mjohansson/SolderingStation/README.md

# SolderingStation
Project directory for soldering-station 2000
