mjohansson/SolderingStation/hw/ss_frontpanel_inner_plate/R2A/README.txt

* Break-away bridgeboard tabs removed
* set signal (GND) to holder mounting holes, also slight adjustments of some traces to 
    a) move vias away from screwholes
    b) improve plane connectivity
