mjohansson/SolderingStation/doc/14p_05mm_FFC/Molex_FFC_14_L100/15166_98266_15266_hires.jpg

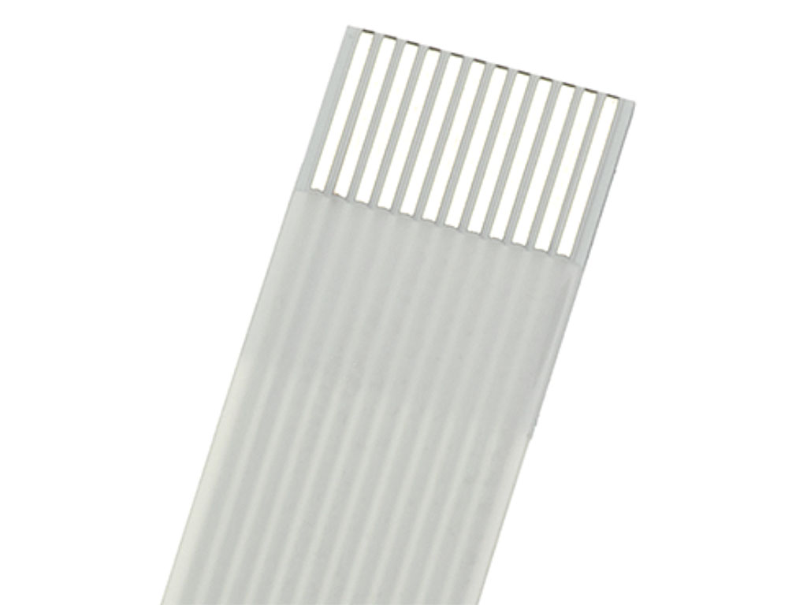
doc/14p_05mm_FFC/Molex_FFC_14_L100/15166_98266_15266_hires.jpg
