mjohansson/SolderingStation/doc/14p_05mm_FFC/Wurth_687114182122/FFC_14_L100_type1/o32857v209 Family_WE-FFC_6876xxxxx002.jpg

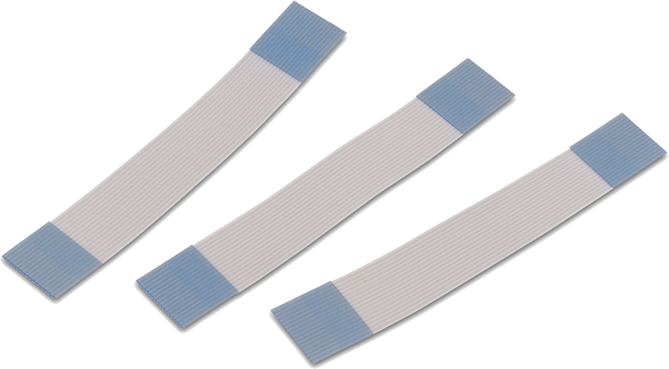
doc/14p_05mm_FFC/Wurth_687114182122/FFC_14_L100_type1/o32857v209 Family_WE-FFC_6876xxxxx002.jpg
