mjohansson/SolderingStation/doc/14p_05mm_FFC/Wurth_687114182122/FFC_14_L100_type2_alt/o32861v209 Family_WE-FFC_6877xxxxx002.jpg

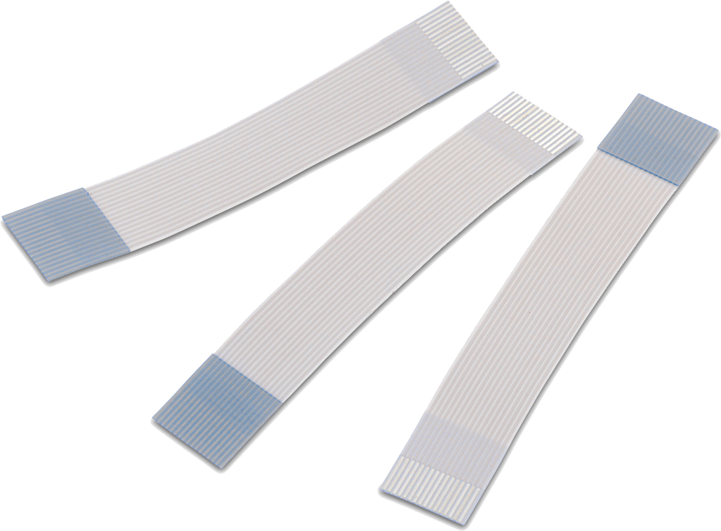
doc/14p_05mm_FFC/Wurth_687114182122/FFC_14_L100_type2_alt/o32861v209 Family_WE-FFC_6877xxxxx002.jpg
