mjohansson/SolderingStation/doc/appnotes/stm32_bluepill_modules/C8T6-DIP40-back.jpg

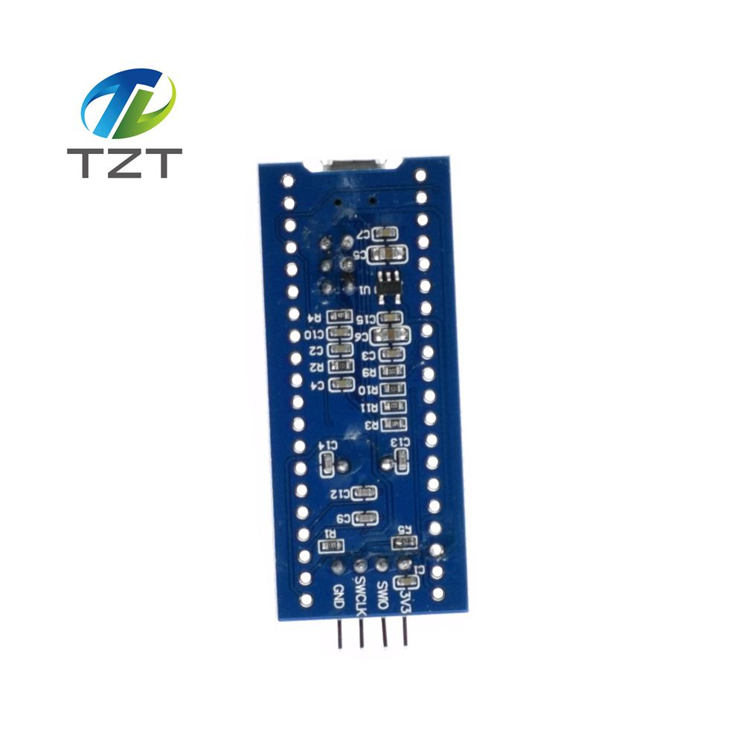
doc/appnotes/stm32_bluepill_modules/C8T6-DIP40-back.jpg
