mjohansson/SolderingStation/doc/appnotes/stm32_bluepill_modules/C8T6-size.jpg

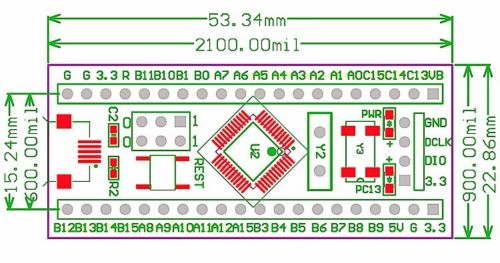
doc/appnotes/stm32_bluepill_modules/C8T6-size.jpg
