mjohansson/SolderingStation/doc/appnotes/stm32_bluepill_modules/STM32F103RCT6-back.jpg

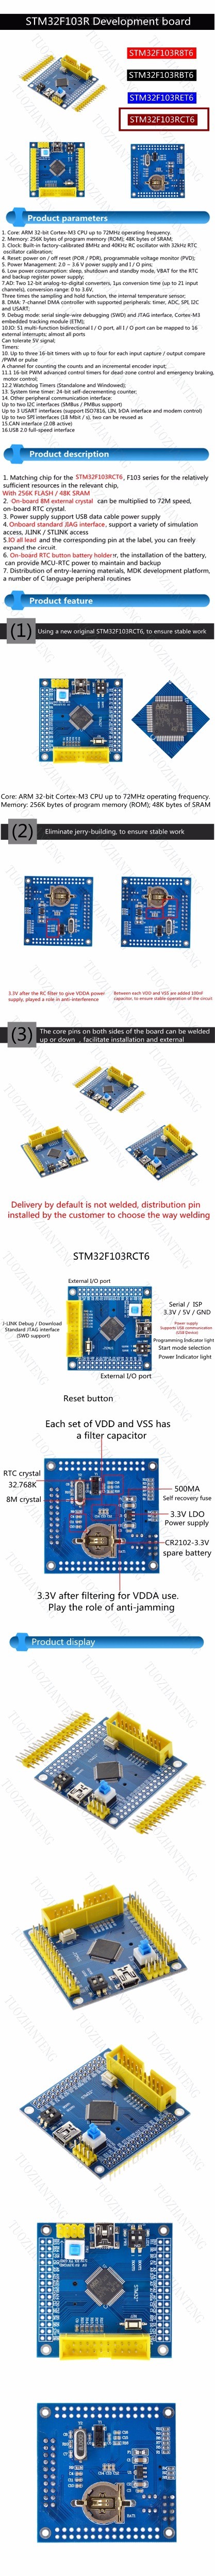
doc/appnotes/stm32_bluepill_modules/STM32F103RCT6-back.jpg
