mjohansson/SolderingStation/doc/dcdc_buck/Pluto-buck/SStn_1A-schematic.png

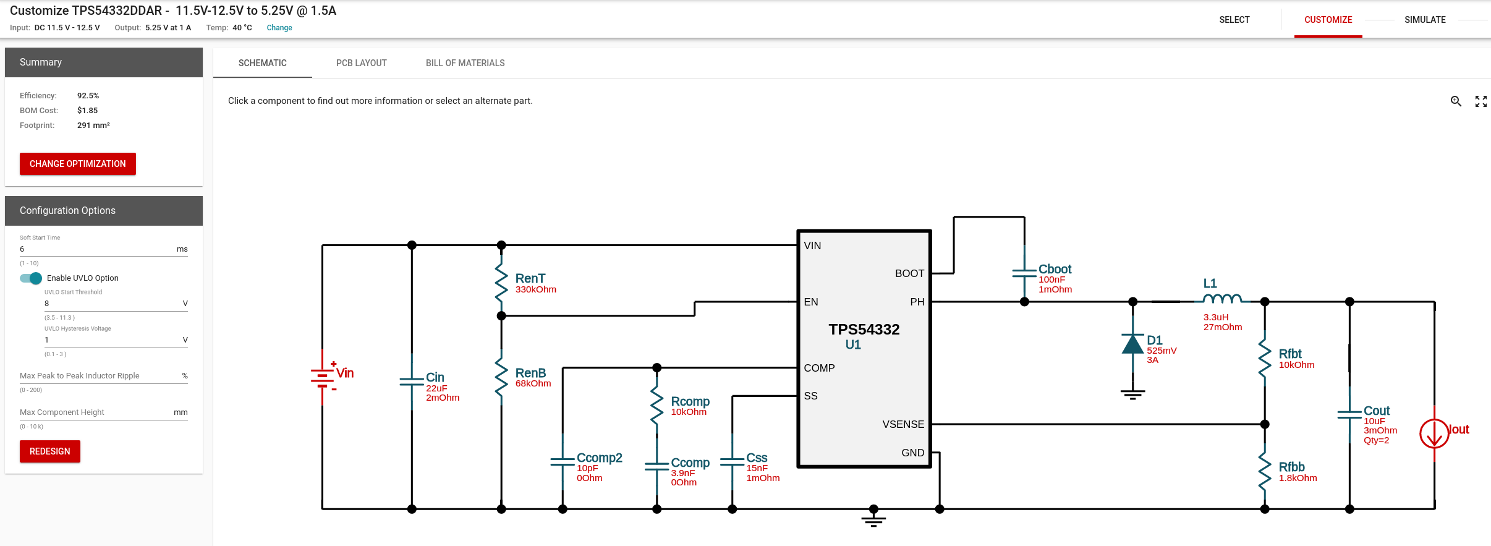
doc/dcdc_buck/Pluto-buck/SStn_1A-schematic.png
