mjohansson/SolderingStation/doc/DIN7_female_socket/Weller_modding/Buchse.png

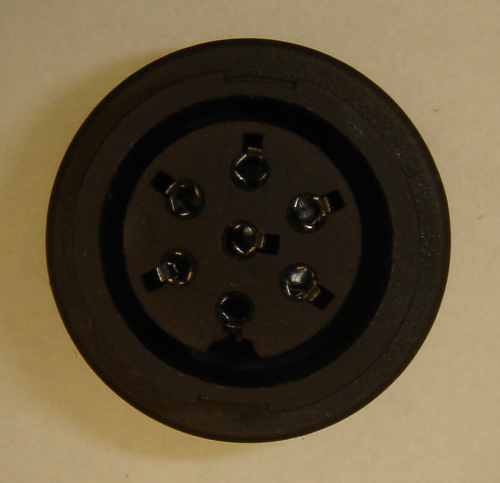
doc/DIN7_female_socket/Weller_modding/Buchse.png
