mjohansson/SolderingStation/doc/microUSB/HTB19WLYHpXXXXc6aXXXq6xXFXXXp.jpg

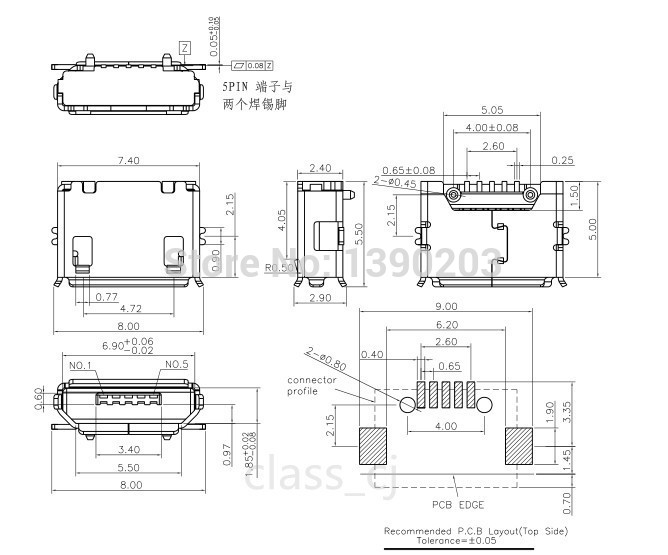
doc/microUSB/HTB19WLYHpXXXXc6aXXXq6xXFXXXp.jpg
