mjohansson/SolderingStation/doc/oled_display/Newhaven_NHD-3.12-25664UCW2/NHD-3.12-25664UCW2-lrg-ALL.jpg

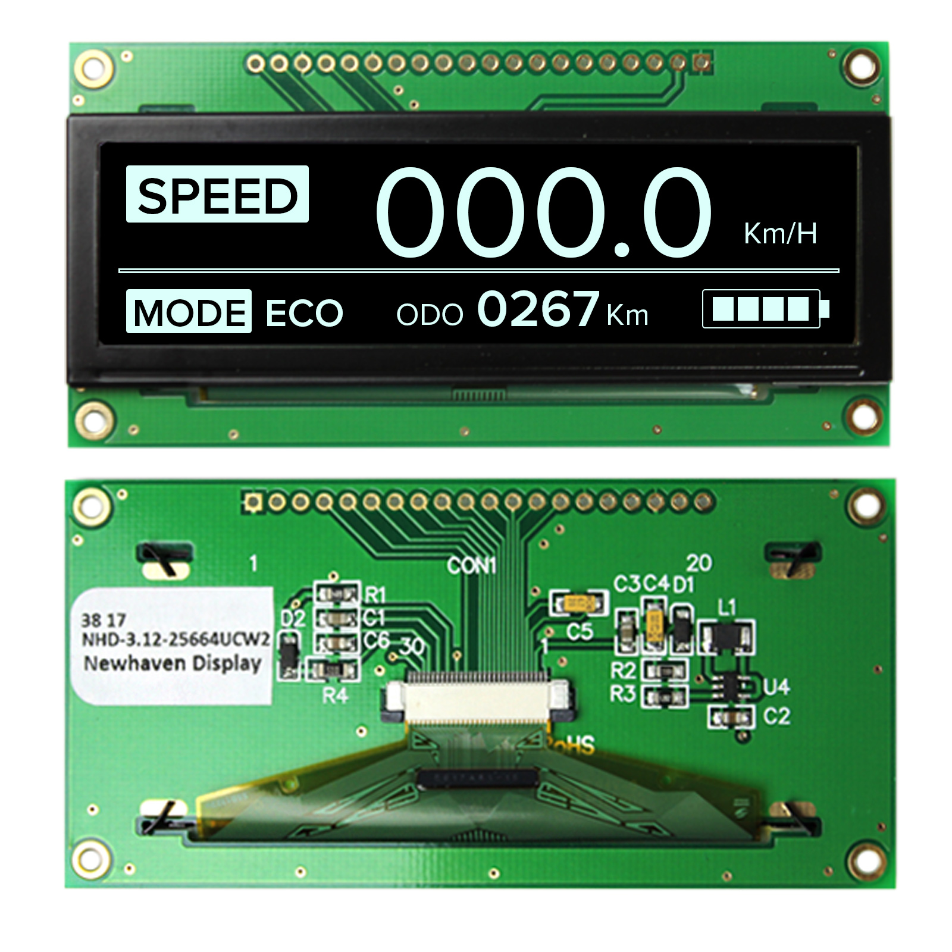
doc/oled_display/Newhaven_NHD-3.12-25664UCW2/NHD-3.12-25664UCW2-lrg-ALL.jpg
