mjohansson/SolderingStation/doc/rotary/Encoder Drawing.png

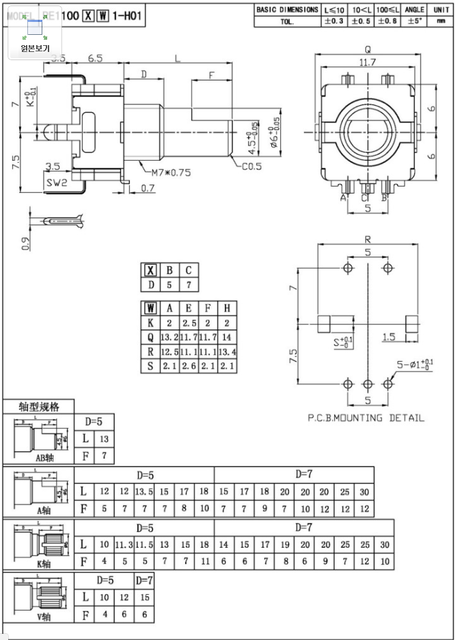
doc/rotary/Encoder Drawing.png
