mjohansson/SolderingStation/doc/rotary/KY-040.jpg

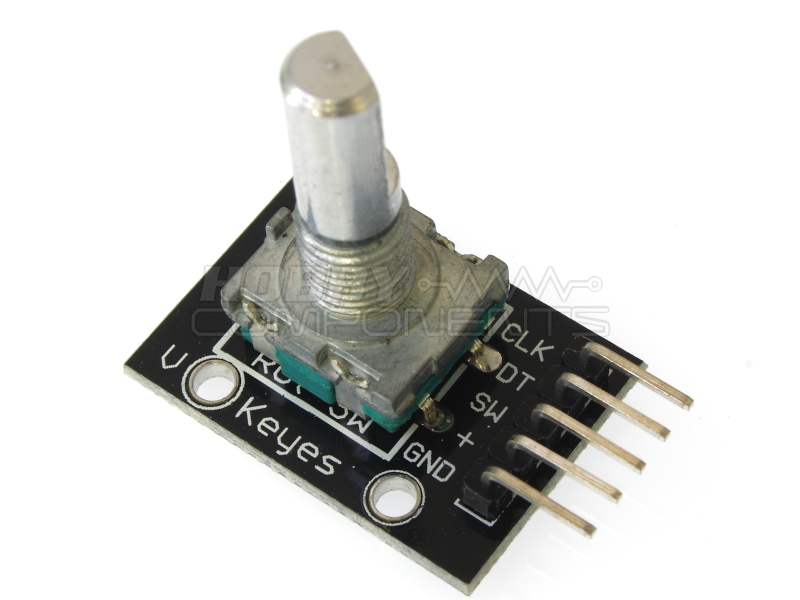
doc/rotary/KY-040.jpg
