mjohansson/SolderingStation/doc/rotary/M274-Rotary-Encoder-Dimensions.png

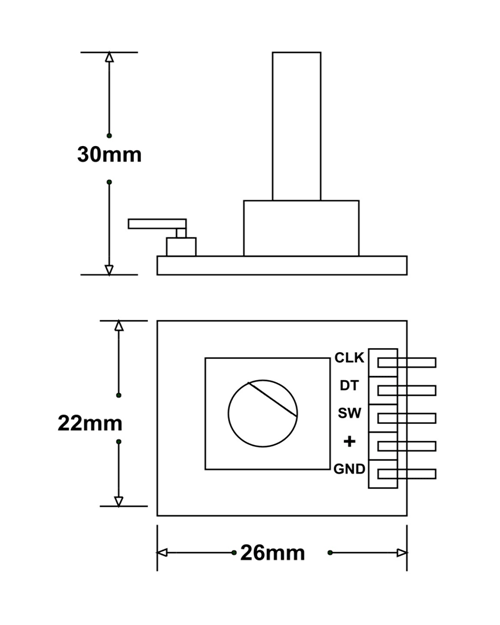
doc/rotary/M274-Rotary-Encoder-Dimensions.png
