mjohansson/SolderingStation/doc/rotary/Rotary_Encoder_Dimensions.png

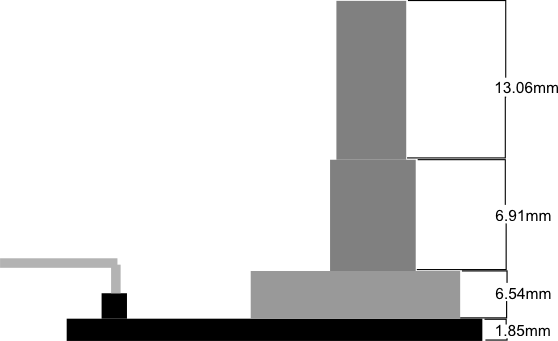
doc/rotary/Rotary_Encoder_Dimensions.png
