mjohansson/SolderingStation/doc/rotary/Rotary_Encoder_Pinout_and_PCB Dimensions.png

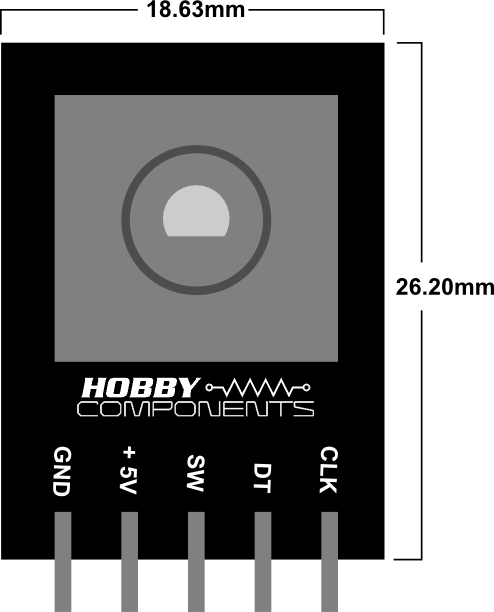
doc/rotary/Rotary_Encoder_Pinout_and_PCB Dimensions.png
