mjohansson/SolderingStation/doc/RTC-modules/DS3231_module/module_sch.jpg

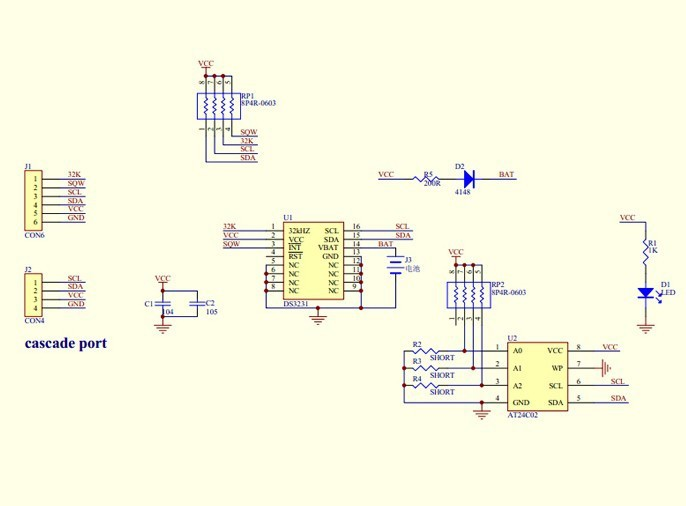
doc/RTC-modules/DS3231_module/module_sch.jpg
