mjohansson/SolderingStation/doc/simcard_block/C707 10M006 052 2.jpeg

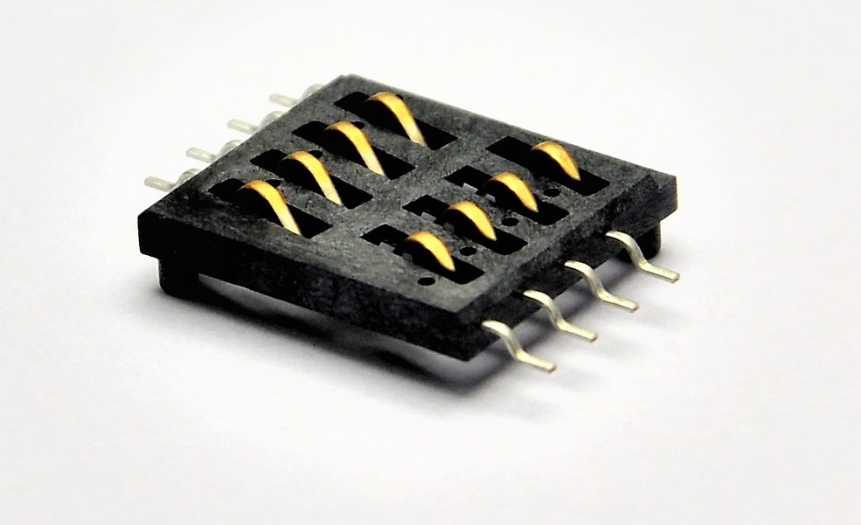
doc/simcard_block/C707 10M006 052 2.jpeg
