mjohansson/SolderingStation/doc/simcard_block/pad_dimensions.jpeg

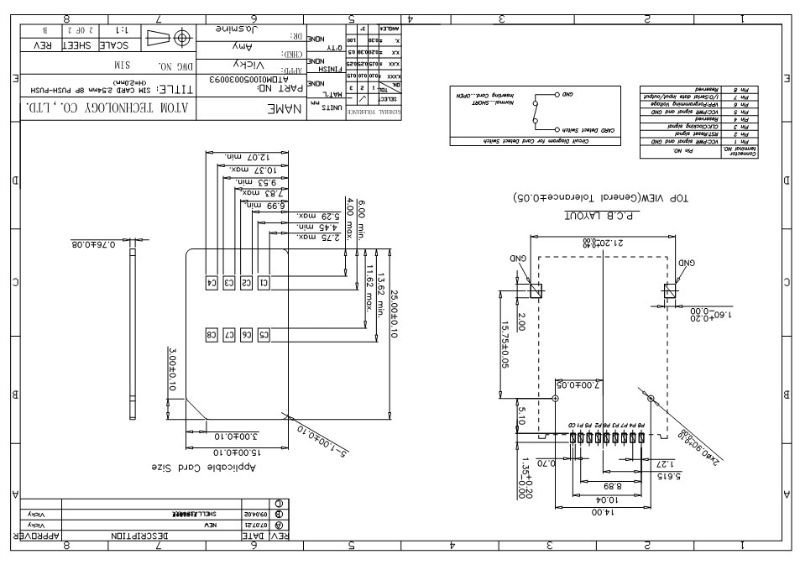
doc/simcard_block/pad_dimensions.jpeg
