mjohansson/SolderingStation/hw/frontpanel_dev_adapter/R1A/images/Produce_DanZhi.SMT_Original_Snapshot.Top.2268231A_Y12.SMT0201231120878.png

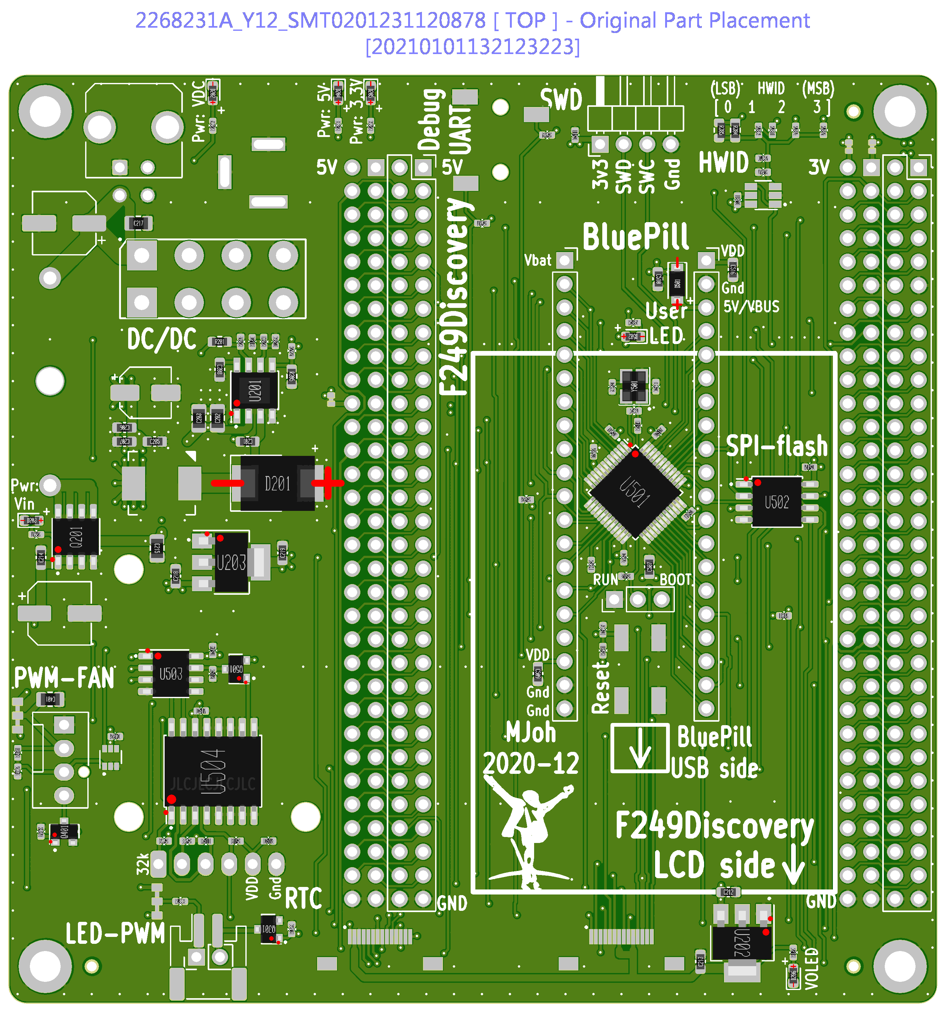
hw/frontpanel_dev_adapter/R1A/images/Produce_DanZhi.SMT_Original_Snapshot.Top.2268231A_Y12.SMT0201231120878.png
