mjohansson/SolderingStation/pictures/bottom_plate_with_POF-50185_rubber_feet.jpg

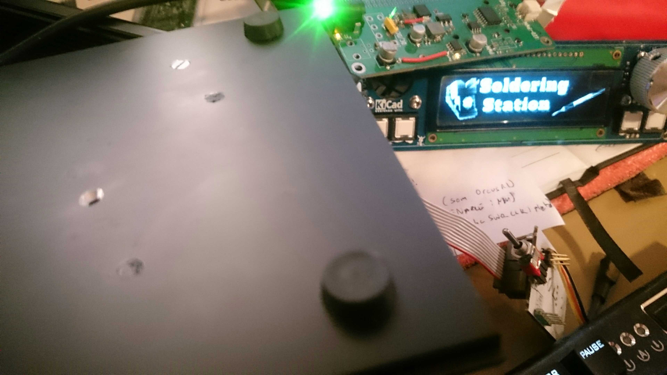
pictures/bottom_plate_with_POF-50185_rubber_feet.jpg
