mjohansson/SolderingStation/pictures/FPDB_jysd.jpg

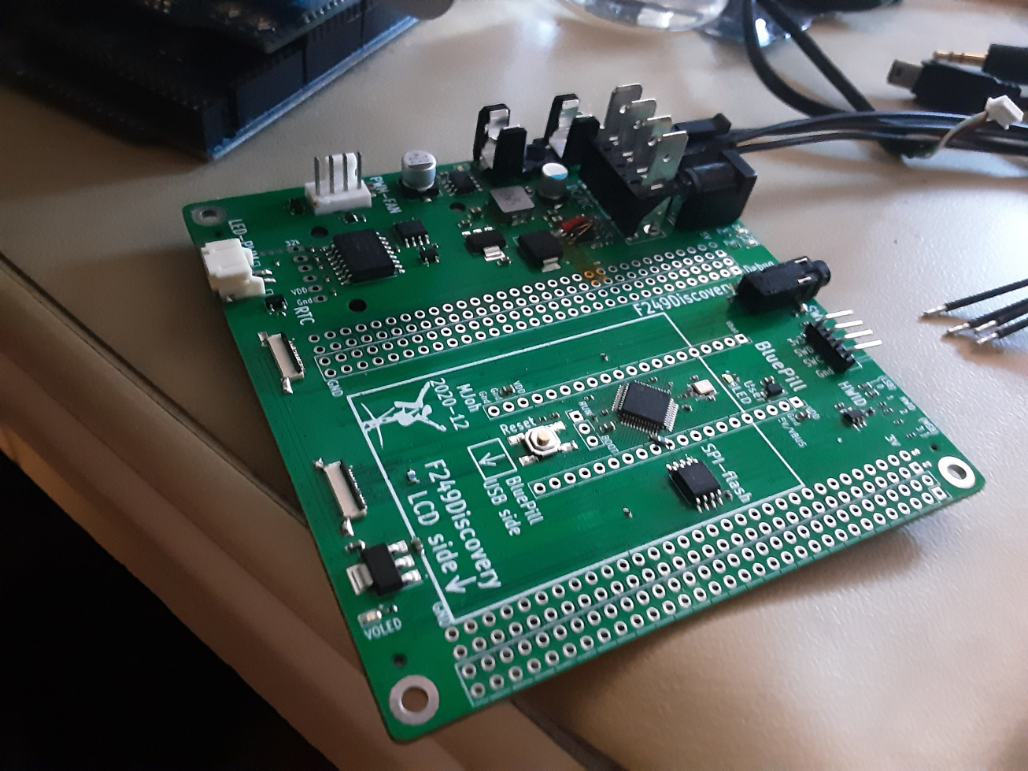
pictures/FPDB_jysd.jpg
