mjohansson/SolderingStation/pictures/POF-50185_push-on_rubber_feet.jpg

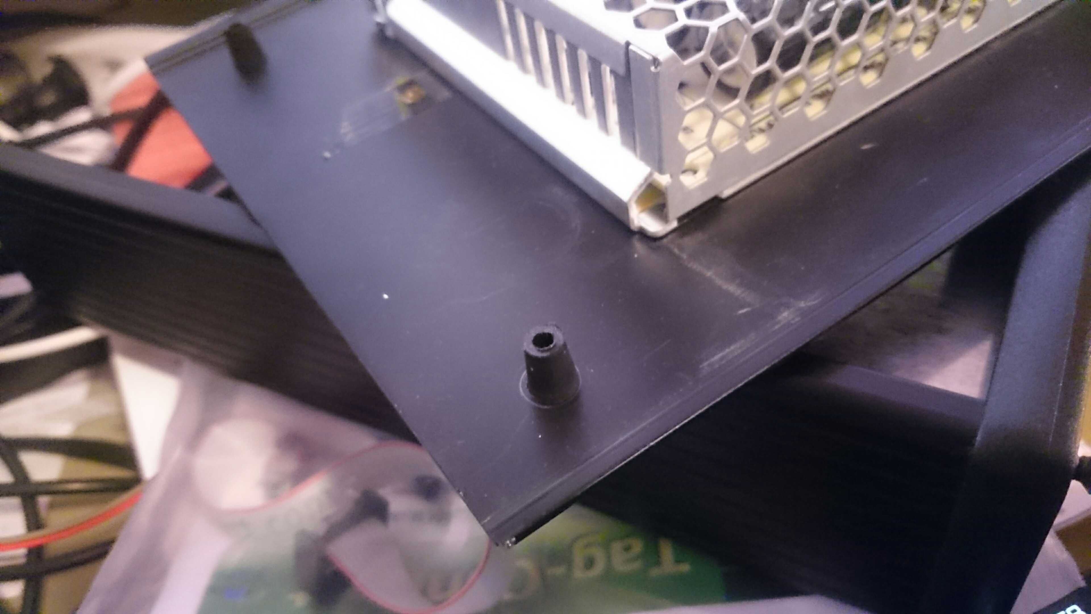
pictures/POF-50185_push-on_rubber_feet.jpg
