mjohansson/SolderingStation/doc/4mm_banana_socket_panelmnt/Stäubli-LB_I4R_A-23.0190-21/elfa_ordering_nr-301-36-139.txt

Elfa: 301-36-139
Type: LB-I4R-A
mfg pn: 23.0190-21
Brand: Stäubli Electrical Connectors

https://www.elfa.se/en/panel-mount-socket-o4mm-black-25a-30v-gold-plated-staeubli-electrical-connectors-23-0190-21/p/30136139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
