mjohansson/SolderingStation/doc/audio/3.5mm_jack/CUI_DEVICES_SJ-3571N/BOM.txt

3DX_CUI_DEVICES_Supplier: CUI Devices
3DX_CUI_DEVICES_Description: 3.5 mm Right-Angle, SPDT Switch, Stereo Audio Jack Connector
3DX_CUI_DEVICES_Model Number: SJ-3571N
