mjohansson/SolderingStation/doc/audio/speakers/CES-703316-28PM/CUI_DEVICES_CES-703316-28PM/BOM.txt

3DX_CUI_DEVICES_Supplier: CUI Devices
3DX_CUI_DEVICES_Description: 70 x 33 mm, Enclosed, Rectangular Case, 2 W, 8 Ohm, Neodymium Magnet, Paper and Cloth Cone, Speaker
3DX_CUI_DEVICES_Model Number: CES-703316-28PM
