mjohansson/SolderingStation/doc/audio/speakers/CES-803118-28PM/CUI_DEVICES_CES-803118-28PM/BOM.txt

3DX_CUI_DEVICES_Supplier: CUI Devices
3DX_CUI_DEVICES_Description: 80 x 31 mm, Enclosed, Rectangular Case, 2 W, 8 Ohm, Neodymium Magnet, Cloth Cone, Speaker
3DX_CUI_DEVICES_Model Number: CES-803118-28PM
