mjohansson/SolderingStation/doc/appnotes/stm32F429/STM32F429I-DISC1/resources/MB1075 B01 BOM.xls

MB1075 B01 BOM
NO | Code | Part Number | Manufacturer | Description | Designator | Quantity | Process | Note
1 | A14D025 |  | fastprint | PCB MB1075,4 layers,immersion gold, |  | 1 | SMT
2 | CCC0001 | CC0603KRX7R9BB103 | YAGEO | capacitor,10nF,0603,50V,10%,X7R,YAGEO; | C3,C19 | 2 | SMT
3 | CCC0071 | CC0402KRX7R7BB104 | YAGEO | capacitor,100nF,10%,16V,X7R,0402,YAGEO | C1, C4, C6, C7, C8, C9, C10, C11, C12, C15, C22, C27, C29, C30, C31, C32, C33, C34, C35, C36, C37, C38, C39, C40, C43, C44, C45, C46, C47, C48, C49, C50, C51, C52 | 34 | SMT
4 | CCC0121 | CC0603KRX5R8BB105 | YAGEO | capacitor,1uF,10%,25V,X5R,0603 | C2, C5,C28 | 3 | SMT
5 | CCC0135 | CC1206KKX7R7BB225 | YAGEO | capacitor,2.2uF,10%,16V,X7R,1206 | C41, C42 | 2 | SMT
6 | CCC0149 |  | YAGEO | capacitor,20pF,5%,50V,NPO,0402,YAGEO | C16, C17, C20, C21 | 4 | SMT
7 | CCC0217 | CC0603KRX7R8BB106 | YAGEO | capacitor,10uF,10%,25V,X7R,0603 | C13 | 1 | SMT
8 | CTD0004 | TAJA475K016R | AVX | Tan capacitor,4.7uF,10%,16V,TAN-A,AVX | C14, C53 | 2 | SMT
9 | CTD0045 | TAJA105K016R | AVX | Tan capacitor,1uF,10%,16V,TAN-A,AVX | C25, C26 | 2 | SMT
10 | DLD0027 | 19-213-R6C-AP1Q2B-3T | Everlight | LED,RED,0603 | LD2,LD4, LD6 | 3 | SMT
11 | DLD0028 | 19-213SY6C/S530-E2/TR8LED | Everlight | LED,GREEN,0603 | LD3, LD5 | 2 | SMT
12 | DLD0032 | HSMF-A201-A00J1 | AVAGO | LED,Bicolor red & green,3.2 mm x 2.8 mm,LE-RGW35280,SMT, | LD1 | 1 | SMT
13 | JPM0060 | F206A-2*04MGF-A | Townes | pin header female,F206A-2*04MGF-A,2.54MM,2*4P,SMT | CN3 | 1 | SMT
14 | JPZ0033 | 313140S161145 | Lyconn | pin header male,2.54mm,1*2P,180 degree,L=14.5,1U gold,SMT,Lyconn;High temperature resistant ,PA-9T | JP1, JP2, | 2 | SMT
15 | JPZ0090 |  | Lyconn | pin header male,2.54mm,2*32P,180 degree,L=14.5,1U GOLD,SMT,Lyconn;High temperature resistant | P1, P2 | 2 | SMT
16 | JUS0008 | 47590-0001 | MOLEX | connector,USB-AB,47590-0001,SMT,MOLEX,MB784 | CN6 | 1 | SMT
17 | JUS0021 | MUSB5QS-BM1H6-NLB-E | Townes | USB,MUSB5QS-BM1H6-NLB-E,Townes | CN1 | 1 | SMT
18 | LCZ0006 | FCM1608KF-601T03 | Tai-tech | bead,600R,350mA,0603,FCM1608KF-601T05,Tai-tech | L1 | 1 | SMT
19 | QSJ0002 | MMBT9013 | unisonic | transistor,MMBT9013L/G,SOT-23,unisonic | T1 | 1 | SMT
20 | RRC0041 | RC0603FR-07680RL | YAGEO | resistor,680R,0603,1% | R27 | 1 | SMT
21 | RRC0055 | RC0603FR-07510RL | YAGEO | resistor,510R,0603,1% | R26 | 1 | SMT
22 | RRC0065 | RC0603FR-07330RL | YAGEO | resistor,330R,0603,1% | R70 | 1 | SMT
23 | RRC0123 | RC0402FR-07100RL | YAGEO | resistor,100R,0402,1%,YAGEO | R1, R2, R16, R25, R28 | 5 | SMT
24 | RRC0124 |  | YAGEO | resistor,10K,0402,1%,YAGEO | R5, R7, R71 | 3 | SMT
25 | RRC0126 | RC0402FR-071KL | YAGEO | resistor,1K,0402,1% | R4 | 1 | SMT
26 | RRC0128 | RC0402FR-0722RL | YAGEO | resistor,22R,0402,1%,YAGEO | R14, R15, R17, R20, R63, R64 | 6 | SMT
27 | RRC0130 | RC0402FR-074K7L | YAGEO | resistor,4.7K,0402,1% | R18, R19, R29, R30, R31, R36, R37, R41, R44, R45, R51, R55, R60, R62 | 14 | SMT
28 | RRC0220 | RC0402JR-070RL | YAGEO | resistor,0R,0402,5%,YAGEO | SB1, SB2, SB4, SB6, SB8, SB12, SB14, SB16, SB17, SB18, SB20, SB21 | 12 | SMT
29 | RRC0220 | RC0402JR-070RL | YAGEO | resistor,0R,0402,5%,YAGEO | R3, R11, R12, R40, R52, R56, R58, R67, R69, R72 | 10 | SMT
30 | RRC0223 | RC0402FR-071K5L | YAGEO | resistor,1.5K,0402,1%,YAGEO | R10 | 1 | SMT
31 | RRC0245 | RC0402FR-07220RL | YAGEO | resistor,220R,0402,1%,YAGEO | R57 | 1 | SMT
32 | RRC0265 | RC0402FR-07510RL | YAGEO | resistor,510R,0402,1%,YAGEO | R61 | 1 | SMT
33 | RRC0313 | RC0402FR-0747KL | YAGEO | resistor,47K,0402,1% | R65, R68 | 2 | SMT
34 | RRC0318 | RC0402FR-07330RL | YAGEO | resistor,330R,0402,1% | R23 | 1 | SMT
35 | RRC0359 | RC0402FR-07100KL | YAGEO | resistor,100K,0402,1% | R8, R9, R21, R24, R32, R33, R34, R46 | 8 | SMT
36 | RRC0540 | RC0603FR-07620RL | YAGEO | resistor,620R,0603,1% | R73 | 1 | SMT
37 | RRC0642 | RC0603FR-070RL | YAGEO | resistor,0R,1%,0603,RC0603FR-070RL | R47, R48, R49, R50 | 4 | SMT
38 | RRC0721 | RC0402FR-07220KL | YAGEO | resistor,220K,0402,1% | R22 | 1 | SMT
39 | SQC0001 | TD-0341X-GO0 | wealthmetal | buttom,blue,6*6,SMT,180degree,TD-0341X-GO1,wealthmetal | B1 | 1 | SMT
40 | SQC0002 | TD-0341X-A00 | wealthmetal | buttom,black,6*6,SMT,180degree,TD-0341X-GO1,wealthmetal | B2 | 1 | SMT
41 | ST-DEJ0010 | BAT60JFILM | ST | Diode,BAT60JFILM,SOD323/A,ST,(X3 Code 9151097) | D1, D2, D3 | 3 | SMT
42 | ST-UIC0036 | LD3985M33R | ST | IC,3.3V,LD3985M33R,SOT23-5L,ST,(X3 Code 9176161) | U1 | 1 | SMT
43 | ST-UIC0063 | EMIF02-USB03F2 | ST | IC,EMIF02-USB03F2,flip ship,ST,(X3 Code 9179037) | U7 | 1 | SMT
44 | ST-UIC0095 | STMPS2141STR | ST | IC,STMPS2141STR,SOT23-5,ST,(X3 Code9159003) | U8 | 1 | SMT
45 | ST-UIC0107 | STM32F103C8T6(2-2) | ST | IC,STM32F103C8T6(2-2),48-LQFP,ST,(X3 Code9175981) | U2 | 1 | SMT
46 | ST-UIC0336 | L3GD20TR | ST | IC,L3GD20TR, MEMS Motion Sensor 3-Axis | U3 | 1 | SMT
47 | ST-UIC0158 | STMPE811QTR | ST | IC,STMPE811QTR,16QFN,ST,(X3 Code 9177945) | U4 | 1 | SMT
48 | ST-UIC0349 | STM32F429ZIT6U | ST | IC,STM32F429ZIT6U,LQFP144 | U5 | 1 | SMT
49 | UIC0834 | IS42S16400J-7TL | Arrow | IC,IS42S16400J-7TL,SMT | U6 | 1 | SMT
50 | 4000021 | SF-TC240T-9370-B-T | xinchuangtianyuan | LCD,SF-TC240T-9370-B-T,2.4 | CN5 | 1 | DIP
51 | JPZ0015 | 313140S111116 | lyconn | pin header male,2.54mm,1*2,L=11.6,180 degree,1U gold,DIP,lyconn | JP3 | 1 | DIP
52 | JPZ0015 | 313140S111116 | lyconn | pin header male,2.54mm,1*4,L=11.6,180 degree,1Ugold,DIP,lyconn | CN4 | 1 | DIP
53 | JPZ0015 | 313140S111116 | lyconn | pin header male,2.54mm,1*6,L=11.6,180 degree,1U gold,DIP,lyconn | CN2 | 1 | DIP
54 | XWY0022 | HC-49S-C20QSA-8.000MHZ | Jfvny | Crystal Oscillator,8M,20PF,20PPM,-10-70 degree,DIP,HC-49S | X1, X3 | 2 | DIP
55 | ADL0002 | 316102S111A | lyconn | Jumper,2.54MM,open,1U gold,lyconn;Harwin,M7566-05/M7571-05 |  | 5 | ASS
56 | AKG0002 |  | along | buttom hat,blue,along | for B1 | 1 | ASS
57 | AKG0003 |  | along | buttom hat,black,along | for B2 | 1 | ASS
58 | PBQ0016 |  | shenyuan | Test Label,Five grid,Character as T1, T2, T3, T4, QA, see picture / sample |  | 1 | ASS
59 | PXS0012 |  | lifu | Blister box,for MB1075 |  | 1 | ASS
60 | PZB0001 |  | chuanhui | carton box:620*425*310MM, |  | 2/150 | ASS
61 | PZX0006 |  | chuanhui | pearl wool EPE,605*415*5mm, |  | 1/150 | ASS
62 | PZZ0010 |  | chuanhui | cardboard,605*415mm |  | 2/150 | ASS
63 | [N/A] |  |  |  | R6 | 1 |  | Not Fitted
64 | [N/A] |  |  |  | C18 | 1 |  | Not Fitted
65 | [N/A] |  |  |  | JP4 | 1 |  | Not Fitted
66 | [N/A] |  |  |  | R13 | 1 |  | Not Fitted
67 | [N/A] |  |  |  | C23, C24 | 2 |  | Not Fitted
68 | [N/A] |  |  |  | X2 | 1 |  | Not Fitted
69 | [N/A] |  |  |  | R53, R54 | 2 |  | Not Fitted
70 | [N/A] |  |  |  | R35, R38, R39, R42, R43, R59, R66 | 7 |  | Not Fitted
71 | [N/A] |  |  |  | SB3, SB5, SB7, SB9, SB10, SB11, SB13, SB15, SB19, SB22, SB23, SB24, SB25, SB26, SB27 | 15 |  | Not Fitted
