mjohansson/SolderingStation/sch_pcb/SolderingStation_PCBA.xlsx

Sheet: Title
Solderingstation
Date | Comment | Authort
2020-04-30 | First upload to github | Mr Johansson
2020-04-30 | Created the pcba folder and started with a BOM | Mr Thulesius

Sheet: BOM
BOM
Purpose
To be able to drive two weller soldering irons of type X
See: The STM32 Nucleo-144, Altium Schematics | https://www.st.com/en/evaluation-tools/nucleo-f429zi.html
BOM divided in sections: MCU, ST-Link, USB, Ethernet, Power & Connectors |  |  |  |  |  |  |  | sum= | 22.9234
Part for Solderstation | Part used for the ST Nucleo Board | Description | Manufacturer | Package | pcs | avalabel at JLCPCB | Web | Price | tot
MCU
STM32F429VITx | MCU_LQFP144 | Main MCU | ST | LQFP100 | 1 | YES |  | 11.5305 | 11.5305
? | NX3225GD-8.000M-EXS00A-CG04874[N/AU]8C | XTAL 8MHz |  | ? | 1 | NO |  |  | 0
EXS00A-MU00466 | NX3215SA-32.768KHZ-EXS00A-MU00525 | XTAL 32kHz |  | SMD-3215_2P | 1 | YES |  | 0.2304 | 0.2304
? | TD-0341 | Reset & User button |  |  | 2 | NO |  |  | 0
TLV9052SIDGSR | N/A | Vref-Buffer | Ti | MSOP-10 | 1 | NO | https://www.mouser.se/ProductDetail/595-TLV9052SIDGSR | 0.92 | 0.92
REF6125IDGKR | N/A | VREF | Ti | VSSOP-8 | 1 | NO | https://www.mouser.se/ProductDetail/595-REF6125IDGKR | 4.66 | 4.66
SN74LVC1G11 |  |  | Ti
Ethernet Phy
LAN8742A-CZ-TR | LAN8742A-CZ-TR | Ethernet Transceiver | Microchip | QFN-24_EP_4.0x4.0x0.5P | 0 | YES | https://datasheet.lcsc.com/szlcsc/Microchip-Tech-LAN8742AI-CZ_C153279.pdf | 2.6174 | 0
IP101G | N/A | Fast Ethernet Transceiver | BDTIC.com | LQFP-48 | 1 | YES | https://datasheet.lcsc.com/szlcsc/1811271903_IC-Plus-IP101GA_C336124.pdf | 0.6754 | 0.6754
USBLC6-4SC6 | USBLC6-4SC6 | ESD protection | Yenji Elec |  | 1 | YES
KMS-1102NL | KMS-1102NL | 10/100BASE-T SINGLE PORT SURFACE MOUNT MAGNETICS |  |  | 1 | NO | https://www.mouser.com/pdfdocs/Pulse_1198.pdf
DP83848C |  | Physical Layer Transceiver |  |  |  |  | http://www.ti.com/lit/ds/symlink/dp83848c.pdf
ST-LINK parts to be MBED compatible(?)
STM32F103CBT6 | STM32F103CBT6 | MCU For ST-LINK |  |  | 1 | YES | https://datasheet.lcsc.com/szlcsc/STMicroelectronics-STM32F103CBT6_C8304.pdf | 1.9326 | 1.9326
USBLC6-2SC6 | USBLC6-2SC6 | USB ESD protection |  | SOT-23-6 | 1 | YES | https://datasheet.lcsc.com/szlcsc/STMicroelectronics-USBLC6-2SC6_C7519.pdf | 0.0965 | 0.0965
? | 1050170001 | USB_Micro-B receptacle |  | ? | 1 | NO |  |  | 0
LD3985M33R | LD3985M33R | LD3985M33R |  | SOT-23-5 | 1 | YES | https://datasheet.lcsc.com/szlcsc/STMicroelectronics-LD3985M33R_C46243.pdf | 0.372 | 0.372
S9013 | S9013 | Transistor NPN 500mA |  | SOT-23 | 1 | YES | https://datasheet.lcsc.com/szlcsc/Changjiang-Electronics-Tech-CJ-S9013_C6749.pdf | 0.0194 | 0.0194
BAT60JFILM | BAT60JFILM | SCHOTTKY BARRIER DIODES (SBD) |  | SOD-323 | 3 | YES | https://datasheet.lcsc.com/szlcsc/STMicroelectronics-BAT60JFILM_C133103.pdf | 0.0607 | 0.1821
Heat control
TPS2HB16AQPWPRQ1 | N/A | Load Switch |  | HTSSOP-16 | 0 | NO | https://www.mouser.se/ProductDetail/595-TPS2HB16AQPWPRQ1 | 2.95 | 0
INA226AIDGSR | N/A | Bi-Directional CURRENT/POWER MONITOR with I 2C™ Interface |  | MSOP-10 | 1 | YES | https://datasheet.lcsc.com/szlcsc/Texas-Instruments-TI-INA226AIDGSR_C49851.pdf | 1.3275 | 1.3275
DMP4025LSD |  | Load Switch: Dual PMOS |  | SO-8 | 2 | YES | https://datasheet.lcsc.com/szlcsc/Diodes-Incorporated-DMP4025LSD-13_C150763.pdf | 0.4885 | 0.977
