mjohansson/SolderingStation/doc/Basket_Mar08_0954PM.xls

SHOPPING BASKET
This is not an invoice
08-Mar-20 21:54:15
 | Mouser No | Mfr. No | Manufacturer | Customer No | Description | RoHS | Lifecycle | Order Qty. | Price (SEK) | Ext.: (SEK)
1 | 511-STM32F429I-DISC1 | STM32F429I-DISC1 | STMicroelectronics |  | Development Boards & Kits - ARM Discovery kit with STM32F429ZI MCU * New order code STM32F429I-DISC1 (replaces STM32F429I-DISCO) | RoHS Compliant |  | 1 | 299,77 kr | 299,77 kr
2 | 950-IP101GA | IP101GA | WIZnet |  | Ethernet ICs PHY Chip | RoHS Compliant |  | 10 | 11,14 kr | 111,40 kr
3 | 710-74980104400 | 74980104400 | Wurth Elektronik |  | Modular Connectors / Ethernet Connectors WE-RJ45 Intgtd XFMR 10/100Base-T | RoHS Compliant | New Product | 2 | 56,12 kr | 112,24 kr
4 | 732-322525MF10P-C | TSX-3225 25.0000MF10P-C | Epson |  | Crystals 25MHz 10ppm 18pF -20C +85C | RoHS Compliant |  | 10 | 2,66 kr | 26,60 kr
5 | 603-RC0402FR-076K19L | RC0402FR-076K19L | Yageo |  | Thick Film Resistors - SMD 6.19K OHM 1% | RoHS Compliant By Exemption |  | 100 | 0,043 kr | 4,30 kr
6 | 603-RC0402FR-075K1L | RC0402FR-075K1L | Yageo |  | Thick Film Resistors - SMD 5.1K OHM 1% | RoHS Compliant By Exemption |  | 100 | 0,043 kr | 4,30 kr
7 | 588-MCS1632R010FER | MCS1632R010FER | Ohmite |  | Current Sense Resistors - SMD 1W 0.01 ohm 1% | RoHS Compliant |  | 10 | 5,19 kr | 51,90 kr
8 | 595-INA226AIDGSR | INA226AIDGSR | Texas Instruments |  | Current & Power Monitors & Regulators Hi-Side Msmt,Bi-Dir Current/Pwr Mon | RoHS Compliant |  | 10 | 27,52 kr | 275,20 kr
9 | 875-MI0603J600R-10 | MI0603J600R-10 | Laird Performance Materials |  | Ferrite Beads 60ohms 100MHz 1A Monolithic 0603 SMD | RoHS Compliant |  | 50 | 0,161 kr | 8,05 kr
10 | 595-TLV9052SIDGSR | TLV9052SIDGSR | Texas Instruments |  | Operational Amplifiers - Op Amps Dual 5MHz, 15V/us high slew-rate, RRIO op amp 10-VSSOP -40 to 125 | RoHS Compliant | New Product | 10 | 7,28 kr | 72,80 kr
11 | 595-TLV9051SIDBVR | TLV9051SIDBVR | Texas Instruments |  | Operational Amplifiers - Op Amps OPAMP | RoHS Compliant | New Product | 10 | 4,92 kr | 49,20 kr
12 | 595-REF6125IDGKR | REF6125IDGKR | Texas Instruments |  | Voltage References | RoHS Compliant |  | 4 | 44,87 kr | 179,48 kr
13 | 584-AD8552ARUZ-R | AD8552ARUZ-REEL | Analog Devices Inc. |  | Precision Amplifiers DUAL PRECISION RAIL-RAIL CHOPPER OP AMP | RoHS Compliant |  | 10 | 40,81 kr | 408,10 kr
14 | 546-1455T2201BK | 1455T2201BK | Hammond |  | Enclosures, Boxes & Cases MetalEndPanel, Black 8.66 x 2.03 x 6.50" | RoHS Compliant |  | 2 | 349,04 kr | 698,08 kr
15 | 595-TPS2HB16AQPWPRQ1 | TPS2HB16AQPWPRQ1 | Texas Instruments |  | Power Switch ICs - Power Distribution 40V 16m Dual-channel smart high-side switch 16-HTSSOP -40 to 125 | RoHS Compliant By Exemption | New Product | 10 | 27,52 kr | 275,20 kr
16 | 595-NE556DR | NE556DR | Texas Instruments |  | Timers & Support Products DUAL PRECISION TIMER | RoHS Compliant |  | 10 | 3,13 kr | 31,30 kr
17 | 595-TLV1117LV30DCYR | TLV1117LV30DCYR | Texas Instruments |  | LDO Voltage Regulators 1A,Pos Fixed Vltg LDO Linear Reg | RoHS Compliant |  | 10 | 3,82 kr | 38,20 kr
18 | 621-74LVC1G126SE-7 | 74LVC1G126SE-7 | Diodes Incorporated |  | Buffers & Line Drivers LOGILVC3 STA BUF1 | RoHS Compliant |  | 20 | 2,09 kr | 41,80 kr
19 | 647-UCL1V470MCL1GS | UCL1V470MCL1GS | Nichicon |  | Aluminium Electrolytic Capacitors - SMD 35V 47 uF 105CSMT AEC-Q200 | RoHS Compliant |  | 10 | 3,46 kr | 34,60 kr
20 | 595-TPS54332DDAR | TPS54332DDAR | Texas Instruments |  | Switching Voltage Regulators DC/DC Converter with Eco-mode | RoHS Compliant |  | 10 | 13,82 kr | 138,20 kr
21 | 863-MBRS340T3G | MBRS340T3G | ON Semiconductor |  | Schottky Diodes & Rectifiers 3A 40V | RoHS Compliant |  | 10 | 3,47 kr | 34,70 kr
22 | 815-ASPI0630LR3R3T15 | ASPI-0630LR-3R3M-T15 | ABRACON |  | Fixed Inductors 3.3uH 20% -55C +125C | RoHS Compliant |  | 10 | 8,00 kr | 80,00 kr
23 | 661-APXG160A101ME61G | APXG160ARA101ME61G | United Chemi-Con (UCC) |  | Aluminium Organic Polymer Capacitors 16Volts 100uF 5X6 | RoHS Compliant |  | 10 | 4,99 kr | 49,90 kr
24 | 453-DIO6809RST3 | DIO6809RST3 | DIOO |  | Supervisory Circuits Ultra Low Power Microprocessor Reset Circuit (2.63V) | RoHS Compliant |  | 20 | 1,50 kr | 30,00 kr
25 | 595-SN74LVC1G175DCKR | SN74LVC1G175DCKR | Texas Instruments |  | Flip-Flops Single D-Type Flip-Flop | RoHS Compliant |  | 20 | 2,06 kr | 41,20 kr
26 | 595-SN74LVC74APWRG4 | SN74LVC74APWRG4 | Texas Instruments |  | Flip-Flops ALT 595-SN74LVC74APWR | RoHS Compliant |  | 10 | 2,99 kr | 29,90 kr
27 | 595-SN74LVC1G11DBVR | SN74LVC1G11DBVR | Texas Instruments |  | Logic Gates Sngl 3 Inpt Pos AND Gate | RoHS Compliant |  | 20 | 2,51 kr | 50,20 kr
28 | 490-CT-1205C-SMT-TR | CT-1205C-SMT-TR | CUI Devices |  | Piezo Buzzers & Audio Indicators Buzzers | RoHS Compliant |  | 4 | 27,52 kr | 110,08 kr
By submitting your order you agree to these terms and conditions. (https://www.mouser.se/saleterms) |  |  |  |  |  |  |  |  | Merchandise Total: | 3.286,70 kr
Prices are reflected at the date and time shown. |  |  |  |  |  |  |  |  | Delivery Charge: | 0,00 kr
