mjohansson/SolderingStation/doc/komponentbest_historik/Mouser_Basket_Mar11_0352PM-uppdelning.xls

SHOPPING BASKET
This is not an invoice |  |  |  |  |  |  |  |  |  |  | kontroll | Mathias qty | Jonny qty | Mathias subtotal | Jonny subtotal
11-Mar-20 15:52:36 |  |  |  |  |  |  | kr |  |  |  | (allocated)
 | Mouser No | Mfr. No | Manufacturer | (Kicad done) | Description | RoHS | Lifecycle | Order Qty. | Price (SEK) | Ext.: (SEK)
1 | 950-IP101GA | IP101GA | WIZnet | Y (mj) | Ethernet ICs PHY Chip | RoHS Compliant |  | 10 | 11.140 | 111.400 | 10 | 8 | 2 | 89.12 | 22.28
2 | 710-74980104400 | 74980104400 | Wurth Elektronik | Y (mj) | Modular Connectors / Ethernet Connectors WE-RJ45 Intgtd XFMR 10/100Base-T | RoHS Compliant | New Product | 5 | 50.120 | 250.600 | 5 | 3 | 2 | 150.36 | 100.24
3 | 732-322525MF10P-C | TSX-3225 25.0000MF10P-C | Epson | Y (mj) | Crystals 25MHz 10ppm 18pF -20C +85C | RoHS Compliant |  | 20 | 2.660 | 53.200 | 20 | 10 | 10 | 26.60 | 26.60
4 | 603-RC0402FR-076K19L | RC0402FR-076K19L | Yageo | std | Thick Film Resistors - SMD 6.19K OHM 1% | RoHS Compliant By Exemption |  | 100 | 0.043 | 4.300 | 100 | 50 | 50 | 2.15 | 2.15
5 | 603-RC0402FR-075K1L | RC0402FR-075K1L | Yageo | std | Thick Film Resistors - SMD 5.1K OHM 1% | RoHS Compliant By Exemption |  | 100 | 0.043 | 4.300 | 100 | 50 | 50 | 2.15 | 2.15
6 | 595-INA226AIDGSR | INA226AIDGSR | Texas Instruments | std | Current & Power Monitors & Regulators Hi-Side Msmt,Bi-Dir Current/Pwr Mon | RoHS Compliant |  | 10 | 27.520 | 275.200 | 10 | 5 | 5 | 137.60 | 137.60
7 | 875-MI0603J600R-10 | MI0603J600R-10 | Laird Performance Materials | std | Ferrite Beads 60ohms 100MHz 1A Monolithic 0603 SMD | RoHS Compliant |  | 50 | 0.161 | 8.050 | 50 | 25 | 25 | 4.03 | 4.03
8 | 595-TLV9052SIDGSR | TLV9052SIDGSR | Texas Instruments | Y (mj) | Operational Amplifiers - Op Amps Dual 5MHz, 15V/us high slew-rate, RRIO op amp 10-VSSOP -40 to 125 | RoHS Compliant | New Product | 20 | 7.280 | 145.600 | 20 | 10 | 10 | 72.80 | 72.80
9 | 595-TLV9051SIDBVR | TLV9051SIDBVR | Texas Instruments | Y (mj) | Operational Amplifiers - Op Amps OPAMP | RoHS Compliant | New Product | 20 | 4.920 | 98.400 | 20 | 10 | 10 | 49.20 | 49.20
10 | 595-REF6125IDGKR | REF6125IDGKR | Texas Instruments | Y (mj) | Voltage References | RoHS Compliant |  | 4 | 44.870 | 179.480 | 4 | 2 | 2 | 89.74 | 89.74
11 | 584-AD8552ARUZ-R | AD8552ARUZ-REEL | Analog Devices Inc. | Y (mj) | Precision Amplifiers DUAL PRECISION RAIL-RAIL CHOPPER OP AMP | RoHS Compliant |  | 10 | 40.810 | 408.100 | 10 | 5 | 5 | 204.05 | 204.05
12 | 546-1455T2201BK | 1455T2201BK | Hammond | n/a | Enclosures, Boxes & Cases MetalEndPanel, Black 8.66 x 2.03 x 6.50" | RoHS Compliant |  | 1 | 349.040 | 349.040 | 1 | 1 | 0 | 349.04 | 0.00
13 | 595-TPS2HB16AQPWPRQ1 | TPS2HB16AQPWPRQ1 | Texas Instruments | Y (mj) | Power Switch ICs - Power Distribution 40V 16m Dual-channel smart high-side switch 16-HTSSOP -40 to 125 | RoHS Compliant By Exemption | New Product | 10 | 27.520 | 275.200 | 10 | 5 | 5 | 137.60 | 137.60
14 | 595-NE556DR | NE556DR | Texas Instruments | std | Timers & Support Products DUAL PRECISION TIMER | RoHS Compliant |  | 10 | 3.130 | 31.300 | 10 | 5 | 5 | 15.65 | 15.65
15 | 595-TLV1117LV30DCYR | TLV1117LV30DCYR | Texas Instruments | Y (mj) | LDO Voltage Regulators 1A,Pos Fixed Vltg LDO Linear Reg | RoHS Compliant |  | 20 | 3.820 | 76.400 | 20 | 10 | 10 | 38.20 | 38.20
16 | 647-UCL1V470MCL1GS | UCL1V470MCL1GS | Nichicon | Y (mj) | Aluminium Electrolytic Capacitors - SMD 35V 47 uF 105CSMT AEC-Q200 | RoHS Compliant |  | 10 | 3.460 | 34.600 | 10 | 5 | 5 | 17.30 | 17.30
17 | 595-TPS54332DDAR | TPS54332DDAR | Texas Instruments | Y (mj) | Switching Voltage Regulators DC/DC Converter with Eco-mode | RoHS Compliant |  | 10 | 13.820 | 138.200 | 10 | 5 | 5 | 69.10 | 69.10
18 | 863-MBRS340T3G | MBRS340T3G | ON Semiconductor | Y (mj) | Schottky Diodes & Rectifiers 3A 40V | RoHS Compliant |  | 10 | 3.470 | 34.700 | 10 | 5 | 5 | 17.35 | 17.35
19 | 815-ASPI0630LR3R3T15 | ASPI-0630LR-3R3M-T15 | ABRACON | Y (mj) | Fixed Inductors 3.3uH 20% -55C +125C | RoHS Compliant |  | 10 | 8.000 | 80.000 | 10 | 5 | 5 | 40.00 | 40.00
20 | 661-APXG160A101ME61G | APXG160ARA101ME61G | United Chemi-Con (UCC) | Y (mj) | Aluminium Organic Polymer Capacitors 16Volts 100uF 5X6 | RoHS Compliant |  | 10 | 4.990 | 49.900 | 10 | 5 | 5 | 24.95 | 24.95
21 | 453-DIO6809RST3 | DIO6809RST3 | DIOO | Y (mj) | Supervisory Circuits Ultra Low Power Microprocessor Reset Circuit (2.63V) | RoHS Compliant |  | 20 | 1.500 | 30.000 | 20 | 10 | 10 | 15.00 | 15.00
22 | 595-SN74LVC1G175DCKR | SN74LVC1G175DCKR | Texas Instruments | mj/std | Flip-Flops Single D-Type Flip-Flop | RoHS Compliant |  | 100 | 0.771 | 77.100 | 100 | 50 | 50 | 38.55 | 38.55
23 | 595-SN74LVC74APWRG4 | SN74LVC74APWRG4 | Texas Instruments | mj/std | Flip-Flops ALT 595-SN74LVC74APWR | RoHS Compliant |  | 10 | 2.990 | 29.900 | 10 | 5 | 5 | 14.95 | 14.95
24 | 798-FH34SRJ30S05SH50 | FH34SRJ-30S-0.5SH(50) | Hirose Electric |  | FFC & FPC Connectors 30P SMT HORIZ ZIF AU 1MM HGHT .5MM PITCH | RoHS Compliant |  | 10 | 19.810 | 198.100 | 10 | 5 | 5 | 99.05 | 99.05
25 | 706-87DC3-201 | 87DC3-201 | Grayhill | Y (mj) | Input Devices Keypad, 2 button | RoHS Compliant |  | 2 | 64.050 | 128.100 | 2 | 2 | 0 | 128.10 | 0.00
26 | 612-PS1023ABLK | PS1023ABLK | E-Switch |  | Pushbutton Switches 3A 125VAC Off-(On) Black | RoHS Compliant |  | 10 | 13.490 | 134.900 | 10 | 10 | 0 | 134.90 | 0.00
27 | 633-FB15ANEP2-HB | FB15ANEP2-HB | NKK Switches |  | Pushbutton Switches SPST OFF(ON) WHITE CAP | RoHS Compliant |  | 12 | 33.950 | 407.400 | 12 | 6 | 6 | 203.70 | 203.70
 |  |  |  |  |  |  |  |  |  |  | (sum of subtotals) |  | Totalt SEK: | 2171.24 | 1442.23
By submitting your order you agree to these terms and conditions. (https://www.mouser.se/saleterms) |  |  |  |  |  |  |  |  | Merchandise Total: | 3613.470 | 3613.47 |  |  | Mathias | Jonny
Prices are reflected at the date and time shown. |  |  |  |  |  |  |  |  | Delivery Charge: | 0,00
