mjohansson/SolderingStation/doc/komponentbest_historik/best_jysd_msjo_elfa_digikey_20190218.xlsx

ELFA | www.elfa.se
Quantity | ELFA Article Number | Manufacturer | Manufacturer Article Number | Name | Availability | Stock | Expired On | My Single Price | My Subtotal | List Single Price | List Subtotal
2 | 18220630 | Weller | WMRP | Soldering Iron with High-Speed Control without Tip 40 W 450 °C 12 V | 24 h | 9 |  | Skr1,402.96 | Skr2,805.92 | Skr1,402.96 | Skr2,805.92
2 | 18267220 | Weller | RT 1 | Soldering Tip Conical 0.2mm | 24 h | 74 |  | Skr206.00 | Skr412.00 | Skr206.00 | Skr412.00
2 | 18267222 | Weller | RT 2 | Soldering Tip Conical 0.8mm | 24 h | 36 |  | Skr201.55 | Skr403.10 | Skr201.55 | Skr403.10
8 | 14250010 | Amphenol Industrial | T 3437 000 | Appliance socket C091B 7-pin Poles 7 - 360° 5 A 300 VAC/VDC | 24 h | 46 |  | Skr51.95 | Skr415.60 | Skr51.95 | Skr415.60
2 | 18242658 | Weller | WDH 50 | Soldering Iron Holder, Stop + Go | 24 h | 10 |  | Skr750.88 | Skr1,501.76 | Skr750.88 | Skr1,501.76
4 | 30044126 | Mean Well | LRS-150F-12 | DC Power Supply 150 W 12 V 12.5 A | 24 h | 44 |  | Skr177.00 | Skr708.00 | Skr177.00 | Skr708.00
2 | 30109648 | Schaffner | FN283-1-06 | Power inlet with filter 1 A 250 VAC | 24 h | 40 |  | Skr207.00 | Skr414.00 | Skr207.00 | Skr414.00
10 | 13317740 | Littelfuse | 0218001.MXP | Fuse 5 x 20 mm 1 A 250 V Time Lag T | 24 h | 5010 |  | Skr3.06 | Skr30.60 | Skr3.06 | Skr30.60
2 | 17313584 | Texas Instruments | OPA227PA | Operational Amplifier Single 8 MHz DIL-8, OPA227 | 24 h | 154 |  | Skr34.10 | Skr68.20 | Skr34.10 | Skr68.20
1 | 18249463 | Edsyn | F-SW32 70G 0.50MM | Solder Wire F-SW 32 178°C 0.5mm | 24 h | 57 |  | Skr117.00 | Skr117.00 | Skr117.00 | Skr117.00
1 | 18200065 | Multicore | CRYSTAL 400, 250G 0.32MM | Solder Wire Kristall 400 188°C 0.32mm | 24 h | 63 |  | Skr346.00 | Skr346.00 | Skr346.00 | Skr346.00
3 | 30079641 | Schurter | 3101.0060 | Fuse Holder ø 5 x 20 mm | 24 h | 95 |  | Skr21.90 | Skr65.70 | Skr21.90 | Skr65.70
10 | 13352406 | Eska | 522.528 | Fuse 5 x 20 mm 12.5 A 125 V Time Lag T | 24 h | 341 |  | Skr2.06 | Skr20.55 | Skr2.06 | Skr20.55
 |  |  |  |  |  |  |  |  | TOT | 7308.43 | SEK | exkl.moms
UPPDELNING
jysd | 3876.69 | SEK
msjo | 3431.74 | SEK
DIGIKEY |  | www.digikey.se
 | Quantity | Part Number | Manufacturer Part Number | Description | Customer Reference | Available | Backorder | Unit Price | Extended Price SEK
 | 10 | NHD-3.12-25664UCW2-ND | NHD-3.12-25664UCW2 | 3.12 GRAPHIC WHITE OLED |  | 10 | 0 | 264.51 | 2645.10
 | 2 | HM1505-ND | 1455T2201BK | BOX ALUM BLACK 8.66"L X 6.5"W |  | 2 | 0 | 310.70 | 621.40
 | 1 | HM1507-ND | 1455TALBK-10 | END PANEL ALUMINUM BLACK 10/PACK |  | 1 | 0 | 286.66 | 286.66
 | 250 | 455-1313-1-ND | SPHD-002T-P0.5 | CONN SOCKET 24-28AWG CRIMP TIN |  | 250 | 0 | 0.25312 | 63.28
 | 12 | DMP4025LSD-13DICT-ND | DMP4025LSD-13 | MOSFET 2P-CH 40V 6.9A 8SO |  | 12 | 0 | 85.16 | 102.19
 | 4 | MCP6V02-E/SN-ND | MCP6V02-E/SN | IC OPAMP CHOPPER 1.3MHZ 8SOIC |  | 4 | 0 | 23.78 | 95.12
 |  |  |  |  |  |  |  | TOT | 3813.75 | SEK
UPPDELNING
jysd | 1243.64 | SEK
msjo | 2570.11 | SEK
