mjohansson/SolderingStation/doc/komponentbest_historik/cart__20190306121744.xls

Quantity | Distrelec Article Number | Reference | Manufacturer | Manufacturer Article Number | Name | Availability | Stock | Expired On | My Single Price | My Subtotal | List Single Price | List Subtotal
2 | 30109634 |  | Schaffner | FN261206 | Power inlet with filter 2 A 250 VAC | 24 h | 59 |  | 103,00 Skr | 206,00 Skr | 103,00 Skr | 206,00 Skr
3 | 11077356 |  | Mentor | 5555.6612 | Rotary knob with line Aluminium 16 mm 28 mm | 24 h | 3 |  | 25,59 Skr | 76,77 Skr | 25,59 Skr | 76,77 Skr
4 | 11077373 |  | Mentor | 512.61 | Rotary knob without line Aluminium 15 mm 20 mm | 24 h | 70 |  | 27,14 Skr | 108,56 Skr | 27,14 Skr | 108,56 Skr
4 | 11077383 |  | Mentor | 5572.6000 | Rotary knob without disc Aluminium 15 mm 20 mm | 24 h | 31 |  | 27,09 Skr | 108,36 Skr | 27,09 Skr | 108,36 Skr
10 | 30109756 |  | RND Components | RND 210-00549 | Power Rocker Switch, Black, On-Off | 24 h | 291 |  | 12,70 Skr | 127,00 Skr | 12,70 Skr | 127,00 Skr
4 | 30109758 |  | RND Components | RND 210-00551 | Power Rocker Switch, Black, On-Off | 24 h | 343 |  | 21,90 Skr | 87,60 Skr | 21,90 Skr | 87,60 Skr
6 | 30106682 |  | Cliff | CL1736 | Knob Cap Grey 13.21 mm | 24 h | 65 |  | 1,85 Skr | 11,10 Skr | 1,85 Skr | 11,10 Skr
10 | 30106680 |  | Cliff | CL1730 | Knob Cap Black 13.21 mm | 24 h | 64 |  | 1,85 Skr | 18,50 Skr | 1,85 Skr | 18,50 Skr
10 | 30106693 |  | Cliff | CL178883 | Rotary Knob Black 19.2 mm 19.3 mm | 24 h | 89 |  | 3,29 Skr | 32,90 Skr | 3,29 Skr | 32,90 Skr
10 | 30022459 |  | Texas Instruments | ADS1110A0IDBVT | A/D converter IC 16 b SOT-23-6, ADS1110 | 24 h | 214 |  | 15,43 Skr | 154,30 Skr | 15,43 Skr | 154,30 Skr
4 | 17321857 |  | Analog Devices | AD8552ARZ | Operational Amplifier, Dual, 1.5 MHz, SO-8 | 24 h | 84 |  | 42,64 Skr | 170,56 Skr | 42,64 Skr | 170,56 Skr
5 | 30008375 |  | BI Technologies | P160KN2-0QA25B10K | Rotary Potentiometer, 10 kOhm, PCB Pins | 24 h | 1102 |  | 8,01 Skr | 40,05 Skr | 8,01 Skr | 40,05 Skr
5 | 30008368 |  | BI Technologies | P160KN-0QC15C100K | Rotary Potentiometer, 100 kOhm, PCB Pins | 24 h | 856 |  | 8,53 Skr | 42,65 Skr | 8,53 Skr | 42,65 Skr
5 | 30008361 |  | BI Technologies | P160KN-0QC15A500K | Rotary Potentiometer, 500 kOhm, PCB Pins | 24 h | 637 |  | 8,94 Skr | 44,70 Skr | 8,94 Skr | 44,70 Skr
