mjohansson/SolderingStation/doc/komponentbest_historik/Mouser_Basket_Mar11_0352PM.xls

SHOPPING BASKET
This is not an invoice
11-Mar-20 15:52:36
 | Mouser No | Mfr. No | Manufacturer | Customer No | Description | RoHS | Lifecycle | Order Qty. | Price (SEK) | Ext.: (SEK)
1 | 950-IP101GA | IP101GA | WIZnet |  | Ethernet ICs PHY Chip | RoHS Compliant |  | 10 | 11,14 kr | 111,40 kr
2 | 710-74980104400 | 74980104400 | Wurth Elektronik |  | Modular Connectors / Ethernet Connectors WE-RJ45 Intgtd XFMR 10/100Base-T | RoHS Compliant | New Product | 5 | 50,12 kr | 250,60 kr
3 | 732-322525MF10P-C | TSX-3225 25.0000MF10P-C | Epson |  | Crystals 25MHz 10ppm 18pF -20C +85C | RoHS Compliant |  | 20 | 2,66 kr | 53,20 kr
4 | 603-RC0402FR-076K19L | RC0402FR-076K19L | Yageo |  | Thick Film Resistors - SMD 6.19K OHM 1% | RoHS Compliant By Exemption |  | 100 | 0,043 kr | 4,30 kr
5 | 603-RC0402FR-075K1L | RC0402FR-075K1L | Yageo |  | Thick Film Resistors - SMD 5.1K OHM 1% | RoHS Compliant By Exemption |  | 100 | 0,043 kr | 4,30 kr
6 | 595-INA226AIDGSR | INA226AIDGSR | Texas Instruments |  | Current & Power Monitors & Regulators Hi-Side Msmt,Bi-Dir Current/Pwr Mon | RoHS Compliant |  | 10 | 27,52 kr | 275,20 kr
7 | 875-MI0603J600R-10 | MI0603J600R-10 | Laird Performance Materials |  | Ferrite Beads 60ohms 100MHz 1A Monolithic 0603 SMD | RoHS Compliant |  | 50 | 0,161 kr | 8,05 kr
8 | 595-TLV9052SIDGSR | TLV9052SIDGSR | Texas Instruments |  | Operational Amplifiers - Op Amps Dual 5MHz, 15V/us high slew-rate, RRIO op amp 10-VSSOP -40 to 125 | RoHS Compliant | New Product | 20 | 7,28 kr | 145,60 kr
9 | 595-TLV9051SIDBVR | TLV9051SIDBVR | Texas Instruments |  | Operational Amplifiers - Op Amps OPAMP | RoHS Compliant | New Product | 20 | 4,92 kr | 98,40 kr
10 | 595-REF6125IDGKR | REF6125IDGKR | Texas Instruments |  | Voltage References | RoHS Compliant |  | 4 | 44,87 kr | 179,48 kr
11 | 584-AD8552ARUZ-R | AD8552ARUZ-REEL | Analog Devices Inc. |  | Precision Amplifiers DUAL PRECISION RAIL-RAIL CHOPPER OP AMP | RoHS Compliant |  | 10 | 40,81 kr | 408,10 kr
12 | 546-1455T2201BK | 1455T2201BK | Hammond |  | Enclosures, Boxes & Cases MetalEndPanel, Black 8.66 x 2.03 x 6.50" | RoHS Compliant |  | 1 | 349,04 kr | 349,04 kr
13 | 595-TPS2HB16AQPWPRQ1 | TPS2HB16AQPWPRQ1 | Texas Instruments |  | Power Switch ICs - Power Distribution 40V 16m Dual-channel smart high-side switch 16-HTSSOP -40 to 125 | RoHS Compliant By Exemption | New Product | 10 | 27,52 kr | 275,20 kr
14 | 595-NE556DR | NE556DR | Texas Instruments |  | Timers & Support Products DUAL PRECISION TIMER | RoHS Compliant |  | 10 | 3,13 kr | 31,30 kr
15 | 595-TLV1117LV30DCYR | TLV1117LV30DCYR | Texas Instruments |  | LDO Voltage Regulators 1A,Pos Fixed Vltg LDO Linear Reg | RoHS Compliant |  | 20 | 3,82 kr | 76,40 kr
16 | 647-UCL1V470MCL1GS | UCL1V470MCL1GS | Nichicon |  | Aluminium Electrolytic Capacitors - SMD 35V 47 uF 105CSMT AEC-Q200 | RoHS Compliant |  | 10 | 3,46 kr | 34,60 kr
17 | 595-TPS54332DDAR | TPS54332DDAR | Texas Instruments |  | Switching Voltage Regulators DC/DC Converter with Eco-mode | RoHS Compliant |  | 10 | 13,82 kr | 138,20 kr
18 | 863-MBRS340T3G | MBRS340T3G | ON Semiconductor |  | Schottky Diodes & Rectifiers 3A 40V | RoHS Compliant |  | 10 | 3,47 kr | 34,70 kr
19 | 815-ASPI0630LR3R3T15 | ASPI-0630LR-3R3M-T15 | ABRACON |  | Fixed Inductors 3.3uH 20% -55C +125C | RoHS Compliant |  | 10 | 8,00 kr | 80,00 kr
20 | 661-APXG160A101ME61G | APXG160ARA101ME61G | United Chemi-Con (UCC) |  | Aluminium Organic Polymer Capacitors 16Volts 100uF 5X6 | RoHS Compliant |  | 10 | 4,99 kr | 49,90 kr
21 | 453-DIO6809RST3 | DIO6809RST3 | DIOO |  | Supervisory Circuits Ultra Low Power Microprocessor Reset Circuit (2.63V) | RoHS Compliant |  | 20 | 1,50 kr | 30,00 kr
22 | 595-SN74LVC1G175DCKR | SN74LVC1G175DCKR | Texas Instruments |  | Flip-Flops Single D-Type Flip-Flop | RoHS Compliant |  | 100 | 0,771 kr | 77,10 kr
23 | 595-SN74LVC74APWRG4 | SN74LVC74APWRG4 | Texas Instruments |  | Flip-Flops ALT 595-SN74LVC74APWR | RoHS Compliant |  | 10 | 2,99 kr | 29,90 kr
24 | 798-FH34SRJ30S05SH50 | FH34SRJ-30S-0.5SH(50) | Hirose Electric |  | FFC & FPC Connectors 30P SMT HORIZ ZIF AU 1MM HGHT .5MM PITCH | RoHS Compliant |  | 10 | 19,81 kr | 198,10 kr
25 | 706-87DC3-201 | 87DC3-201 | Grayhill |  | Input Devices Keypad, 2 button | RoHS Compliant |  | 2 | 64,05 kr | 128,10 kr
26 | 612-PS1023ABLK | PS1023ABLK | E-Switch |  | Pushbutton Switches 3A 125VAC Off-(On) Black | RoHS Compliant |  | 10 | 13,49 kr | 134,90 kr
27 | 633-FB15ANEP2-HB | FB15ANEP2-HB | NKK Switches |  | Pushbutton Switches SPST OFF(ON) WHITE CAP | RoHS Compliant |  | 12 | 33,95 kr | 407,40 kr
By submitting your order you agree to these terms and conditions. (https://www.mouser.se/saleterms) |  |  |  |  |  |  |  |  | Merchandise Total: | 3.613,47 kr
Prices are reflected at the date and time shown. |  |  |  |  |  |  |  |  | Delivery Charge: | 0,00 kr
