mjohansson/SolderingStation/doc/komponentbest_historik/rs_online_2020-03-11-utan_display-med_knappar.xlsx

RS-online |  |  |  | https://se.rs-online.com/web/
Quantity | Part number | Manufacturer | Description | Item link | Available | Backorder | Unit price SEK | Subtotal SEK | Mathias Qty | Jonny Qty | Mathias subtotal | Jonny subtotal
2 | 176-3374 | Weller | Weller WSR 203 Soldering Iron Stand for use with WMRT Soldering Station | https://se.rs-online.com/web/p/soldering-iron-accessories/1763374/ | 2 | 0 | 793.85 | 1587.7 | 1 | 1 | 793.85 | 793.85
2 | 620-4933 | Weller | Weller WMRT 12V Soldering Tweezers, 80W | https://se.rs-online.com/web/p/desoldering-tweezers/6204933/ | 17 | 0 | 1419 | 2838 | 1 | 1 | 1419 | 1419
2 | 620-4955 | Weller | Weller RTW 1 0.4 mm Bent Conical Soldering Iron Tip for use with WMRT Soldering Tweezers | https://se.rs-online.com/web/p/soldering-iron-tips/6204955/ | 76 | 0 | 516 | 1032 | 1 | 1 | 516 | 516
2 | 620-4977 | Weller | Weller RTW2 0.7 x 0.4 mm Bent Conical Soldering Iron Tip for use with WMRT Soldering Tweezers | https://se.rs-online.com/web/p/soldering-iron-tips/6204977/ | 69 | 0 | 516 | 1032 | 1 | 1 | 516 | 516
1 | 801-4776 | Weller | Weller RTW 10 10 x 1 mm Straight Chisel Soldering Iron Tip | https://se.rs-online.com/web/p/soldering-iron-tips/8014776/ | 17 | 0 | 932.77 | 932.77 | 1 | 0 | 932.77 | 0
4 | 111-5804 | RS Pro | Double Pole Double Throw (DPDT) Latching Push Button Switch, IP67, 19mm, Panel Mount, Power Symbol, 250V ac | https://se.rs-online.com/web/p/push-button-switches/1115804/ | 17 | 0 | 65.56 | 262.24 | 4 | 0 | 262.24 | 0
4 | 111-5789 | RS Pro | Double Pole Double Throw (DPDT) Latching Push Button Switch, IP67, 19.2 (Dia.)mm, Panel Mount, 250V ac | https://se.rs-online.com/web/p/push-button-switches/1115789/ | 67 | 0 | 62.76 | 251.04 | 4 | 0 | 251.04 | 0
4 | 792-6041 | STMicroelectronics | STM32F429VIT6, 32bit ARM Cortex M4 MCU, 180MHz, 2.048 MB Flash, 100-Pin LQFP | https://se.rs-online.com/web/p/microcontrollers/7926041/ | 20 | 0 | 117.57 | 470.28 | 2 | 2 | 235.14 | 235.14
0 | 909-2020 | Newhaven Display | NHD-3.12-25664UCB2 LCD Colour Display, 3.12in, 128 x 64pixels | https://se.rs-online.com/web/p/lcd-colour-displays/9092020/ | 1 | 0 | 300.27 | 0 | 0 | 0 | 0 | 0
1 | 909-3660 | STMicroelectronics | Discovery MCU Development Kit with STM32F429ZIT6 - STM32F429I-DISC1 | https://se.rs-online.com/web/p/processor-microcontroller-development-kits/9093660/ | 108 | 0 | 283.94 | 283.94 | 0 | 1 | 0 | 283.94
2 | 687-7783 | FTDI Chip | FTDI Chip, 3.3 V TTL 3.5mm Jack USB to UART Cable, TTL-232R-3V3-AJ | https://se.rs-online.com/web/p/interface-development-kits/6877783/ | 14 | 0 | 185.81 | 371.62 | 2 | 0 | 371.62 | 0
20 | 662-8720 | Texas Instruments | SN74LVC1G11DCKR, 3-Input AND Logic Gate, 1.65 → 5.5 V, 6-Pin SC-70 | https://se.rs-online.com/web/p/logic-gates/6628720/ | 240 | 0 | 2.461 | 49.22 | 10 | 10 | 24.61 | 24.61
200 | 751-2816 | DiodesZetex | DiodesZetex 74LVC1G126SE-7 Buffer & Line Driver, 3-State, 1.65-5.5V, 5-Pin SOT-353 | https://se.rs-online.com/web/p/buffer-line-driver-combinations/7512816/ | 6900 | 0 | 0.851 | 170.2 | 100 | 100 | 85.1 | 85.1
2 | 754-1999 | RS Pro | RS PRO 3 → 30 V dc 85dB Panel Mount Continuous Internal Piezo Buzzer, 2000 → 3000 Hz | https://se.rs-online.com/web/p/piezo-buzzer-components/7541999/ | 219 | 0 | 22.54 | 45.08 | 1 | 1 | 22.54 | 22.54
20 | 126-0395 | Arcol Ohmite | 10mΩ 1632 Metal Film SMD Resistor ±1% 1W - MCS1632R010FER | https://se.rs-online.com/web/p/surface-mount-fixed-resistors/1260395/ | 4560 | 0 | 1.596 | 31.92 | 10 | 10 | 15.96 | 15.96
2 | 498-6699 | Weller | Weller RT6 1.2 mm Straight Hoof Soldering Iron Tip for use with WMRP Micro Soldering Pencil | https://se.rs-online.com/web/p/soldering-iron-tips/4986699/ | 220 | 0 | 206.4 | 412.8 | 1 | 1 | 206.4 | 206.4
2 | 176-6889 | Weller | Weller RT 1SCNW 0.3 mm Straight Chisel Soldering Iron Tip | https://se.rs-online.com/web/p/soldering-iron-tips/1766889/ | 11 | 0 | 258 | 516 | 1 | 1 | 258 | 258
2 | 184-6667 | Weller | RTM 002 C L TIP CONICAL D0.2 | https://se.rs-online.com/web/p/soldering-iron-tips/1846667/ | 11 | 0 | 264.4 | 528.8 | 1 | 1 | 264.4 | 264.4
2 | 184-6674 | Weller | RTM 018 S TIP CHISEL 1.8X0.4 | https://se.rs-online.com/web/p/soldering-iron-tips/1846674/ | 25 | 0 | 264.4 | 528.8 | 1 | 1 | 264.4 | 264.4
2 | 498-6756 | Weller | Weller RT 1 0.2 mm Straight Conical Soldering Iron Tip for use with WMRP Micro Soldering Pencil | https://se.rs-online.com/web/p/soldering-iron-tips/4986756/ | 530 | 0 | 206.4 | 412.8 | 1 | 1 | 206.4 | 206.4
2 | 610-9484 | Weller | Weller RT 10 GW 1.2 mm Straight Hoof Soldering Iron Tip for use with WMRP Micro Soldering Pencil | https://se.rs-online.com/web/p/soldering-iron-tips/6109484/ | 8 | 0 | 206.4 | 412.8 | 1 | 1 | 206.4 | 206.4
4 | 734-6776 | RS Pro | Single Pole Double Throw (SPDT) Momentary Push Button Switch, 12.7 x 15.7mm, Panel Mount | https://se.rs-online.com/web/p/push-button-switches/7346776/ | 4 | 0 | 9.68 | 38.72 | 4 | 0 | 38.72 | 0
 |  |  |  |  |  |  | Tot: | 12208.73 |  |  | 6890.59 | 5318.14
 |  |  |  |  |  |  |  |  |  |  | Mathias | Jonny
