mjohansson/SolderingStation/mech/QuickConnect_Spade_terminals_lugs/Female_QuickConn-6_35mm-Full_insul-MNU18-187DFIK.STEP

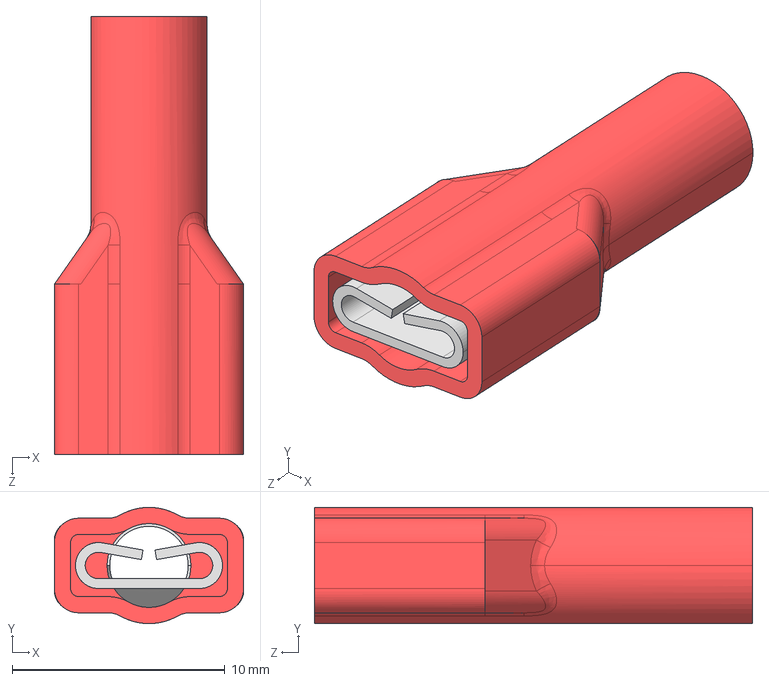
[picture p23: CAD file, 2020-10-26]
mech/QuickConnect_Spade_terminals_lugs/Female_QuickConn-6_35mm-Full_insul-MNU18-187DFIK.STEP
8.89 x 5.46 x 20.6 mm
