mjohansson/SolderingStation/hw/ss_frontpanel_inner_plate/3d_exports/Frontpanel_LeftBtnholder_Assembly.FCStd

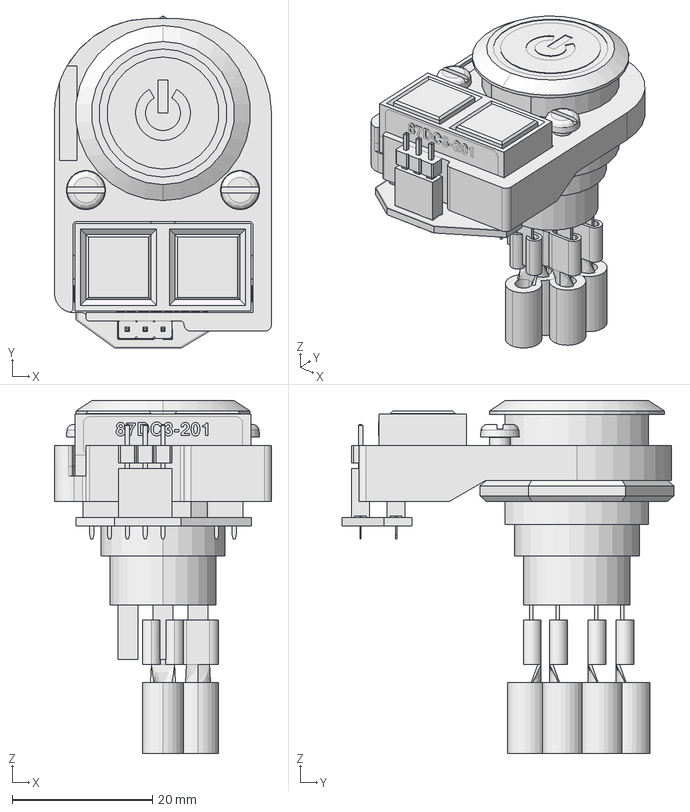
[picture p24: CAD file, 2022-02-02]
hw/ss_frontpanel_inner_plate/3d_exports/Frontpanel_LeftBtnholder_Assembly.FCStd
31.0 x 47.4 x 50.4 mm
