mjohansson/SolderingStation/hw/ss_frontpanel_inner_plate/3d_exports/Frontpanel_RightBtnholder_Assembly.FCStd

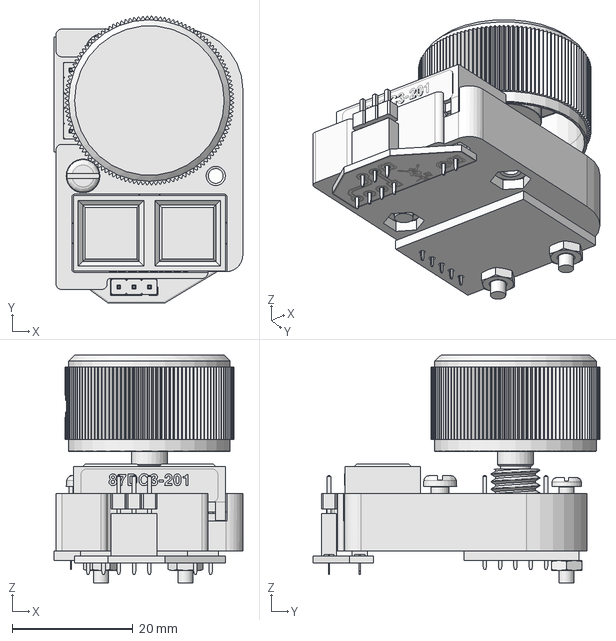
[picture p25: CAD file, 2022-02-02]
hw/ss_frontpanel_inner_plate/3d_exports/Frontpanel_RightBtnholder_Assembly.FCStd
31.3 x 47.5 x 37.8 mm
