mjohansson/SolderingStation/mech/QuickConnect_Spade_terminals_lugs/Female QuickConnect-6_35mm-Full_insul.STEP

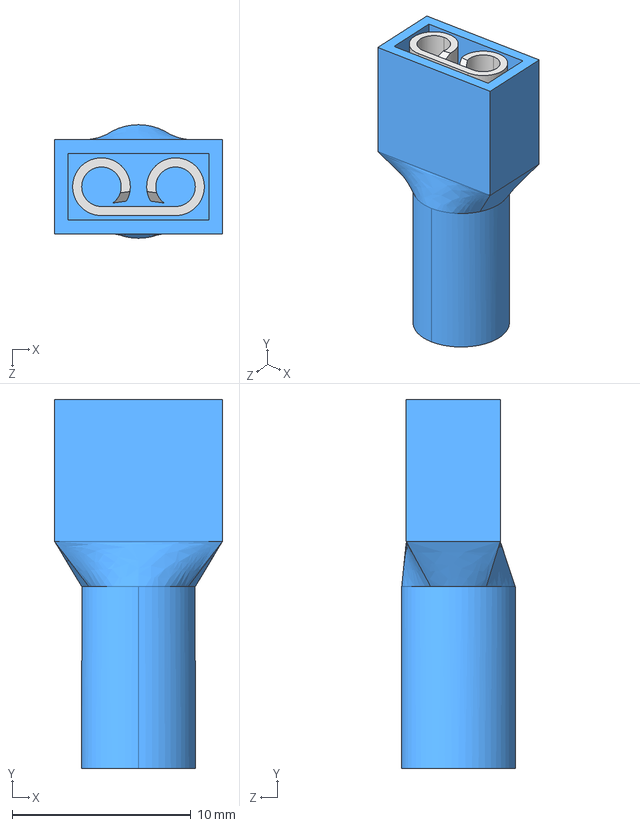
[picture p26: CAD file, 2020-10-26]
mech/QuickConnect_Spade_terminals_lugs/Female QuickConnect-6_35mm-Full_insul.STEP
9.40 x 20.6 x 6.35 mm
