mjohansson/SolderingStation/mech/QuickConnect_Spade_terminals_lugs/Female QuickConnect-4_8mm_Full_insul.STEP

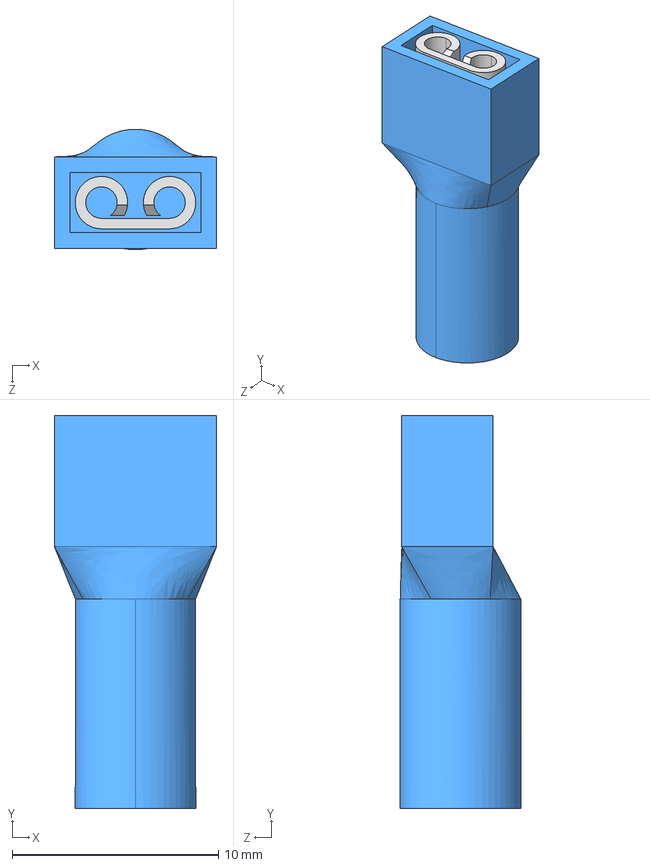
[picture p27: CAD file, 2020-10-26]
mech/QuickConnect_Spade_terminals_lugs/Female QuickConnect-4_8mm_Full_insul.STEP
7.87 x 19.1 x 5.84 mm
