mjohansson/SolderingStation/mech/MJ_3d_holder_right_3p-r3-asm.FCStd

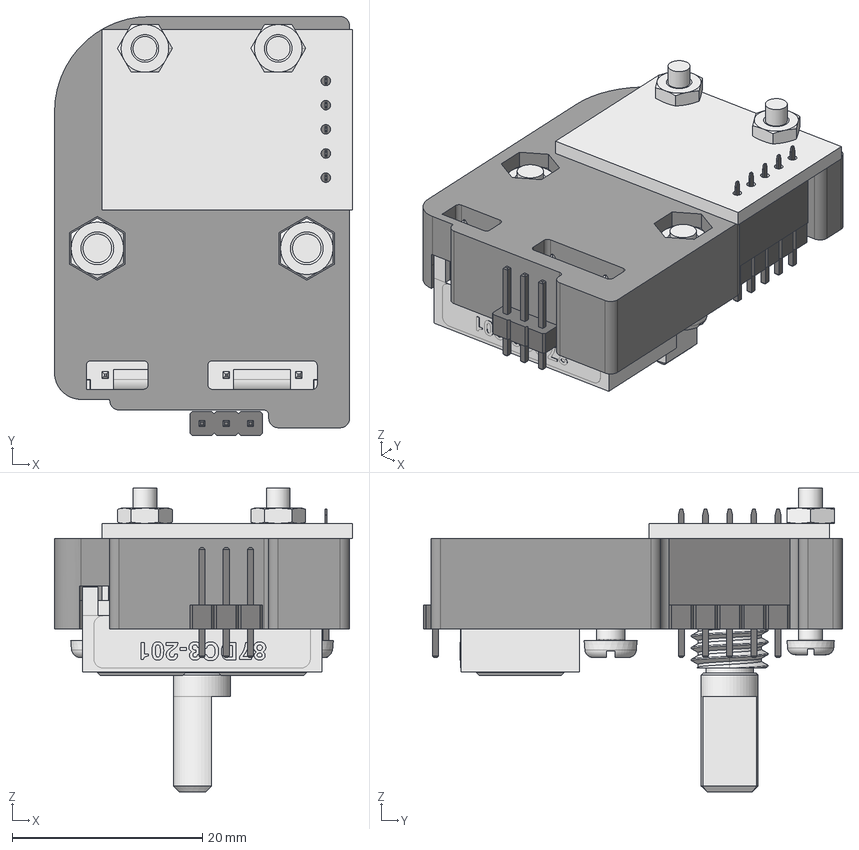
[picture p28: CAD file, 2020-08-24]
mech/MJ_3d_holder_right_3p-r3-asm.FCStd
31.3 x 44.0 x 31.9 mm
Compound_Grayhill_87DC3-201 x 2
KY040_Fused_Body x 2
M2.5-Nut x 2
3d_holder_right-r3 x 2
M2.5-Nut001 x 2
M3-Nut x 2
M3x10-Screw001 x 2
M3x10-Screw x 2
M2.5x16-Screw001 x 2
M3-Nut001 x 2
M2.5x16-Screw x 2
PinHeader_1x03_P254mm_Vertical
PinSocket_1x05_P254mm_Vertical x 2
PinHeader_1x05_P254mm_Vertical x 2
