mjohansson/SolderingStation/mech/MJ_3d_holder_left_hybrid_2nd_rotary-asm.FCStd

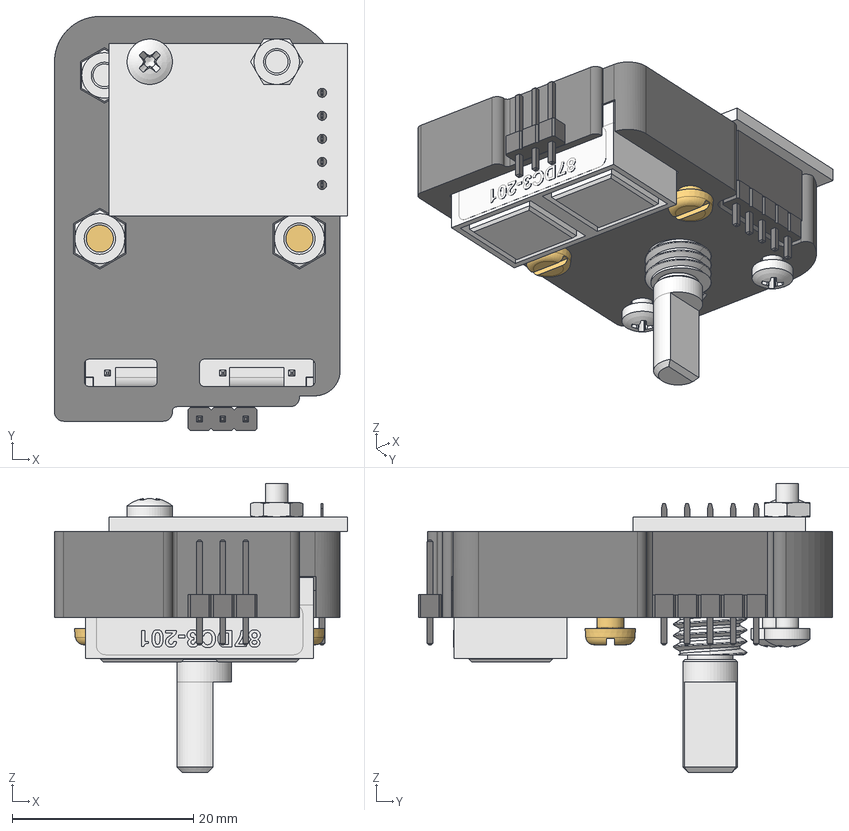
[picture p29: CAD file, 2020-08-24]
mech/MJ_3d_holder_left_hybrid_2nd_rotary-asm.FCStd
32.3 x 45.7 x 31.9 mm
PinHeader_1x03_P254mm_Vertical
M3x10-Screw
M3x10-Screw001
M3-Nut
M3-Nut001
Compound_Grayhill_87DC3-201
M2.5-Nut
M2.5x10-Screw
M2.5x16-Screw
PinHeader_1x05_P254mm_Vertical
PinSocket_1x05_P254mm_Vertical
M2.5x10-Screw001
M2.5-Nut001
3d_holder_left_hybrid_2nd_rotary001
M2.5-Nut002
KY040_Fused_Body
