mjohansson/SolderingStation/mech/MJ_3d_holder_left_v3-asm.FCStd

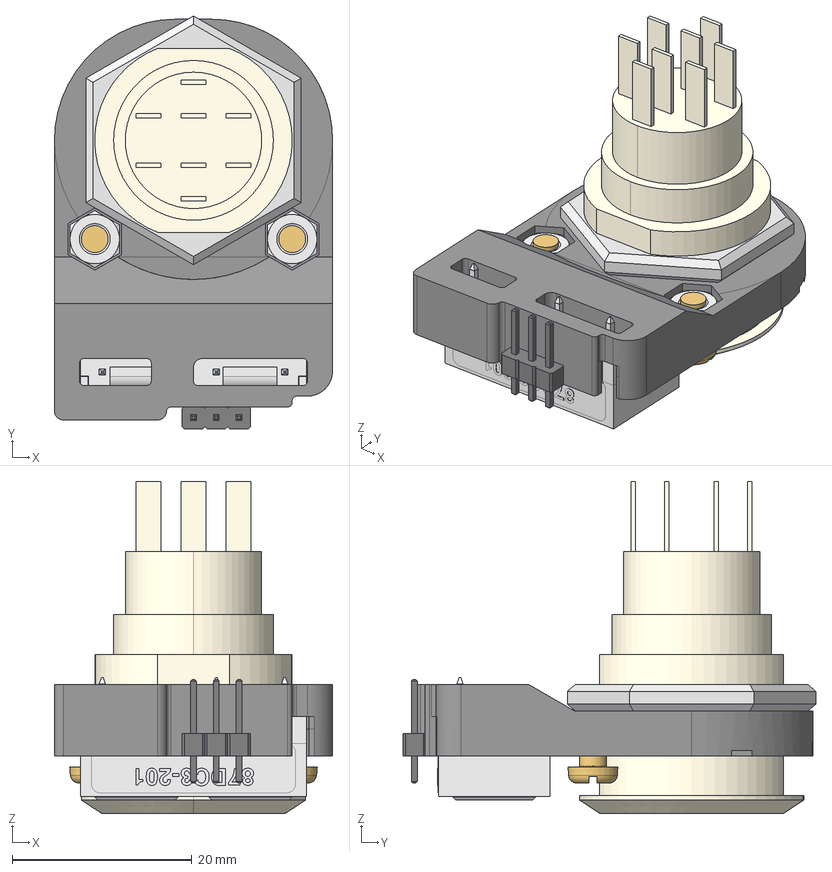
[picture p30: CAD file, 2020-08-24]
mech/MJ_3d_holder_left_v3-asm.FCStd
31.0 x 46.0 x 37.0 mm
M3x6-Screw
M3x6-Screw001
M3-Nut
M3-Nut001
RSpro_PowerButton_Blue
HexNut_M19_thin
Compound_Grayhill_87DC3-201
3d_holder_left_v004
PinHeader_1x03_P254mm_Vertical
