mjohansson/SolderingStation/mech/ss_frontpanel_inner_plate-2nd_rotary_test_asm.FCStd

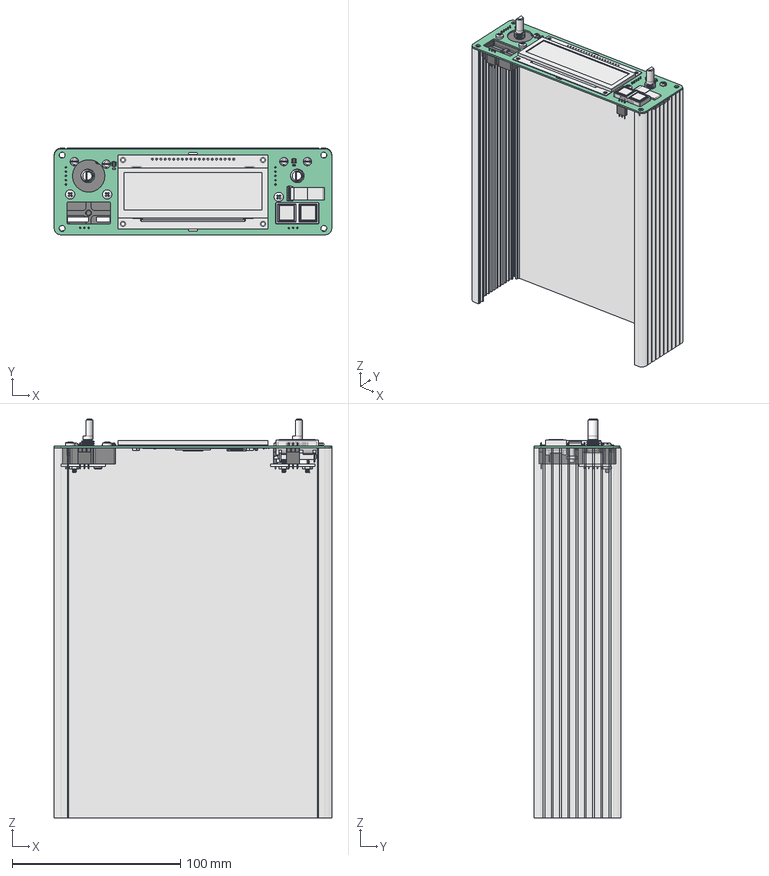
[picture p31: CAD file, 2020-08-23]
mech/ss_frontpanel_inner_plate-2nd_rotary_test_asm.FCStd
165.0 x 51.5 x 237.1 mm
ExtrusionBody
PinHeader_1x05_P254mm_Vertical
M2.5x10-Screw
M2.5x16-Screw
PinSocket_1x05_P254mm_Vertical
M8x7.0-ScrewTap
M2.5x6-Screw
M3x8-Screw
M3x10-Screw001
M3-Nut
M3-Nut001
M2.5-Nut
Pcb_c89d
OLED1_NHD-3.12-25664UCxx_5F25D347
J3_FFC_14p-WE_687114182122_rev1_5F262E23
U2_SOT_23_6_5F25D3EA
U1_SOT_23_6_5F40CC22
C9_C_0603_1608Metric_5F2C710A
C8_C_0603_1608Metric_5F40CBED
C13_C_0603_1608Metric_5F263377
U6_SOT_23_6_5F350444
ASM2_3dholder_right_asm-1xM3_5F225D96
U5_SOT_23_6_5F33FDD6
U4_SOT_23_6_5F323DDD
U3_SOT_23_6_5F25D400
R7_R_0603_1608Metric_5F25D3BE
R3_R_0603_1608Metric_5F345BAF
R2_R_0603_1608Metric_5F25D369
C12_C_0603_1608Metric_5F33FE10
C11_C_0603_1608Metric_5F25D1D3
C10_C_0603_1608Metric_5F25D1C2
C7_C_0603_1608Metric_5F25D18F
C6_C_0603_1608Metric_5F25D17E
C5_C_0603_1608Metric_5F25D16D
C4_C_0603_1608Metric_5F25D15C
C3_C_0603_1608Metric_5F25D14B
C2_C_0603_1608Metric_5F329F5C
C1_C_0603_1608Metric_5F25D129
J1_5052781433_5F23499A
J2_5052781433_5F2314F6
FFC1_FFC_50mm_folded_x2_5F281811
M2.5-Nut001
PinHeader_1x03_P254mm_Vertical
PinSocket_1x03_P254mm_Vertical
PinHeader_1x03_P254mm_Vertical001
PinSocket_1x03_P254mm_Vertical001
PinHeader_1x05_P254mm_Vertical001
PinSocket_1x05_P254mm_Vertical001
M8x7.0-ScrewTap001
M3x10-Screw
M2.5x16-Screw001
M2.5x16-Screw002
M2.5-Nut002
M2.5-Nut003
M3-Nut002
3d_holder_left_hybrid_2nd_rotary
