mjohansson/SolderingStation/mech/Grayhill_holder_test_assembly.FCStd

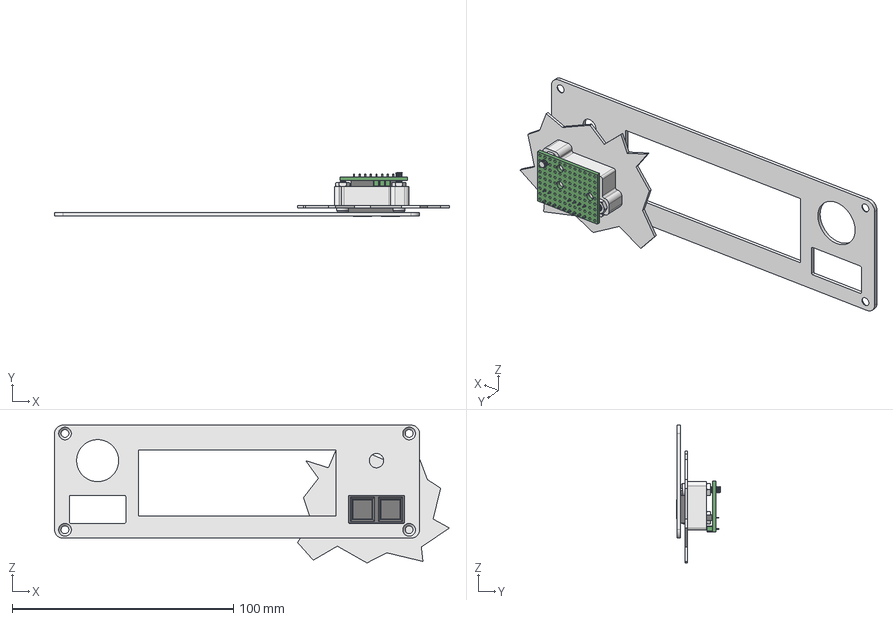
[picture p32: CAD file, 2020-08-18]
mech/Grayhill_holder_test_assembly.FCStd
178.5 x 19.7 x 62.3 mm
Buttons_with_pinsockets
BridgePCB_with_pinlist
ISO1580_M3x16
ISO1580_M3x12
NUT_M3x2
NUT_M3x2-001
carrier_PCB_1.2mm
FrontPlate1.5mm_with_Cutouts
Pocket-Grayhill_3d_holder_3mm-Right002
