mjohansson/SolderingStation/mech/MJ_reworked-SolderStation_Assembly.FCStd

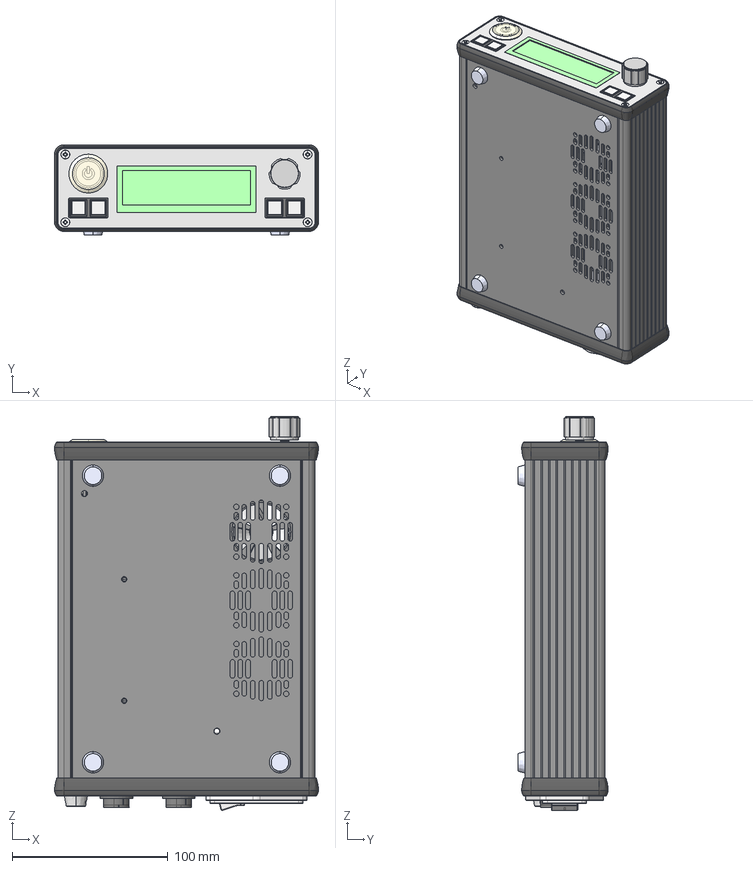
[picture p33: CAD file, 2020-08-18]
mech/MJ_reworked-SolderStation_Assembly.FCStd
169.5 x 58.1 x 252.9 mm
ExtrusionBody
BottomCapBody
1455 front screw001
1455 front screw002
1455 front screw003
1455 front screw004
1455 back screw001
1455 back screw002
1455 back screw003
1455 back screw004
T Front Bezel Open
T Back Bezel Open
MW_LRS150-Powerbar
MW_LRS150-Terminal_Vm2
MW_LRS150-Terminal_PE
MW_LRS150-Terminal_Vp1
MW_LRS150-Terminal_N
MW_LRS150_body
MW_LRS150-Terminal_L
MW_LRS150-Terminal_Vm1
MW_LRS150-Terminal_Vp2
Schaffner_FN283-1-06
Schurter-0031.0060_fuseholder
RS_Pro-PowerButton
RotaryEncoder-KY040
Alu-knob 20x15mm w detents & lock screw
NHD-3.12-25664UCY2
Backplate cutouts
Frontplate cutouts
DIN7-WellerConn1
DIN7-WellerConn2
87DC3-201
LabelTextExtrude
ButtonLeftBody
COMMON-Brass_pin-5.75mm
LabelBody
BTN_B-Brass_pin-5.75mm
ButtonRightBody
PCBBody
BTN_A-Brass_pin-5.75mm
87DC3-202
LabelTextExtrude001
ButtonLeftBody001
COMMON-Brass_pin-5.75mm001
LabelBody001
BTN_B-Brass_pin-5.75mm001
ButtonRightBody001
PCBBody001
BTN_A-Brass_pin-5.75mm001
House_K131247031_Stig-Wahlstrom_K131247031_Stig-Wahlstrom
Fan_K131247031_Stig-Wahlstrom_K131247031_Stig-Wahlstrom
POF-50185_push-on_feet-FL
POF-50185_push-on_feet-FR
POF-50185_push-on_feet-RL
POF-50185_push-on_feet-RR
