mjohansson/SolderingStation/mech/MJ_3d_holder_right_3p-r2-asm.FCStd

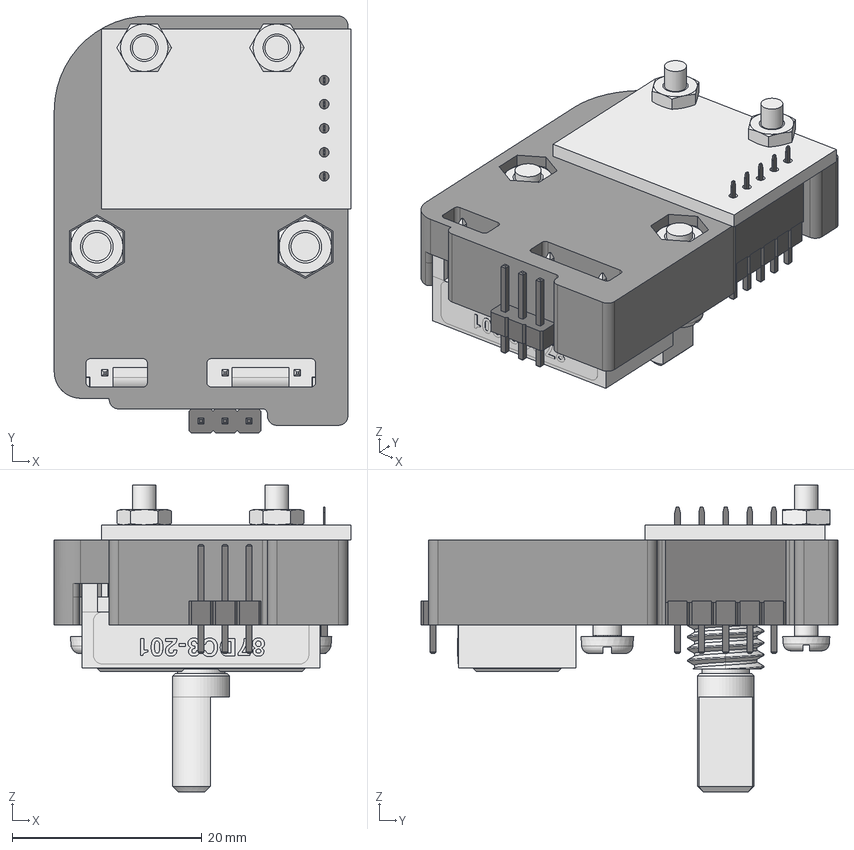
[picture p34: CAD file, 2020-08-18]
mech/MJ_3d_holder_right_3p-r2-asm.FCStd
31.3 x 44.0 x 32.4 mm
3d_holder_right-r2
Compound_Grayhill_87DC3-201
Compound_KY040_RotaryEncoder
M3x10-Screw
M3x10-Screw001
M3-Nut
M3-Nut001
M2.5x16-Screw
M2.5x16-Screw001
M2.5-Nut
M2.5-Nut001
PinHeader_1x03_P254mm_Vertical
PinHeader_1x05_P254mm_Vertical
PinSocket_1x05_P254mm_Vertical
