mjohansson/SolderingStation/doc/14p_05mm_FFC/Molex_505278-1433/FFC_14p-Molex_5052781433-colorized.stp

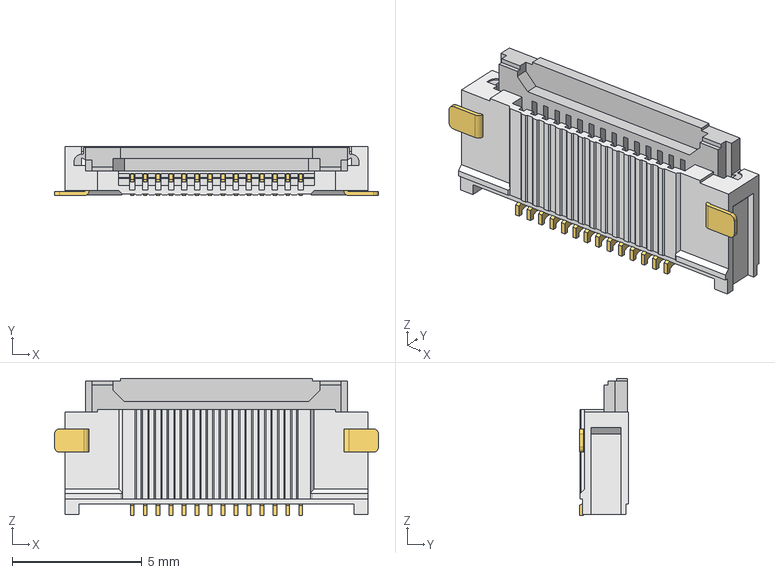
[picture p35: CAD file, 2020-08-18]
doc/14p_05mm_FFC/Molex_505278-1433/FFC_14p-Molex_5052781433-colorized.stp
12.5 x 1.90 x 5.30 mm
