mjohansson/SolderingStation/doc/audio/3.5mm_jack/CUI_DEVICES_SJ-3571N/CUI_DEVICES_SJ-3571N.step

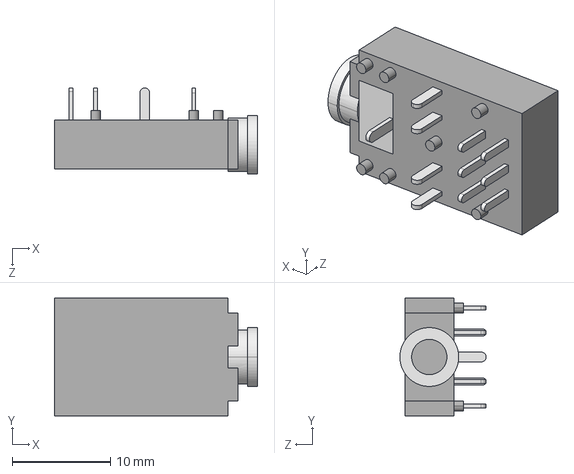
[picture p36: CAD file, 2020-08-18]
doc/audio/3.5mm_jack/CUI_DEVICES_SJ-3571N/CUI_DEVICES_SJ-3571N.step
20.7 x 12.0 x 8.80 mm
