mjohansson/SolderingStation/doc/audio/3.5mm_jack/Kycon_STX-3501-3N_FF(dbg_connector)/3d_STX-3501-3N_rA3.STEP

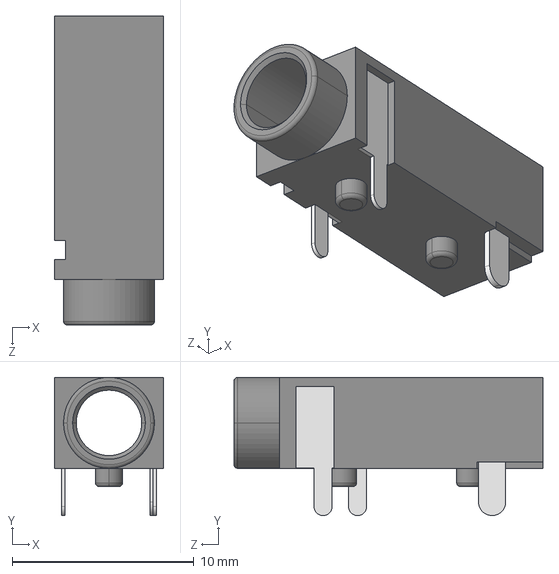
[picture p37: CAD file, 2021-01-13]
doc/audio/3.5mm_jack/Kycon_STX-3501-3N_FF(dbg_connector)/3d_STX-3501-3N_rA3.STEP
6.00 x 7.60 x 17.0 mm
