mjohansson/SolderingStation/doc/audio/speakers/CES-703116-28PM/CUI_DEVICES_CES-703116-28PM/CUI_DEVICES_CES-703116-28PM.step

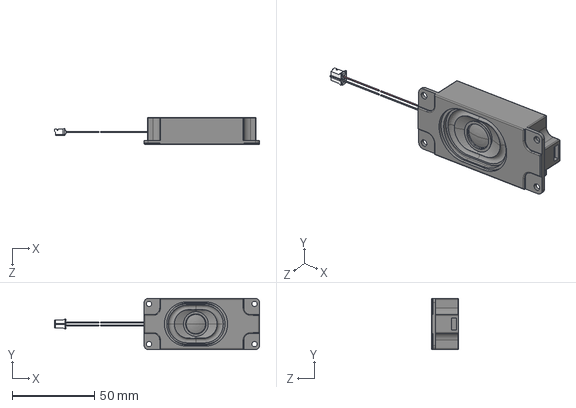
[picture p38: CAD file, 2020-09-03]
doc/audio/speakers/CES-703116-28PM/CUI_DEVICES_CES-703116-28PM/CUI_DEVICES_CES-703116-28PM.step
124.3 x 31.0 x 16.5 mm
