mjohansson/SolderingStation/doc/audio/speakers/CES-703316-28PM/CUI_DEVICES_CES-703316-28PM/CUI_DEVICES_CES-703316-28PM.step

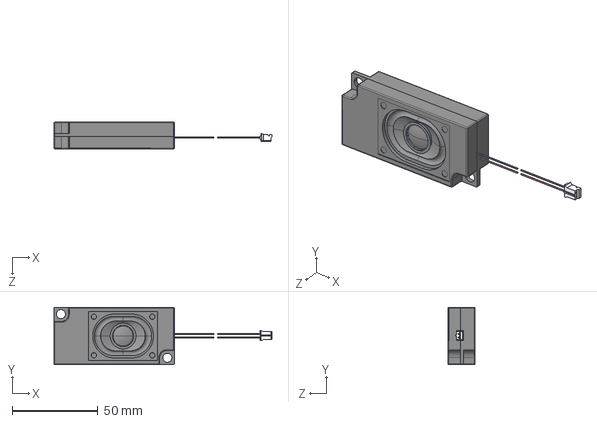
[picture p39: CAD file, 2020-09-03]
doc/audio/speakers/CES-703316-28PM/CUI_DEVICES_CES-703316-28PM/CUI_DEVICES_CES-703316-28PM.step
126.8 x 33.4 x 15.6 mm
