mjohansson/SolderingStation/doc/audio/speakers/CES-803118-28PM/CUI_DEVICES_CES-803118-28PM/CUI_DEVICES_CES-803118-28PM.step

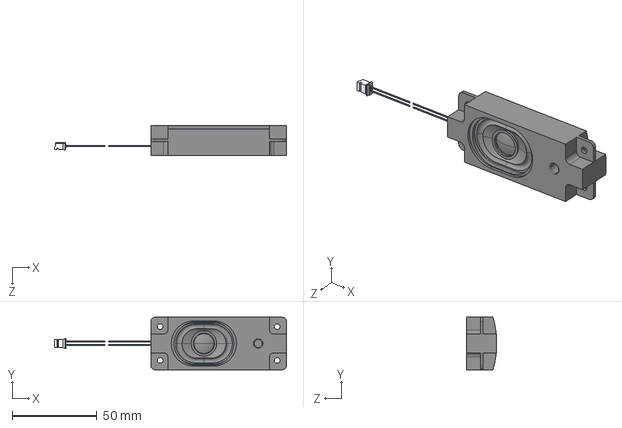
[picture p40: CAD file, 2020-09-03]
doc/audio/speakers/CES-803118-28PM/CUI_DEVICES_CES-803118-28PM/CUI_DEVICES_CES-803118-28PM.step
136.8 x 31.0 x 18.0 mm
