mjohansson/SolderingStation/doc/Dsub9-conn/K22X-E9P-N.step

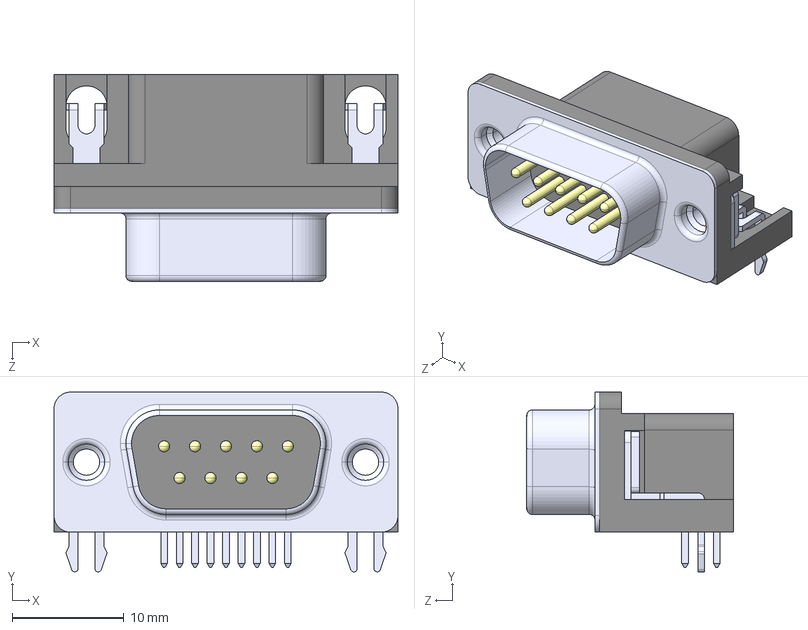
[picture p41: CAD file, 2020-08-31]
doc/Dsub9-conn/K22X-E9P-N.step
30.8 x 16.1 x 18.5 mm
