mjohansson/SolderingStation/doc/fast-connect_cable_spade_connectors/WR_FAST_6.3mm_blade/2-pin_angled_5.08/WR-FAST_2ra_638263122002_rev1.stp

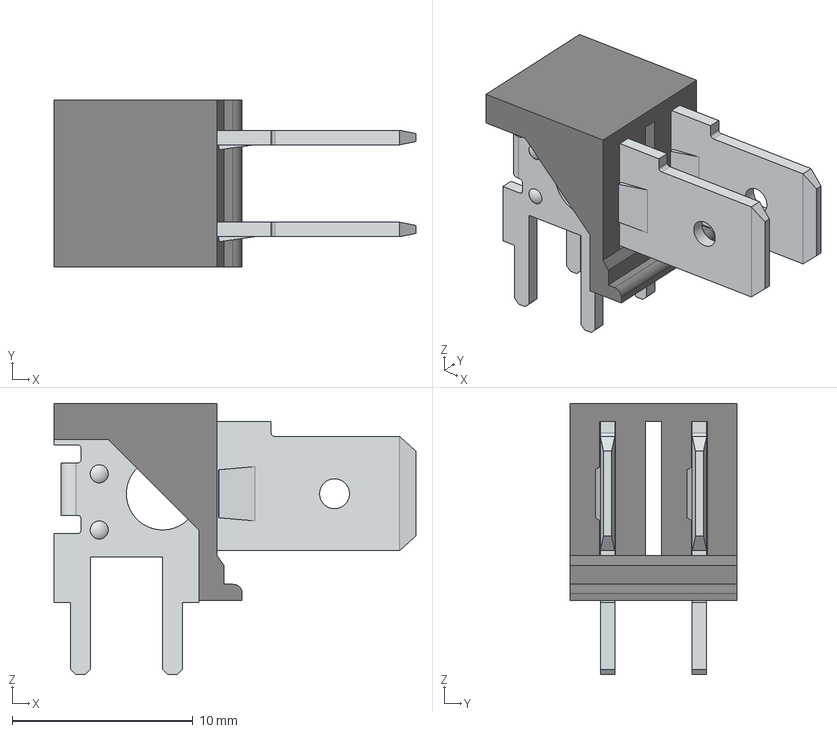
[picture p42: CAD file, 2020-11-03]
doc/fast-connect_cable_spade_connectors/WR_FAST_6.3mm_blade/2-pin_angled_5.08/WR-FAST_2ra_638263122002_rev1.stp
20.0 x 9.20 x 15.0 mm
