mjohansson/SolderingStation/doc/fast-connect_cable_spade_connectors/WR_FAST_6.3mm_blade/2-pin_vertical_5.08/WR-FAST_2v_638263222002_rev1.stp

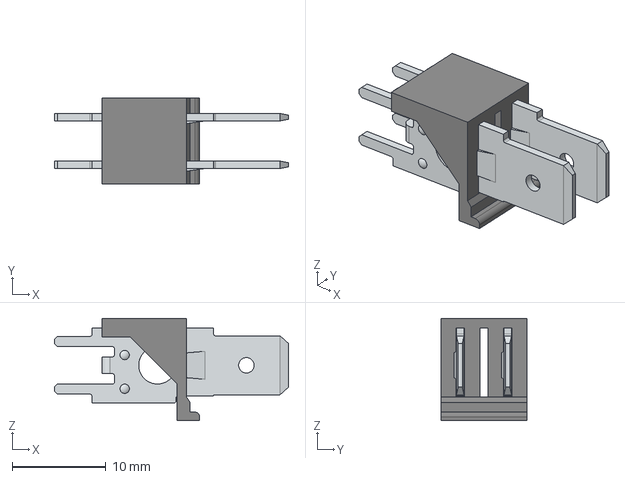
[picture p43: CAD file, 2020-11-03]
doc/fast-connect_cable_spade_connectors/WR_FAST_6.3mm_blade/2-pin_vertical_5.08/WR-FAST_2v_638263222002_rev1.stp
25.0 x 9.20 x 10.9 mm
