mjohansson/SolderingStation/doc/fast-connect_cable_spade_connectors/WR_FAST_6.3mm_blade/3-pin_angled_5.08/WR-FAST_3ra_638263122003_rev1.stp

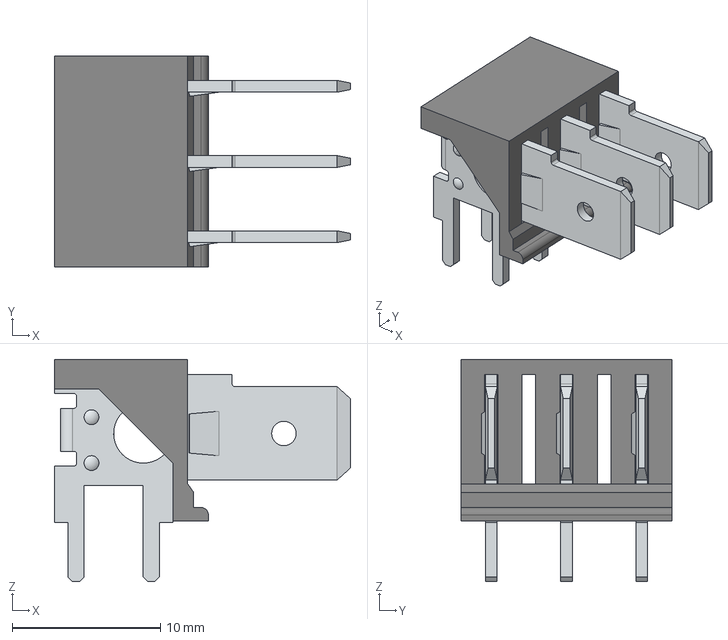
[picture p44: CAD file, 2020-11-03]
doc/fast-connect_cable_spade_connectors/WR_FAST_6.3mm_blade/3-pin_angled_5.08/WR-FAST_3ra_638263122003_rev1.stp
20.0 x 14.3 x 15.0 mm
