mjohansson/SolderingStation/doc/fast-connect_cable_spade_connectors/WR_FAST_6.3mm_blade/3-pin_vertical_5.08/WR-FAST_3v_638263222003_rev1.stp

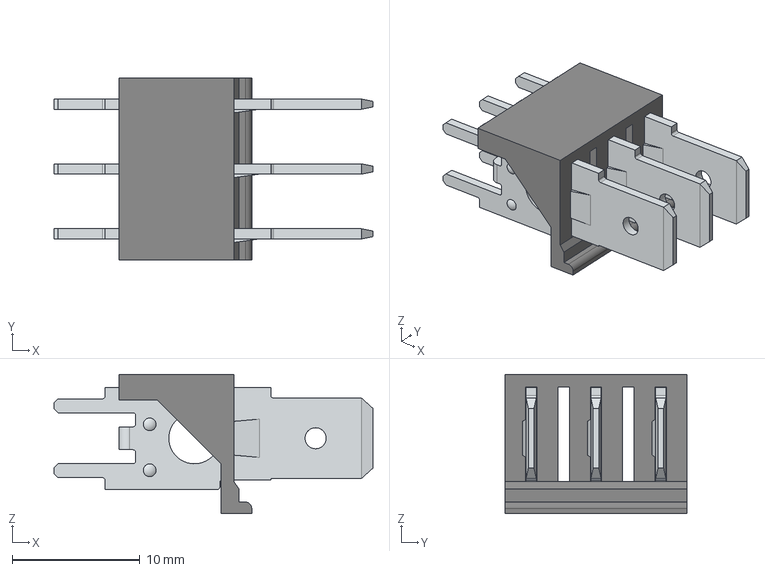
[picture p45: CAD file, 2020-11-03]
doc/fast-connect_cable_spade_connectors/WR_FAST_6.3mm_blade/3-pin_vertical_5.08/WR-FAST_3v_638263222003_rev1.stp
25.0 x 14.3 x 10.9 mm
