mjohansson/SolderingStation/doc/fast-connect_cable_spade_connectors/WR_FAST_6.3mm_blade/4-pin_angled_5.08/WR-FAST_4ra_638263122004_rev1.stp

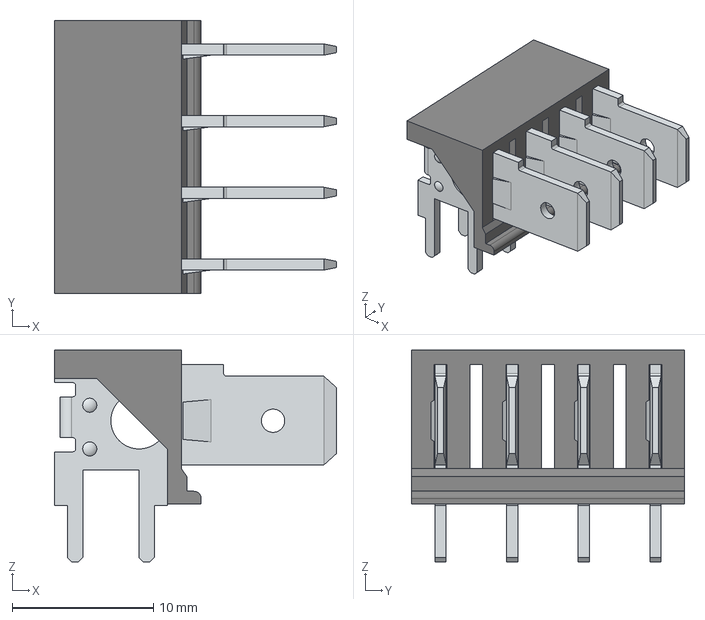
[picture p46: CAD file, 2020-11-03]
doc/fast-connect_cable_spade_connectors/WR_FAST_6.3mm_blade/4-pin_angled_5.08/WR-FAST_4ra_638263122004_rev1.stp
20.0 x 19.4 x 15.0 mm
