mjohansson/SolderingStation/doc/fast-connect_cable_spade_connectors/WR_FAST_6.3mm_blade/4-pin_vertical_5.08/WR-FAST_4v_638263222004_rev1.stp

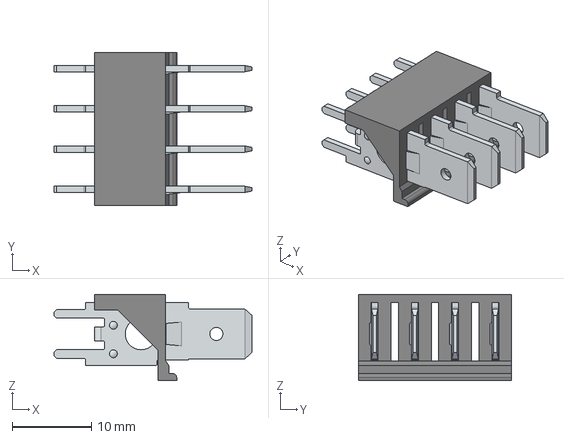
[picture p47: CAD file, 2020-11-03]
doc/fast-connect_cable_spade_connectors/WR_FAST_6.3mm_blade/4-pin_vertical_5.08/WR-FAST_4v_638263222004_rev1.stp
25.0 x 19.4 x 10.9 mm
