mjohansson/SolderingStation/doc/fast-connect_cable_spade_connectors/WR_FAST_6.3mm_blade/6-pin_right-angled_5.08mm/WR-FAST_6ra_638263122006_rev1.stp

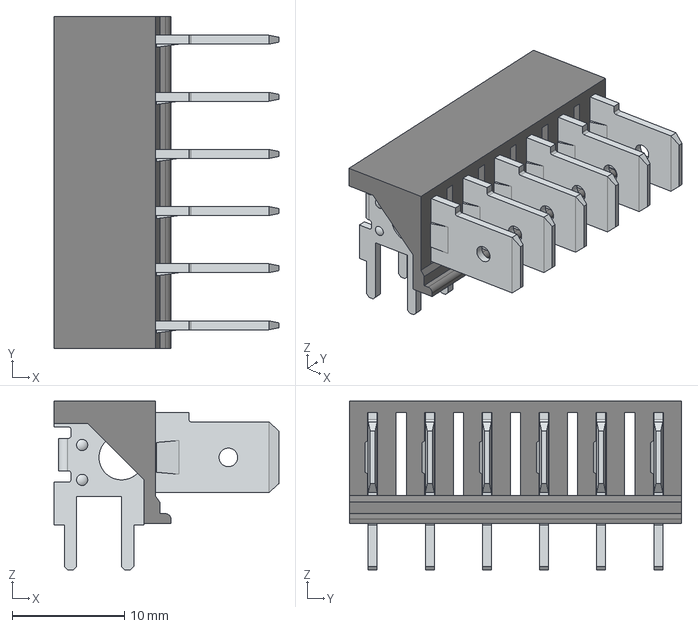
[picture p48: CAD file, 2020-11-03]
doc/fast-connect_cable_spade_connectors/WR_FAST_6.3mm_blade/6-pin_right-angled_5.08mm/WR-FAST_6ra_638263122006_rev1.stp
20.0 x 29.5 x 15.0 mm
