mjohansson/SolderingStation/doc/fast-connect_cable_spade_connectors/WR_FAST_6.3mm_blade/6-pin_vertical_5.08mm/WR-FAST_6v_638263222006_rev1.stp

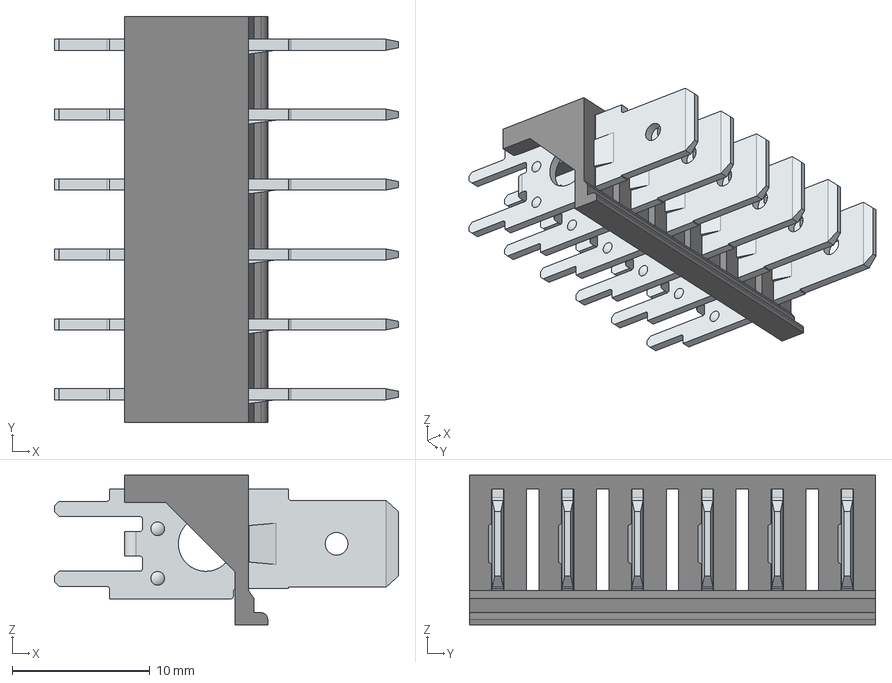
[picture p49: CAD file, 2020-11-03]
doc/fast-connect_cable_spade_connectors/WR_FAST_6.3mm_blade/6-pin_vertical_5.08mm/WR-FAST_6v_638263222006_rev1.stp
25.0 x 29.5 x 10.9 mm
