mjohansson/SolderingStation/doc/fuseholder/Schurter_0031_8201.step

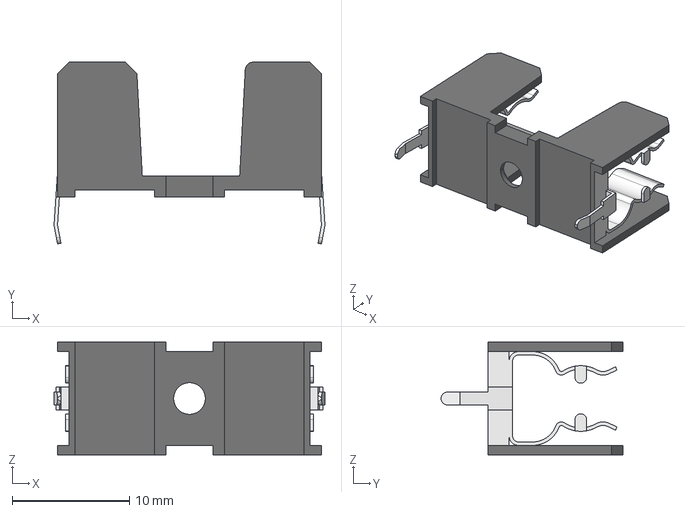
[picture p50: CAD file, 2020-10-30]
doc/fuseholder/Schurter_0031_8201.step
23.1 x 15.5 x 9.60 mm
