mjohansson/SolderingStation/doc/microUSB/3d_MicroUSB-FCI-10104111.STEP

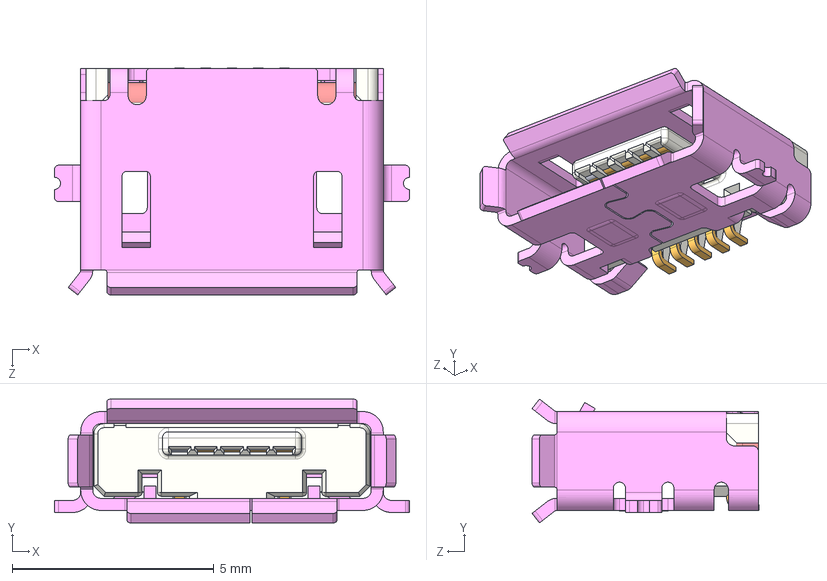
[picture p51: CAD file, 2020-04-30]
doc/microUSB/3d_MicroUSB-FCI-10104111.STEP
8.80 x 3.07 x 5.63 mm
