mjohansson/SolderingStation/doc/RTC-modules/CR2032_battery_holder/BATT_CR2032.step

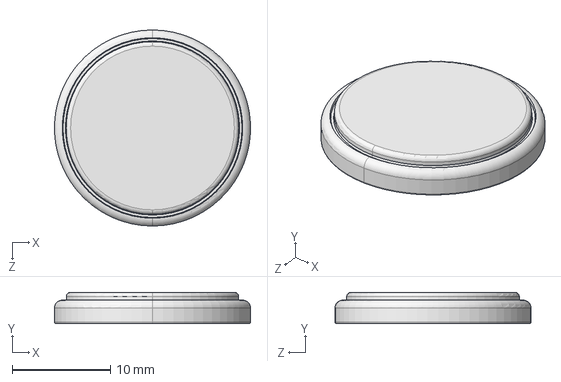
[picture p52: CAD file, 2021-01-10]
doc/RTC-modules/CR2032_battery_holder/BATT_CR2032.step
20.0 x 3.20 x 20.0 mm
