mjohansson/SolderingStation/doc/usb_conn/USB_A-TE_292303-1/c-1-292303-1-e-3d.stp

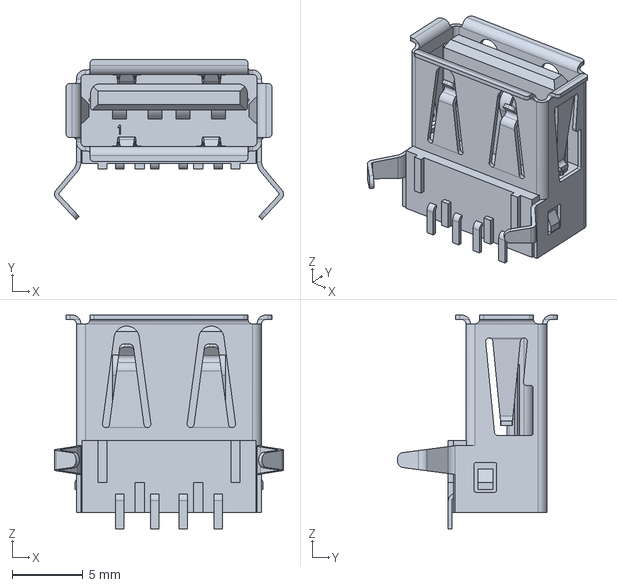
[picture p54: CAD file, 2020-08-18]
doc/usb_conn/USB_A-TE_292303-1/c-1-292303-1-e-3d.stp
16.2 x 11.4 x 15.2 mm
