mjohansson/SolderingStation/doc/usb_conn/USB_B-TE_1734346-1/c-1734346-1-c-3d.stp

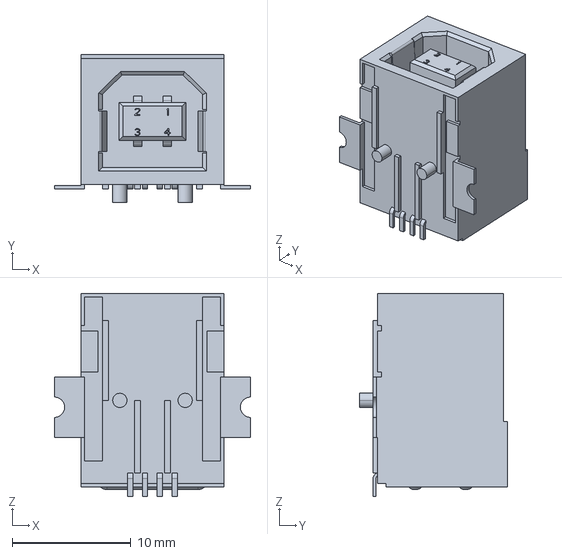
[picture p55: CAD file, 2020-08-18]
doc/usb_conn/USB_B-TE_1734346-1/c-1734346-1-c-3d.stp
16.5 x 12.4 x 17.1 mm
