mjohansson/SolderingStation/hw/ss_backpanel-mirrored/3d_exports/4mmBanana_panel_with_QC.step

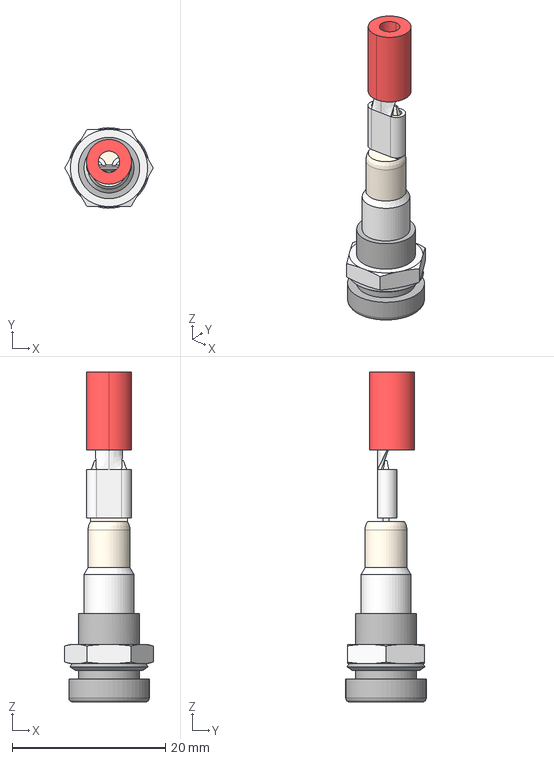
[picture p57: CAD file, 2022-02-02]
hw/ss_backpanel-mirrored/3d_exports/4mmBanana_panel_with_QC.step
11.5 x 10.5 x 43.0 mm
Female Quick-Connect-4_8mm-Red002 x 2
J101_LB_I4R_A-black_5F7DF82B x 2
