mjohansson/SolderingStation/hw/ss_backpanel-mirrored_Al/3d_export/ss_backpanel_with_connectors.FCStd

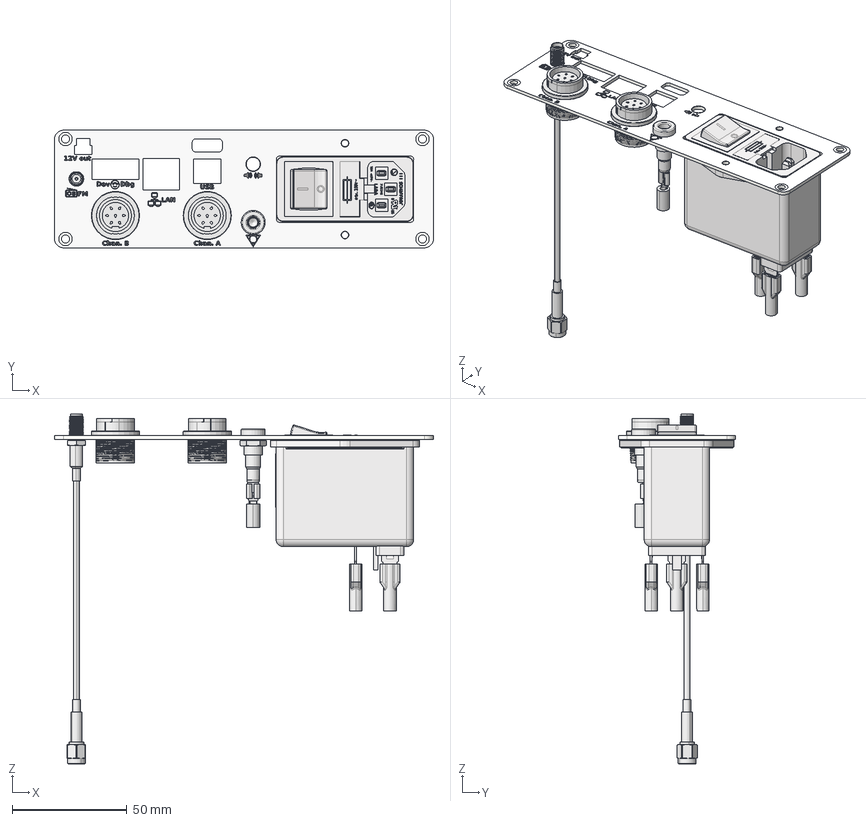
[picture p58: CAD file, 2022-02-02]
hw/ss_backpanel-mirrored_Al/3d_export/ss_backpanel_with_connectors.FCStd
165.1 x 51.2 x 152.4 mm
Pcb_444e
topZones_444e
botSilks_66e5
topSilks_6b31
CompletePartSimpleCopy x 2
CompletePartSimpleCopy001 x 2
CompletePartSimpleCopy002 x 2
CompletePartSimpleCopy003 x 2
CompletePartSimpleCopy004 x 2
CompletePartSimpleCopy005 x 2
QuickConn-6_35mm-Insul-Red_ACin(N)
QuickConn-6_35mm-Insul-Red_ACin(N)001
QuickConn-6_35mm-Insul-Red_ACin(L)
QuickConn-6_35mm-Insul-Red_ACin(L)001
M104_Part3_5F460FD2
QuickConn-6_35mm-Insul-Red_ACin(PE)
QuickConn-6_35mm-Insul-Red_ACin(PE)001
Female Quick-Connect-4_8mm-Red002
J101_LB_I4R_A-black_5F7DF82B
J101_LB_I4R_A-black_5F7DF82B001
