mjohansson/SolderingStation/hw/ss_fp_87dc3_bridgeboard/3d_export/ss_fp_87dc3_bridgeboard-SingleBrd.step

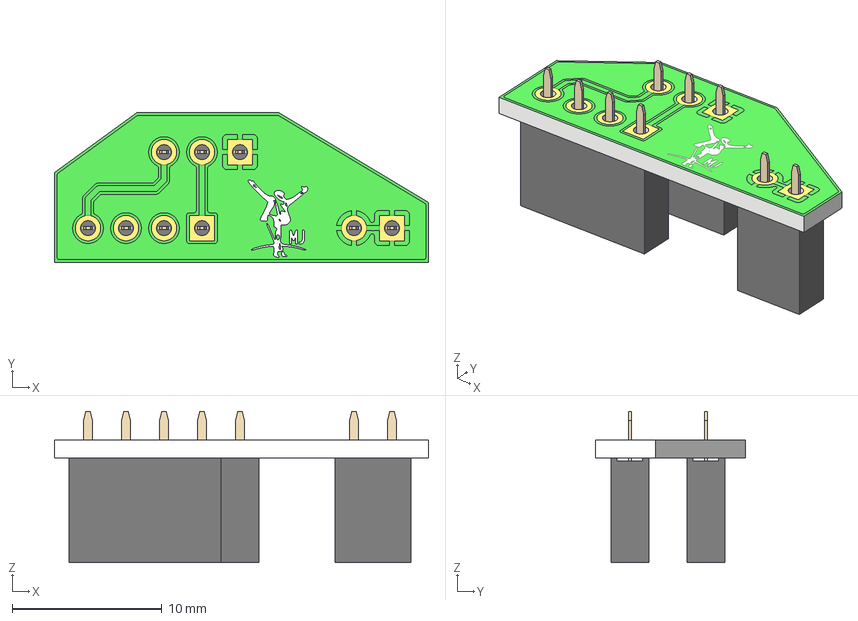
[picture p59: CAD file, 2022-02-02]
hw/ss_fp_87dc3_bridgeboard/3d_export/ss_fp_87dc3_bridgeboard-SingleBrd.step
25.0 x 10.0 x 10.1 mm
Pcb_559e x 2
topPads_559e x 2
topTracks_559e x 2
topZones_559e x 2
botPads_559e x 2
botZones_559e x 2
botSilks_7583 x 2
topSilks_7857 x 2
J104_PinSocket_1x02_P254mm_Vertical_00005fc5ec21 x 2
J105_PinSocket_1x04_P254mm_Vertical_00005fc5ec39 x 2
J106_PinSocket_1x03_P254mm_Vertical_00005fc5ec50 x 2
