mjohansson/SolderingStation/hw/ss_frontpanel_inner_plate/3d_exports/ss_frontpanel_inner_plate-3d.FCStd

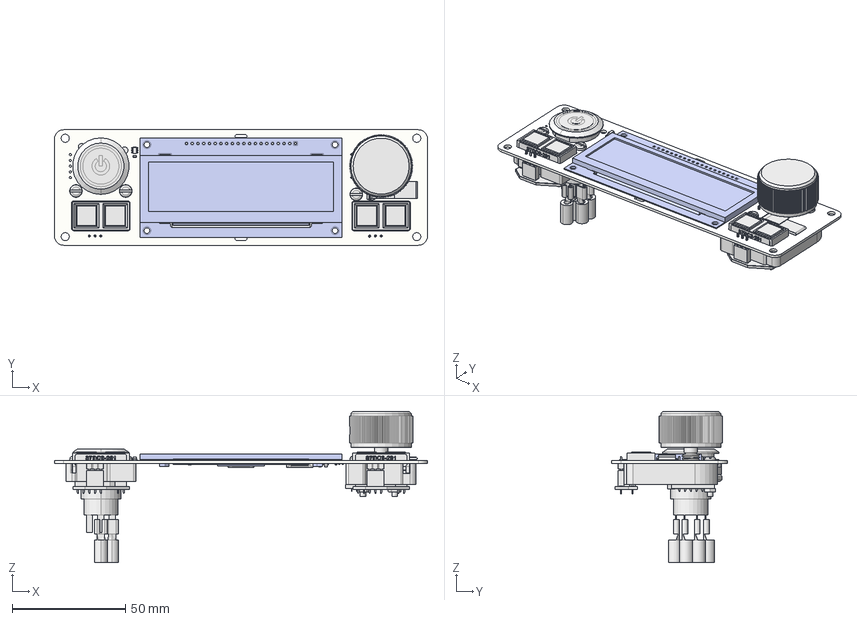
[picture p60: CAD file, 2022-02-02]
hw/ss_frontpanel_inner_plate/3d_exports/ss_frontpanel_inner_plate-3d.FCStd
165.0 x 51.1 x 67.0 mm
Pcb_c89d
NHD-3.12-25664UCY2
NHD-3.12-25664UCY003
U2_SOT_23_6_00005f25d3ea x 6
6871xx182122_Pad
6871xx182122_Pad001
6871xx182122_Pin
6871xx182122_Pin001
6871xx182122_Pin002
6871xx182122_Pin003
6871xx182122_Pin004
6871xx182122_Pin005
6871xx182122_Pin006
6871xx182122_Pin007
6871xx182122_Pin008
6871xx182122_Pin009
6871xx182122_Pin010
6871xx182122_Pin011
6871xx182122_Pin012
6871xx182122_Pin013
687114182122_Actuator
FFC1_FFC_50mm_folded_x2_00005f281811
C9_C_0603_1608Metric_00005f2c710a x 13
CompoundRightBtnHolder
CompoundRightBtnHolder001
CompoundRightBtnHolder002
CompoundRightBtnHolder003
CompoundRightBtnHolder004
CompoundRightBtnHolder005
CompoundRightBtnHolder006
CompoundRightBtnHolder007
CompoundRightBtnHolder008
CompoundRightBtnHolder009
CompoundRightBtnHolder010
CompoundRightBtnHolder011
CompoundRightBtnHolder012
CompoundRightBtnHolder013
CompoundRightBtnHolder014
CompoundRightBtnHolder015
CompoundRightBtnHolder016
CompoundRightBtnHolder017
CompoundRightBtnHolder018
CompoundRightBtnHolder019
CompoundRightBtnHolder020
CompoundRightBtnHolder021
CompoundRightBtnHolder022
CompoundRightBtnHolder023
CompoundRightBtnHolder024
CompoundRightBtnHolder025
CompoundRightBtnHolder026
CompoundRightBtnHolder027
CompoundRightBtnHolder028
CompoundRightBtnHolder029
CompoundRightBtnHolder030
CompoundRightBtnHolder031
CompoundRightBtnHolder032
CompoundRightBtnHolder033
CompoundRightBtnHolder034
CompoundRightBtnHolder035
CompoundRightBtnHolder036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
