mjohansson/SolderingStation/hw/ss_frontpanel_inner_plate/display_carrier-testprint.STL

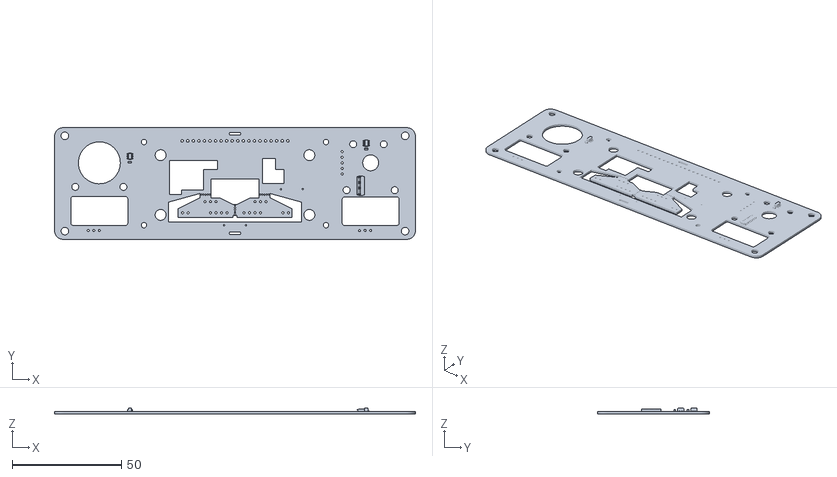
[picture p61: CAD file, 2020-08-18]
hw/ss_frontpanel_inner_plate/display_carrier-testprint.STL
165.0 x 51.1 x 2.75
