mjohansson/SolderingStation/hw/ss_frontpanel_outer_plate/3d_exports/ss_frontpanel_outer_plate-3d.FCStd

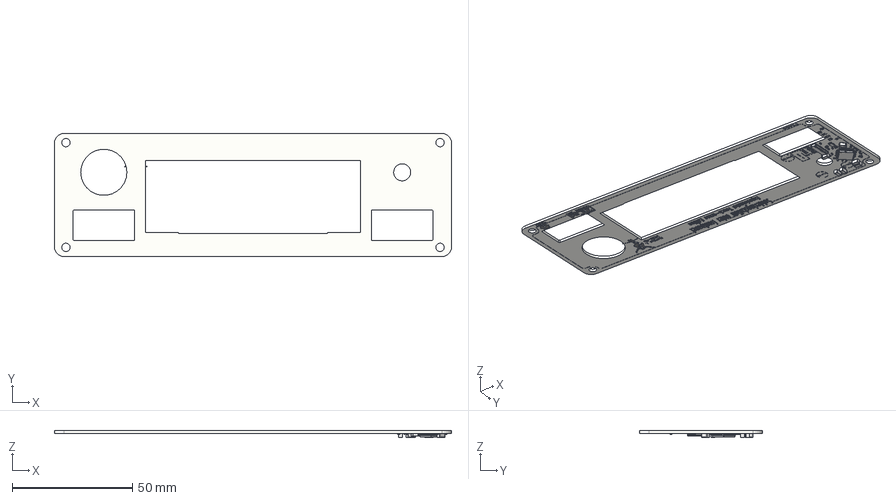
[picture p62: CAD file, 2022-02-02]
hw/ss_frontpanel_outer_plate/3d_exports/ss_frontpanel_outer_plate-3d.FCStd
165.0 x 51.1 x 2.80 mm
Pcb_ea1d
botSilks_9593
C1_C_0402_1005Metric_00005f291953 x 8
C6_C_1206_3216Metric_00005f2919ae x 6
R1_R_0402_1005Metric_00005f291bf3 x 15
R8_R_0603_1608Metric_00005f291c5c x 5
R12_R_1206_3216Metric_00005f291c98
6871xx182122_Pad
6871xx182122_Pad001
6871xx182122_Pin
6871xx182122_Pin001
6871xx182122_Pin002
6871xx182122_Pin003
6871xx182122_Pin004
6871xx182122_Pin005
6871xx182122_Pin006
6871xx182122_Pin007
6871xx182122_Pin008
6871xx182122_Pin009
6871xx182122_Pin010
6871xx182122_Pin011
6871xx182122_Pin012
6871xx182122_Pin013
687114182122_Actuator
U1_LQFP_48_7x7mm_P05mm_00005f312d9e
