mjohansson/SolderingStation/hw/ss_frontpanel_outer_plate_Al/3d_export/ss_frontpanel_outer_plate_Al-3d.FCStd

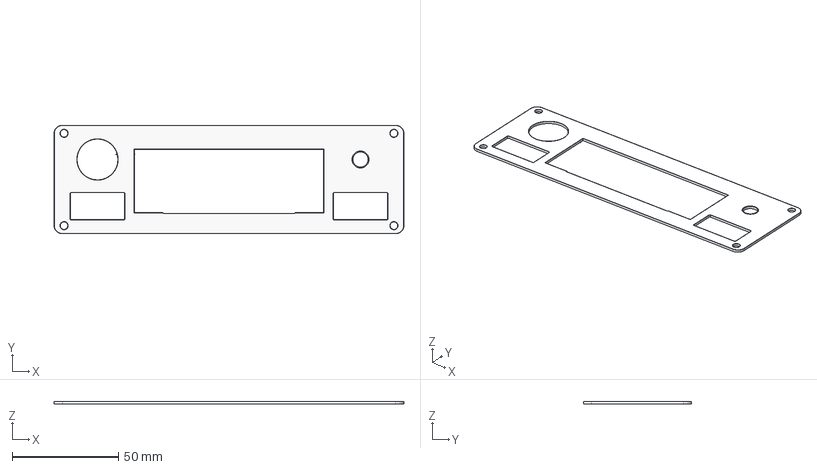
[picture p63: CAD file, 2022-01-21]
hw/ss_frontpanel_outer_plate_Al/3d_export/ss_frontpanel_outer_plate_Al-3d.FCStd
165.0 x 51.1 x 1.28 mm
Pcb_f3f7
topZones_f3f7
botSilks_c91d
