mjohansson/SolderingStation/hw/ss_frontpanel_outer_plate_Al/panel_outline.dxf

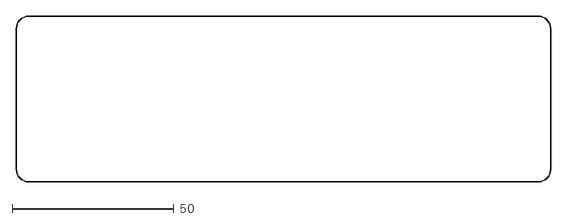
[picture p64: CAD file, 2020-08-18]
hw/ss_frontpanel_outer_plate_Al/panel_outline.dxf
165.0 x 51.1
