mjohansson/SolderingStation/mech/BottomPlate_drill-template-Centered_PSU.FCStd

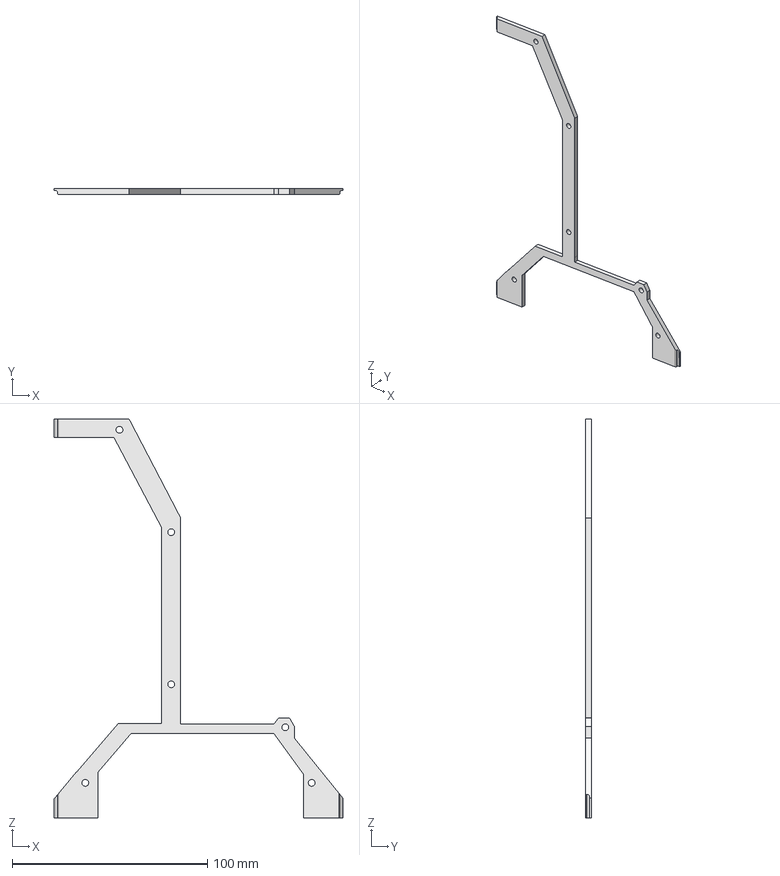
[picture p65: CAD file, 2020-10-31]
mech/BottomPlate_drill-template-Centered_PSU.FCStd
148.0 x 3.00 x 204.5 mm
