mjohansson/SolderingStation/mech/faceplate/wip.fcstd

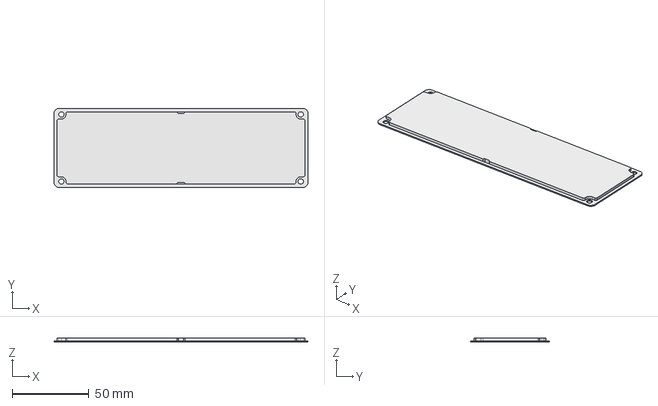
[picture p66: CAD file, 2020-04-30]
mech/faceplate/wip.fcstd
165.0 x 51.1 x 2.50 mm
