mjohansson/SolderingStation/doc/RTC-modules/CR2032_battery_holder/CoinCellHolder_CR2032.step

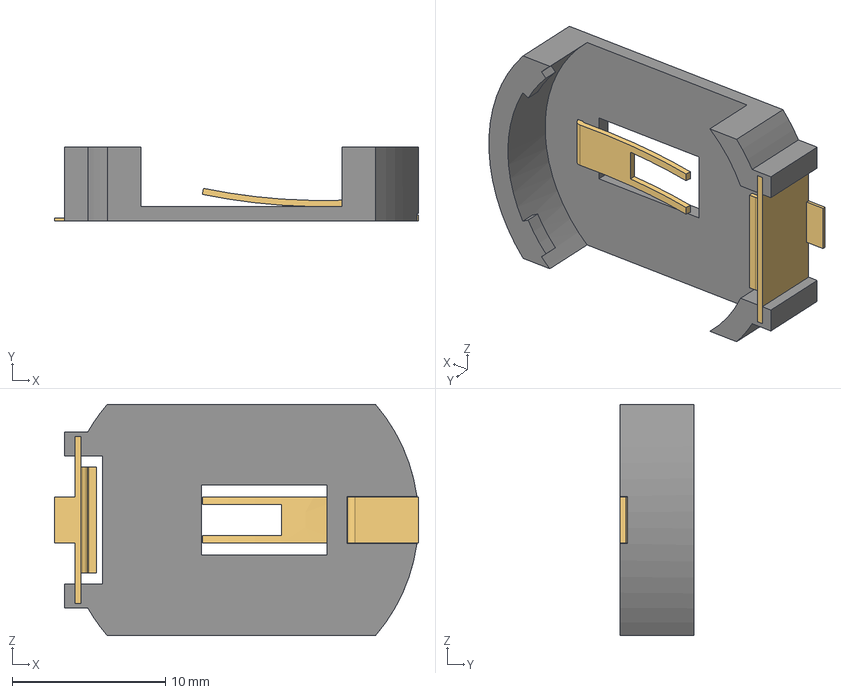
[picture p67: CAD file, 2020-11-22]
doc/RTC-modules/CR2032_battery_holder/CoinCellHolder_CR2032.step
23.8 x 4.86 x 15.1 mm
BLP2032M-Housing
BLP2032M-neg_terminal
BLP2032M-pos_terminal
