mjohansson/SolderingStation/hw/ss_backpanel-mirrored/3d_exports/3dprint_backpanel_PCB.stl

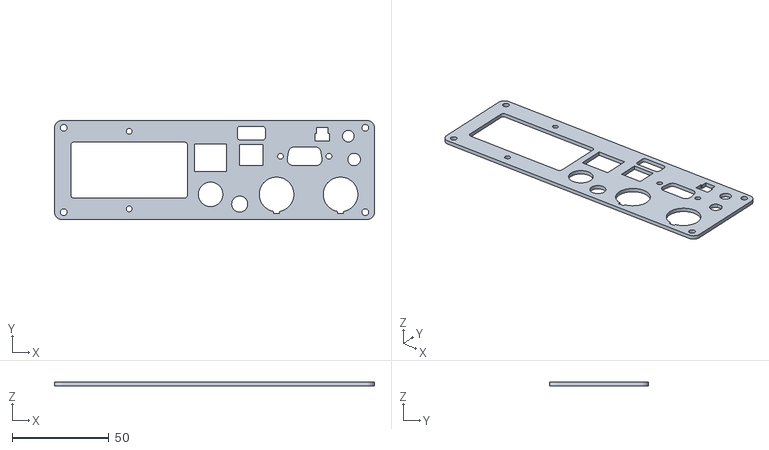
[picture p68: CAD file, 2022-01-20]
hw/ss_backpanel-mirrored/3d_exports/3dprint_backpanel_PCB.stl
165.0 x 51.1 x 2.00
