mjohansson/SolderingStation/hw/ss_backpanel-mirrored_Al/3d_export/ss_backpanel-mirrored_Al-3d.FCStd

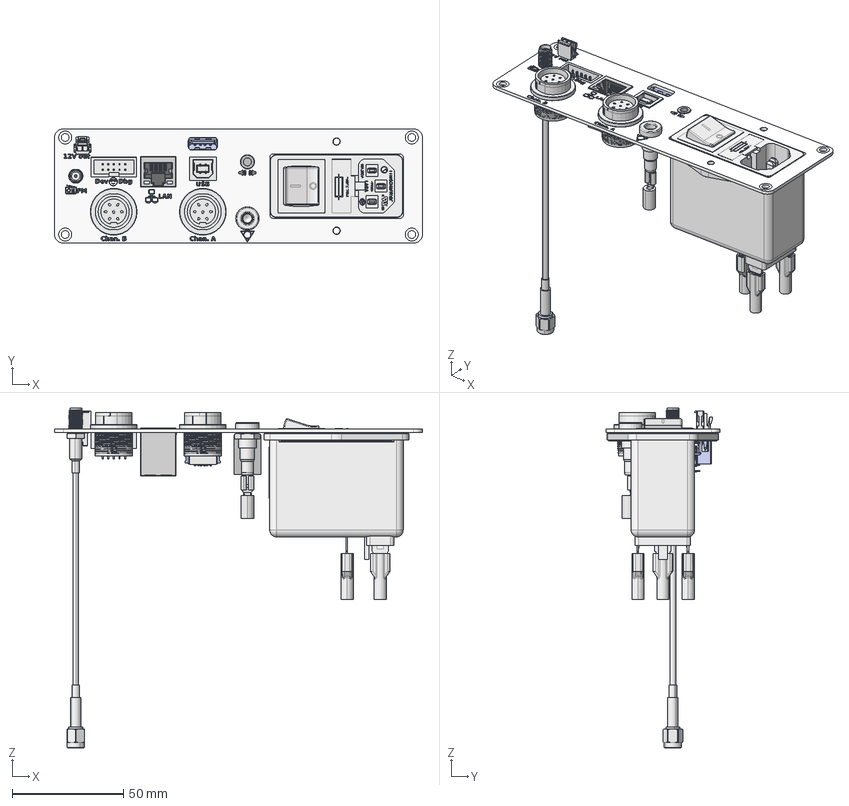
[picture p69: CAD file, 2022-02-02]
hw/ss_backpanel-mirrored_Al/3d_export/ss_backpanel-mirrored_Al-3d.FCStd
165.1 x 51.2 x 152.4 mm
Pcb_444e
topZones_444e
botSilks_66e5
topSilks_6b31
CompletePartSimpleCopy x 2
CompletePartSimpleCopy001 x 2
CompletePartSimpleCopy002 x 2
CompletePartSimpleCopy003 x 2
CompletePartSimpleCopy004 x 2
CompletePartSimpleCopy005 x 2
QuickConn-6_35mm-Insul-Red_ACin(N)
QuickConn-6_35mm-Insul-Red_ACin(N)001
QuickConn-6_35mm-Insul-Red_ACin(L)
QuickConn-6_35mm-Insul-Red_ACin(L)001
M104_Part3_5F460FD2
QuickConn-6_35mm-Insul-Red_ACin(PE)
QuickConn-6_35mm-Insul-Red_ACin(PE)001
Insulator
LED
LED001
Insulator_2
pins2
pins003
pins004
pins005
pins006
pins007
pins008
pins009
Shielding
M106_C-1734346-1_00005f4d398c
CUI_DEVICES_SJ-3571N
CUI_DEVICES_SJ-3571N001
CUI_DEVICES_SJ-3571N002
CUI_DEVICES_UJ2-AH-1-SMT
CUI_DEVICES_UJ2-AH-1-SMT001
CUI_DEVICES_UJ2-AH-1-SMT002
CUI_DEVICES_UJ2-AH-1-SMT003
CUI_DEVICES_UJ2-AH-1-SMT004
CUI_DEVICES_UJ2-AH-1-SMT005
Female Quick-Connect-4_8mm-Red002
J101_LB_I4R_A-black_5F7DF82B
J101_LB_I4R_A-black_5F7DF82B001
M111_1053071202_00005f7f0d41
M103_IDC_Header_2x05_P254mm_Horizontal_00005fb27f09
