mjohansson/SolderingStation/hw/ss_frontpanel_outer_plate/frontpanel_outer.stl

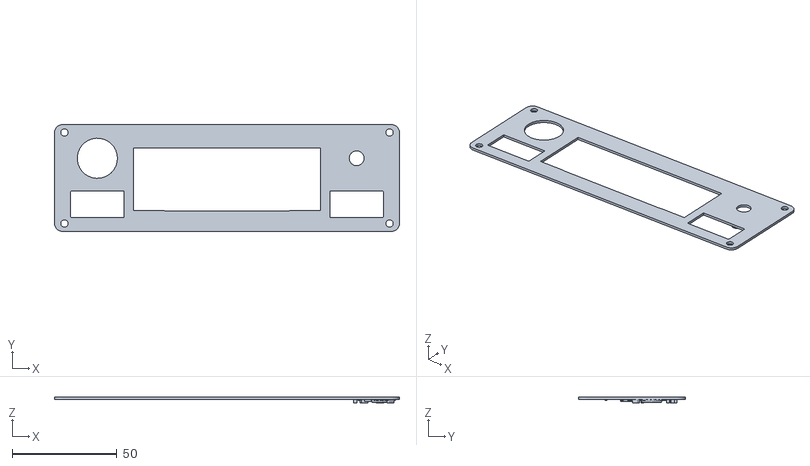
[picture p70: CAD file, 2020-08-18]
hw/ss_frontpanel_outer_plate/frontpanel_outer.stl
165.0 x 51.1 x 2.80
