mjohansson/SolderingStation/hw/ss_frontpanel_outer_plate_2nd_rotary/ss_frontpanel_outer_plate_alternate-B_Cu.dxf

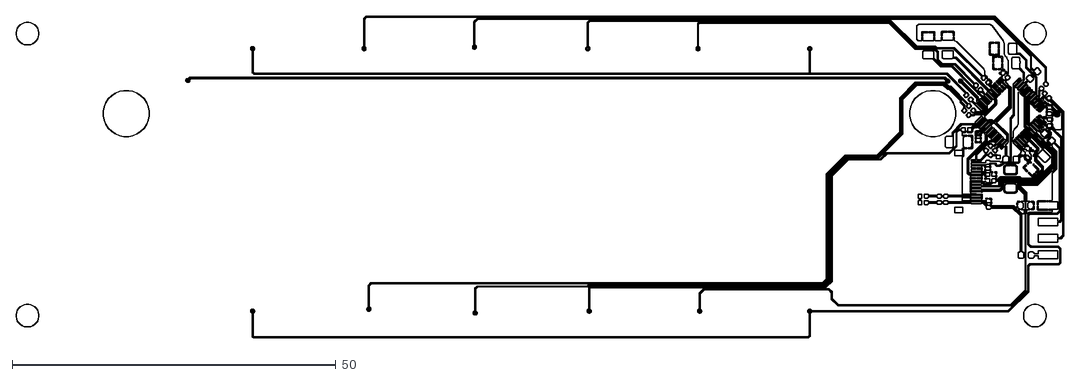
[picture p71: CAD file, 2020-08-30]
hw/ss_frontpanel_outer_plate_2nd_rotary/ss_frontpanel_outer_plate_alternate-B_Cu.dxf
161.7 x 49.6
