mjohansson/SolderingStation/mech/Bottomplate_holes_cutouts_template.FCStd

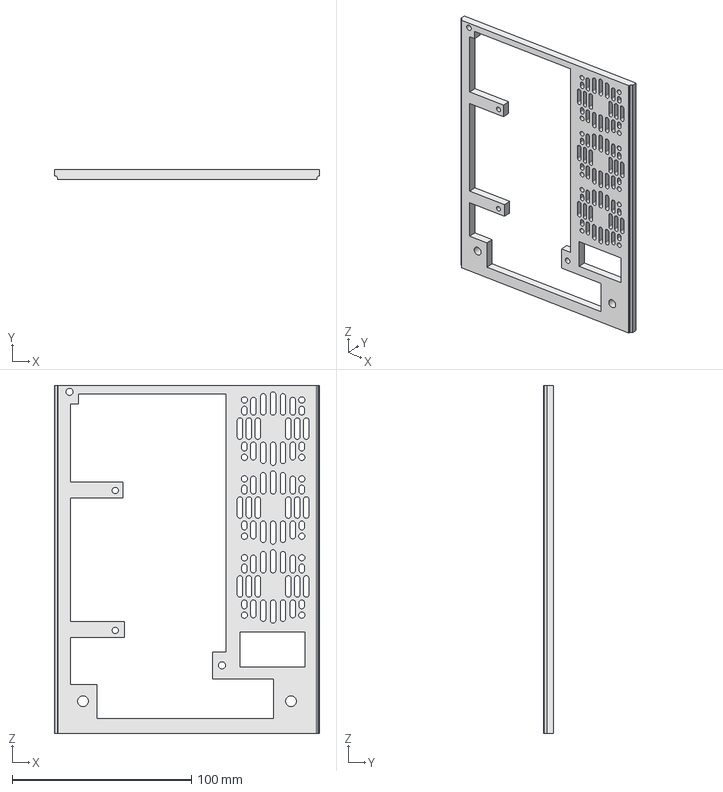
[picture p72: CAD file, 2020-10-26]
mech/Bottomplate_holes_cutouts_template.FCStd
148.0 x 5.75 x 194.0 mm
