mjohansson/SolderingStation/mech/faceplate/frontpanel.step

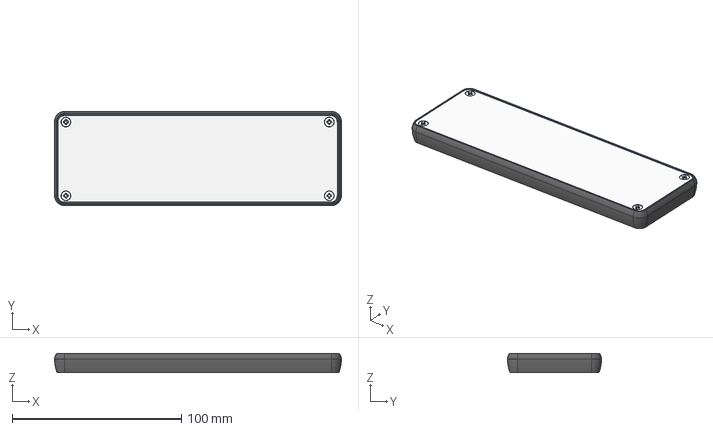
[picture p73: CAD file, 2020-04-30]
mech/faceplate/frontpanel.step
169.5 x 55.6 x 11.5 mm
