mjohansson/SolderingStation/mech/QuickConnect_Spade_terminals_lugs/Female QuickConnect-4_8mm.STEP

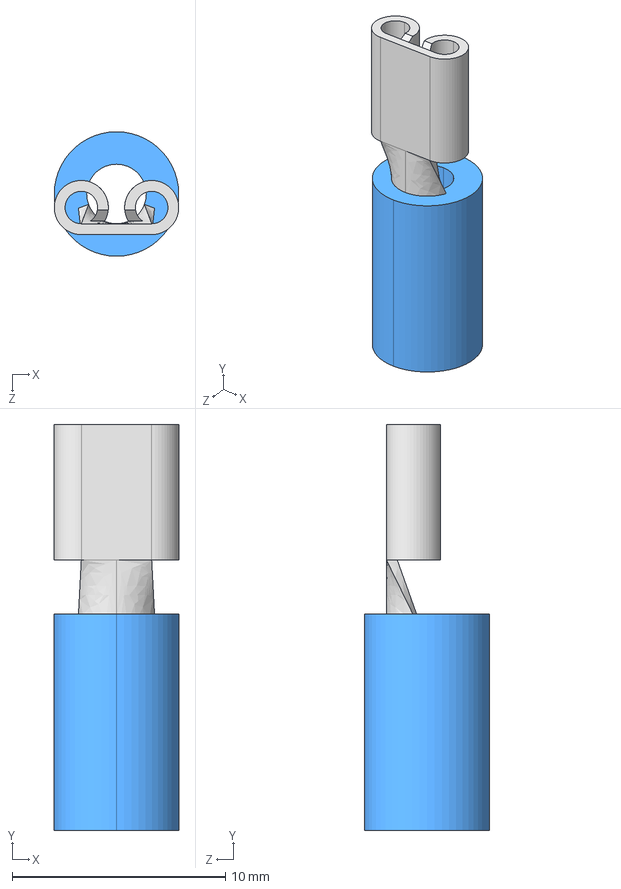
[picture p74: CAD file, 2020-10-26]
mech/QuickConnect_Spade_terminals_lugs/Female QuickConnect-4_8mm.STEP
5.84 x 19.1 x 5.84 mm
