mjohansson/SolderingStation/hw/ss_backpanel-mirrored_Al/3d_export/AC_Schaffner_inlet_with_QC_sockets.FCStd

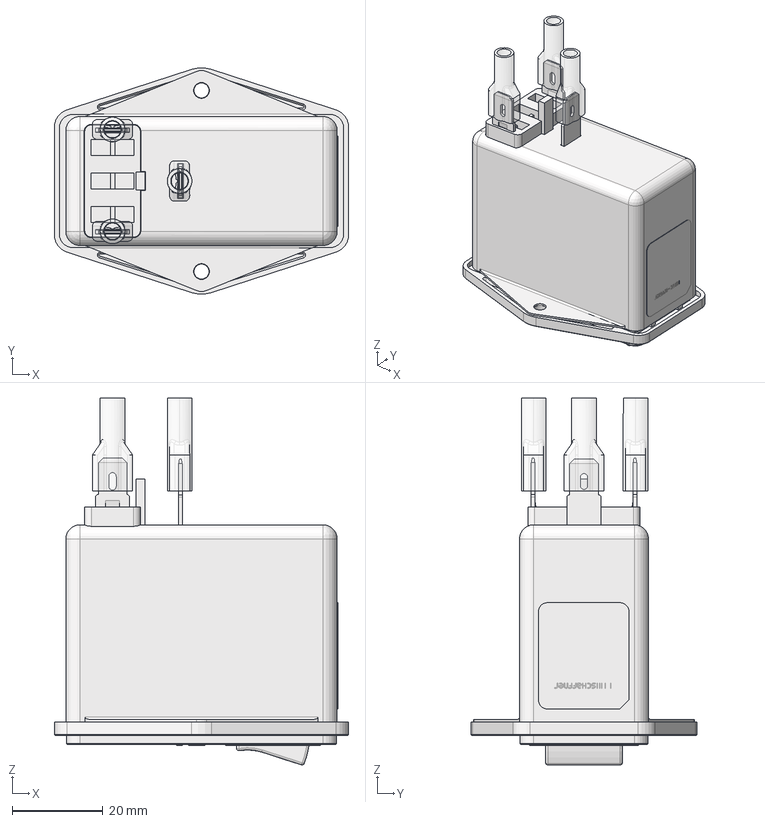
[picture p75: CAD file, 2022-02-02]
hw/ss_backpanel-mirrored_Al/3d_export/AC_Schaffner_inlet_with_QC_sockets.FCStd
65.0 x 49.9 x 81.0 mm
QuickConn-6_35mm-Insul-Red_ACin(N)
QuickConn-6_35mm-Insul-Red_ACin(L)
M104_Part3_5F460FD2
QuickConn-6_35mm-Insul-Red_ACin(PE)
