mjohansson/SolderingStation/hw/ss_frontpanel_outer_plate_2nd_rotary/SS_outer_alternate_2nd_rotary.stl

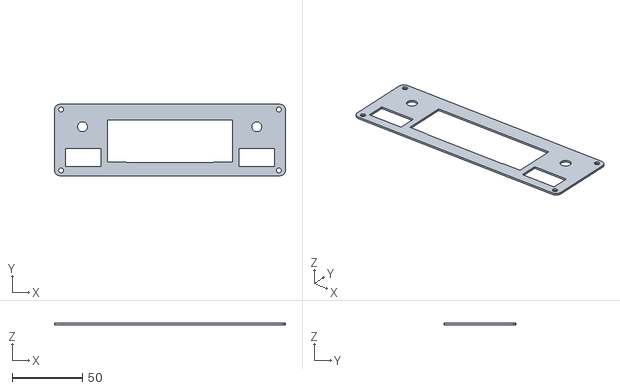
[picture p76: CAD file, 2020-08-30]
hw/ss_frontpanel_outer_plate_2nd_rotary/SS_outer_alternate_2nd_rotary.stl
165.0 x 51.1 x 1.20
