mjohansson/SolderingStation/hw/ss_fp_87dc3_bridgeboard/3d_export/Bridgeboard-SingleBrd.FCStd

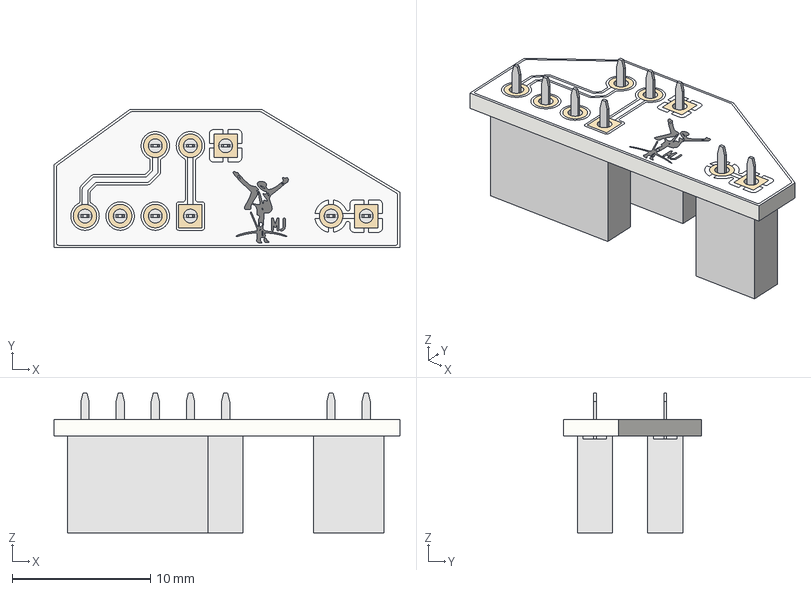
[picture p77: CAD file, 2022-02-02]
hw/ss_fp_87dc3_bridgeboard/3d_export/Bridgeboard-SingleBrd.FCStd
25.0 x 10.0 x 10.1 mm
Pcb_559e
topPads_559e
topTracks_559e
topZones_559e
botPads_559e
botZones_559e
botSilks_7583
topSilks_7857
J104_PinSocket_1x02_P254mm_Vertical_00005fc5ec21
J105_PinSocket_1x04_P254mm_Vertical_00005fc5ec39
J106_PinSocket_1x03_P254mm_Vertical_00005fc5ec50
