mjohansson/SolderingStation/hw/ss_frontpanel_inner_plate/ss_frontpanel_inner_plate.step

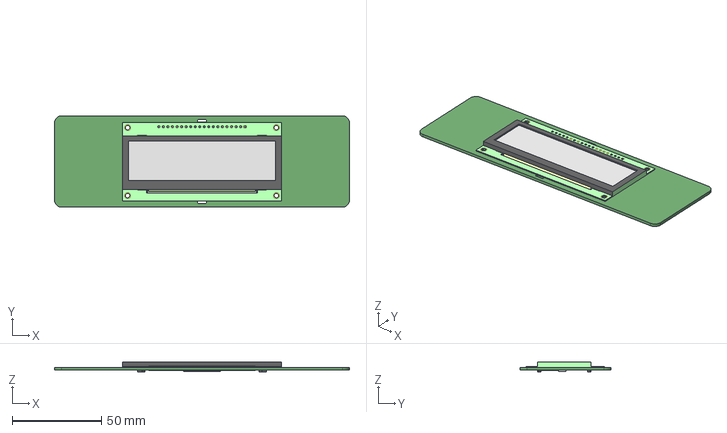
[picture p78: CAD file, 2020-08-18]
hw/ss_frontpanel_inner_plate/ss_frontpanel_inner_plate.step
165.0 x 51.1 x 5.70 mm
