mjohansson/SolderingStation/hw/ss_frontpanel_outer_plate_2nd_rotary/ss_frontpanel_outer_plate_alternate-F_Cu.dxf

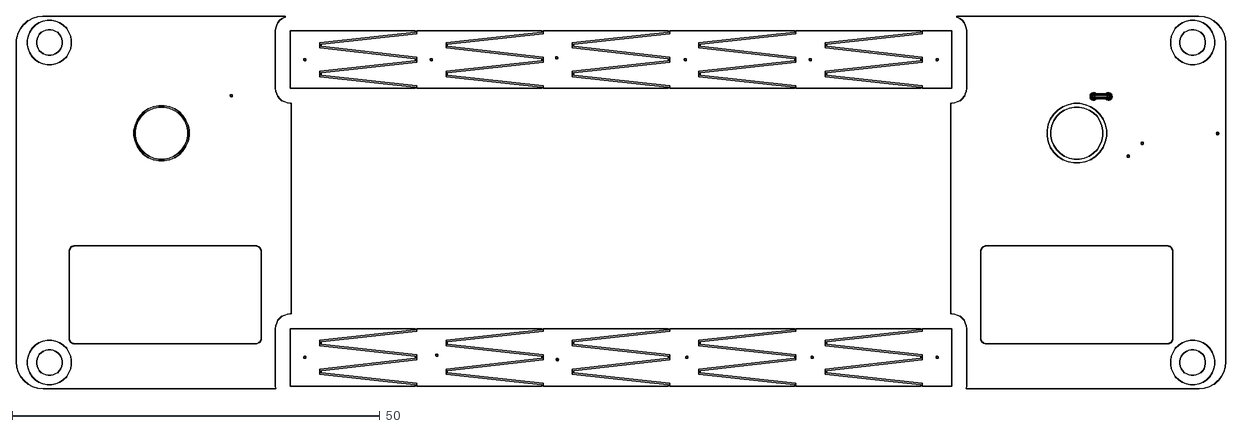
[picture p79: CAD file, 2020-08-30]
hw/ss_frontpanel_outer_plate_2nd_rotary/ss_frontpanel_outer_plate_alternate-F_Cu.dxf
164.6 x 50.7
