mjohansson/SolderingStation/mech/MJ_CES-30207-158L120-67.FCStd

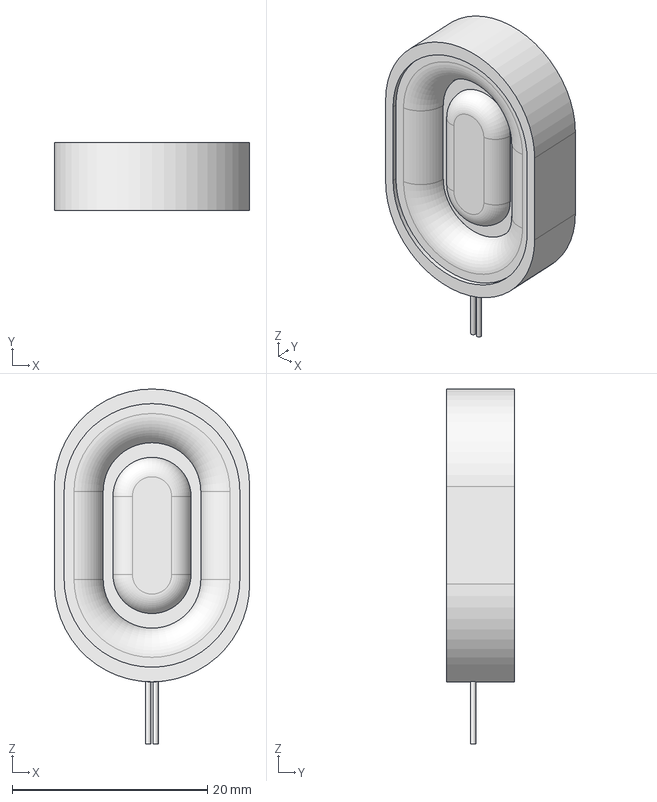
[picture p80: CAD file, 2020-09-05]
mech/MJ_CES-30207-158L120-67.FCStd
20.0 x 7.00 x 36.4 mm
