mjohansson/SolderingStation/mech/QuickConnect_Spade_terminals_lugs/Female QuickConnect-6_35mm.STEP

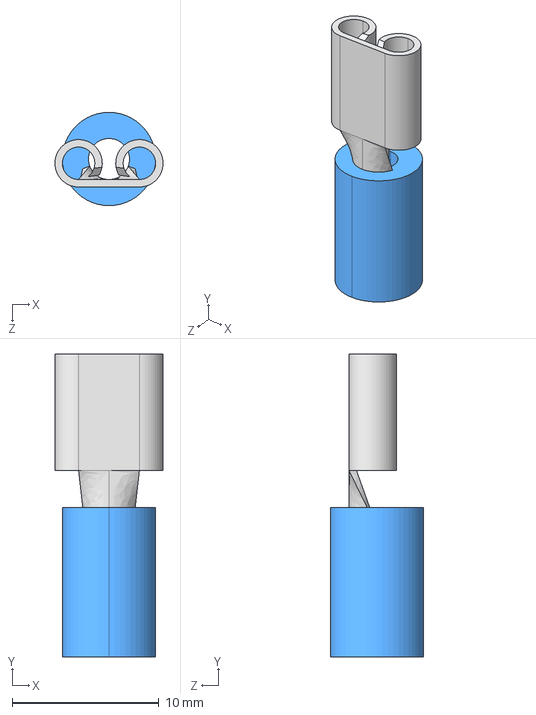
[picture p81: CAD file, 2020-10-26]
mech/QuickConnect_Spade_terminals_lugs/Female QuickConnect-6_35mm.STEP
7.37 x 20.6 x 6.35 mm
