mjohansson/SolderingStation/hw/ss_backpanel-mirrored_Al/3d_export/ss_backpanel-mirrored_Al-Edge_Cuts.dxf

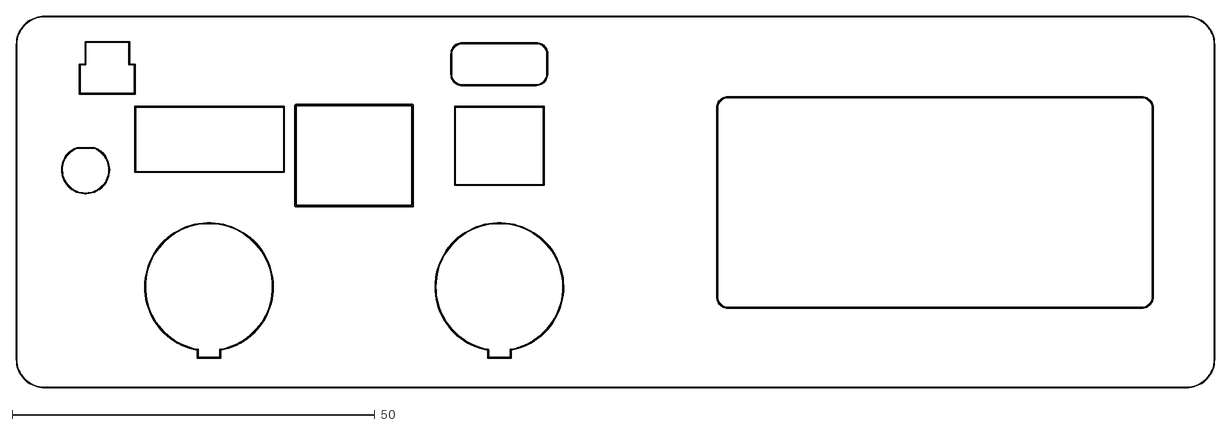
[picture p82: CAD file, 2022-01-21]
hw/ss_backpanel-mirrored_Al/3d_export/ss_backpanel-mirrored_Al-Edge_Cuts.dxf
165.1 x 51.2
