mjohansson/SolderingStation/mech/MJ_CES-503528-28PM-67.FCStd

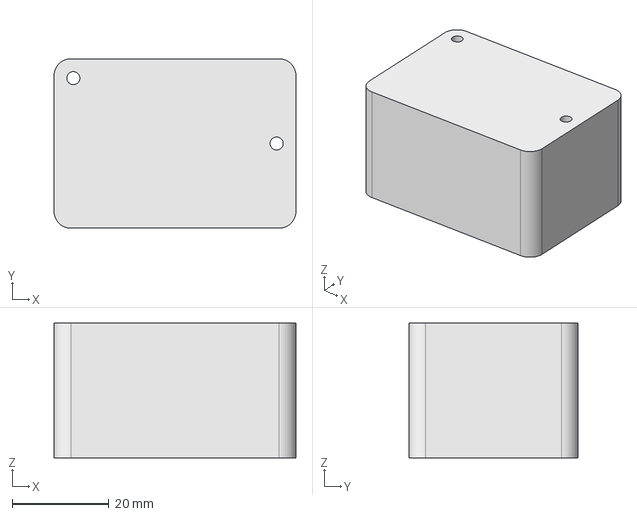
[picture p83: CAD file, 2020-09-03]
mech/MJ_CES-503528-28PM-67.FCStd
50.0 x 35.0 x 27.8 mm
