mjohansson/SolderingStation/mech/3d_holder_left_v3.stl

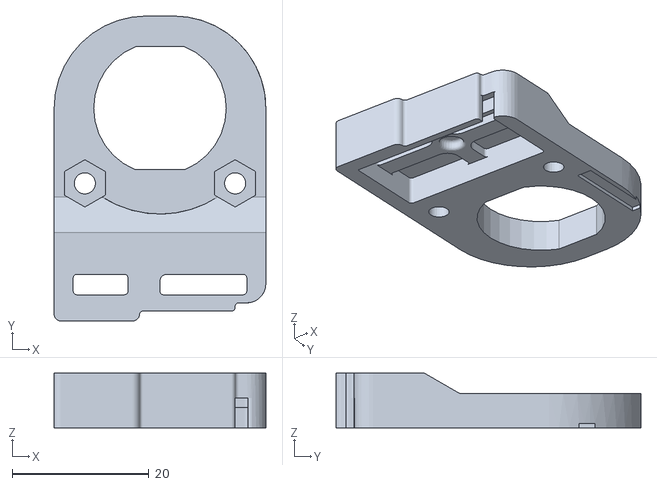
[picture p84: CAD file, 2020-08-30]
mech/3d_holder_left_v3.stl
31.0 x 44.6 x 8.00
