mjohansson/SolderingStation/mech/Roatary_knob_Al_28mm_knurled-Mentor_5555_6612.FCStd

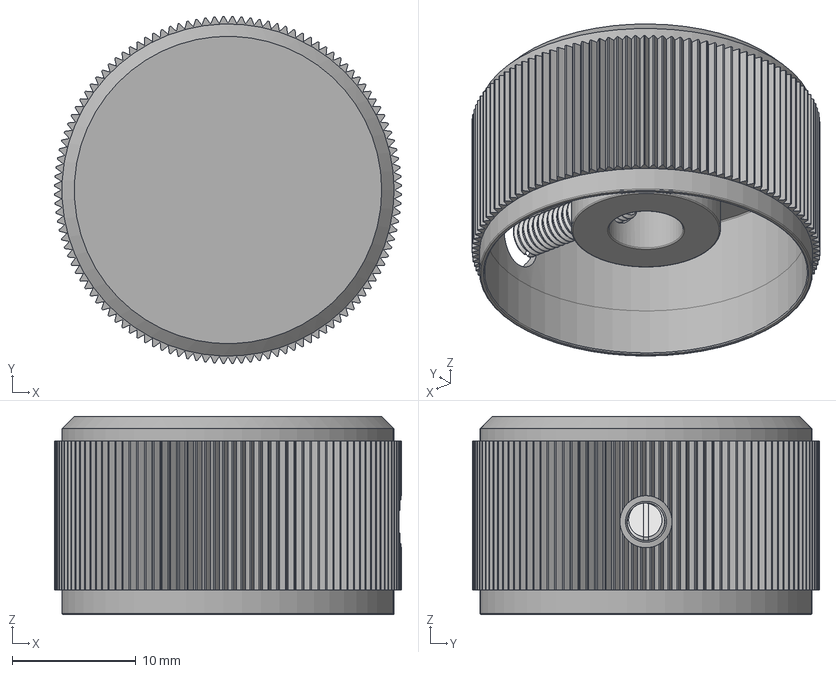
[picture p85: CAD file, 2020-08-24]
mech/Roatary_knob_Al_28mm_knurled-Mentor_5555_6612.FCStd
28.0 x 28.0 x 16.0 mm
KnobBody
LockScrewM3x10
