mjohansson/SolderingStation/mech/MJ_3d_holder_left_hybrid_2nd_rotary.FCStd

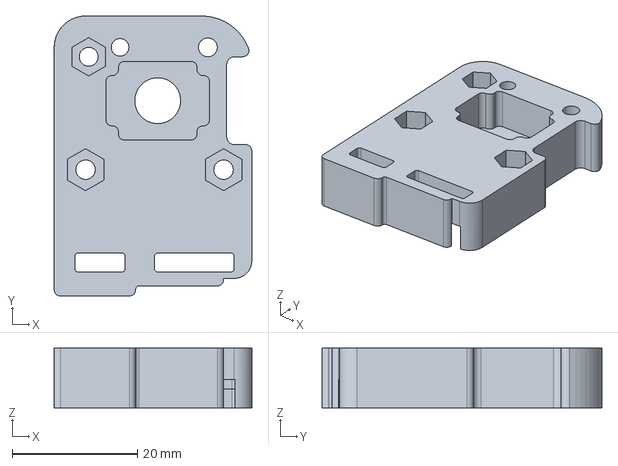
[picture p86: CAD file, 2020-08-24]
mech/MJ_3d_holder_left_hybrid_2nd_rotary.FCStd
31.5 x 44.6 x 9.50 mm
