mjohansson/SolderingStation/mech/MJ_3d_holder_right_3p-r3.FCStd

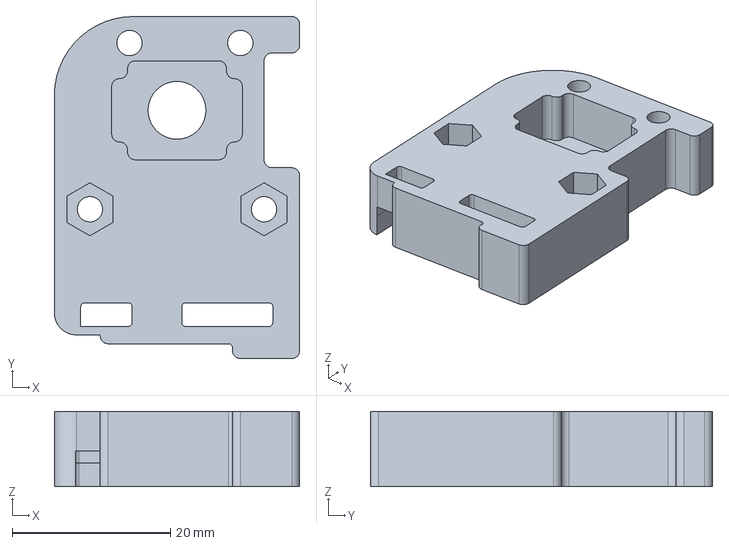
[picture p87: CAD file, 2020-08-24]
mech/MJ_3d_holder_right_3p-r3.FCStd
31.0 x 43.2 x 9.50 mm
