mjohansson/SolderingStation/mech/MJ_3d_holder_left_v2r2.step

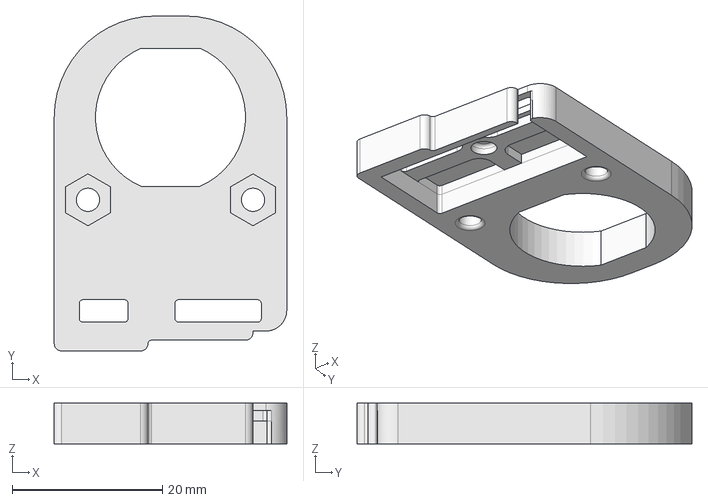
[picture p89: CAD file, 2020-08-18]
mech/MJ_3d_holder_left_v2r2.step
31.0 x 44.6 x 5.40 mm
