mjohansson/SolderingStation/mech/panel_interposer.dxf

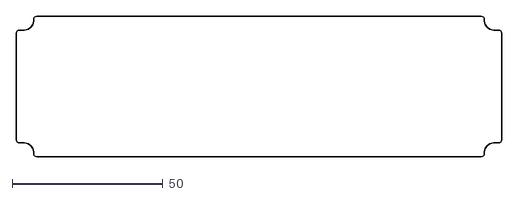
[picture p90: CAD file, 2020-08-18]
mech/panel_interposer.dxf
160.9 x 46.5
