mjohansson/SolderingStation/mech/DIN-SolderablePin.stp

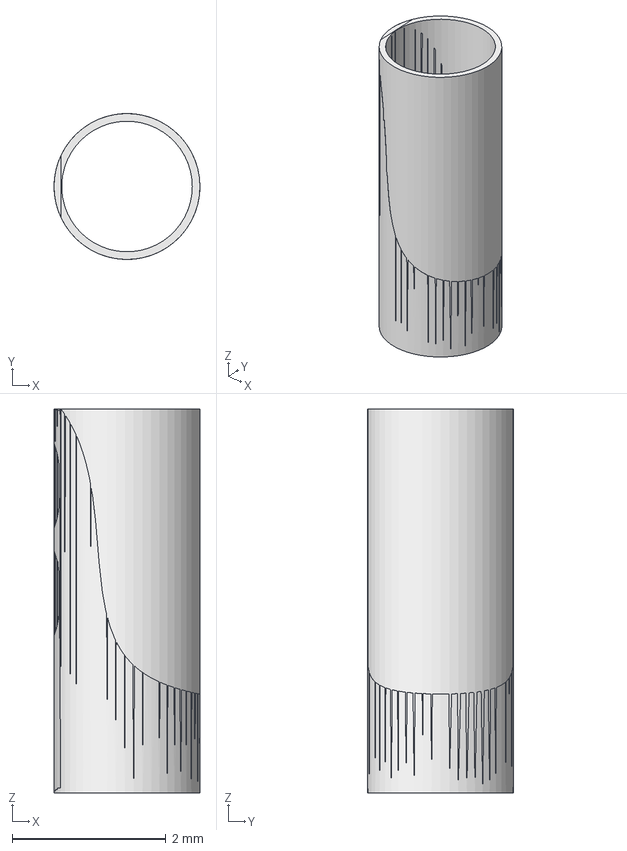
[picture p91: CAD file, 2020-08-18]
mech/DIN-SolderablePin.stp
1.90 x 1.90 x 5.00 mm
