mjohansson/SolderingStation/mech/MJ_3d_holder_right_v2.FCStd

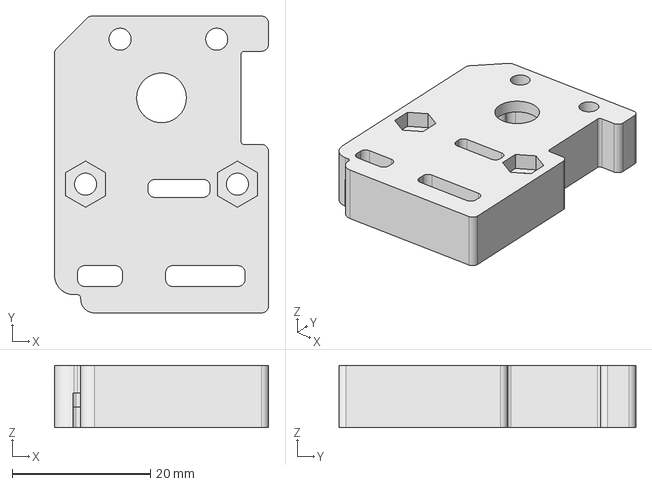
[picture p92: CAD file, 2020-08-18]
mech/MJ_3d_holder_right_v2.FCStd
31.0 x 43.0 x 9.00 mm
