mjohansson/SolderingStation/mech/Amphenol_C707_10M006_052_2-spring_contact.FCStd

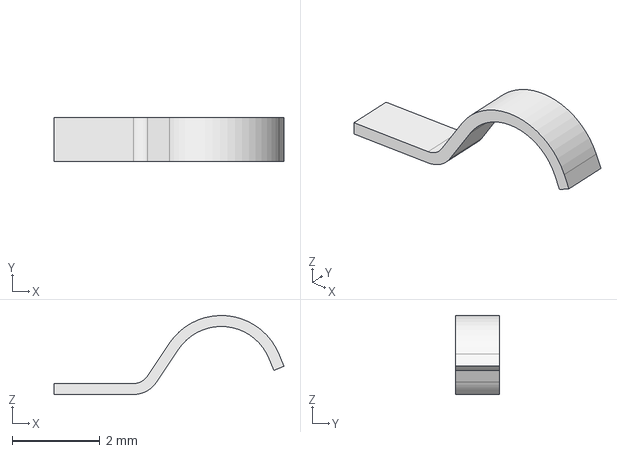
[picture p93: CAD file, 2020-08-18]
mech/Amphenol_C707_10M006_052_2-spring_contact.FCStd
5.24 x 1.00 x 1.80 mm
