mjohansson/SolderingStation/mech/Schurter-0031.0060_002-fuseholder.stp

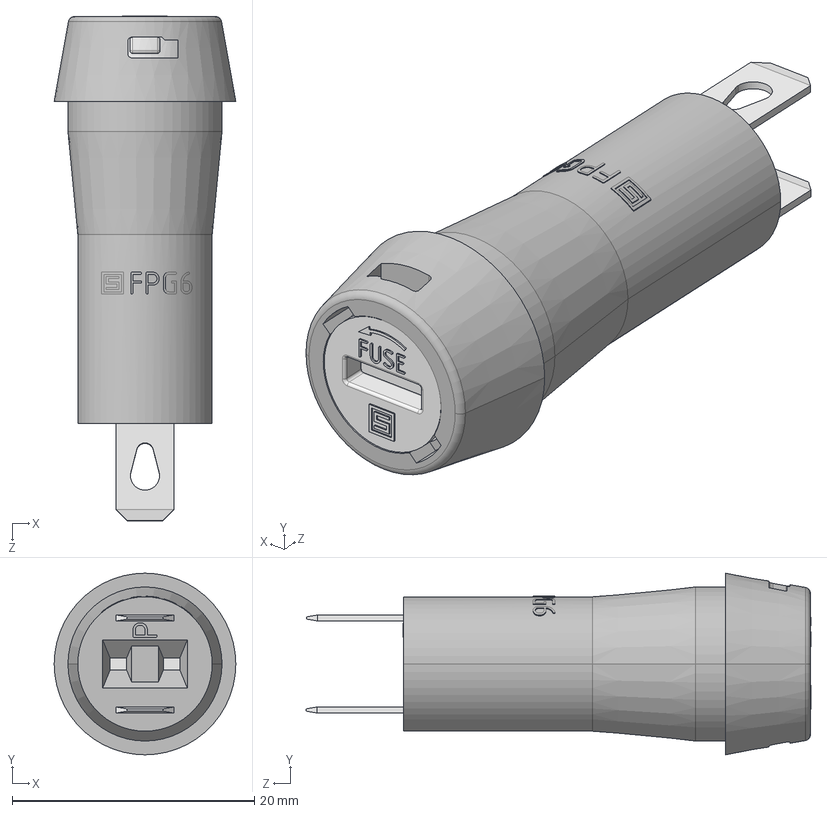
[picture p94: CAD file, 2020-08-18]
mech/Schurter-0031.0060_002-fuseholder.stp
15.0 x 15.0 x 41.7 mm
