mjohansson/SolderingStation/mech/MJ_KY040_rotary.stp

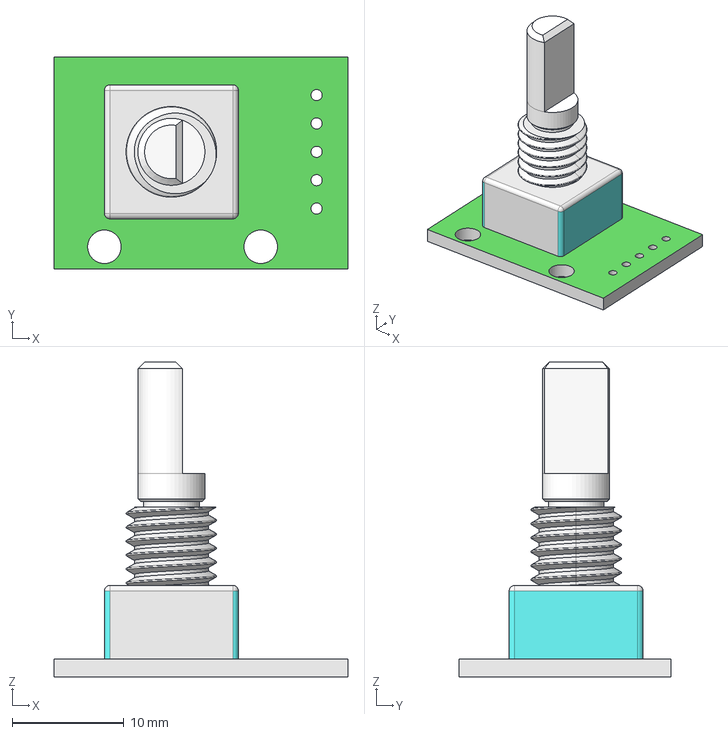
[picture p95: CAD file, 2020-08-18]
mech/MJ_KY040_rotary.stp
26.3 x 19.0 x 28.2 mm
M8x7.0-ScrewTap
