mjohansson/SolderingStation/mech/POF-50185_push-on_feet.step

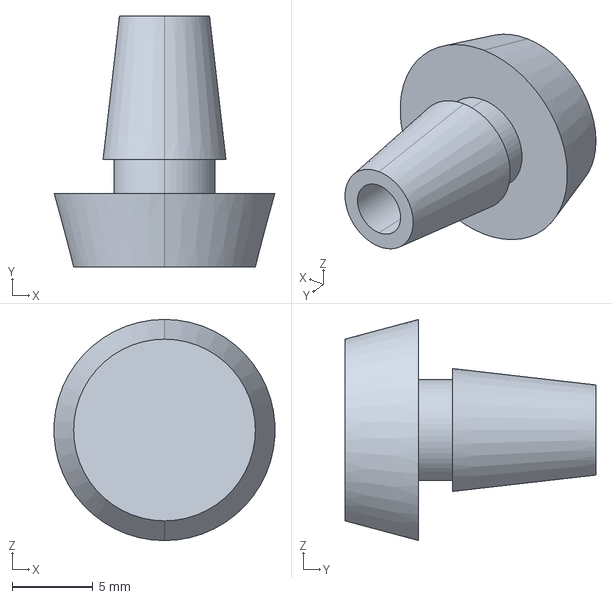
[picture p96: CAD file, 2020-08-18]
mech/POF-50185_push-on_feet.step
13.7 x 15.6 x 13.7 mm
