mjohansson/SolderingStation/mech/Grayhill_3d_holder-Left2.step

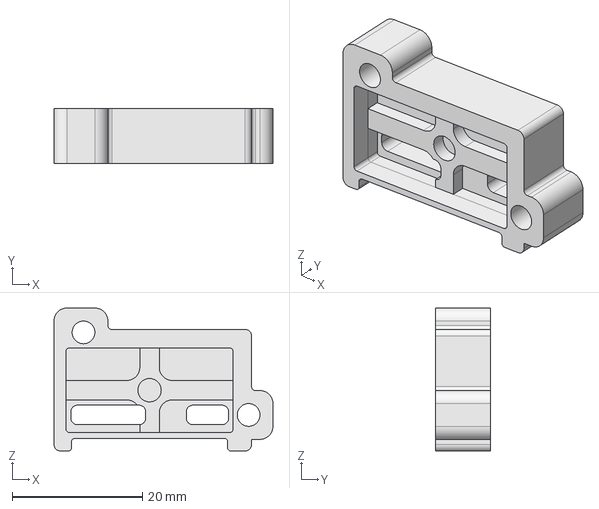
[picture p97: CAD file, 2020-08-18]
mech/Grayhill_3d_holder-Left2.step
33.7 x 8.50 x 22.0 mm
