mjohansson/SolderingStation/mech/DIN7_done.stp

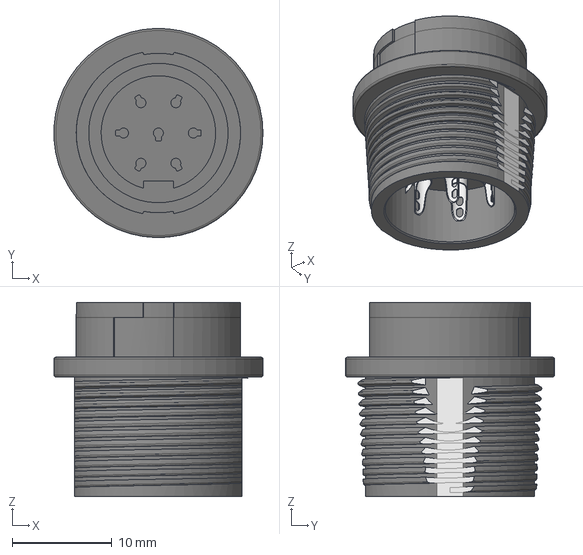
[picture p98: CAD file, 2020-08-18]
mech/DIN7_done.stp
21.0 x 21.0 x 19.5 mm
