mjohansson/SolderingStation/mech/87-DC3-201.stp

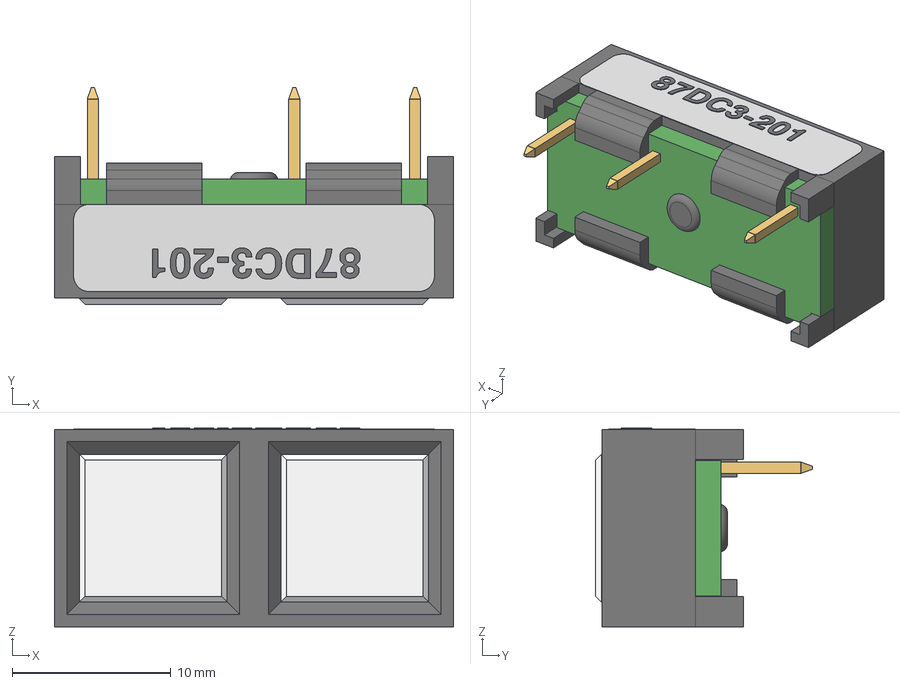
[picture p99: CAD file, 2020-08-18]
mech/87-DC3-201.stp
25.1 x 13.6 x 12.5 mm
87DC3-201Body
ButtonLeftBody
ButtonRightBody
PCBBody
COMMON-Brass_pin-5.75mm
BTN_A-Brass_pin-5.75mm
BTN_B-Brass_pin-5.75mm
LabelBody
LabelTextExtrude
