mjohansson/SolderingStation/mech/MJ_3d_holder_right_3p.FCStd

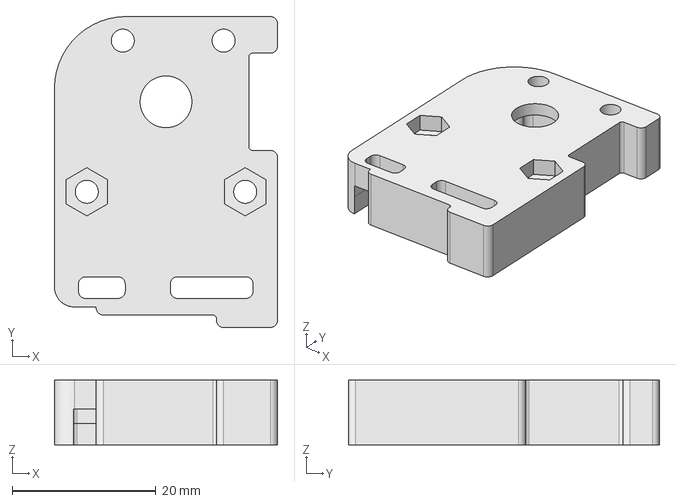
[picture p100: CAD file, 2020-08-18]
mech/MJ_3d_holder_right_3p.FCStd
31.0 x 43.2 x 9.00 mm
