mjohansson/SolderingStation/mech/3d_holder_right-r2.stl

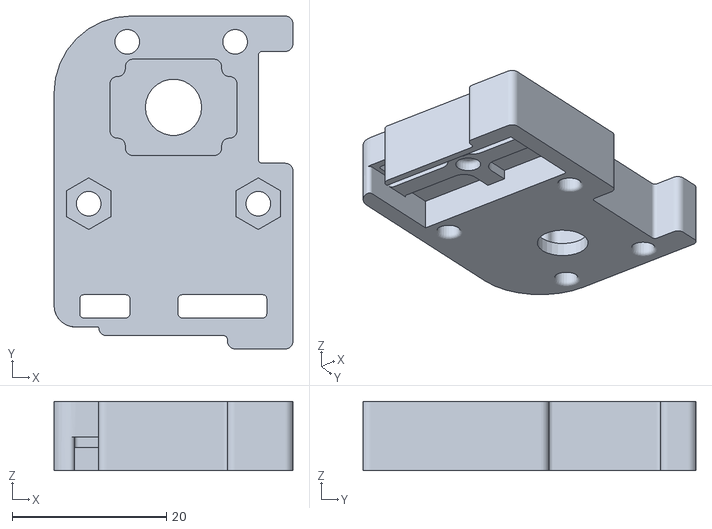
[picture p101: CAD file, 2020-08-18]
mech/3d_holder_right-r2.stl
31.0 x 43.2 x 9.00
