mjohansson/SolderingStation/mech/Amphenol_C707_10M006_052_2-package_pin.FCStd

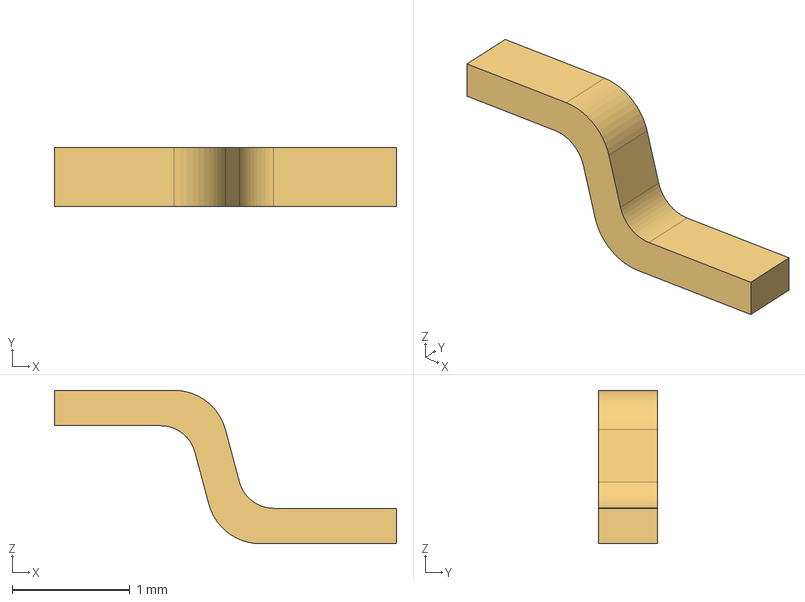
[picture p102: CAD file, 2020-08-18]
mech/Amphenol_C707_10M006_052_2-package_pin.FCStd
2.90 x 0.5 x 1.30 mm
