mjohansson/SolderingStation/mech/Meanwell_LRS-150.stp

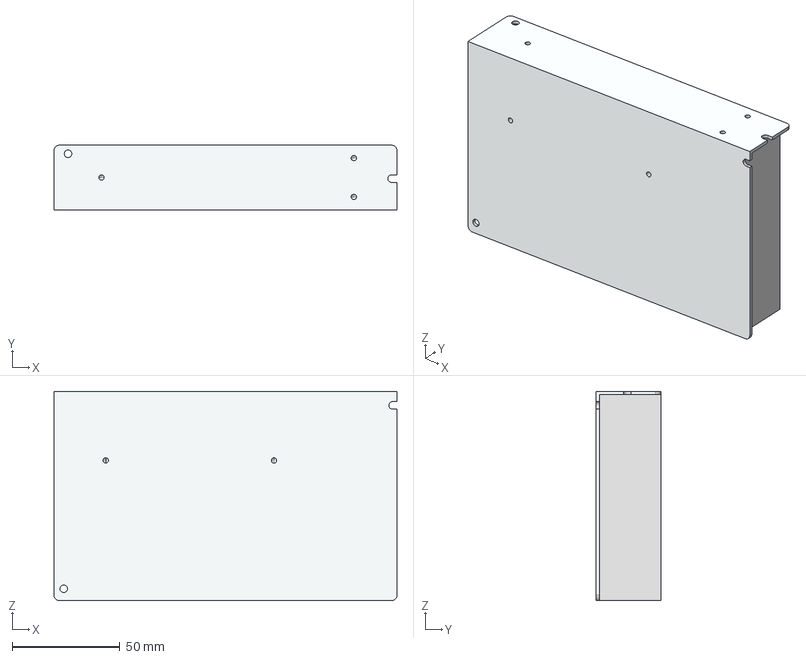
[picture p103: CAD file, 2020-08-18]
mech/Meanwell_LRS-150.stp
159.0 x 30.0 x 97.0 mm
MW_LRS150-Powerbar
MW_LRS150-Terminal_Vm2
MW_LRS150-Terminal_PE
MW_LRS150-Terminal_Vp1
MW_LRS150-Terminal_N
MW_LRS150_body
MW_LRS150-Terminal_L
MW_LRS150-Terminal_Vm1
MW_LRS150-Terminal_Vp2
