mjohansson/SolderingStation/mech/Encoder_KY040.stp

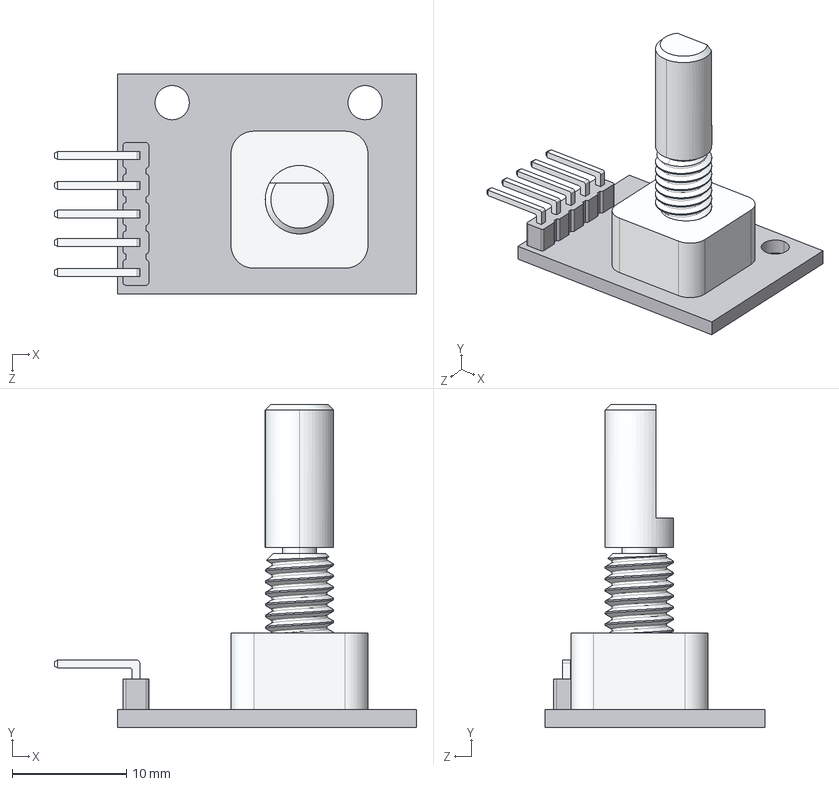
[picture p104: CAD file, 2020-08-18]
mech/Encoder_KY040.stp
31.7 x 28.3 x 19.2 mm
