mjohansson/SolderingStation/mech/FFC_50mm.FCStd

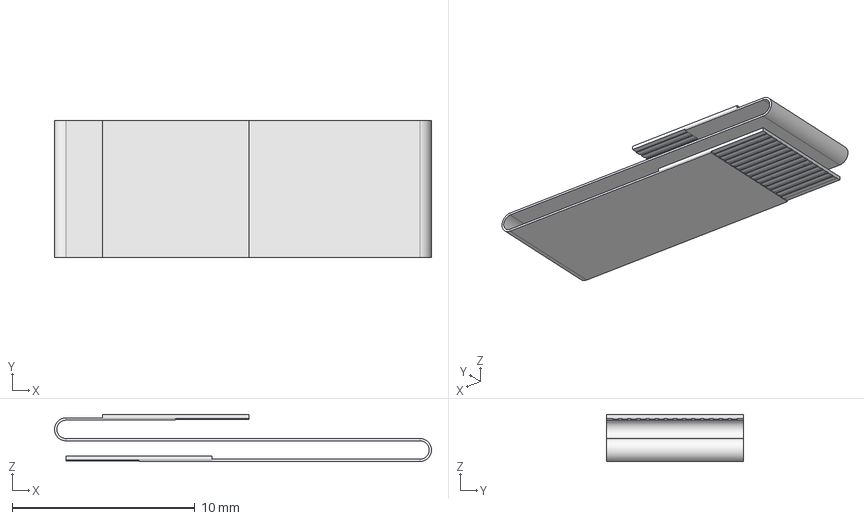
[picture p105: CAD file, 2020-08-18]
mech/FFC_50mm.FCStd
20.6 x 7.50 x 2.58 mm
