mjohansson/SolderingStation/mech/MJ_3d_holder_left_v2r2b.step

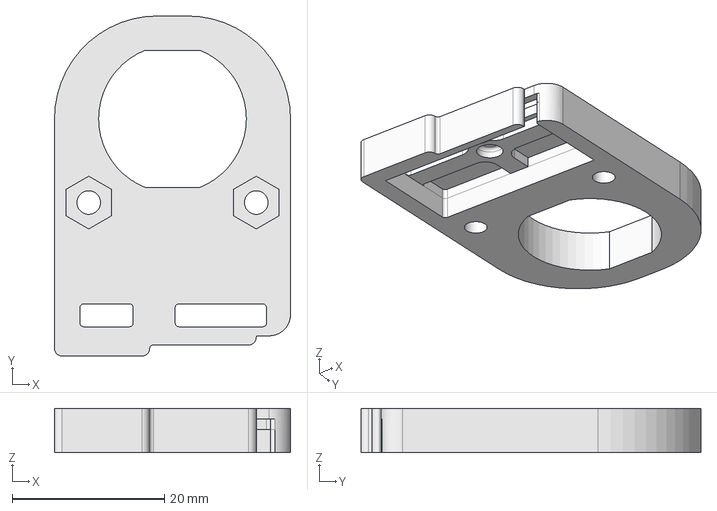
[picture p107: CAD file, 2020-08-18]
mech/MJ_3d_holder_left_v2r2b.step
31.0 x 44.6 x 5.80 mm
