mjohansson/SolderingStation/mech/panel_inner_outline.dxf

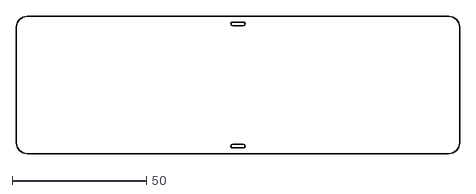
[picture p108: CAD file, 2020-08-18]
mech/panel_inner_outline.dxf
165.0 x 51.1
