mjohansson/SolderingStation/mech/NHD-3.12-25664UCxx.STEP

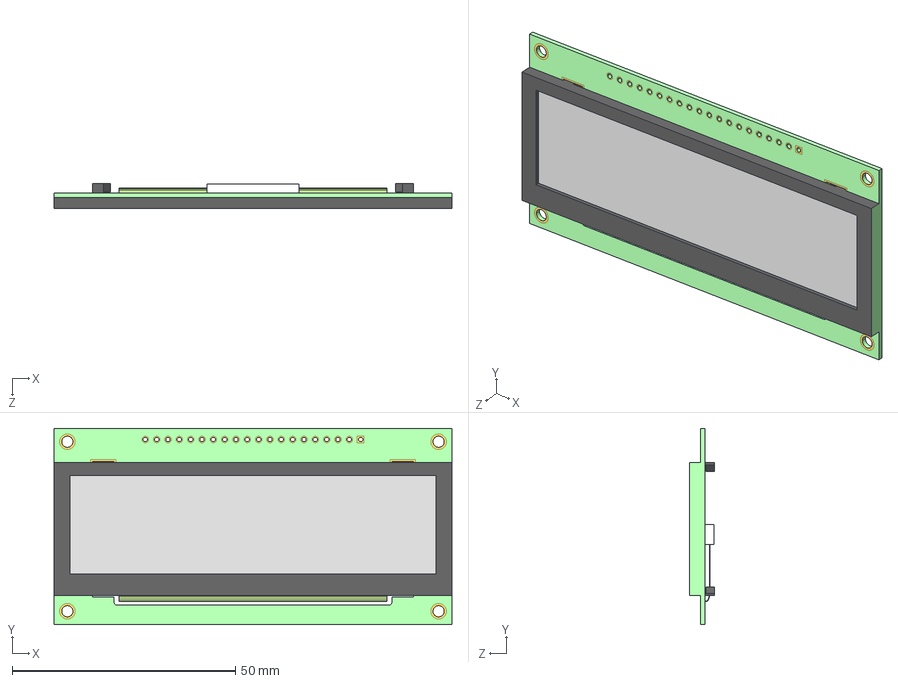
[picture p109: CAD file, 2020-08-18]
mech/NHD-3.12-25664UCxx.STEP
89.2 x 44.0 x 5.70 mm
