mjohansson/SolderingStation/mech/RS_PRO-PowerBleu.step

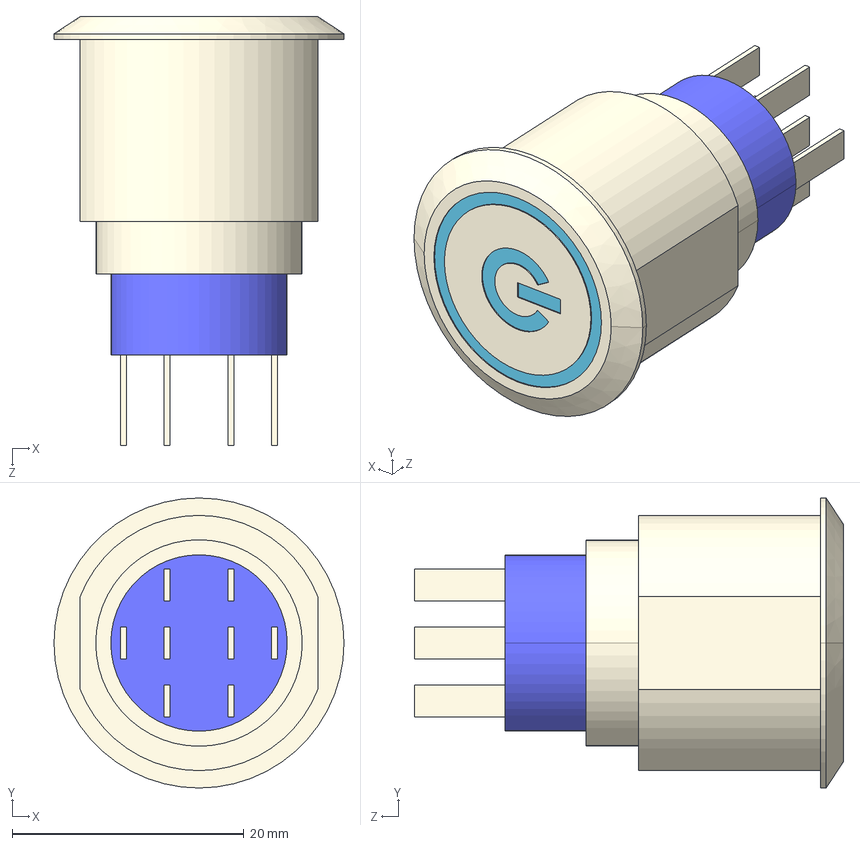
[picture p110: CAD file, 2020-05-09]
mech/RS_PRO-PowerBleu.step
25.0 x 25.0 x 37.0 mm
