mjohansson/SolderingStation/(list of files, cad)

Other CAD files:
mech/QuickConnect_Spade_terminals_lugs/Female_QuickConn-6_35mm-Full_insul-MNU18-187DFIK-Red.stp
mech/Grahill_holder_test_assembly2.step
mech/Grahill_holder_test_assembly.step
hw/ss_frontpanel_outer_plate/ss_frontpanel_outer_plate.FCStd
hw/ss_frontpanel_outer_plate_2nd_rotary/ss_frontpanel_outer_plate_alternate.FCStd
hw/ss_fp_87dc3_bridgeboard/3d_export/ss_fp_87dc3_bridgeboard-SingleBrd-Compound.step
hw/ss_frontpanel_inner_plate/display_carrier-U1_removed-testprint.STL
hw/ss_fp_87dc3_bridgeboard/3d_export/Bridgeboard-SingleBrd_compound.FCStd
hw/ss_frontpanel_inner_plate/ss_frontpanel_inner_plate-test_print.step
mech/Bottomplate_holes_template.stl
mech/QuickConnect_Spade_terminals_lugs/Female QuickConnect-4_8mm-Red.STEP
mech/Grayhill_3d_holder-Left.FCStd
mech/Grayhill_3d_holder-Right.FCStd
mech/Grayhill_3d_holder-Right2.step
mech/MJ_3d_holder_left_v3.step
mech/MJ_3d_holder_right_3pin-r2.step
mech/KY040-meassures.FCStd
mech/MJ_3d_holder_right.FCStd
mech/MJ_3d_holder_right_3p-r2.FCStd
doc/14p_05mm_FFC/Molex_52892-1433/528921433.stp
doc/14p_05mm_FFC/Wurth_687114182122/687114182122_Download_STP_687114182122_rev1.stp
doc/14p_05mm_FFC/Wurth_687114182122/FFC_14_L100_type1/687614100002_Download_STP_6876xxxxx002_rev1.stp
doc/14p_05mm_FFC/Wurth_687114182122/FFC_14_L100_type1/687614152002_Download_STP_6876xxxxx002_rev1.stp
doc/14p_05mm_FFC/Wurth_687114182122/FFC_14_L100_type2_alt/687714100002_Download_STP_6877xxxxx002_rev1.stp
doc/RTC-modules/CR2032_battery_holder/BATT CR2032.step
doc/Si4735-FM_radio-rx_SoC/SMA_ant_conn/60311002111526_Download_STP_60311002111526_rev1.stp
doc/Si4735-FM_radio-rx_SoC/SMA_ant_conn/60349021210720_Download_Step_60349021210720_rev1.stp
doc/back-panel_12V_out/Molex_NanoFit/MOLEX_1054301102-right-angle_header_2pos_single_row/1054301102.stp
doc/ethernet/RJ45/74980104400_Download_STP_WE-LAN-74980104400_rev1.stp
doc/usb_conn/USB_A_WE_629104190121/629104190121_Download_STP_629104190121_rev1.stp
hw/ss_backpanel-mirrored/3d_exports/ss_backpanel-mirrored-F_SilkS.dxf
hw/ss_backpanel-mirrored_Al/3d_export/4mmBanana_panel_with_QC.FCStd
hw/ss_backpanel-mirrored_Al/3d_export/ss_backpanel-mirrored_Al-B_Silkscreen.dxf
hw/ss_backpanel-mirrored_Al/3d_export/ss_backpanel-mirrored_Al-F_Silkscreen.dxf
hw/ss_backpanel/ss_backpanel-F_SilkS.dxf
hw/ss_fp_87dc3_bridgeboard/3d_export/ss_fp_87dc3_bridgeboard-SingleBrd-B_Silkscreen.dxf
hw/ss_fp_87dc3_bridgeboard/3d_export/ss_fp_87dc3_bridgeboard-SingleBrd-F_Silkscreen.dxf
hw/ss_frontpanel_inner_plate/3d_exports/ss_frontpanel_inner_plate-B_Silkscreen.dxf
hw/ss_frontpanel_inner_plate/3d_exports/ss_frontpanel_inner_plate-F_Silkscreen.dxf
hw/ss_frontpanel_inner_plate/ss_frontpanel_inner_plate-B_SilkS.dxf
hw/ss_frontpanel_inner_plate/ss_frontpanel_inner_plate-F_SilkS.dxf
hw/ss_frontpanel_inner_plate/ss_frontpanel_inner_plate.FCStd
hw/ss_frontpanel_outer_plate/3d_exports/ss_frontpanel_outer_plate-B_Silkscreen.dxf
hw/ss_frontpanel_outer_plate/3d_exports/ss_frontpanel_outer_plate-F_Silkscreen.dxf
hw/ss_frontpanel_outer_plate/ss_frontpanel_outer_plate-B_SilkS.dxf
hw/ss_frontpanel_outer_plate_2nd_rotary/ss_frontpanel_outer_plate_alternate-B_SilkS.dxf
hw/ss_frontpanel_outer_plate_Al/3d_export/ss_frontpanel_outer_plate_Al-B_Silkscreen.dxf
hw/ss_mb_mockup/3d_export/solderstn_mb-B_Silkscreen.dxf
mech/87-DC3-201.FCStd
mech/Al-knob_20x15mm_detents_lockscrew.step
mech/Amphenol_C707_10M006_052_2.FCStd
mech/BottomPlate_drill_template-Centered_PSU.stl
mech/DIN-SolderablePin.FCStd
mech/FM_telescope_antenna_screwtype_pivot.FCStd
mech/Hammond_1455T1601BK/1455T1601.stp
mech/Hammond_1455T2201BK/1455T2201.igs
mech/Hammond_1455T2201BK/1455T2201.stp
mech/Hammond_1455T2201BK/1455T2201_zeroed.stp
mech/MJ_3d_holder_left.FCStd
mech/MJ_3d_holder_left_v2-r2.FCStd
mech/MJ_3d_holder_left_v2-r2b.FCStd
mech/MJ_3d_holder_left_v2.FCStd
mech/MJ_3d_holder_left_v2.step
mech/MJ_3d_holder_left_v3.FCStd
mech/MJ_KY040_rotary.FCStd
