mjohansson/SolderingStation/doc/weller_diy_reference_projects/kair.us/DIY Weller WMRP and WMRT soldering iron driver.html

kair.us/ projects/ (http://kair.us/projects/index.html) temp_controller/ (http://kair.us/projects/weller/index.html)

# Weller WMRP and WMRT compatible soldering station

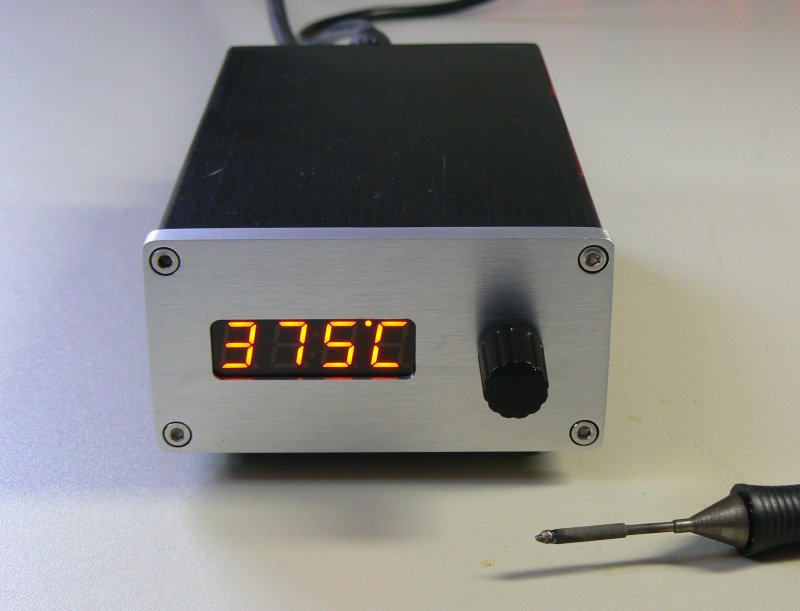
[picture p111: doc/weller_diy_reference_projects/kair.us/DIY Weller WMRP and WMRT soldering iron driver_files/wmrp_wmrt_soldering_station.jpg]
WMRP and WMRT compatible soldering station


This driver can be used with Weller tips which have integrated heater element and temperature sensor. More precisely, tips from WMRP (soldering pen) and WMRT (soldering tweezers) series can be used. Hardware is kept as simple and cheap as possible while still trying to give special attention to usability and accuracy. Main inspiration for this project was the usability (or lack of) the original Weller WD1M and WD2M solder stations. Hardware-wise they are true to Weller quality and engineering, but the UI experience could be better. Factory default setting to cut power from tip immediately when placed in stand - and impossible to change the behavior without manual! Well, someone else might think the same from UI in my Weller driver, but at least I'm happy to use it.

For a demonstration video of the station in action and overview of the various functions click here (https://youtu.be/pl9qgf_qli0).

## Features

- Supports Weller WMRP and WMRT tips
- Very quick heat-up time and response
- Supports WMRP bare tips (with 3.5mm stereo plug)
- Supports the original Weller cables/handles, including readout of PTC for cold junction compensation and reed switch for in-stand detection
- Accurate temperature readings with auto-zero opamp
- Mains frequency filtering for noisy environments
- Setback temperature, setback delay, standby, offset settings as in original Weller stations
- Possible to change step size and temperature unit (°C or °F)
- Diagnostics functions to show thermocouple temperatures from both tips of WMRT, cold junction PTC temperature, reed status and recognized tip type
- Uses internal reference of microcontroller. Possible to calibrate it with multimeter and diagnostic menu setting.
- All functions controlled with one knob

## Hardware

The hardware is based on PIC16F1788, fairly cheap PIC with good analog peripherals. The circuit is kept as simple as possible, while trying to provide optimum performance. The schematic is available in PDF below.
weller_driver_v1_circuit_diagram.pdf (http://kair.us/projects/weller/weller_driver_v1_circuit_diagram.pdf)

## Layout

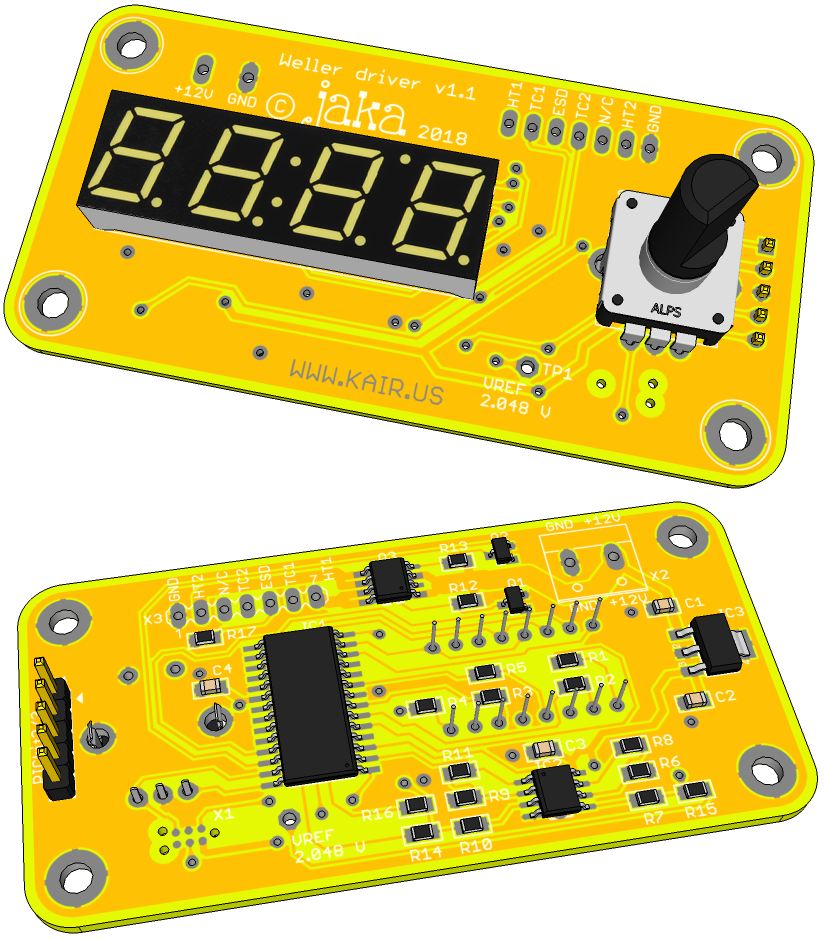
[picture p112: doc/weller_diy_reference_projects/kair.us/DIY Weller WMRP and WMRT soldering iron driver_files/weller_driver_v11_eagleup.png]
Weller driver version 1.1 eagleUp render

The layout is designed with Cadsoft EAGLE 5.12.0. Two-sided board, designed to fit in cheap but nice-looking aluminum enclosure from eBay. Eagle files available below:
weller_driver_hw_v1.zip (http://kair.us/projects/weller/weller_driver_hw_v1.zip) (Version 1, Dec 22, 2015)
weller_driver_hw_v11.zip (http://kair.us/projects/weller/weller_driver_hw_v11.zip) (Version 1.1, Feb 4, 2018. Added PICkit2/3 pin header to make more DIY-friendly. Boards not yet arrived, when I have tested them I will update also the DirtyPCB order link)
Assembly drawing including bill of materials:
weller_driver_v1_assy_dwg.pdf (http://kair.us/projects/weller/weller_driver_v1_assy_dwg.pdf)
IDF exported from Eagle and STEP converted with Solid Works. May be helpful if you are designing an enclosure:
weller_driver_v1_idf_and_step.zip (http://kair.us/projects/weller/weller_driver_v1_idf_and_step.zip)
I have produced these boards at DirtyPCBs (http://dirtypcbs.com/). You can order 10 pcs of these boards for $25 using this link (http://dirtypcbs.com/view.php?share=12240&accesskey=a15d218fd057072b8ed63313fdb99488)

## Firmware

Currently the FW consumes about one fourth of total available in PIC16F1788. Pretty much all needed features are implemented, so PIC16F1786 could be used as well. With some optimization probably also PIC16F1783. But the price difference is negligible. The package below contains source files and compiled binary for PIC16F1788.

weller_driver_fw_v05.zip (http://kair.us/projects/weller/weller_driver_fw_v05.zip) (Version 0.5, Dec 27, 2015. Compiled with CCS compiler (http://www.ccsinfo.com/) v5.048)
weller_driver_fw_v08.zip (http://kair.us/projects/weller/weller_driver_fw_v08.zip) (Version 0.8, Feb 5, 2017. Compiled with CCS compiler (http://www.ccsinfo.com/) v5.054) This includes mains frequency filtering and reduced WMRT buzz.
weller_driver_fw_v901.zip (http://kair.us/projects/weller/weller_driver_fw_v0901.zip) (Version 0.901, Jul 28, 2017. Compiled with CCS compiler v5.054) This includes fix for parameters being out of range after programming the PIC.

## The build

I've built the soldering station in a full aluminum enclosure from eBay (search for '0905 aluminum enclosure' or click here (http://www.ebay.com/sch/i.html?_from=R40&LH_BIN=1&_nkw=0905+aluminum+enclosure&_sop=15), should cost around 14 € including shipping).
The photo below shows inside of the station. I am using a 10 amp power supply, since I originally planned to put two controllers in one station. 120 W would be enough to operate one WMRP and one WMRT simultaneously. I recommend to get a smaller PSU since this 10 A supply is very tight fit in the enclosure. 7 amps should be enough, or 4 amps if you are only going to use WMRP. You can (and should!) of course use an external power supply to avoid mains connections in the enclosure. It will reduce the risk of an electric shock significantly.

The photo below still has connector piece from a Weller WDH10T stand connected to the driver PCB (the black plastic thing behind the case).

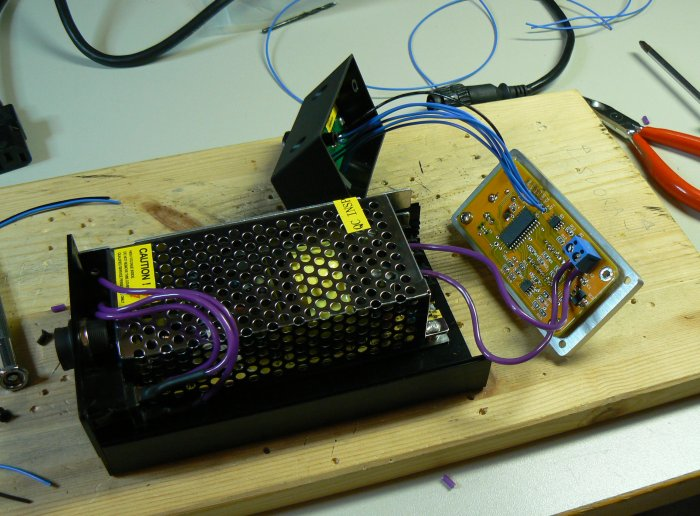
[picture p113: doc/weller_diy_reference_projects/kair.us/DIY Weller WMRP and WMRT soldering iron driver_files/wmrp_wmrt_soldering_station_inside.jpg]
WMRP WMRT soldering station inside


The front panel of the enclosure is 6 mm thick aluminum, so some machining was required to accommodate the rotary encoder and display. If you use smaller PSU and encoder with longer shaft, the build is a tad easier. For the encoder, I really recommend using an Alps brand encoder! Models from Bourns and TT Electronics are also available which are directly compatible, but the quality of Alps is superior. You can use e.g. Alps EC12E2424407 part number 1520813 from Farnell or part number STEC12E08 from Reichelt. The photo below also shows the display lens I used, a piece of smoke tinted Lexan. The BOM specifies a Lite-On LTC-4627JR display, but you can also use Youngsun ATA3492BR-1 display which you can get from Sparkfun (https://www.sparkfun.com/products/9483) and also from Hobbytronics (http://www.hobbytronics.co.uk/lcd/led-displays/4digit-7segment-red). A third alternative is Vishay TDCR1050M, available from TME (https://www.tme.eu/).

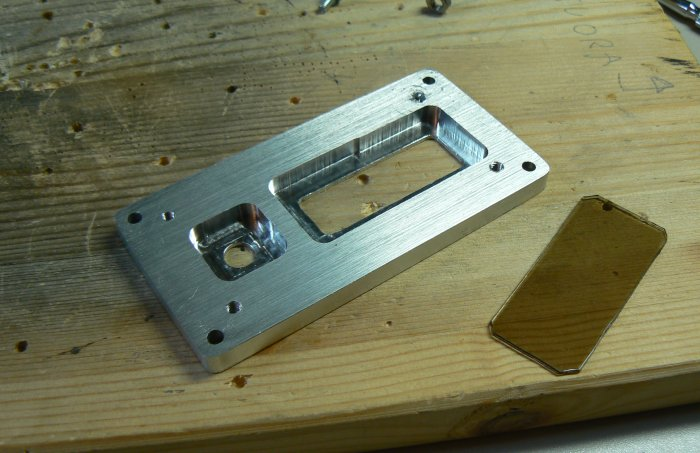
[picture p114: doc/weller_diy_reference_projects/kair.us/DIY Weller WMRP and WMRT soldering iron driver_files/wmrp_wmrt_soldering_station_front_panel_machined.jpg]
WMRP WMRT soldering station front panel machined


Below is rear view photo of the station. The mains connector comes with the enclosure, but hole for iron connector must of course be made. The connector is a modified Amphenol T 3437 000 connector, see this link for instructions in German (http://www.mikrocontroller.net/topic/143288#1500819) (thanks for this tip from FlyGlas Solder Station build page (https://github.com/FlyGlas/WMRP)!). It is available e.g. from Farnell, part number 1123523.

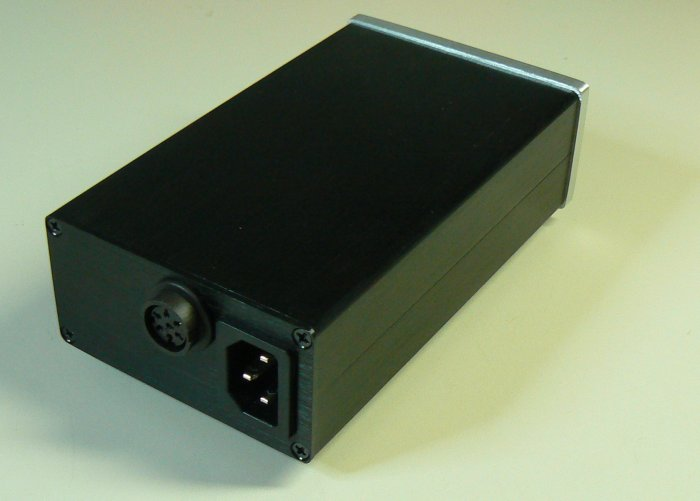
[picture p115: doc/weller_diy_reference_projects/kair.us/DIY Weller WMRP and WMRT soldering iron driver_files/wmrp_wmrt_soldering_station_rear.jpg]
WMRP WMRT soldering station rear


## Handle

You can also build the WMRP handle yourself. Rens PA3AXA has designed a 3D-printable handle and PCB for it. You can buy the PCB from DirtyPCBs using this link (http://dev.dirtypcbs.com/store/designer/details/8234/6106/handle-panel-1x1-zip). The board needs to be ordered as 0.8 mm thick. Design files available for download below:

Handle.skp.zip (http://kair.us/projects/weller/Handle.skp.zip) Handle mechanical model, designed with SketchUp.
Handle_Eagle.zip (http://kair.us/projects/weller/Handle_Eagle.zip) Circuit diagram, assembly drawing and CAD files, designed with Eagle 6.
handle_bom.txt (http://kair.us/projects/weller/handle_bom.txt) Part list

Below are pictures from Rens and his build. He has also modeled the front panel so you can print it if you don't have access to milling machine. Get it here (http://kair.us/projects/weller/Weller_Case_Front.skp.zip).

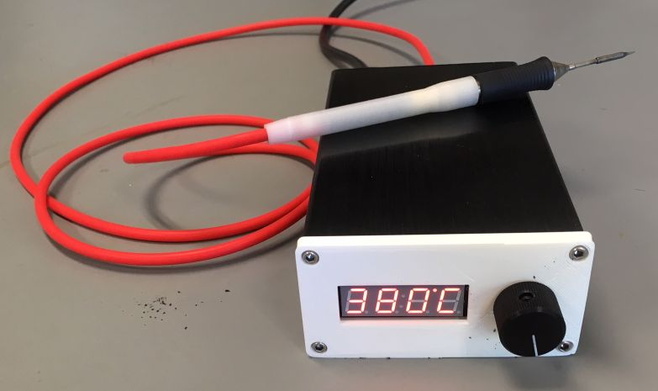
[picture p116: doc/weller_diy_reference_projects/kair.us/DIY Weller WMRP and WMRT soldering iron driver_files/IMG_5327_s.jpg]
Weller station and WMRP handle made by Rens Dijkshoorn


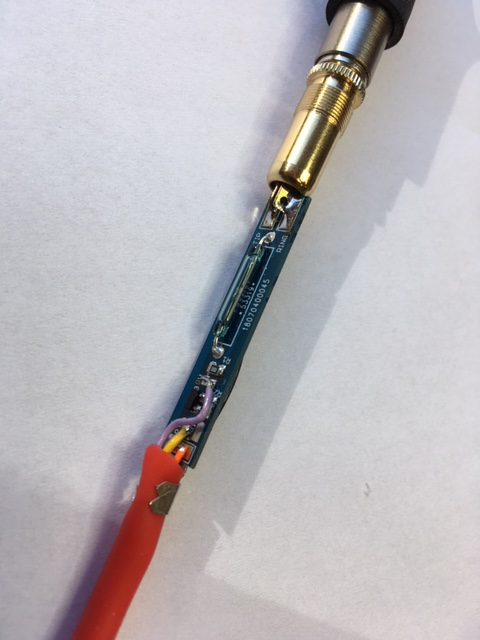
[picture p117: doc/weller_diy_reference_projects/kair.us/DIY Weller WMRP and WMRT soldering iron driver_files/IMG_5292.JPG]
WMRP handle PCB with KTY82 sensor and reed switch


A tip from Rens how to get flexible cable:

"I prepared the cable my self using 4x 1 mm PTFE stranded copper wire into a

number a 8 tube [ 5 mm outer, inside 3 mm, wall 1 ] from

https://aliexpress.com/store/product/2x4mm-Food-Grade-Imported-Silicone-Hose-Tube-Pipe-ID2mm-OD4mm-Free-Shipping-3-5-10-Meters/1939888_32854372904.html"

(https://github.com/FlyGlas/WMRP)

## Other similar projects

Here are some other similar projects or products
(https://github.com/FlyGlas/WMRP) DIY-WMRP Solder Station by FlyGlas (https://github.com/FlyGlas/WMRP) Code developed in Arduino environment. LCD display. Versatile HW and a lot of functions. For video see here (https://www.youtube.com/watch?v=le2HaKJ6B1A).

- SMD Soldering Station for Weller Soldering Tips by pluto (http://www.martin-kumm.de/wiki/doku.php?id=Projects:SMD_Solderstation) A WMRP compatible soldering station realized as an Arduino shield.
- Selbstbau einer SMD-Lötstation (http://www.dl4jal.eu/smd_loetstation/smd_loetst.html) Another WMRP compatible soldering station, inspired by the one above. Controlled by a PIC18 micro. In German.
- Soldering Station by MatthiasW (https://debugginglab.wordpress.com/2014/10/30/soldering-station/) Yet another WMRP compatible soldering station. Arduino-based and with 1.8" color TFT display.
- Maiskolben by Luca Zimmermann (https://hannio.org/produkt/maiskolben/) Quite similar as above. More info available on Github (https://github.com/ArduinoHannover/Maiskolben).
- RT Soldering pen by vlk (https://hackaday.io/project/18899-rt-soldering-pen) Weller WMRP soldering station small enough to to fit inside handle! OLED display with lots of information.
- Soldering pen by HP (https://hackaday.io/project/10140-soldering-pen) Another WMRP station that fits inside the handle With minimalistic approach. Small, simple and cheap.
- Solder Station V2 by Lizerd (http://lizerd.se/?page_id=41) Powerful HW based on STM32. Compatible also with older 24V Weller tools and not just WMRP. Color LCD display. Is listed as 'work in progress' but looks quite finished. Maybe one of the first DIY stations to support WMRP.
- SID Soldering Iron Driver by arhi (http://sid.crsndoo.com/) One of the first open source soldering stations. Supports quite many iron types.
- Unisolder by sparkybg (http://dangerousprototypes.com/forum/viewtopic.php?t=7218) More recent universal solder station. Supports a lot of different iron types.

## Frequently asked questions

Q: How to connect WMRP tip with 3,5 mm stereo jack?
A: See WMRP pinout from here (http://kair.us/projects/weller/wmrp_tip_pinout.jpg). Connect sleeve to 'GND'. Connect ring to 'TC1'. Connect tip to 'HT1'. Use FW v0.6 or newer, enable 'poor' mode from diag menu.

Q: The WMRT tip makes noise! Is this normal?
A: It seems that the heating elements of WMRT make noise when power is switched on or off rapidly. Earlier firmware versions used to periodically pulse current to heating element 2 to recognize tip type. This caused constant buzz with WMRT even when in standby. FW 0.6 and newer recognizes tip type from resistor in parallel with reed switch so the noise is reduced. Original Weller stations drive heating elements using AC and zero point switching. So the current to tip rises and falls slowly, that's why they don't make noise.

Q: The temperature reading is not stable like in the Youtube video, it flickers like there's noise in temperature readout. Why's that?
A: Most likely some external disturbance is coupled to the iron cable. The output of the thermocouple is only some millivolts so it is quite sensitive. WMRT is more sensitive because it has 2k resistor in series with thermocouple while WMRP has 1k. Especially mains frequency seems to couple to the thermocouple line. Starting from firmware v0.6 there is special filtering against mains frequency noise. Temperature measurements are done at double the mains frequency interval, and two consecutive measurements are averaged. This effectively cancels any mains frequency noise. The diagnostics menu has a setting to select between 50 Hz and 60 Hz mains frequency, be sure to set it correctly. Another thing which may help is to connect the ground of the soldering station to mains ground.

Q: How can I program the PIC? There is nothing on the PCB to connect the programmer!
A: See this page (http://kair.us/projects/programming/index.html) for more information on how to program the PIC in my projects.

Q: I have read and understood the PIC programming instructions but I still can't program it. The programmer doesn't find the PIC!
A: The ICSP lines on this board are shared with the rotary encoder. On some encoders, the encoder can keep the one of the programming lines pulled down even when it is at detent position, where both switches should be open. Try to rotate the encoder to such position that neither PGD nor PGC are pulled to GND.

Q: I can only adjust the reference to one direction! Some of the parameters show '-1' or other erroneous or garbage values!
A: These kind of issues seem to happen if the PIC is programmed with MPLAB IPE. By default, the MPLAB IPE doesn't seem to erase or program the data EEPROM. These kind of problems are fixed in firmware v0.9 and newer. All the parameters are checked at startup and if any of those are outside of valid range, all parameters are set to default values.

kair.us/ projects/ (http://kair.us/projects/index.html) temp_controller/ (http://kair.us/projects/weller/index.html)

page created 23.12.2015
last updated 6.8.2018 webmaster@kair.us
