mjohansson/SolderingStation/pictures/Backpanel_connectors_fit_test_plus_FPDB_and_Frontpanel_OLED_pushbtns.jpg

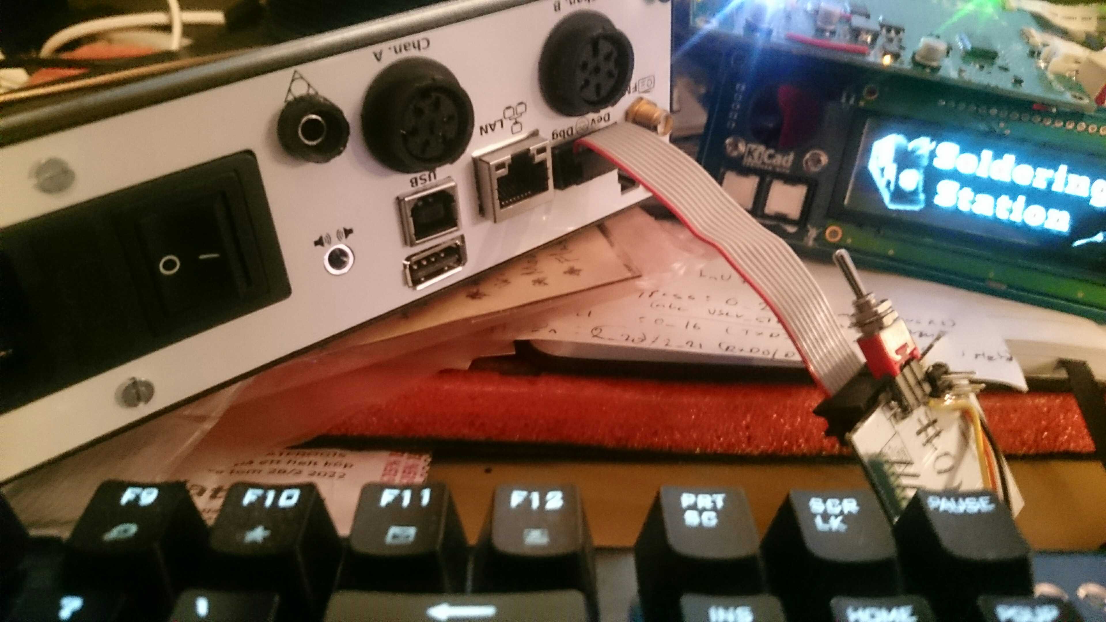
pictures/Backpanel_connectors_fit_test_plus_FPDB_and_Frontpanel_OLED_pushbtns.jpg
