mjohansson/SolderingStation/doc/dcdc_buck/Pluto-buck/WBDesign1.pdf

## WEBENCH ® Design Report

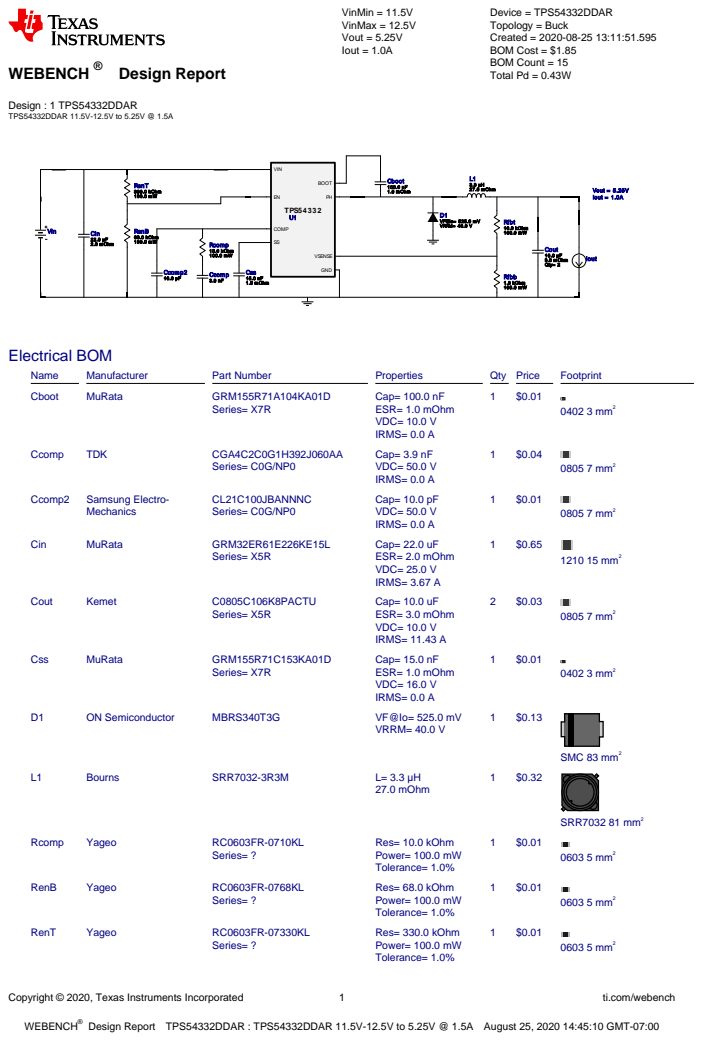
[picture p122: page 1]
Copyright © 2020, Texas Instruments Incorporated; ti.com/webench; WEBENCH®; Design : 1 TPS54332DDAR TPS54332DDAR 11.5V-12.5V to 5.25V @ 1.5A; VinMin = 11.5V VinMax = 12.5V Vout = 5.25V Iout = 1.0A; Device = TPS54332DDAR Topology = Buck Created = 2020-08-25 13:11:51.595 BOM Cost = $1.85 BOM Count = 15 Total Pd = 0.43W; Css 15.0 nF 1.0 mOhm; Ccomp2 10.0 pF; TPS54332; BOOT; VIN; VSENSE; COMP; GND; Rfbb 1.8 kOhm 100.0 mW; RenB 68.0 kOhm 100.0 mW; RenT 330.0 kOhm 100.0 mW; Cboot 100.0 nF 1.0 mOhm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

Design Report TPS54332DDAR : TPS54332DDAR 11.5V-12.5V to 5.25V @ 1.5A August 25, 2020 14:45:10 GMT-07:00

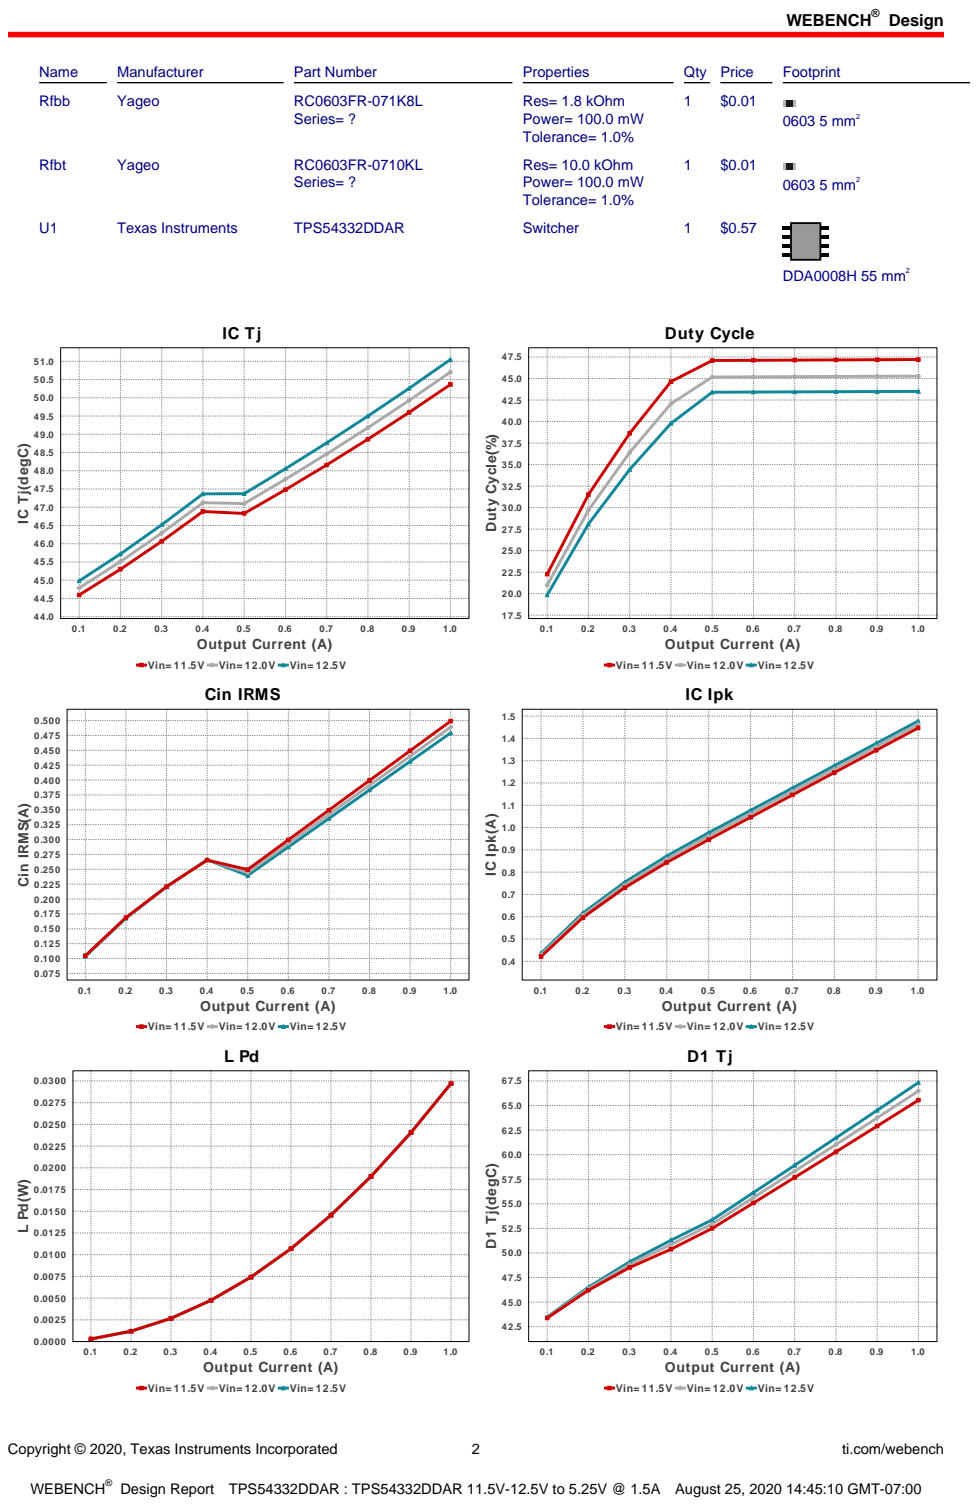
[picture p123: page 2]
Design; Copyright © 2020, Texas Instruments Incorporated; ti.com/webench; Name; Manufacturer; Part Number; Properties; Qty Price; Footprint; Rfbb; Yageo; Series= ?; Res= 1.8 kOhm Power= 100.0 mW Tolerance= 1.0%; 0603 5 mm²; Rfbt; Res= 10.0 kOhm Power= 100.0 mW Tolerance= 1.0%; Texas Instruments; TPS54332DDAR; Switcher; DDA0008H 55 mm²; 1.0 Output Current (A); Duty Cycle; Duty Cycle(%); Cin IRMS(A); IC Ipk; IC Ipk(A); D1 Tj(degC)

IC Tj(degC)

Vin= 11.5V Vin= 12.0V Vin= 12.5V
Cin IRMS

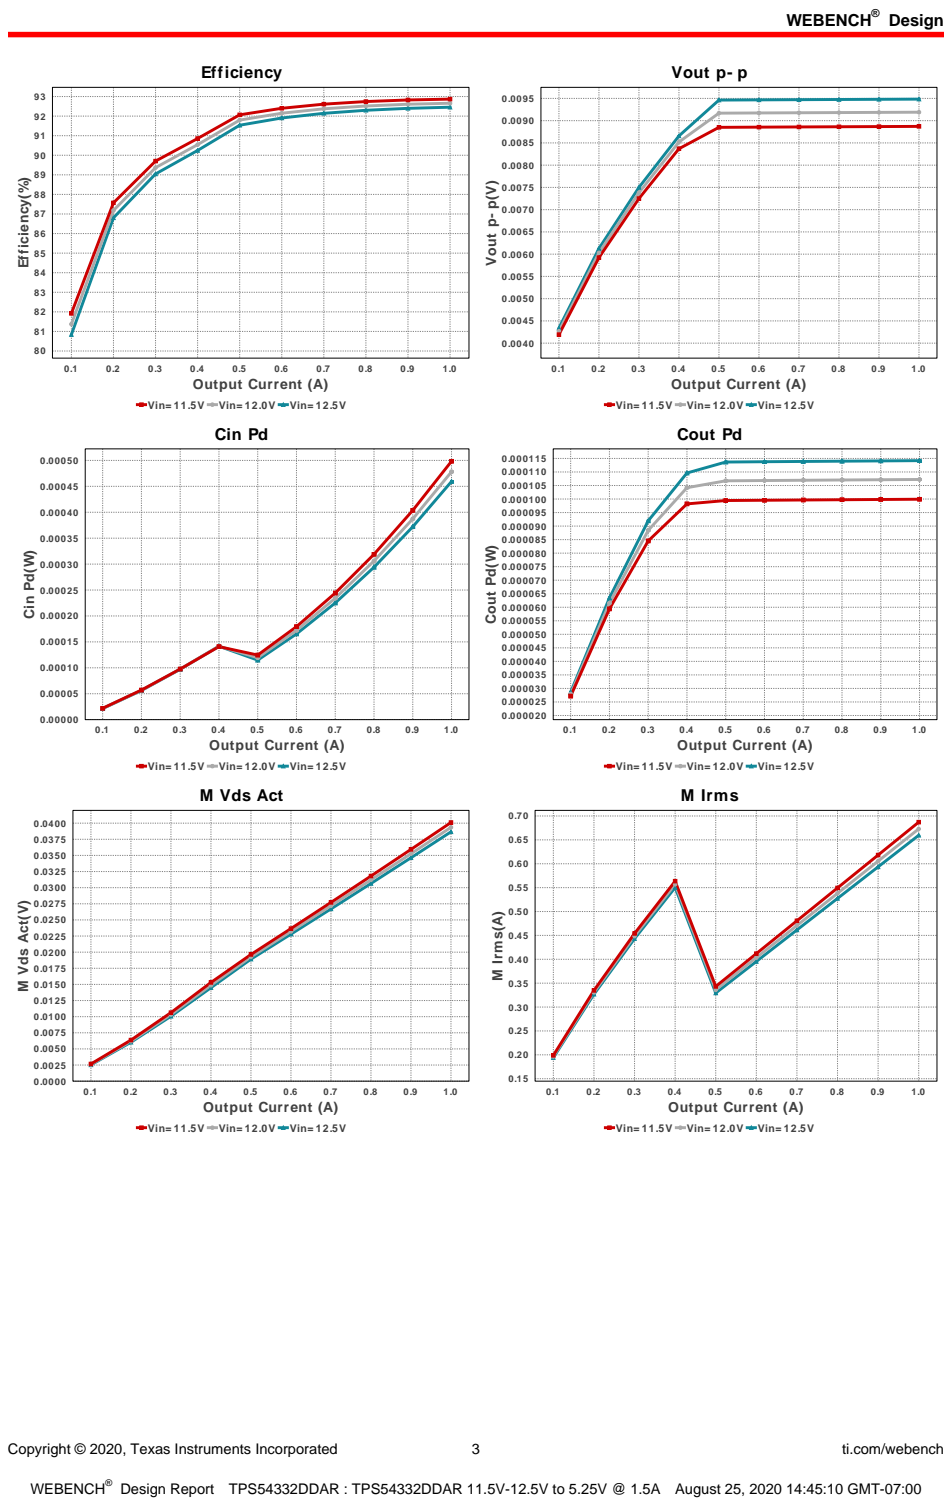
[picture p124: page 3]
Copyright © 2020, Texas Instruments Incorporated; ti.com/webench; Efficiency; 1.0 Output Current (A); Efficiency(%); Vout p- p; Vout p- p(V); Cin Pd; Cin Pd(W); Cout Pd; Cout Pd(W); M Vds Act(V); M Irms; M Irms(A)

Vin= 11.5V Vin= 12.0V Vin= 12.5V

M Vds Act

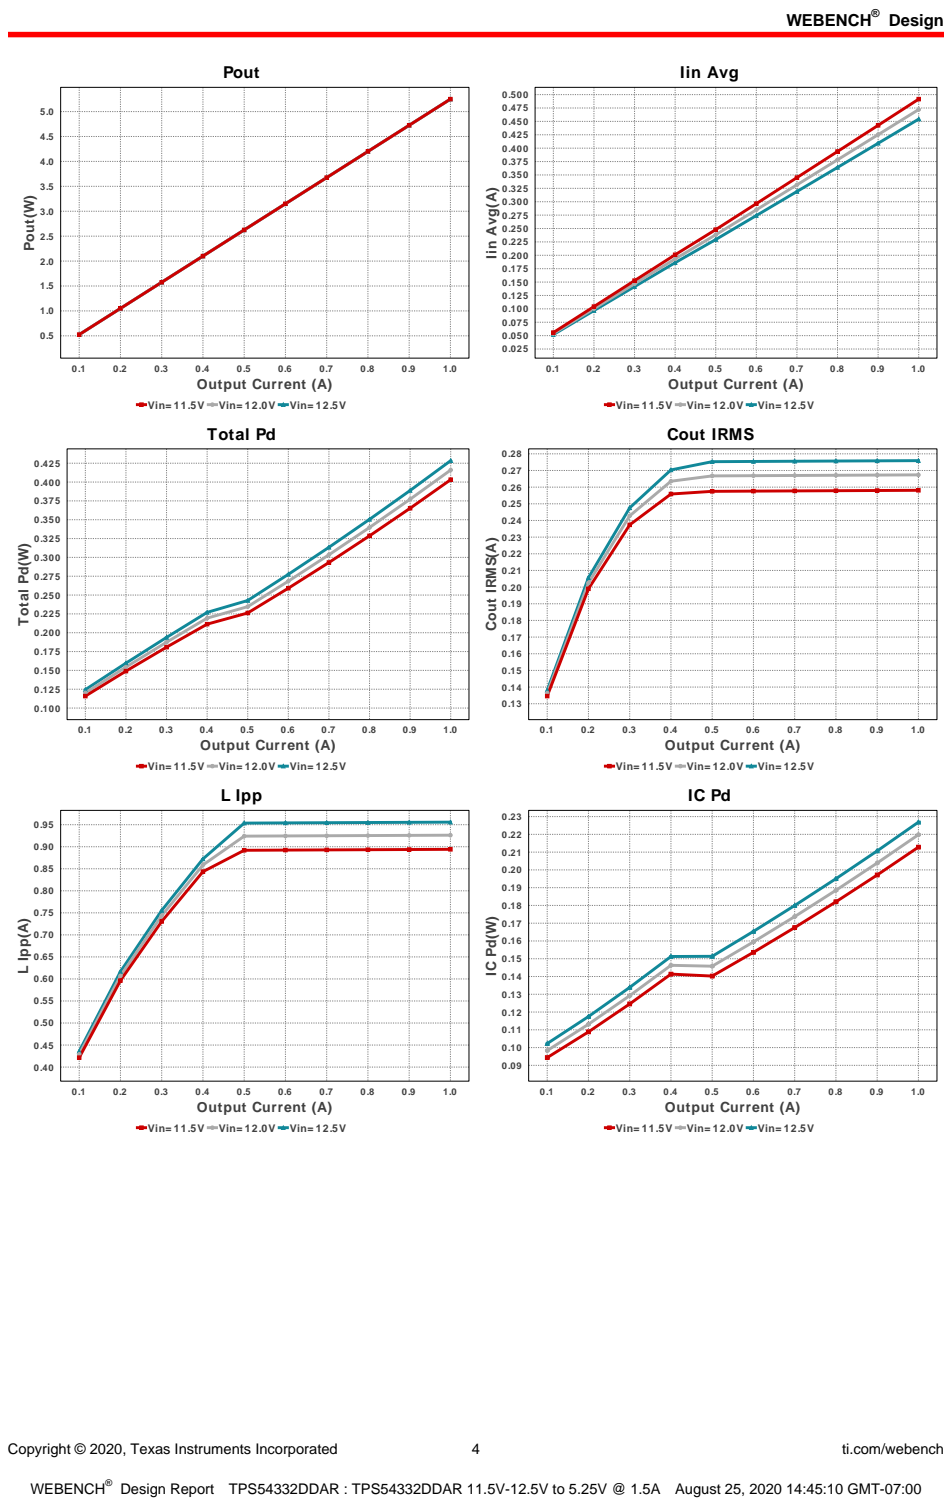
[picture p125: page 4]
Copyright © 2020, Texas Instruments Incorporated; ti.com/webench; Pout; 1.0 Output Current (A); Pout(W); Iin Avg; Iin Avg(A); Total Pd; Total Pd(W); Cout IRMS(A); L Ipp; L Ipp(A)

Vin= 11.5V Vin= 12.0V Vin= 12.5V

Cout IRMS

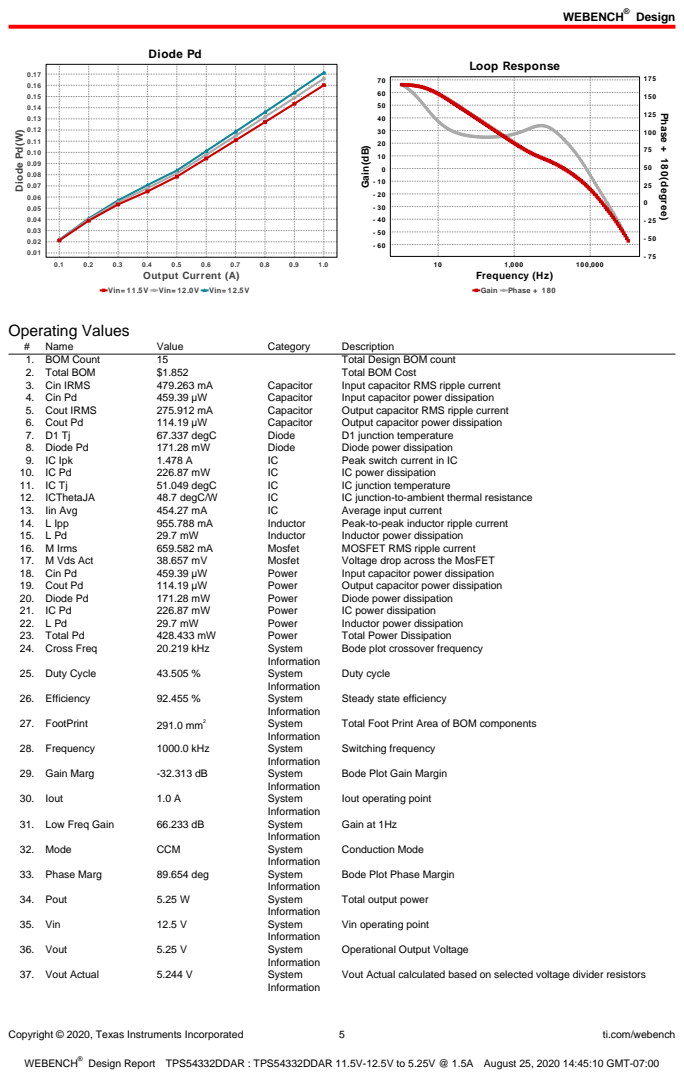
[picture p126: page 5]
Copyright © 2020, Texas Instruments Incorporated; ti.com/webench; Diode Pd; 1.0 Output Current (A); Diode Pd(W); Loop Response; Gain Phase + 180; 100,000 Frequency (Hz); Gain(dB); Phase + 180(degree); Operating Values; Name; Value; Category; Description; 1. BOM Count; Total Design BOM count; 2. Total BOM; Total BOM Cost; 3. Cin IRMS; Capacitor; Input capacitor RMS ripple current; 4. Cin Pd; Input capacitor power dissipation; 5. Cout IRMS; Output capacitor RMS ripple current; 6. Cout Pd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

Vin= 11.5V Vin= 12.0V Vin= 12.5V

Bode plot crossover frequency

Steady state efficiency

Total Foot Print Area of BOM components

Bode Plot Gain Margin

Iout operating point

Bode Plot Phase Margin

Total output power

Vin operating point

Operational Output Voltage

Vout Actual calculated based on selected voltage divider resistors

Copyright © 2020, Texas Instruments Incorporated | 6 | ti.com/webench
# | Name | Value | Category | Description

38. Vout Tolerance | 5.272 % | System
| | | Information | Vout Tolerance based on IC Tolerance (no load) and voltage divider resistors if applicable
39. Vout p-p | 9.484 mV | System
| | | Information | Peak-to-peak output ripple voltage

## Design Inputs

Name | Value | Description
Iout | 1.0 | Maximum Output Current
SoftStart | 6.0 ms | Soft Start Time (ms)
VinMax | 12.5 | Maximum input voltage
VinMin | 11.5 | Minimum input voltage
Vout | 5.25 | Output Voltage
| base_pn | | TPS54332 | Base Product Number
source | DC | Input Source Type
Ta | 40.0 | Ambient temperature


Copyright © 2020, Texas Instruments Incorporated | 7 | ti.com/webench

## Assembly

## Component Testing

Some published data on components in datasheets such as Capacitor ESR and Inductor DC resistance is based on conservative values that will guarantee that the components always exceed the specification. For design purposes it is usually better to work with typical values. Since this data is not always available it is a good practice to measure the Capacitance and ESR values of Cin and Cout, and the inductance and DC resistance of L1 before assembly of the board. Any large discrepancies in values should be electrically simulated in WEBENCH to check for instabilities and thermally simulated in WebTHERM to make sure critical temperatures are not exceeded.

## Soldering Component to Board

If board assembly is done in house it is best to tack down one terminal of a component on the board then solder the other terminal. For surface mount parts with large tabs, such as the DPAK, the tab on the back of the package should be pre-tinned with solder, then tacked into place by one of the pins. To solder the tab town to the board place the iron down on the board while resting against the tab, heating both surfaces simultaneously. Apply light pressure to the top of the plastic case until the solder flows around the part and the part is flush with the PCB. If the solder is not flowing around the board you may need a higher wattage iron (generally 25W to 30W is enough).

## Initial Startup of Circuit

It is best to initially power up the board by setting the input supply voltage to the lowest operating input voltage 11.5V and set the input supply's current limit to zero. With the input supply off connect up the input supply to Vin and GND. Connect a digital volt meter and a load if needed to set the minimum Iout of the design from Vout and GND. Turn on the input supply and slowly turn up the current limit on the input supply.
If the voltage starts to rise on the input supply continue increasing the input supply current limit while watching the output voltage. If the current increases on the input supply, but the voltage remains near zero, then there may be a short or a component misplaced on the board. Power down the board and visually inspect for solder bridges and recheck the diode and capacitor polarities. Once the power supply circuit is operational then more extensive testing may include full load testing, transient load and line tests to compare with simulation results.

## Load Testing

The setup is the same as the initial startup, except that an additional digital voltmeter is connected between Vin and GND, a load is connected between Vout and GND and a current meter is connected in series between Vout and the load. The load must be able to handle at least rated output power + 50% ( 7.5 watts for this design). Ideally the load is supplied in the form of a variable load test unit. It can also be done in the form of suitably large power resistors. When using an oscilloscope to measure waveforms on the prototype board, the ground leads of the oscilloscope probes should be as short as possible and the area of the loop formed by the ground lead should be kept to a minimum. This will help reduce ground lead inductance and eliminate EMI noise that is not actually present in the circuit.

## WEBENCH® Electrical Simulation Report

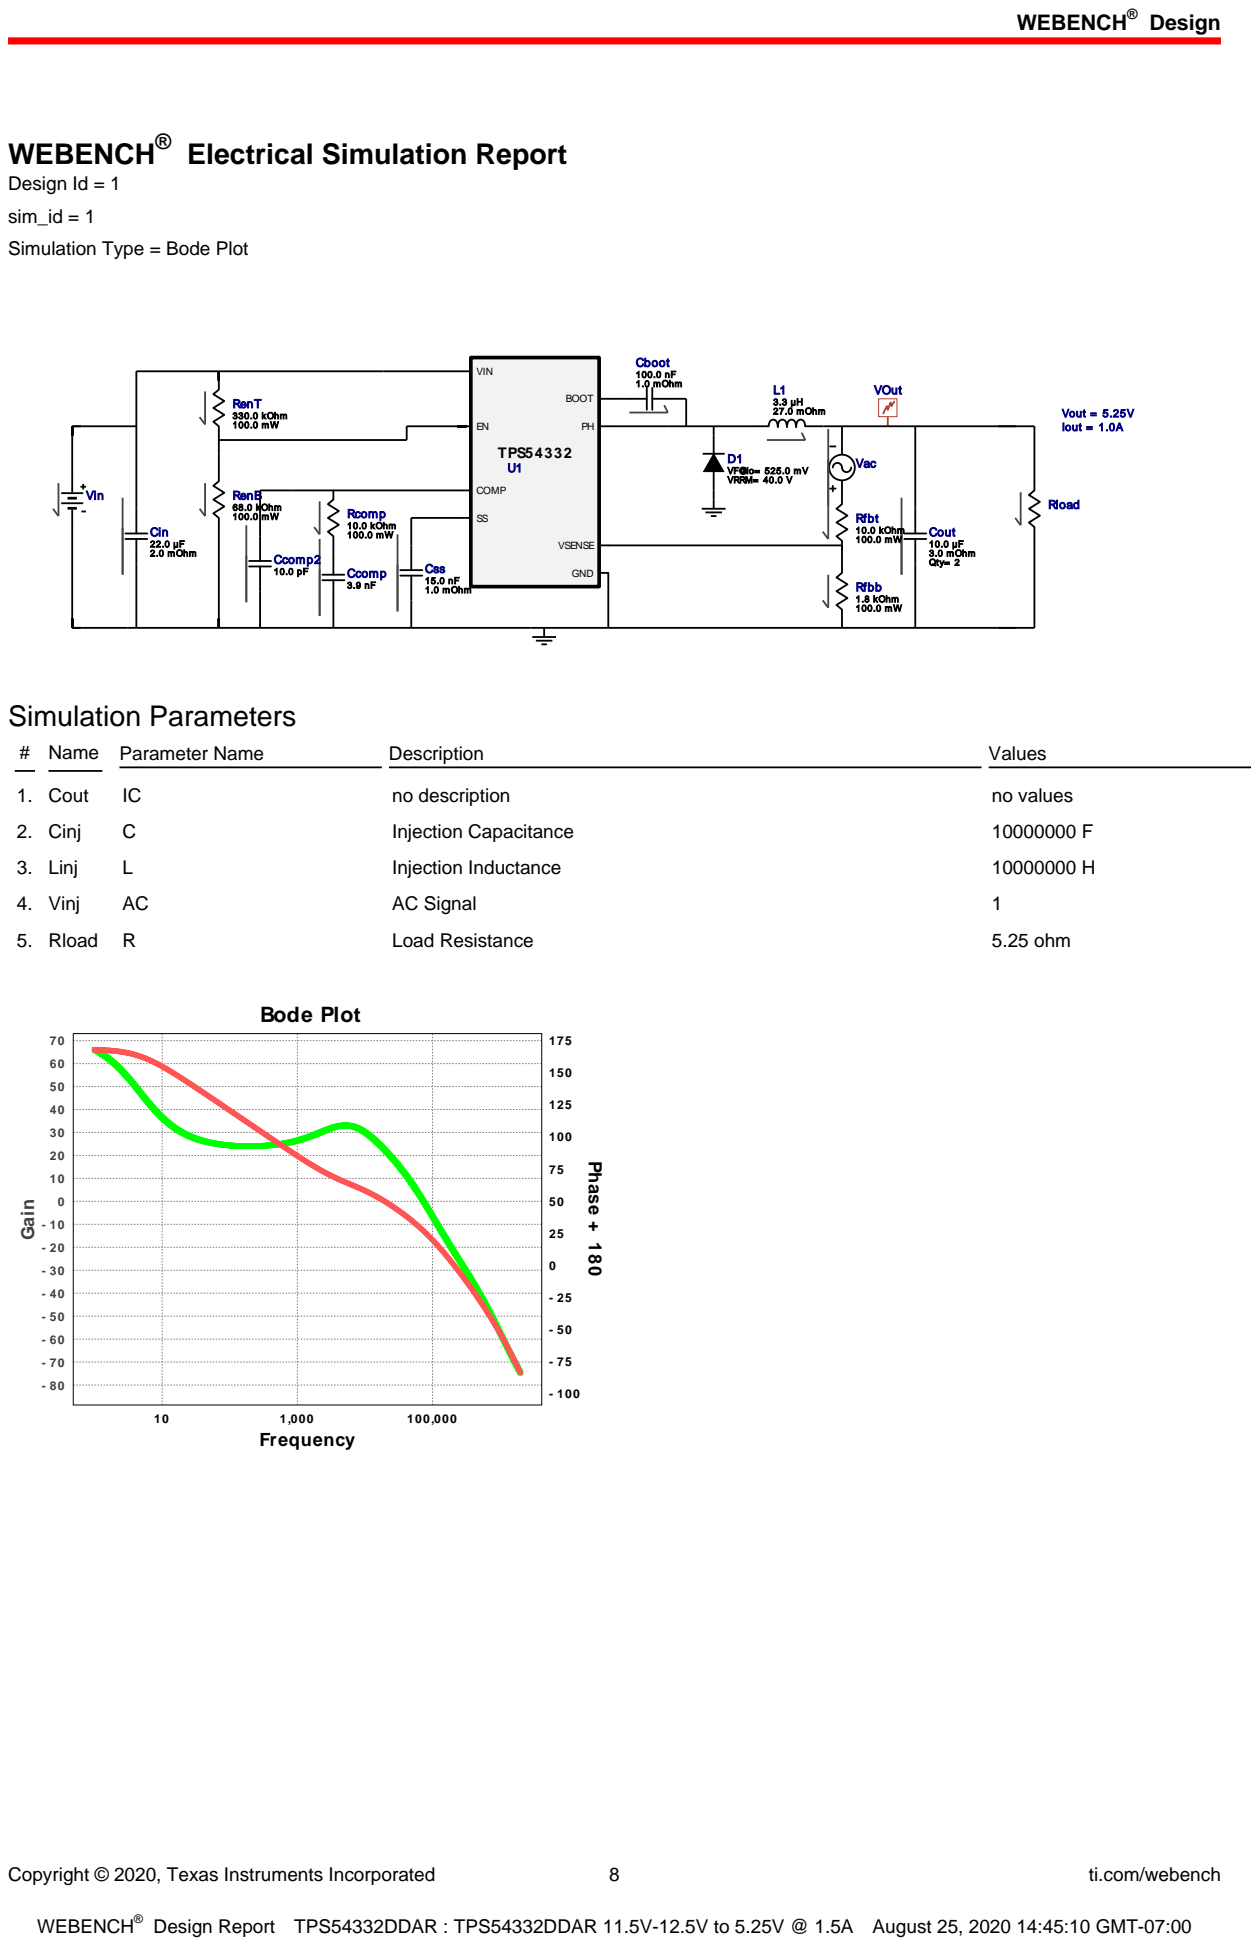
[picture p128: page 8]
Copyright © 2020, Texas Instruments Incorporated; ti.com/webench; Cboot 100.0 nF 1.0 mOhm; Ccomp 3.9 nF; Ccomp2 10.0 pF; Cin 22.0 µF 2.0 mOhm; Cout 10.0 µF 3.0 mOhm Qty= 2 Css; 15.0 nF 1.0 mOhm; D1 VF@Io= 525.0 mV VRRM= 40.0 V; L1 3.3 µH 27.0 mOhm; Rcomp 10.0 kOhm 100.0 mW; Rfbb 1.8 kOhm 100.0 mW; Rfbt 10.0 kOhm 100.0 mW; TPS54332; BOOT; VIN; VSENSE; COMP; GND; Vout = 5.25V Iout = 1.0A; VOut; Vac; RenB 68.0 kOhm; RenT 330.0 kOhm 100.0 mW; Vin; Rload; Simulation Parameters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

Design Id = 1
sim_id = 1
Simulation Type = Bode Plot

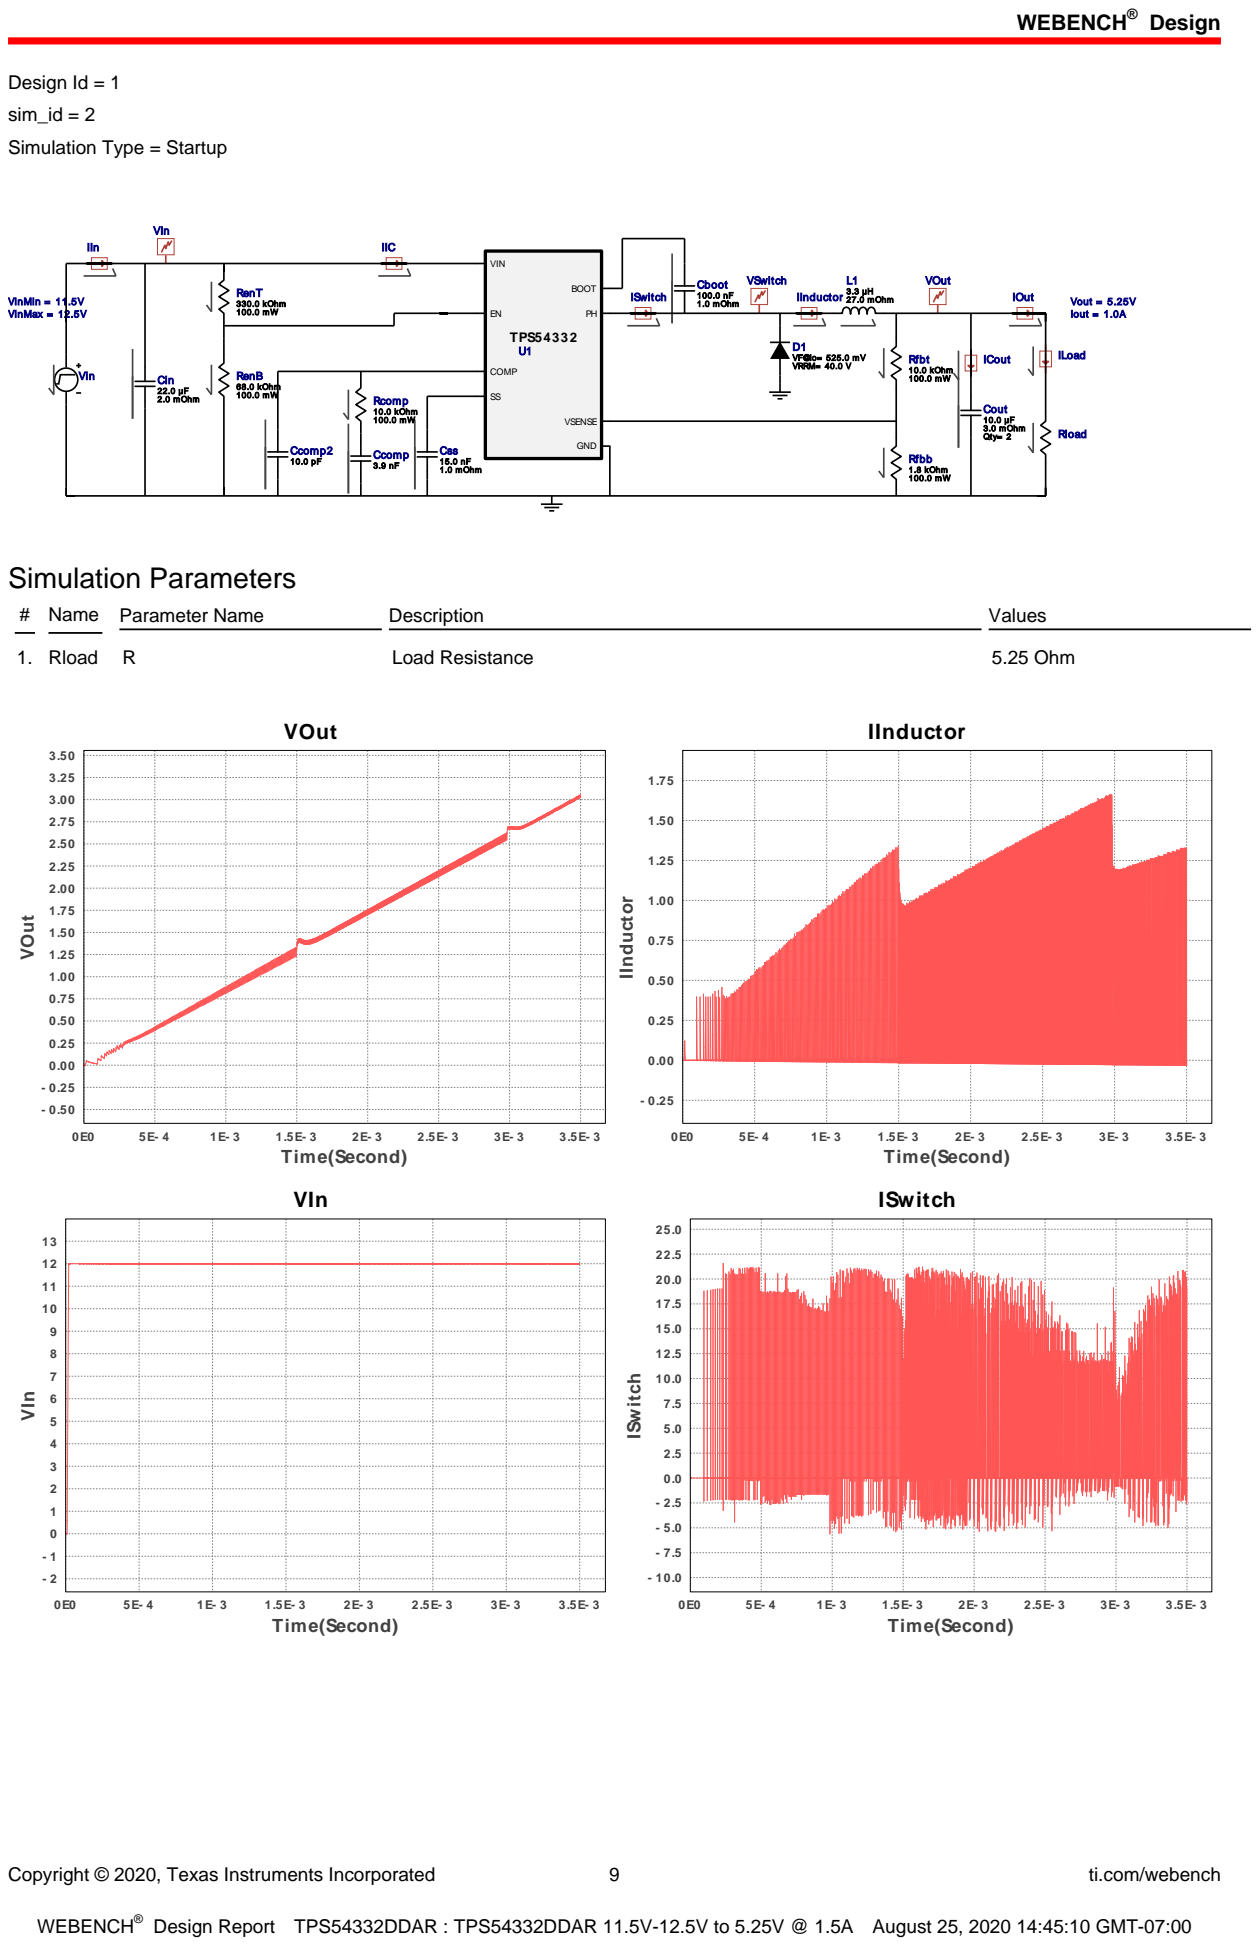
[picture p129: page 9]
Copyright © 2020, Texas Instruments Incorporated; ti.com/webench; Css 15.0 nF 1.0 mOhm; VinMin = 11.5V VinMax = 12.5V; VIn; ISwitch; VSwitch; ICout; Ccomp2 10.0 pF; TPS54332; BOOT; VIN; VSENSE; COMP; GND; Rfbb 1.8 kOhm 100.0 mW; RenB 68.0 kOhm 100.0 mW; RenT 330.0 kOhm 100.0 mW; Cboot 100.0 nF; 1.0 mOhm; IInductor; IIC; Cin 22.0 µF 2.0 mOhm; L1 3.3 µH 27.0 mOhm; Rfbt 10.0 kOhm 100.0 mW; IOut; Cout 10.0 µF 3.0 mOhm Qty= 2; IIn; D1 VF@Io= 525.0 mV VRRM= 40.0 V; Ccomp 3.9 nF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

Design Id = 1
sim_id = 2
Simulation Type = Startup

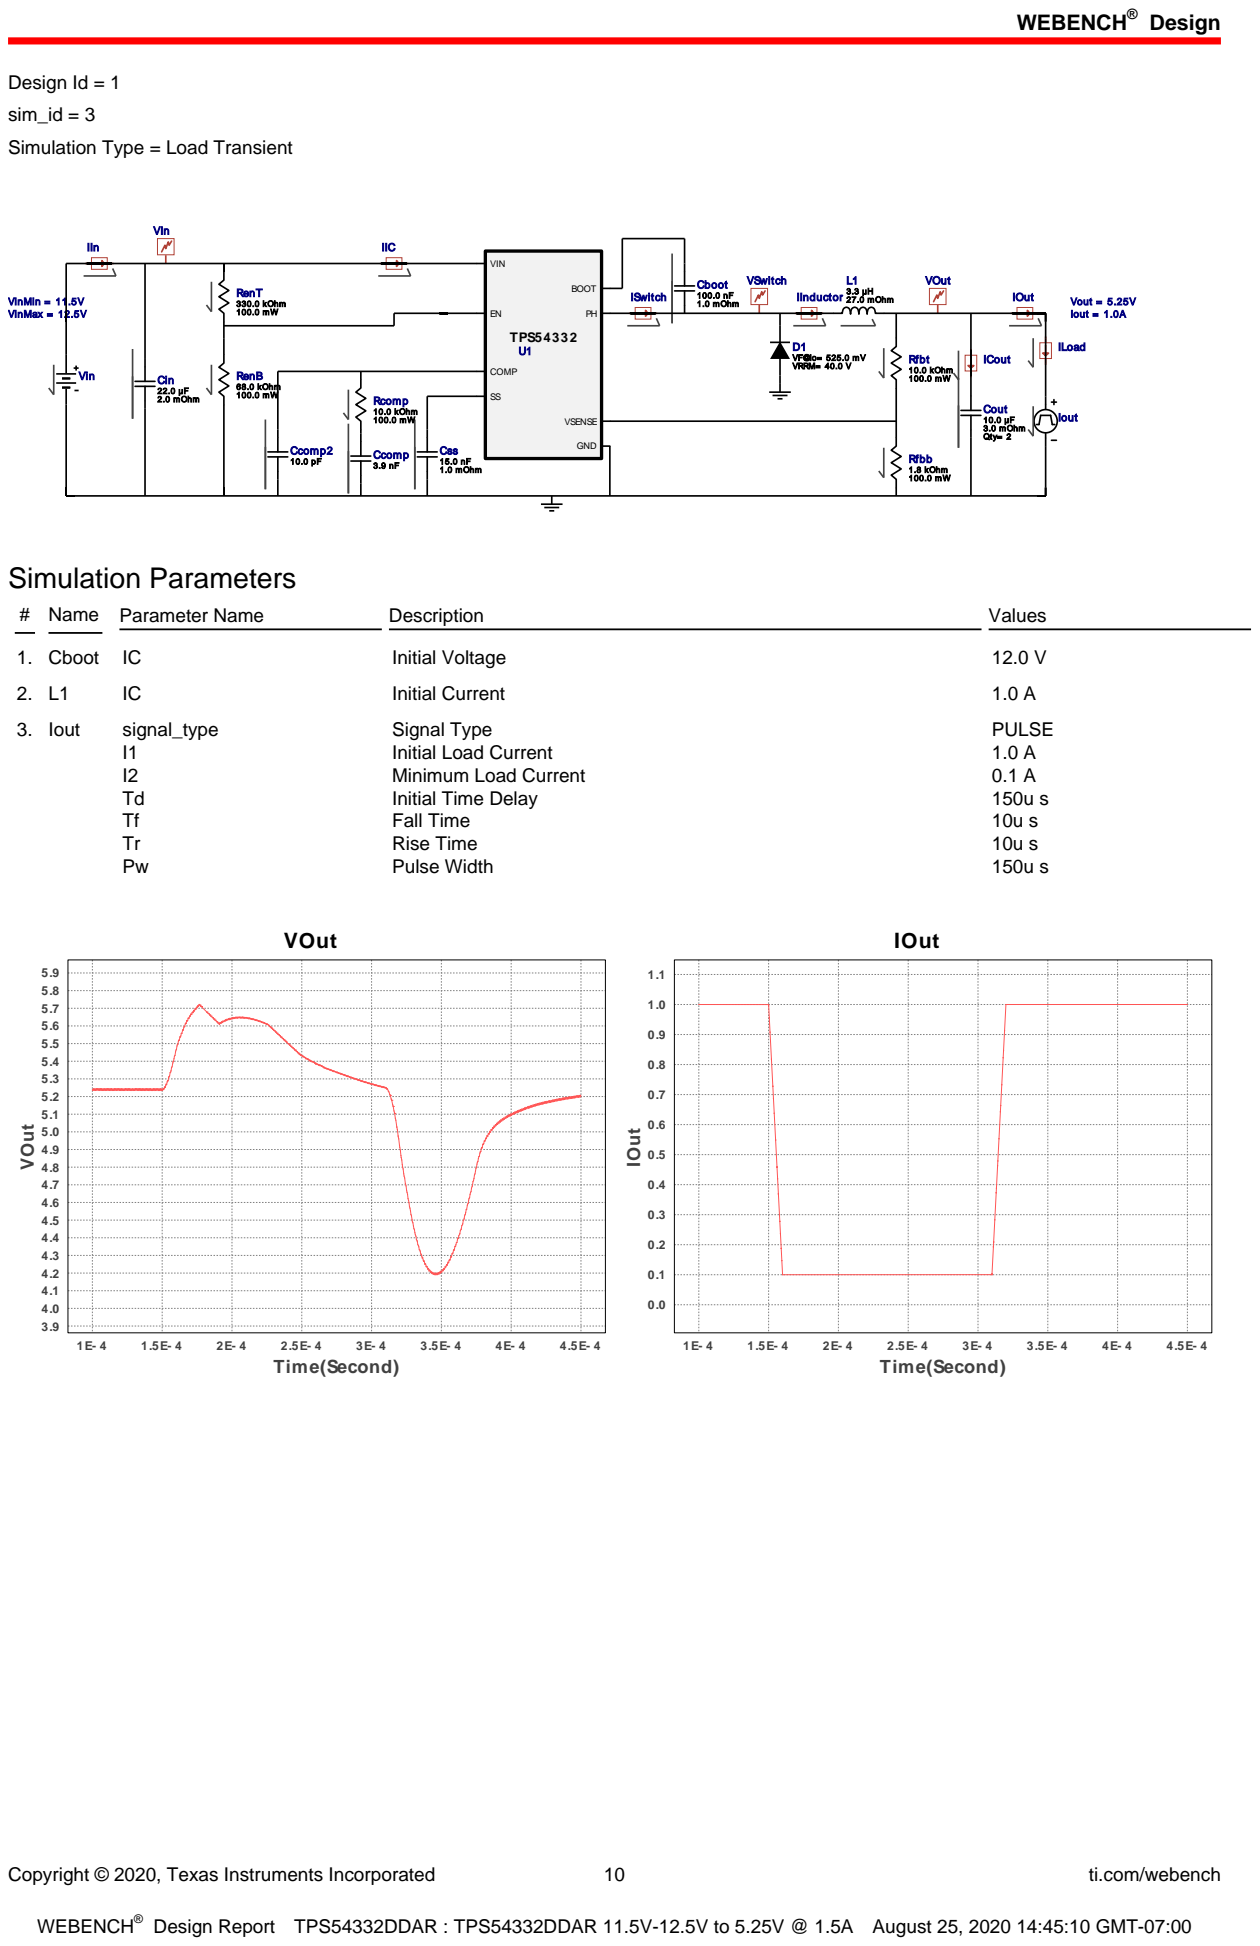
[picture p130: page 10]
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

Design Id = 1
sim_id = 3
Simulation Type = Load Transient

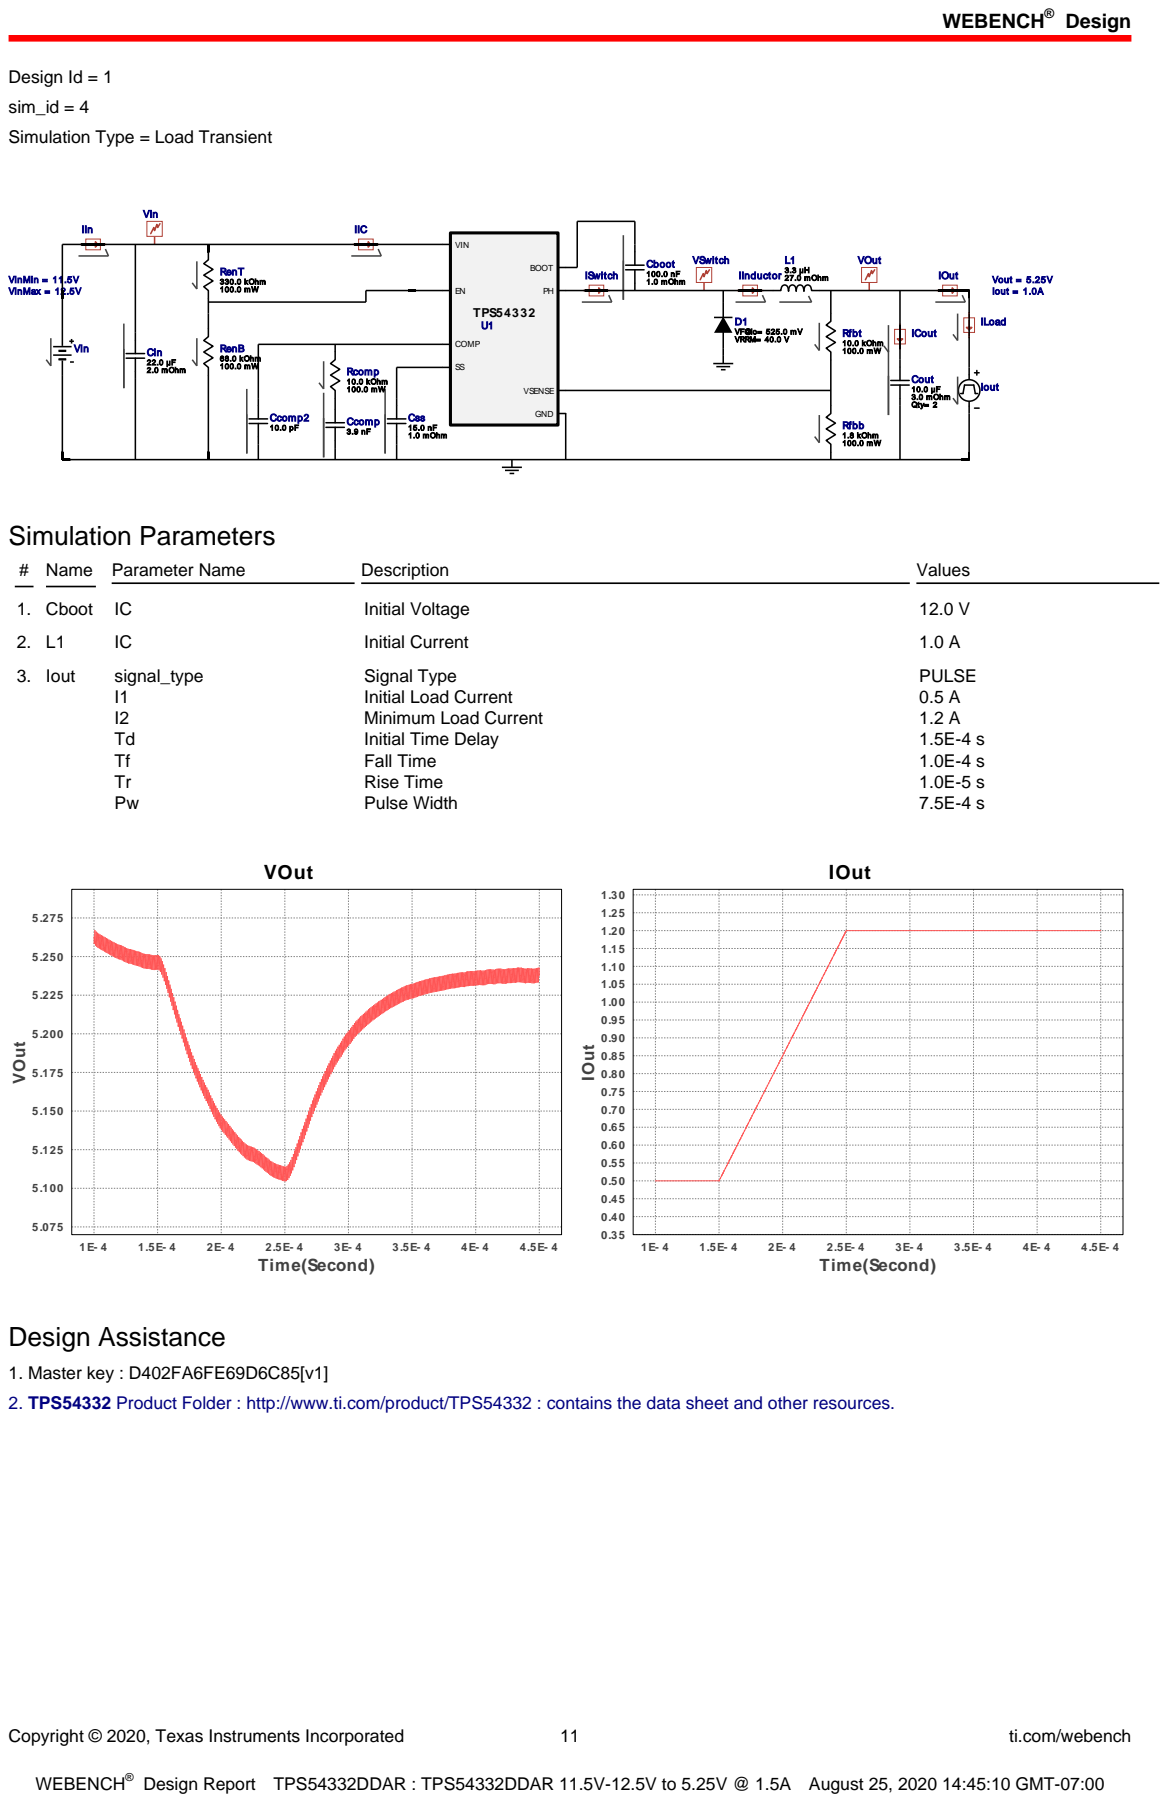
[picture p131: page 11]
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

Design Id = 1
sim_id = 4
Simulation Type = Load Transient

1. Master key : D402FA6FE69D6C85[v1]
2. TPS54332 Product Folder : http://www.ti.com/product/TPS54332 : contains the data sheet and other resources.

Copyright © 2020, Texas Instruments Incorporated | 12 | ti.com/webench

Important Notice and Disclaimer

TI provides technical and reliability data (including datasheets), design resources (including reference designs), application or other design advice, web tools, safety information, and other resources AS IS and with all faults, and disclaims all warranties. These resources are intended for skilled developers designing with TI products. You are solely responsible for (1) selecting the appropriate TI products for your application, (2) designing, validating and testing your application, and (3) ensuring your application meets applicable standards, and any other safety, security, or other requirements.

These resources are subject to change without notice. TI grants you permission to use these resources only for development of an application that uses the TI products described in the resource. Other reproduction and display of these resources is prohibited. No license is granted to any other TI intellectual property right or to any third party intellectual property right. TI disclaims responsibility for, and you will fully indemnify TI and its representatives against, any claims, damages, costs, losses, and liabilities arising out of your use of these resources.

Providing these resources does not expand or otherwise alter TI's applicable Terms of Sale or other applicable terms available either on ti.com or provided in conjunction with TI products.
