mjohansson/SolderingStation/doc/chassis_fan-optional/4pin_fan_connectors/molex_470531000/47053-1000.pdf

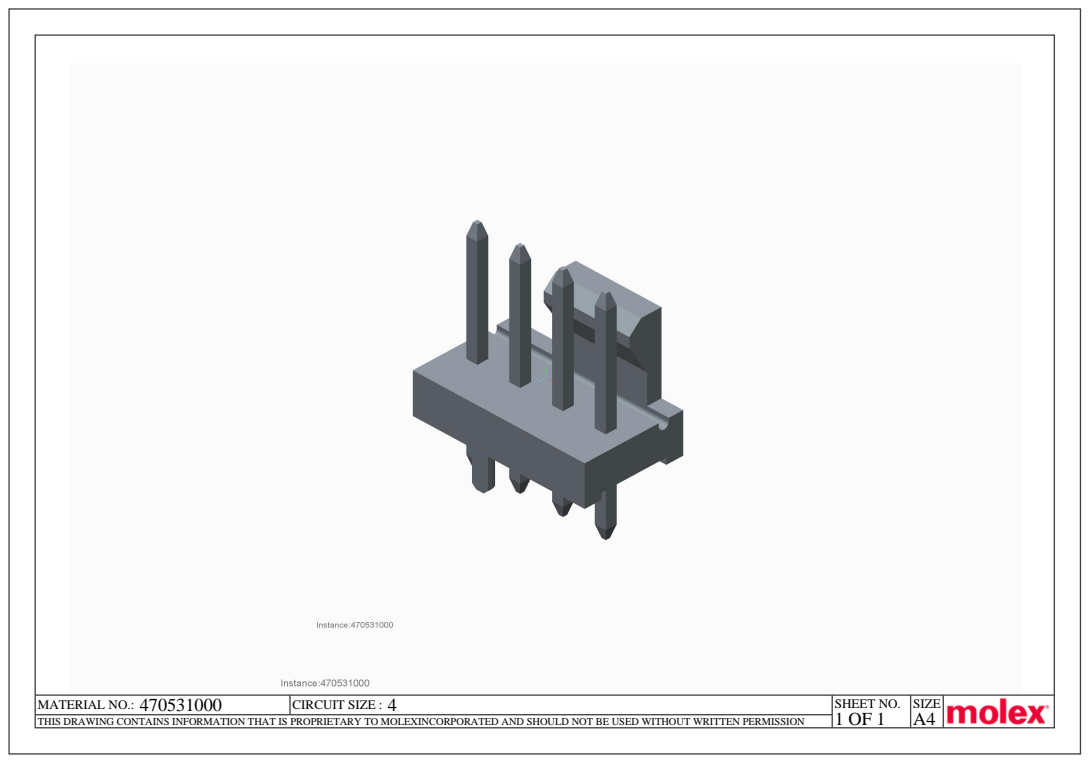
[picture p132: page 1]
MATERIAL NO.: 470531000; CIRCUIT SIZE : 4; SHEET NO.; SIZE

THIS DRAWING CONTAINS INFORMATION THAT IS PROPRIETARY TO MOLEXINCORPORATED AND SHOULD NOT BE USED WITHOUT WRITTEN PERMISSION
