mjohansson/SolderingStation/hw/ss_frontpanel_inner_plate/ss_frontpanel_inner_plate-schematics.pdf

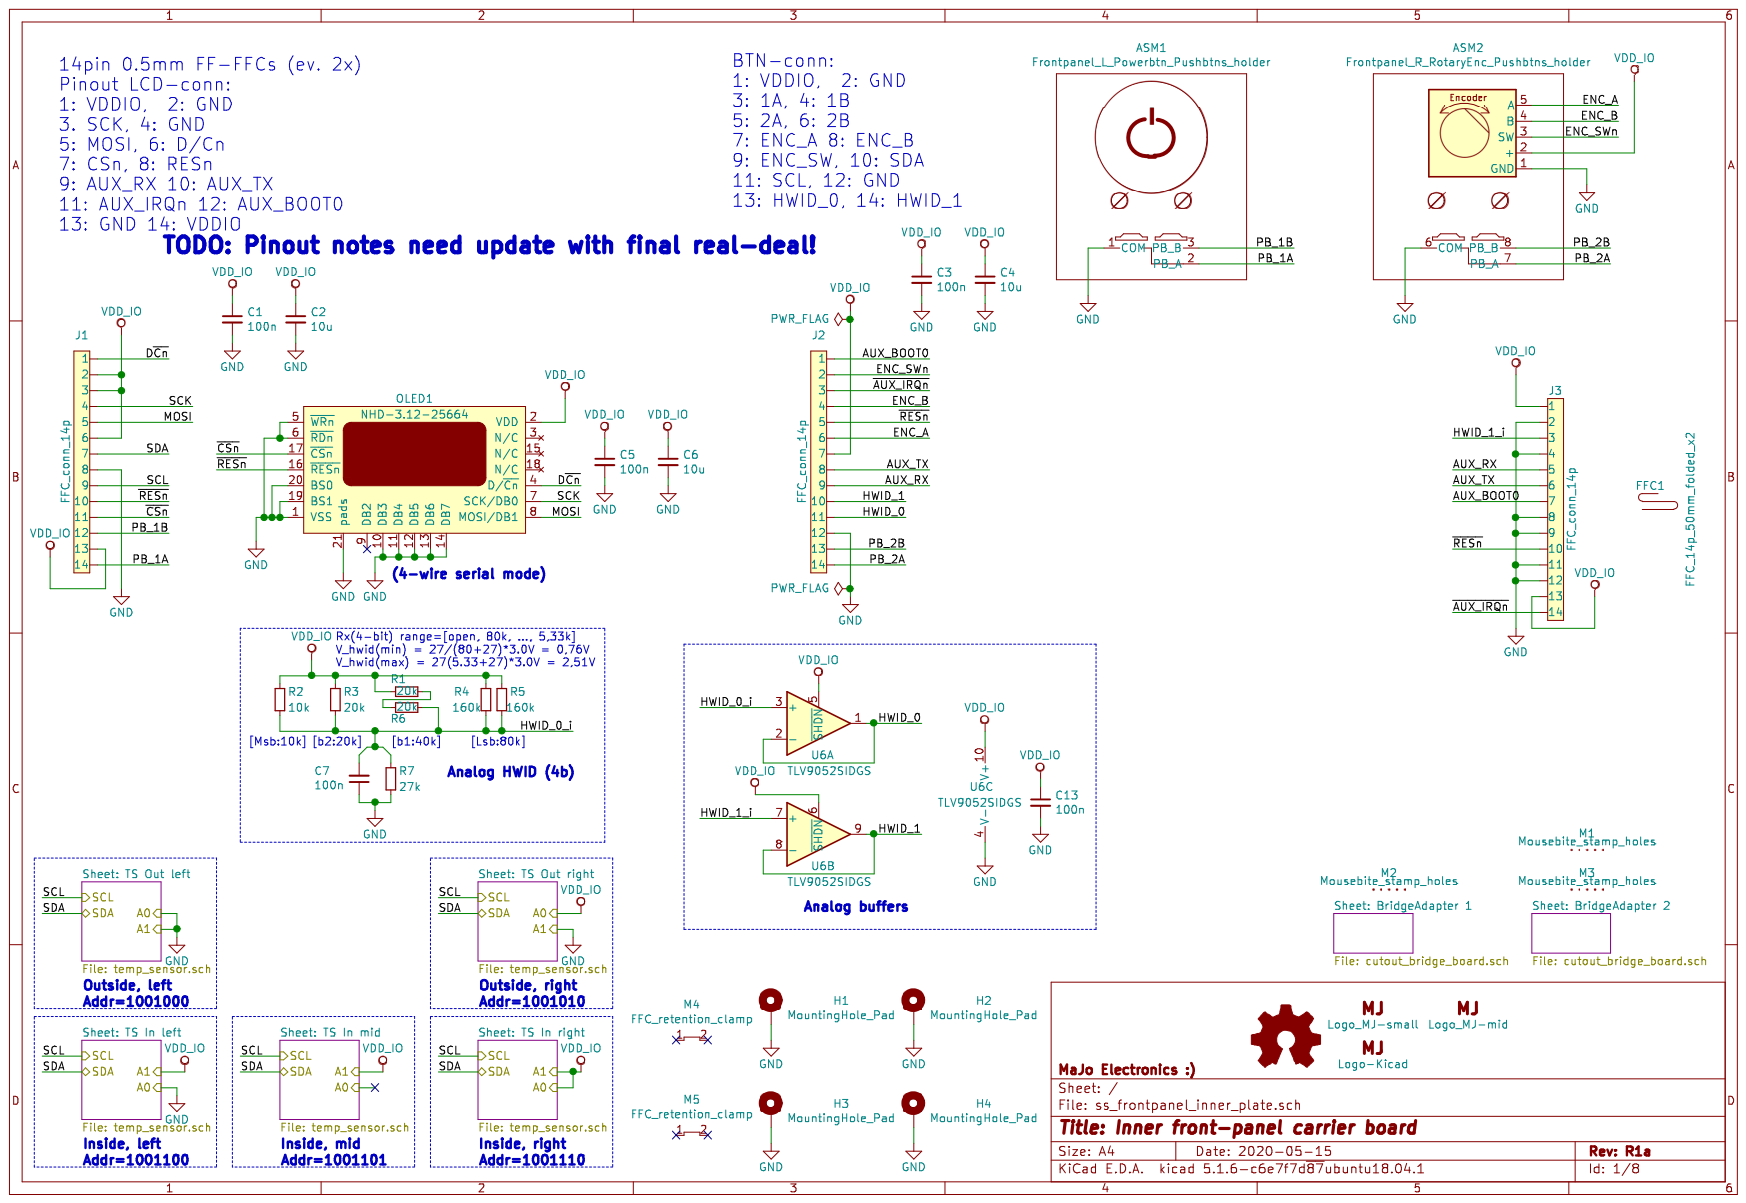
[picture p133: page 1]

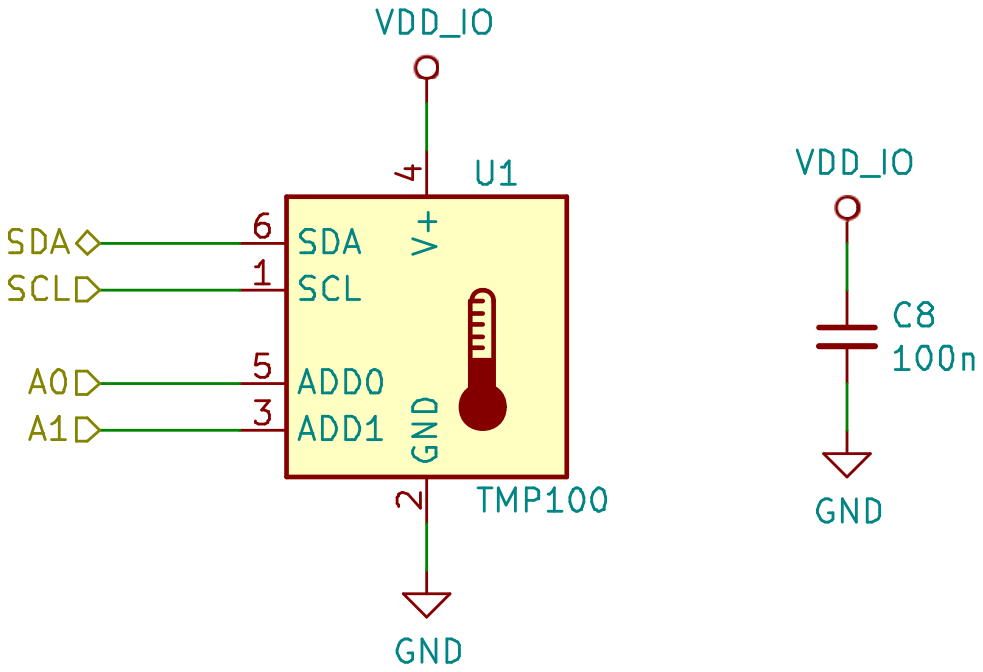
[picture p134: page 2]

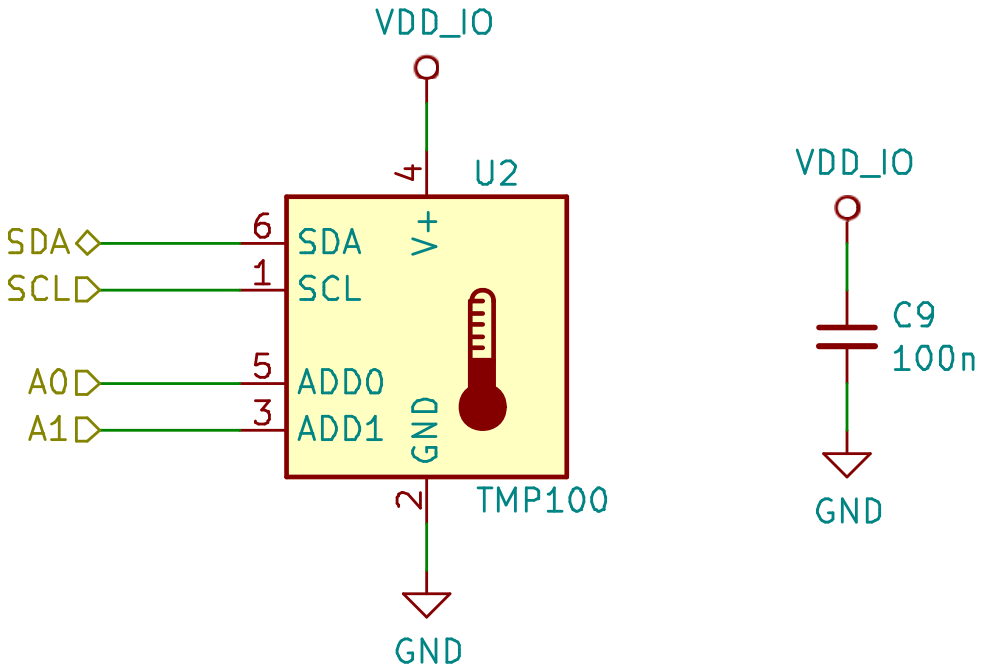
[picture p135: page 3]

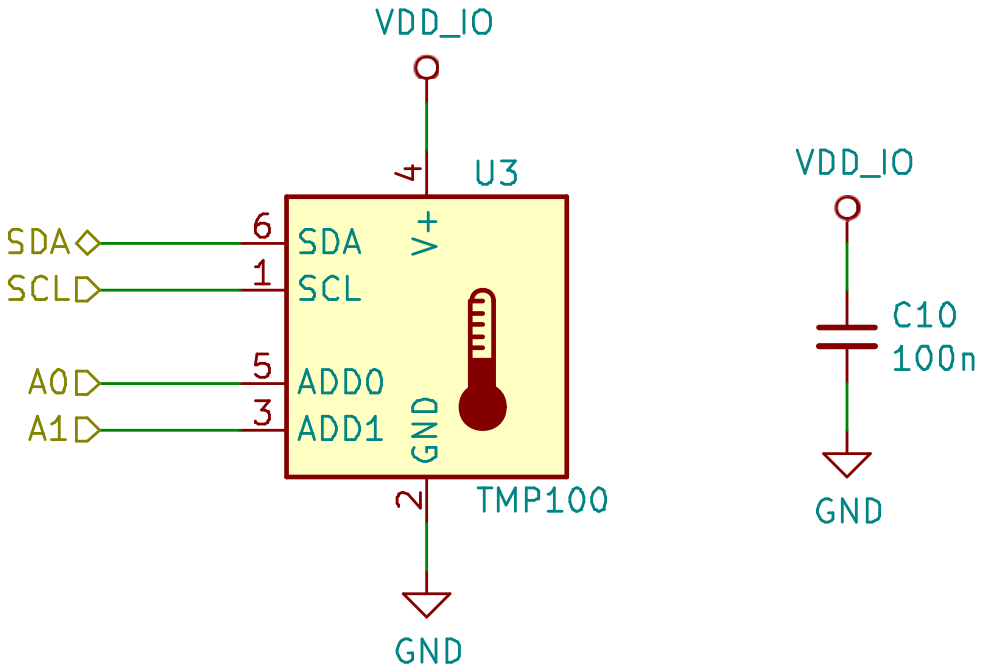
[picture p136: page 4]

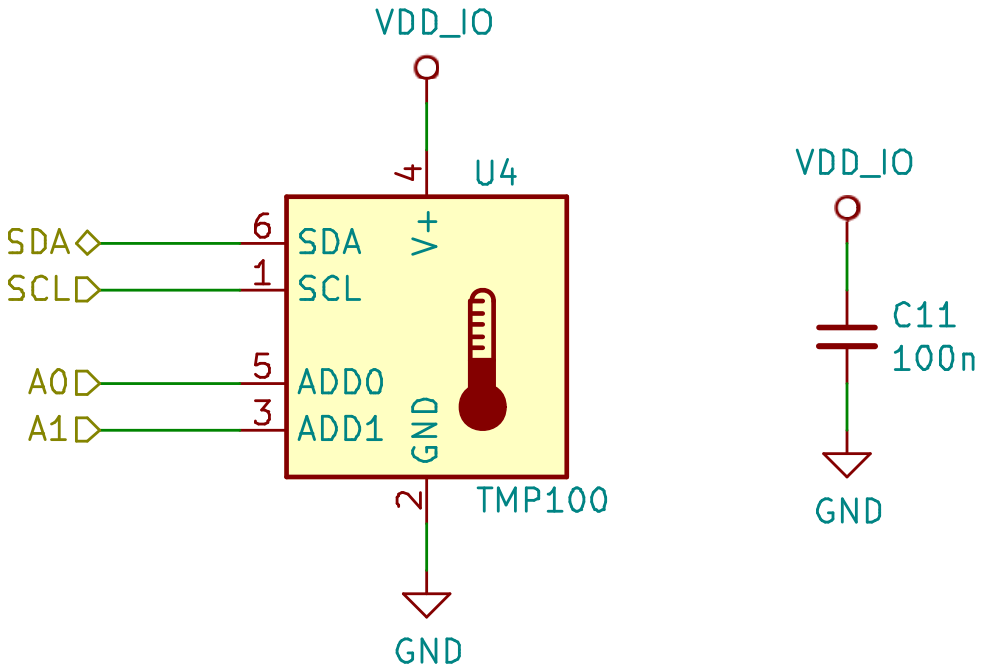
[picture p137: page 5]

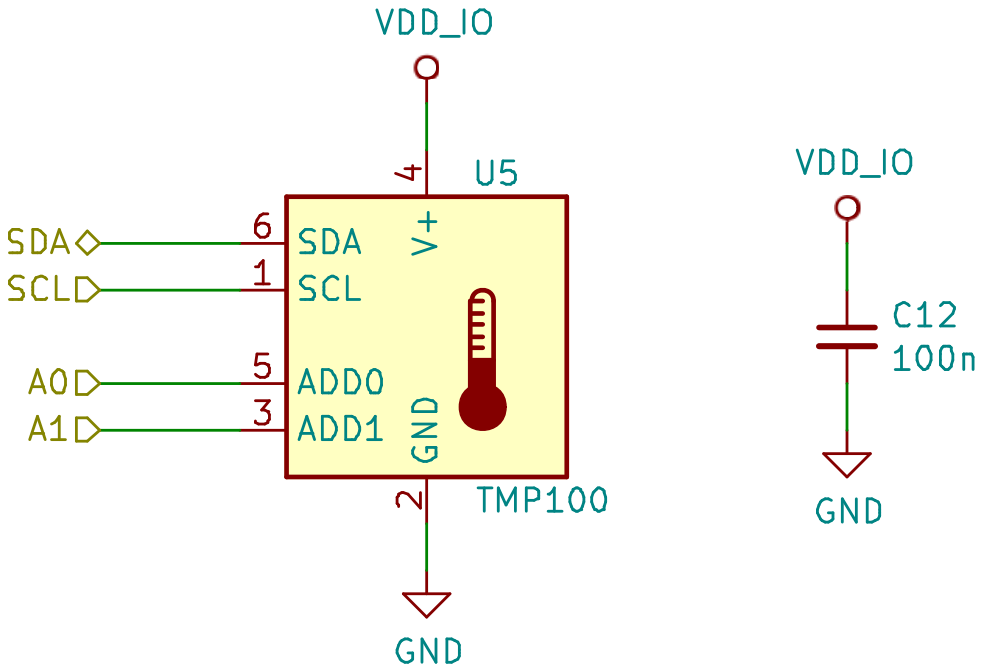
[picture p138: page 6]

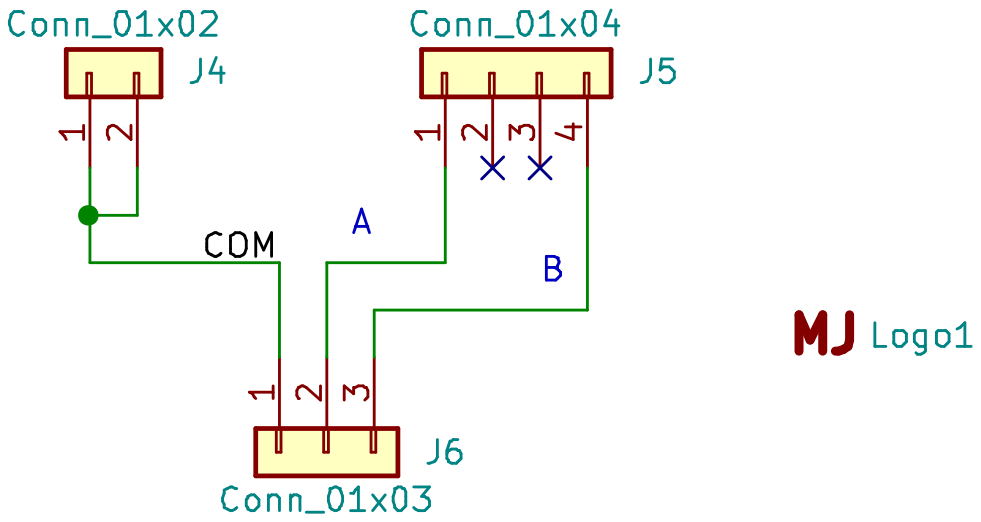
[picture p139: page 7]

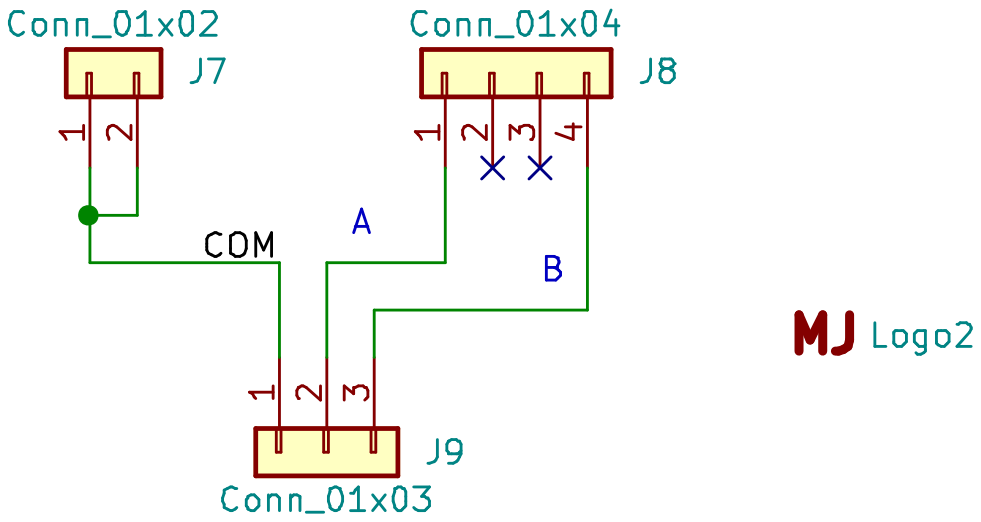
[picture p140: page 8]
