mjohansson/SolderingStation/doc/DC-in_connector/Molex_214756-1042-MicroFit_2x2_to_pigtail_cable_assemblies/2147561042_sd.pdf

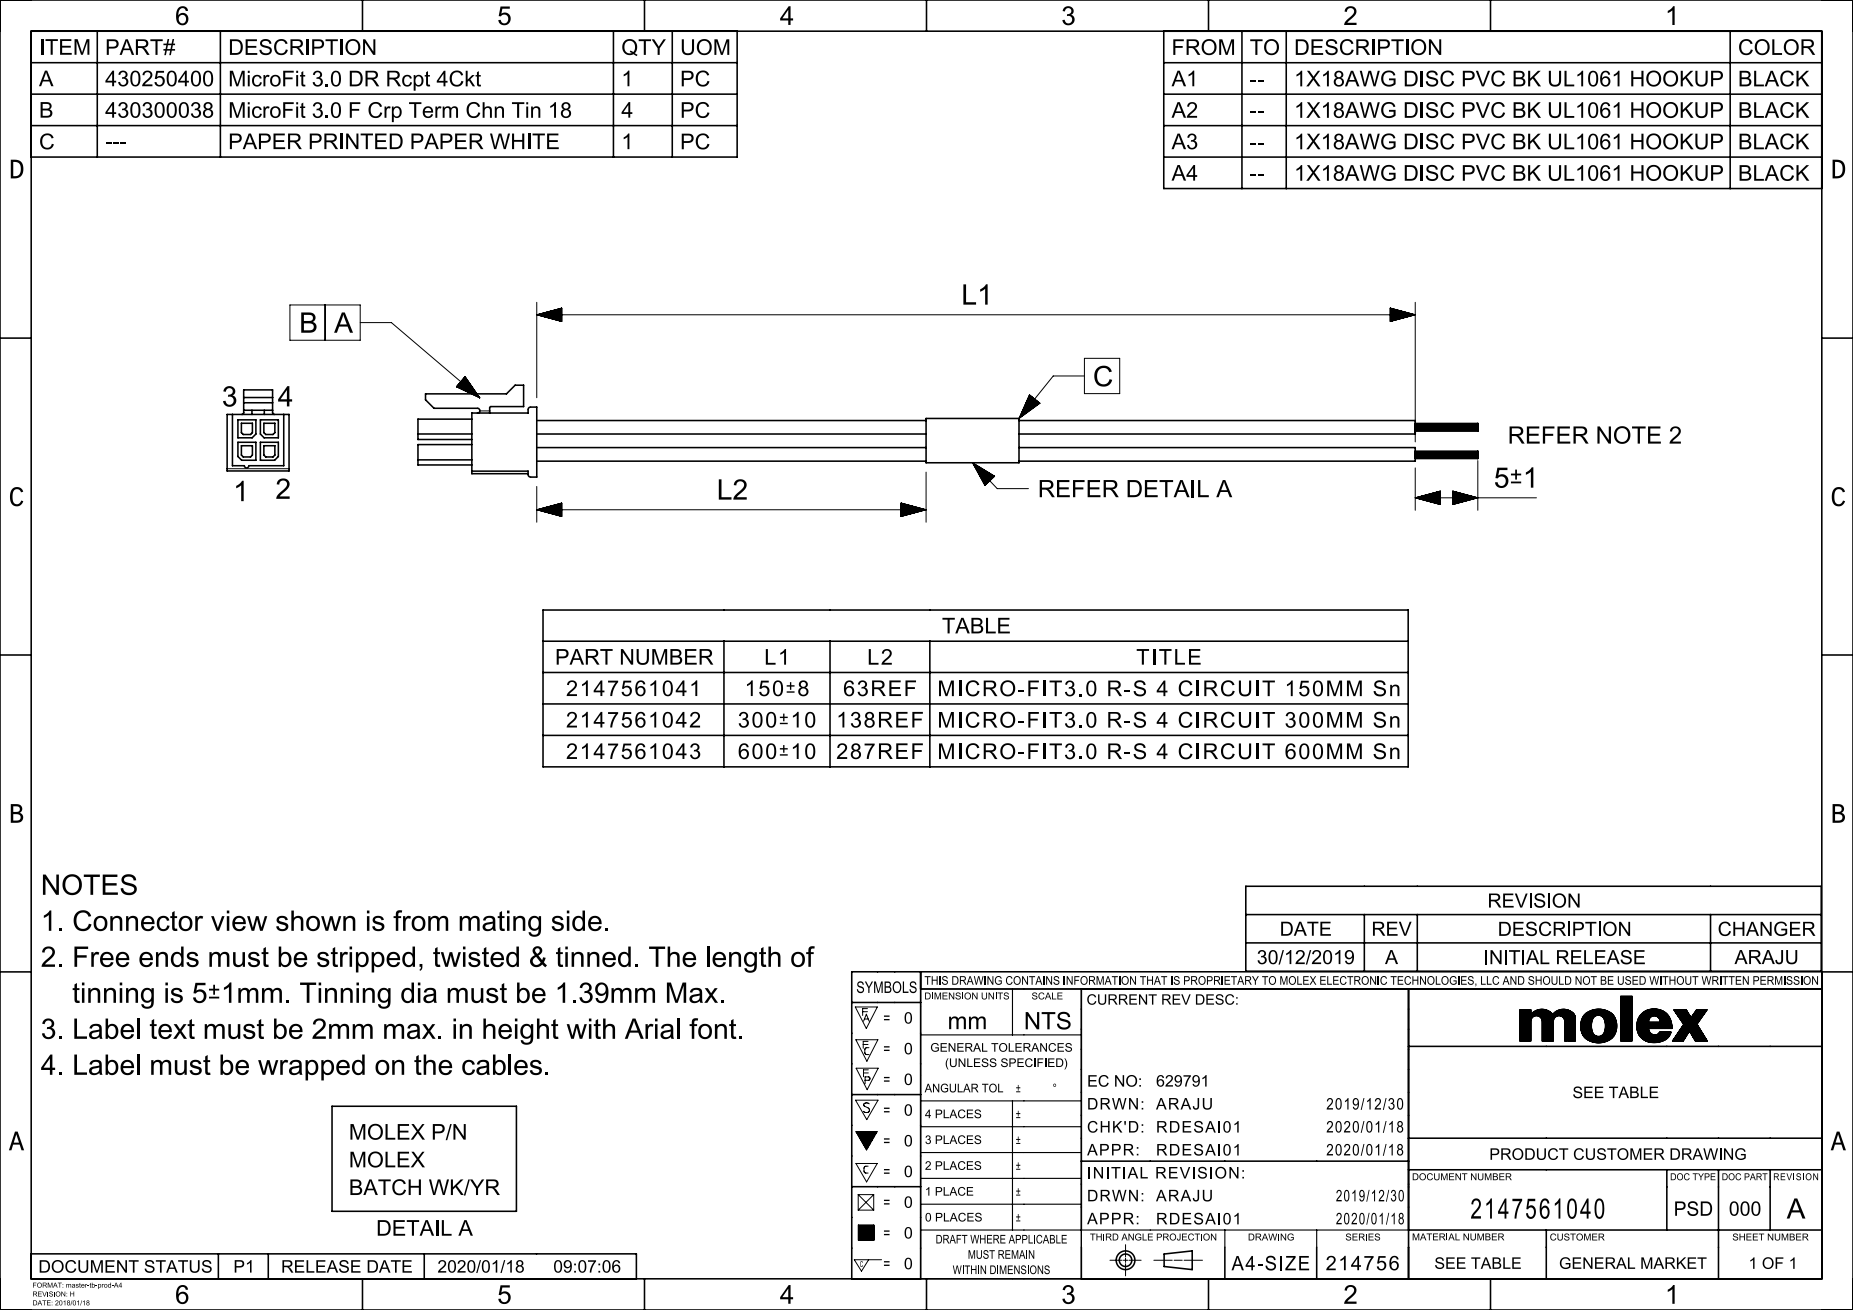
[picture p147: page 1]
