mjohansson/SolderingStation/doc/chassis_fan-optional/4pin_fan_connectors/molex_470531000/mating_cable_housing/008500114_sd.pdf

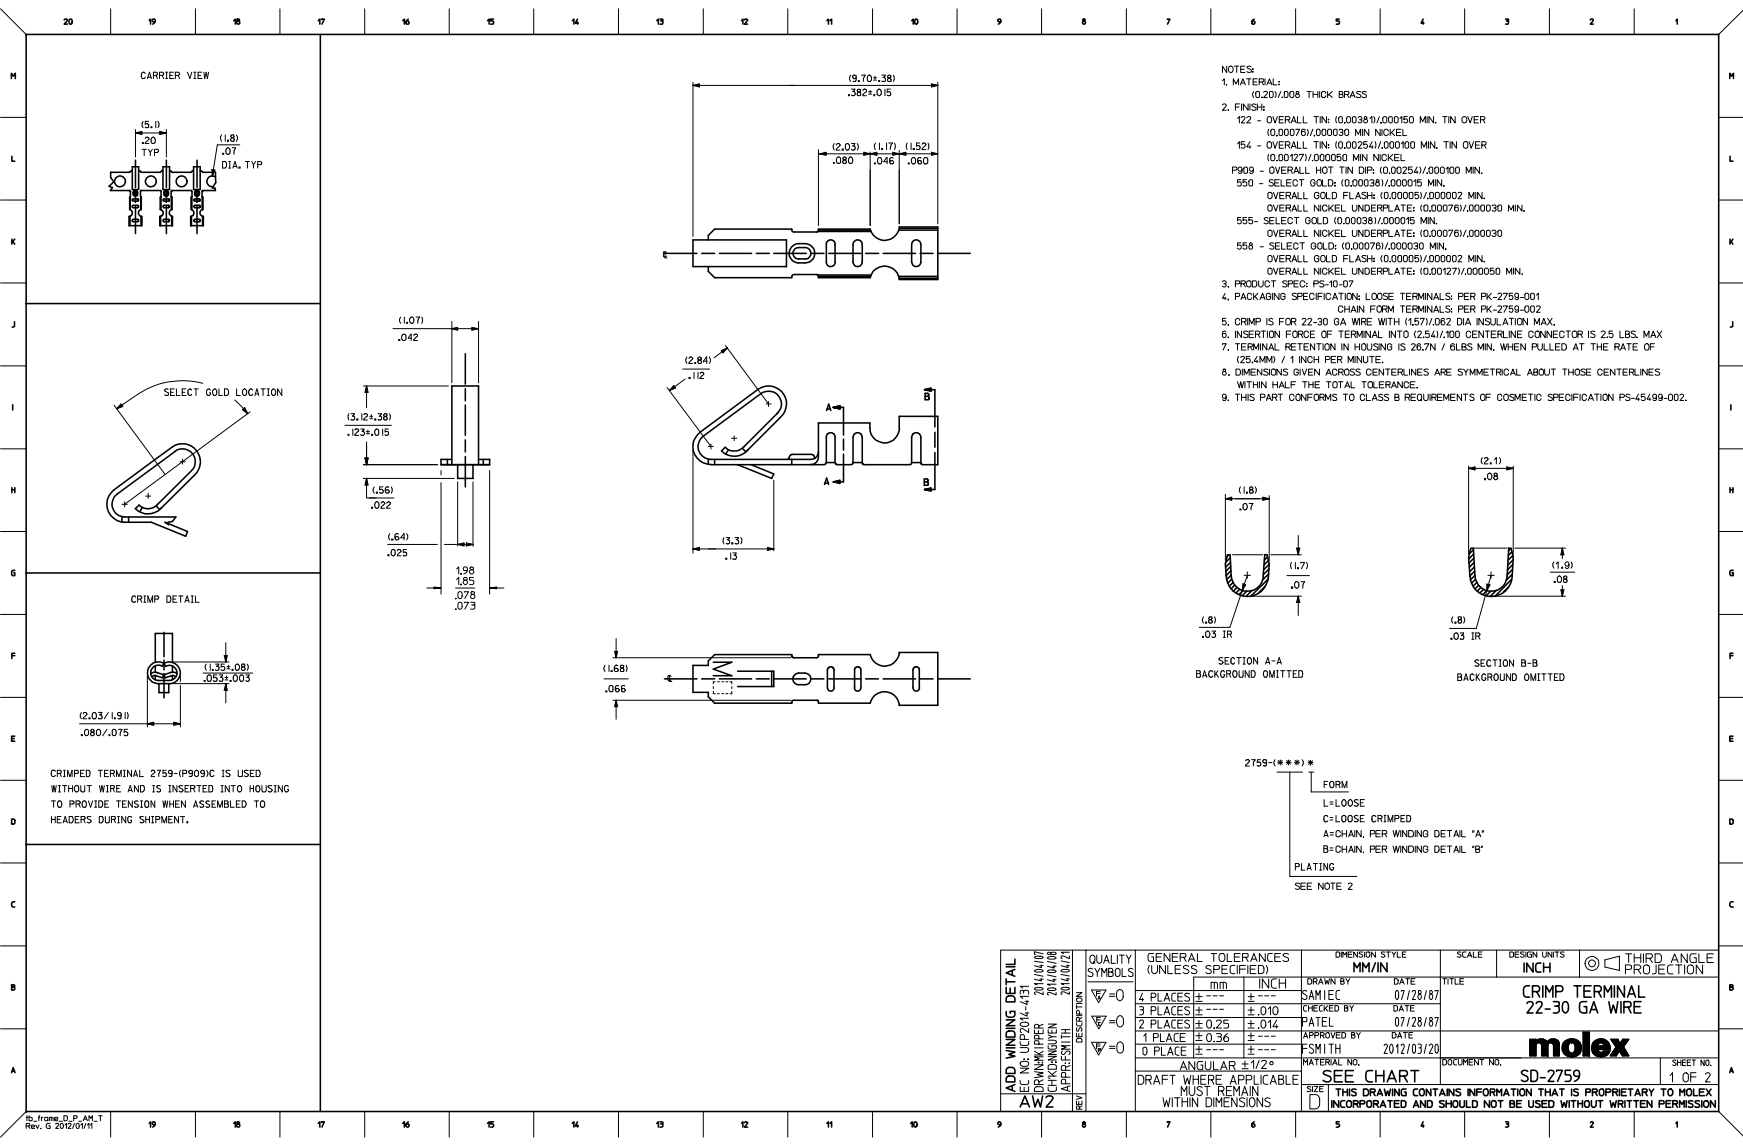
[picture p148: page 1]

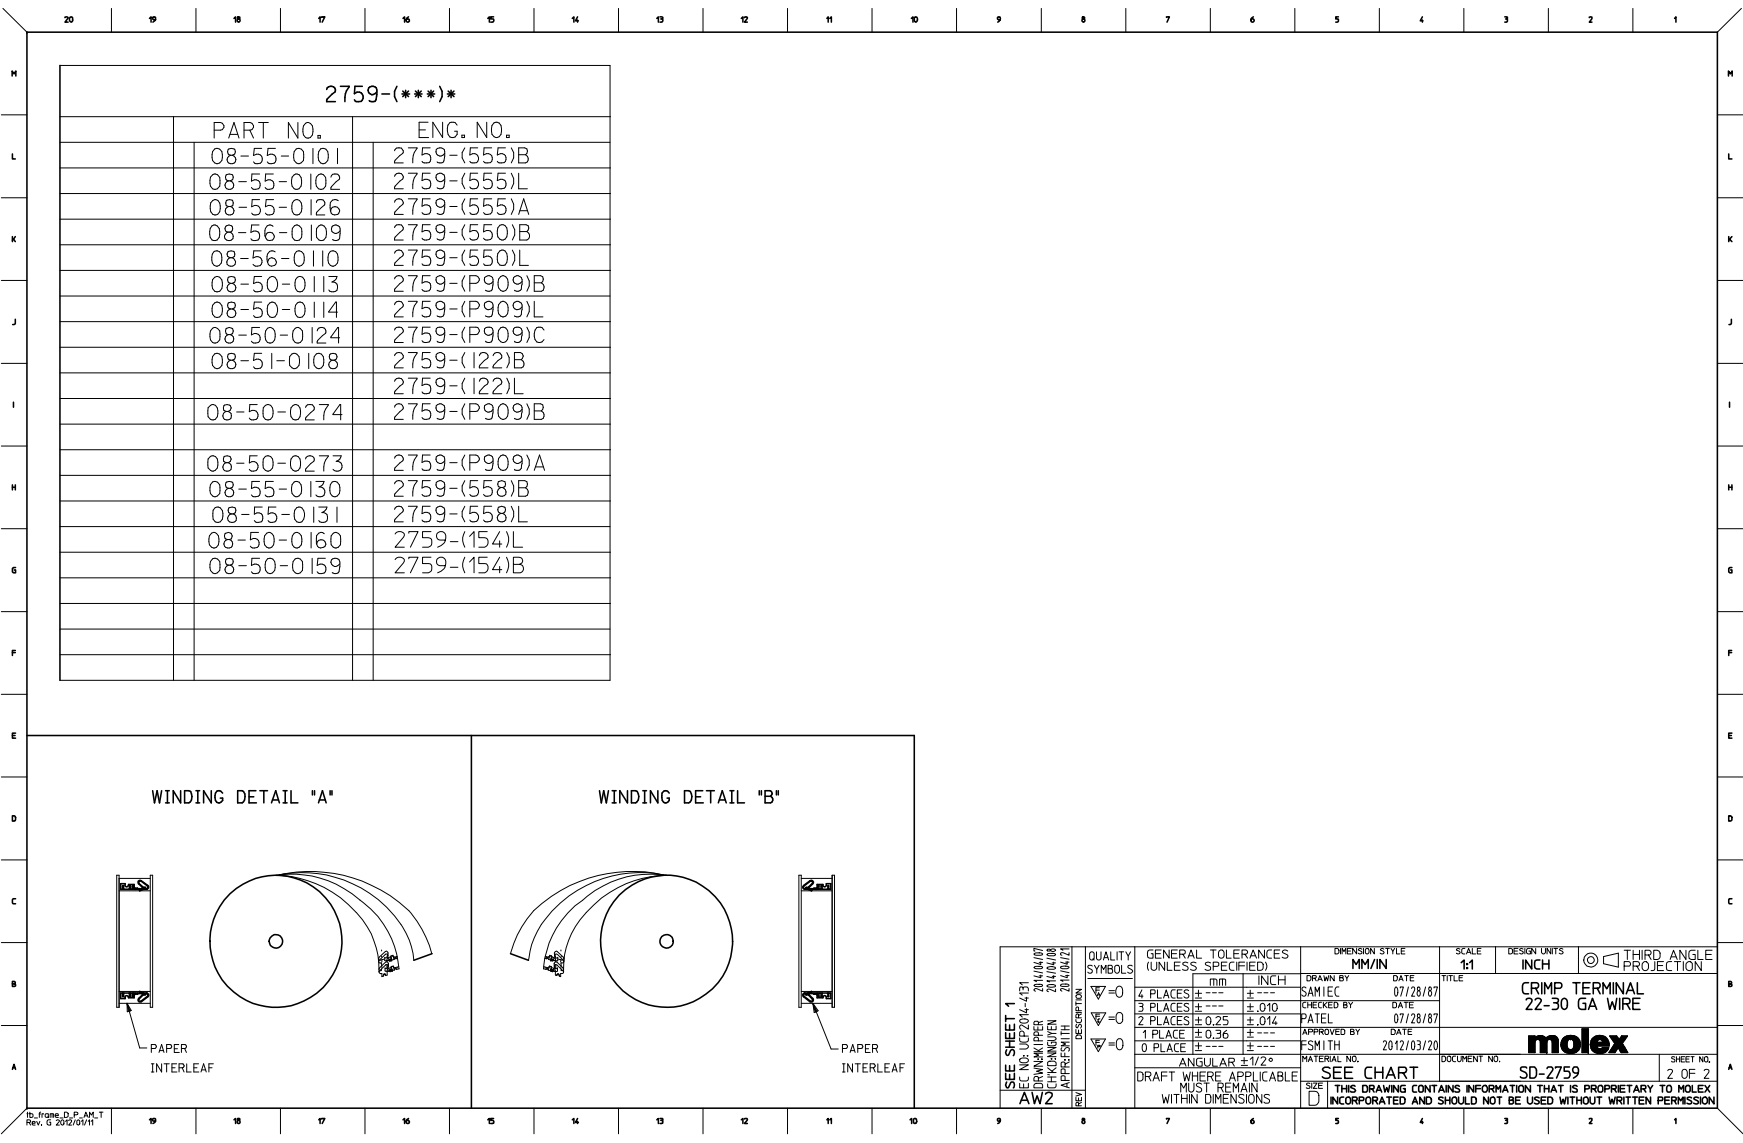
[picture p149: page 2]
