mjohansson/SolderingStation/doc/chassis_fan-optional/4pin_fan_connectors/molex_470531000/mating_cable_housing/470541000_sd.pdf

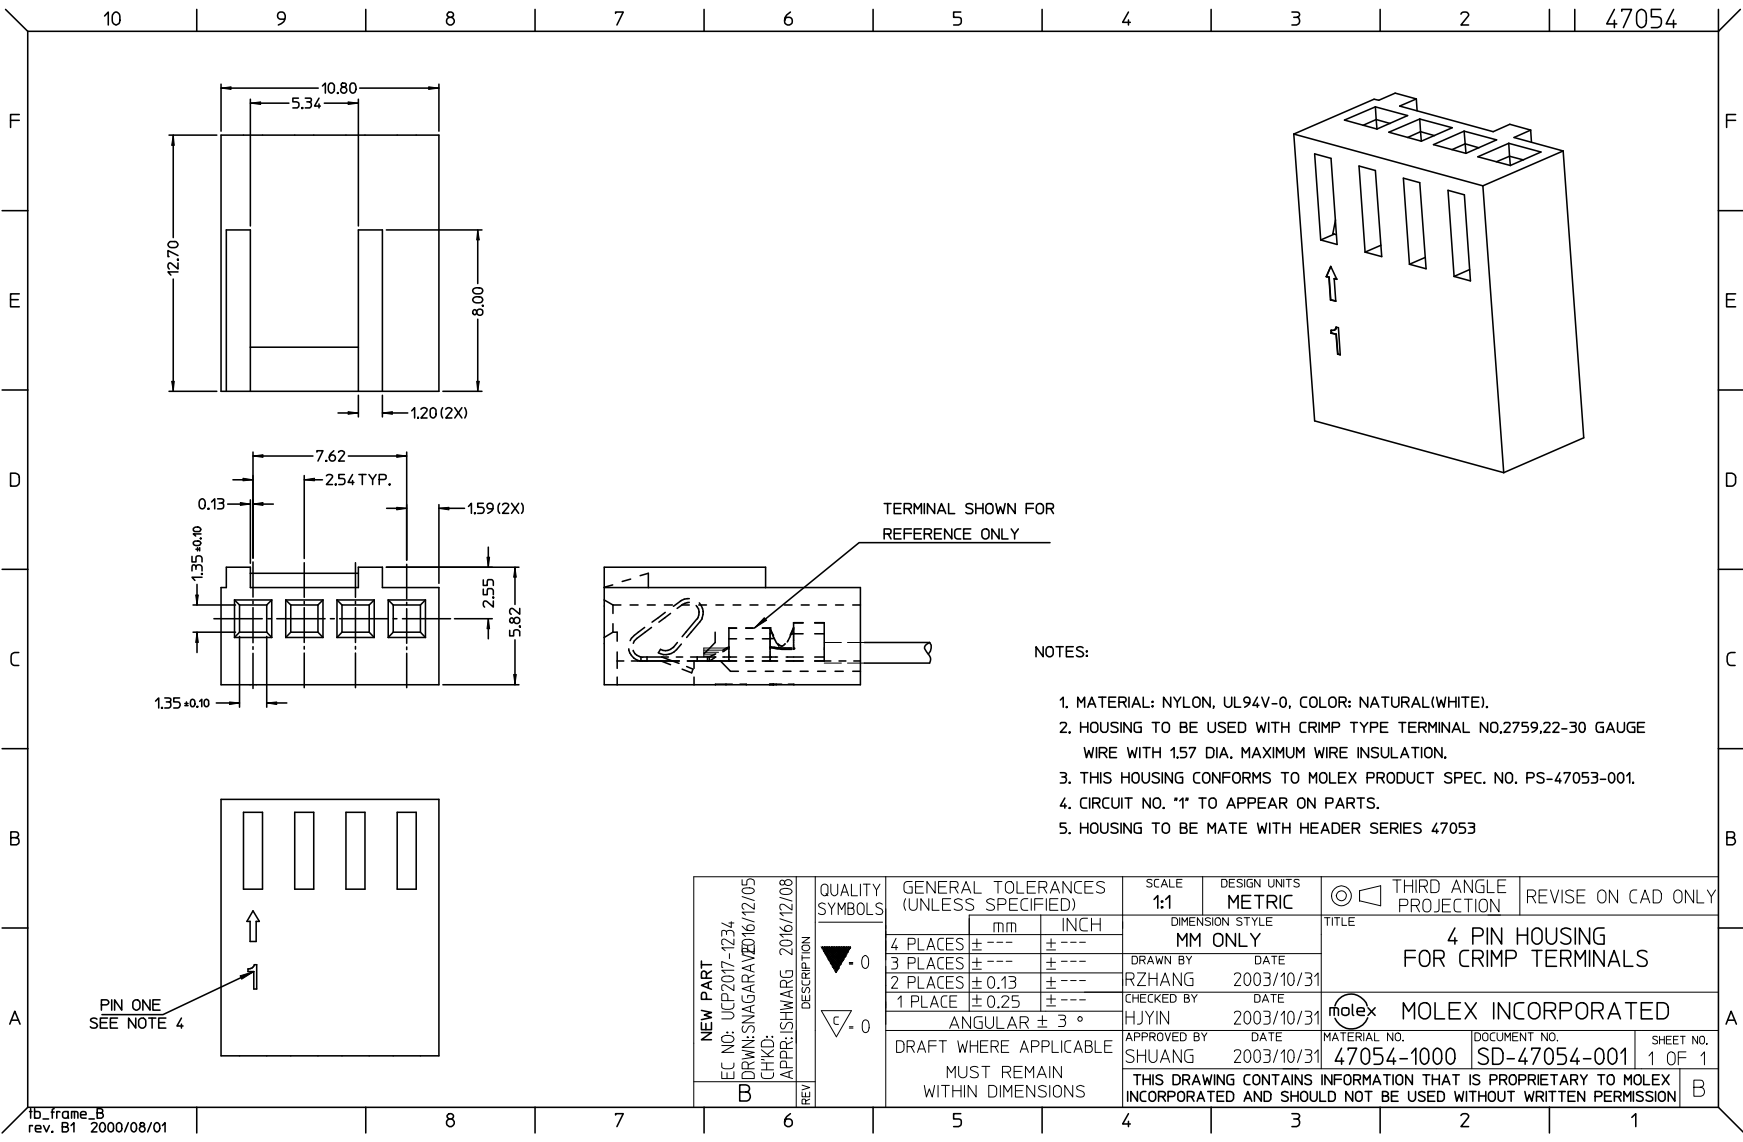
[picture p150: page 1]
