mjohansson/SolderingStation/hw/mainboard_wip_2020-08-25_WIP.pdf

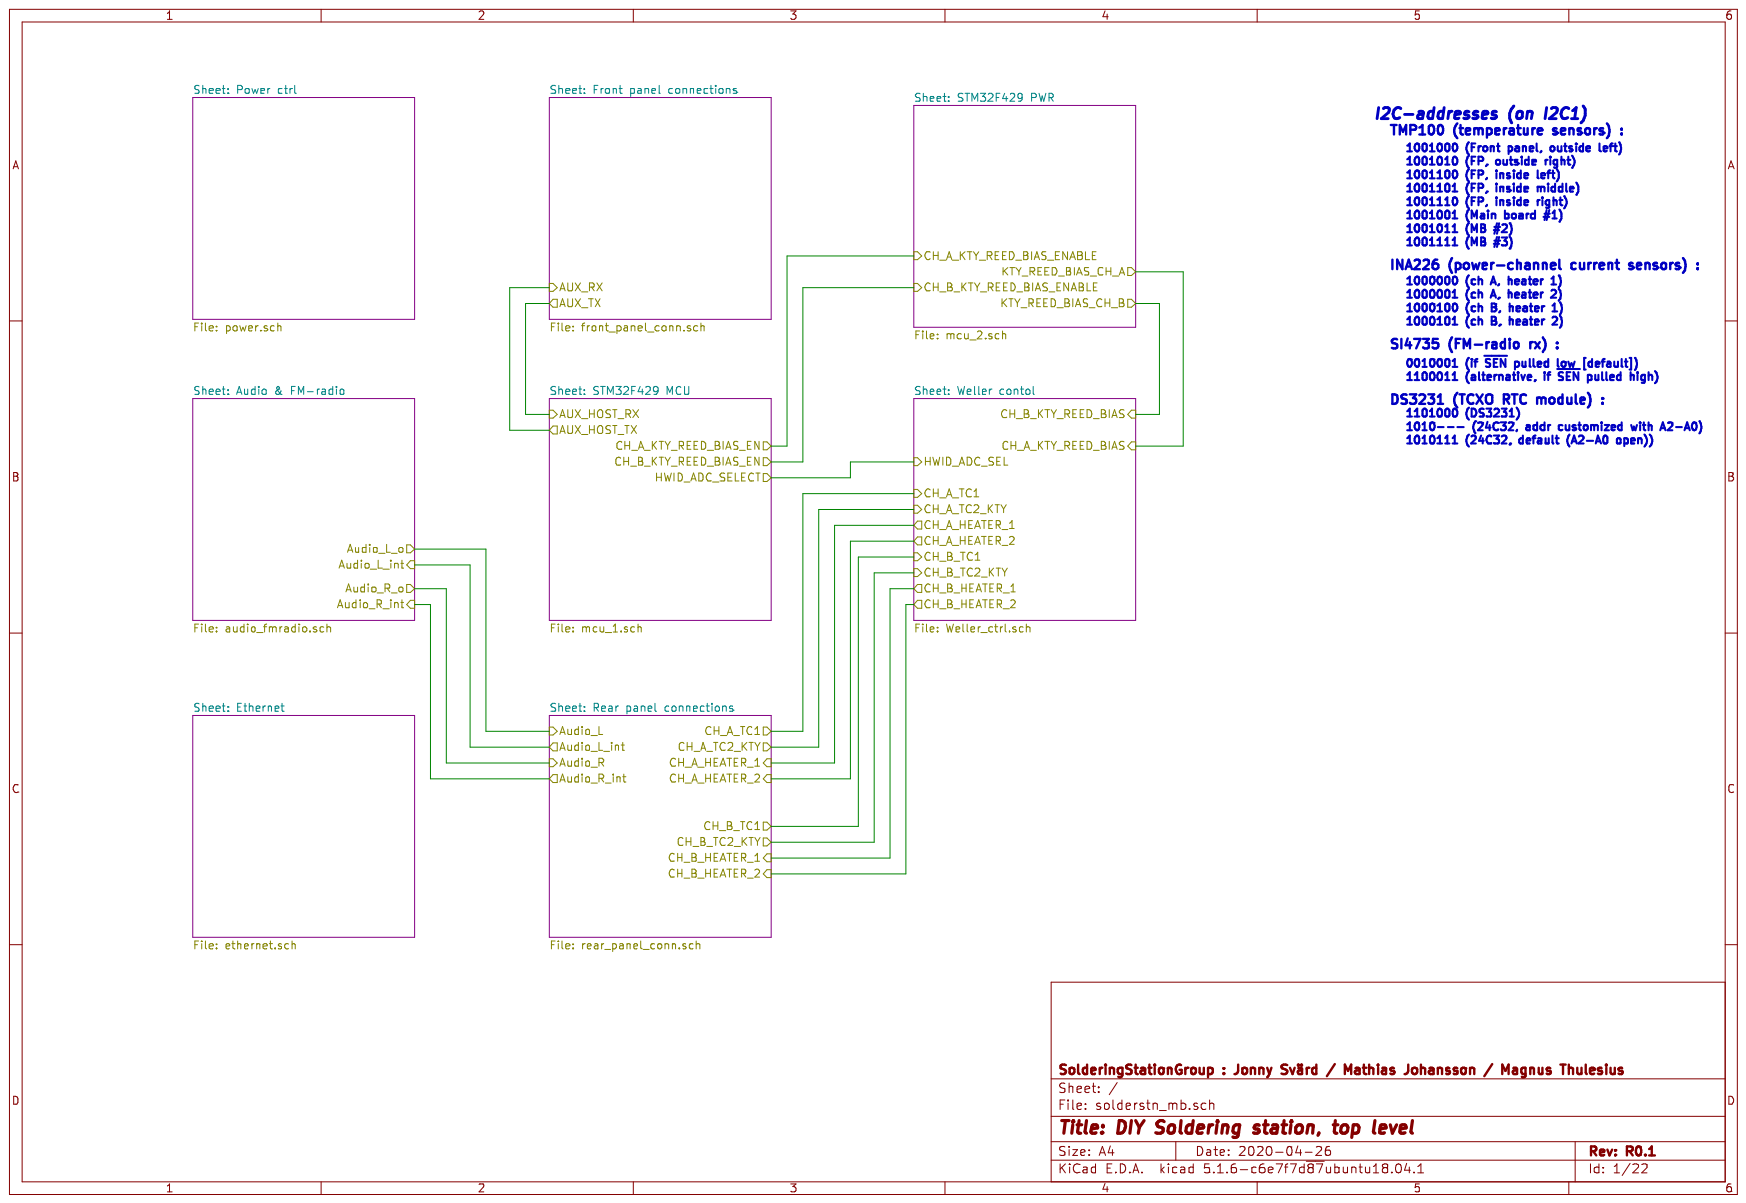
[picture p151: page 1]

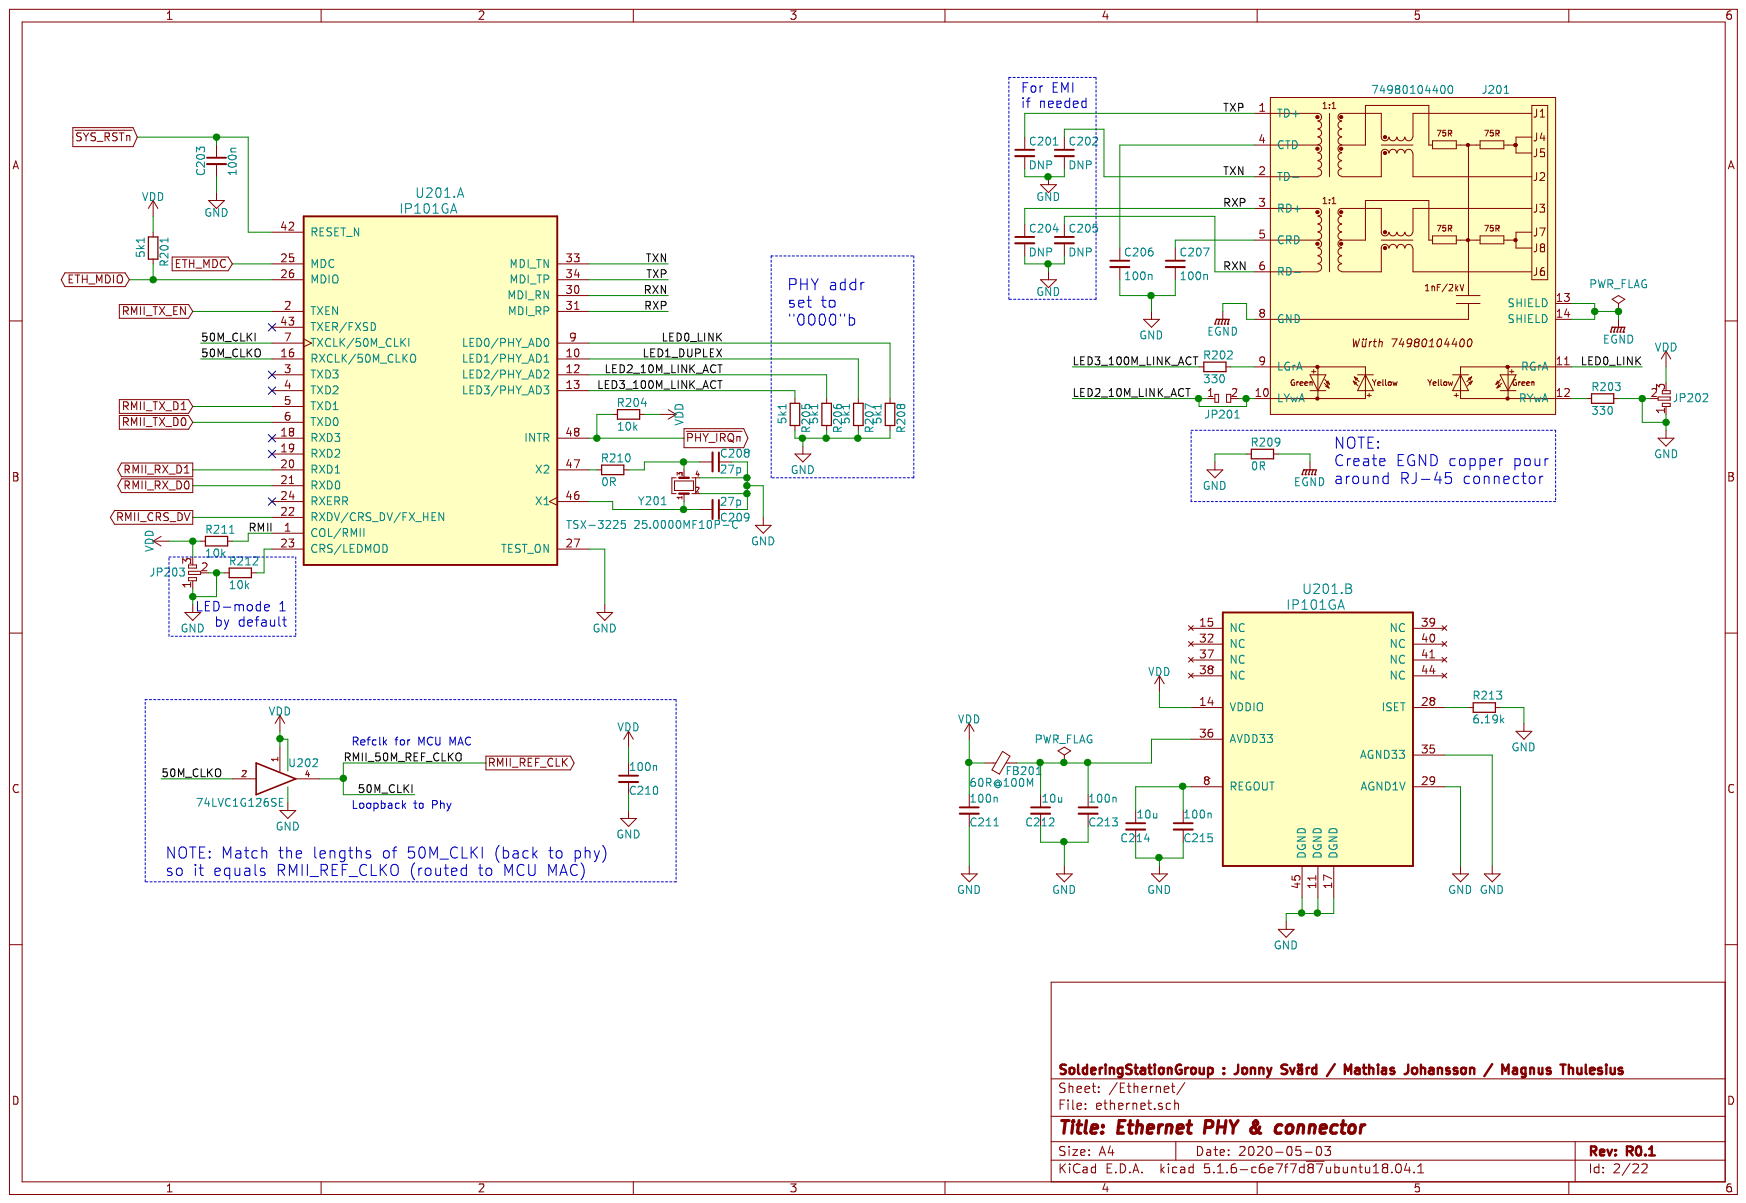
[picture p152: page 2]

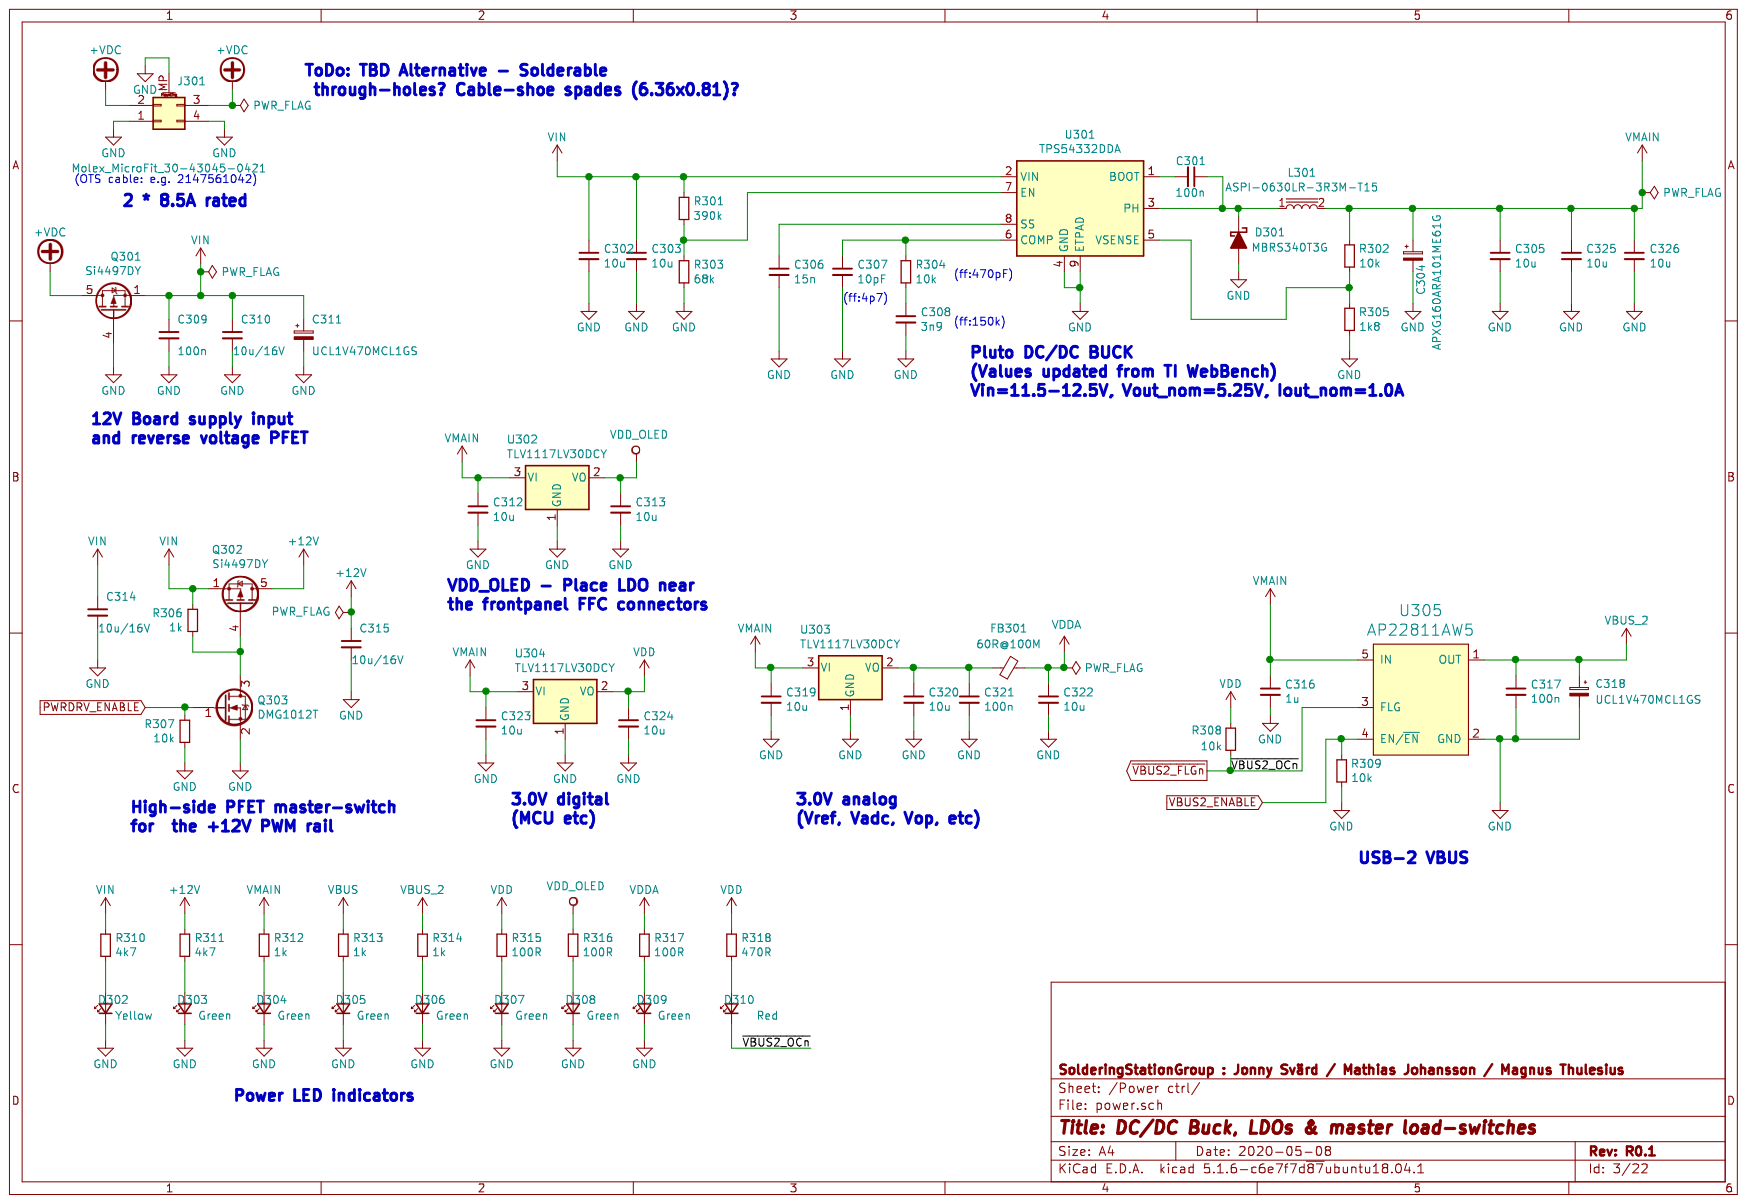
[picture p153: page 3]

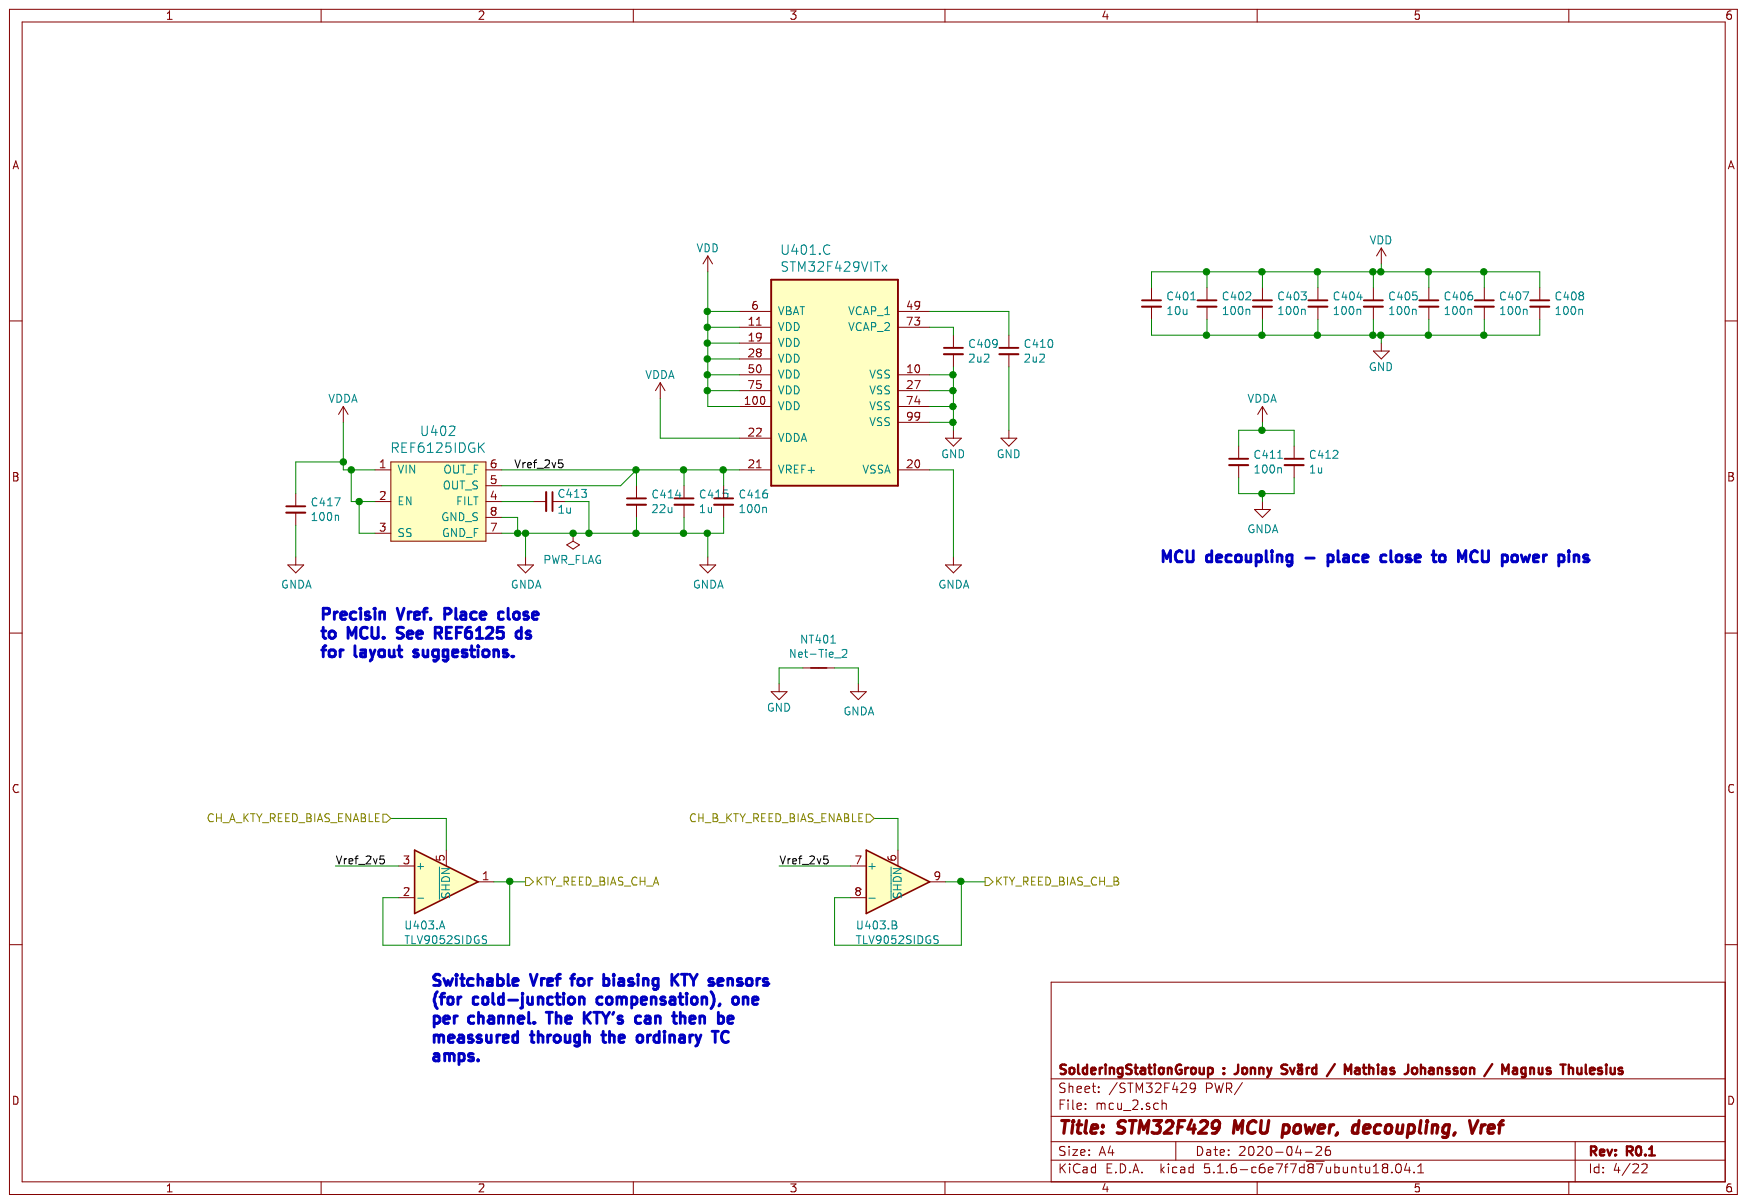
[picture p154: page 4]

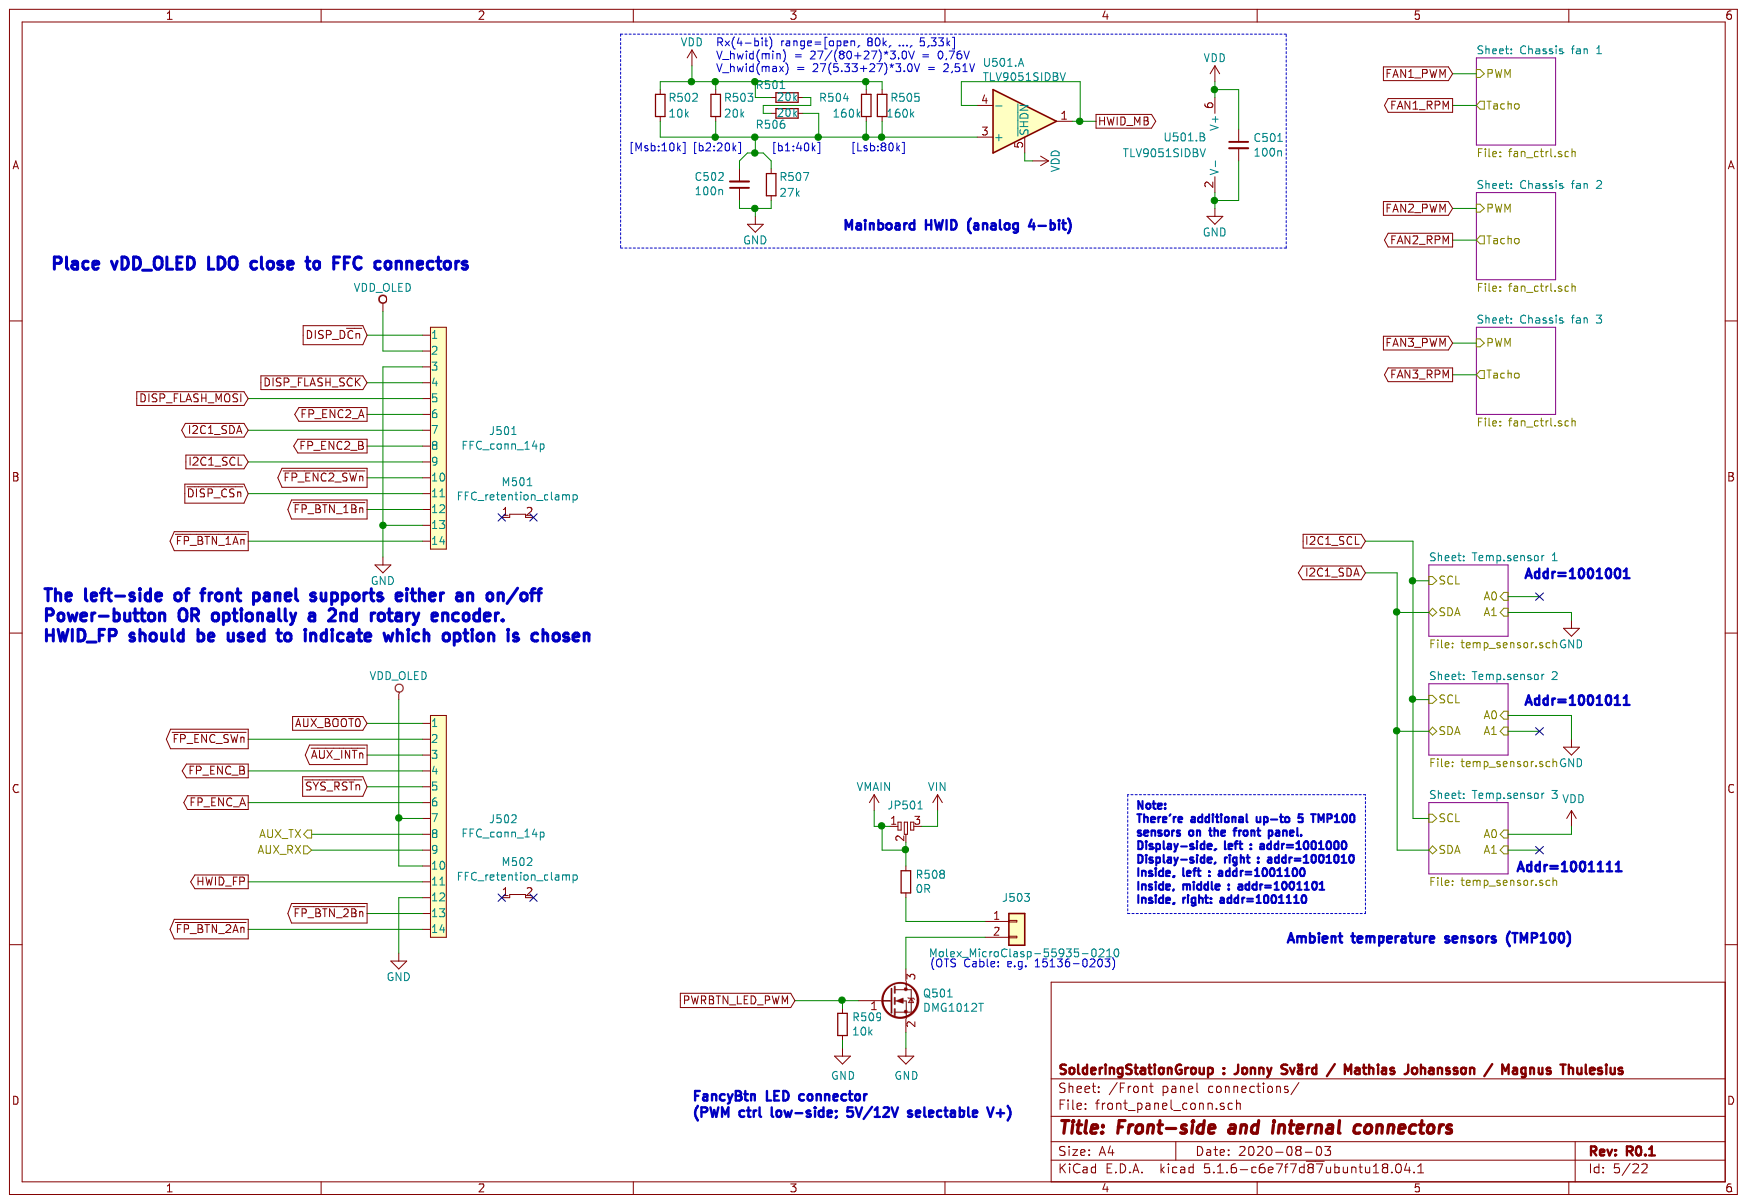
[picture p155: page 5]

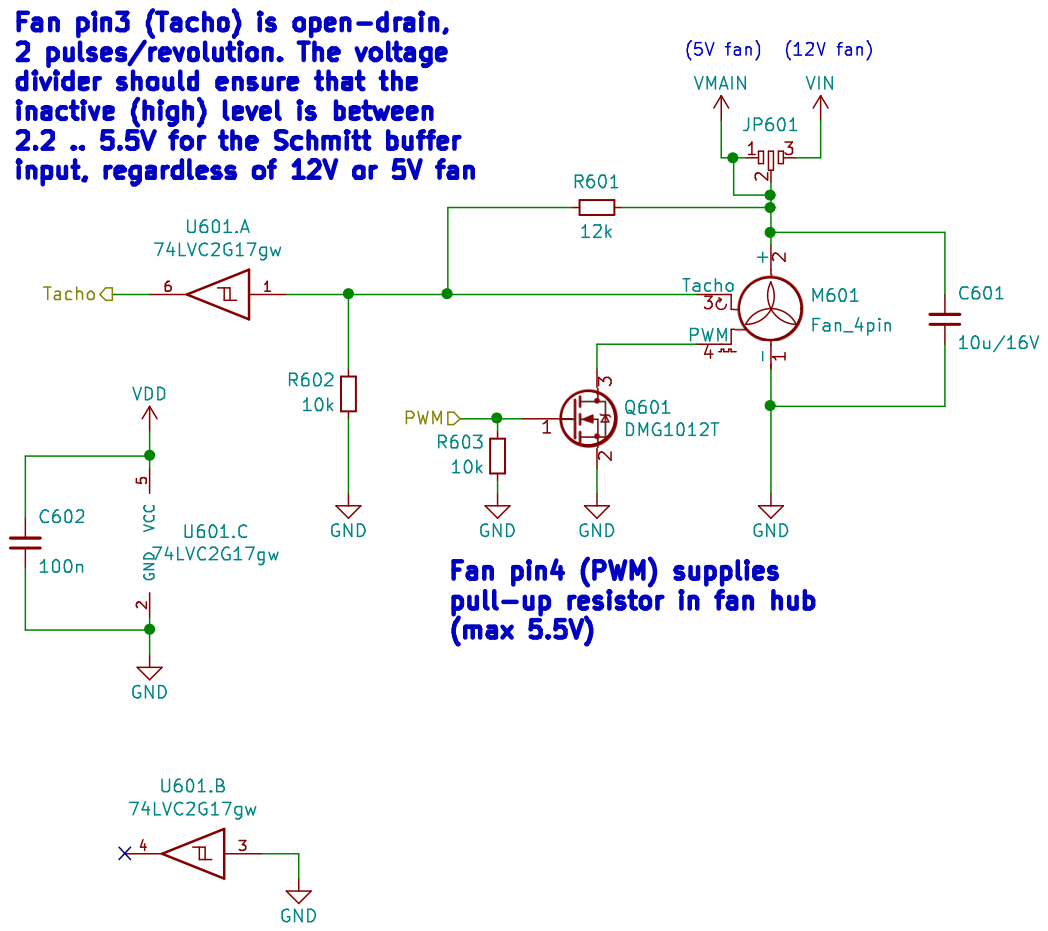
[picture p156: page 6]

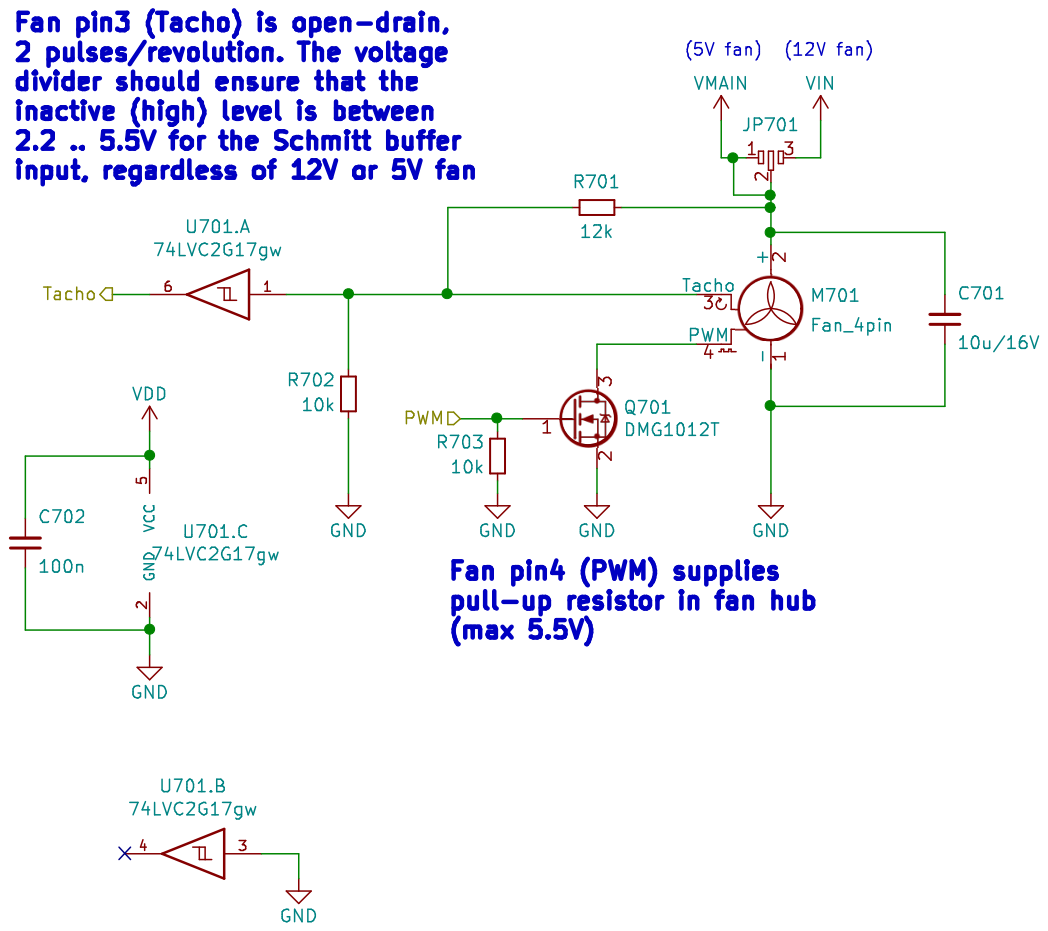
[picture p157: page 7]

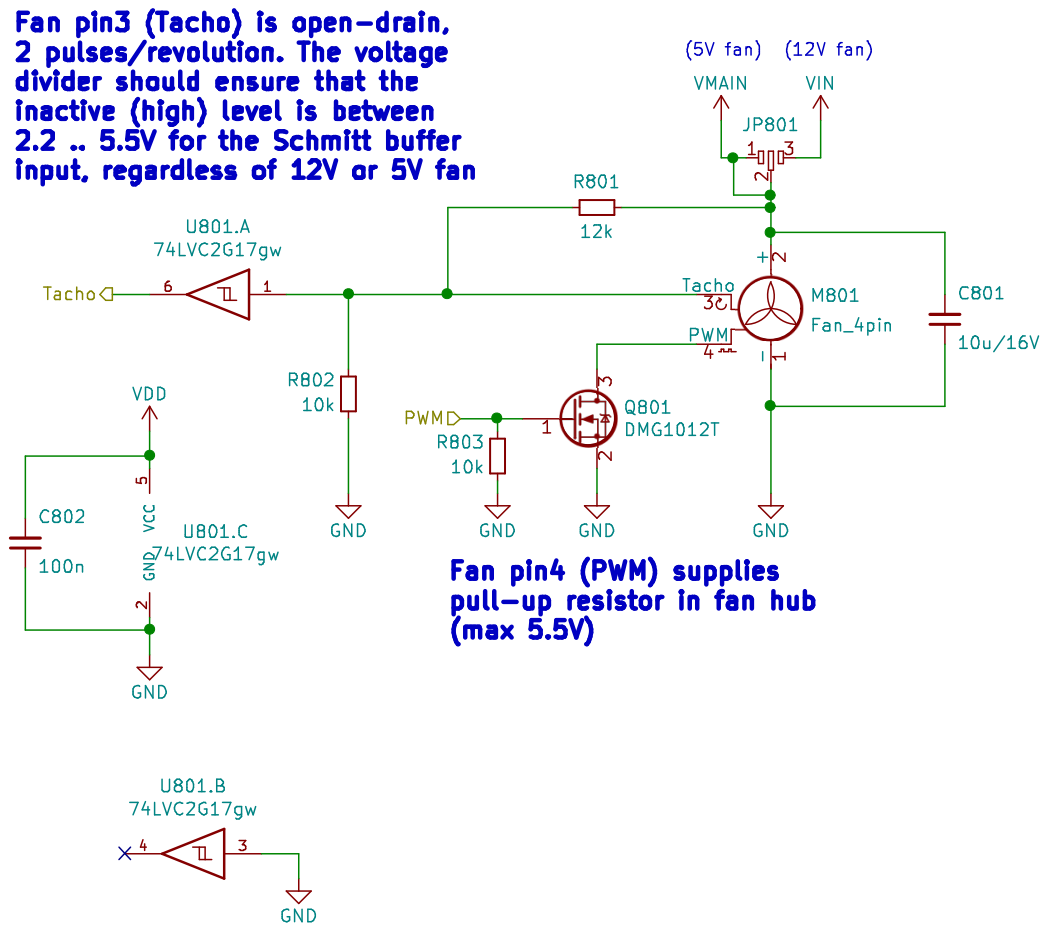
[picture p158: page 8]

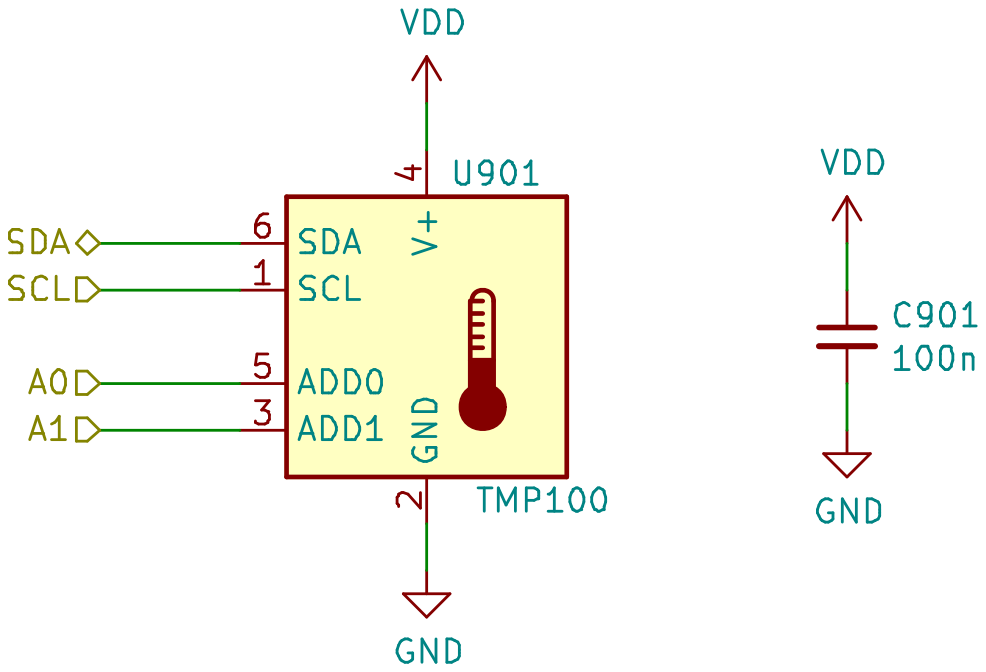
[picture p159: page 9]

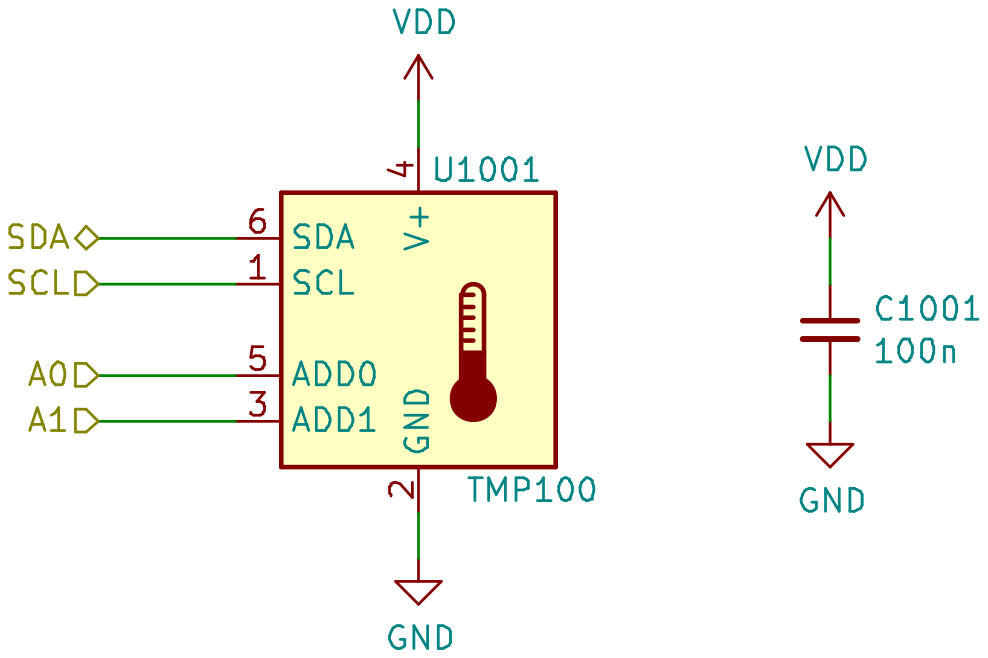
[picture p160: page 10]

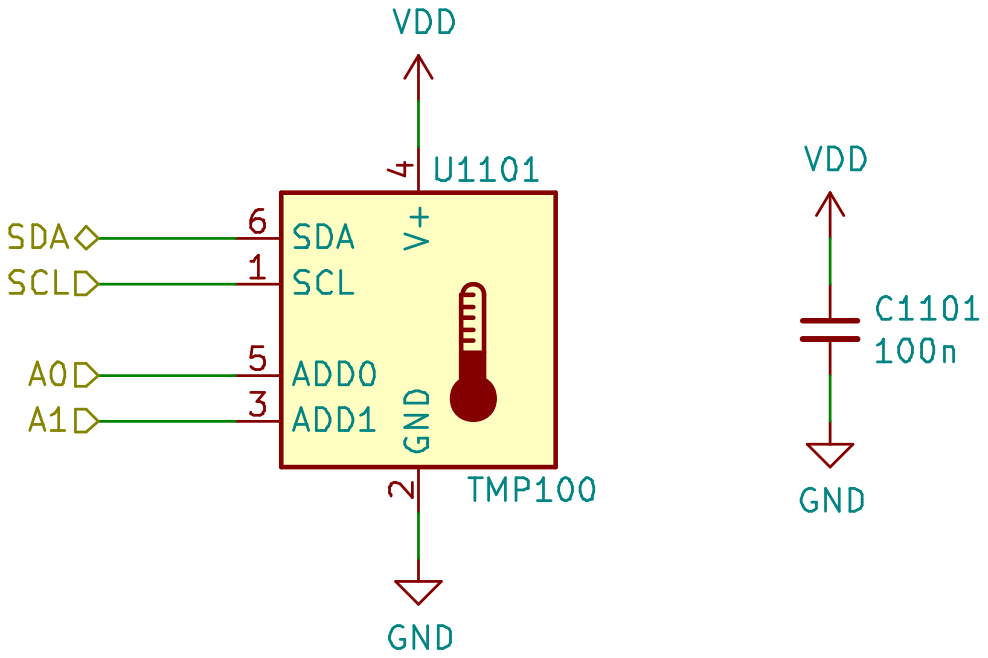
[picture p161: page 11]

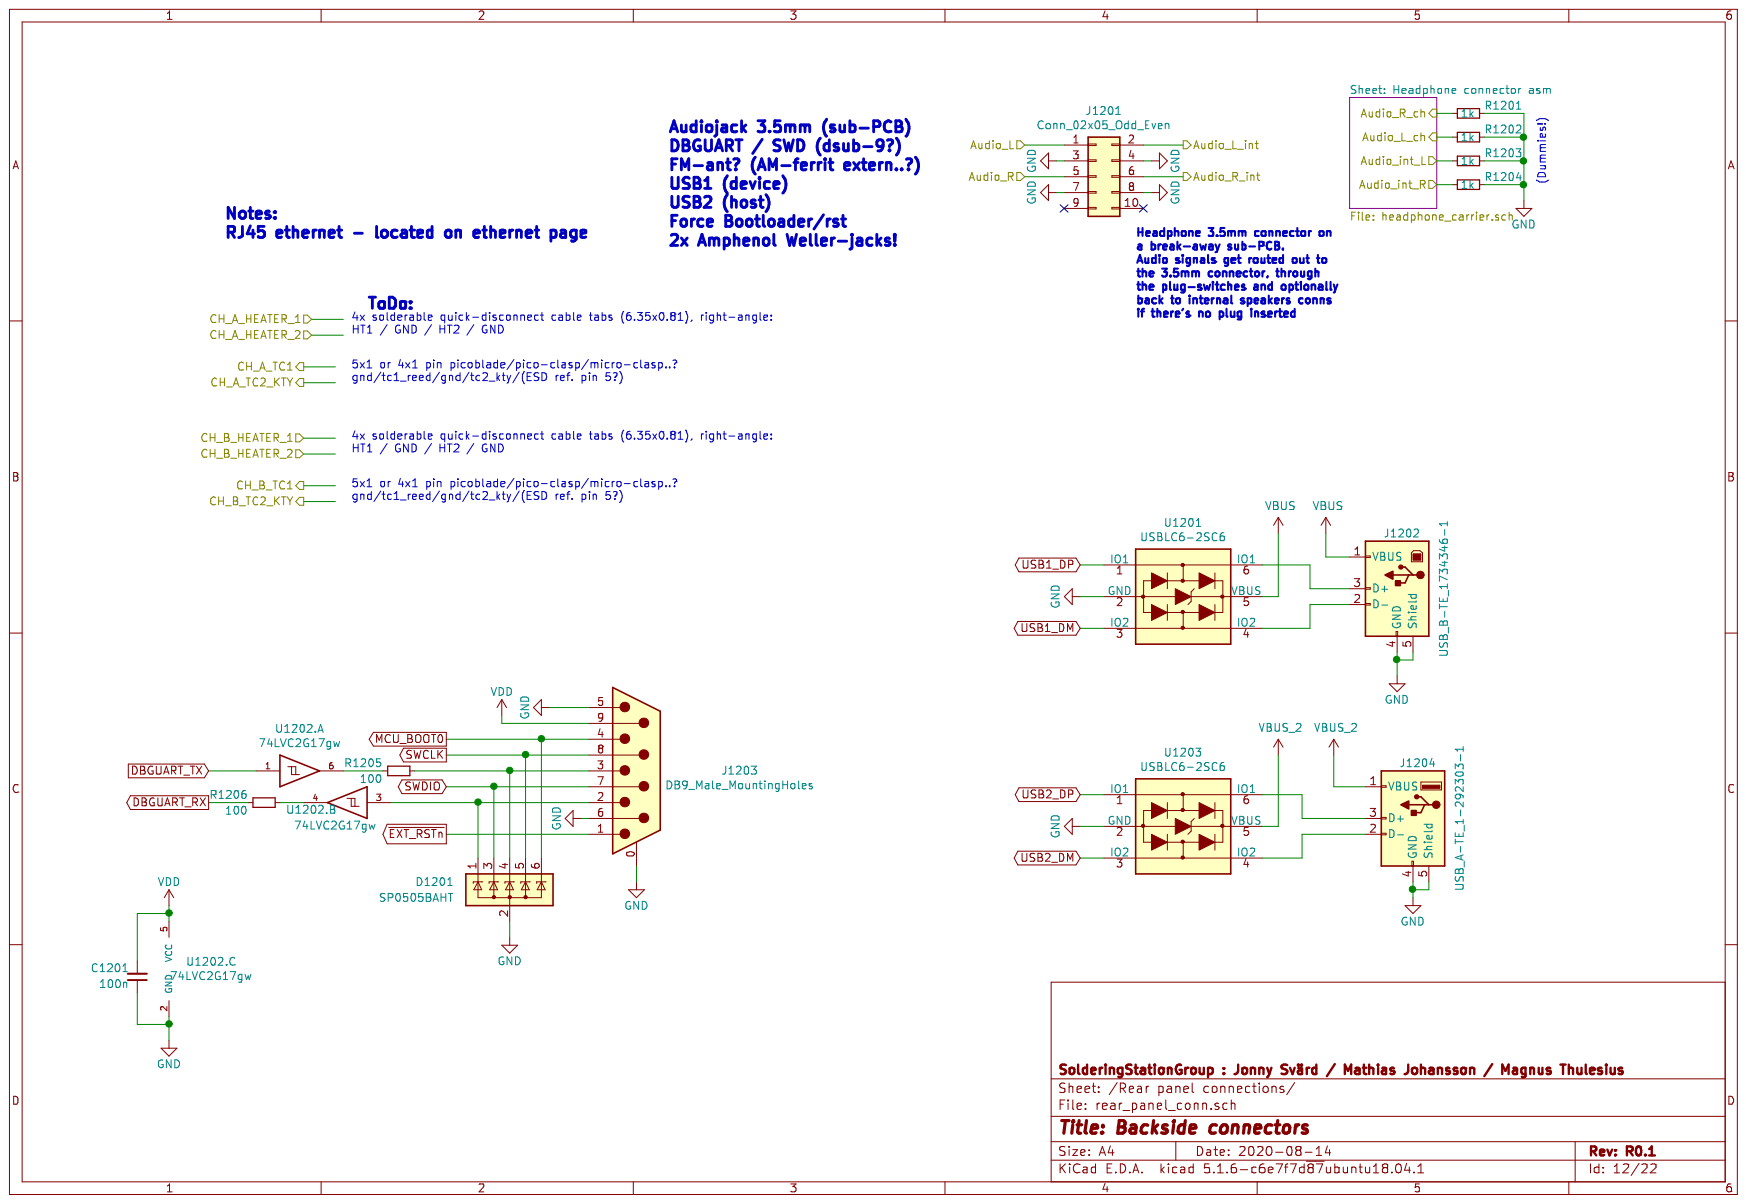
[picture p162: page 12]

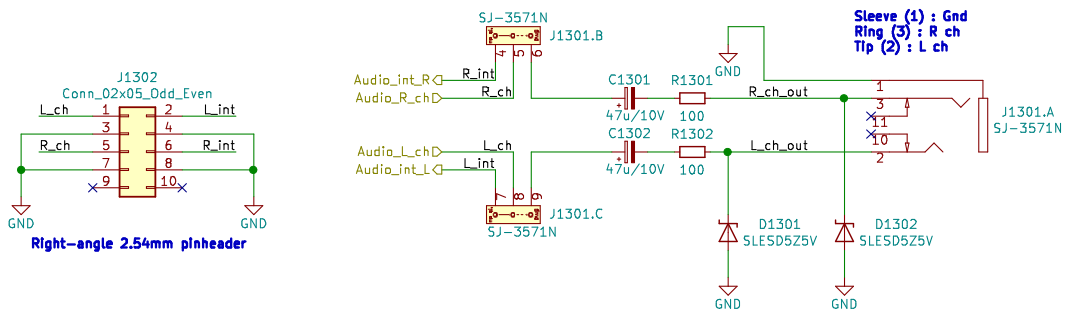
[picture p163: page 13]

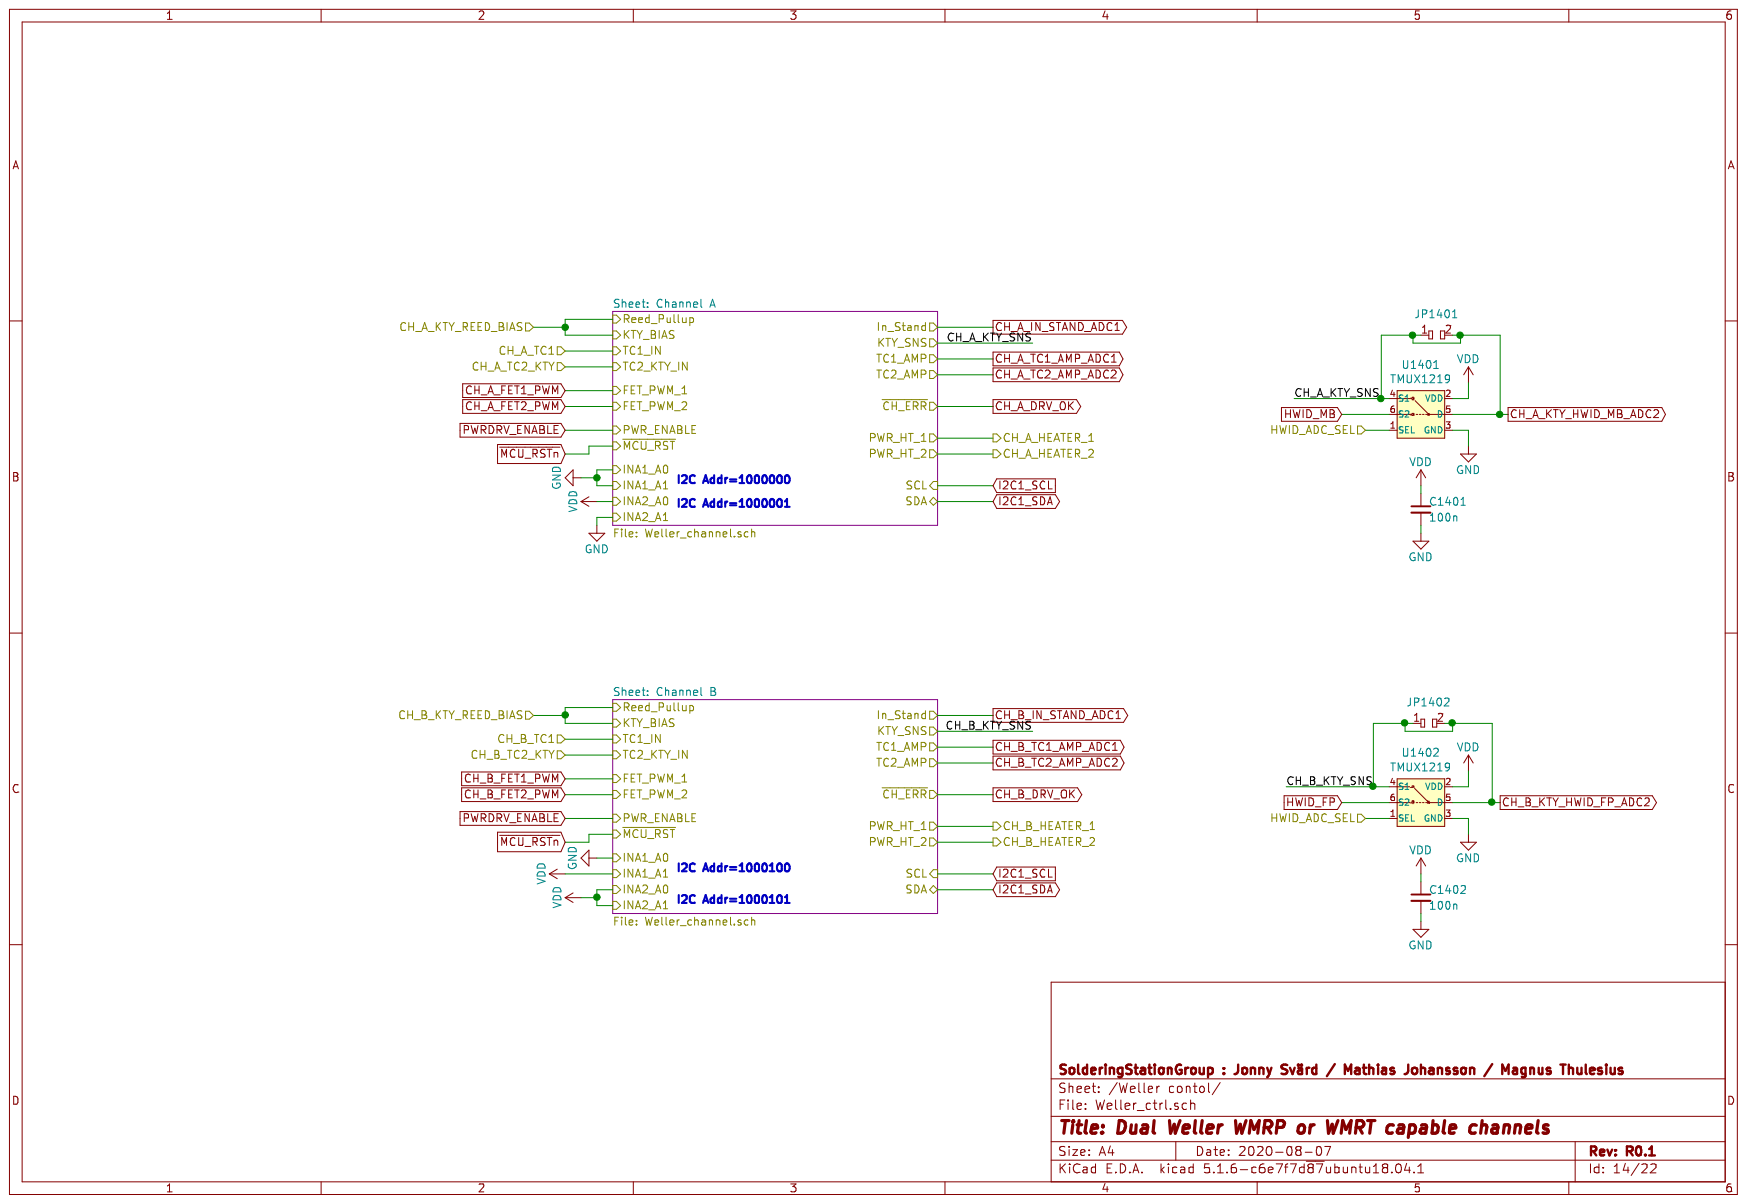
[picture p164: page 14]

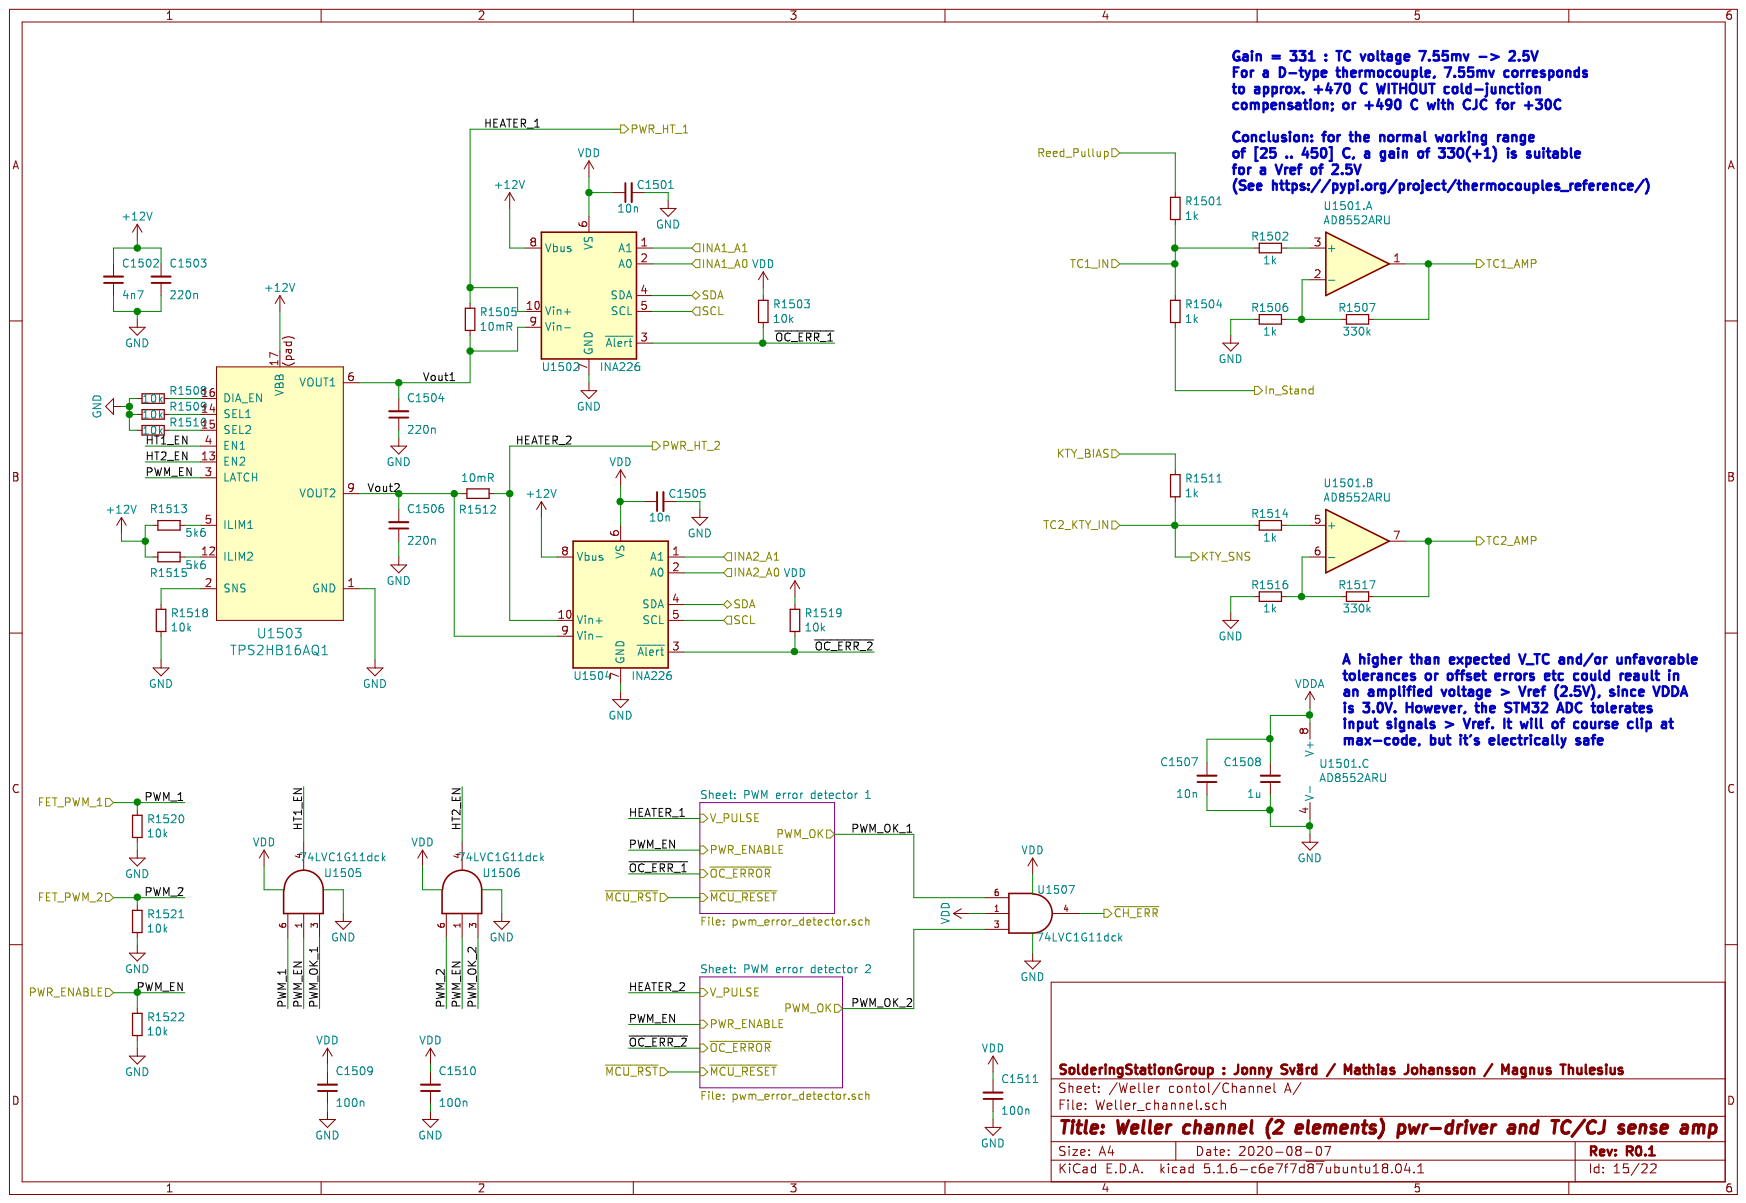
[picture p165: page 15]

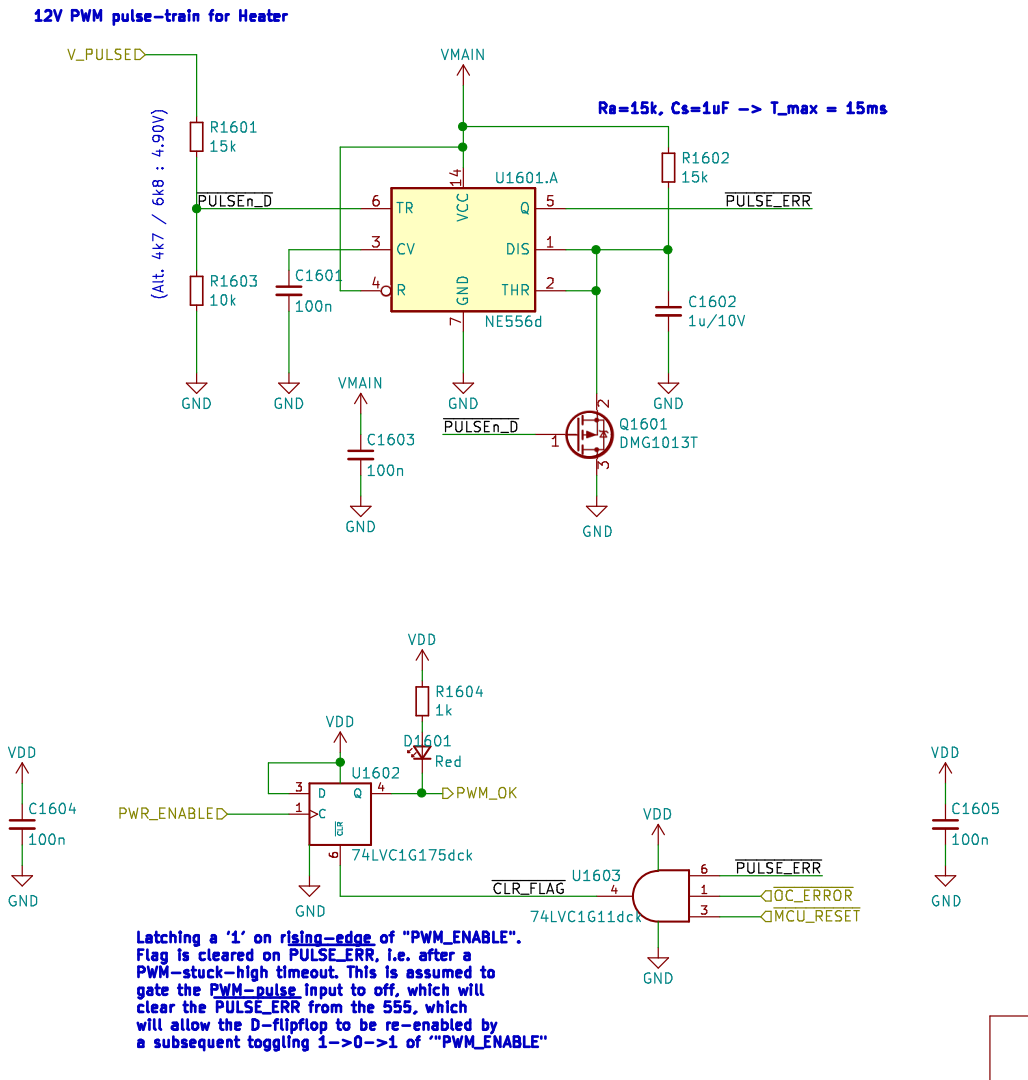
[picture p166: page 16]

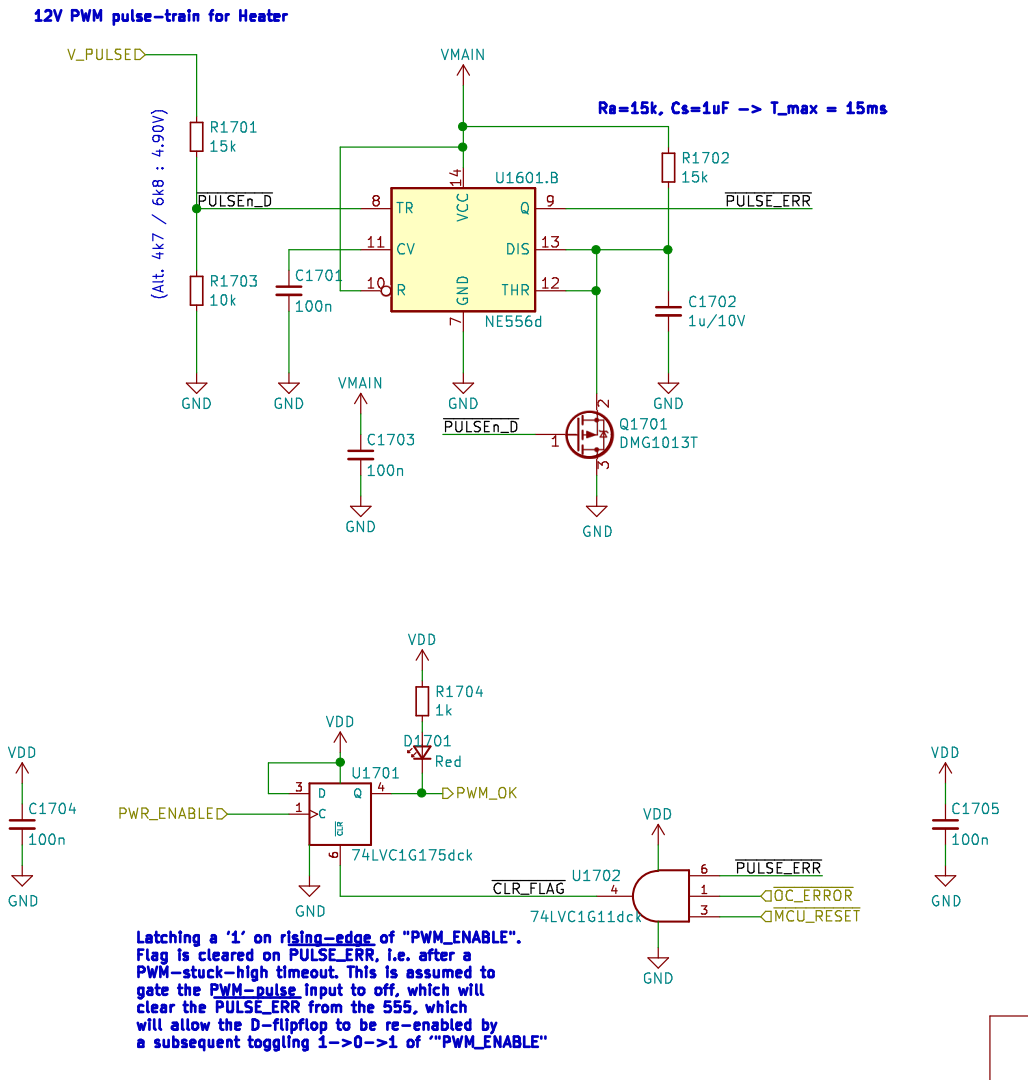
[picture p167: page 17]

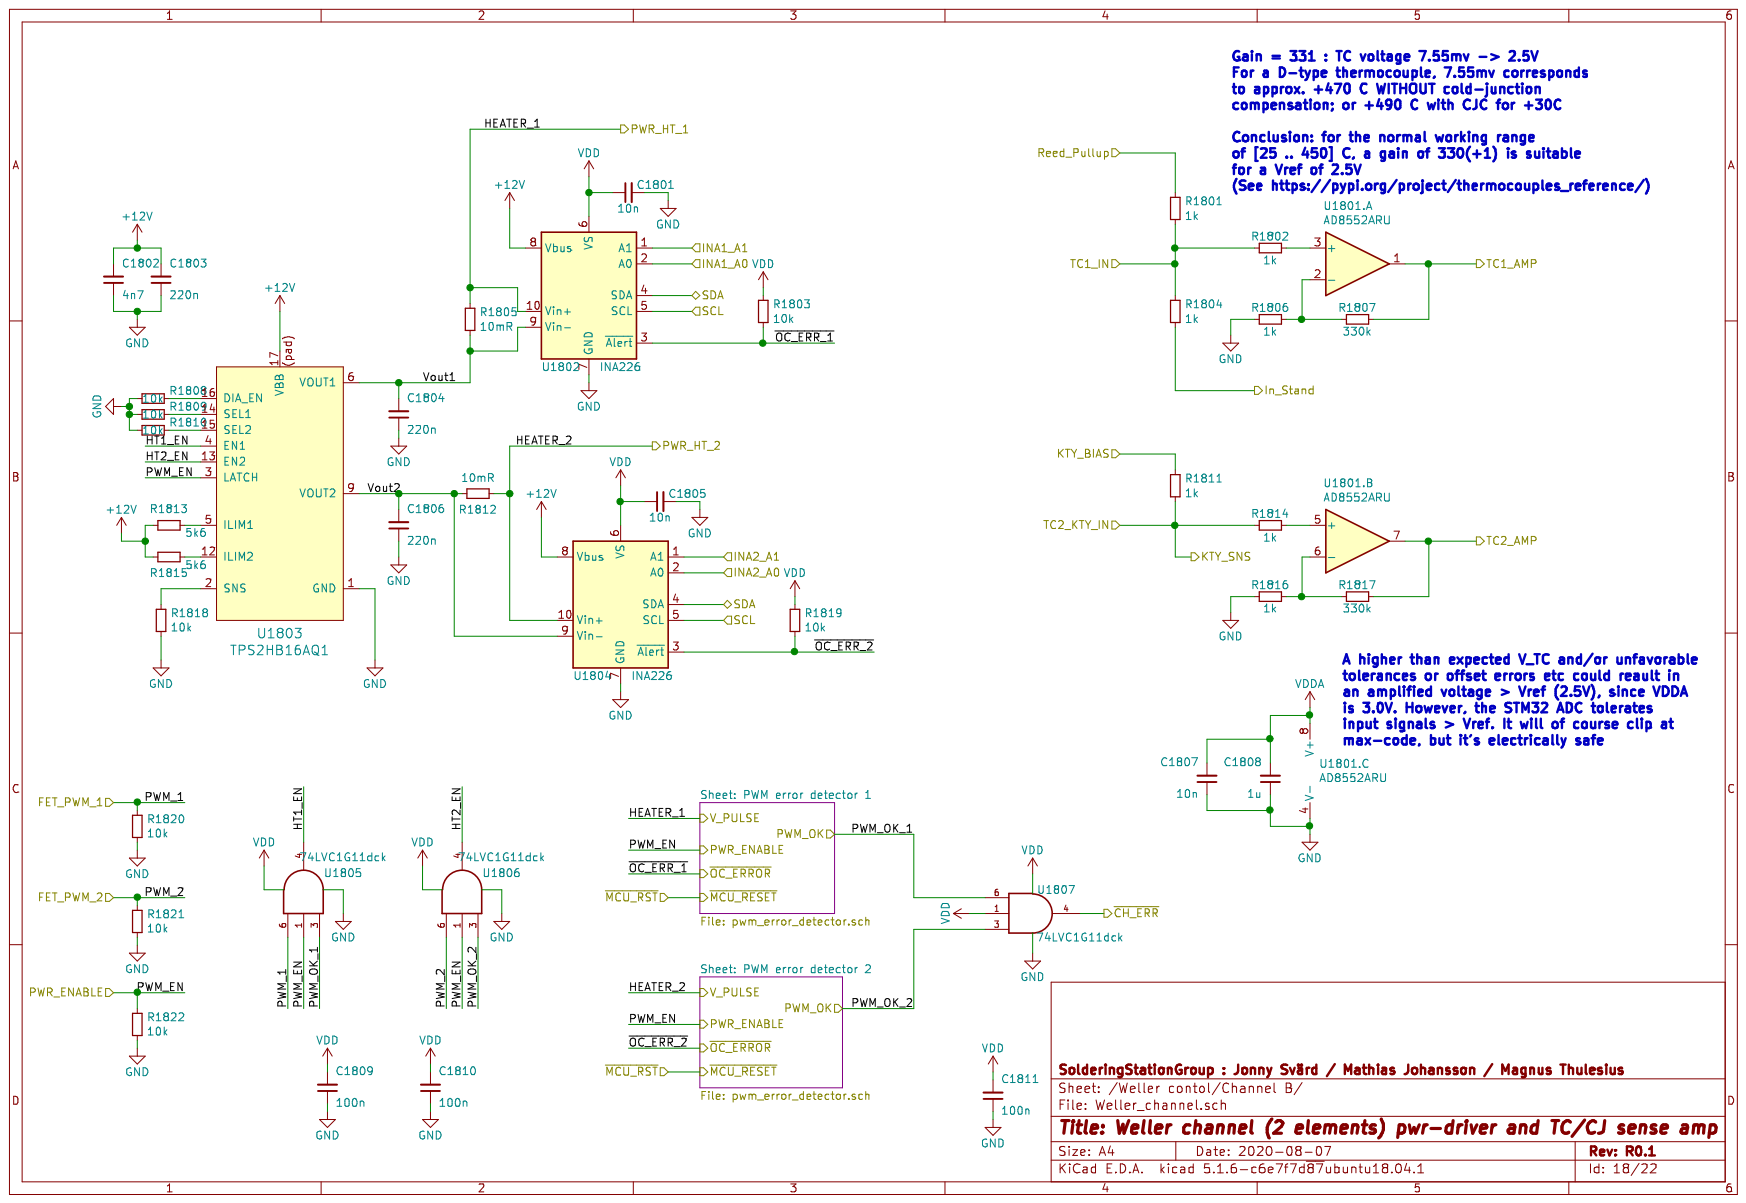
[picture p168: page 18]

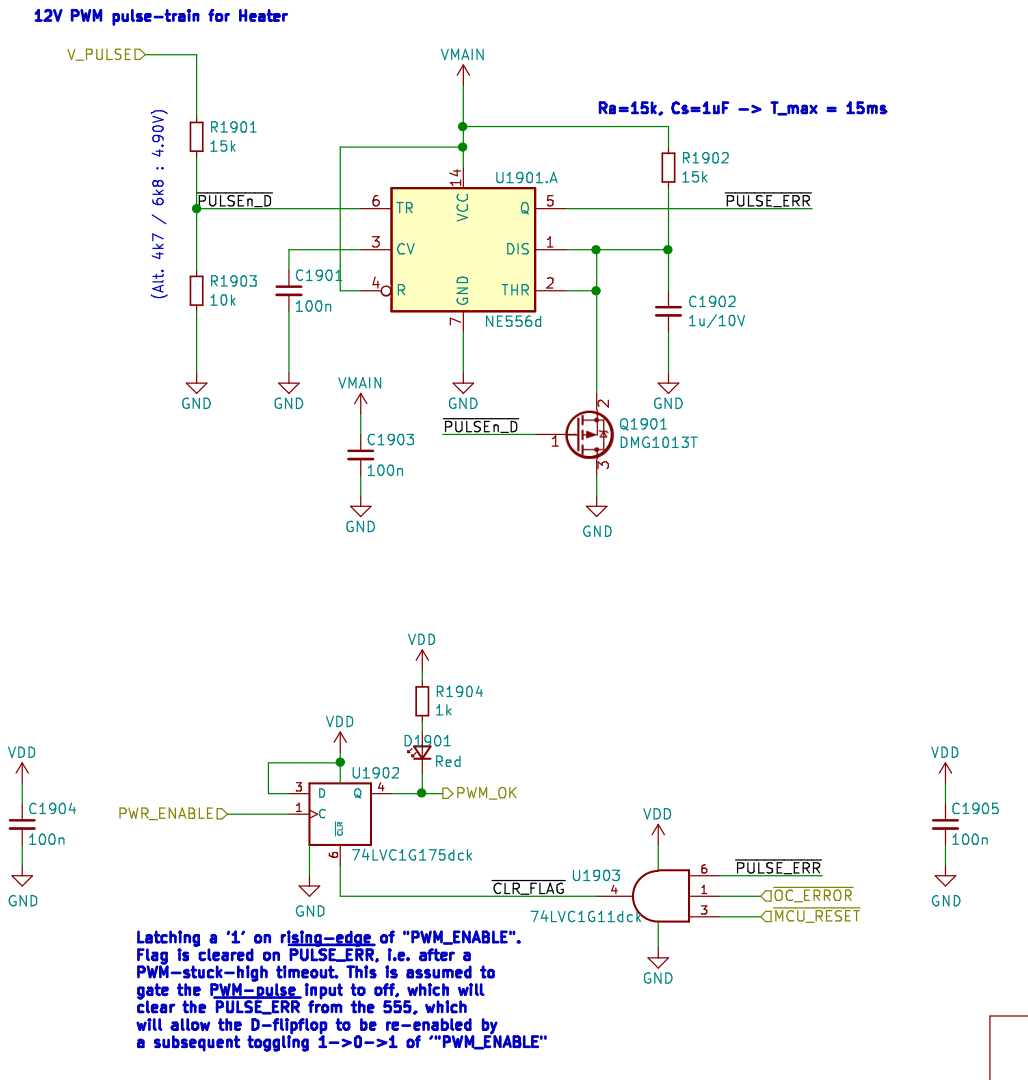
[picture p169: page 19]

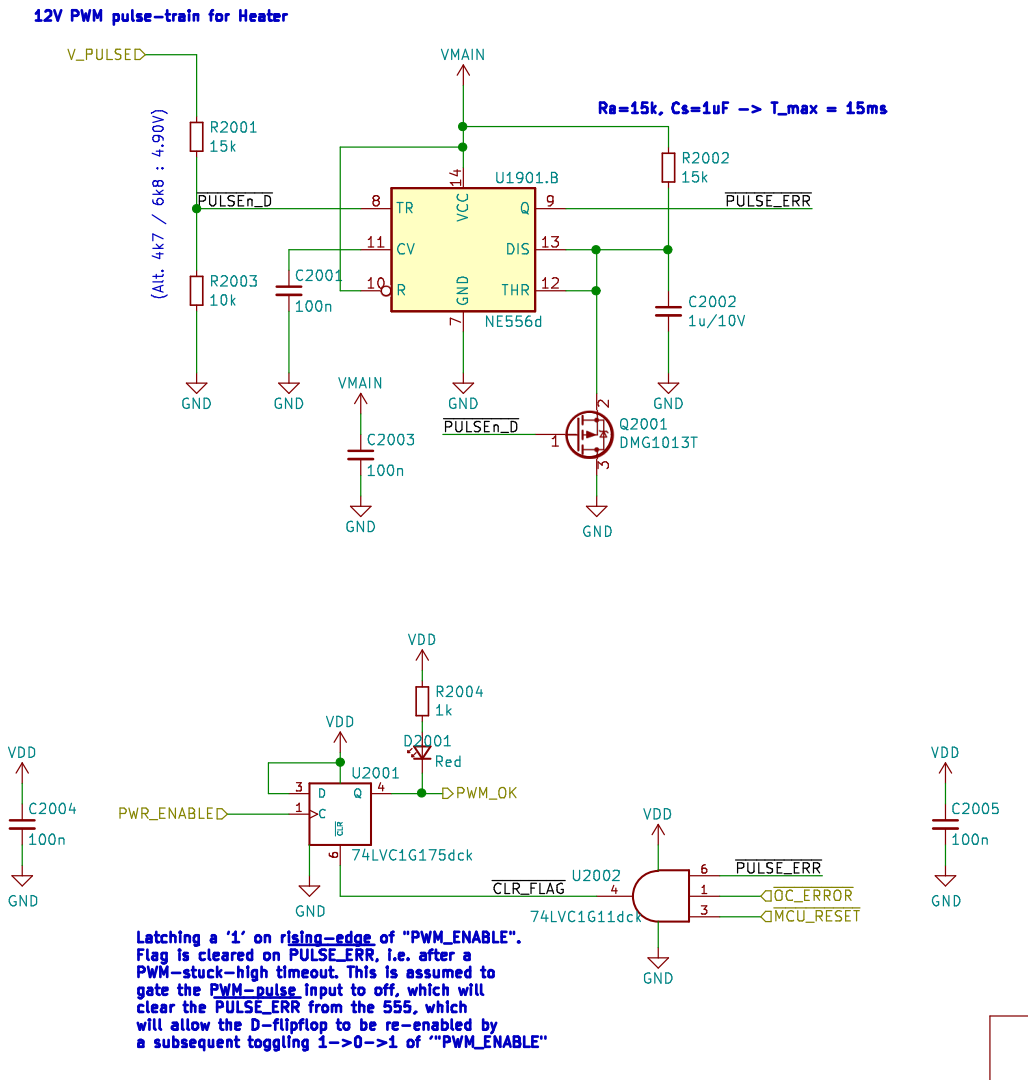
[picture p170: page 20]

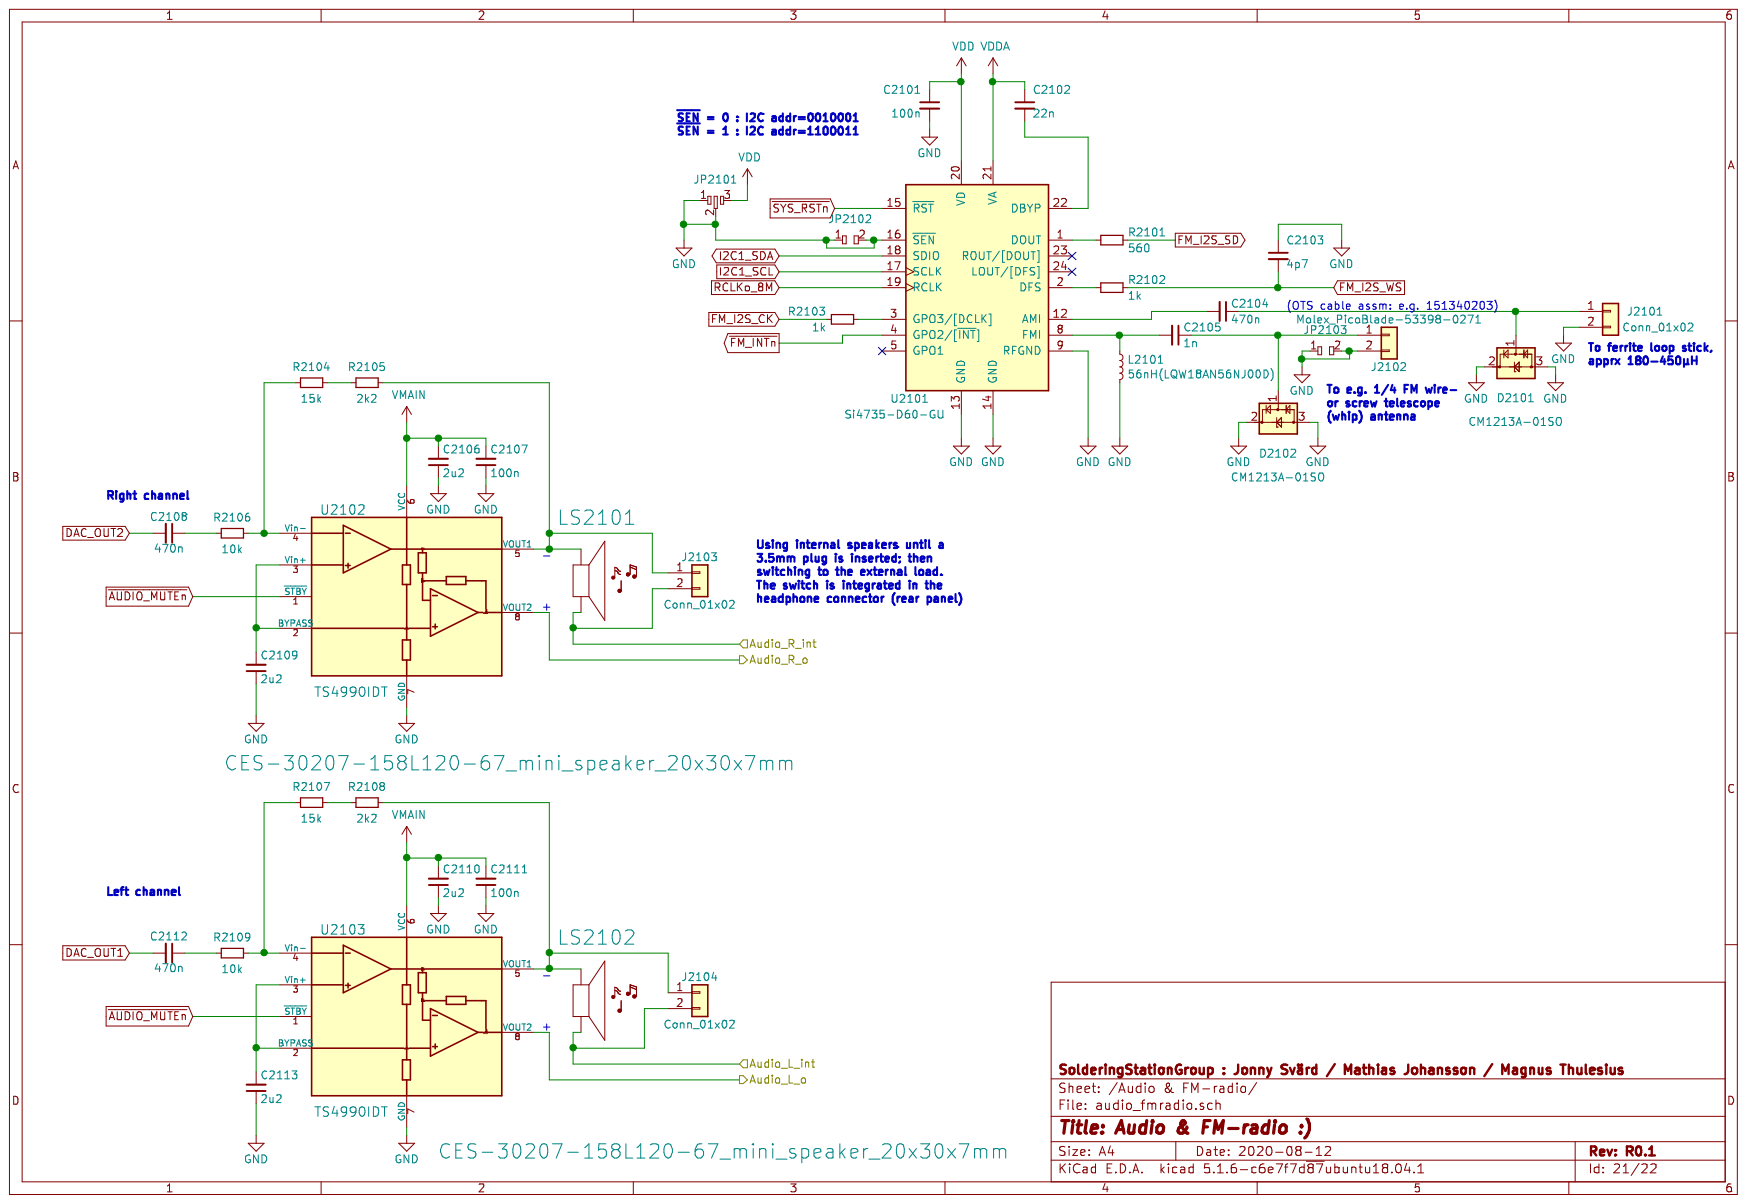
[picture p171: page 21]

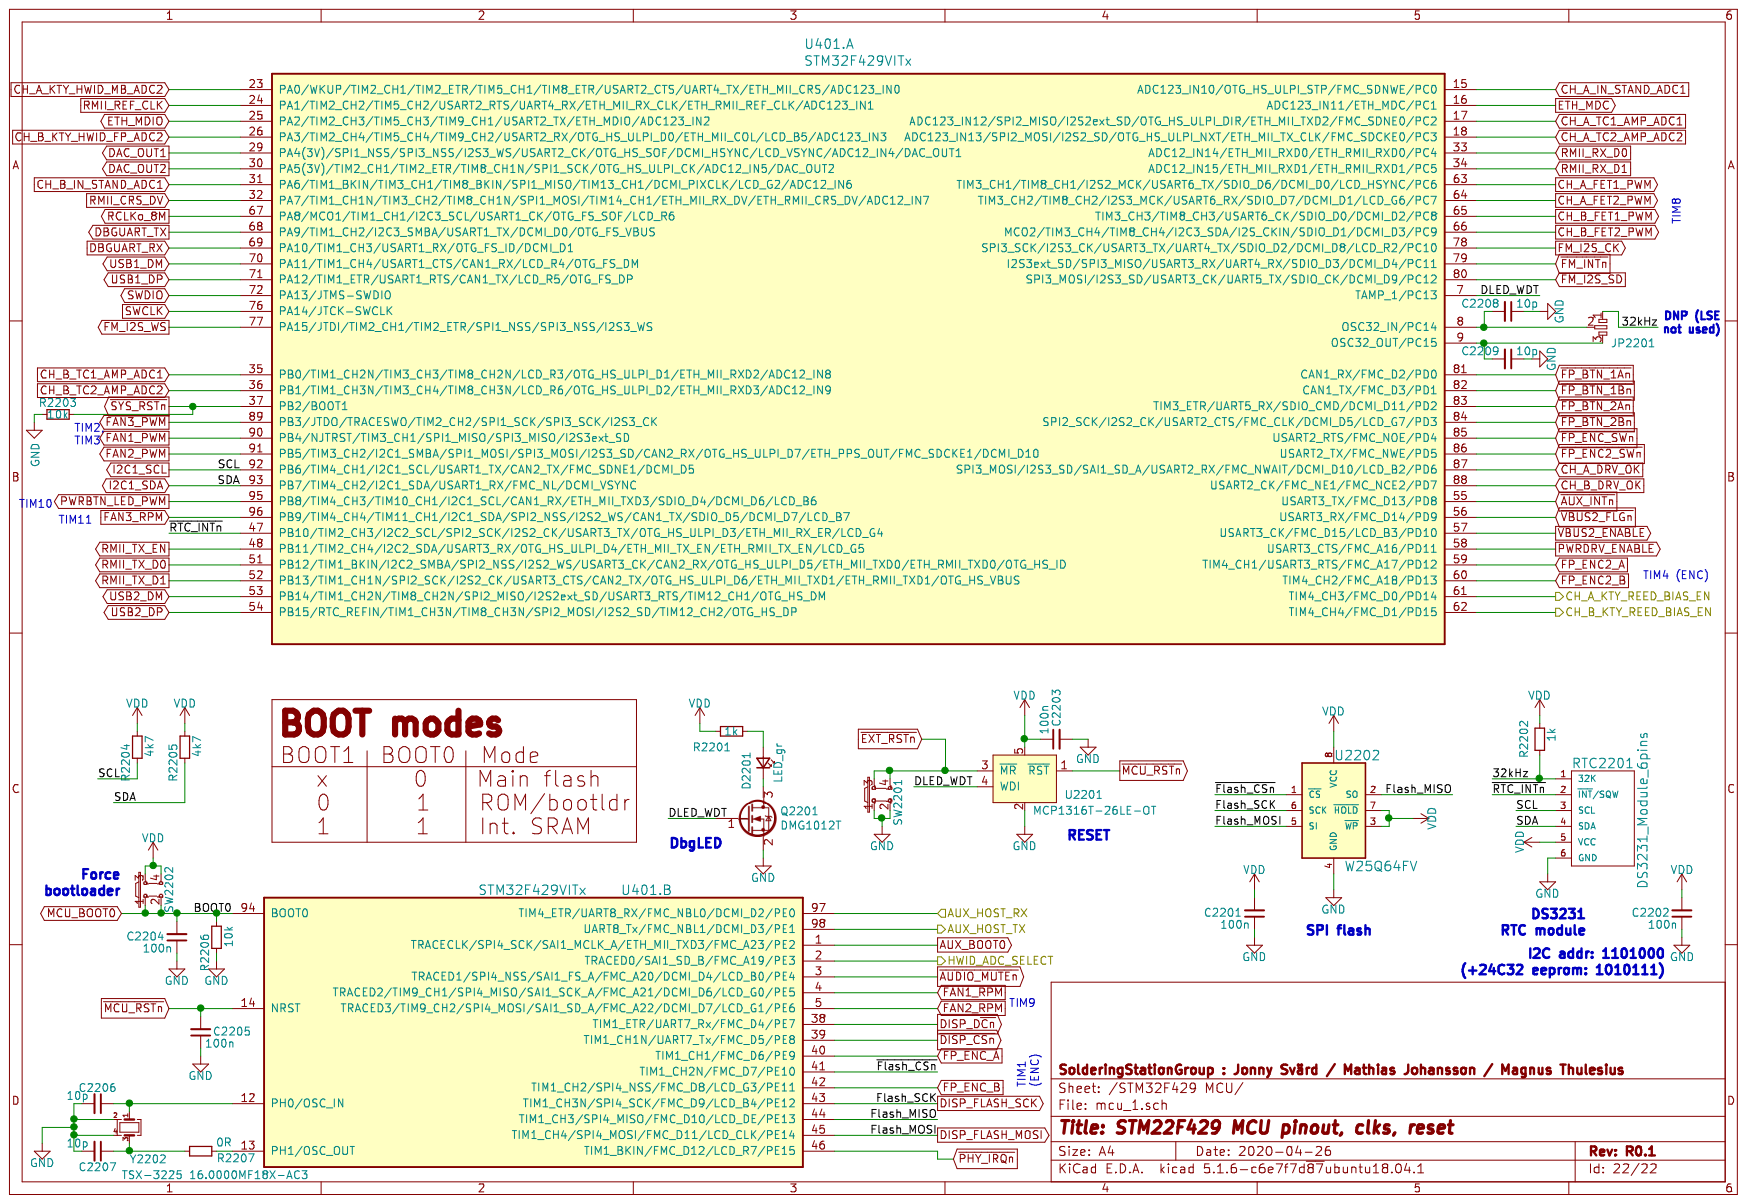
[picture p172: page 22]
