mjohansson/SolderingStation/hw/mainboard_wip_2020-08-23_WIP.pdf

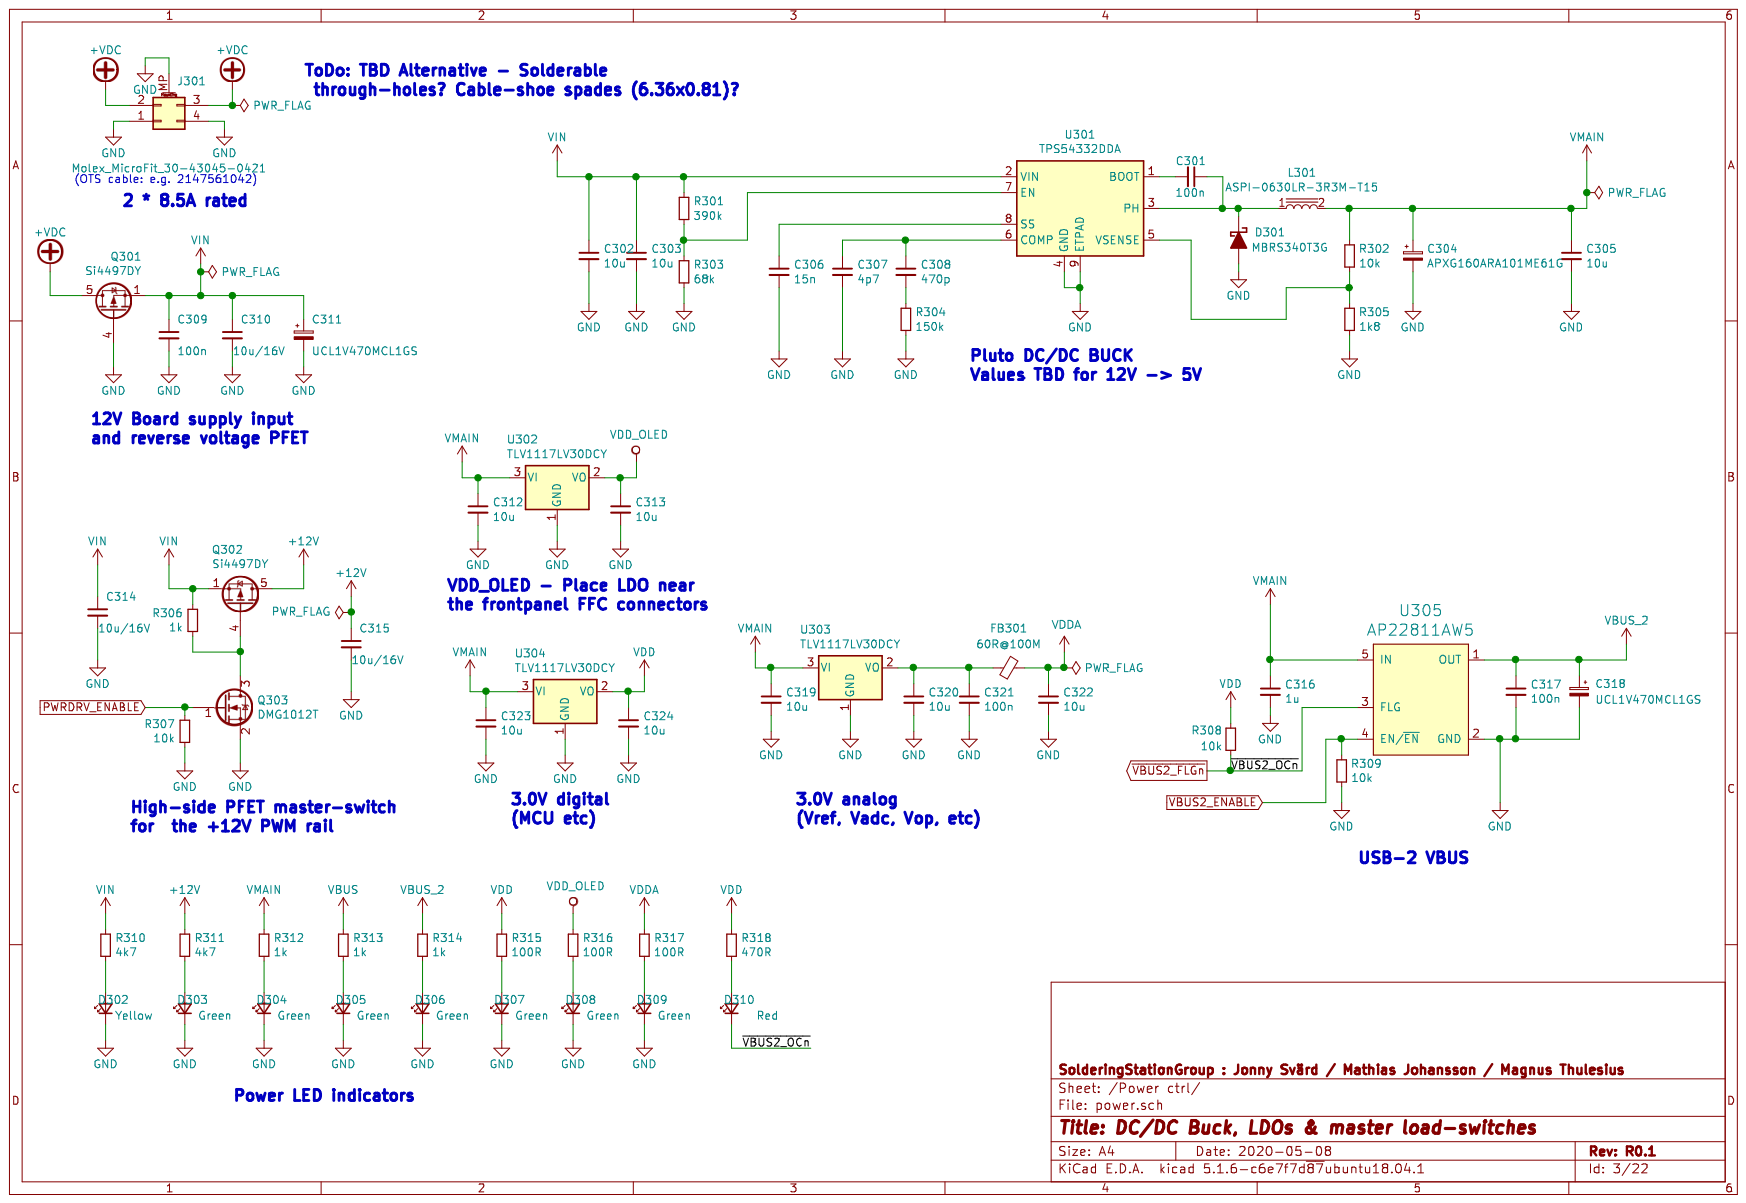
[picture p173: page 3]



















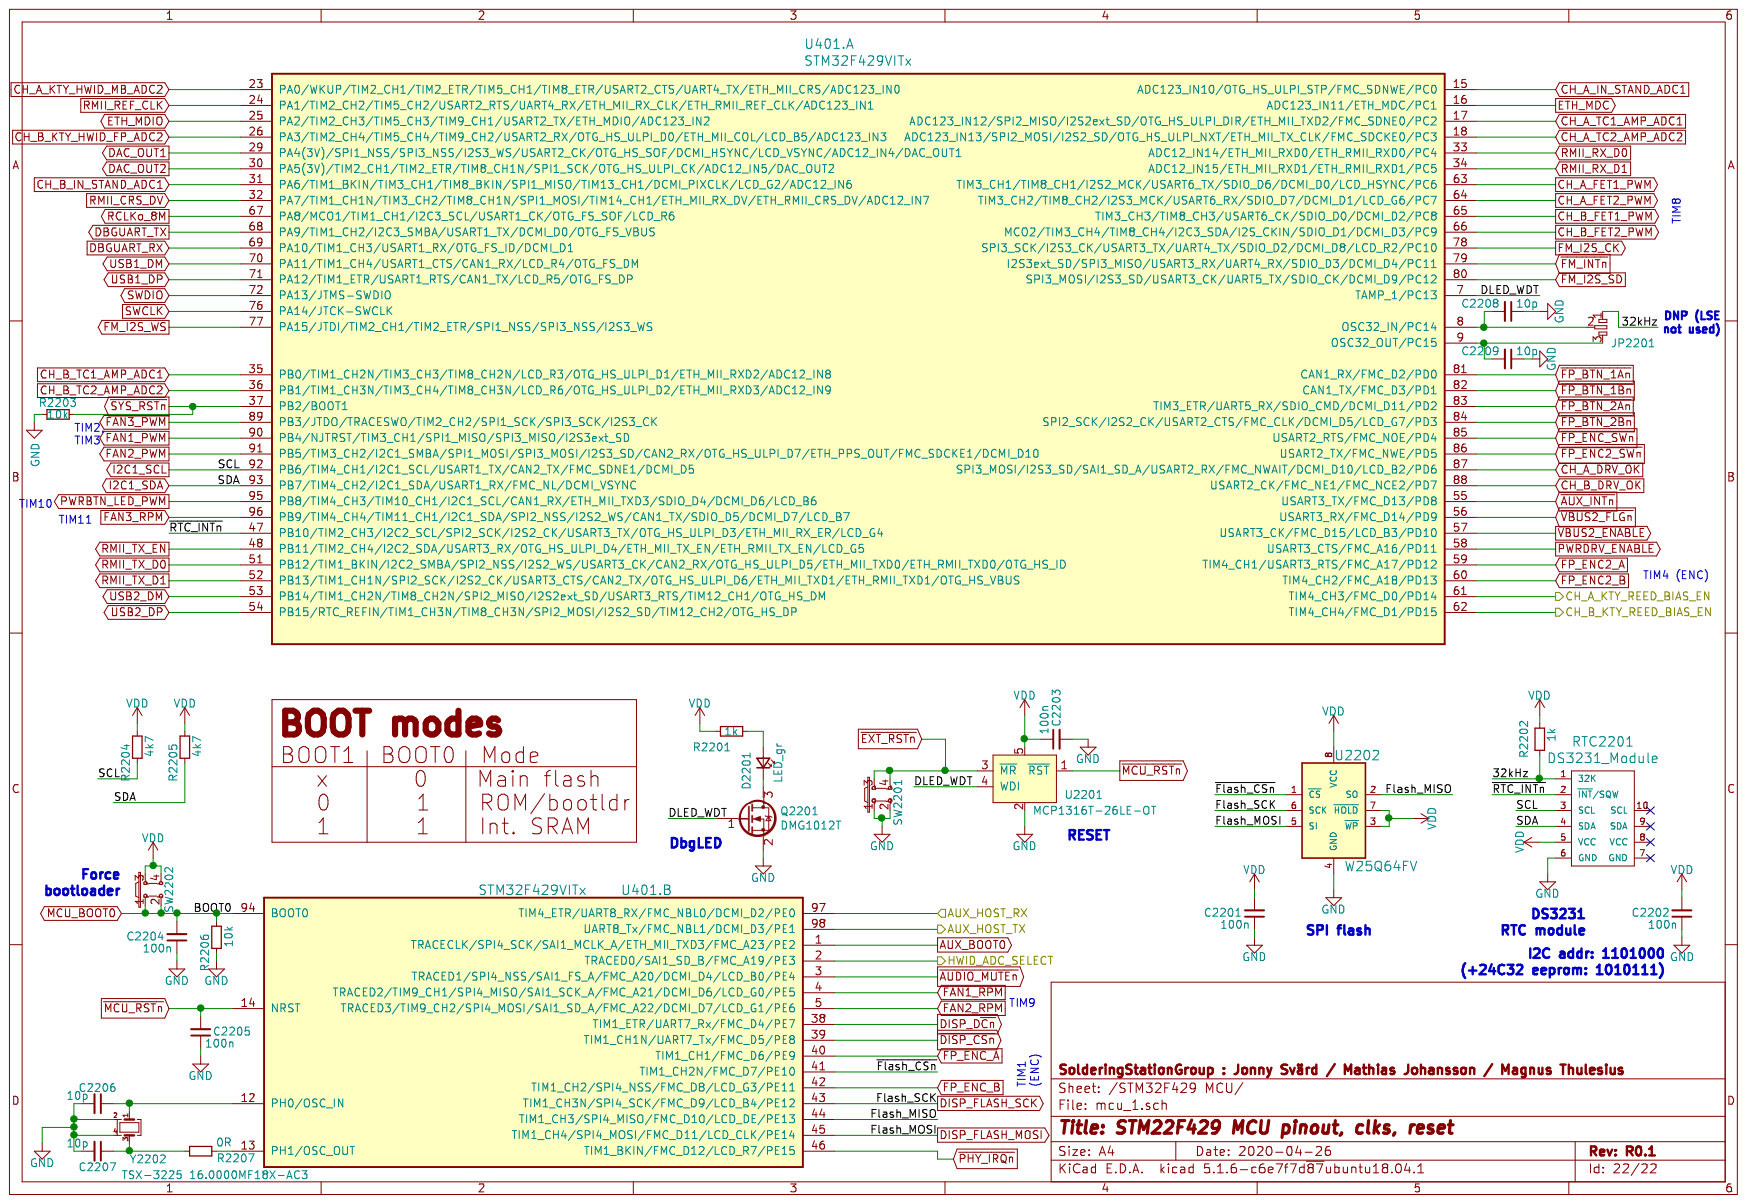
[picture p174: page 22]
