mjohansson/SolderingStation/hw/mainboard_wip_2020-08-21_WIP.pdf

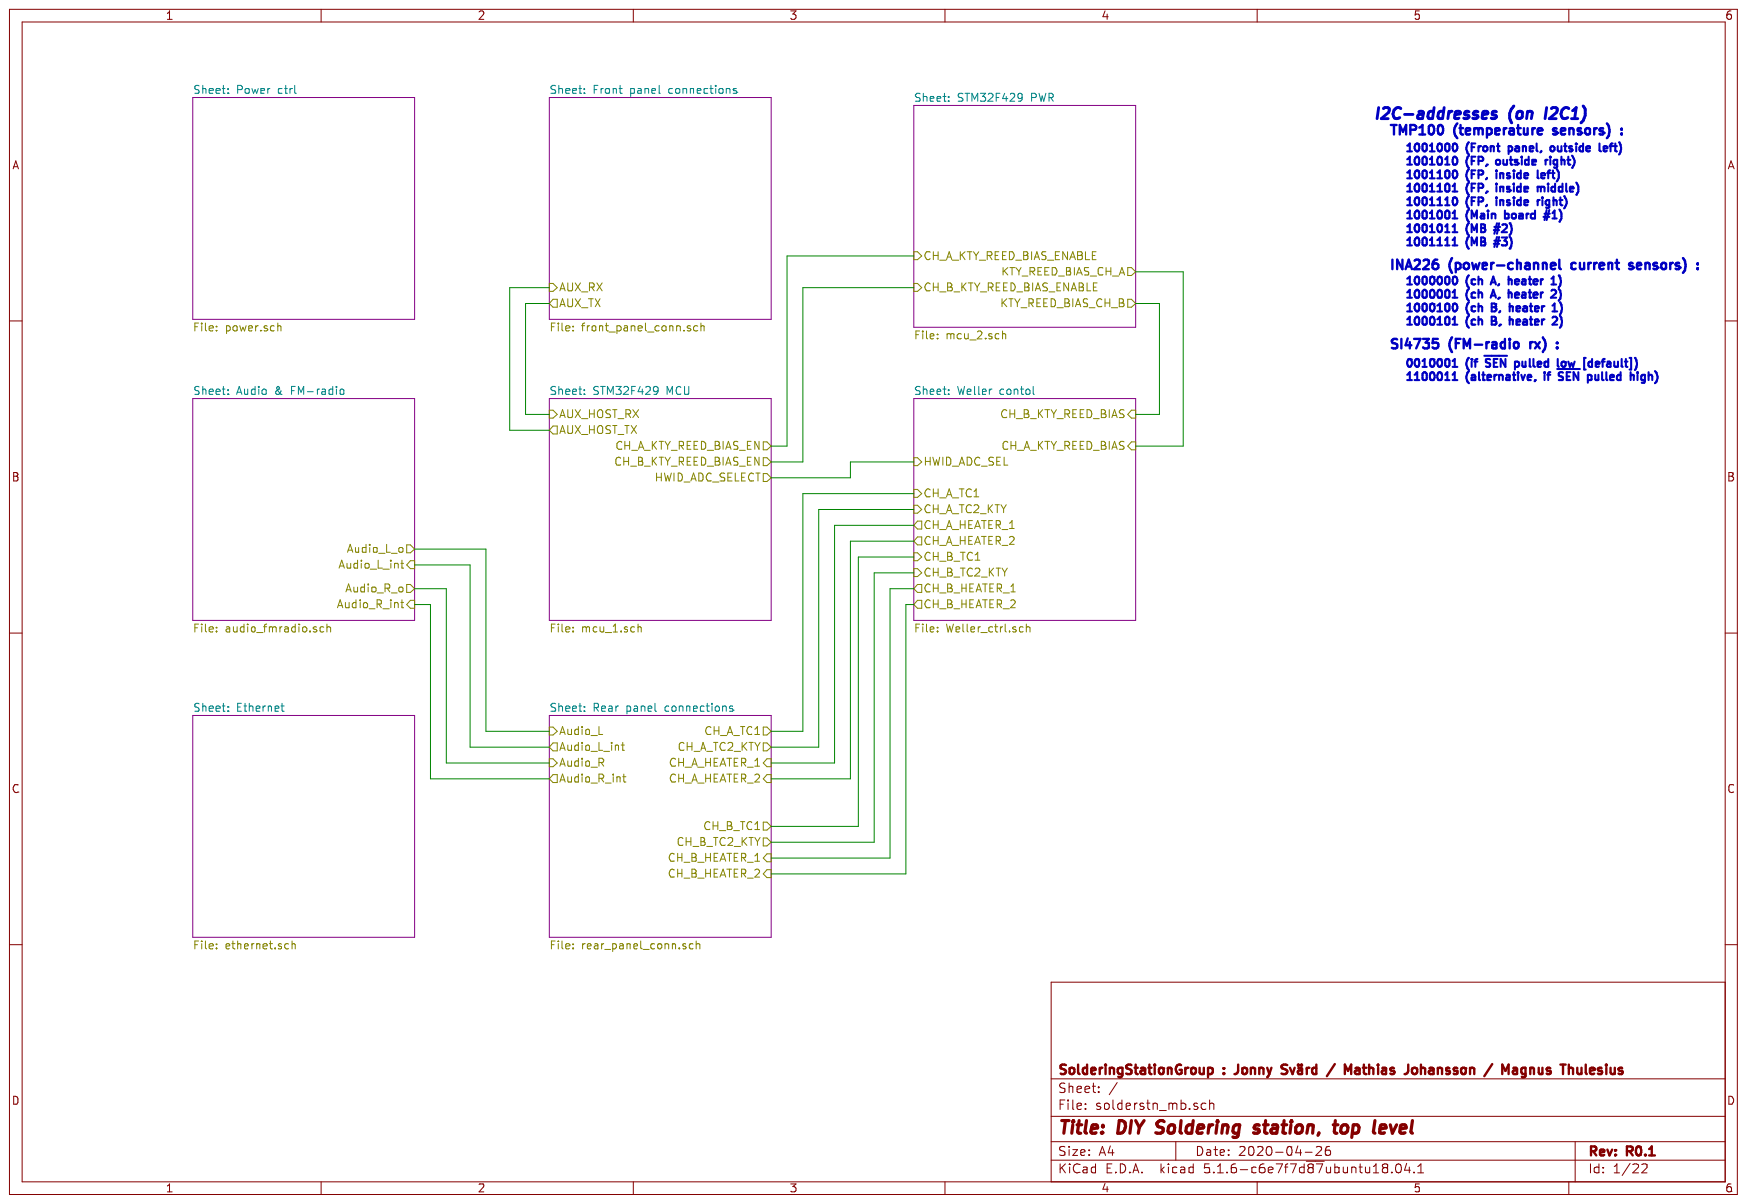
[picture p175: page 1]

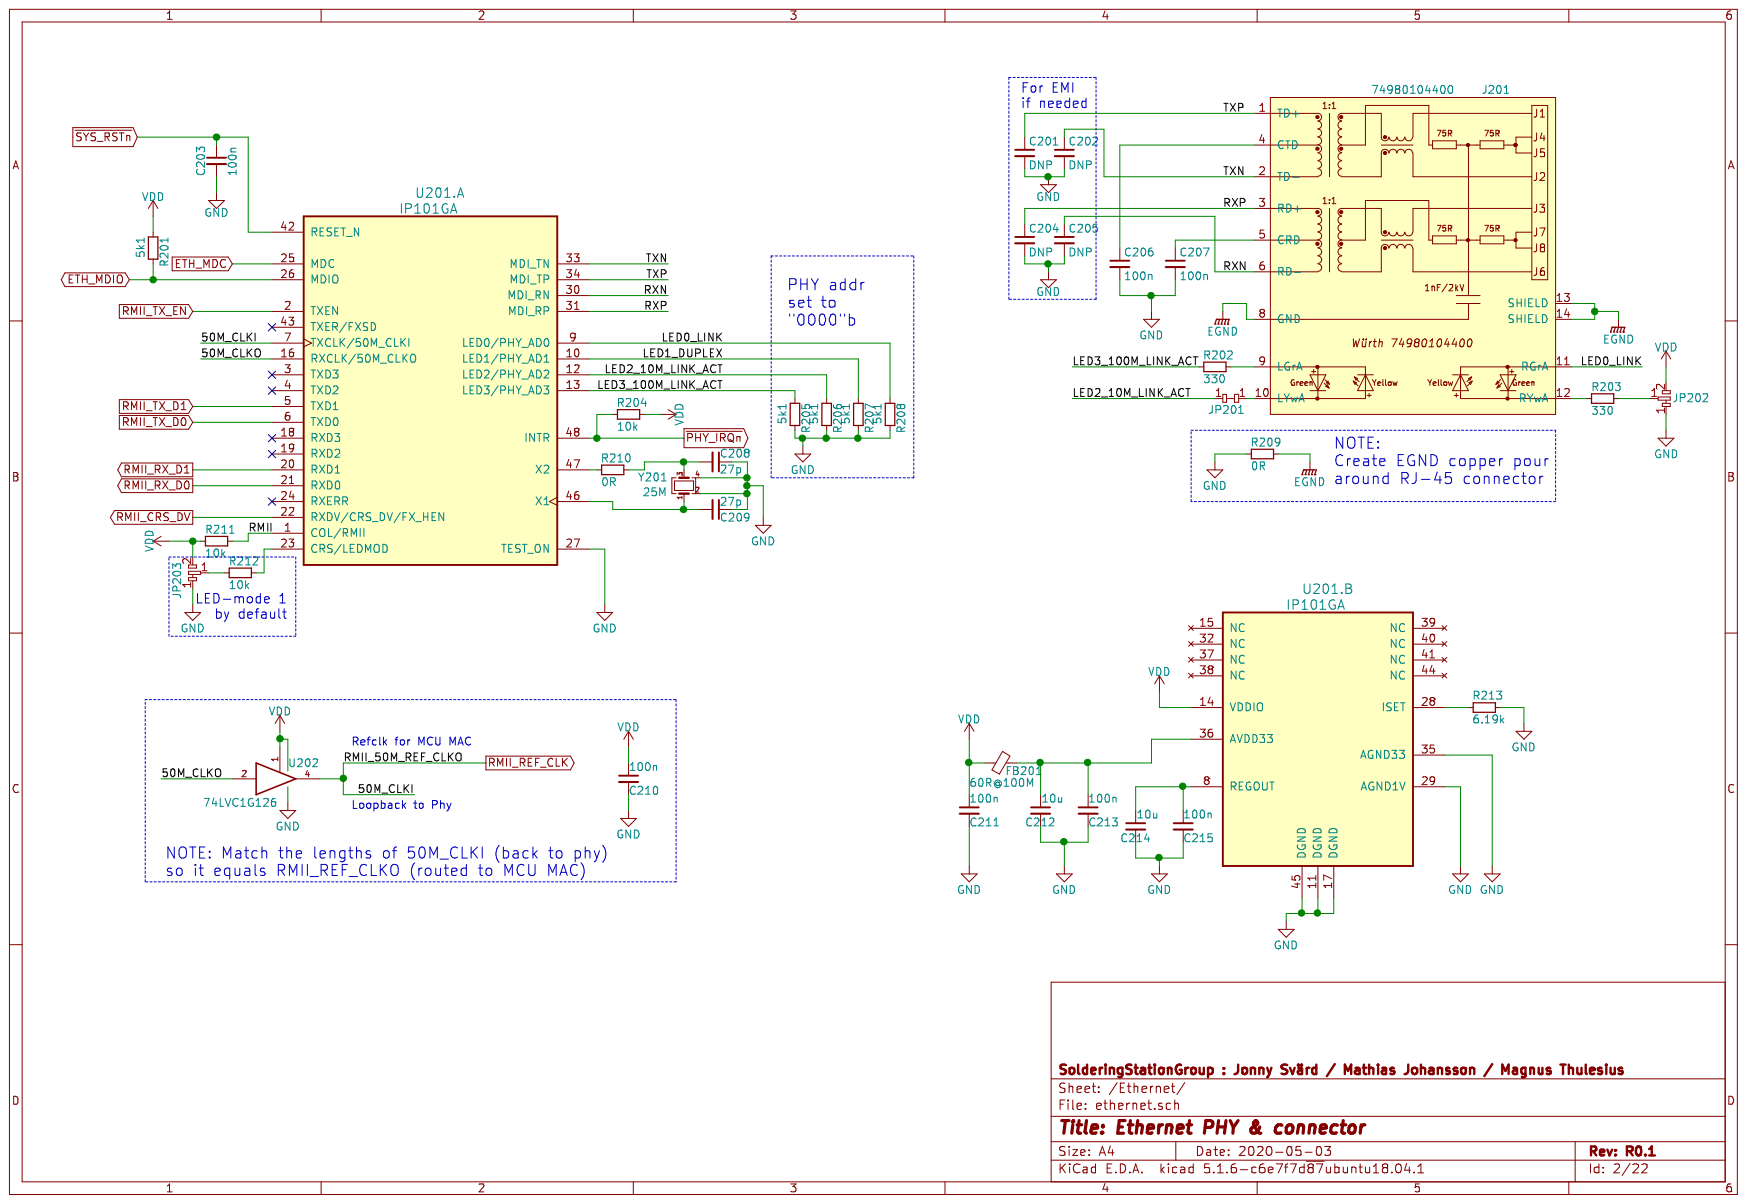
[picture p176: page 2]

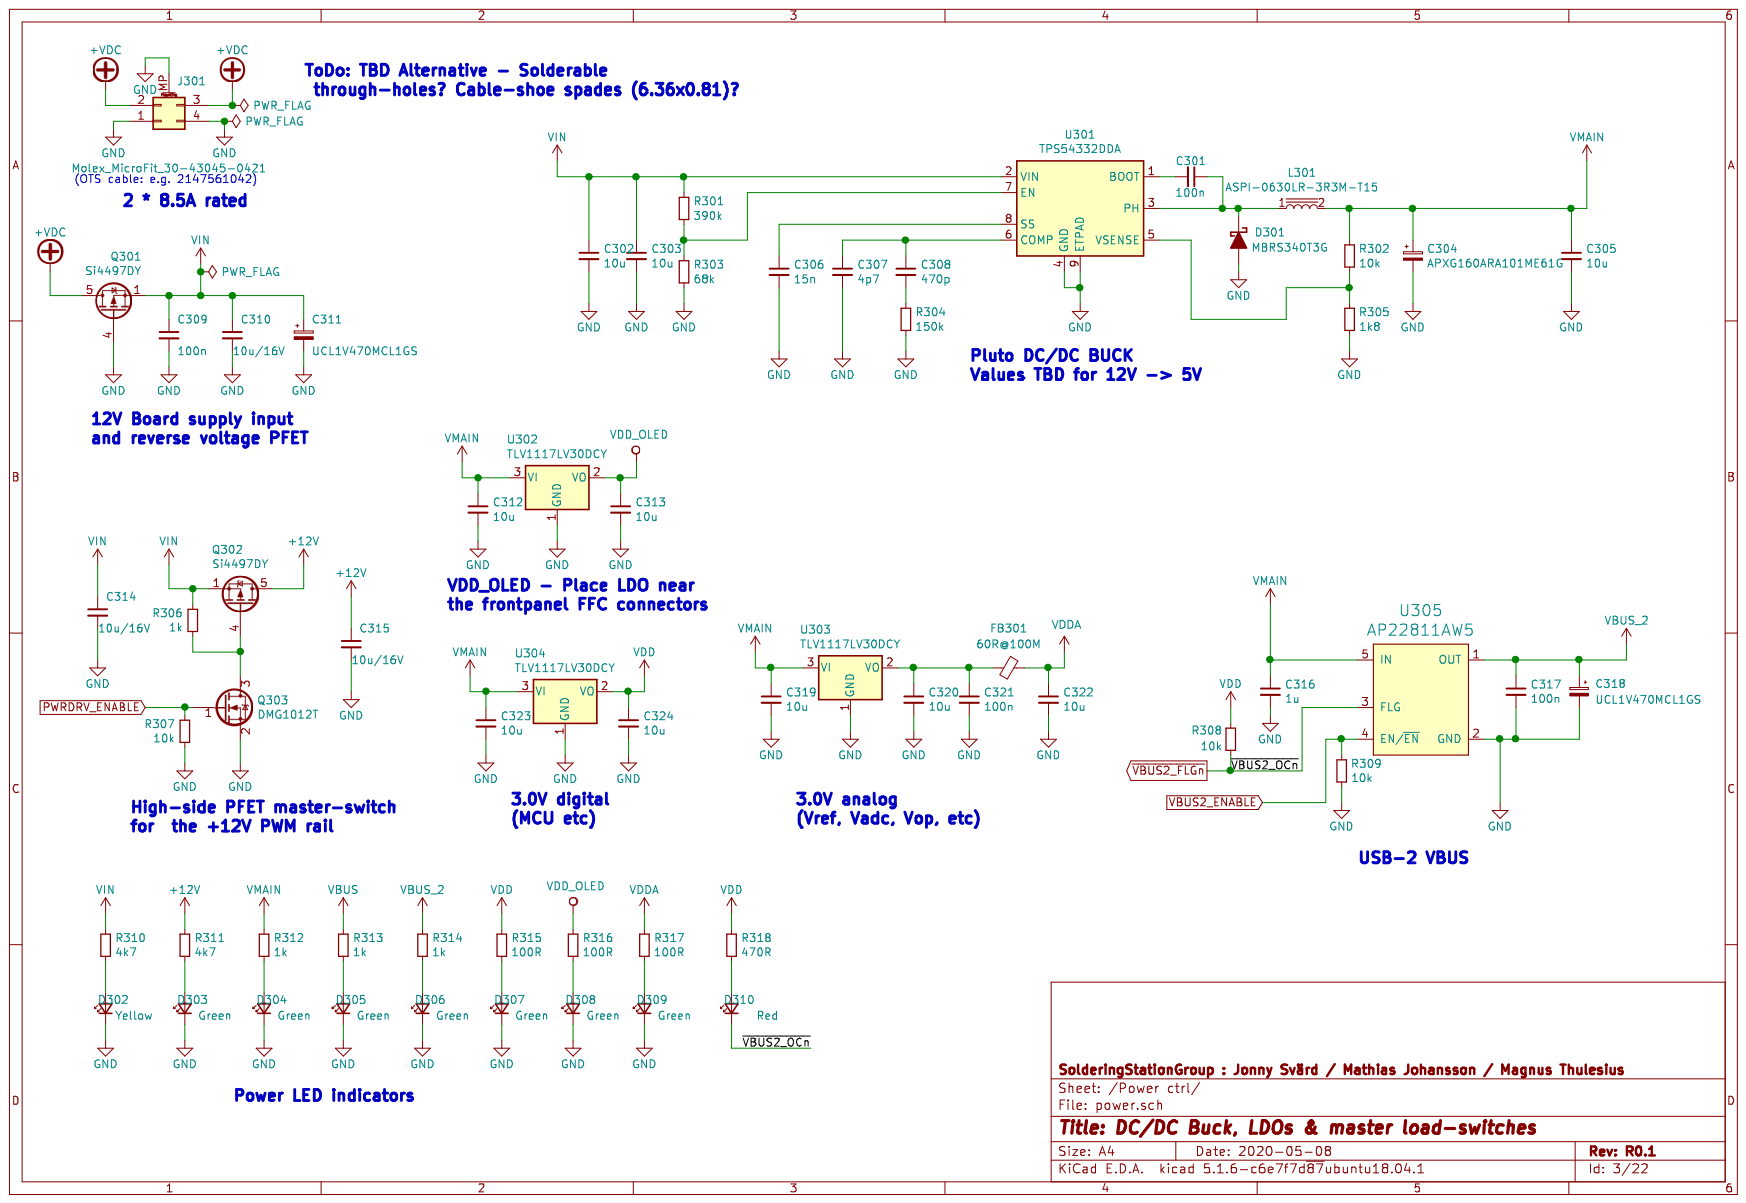
[picture p177: page 3]

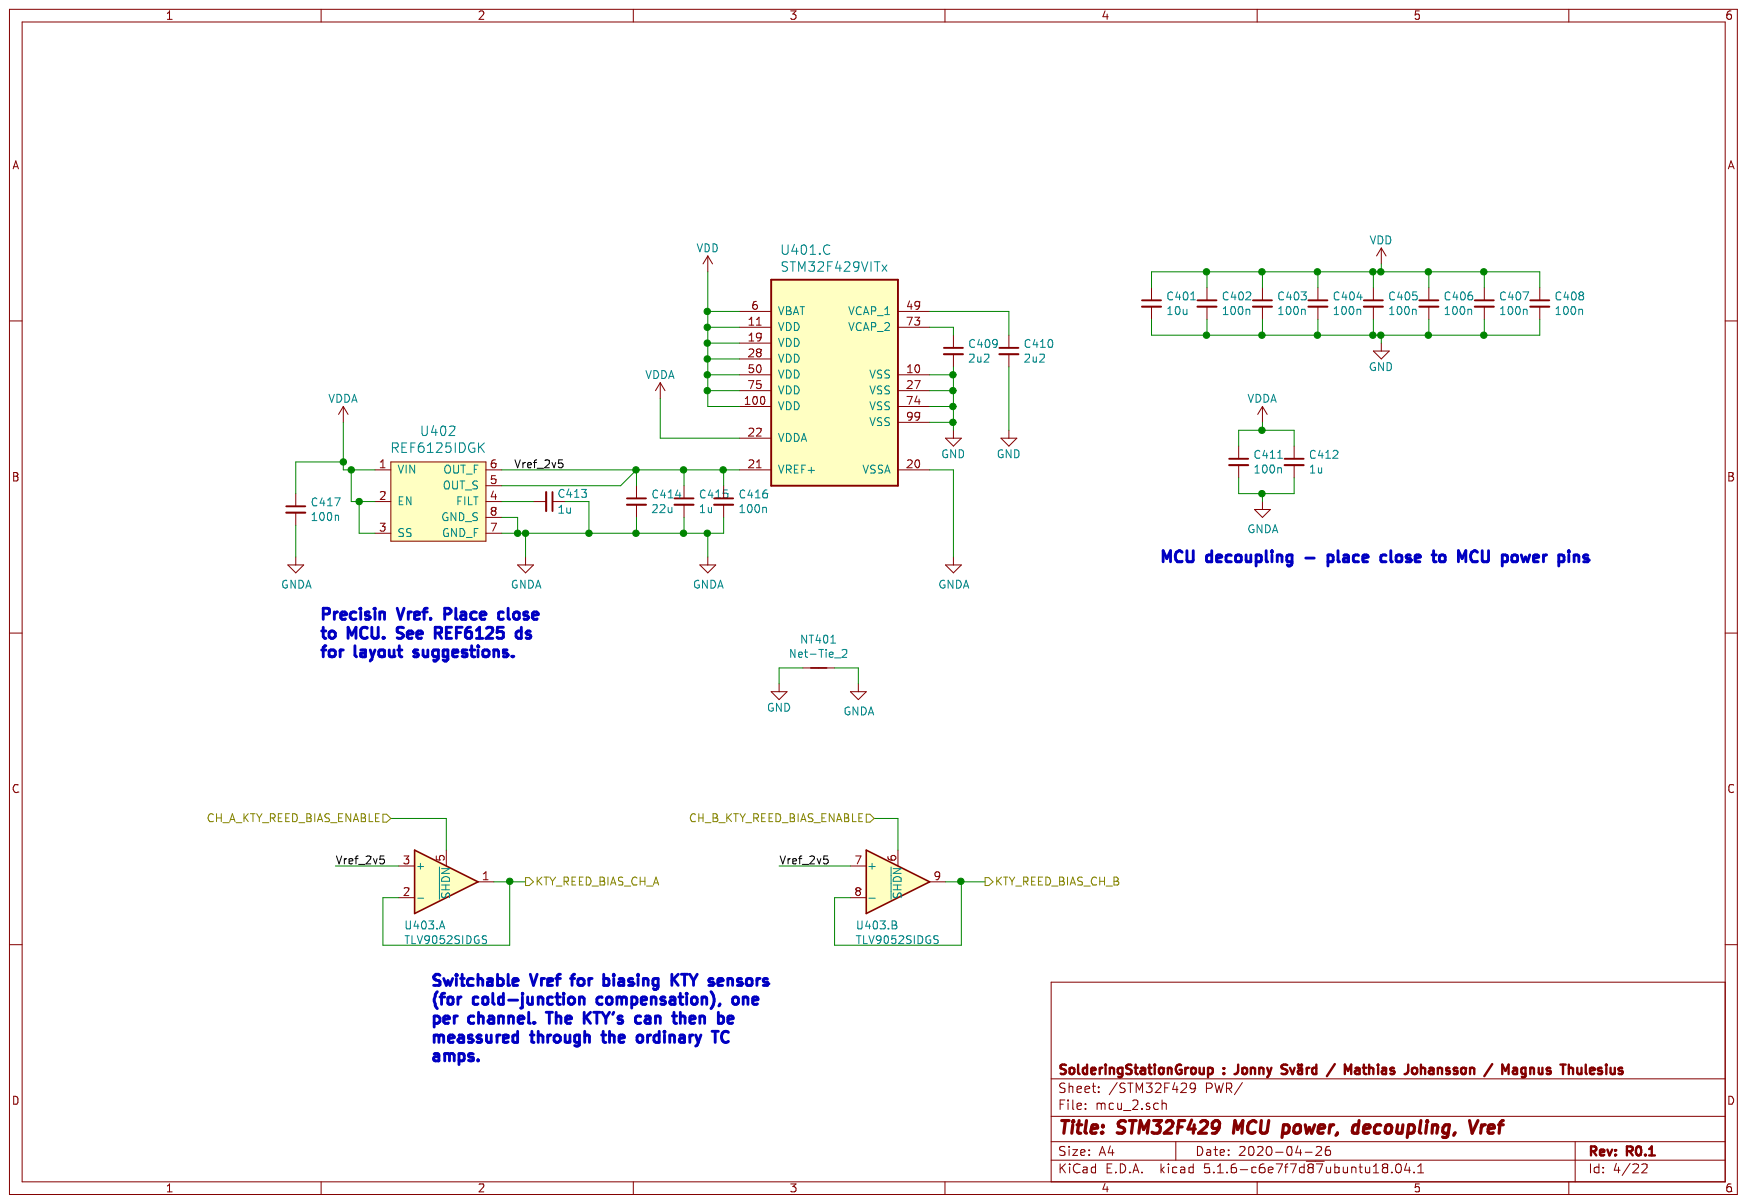
[picture p178: page 4]

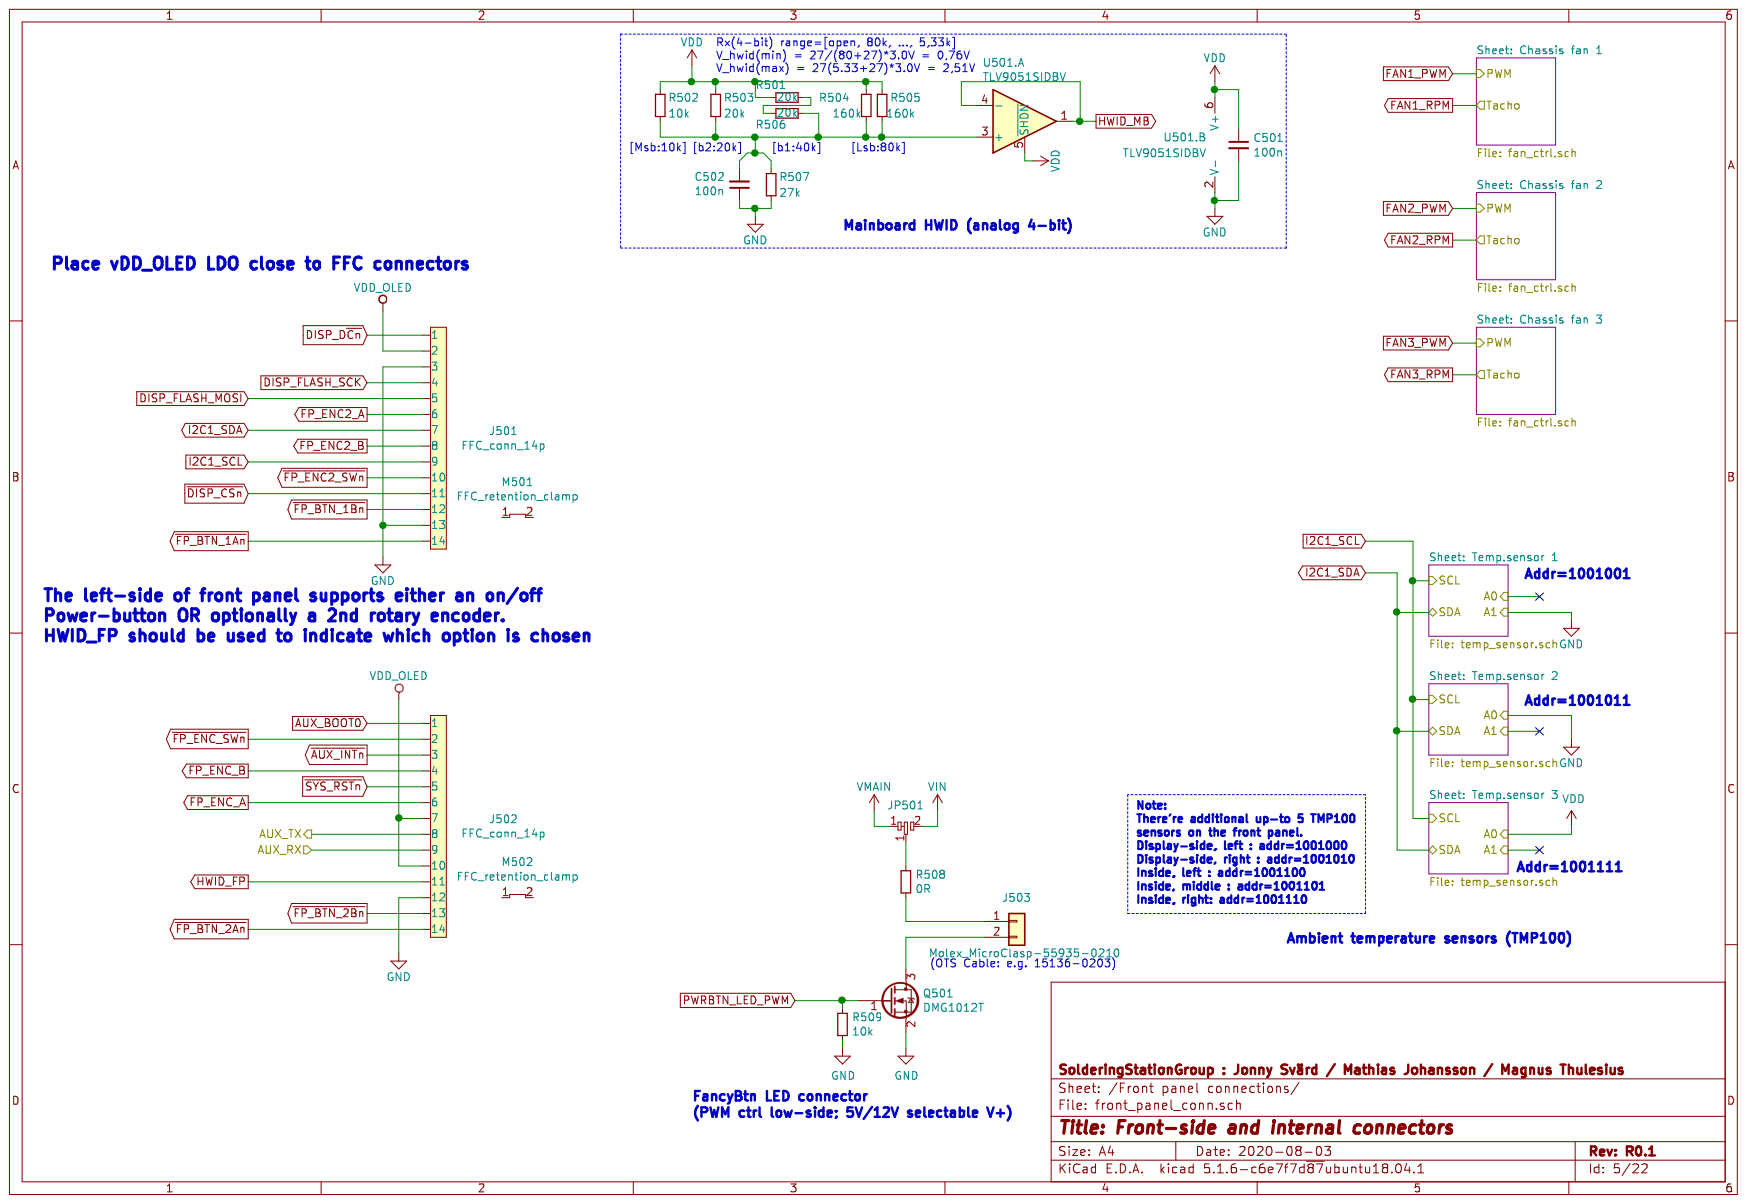
[picture p179: page 5]

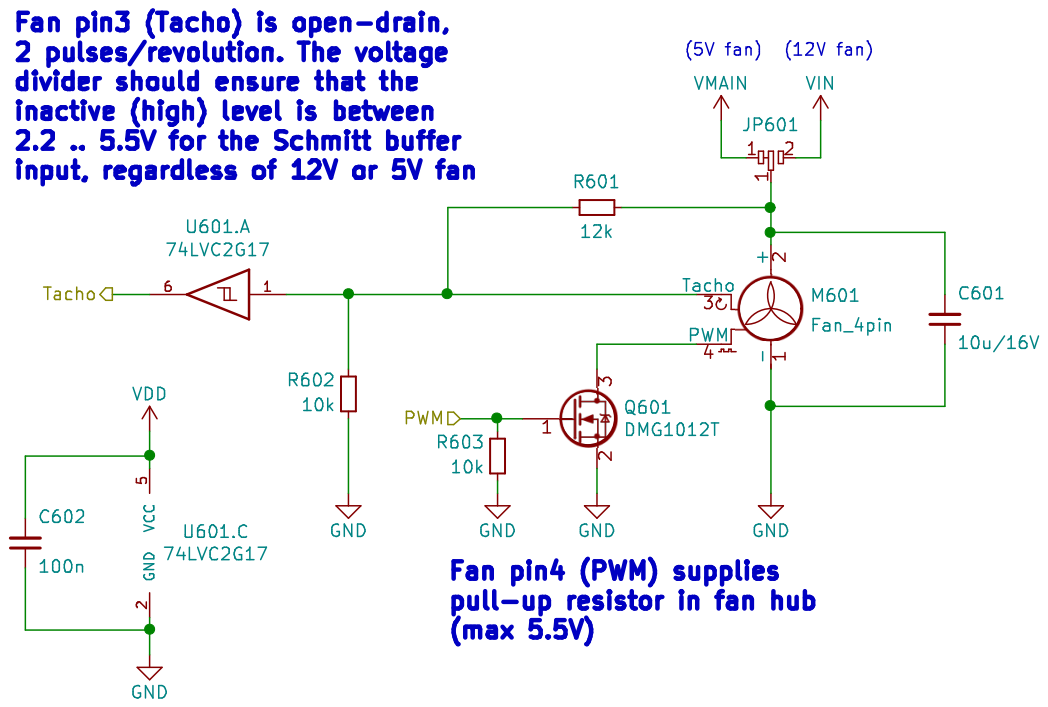
[picture p180: page 6]

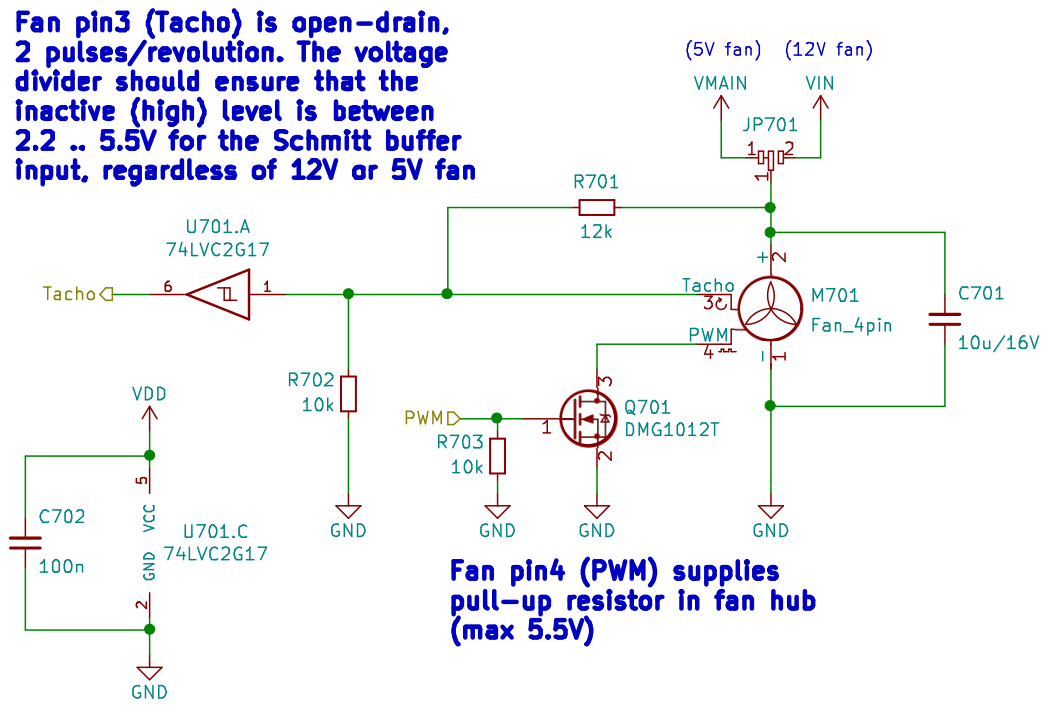
[picture p181: page 7]

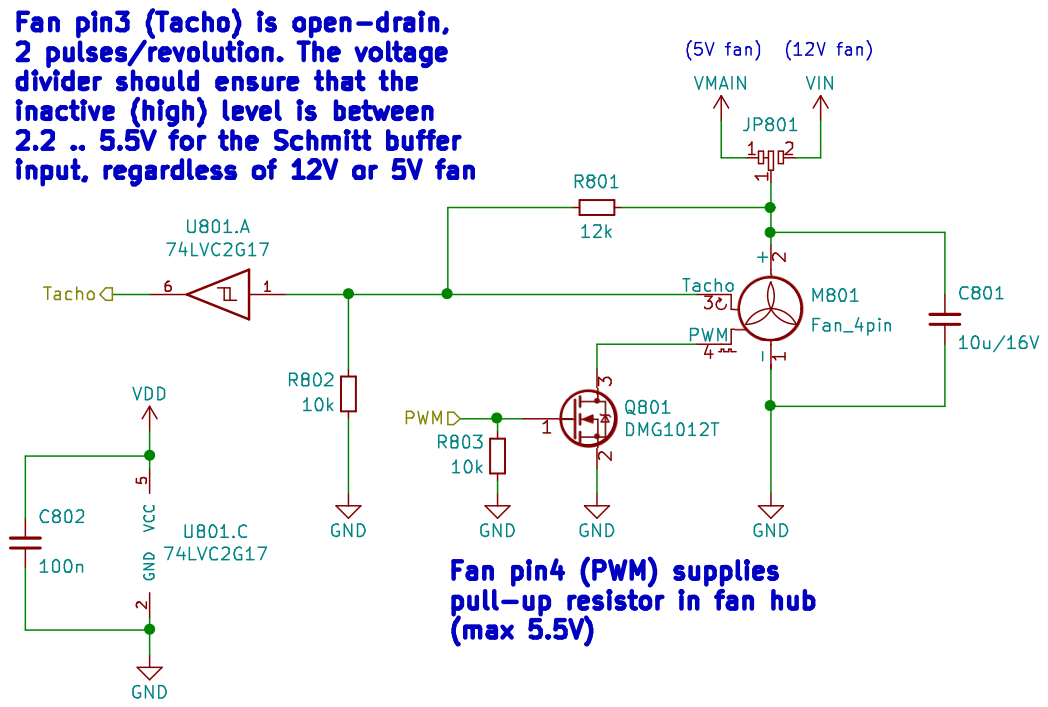
[picture p182: page 8]




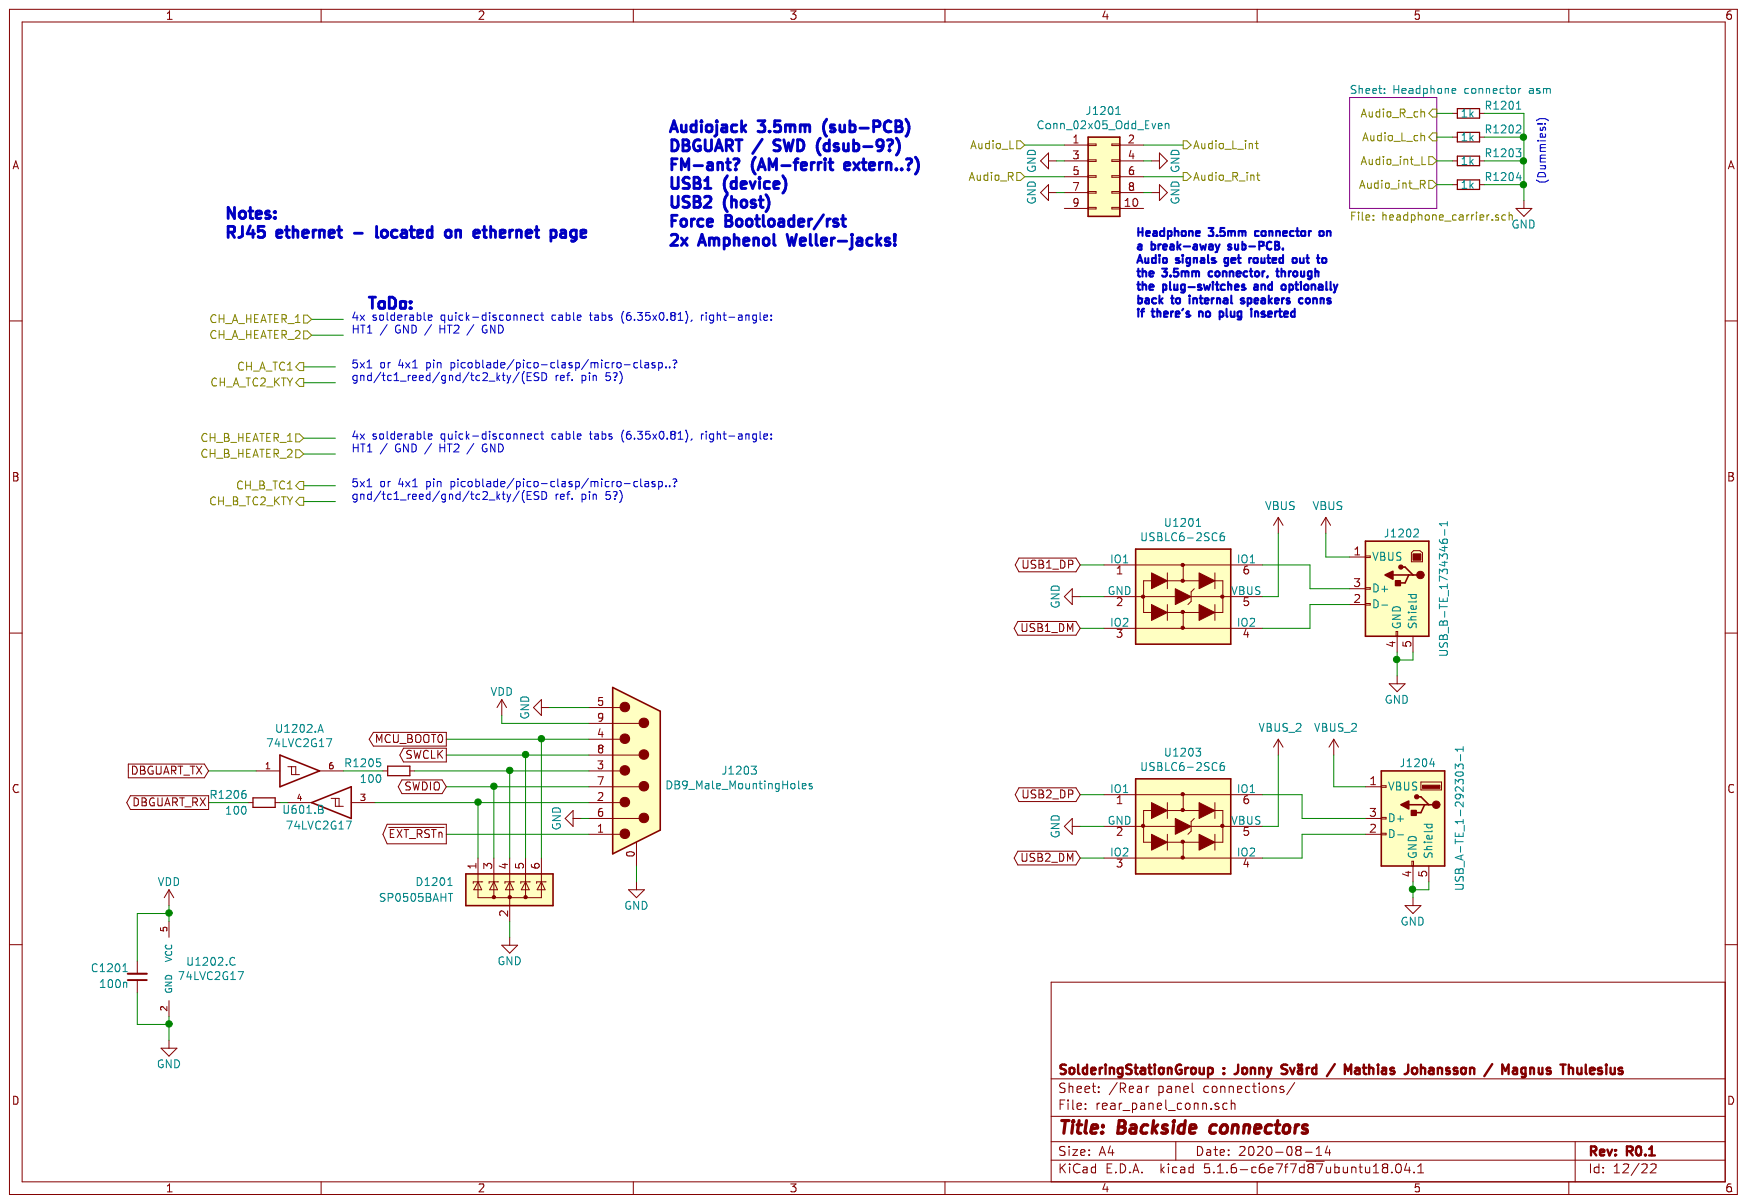
[picture p183: page 12]

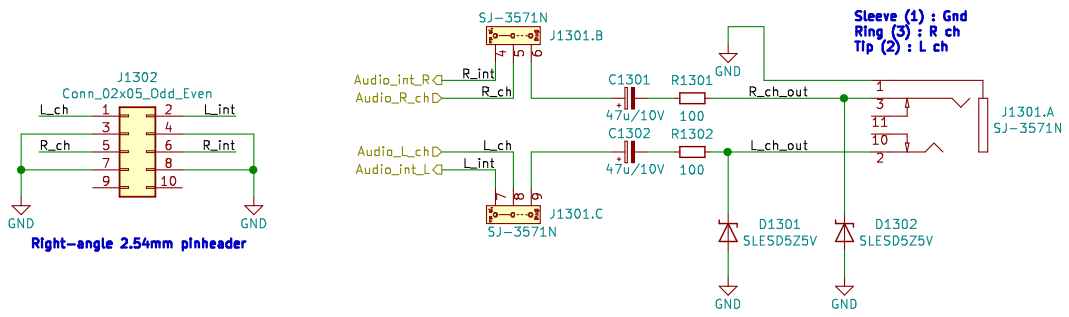
[picture p184: page 13]

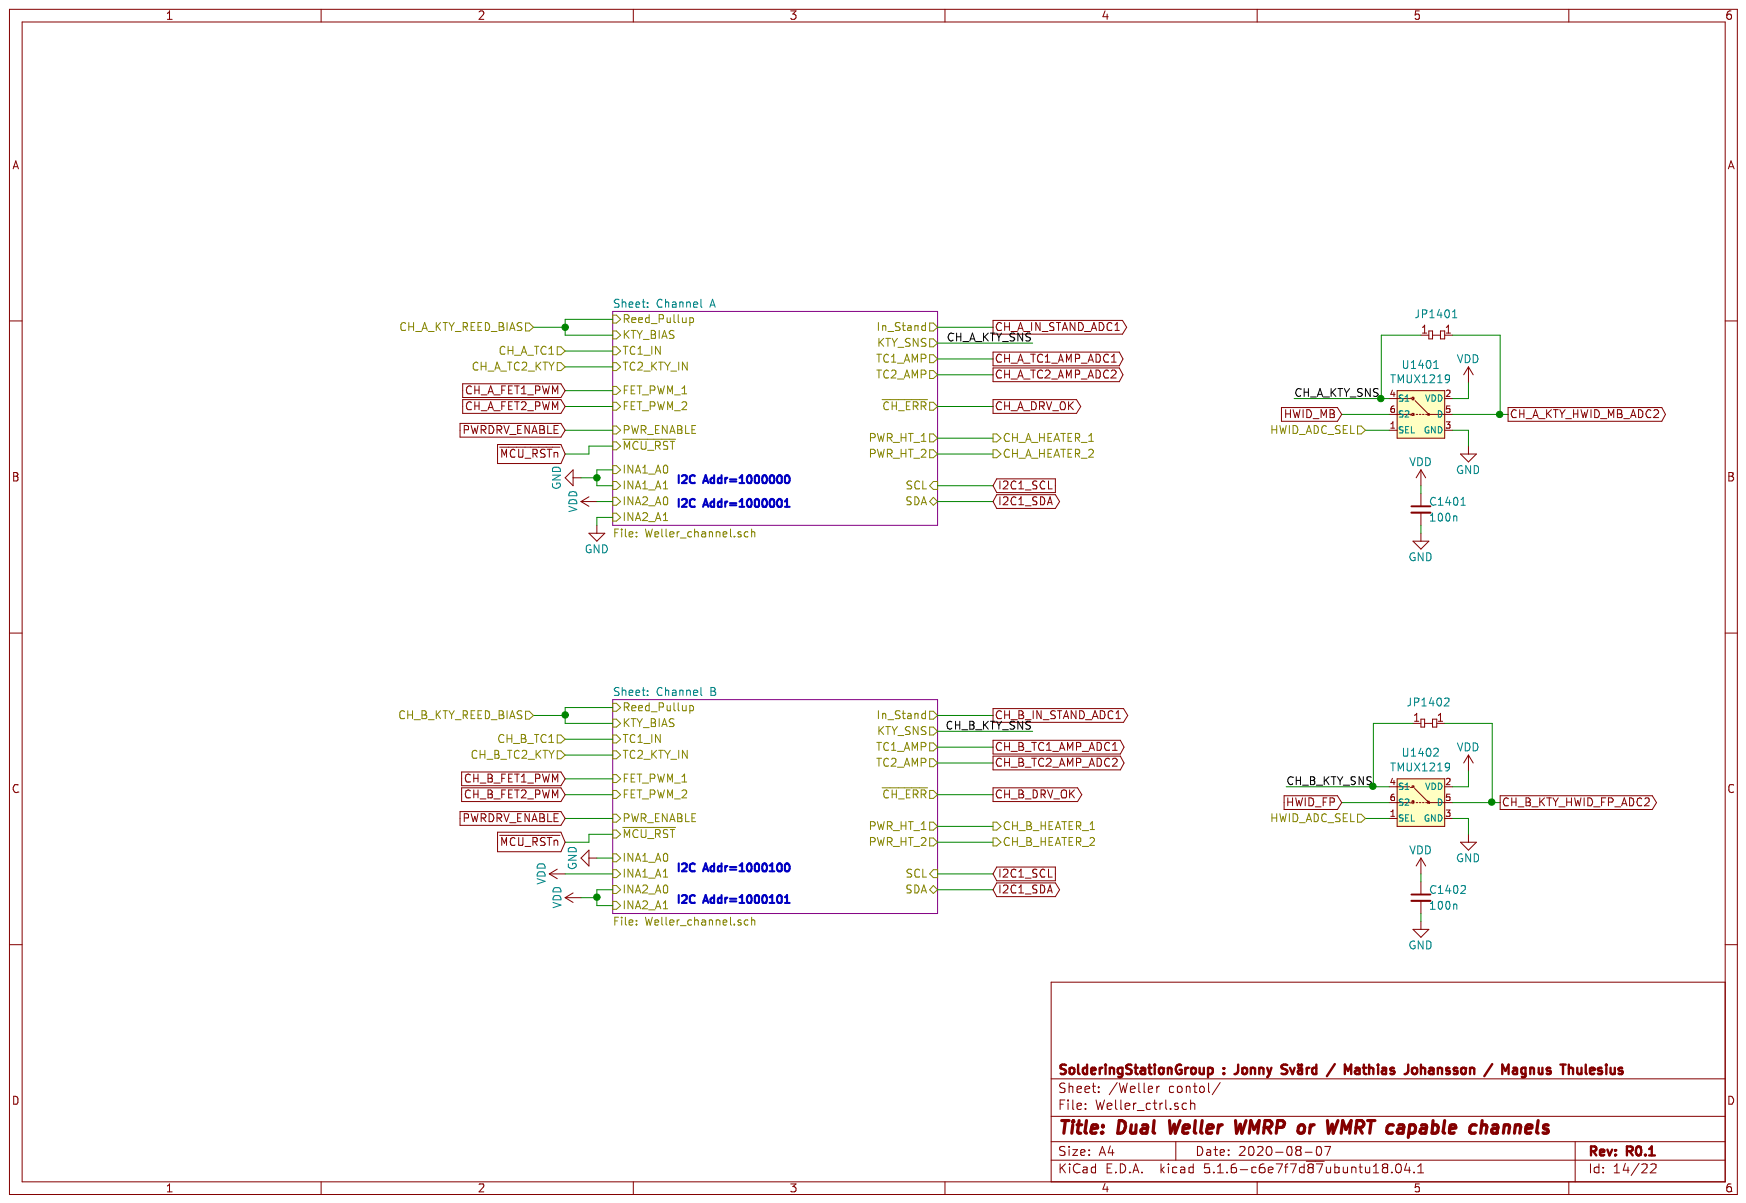
[picture p185: page 14]

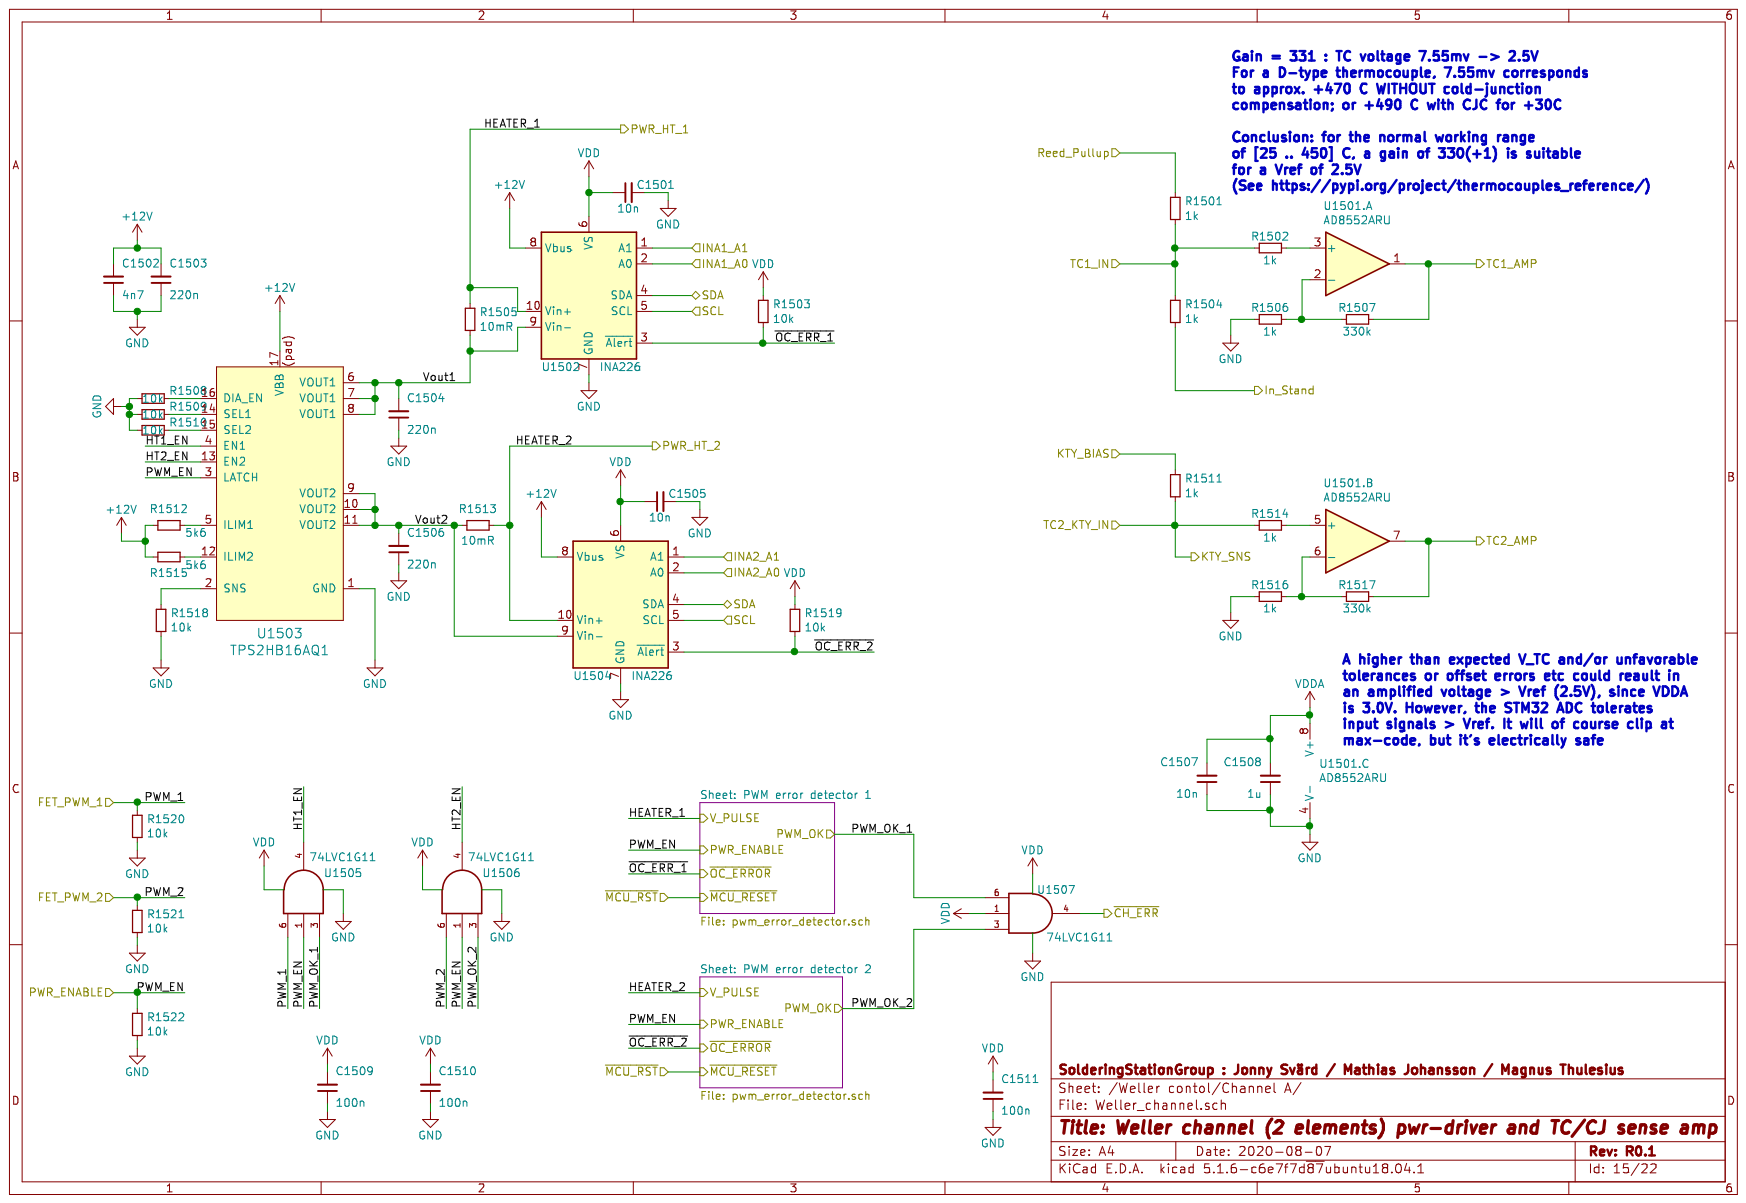
[picture p186: page 15]

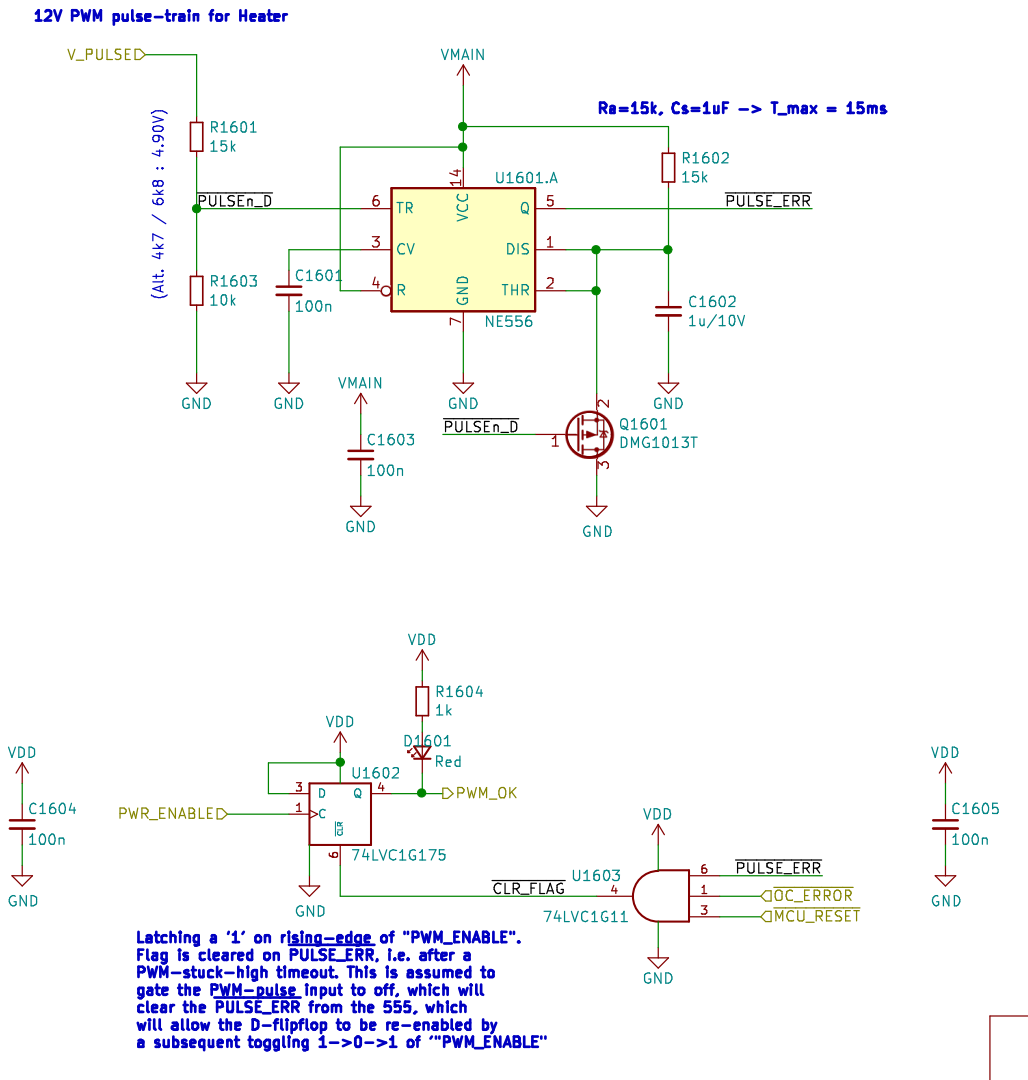
[picture p187: page 16]

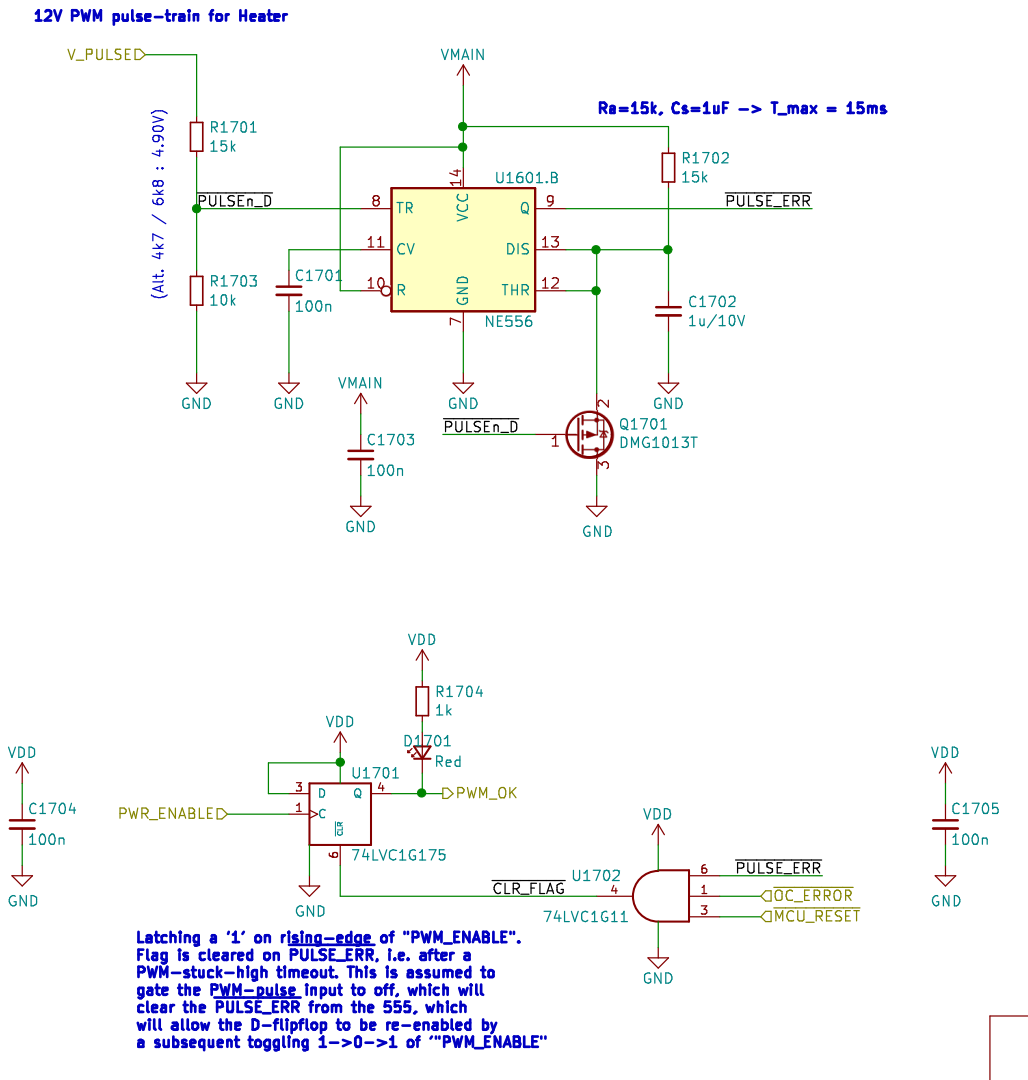
[picture p188: page 17]

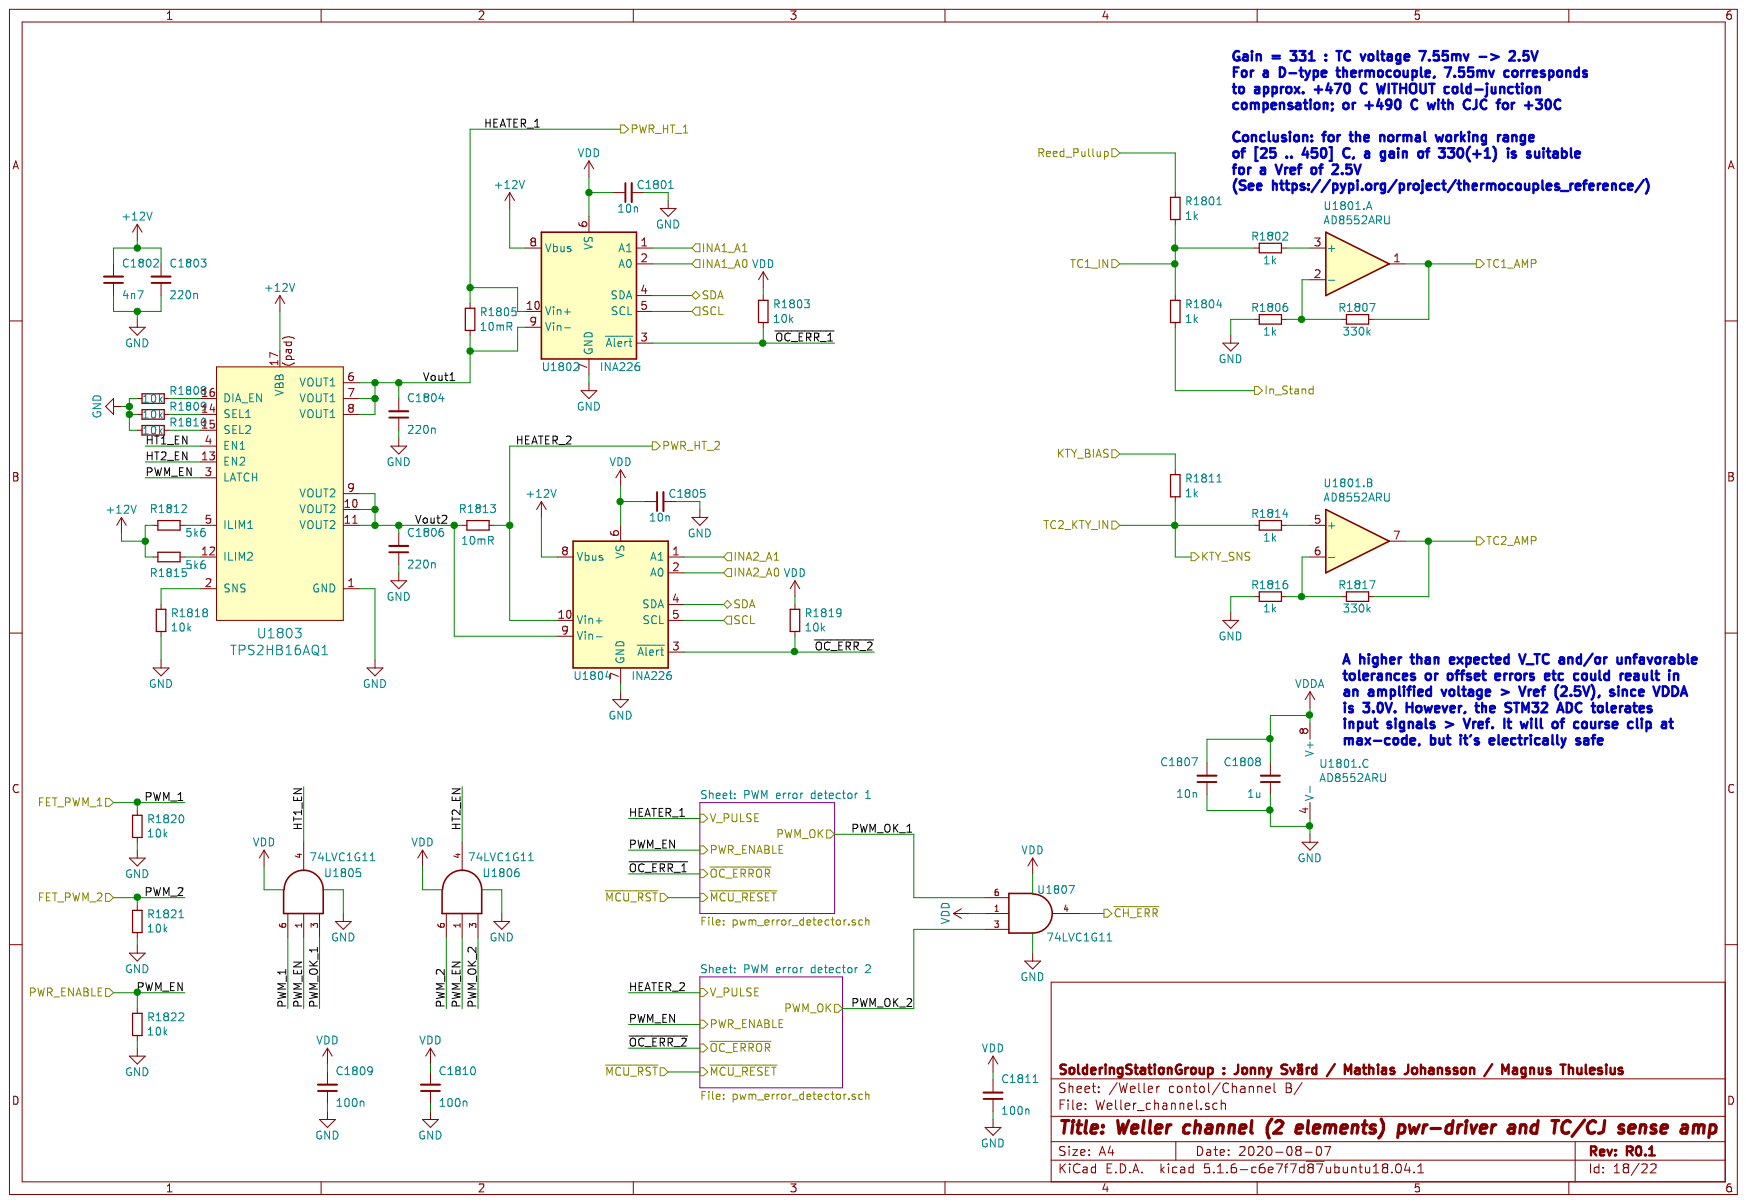
[picture p189: page 18]

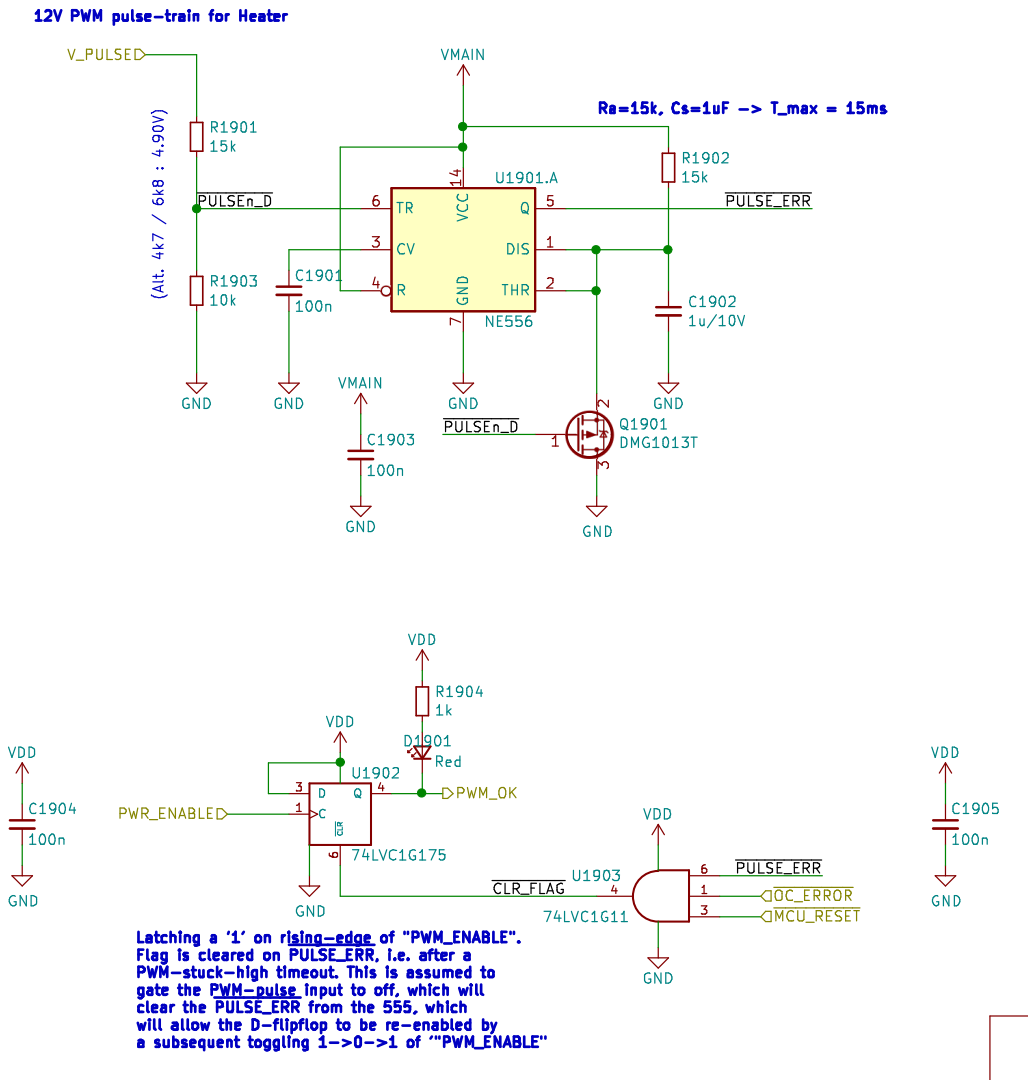
[picture p190: page 19]

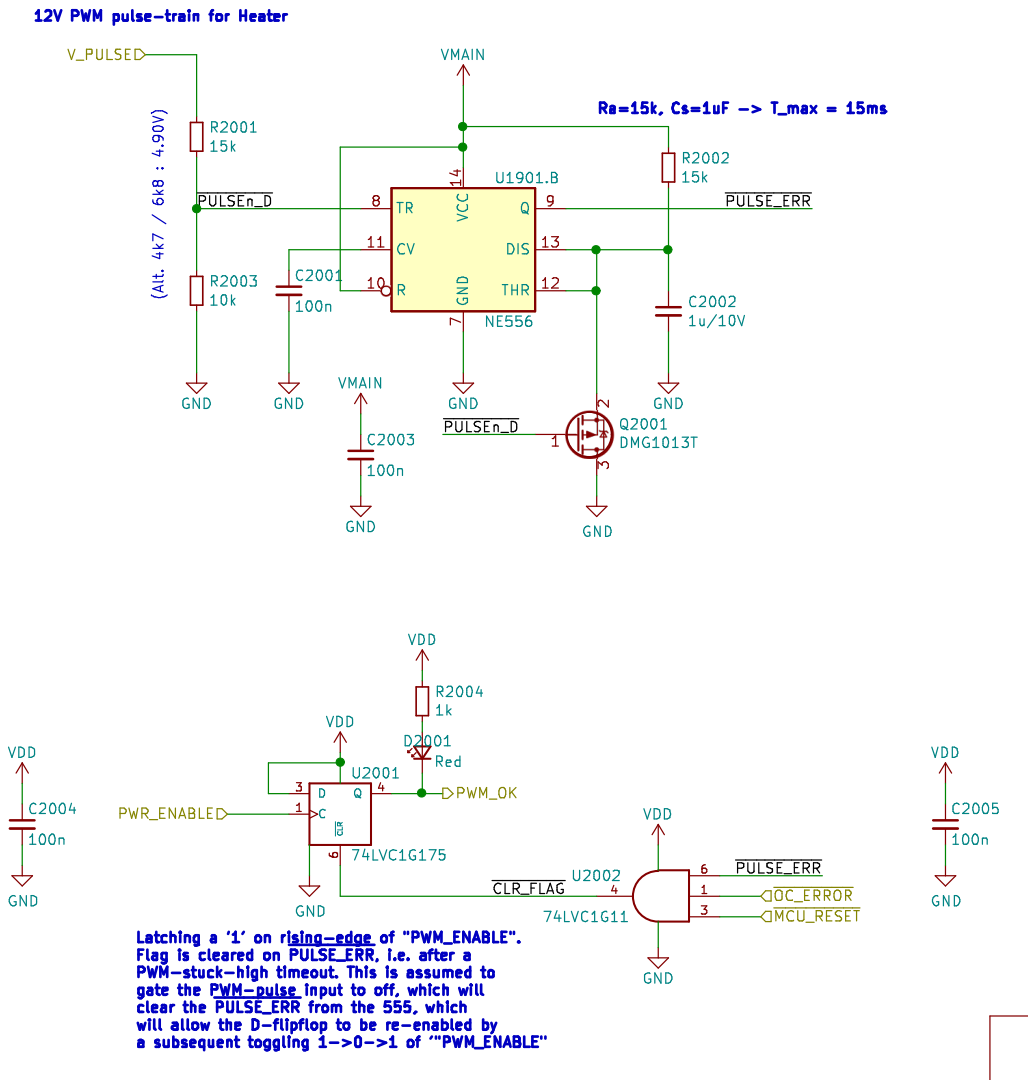
[picture p191: page 20]

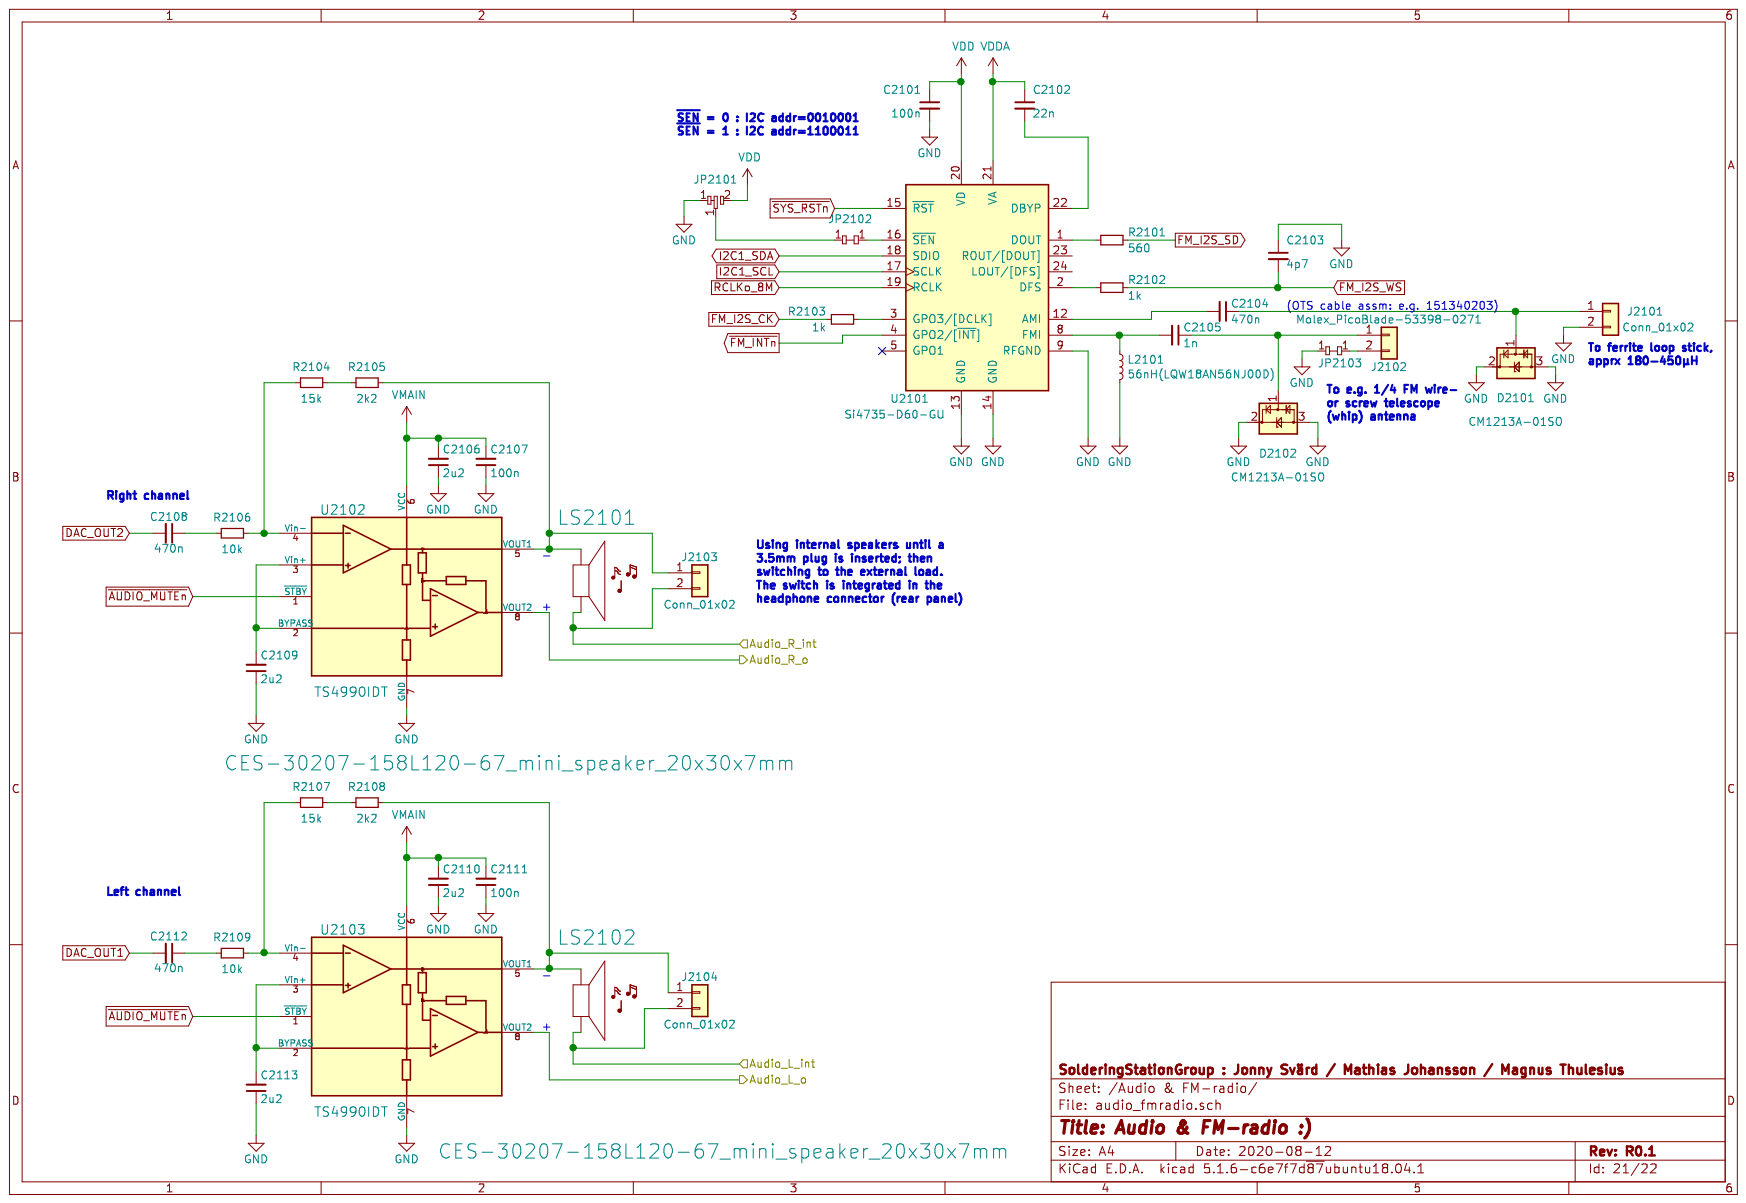
[picture p192: page 21]

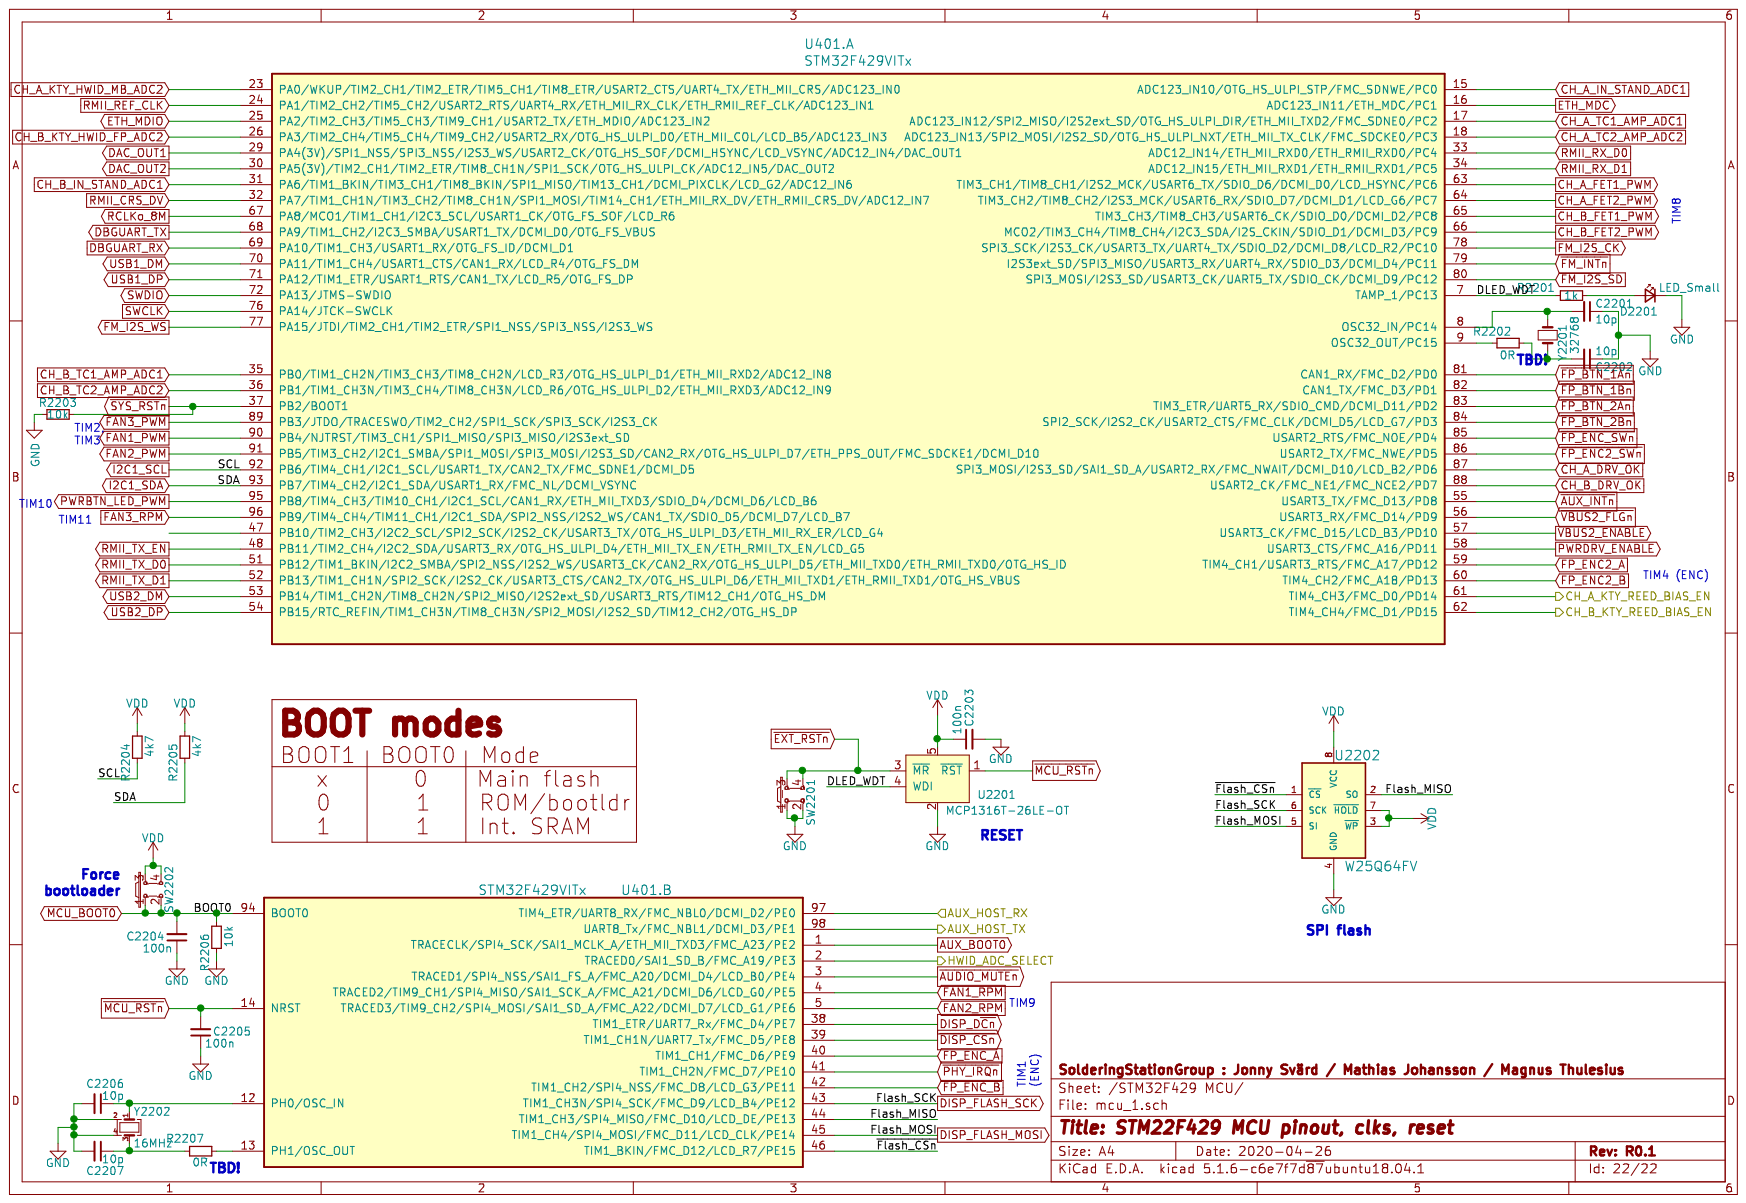
[picture p193: page 22]
