mjohansson/SolderingStation/hw/ss_fp_87dc3_bridgeboard/ss_fp_87dc3_bridgeboard.kicad_pcb

## KiCad design hw/ss_fp_87dc3_bridgeboard/ss_fp_87dc3_bridgeboard.kicad_pcb (2024-02-26)

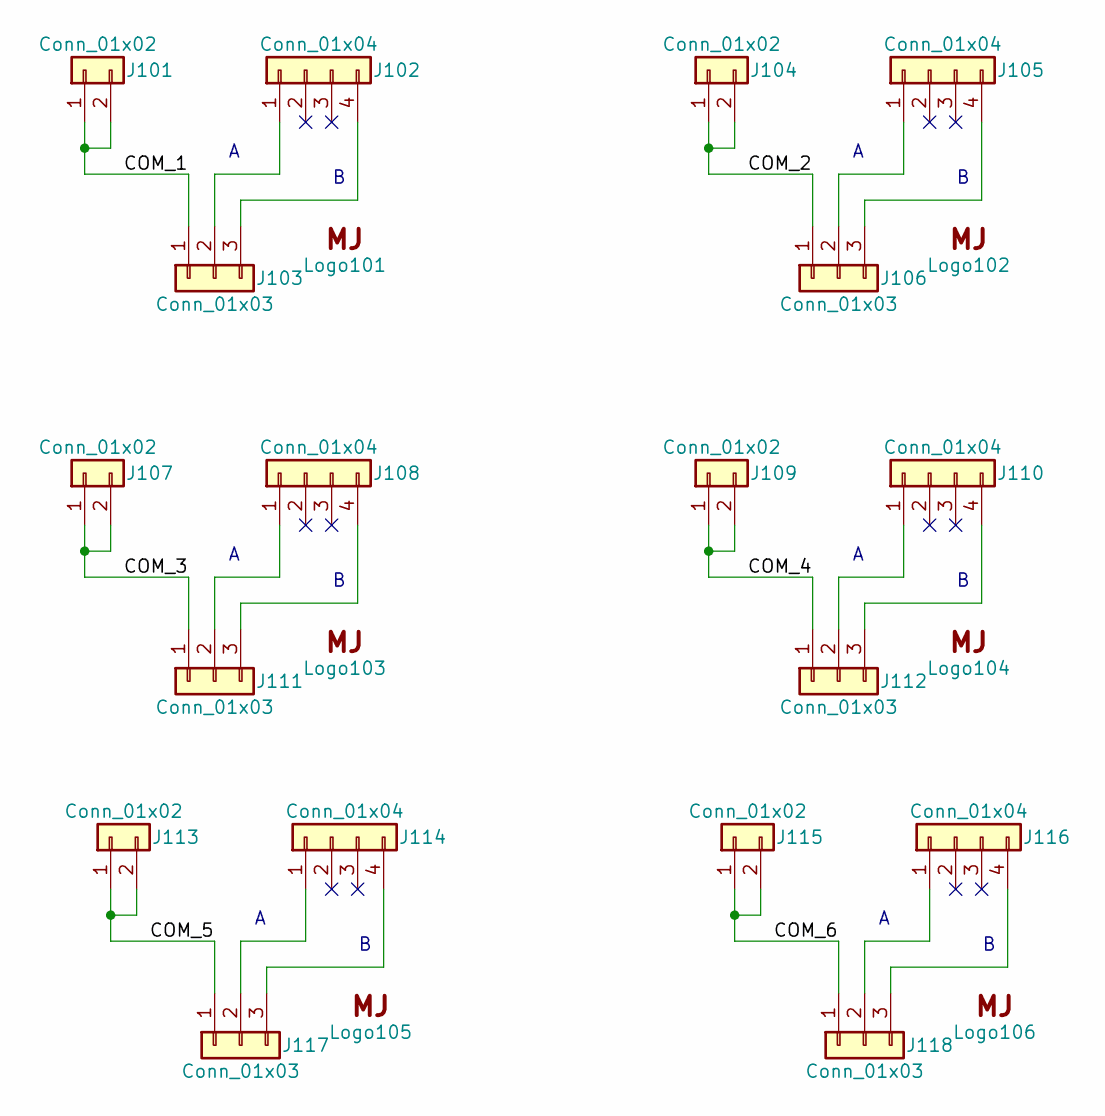
[picture p194: schematic ss_fp_87dc3_bridgeboard.kicad_sch, 87DC3_201 Bridge board]

Parts:
J101, J104, J107, J109, J113, J115: Conn_01x02; PinSocket_1x02_P2.54mm_Vertical
J102, J105, J108, J110, J114, J116: Conn_01x04; PinSocket_1x04_P2.54mm_Vertical
J103, J106, J111, J112, J117, J118: Conn_01x03; PinSocket_1x03_P2.54mm_Vertical
Logo101, Logo102, Logo103, Logo104, Logo105, Logo106: Logo_MJ; MJ_Mini

Connections:
/COM_1: J101.1, J101.2, J103.1
/COM_2: J104.1, J104.2, J106.1
/COM_3: J107.1, J107.2, J111.1
/COM_4: J109.1, J109.2, J112.1
/COM_5: J113.1, J113.2, J117.1
/COM_6: J115.1, J115.2, J118.1
unnamed: J102.1, J103.2
unnamed: J102.4, J103.3
unnamed: J105.1, J106.2
unnamed: J105.4, J106.3
unnamed: J108.1, J111.2
unnamed: J108.4, J111.3
unnamed: J110.1, J112.2
unnamed: J110.4, J112.3
unnamed: J114.1, J117.2
unnamed: J114.4, J117.3
unnamed: J116.1, J118.2
unnamed: J116.4, J118.3

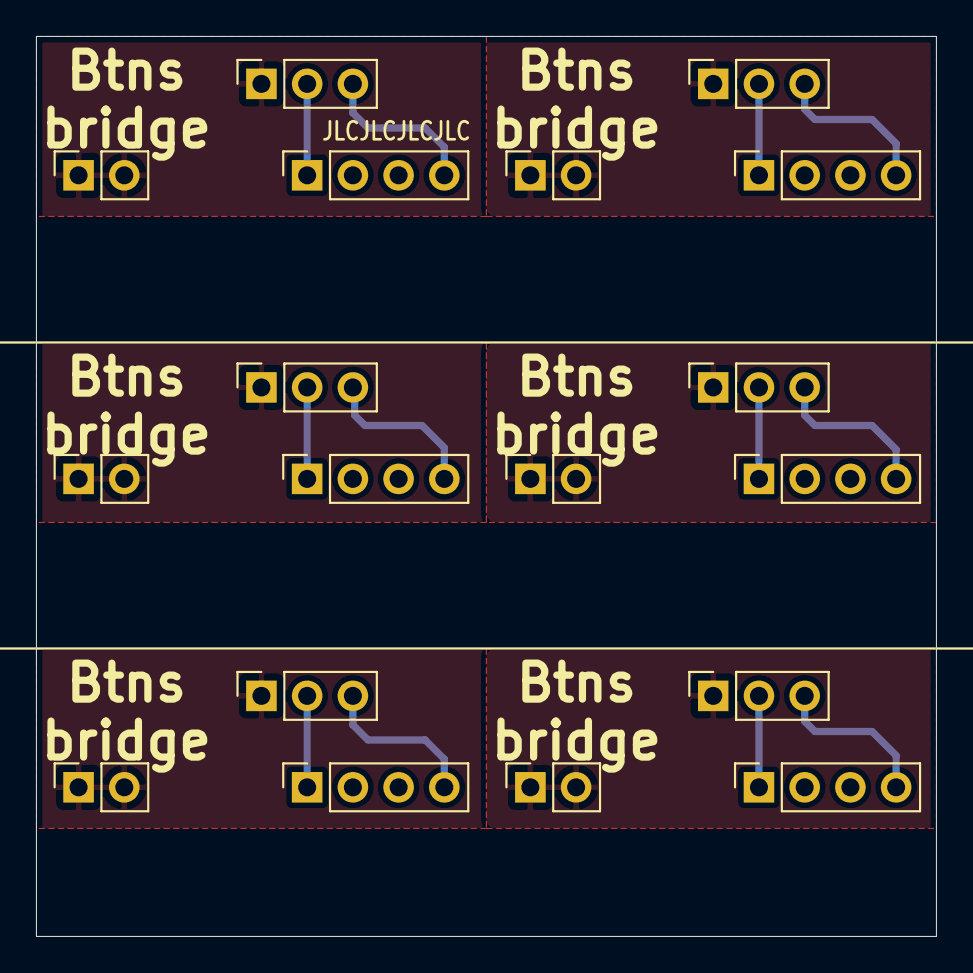
[picture p195: board ss_fp_87dc3_bridgeboard.kicad_pcb from above]

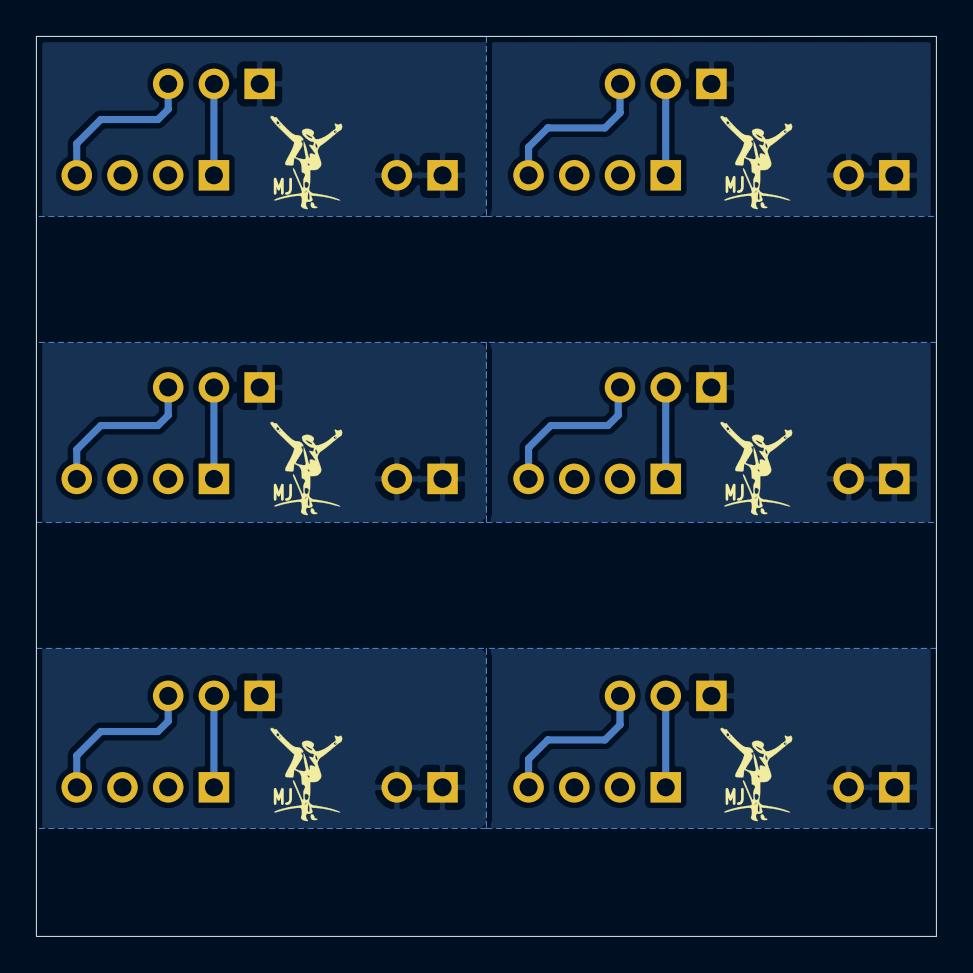
[picture p196: board ss_fp_87dc3_bridgeboard.kicad_pcb from below]

Board: 2 copper layers, 50.0 x 50.0 mm, 24 parts (6 on the bottom side), 18 nets.
