mjohansson/SolderingStation/hw/ss_frontpanel_outer_plate/ss_frontpanel_outer_plate.kicad_pcb

## KiCad design hw/ss_frontpanel_outer_plate/ss_frontpanel_outer_plate.kicad_pcb (2024-02-26)

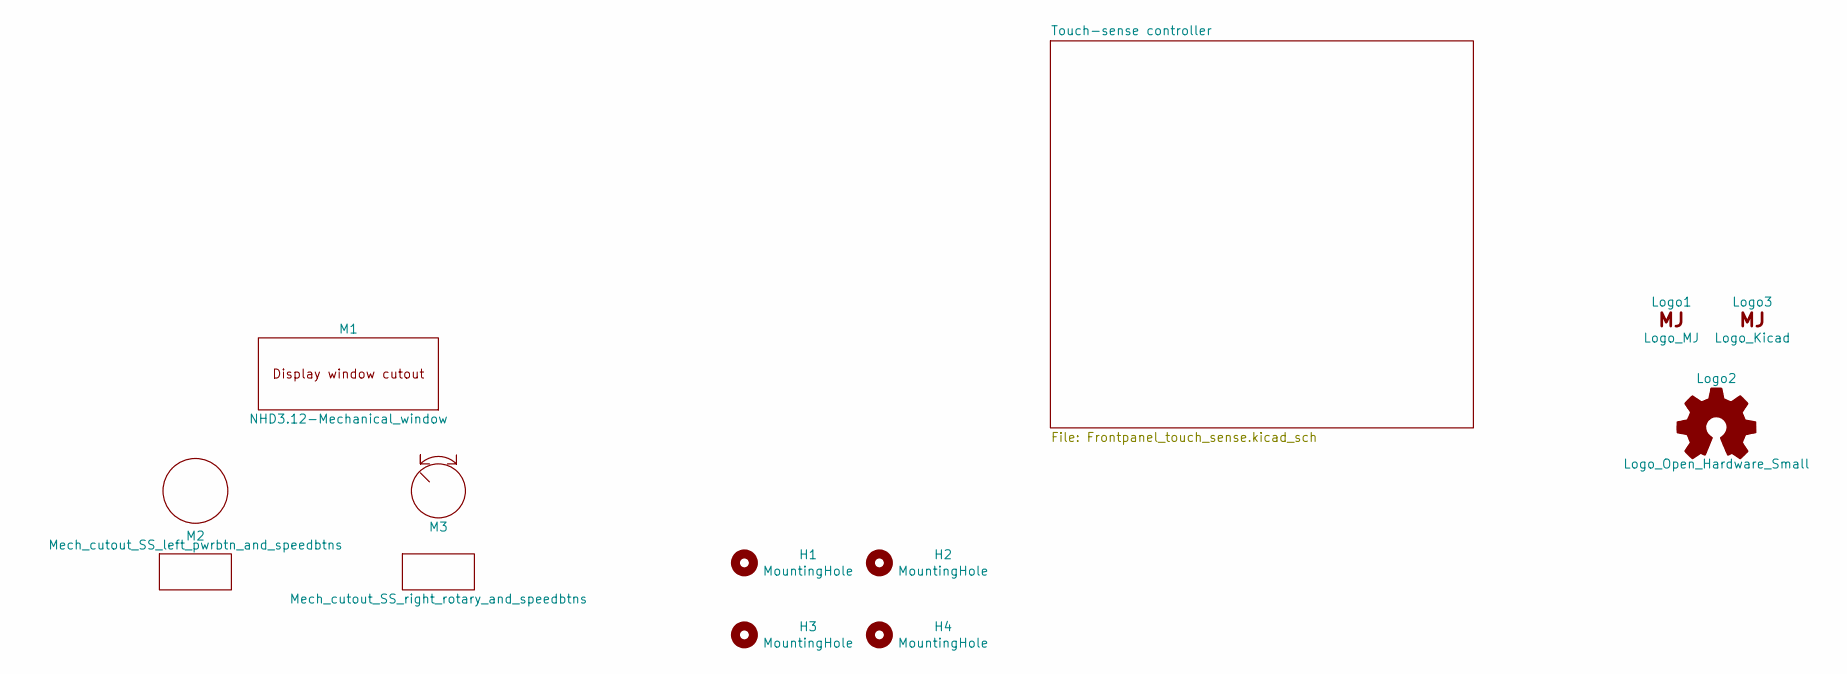
[picture p197: schematic ss_frontpanel_outer_plate.kicad_sch, Solderstation Frontpanel (outer plate)]

Parts:
H1, H2, H3, H4: MountingHole; MountingHole_3.5mm_Hammond_panel_screws
Logo1: Logo_MJ; MJ_10.3x12.7
Logo2: Logo_Open_Hardware_Small; OSHW-Logo_5.7x6mm_SilkScreen
Logo3: Logo_Kicad; KiCad-Logo2_5mm_SilkScreen
M1: NHD3.12-Mechanical_window; NHD3_12-Reverse_Bezel
M2: Mech_cutout_SS_left_pwrbtn_and_speedbtns; Frontpanel_L_Powerbtn_Pushbtns_outer_cutouts
M3: Mech_cutout_SS_right_rotary_and_speedbtns; Frontpanel_R_RotaryEnc_Pushbtns_outer_cutouts

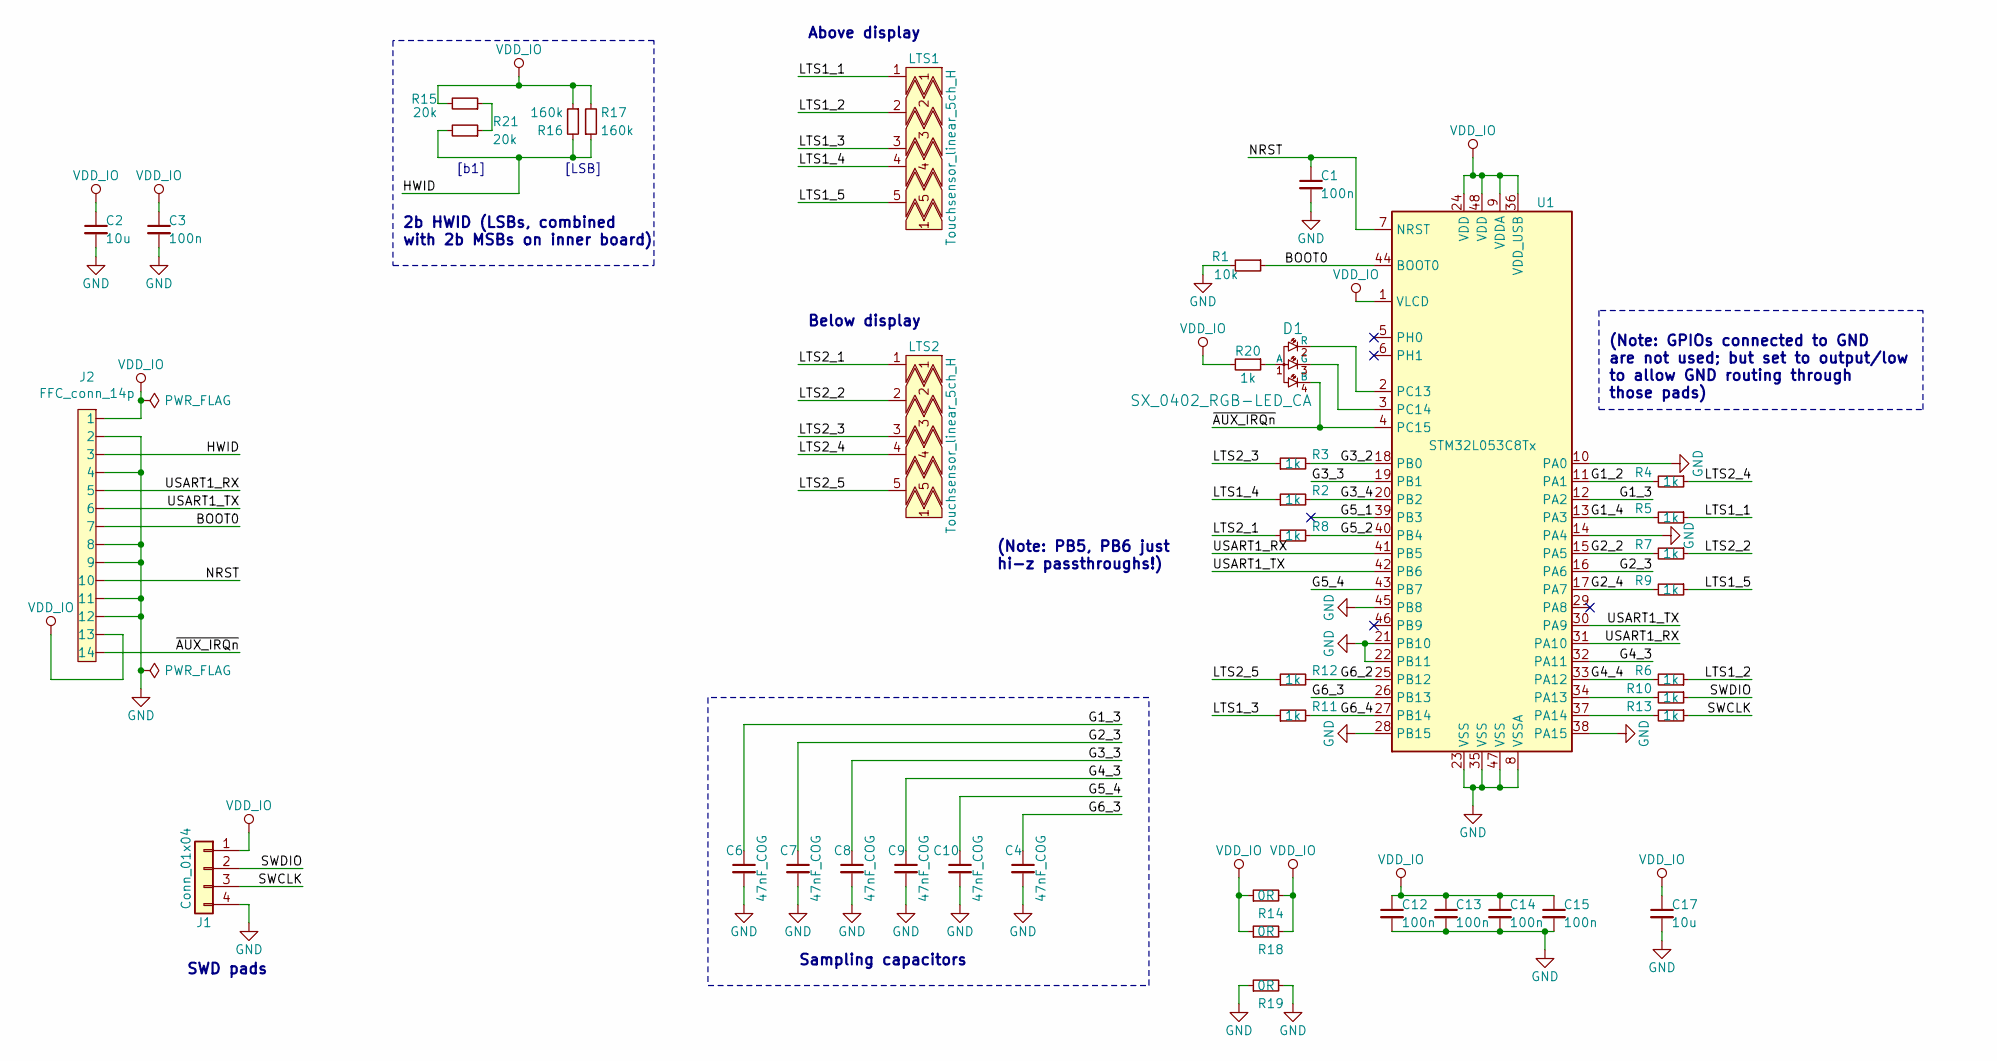
[picture p198: schematic Frontpanel_touch_sense.kicad_sch, Touch-sense MCU & connectors]

Parts:
C1, C3, C12, C13, C14, C15: 100n; C_0402_1005Metric
C2, C17: 10u; C_0402_1005Metric
C4, C6, C7, C8, C9, C10: 47nF_COG; C_1206_3216Metric
D1: SX_0402_RGB-LED_CA; SX_0402_RGB-CA-06
J1: Conn_01x04; 4pin_SWD_SMT_100mil
J2: FFC_conn_14p; FPC_14p_05mm-WE_687114182122
LTS1, LTS2: Touchsensor_linear_5ch_H; Touchsensor_linear_slider-5ch_H_90x8mm
R1: 10k; R_0402_1005Metric
R2, R3, R4, R5, R6, R7, R9, R10, R13, R20: 1k; R_0402_1005Metric
R8, R11: 1k; R_0603_1608Metric
R12: 1k; R_1206_3216Metric
R14, R18, R19: 0R; R_0603_1608Metric
R15, R21: 20k; R_0402_1005Metric
R16, R17: 160k; R_0402_1005Metric
U1: STM32L053C8Tx; LQFP-48_7x7mm_P0.5mm

Connections:
/Touch-sense controller/BOOT0: J2.7, R1.1, U1.44 (BOOT0)
/Touch-sense controller/G1_2: R4.2, U1.11 (PA1)
/Touch-sense controller/G1_3: C6.1, U1.12 (PA2)
/Touch-sense controller/G1_4: R5.2, U1.13 (PA3)
/Touch-sense controller/G2_2: R7.2, U1.15 (PA5)
/Touch-sense controller/G2_3: C7.1, U1.16 (PA6)
/Touch-sense controller/G2_4: R9.2, U1.17 (PA7)
/Touch-sense controller/G3_2: R3.2, U1.18 (PB0)
/Touch-sense controller/G3_3: C8.1, U1.19 (PB1)
/Touch-sense controller/G3_4: R2.2, U1.20 (PB2)
/Touch-sense controller/G4_3: C9.1, U1.32 (PA11)
/Touch-sense controller/G4_4: R6.2, U1.33 (PA12)
/Touch-sense controller/G5_1: U1.39 (PB3)
/Touch-sense controller/G5_2: R8.2, U1.40 (PB4)
/Touch-sense controller/G5_4: C10.1, U1.43 (PB7)
/Touch-sense controller/G6_2: R12.2, U1.25 (PB12)
/Touch-sense controller/G6_3: C4.1, U1.26 (PB13)
/Touch-sense controller/G6_4: R11.2, U1.27 (PB14)
/Touch-sense controller/HWID: J2.3, R16.2, R17.1, R21.2
/Touch-sense controller/LTS1_1: LTS1.1, R5.1
/Touch-sense controller/LTS1_2: LTS1.2, R6.1
/Touch-sense controller/LTS1_3: LTS1.3, R11.1
/Touch-sense controller/LTS1_4: LTS1.4, R2.1
/Touch-sense controller/LTS1_5: LTS1.5, R9.1
/Touch-sense controller/LTS2_1: LTS2.1, R8.1
/Touch-sense controller/LTS2_2: LTS2.2, R7.1
/Touch-sense controller/LTS2_3: LTS2.3, R3.1
/Touch-sense controller/LTS2_4: LTS2.4, R4.1
/Touch-sense controller/LTS2_5: LTS2.5, R12.1
/Touch-sense controller/NRST: C1.1, J2.10, U1.7 (NRST)
/Touch-sense controller/SWCLK: J1.3, R13.1
/Touch-sense controller/SWDIO: J1.2, R10.1
/Touch-sense controller/USART1_RX: J2.5, U1.31 (PA10), U1.41 (PB5)
/Touch-sense controller/USART1_TX: J2.6, U1.30 (PA9), U1.42 (PB6)
/Touch-sense controller/~AUX_IRQn: D1.4 (B), J2.14, U1.4 (PC15)
GND: C1.2, C2.2, C3.2, C4.2, C6.2, C7.2, C8.2, C9.2, C10.2, C12.2, C13.2, C14.2, C15.2, C17.2, J1.4, J2.2, J2.4, J2.8, J2.9, J2.11, J2.12, R1.2, R19.1, R19.2, U1.8 (VSSA), U1.10 (PA0), U1.14 (PA4), U1.21 (PB10), U1.22 (PB11), U1.23 (VSS), U1.28 (PB15), U1.35 (VSS), U1.38 (PA15), U1.45 (PB8), U1.47 (VSS)
unnamed: D1.1 (A), R20.1
unnamed: D1.2 (R), U1.2 (PC13)
unnamed: D1.3 (G), U1.3 (PC14)
unnamed: R10.2, U1.34 (PA13)
unnamed: R13.2, U1.37 (PA14)
unnamed: R15.1, R21.1
VDD_IO: C2.1, C3.1, C12.1, C13.1, C14.1, C15.1, C17.1, J1.1, J2.1, J2.13, R14.1, R14.2, R15.2, R16.1, R17.2, R18.1, R18.2, R20.2, U1.1 (VLCD), U1.9 (VDDA), U1.24 (VDD), U1.36 (VDD_USB), U1.48 (VDD)

Notes on the sheet:
(Note: PB5, PB6 just hi-z passthroughs!)
(Note: GPIOs connected to GND are not used; but set to output/low to allow GND routing through those pads)
SWD pads
[LSB]
Sampling capacitors
[b1]
Below display
2b HWID (LSBs, combined with 2b MSBs on inner board)
Above display

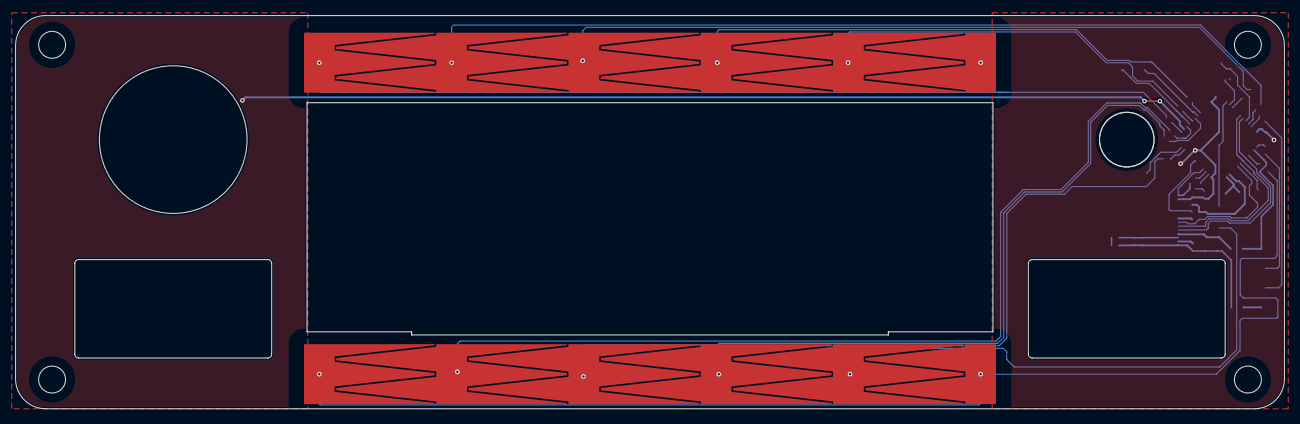
[picture p199: board ss_frontpanel_outer_plate.kicad_pcb from above]

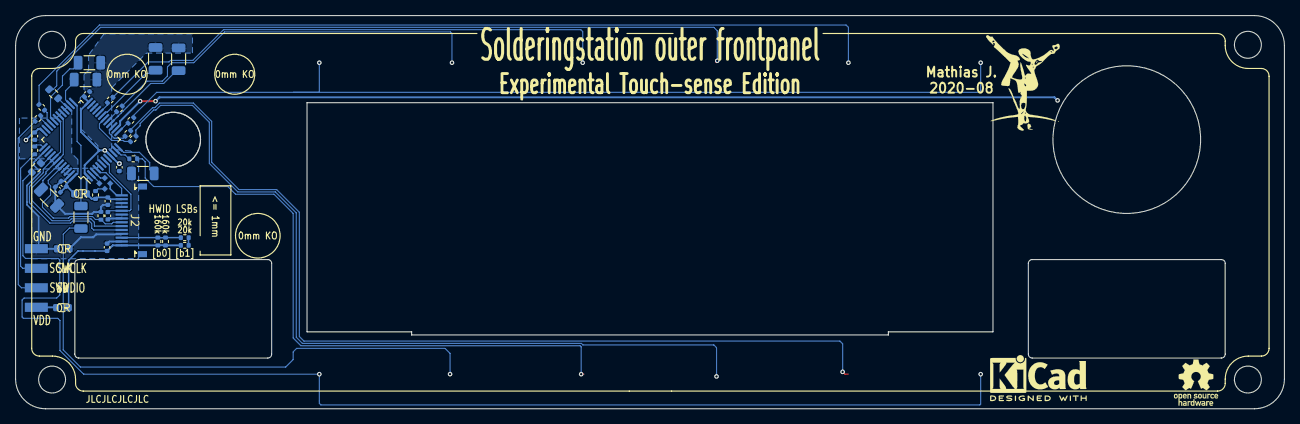
[picture p200: board ss_frontpanel_outer_plate.kicad_pcb from below]

Board: 2 copper layers, 165.0 x 51.1 mm, 51 parts (44 on the bottom side), 42 nets.
