mjohansson/SolderingStation/hw/solderstn_mb/solderstn_mb.kicad_pcb

## KiCad design hw/solderstn_mb/solderstn_mb.kicad_pcb (2024-02-26)

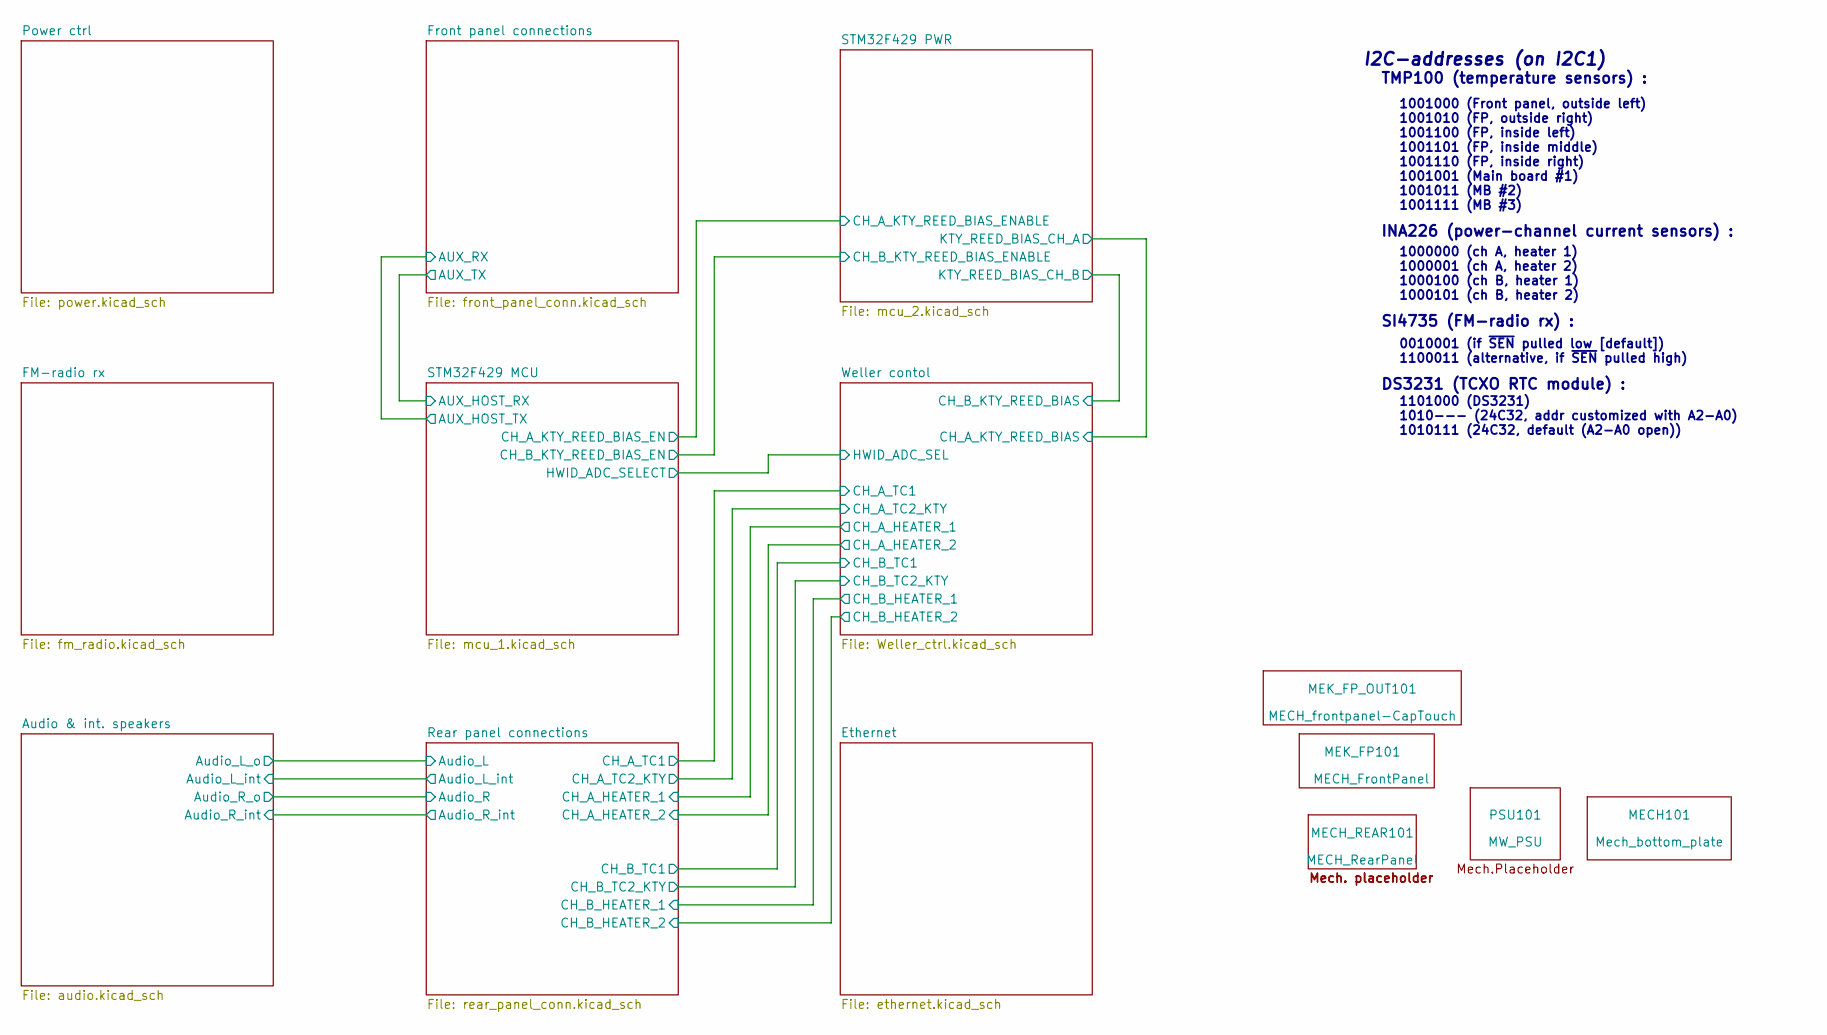
[picture p201: schematic solderstn_mb.kicad_sch, DIY Soldering station, top level]

Parts:
MECH101: Mech_bottom_plate; MECH_BTM_PLATE
MECH_REAR101: MECH_RearPanel; Mech_RearPanel
MEK_FP101: MECH_FrontPanel; Mech_frontpanel
MEK_FP_OUT101: MECH_frontpanel-CapTouch; Mech_Frontpanel_CapTouch
PSU101: MW_PSU

Notes on the sheet:
1000000 (ch A, heater 1) 1000001 (ch A, heater 2) 1000100 (ch B, heater 1) 1000101 (ch B, heater 2)
1001000 (Front panel, outside left) 1001010 (FP, outside right) 1001100 (FP, inside left) 1001101 (FP, inside middle) 1001110 (FP, inside right) 1001001 (Main board #1) 1001011 (MB #2) 1001111 (MB #3)
INA226 (power-channel current sensors) :
DS3231 (TCXO RTC module) :
I2C-addresses (on I2C1)
TMP100 (temperature sensors) :
1101000 (DS3231) 1010--- (24C32, addr customized with A2-A0) 1010111 (24C32, default (A2-A0 open))
SI4735 (FM-radio rx) :
0010001 (if ~{SEN} pulled low [default]) 1100011 (alternative, if ~{SEN} pulled high)

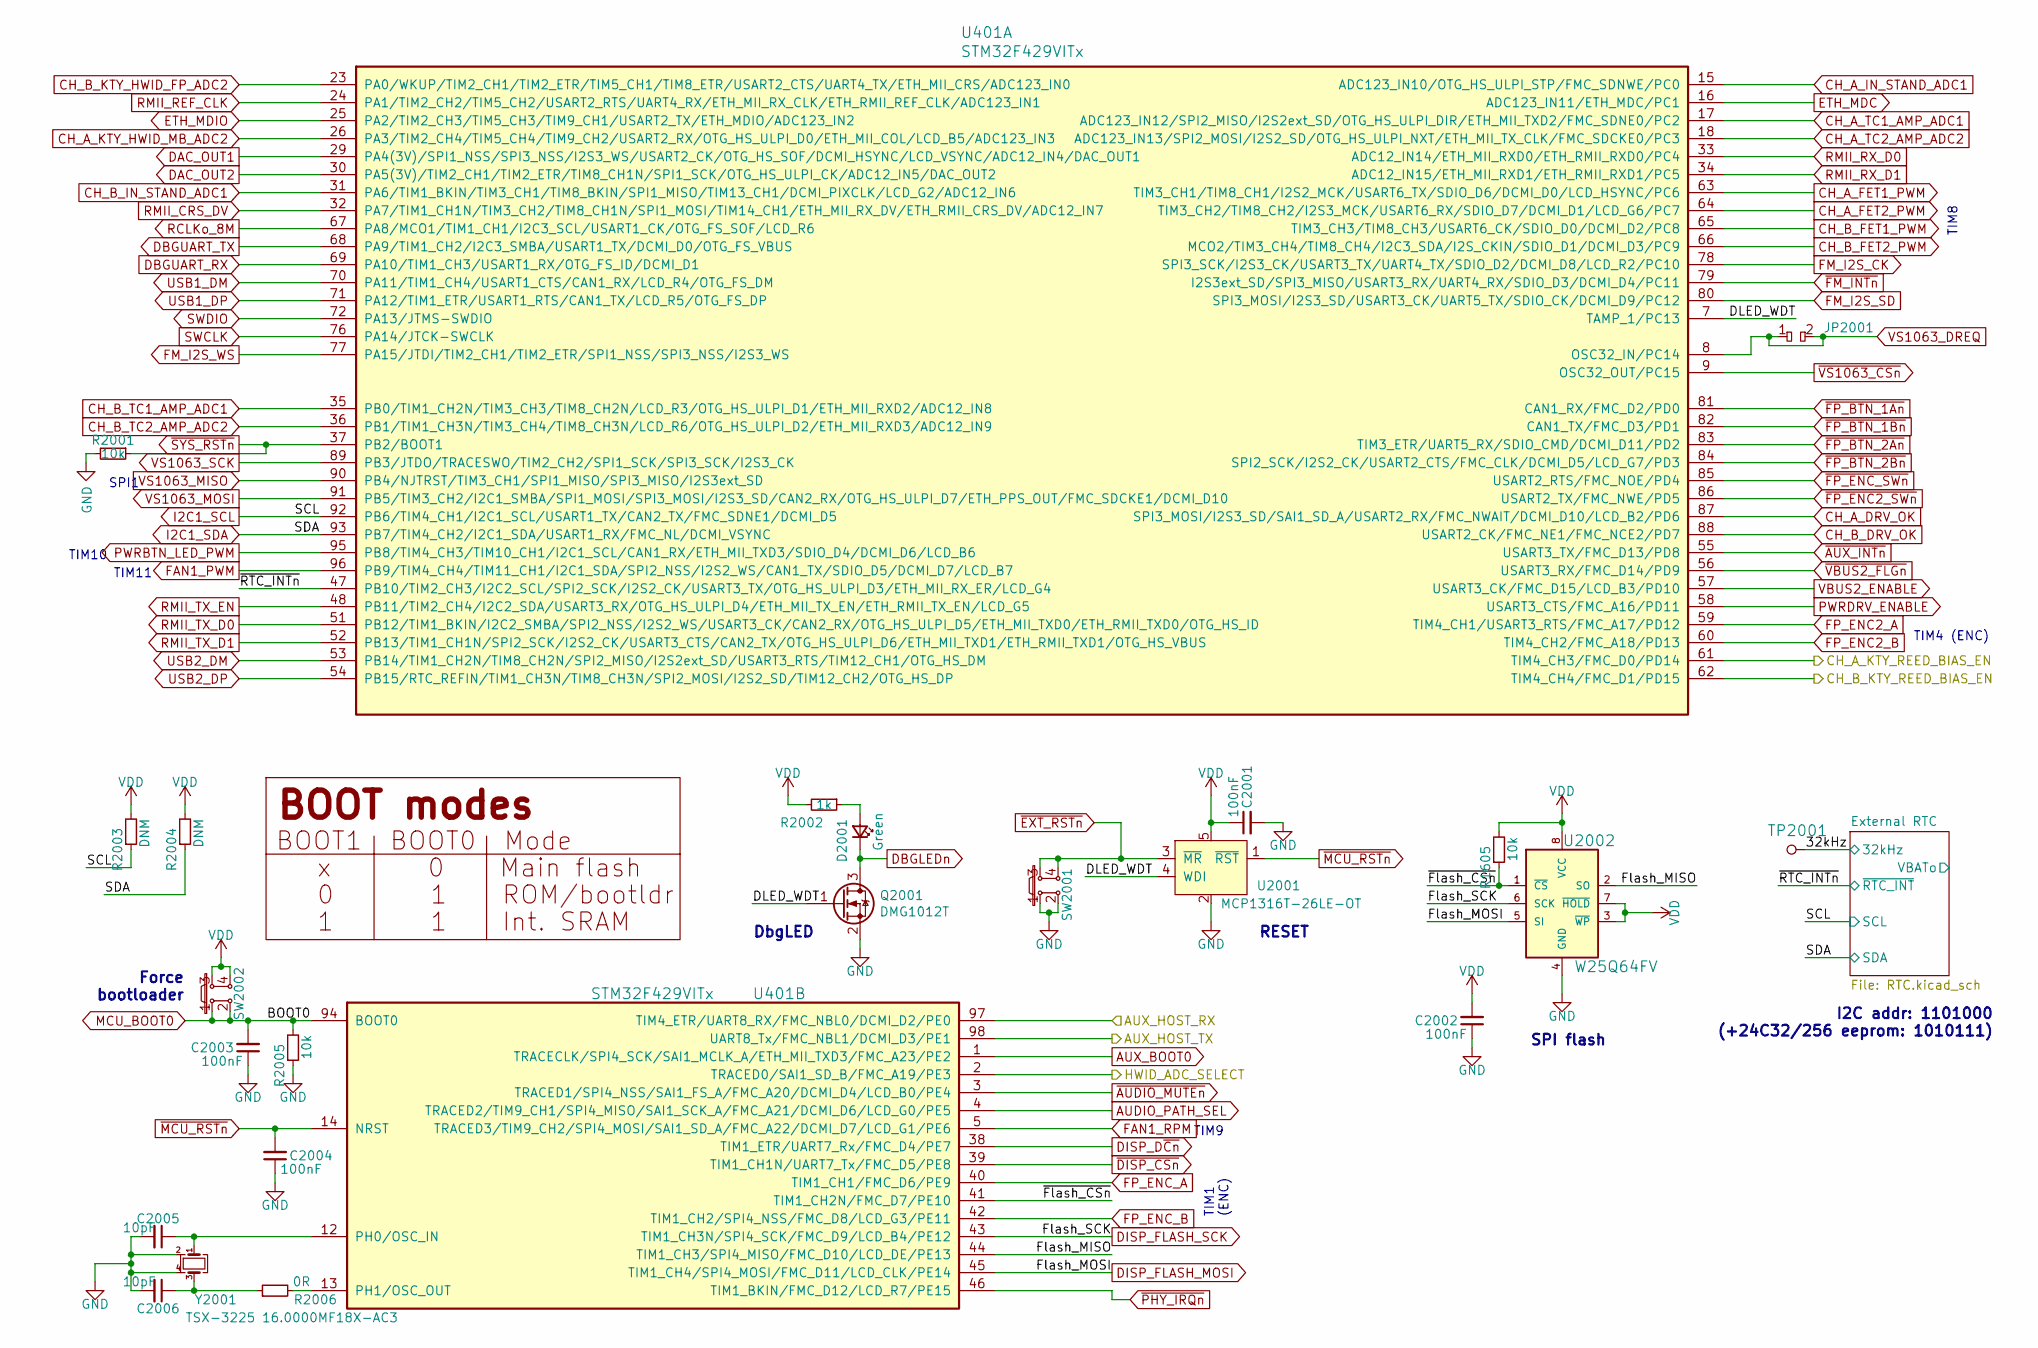
[picture p202: schematic mcu_1.kicad_sch, STM22F429 MCU pinout, clks, reset]

Parts:
C2001, C2002, C2003, C2004: 100nF; C_0402_1005Metric; JLC_part Basic
C2005, C2006: 10pF; C_0402_1005Metric; JLC_part Basic
D2001: Green; LED_0603_1608Metric; JLC_part Basic
JP2001: dogbone_2_ud; db2_ud_0402
Q2001: DMG1012T; SOT-523_handsoldering; JLC_part Extended
R1605, R2001, R2005: 10k; R_0402_1005Metric; JLC_part Basic
R2002: 1k; R_0402_1005Metric; JLC_part Basic
R2003, R2004: DNM; R_0402_1005Metric
R2006: 0R; R_0402_1005Metric; JLC_part Basic
SW2001, SW2002: Pushbutton_SMD_TS-1102W-4316; SMD_PUSHBTN_6x6mm
TP2001: TP; TP_SMD_1.2c
U401: STM32F429VITx; LQFP-100_14x14mm_P0.5mm; JLC_part Extended
U2001: MCP1316T-26LE-OT; SOT-23-5_HandSoldering
U2002: W25Q64FV; SOIC-8_5.275x5.275mm_P1.27mm; JLC_part Basic
Y2001: TSX-3225 16.0000MF18X-AC3; Crystal_SMD_SeikoEpson_TSX3225-4Pin_3.2x2.5mm; JLC_part Basic

Connections:
/Front panel connections/AUX_RX: U401.98 (UART8_Tx/FMC_NBL1/DCMI_D3/PE1); also elsewhere on the board
/Front panel connections/AUX_TX: U401.97 (TIM4_ETR/UART8_RX/FMC_NBL0/DCMI_D2/PE0); also elsewhere on the board
/STM32F429 MCU/32kHz: TP2001.1; also elsewhere on the board
/STM32F429 MCU/CH_A_KTY_REED_BIAS_EN: U401.61 (TIM4_CH3/FMC_D0/PD14); also elsewhere on the board
/STM32F429 MCU/CH_B_KTY_REED_BIAS_EN: U401.62 (TIM4_CH4/FMC_D1/PD15); also elsewhere on the board
/STM32F429 MCU/DLED_WDT: Q2001.1 (G), U401.7 (TAMP_1/PC13), U2001.4 (WDI)
/STM32F429 MCU/Flash_MISO: U401.44 (TIM1_CH3/SPI4_MISO/FMC_D10/LCD_DE/PE13), U2002.2 (SO)
/STM32F429 MCU/HWID_ADC_SELECT: U401.2 (TRACED0/SAI1_SD_B/FMC_A19/PE3); also elsewhere on the board
/STM32F429 MCU/~Flash_CSn: R1605.1, U401.41 (TIM1_CH2N/FMC_D7/PE10), U2002.1 (~CS)
/STM32F429 MCU/~RTC_INTn: U401.47 (PB10/TIM2_CH3/I2C2_SCL/SPI2_SCK/I2S2_CK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); also elsewhere on the board
AGND: C2001.2, C2002.1, C2003.1, C2004.1, C2005.2, C2006.2, Q2001.2 (S), R2001.2, R2005.1, SW2001.1, SW2001.2, U2001.2, U2002.4 (GND), Y2001.2, Y2001.4; also elsewhere on the board
AUDIO_PATH_SEL: U401.4 (TRACED2/TIM9_CH1/SPI4_MISO/SAI1_SCK_A/F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); also elsewhere on the board
AUX_BOOT0: U401.1 (TRACECLK/SPI4_SCK/SAI1_MCLK_A/ETH_MII_T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); also elsewhere on the board
CH_A_DRV_OK: U401.87 (SPI3_MOSI/I2S3_SD/SAI1_SD_A/USART2_RX/F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); also elsewhere on the board
CH_A_FET1_PWM: U401.63 (TIM3_CH1/TIM8_CH1/I2S2_MCK/USART6_TX/SD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); also elsewhere on the board
CH_A_FET2_PWM: U401.64 (TIM3_CH2/TIM8_CH2/I2S3_MCK/USART6_RX/SD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); also elsewhere on the board
CH_A_IN_STAND_ADC1: U401.15 (ADC123_IN10/OTG_HS_ULPI_STP/FMC_SDNWE/P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); also elsewhere on the board
CH_A_KTY_HWID_MB_ADC2: U401.26 (PA3/TIM2_CH4/TIM5_CH4/TIM9_CH2/USART2_R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); also elsewhere on the board
CH_A_TC1_AMP_ADC1: U401.17 (ADC123_IN12/SPI2_MISO/I2S2ext_SD/OTG_HS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); also elsewhere on the board
CH_A_TC2_AMP_ADC2: U401.18 (ADC123_IN13/SPI2_MOSI/I2S2_SD/OTG_HS_UL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); also elsewhere on the board
CH_B_DRV_OK: U401.88 (USART2_CK/FMC_NE1/FMC_NCE2/PD7); also elsewhere on the board
CH_B_FET1_PWM: U401.65 (TIM3_CH3/TIM8_CH3/USART6_CK/SDIO_D0/DCM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); also elsewhere on the board
CH_B_FET2_PWM: U401.66 (MCO2/TIM3_CH4/TIM8_CH4/I2C3_SDA/I2S_CKI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); also elsewhere on the board
CH_B_IN_STAND_ADC1: U401.31 (PA6/TIM1_BKIN/TIM3_CH1/TIM8_BKIN/SPI1_M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); also elsewhere on the board
CH_B_KTY_HWID_FP_ADC2: U401.23 (PA0/WKUP/TIM2_CH1/TIM2_ETR/TIM5_CH1/TIM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); also elsewhere on the board
CH_B_TC1_AMP_ADC1: U401.35 (PB0/TIM1_CH2N/TIM3_CH3/TIM8_CH2N/LCD_R3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); also elsewhere on the board
CH_B_TC2_AMP_ADC2: U401.36 (PB1/TIM1_CH3N/TIM3_CH4/TIM8_CH3N/LCD_R6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); also elsewhere on the board
DAC_OUT1: U401.29 (PA4(3V)/SPI1_NSS/SPI3_NSS/I2S3_WS/USART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); also elsewhere on the board
DAC_OUT2: U401.30 (PA5(3V)/TIM2_CH1/TIM2_ETR/TIM8_CH1N/SPI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); also elsewhere on the board
DBGLEDn: D2001.1 (K), Q2001.3 (D); also elsewhere on the board
DBGUART_RX: U401.69 (PA10/TIM1_CH3/USART1_RX/OTG_FS_ID/DCMI_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); also elsewhere on the board
DBGUART_TX: U401.68 (PA9/TIM1_CH2/I2C3_SMBA/USART1_TX/DCMI_D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); also elsewhere on the board
DISP_D~Cn: U401.38 (TIM1_ETR/UART7_Rx/FMC_D4/PE7); also elsewhere on the board
DISP_FLASH_MOSI: U401.45 (TIM1_CH4/SPI4_MOSI/FMC_D11/LCD_CLK/PE14), U2002.5 (SI); also elsewhere on the board
DISP_FLASH_SCK: U401.43 (TIM1_CH3N/SPI4_SCK/FMC_D9/LCD_B4/PE12), U2002.6 (SCK); also elsewhere on the board
ETH_MDC: U401.16 (ADC123_IN11/ETH_MDC/PC1); also elsewhere on the board
ETH_MDIO: U401.25 (PA2/TIM2_CH3/TIM5_CH3/TIM9_CH1/USART2_T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); also elsewhere on the board
FAN1_PWM: U401.96 (PB9/TIM4_CH4/TIM11_CH1/I2C1_SDA/SPI2_NS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); also elsewhere on the board
FAN1_RPM: U401.5 (TRACED3/TIM9_CH2/SPI4_MOSI/SAI1_SD_A/FM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); also elsewhere on the board
FM_I2S_CK: U401.78 (SPI3_SCK/I2S3_CK/USART3_TX/UART4_TX/SDI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); also elsewhere on the board
FM_I2S_SD: U401.80 (SPI3_MOSI/I2S3_SD/USART3_CK/UART5_TX/SD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); also elsewhere on the board
FM_I2S_WS: U401.77 (PA15/JTDI/TIM2_CH1/TIM2_ETR/SPI1_NSS/SP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); also elsewhere on the board
FP_ENC2_A: U401.59 (TIM4_CH1/USART3_RTS/FMC_A17/PD12); also elsewhere on the board
FP_ENC2_B: U401.60 (TIM4_CH2/FMC_A18/PD13); also elsewhere on the board
FP_ENC_A: U401.40 (TIM1_CH1/FMC_D6/PE9); also elsewhere on the board
FP_ENC_B: U401.42 (TIM1_CH2/SPI4_NSS/FMC_D8/LCD_G3/PE11); also elsewhere on the board
I2C1_SCL: R2003.1, U401.92 (PB6/TIM4_CH1/I2C1_SCL/USART1_TX/CAN2_TX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); also elsewhere on the board
I2C1_SDA: R2004.1, U401.93 (PB7/TIM4_CH2/I2C1_SDA/USART1_RX/FMC_NL/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); also elsewhere on the board
MCU_BOOT0: C2003.2, R2005.2, SW2002.1, SW2002.2, U401.94 (BOOT0); also elsewhere on the board
unnamed: C2005.1, U401.12 (PH0/OSC_IN), Y2001.1
unnamed: C2006.1, R2006.1, Y2001.3
unnamed: D2001.2 (A), R2002.1
unnamed: R2006.2, U401.13 (PH1/OSC_OUT)
PWRBTN_LED_PWM: U401.95 (PB8/TIM4_CH3/TIM10_CH1/I2C1_SCL/CAN1_RX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); also elsewhere on the board
PWRDRV_ENABLE: U401.58 (USART3_CTS/FMC_A16/PD11); also elsewhere on the board
RCLKo_8M: U401.67 (PA8/MCO1/TIM1_CH1/I2C3_SCL/USART1_CK/OT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); also elsewhere on the board
RMII_CRS_DV: U401.32 (PA7/TIM1_CH1N/TIM3_CH2/TIM8_CH1N/SPI1_M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); also elsewhere on the board
RMII_REF_CLK: U401.24 (PA1/TIM2_CH2/TIM5_CH2/USART2_RTS/UART4_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); also elsewhere on the board
RMII_RX_D0: U401.33 (ADC12_IN14/ETH_MII_RXD0/ETH_RMII_RXD0/P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); also elsewhere on the board
RMII_RX_D1: U401.34 (ADC12_IN15/ETH_MII_RXD1/ETH_RMII_RXD1/P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); also elsewhere on the board
RMII_TX_D0: U401.51 (PB12/TIM1_BKIN/I2C2_SMBA/SPI2_NSS/I2S2_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); also elsewhere on the board
RMII_TX_D1: U401.52 (PB13/TIM1_CH1N/SPI2_SCK/I2S2_CK/USART3_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); also elsewhere on the board
RMII_TX_EN: U401.48 (PB11/TIM2_CH4/I2C2_SDA/USART3_RX/OTG_HS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); also elsewhere on the board
SWCLK: U401.76 (PA14/JTCK-SWCLK); also elsewhere on the board
SWDIO: U401.72 (PA13/JTMS-SWDIO); also elsewhere on the board
USB1_DM: U401.70 (PA11/TIM1_CH4/USART1_CTS/CAN1_RX/LCD_R4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); also elsewhere on the board
USB1_DP: U401.71 (PA12/TIM1_ETR/USART1_RTS/CAN1_TX/LCD_R5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); also elsewhere on the board
USB2_DM: U401.53 (PB14/TIM1_CH2N/TIM8_CH2N/SPI2_MISO/I2S2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); also elsewhere on the board
USB2_DP: U401.54 (PB15/RTC_REFIN/TIM1_CH3N/TIM8_CH3N/SPI2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); also elsewhere on the board
VBUS2_ENABLE: U401.57 (USART3_CK/FMC_D15/LCD_B3/PD10); also elsewhere on the board
VCC: C2001.1, C2002.2, R1605.2, R2002.2, R2003.2, R2004.2, SW2002.3, SW2002.4, U2001.5, U2002.3 (~WP), U2002.7 (~HOLD), U2002.8 (VCC); also elsewhere on the board
VS1063_DREQ: JP2001.1, JP2001.2, U401.8 (OSC32_IN/PC14); also elsewhere on the board
VS1063_MISO: U401.90 (PB4/NJTRST/TIM3_CH1/SPI1_MISO/SPI3_MISO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); also elsewhere on the board
VS1063_MOSI: U401.91 (PB5/TIM3_CH2/I2C1_SMBA/SPI1_MOSI/SPI3_M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); also elsewhere on the board
VS1063_SCK: U401.89 (PB3/JTDO/TRACESWO/TIM2_CH2/SPI1_SCK/SPI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); also elsewhere on the board
~AUDIO_MUTEn: U401.3 (TRACED1/SPI4_NSS/SAI1_FS_A/FMC_A20/DCMI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); also elsewhere on the board
~AUX_INTn: U401.55 (USART3_TX/FMC_D13/PD8); also elsewhere on the board
~DISP_CSn: U401.39 (TIM1_CH1N/UART7_Tx/FMC_D5/PE8); also elsewhere on the board
~EXT_RSTn: SW2001.3, SW2001.4, U2001.3 (~MR); also elsewhere on the board
~FM_INTn: U401.79 (I2S3ext_SD/SPI3_MISO/USART3_RX/UART4_RX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); also elsewhere on the board
~FP_BTN_1An: U401.81 (CAN1_RX/FMC_D2/PD0); also elsewhere on the board
~FP_BTN_1Bn: U401.82 (CAN1_TX/FMC_D3/PD1); also elsewhere on the board
~FP_BTN_2An: U401.83 (TIM3_ETR/UART5_RX/SDIO_CMD/DCMI_D11/PD2); also elsewhere on the board
~FP_BTN_2Bn: U401.84 (SPI2_SCK/I2S2_CK/USART2_CTS/FMC_CLK/DCM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); also elsewhere on the board
~FP_ENC2_SWn: U401.86 (USART2_TX/FMC_NWE/PD5); also elsewhere on the board
~FP_ENC_SWn: U401.85 (USART2_RTS/FMC_NOE/PD4); also elsewhere on the board
~MCU_RSTn: C2004.2, U401.14 (NRST), U2001.1 (~RST); also elsewhere on the board
~PHY_IRQn: U401.46 (TIM1_BKIN/FMC_D12/LCD_R7/PE15); also elsewhere on the board
~SYS_RSTn: R2001.1, U401.37 (PB2/BOOT1); also elsewhere on the board
~VBUS2_FLGn: U401.56 (USART3_RX/FMC_D14/PD9); also elsewhere on the board
~VS1063_CSn: U401.9 (OSC32_OUT/PC15); also elsewhere on the board

Notes on the sheet:
TIM11
RESET
Force bootloader
SPI flash
TIM9
DbgLED
TIM10
SPI1
TIM1 (ENC)
I2C addr: 1101000 (+24C32/256 eeprom: 1010111)
TIM4 (ENC)
TIM8
