mjohansson/SolderingStation/hw/solderstn_mb/solderstn_mb.kicad_pcb

## KiCad design hw/solderstn_mb/solderstn_mb.kicad_pcb (continued)

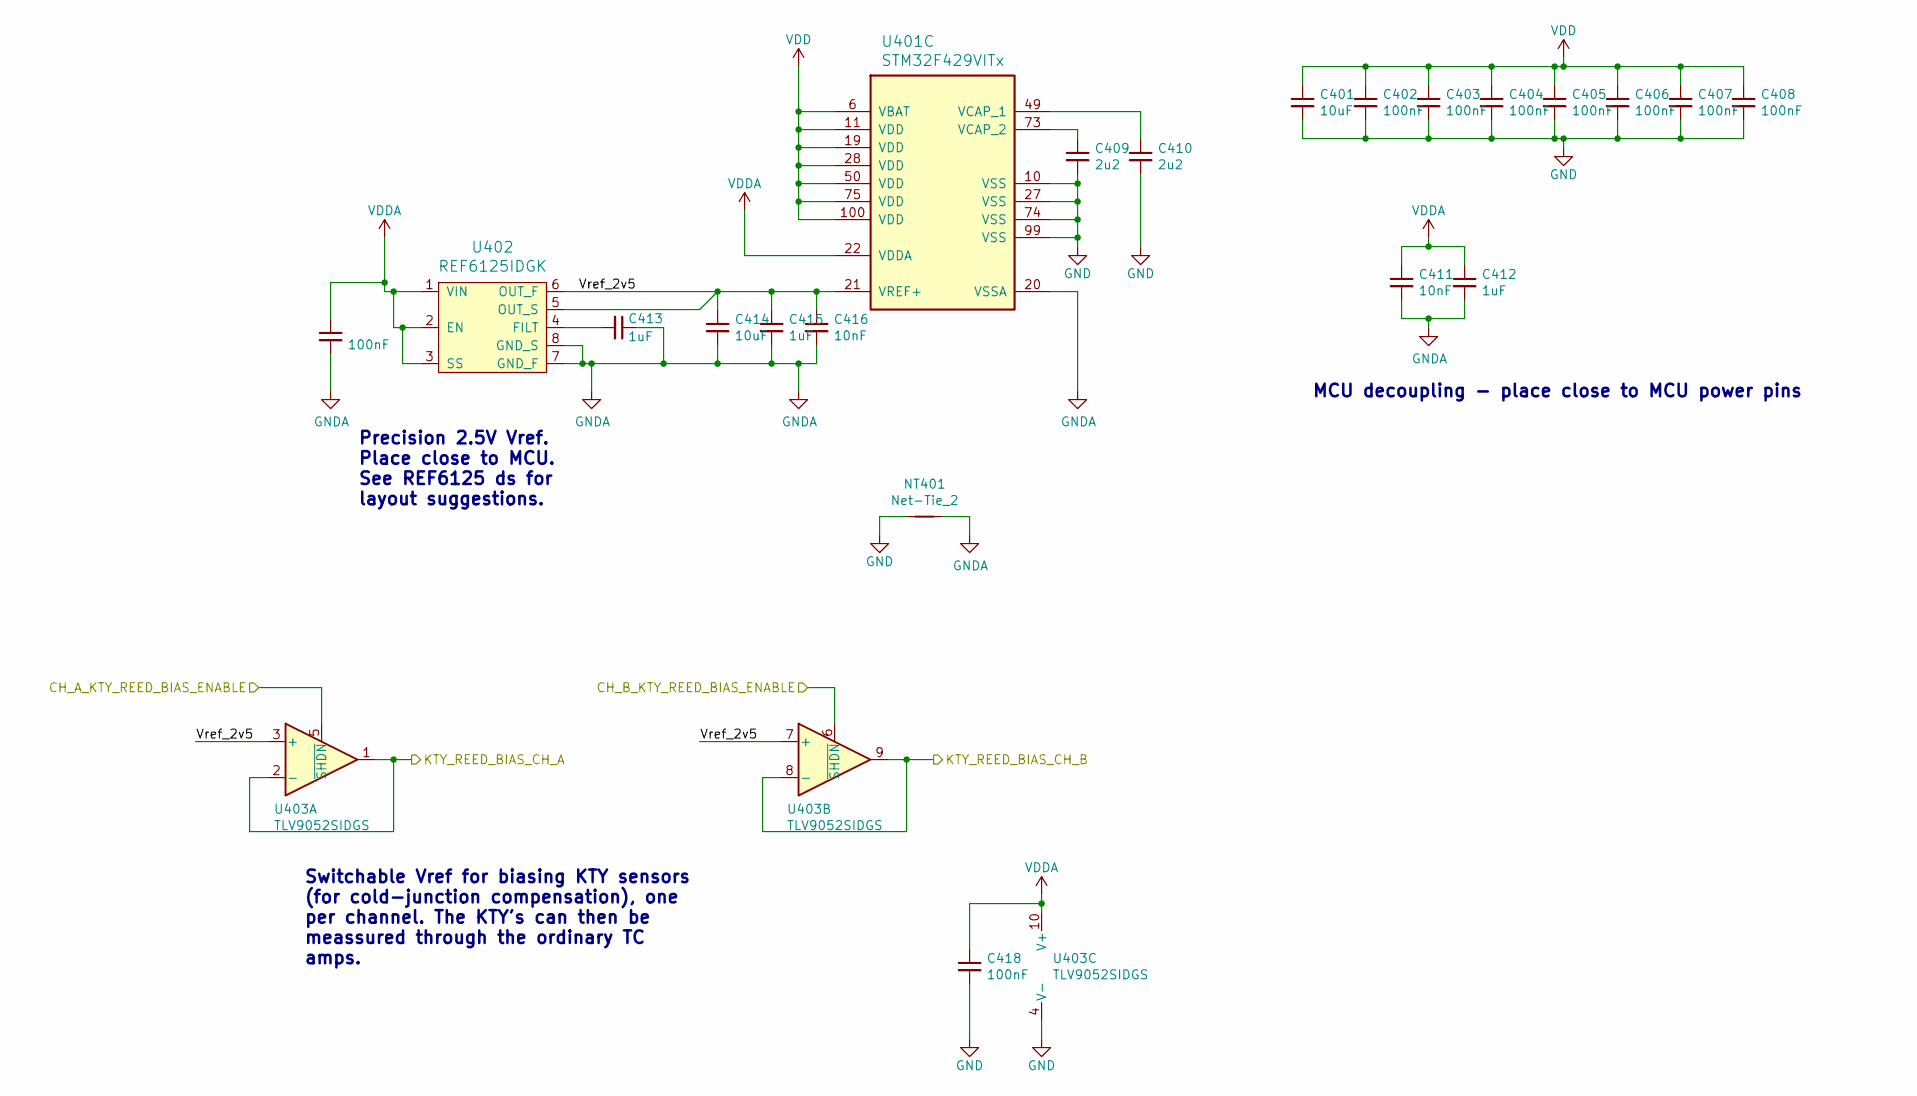
[picture p203: schematic mcu_2.kicad_sch, STM32F429 MCU power, decoupling, Vref]

Parts:
C401, C414: 10uF; C_0402_1005Metric; JLC_part Basic
C402, C403, C404, C405, C406, C407, C408, C417, C418: 100nF; C_0402_1005Metric; JLC_part Basic
C409, C410: 2u2; C_0603_1608Metric; JLC_part Basic
C411, C416: 10nF; C_0402_1005Metric; JLC_part Basic
C412, C413, C415: 1uF; C_0402_1005Metric; JLC_part Basic
NT401: Net-Tie_2; NetTie-2_SMD_Pad2.0mm
U401: STM32F429VITx; LQFP-100_14x14mm_P0.5mm; JLC_part Extended
U402: REF6125IDGK; VSSOP-8_3.0x3.0mm_P0.65mm
U403: TLV9052SIDGS; VSSOP-10_3x3mm_P0.5mm

Connections:
/STM32F429 MCU/CH_A_KTY_REED_BIAS_EN: U403.5 (~SHDN); also elsewhere on the board
/STM32F429 MCU/CH_B_KTY_REED_BIAS_EN: U403.6 (~SHDN); also elsewhere on the board
/STM32F429 PWR/KTY_REED_BIAS_CH_A: U403.1, U403.2 (-); also elsewhere on the board
/STM32F429 PWR/KTY_REED_BIAS_CH_B: U403.8 (-), U403.9; also elsewhere on the board
/STM32F429 PWR/Vref_2v5: C414.1, C415.1, C416.1, U401.21 (VREF+), U402.5 (OUT_S), U402.6 (OUT_F), U403.3 (+), U403.7 (+)
AGND: C401.2, C402.2, C403.2, C404.2, C405.2, C406.2, C407.2, C408.2, C409.2, C410.2, C411.2, C412.2, C413.1, C414.2, C415.2, C416.2, C417.2, C418.2, NT401.1, NT401.2, U401.10 (VSS), U401.20 (VSSA), U401.27 (VSS), U401.74 (VSS), U401.99 (VSS), U402.7 (GND_F), U402.8 (GND_S), U403.4 (V-); also elsewhere on the board
AVDD: C411.1, C412.1, C417.1, C418.1, U401.22 (VDDA), U402.1 (VIN), U402.2 (EN), U402.3 (SS), U403.10 (V+); also elsewhere on the board
unnamed: C409.1, U401.73 (VCAP_2)
unnamed: C410.1, U401.49 (VCAP_1)
unnamed: C413.2, U402.4 (FILT)
VCC: C401.1, C402.1, C403.1, C404.1, C405.1, C406.1, C407.1, C408.1, U401.6 (VBAT), U401.11 (VDD), U401.19 (VDD), U401.28 (VDD), U401.50 (VDD), U401.75 (VDD), U401.100 (VDD); also elsewhere on the board

Notes on the sheet:
MCU decoupling - place close to MCU power pins
Precision 2.5V Vref. Place close to MCU. See REF6125 ds for layout suggestions.
Switchable Vref for biasing KTY sensors (for cold-junction compensation), one per channel. The KTY's can then be meassured through the ordinary TC amps.

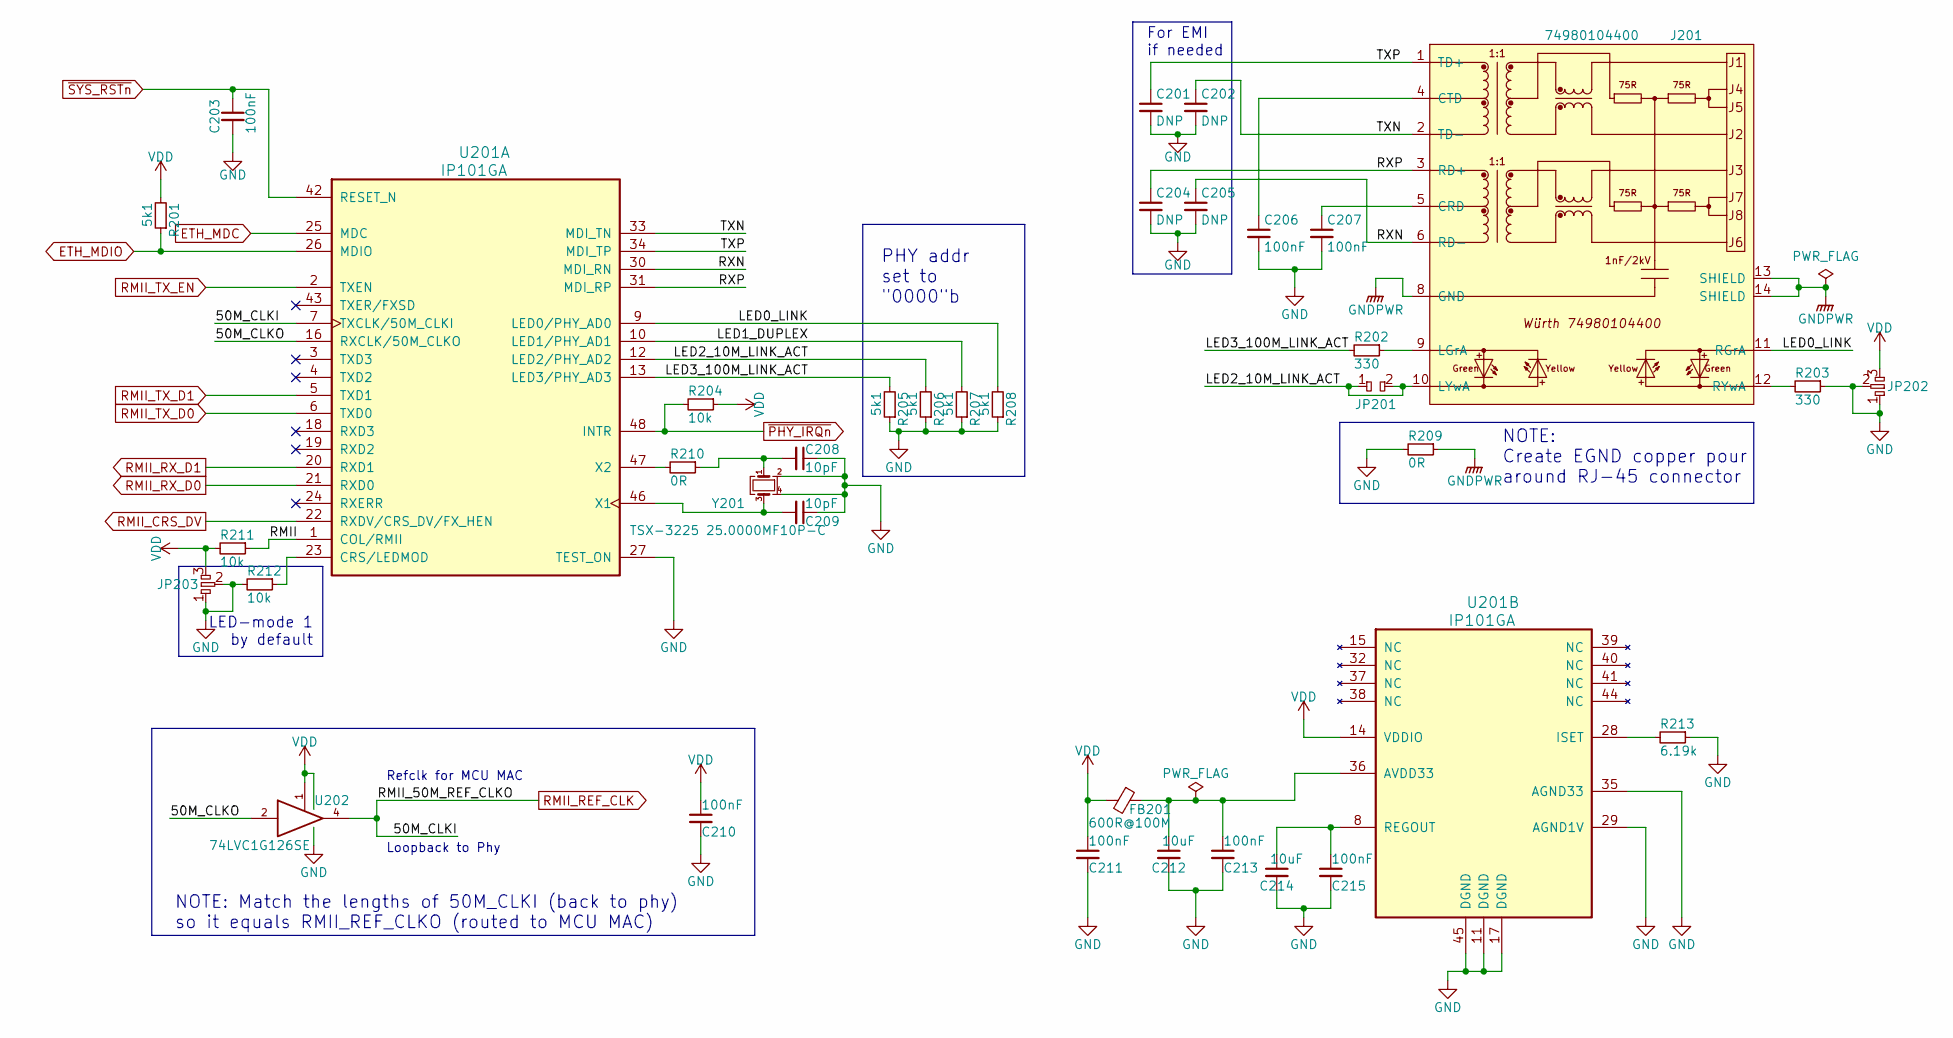
[picture p204: schematic ethernet.kicad_sch, Ethernet PHY & connector]

Parts:
C201, C202, C204, C205: DNP; C_0402_1005Metric; JLC_part Basic
C203, C206, C207, C210, C211, C213, C215: 100nF; C_0402_1005Metric; JLC_part Basic
C208, C209: 10pF; C_0402_1005Metric; JLC_part Basic
C212, C214: 10uF; C_0402_1005Metric; JLC_part Basic
FB201: 600R@100M; L_0603_1608Metric; JLC_part Basic
J201: 74980104400; 74980104400_WE-RJ45_LAN_trx
JP201: dogbone_2_ud; db2_ud_0402
JP202, JP203: dogbone_3_ud; db3_ud_0402
R201, R205, R206, R207, R208: 5k1; R_0402_1005Metric; JLC_part Basic
R202, R203: 330; R_0402_1005Metric; JLC_part Basic
R204, R211, R212: 10k; R_0402_1005Metric; JLC_part Basic
R209, R210: 0R; R_0402_1005Metric; JLC_part Basic
R213: 6.19k; R_0402_1005Metric; JLC_part Extended
U201: IP101GA; LQFP-48_7x7mm_P0.5mm; JLC_part Extended
U202: 74LVC1G126SE; SOT-353_SC-70-5_Handsoldering; JLC_part Extended
Y201: TSX-3225 25.0000MF10P-C; Crystal_SMD_SeikoEpson_TSX3225-4Pin_3.2x2.5mm; JLC_part Basic

Connections:
/Ethernet/50M_CLKO: U201.16 (RXCLK/50M_CLKO), U202.2
/Ethernet/LED0_LINK: J201.11 (RGrA), R208.2, U201.9 (LED0/PHY_AD0)
/Ethernet/LED1_DUPLEX: R207.2, U201.10 (LED1/PHY_AD1)
/Ethernet/LED2_10M_LINK_ACT: J201.10 (LYwA), JP201.1, JP201.2, R206.2, U201.12 (LED2/PHY_AD2)
/Ethernet/LED3_100M_LINK_ACT: R202.2, R205.2, U201.13 (LED3/PHY_AD3)
/Ethernet/RMII: R211.1, U201.1 (COL/RMII)
/Ethernet/RXN: C205.1, J201.6 (RD-), U201.30 (MDI_RN)
/Ethernet/RXP: C204.1, J201.3 (RD+), U201.31 (MDI_RP)
/Ethernet/TXN: C202.1, J201.2 (TD-), U201.33 (MDI_TN)
/Ethernet/TXP: C201.1, J201.1 (TD+), U201.34 (MDI_TP)
AGND: C201.2, C202.2, C203.2, C204.2, C205.2, C206.2, C207.2, C208.1, C209.1, C210.2, C211.2, C212.2, C213.2, C214.2, C215.2, JP202.1, JP202.2, JP203.1, JP203.2, R203.1, R205.1, R206.1, R207.1, R208.1, R209.2, R212.2, R213.1, U201.11 (DGND), U201.17 (DGND), U201.27 (TEST_ON), U201.29 (AGND1V), U201.35 (AGND33), U201.45 (DGND), U202.3 (GND), Y201.2, Y201.4; also elsewhere on the board
ETH_MDC: U201.25 (MDC); also elsewhere on the board
ETH_MDIO: R201.1, U201.26 (MDIO); also elsewhere on the board
GNDPWR: J201.8 (GND), J201.13 (SHIELD), J201.14 (SHIELD), R209.1
unnamed: C206.1, J201.4 (CTD)
unnamed: C207.1, J201.5 (CRD)
unnamed: C208.2, R210.1, Y201.1
unnamed: C209.2, U201.46 (X1), Y201.3
unnamed: C212.1, C213.1, FB201.1, U201.36 (AVDD33)
unnamed: C214.1, C215.1, U201.8 (REGOUT)
unnamed: J201.9 (LGrA), R202.1
unnamed: J201.12 (RYwA), R203.2
unnamed: R210.2, U201.47 (X2)
unnamed: R212.1, U201.23 (CRS/LEDMOD)
unnamed: R213.2, U201.28 (ISET)
RMII_CRS_DV: U201.22 (RXDV/CRS_DV/FX_HEN); also elsewhere on the board
RMII_REF_CLK: U201.7 (TXCLK/50M_CLKI), U202.4; also elsewhere on the board
RMII_RX_D0: U201.21 (RXD0); also elsewhere on the board
RMII_RX_D1: U201.20 (RXD1); also elsewhere on the board
RMII_TX_D0: U201.6 (TXD0); also elsewhere on the board
RMII_TX_D1: U201.5 (TXD1); also elsewhere on the board
RMII_TX_EN: U201.2 (TXEN); also elsewhere on the board
VCC: C210.1, C211.1, FB201.2, JP202.3, JP203.3, R201.2, R204.1, R211.2, U201.14 (VDDIO), U202.1, U202.5 (VCC); also elsewhere on the board
~PHY_IRQn: R204.2, U201.48 (INTR); also elsewhere on the board
~SYS_RSTn: C203.1, U201.42 (RESET_N); also elsewhere on the board

Notes on the sheet:
Refclk for MCU MAC
NOTE: Create EGND copper pour around RJ-45 connector
PHY addr set to "0000"b
Loopback to Phy
For EMI if needed
LED-mode 1 by default
NOTE: Match the lengths of 50M_CLKI (back to phy) so it equals RMII_REF_CLKO (routed to MCU MAC)

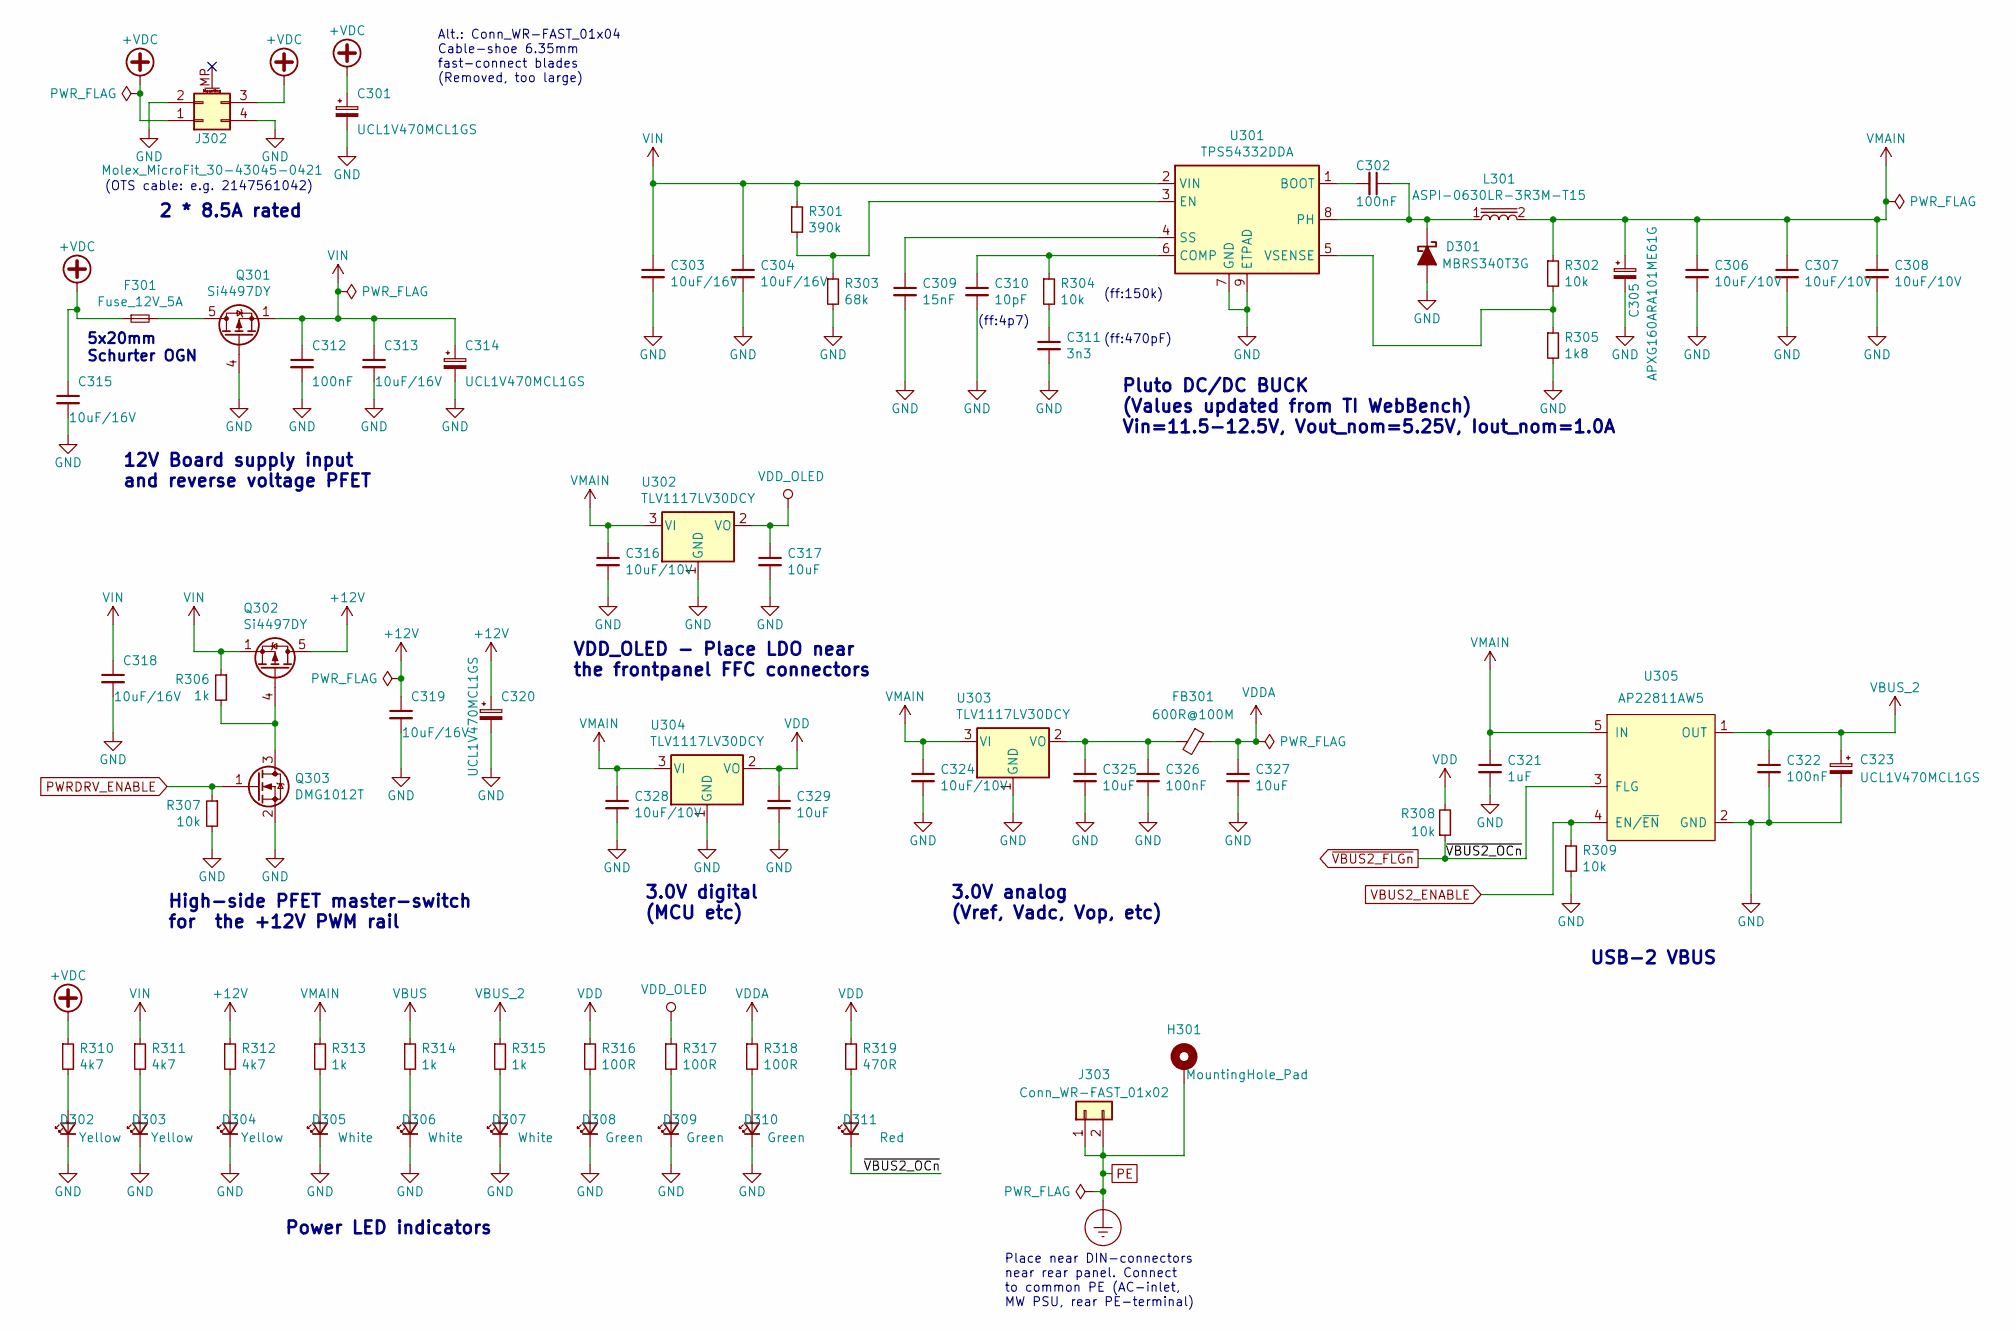
[picture p205: schematic power.kicad_sch, DC/DC Buck, LDOs & master load-switches]

Parts:
C301, C314, C320, C323: UCL1V470MCL1GS; CP_Elec_6.3x5.8
C302, C312, C322, C326: 100nF; C_0402_1005Metric; JLC_part Basic
C303, C304, C313, C315, C318, C319: 10uF/16V; C_0805_2012Metric; JLC_part Basic
C305: APXG160ARA101ME61G; CP_Elec_5x5.8
C306, C307, C308, C316, C324, C328: 10uF/10V; C_0603_1608Metric; JLC_part Basic
C309: 15nF; C_0603_1608Metric; JLC_part Basic
C310: 10pF; C_0402_1005Metric; JLC_part Basic
C311: 3n3; C_0402_1005Metric; JLC_part Basic
C317, C325, C327, C329: 10uF; C_0402_1005Metric; JLC_part Basic
C321: 1uF; C_0402_1005Metric; JLC_part Basic
D301: MBRS340T3G; MBRS3xx_SMC_CASE_403AC; JLC_part Extended
D302, D303, D304: Yellow; LED_0603_1608Metric; JLC_part Basic
D305, D306, D307: White; LED_0603_1608Metric; JLC_part Basic
D308, D309, D310: Green; LED_0603_1608Metric; JLC_part Basic
D311: Red; LED_0603_1608Metric; JLC_part Basic
F301: Fuse_12V_5A; Fuseholder_5x20mm_Schurter_OGN-0031.8201
FB301: 600R@100M; L_0603_1608Metric; JLC_part Basic
H301: MountingHole_Pad; MountingHole_3.5mm_Pad_Via
J302: Molex_MicroFit_30-43045-0421; Molex_Micro-Fit_3.0_43045-0421_2x02-1MP_P3.00mm_Horizontal
J303: Conn_WR-FAST_01x02; WR-FAST_508_2_V
L301: ASPI-0630LR-3R3M-T15; ASPI-0603LR
Q301, Q302: Si4497DY; SOIC-8_3.9x4.9mm_P1.27mm; JLC_part Extended
Q303: DMG1012T; SOT-523_handsoldering; JLC_part Extended
R301: 390k; R_0603_1608Metric; JLC_part Basic
R302, R304, R307, R308, R309: 10k; R_0402_1005Metric; JLC_part Basic
R303: 68k; R_0603_1608Metric; JLC_part Basic
R305: 1k8; R_0603_1608Metric; JLC_part Basic
R306, R313, R314, R315: 1k; R_0402_1005Metric; JLC_part Basic
R310, R311, R312: 4k7; R_0402_1005Metric; JLC_part Basic
R316, R317, R318: 100R; R_0402_1005Metric; JLC_part Basic
R319: 470R; R_0402_1005Metric; JLC_part Basic
U301: TPS54332DDA; TI_SO-PowerPAD-8_ThermalVias; JLC_part Extended
U302, U303, U304: TLV1117LV30DCY; SOT-223-3_TabPin2
U305: AP22811AW5; TSOT-23-5

Connections:
+12V: C319.1, C320.1, Q302.5 (D), Q302.6 (D), Q302.7 (D), Q302.8 (D), R312.1; also elsewhere on the board
+VDC: C301.1, C315.1, F301.1, J302.1, J302.3, R310.1
AGND: C301.2, C303.2, C304.2, C305.2, C306.2, C307.2, C308.2, C309.2, C310.2, C311.2, C312.2, C313.2, C314.2, C315.2, C316.2, C317.2, C318.2, C319.2, C320.2, C321.2, C322.2, C323.2, C324.2, C325.2, C326.2, C327.2, C328.2, C329.2, D301.2 (A), D302.1 (K), D303.1 (K), D304.1 (K), D305.1 (K), D306.1 (K), D307.1 (K), D308.1 (K), D309.1 (K), D310.1 (K), J302.2, J302.4, Q301.4 (G), Q303.2 (S), R303.2, R305.2, R307.2, R309.2, U301.7 (GND), U301.9 (ETPAD), U302.1 (GND), U303.1 (GND), U304.1 (GND), U305.2 (GND); also elsewhere on the board
AVDD: C327.1, FB301.1, R318.1; also elsewhere on the board
unnamed: C302.1, D301.1 (K), L301.1, U301.8 (PH)
unnamed: C302.2, U301.1 (BOOT)
unnamed: C309.1, U301.4 (SS)
unnamed: C310.1, R304.1, U301.6 (COMP)
unnamed: C311.1, R304.2
unnamed: C325.1, C326.1, FB301.2, U303.2 (VO)
unnamed: D302.2 (A), R310.2
unnamed: D303.2 (A), R311.2
unnamed: D304.2 (A), R312.2
unnamed: D305.2 (A), R313.2
unnamed: D306.2 (A), R314.2
unnamed: D307.2 (A), R315.2
unnamed: D308.2 (A), R316.2
unnamed: D309.2 (A), R317.2
unnamed: D310.2 (A), R318.2
unnamed: D311.2 (A), R319.2
unnamed: F301.2, Q301.5 (D), Q301.6 (D), Q301.7 (D), Q301.8 (D)
unnamed: Q302.4 (G), Q303.3 (D), R306.2
unnamed: R301.2, R303.1, U301.3 (EN)
unnamed: R302.2, R305.1, U301.5 (VSENSE)
PE: H301.1, J303.1, J303.2; also elsewhere on the board
PWRDRV_ENABLE: Q303.1 (G), R307.1; also elsewhere on the board
VBUS: R314.1; also elsewhere on the board
VBUS2_ENABLE: R309.1, U305.4 (EN/~EN); also elsewhere on the board
VBUS_2: C322.1, C323.1, R315.1, U305.1 (OUT); also elsewhere on the board
VCC: C329.1, R308.2, R316.1, R319.1, U304.2 (VO); also elsewhere on the board
VDD_OLED: C317.1, R317.1, U302.2 (VO); also elsewhere on the board
VIN: C303.1, C304.1, C312.1, C313.1, C314.1, C318.1, Q301.1 (S), Q301.2 (S), Q301.3 (S), Q302.1 (S), Q302.2 (S), Q302.3 (S), R301.1, R306.1, R311.1, U301.2 (VIN); also elsewhere on the board
VMAIN: C305.1, C306.1, C307.1, C308.1, C316.1, C321.1, C324.1, C328.1, L301.2, R302.1, R313.1, U302.3 (VI), U303.3 (VI), U304.3 (VI), U305.5 (IN); also elsewhere on the board
~VBUS2_FLGn: D311.1 (K), R308.1, U305.3 (FLG); also elsewhere on the board

Notes on the sheet:
USB-2 VBUS
High-side PFET master-switch for the +12V PWM rail
Power LED indicators
2 * 8.5A rated
Alt.: Conn_WR-FAST_01x04 Cable-shoe 6.35mm fast-connect blades (Removed, too large)
3.0V analog (Vref, Vadc, Vop, etc)
(ff:150k)
12V Board supply input and reverse voltage PFET
(ff:470pF)
(ff:4p7)
(OTS cable: e.g. 2147561042)
5x20mm Schurter OGN
Place near DIN-connectors near rear panel. Connect to common PE (AC-inlet, MW PSU, rear PE-terminal)
VDD_OLED - Place LDO near the frontpanel FFC connectors
Pluto DC/DC BUCK (Values updated from TI WebBench) Vin=11.5-12.5V, Vout_nom=5.25V, Iout_nom=1.0A
3.0V digital (MCU etc)

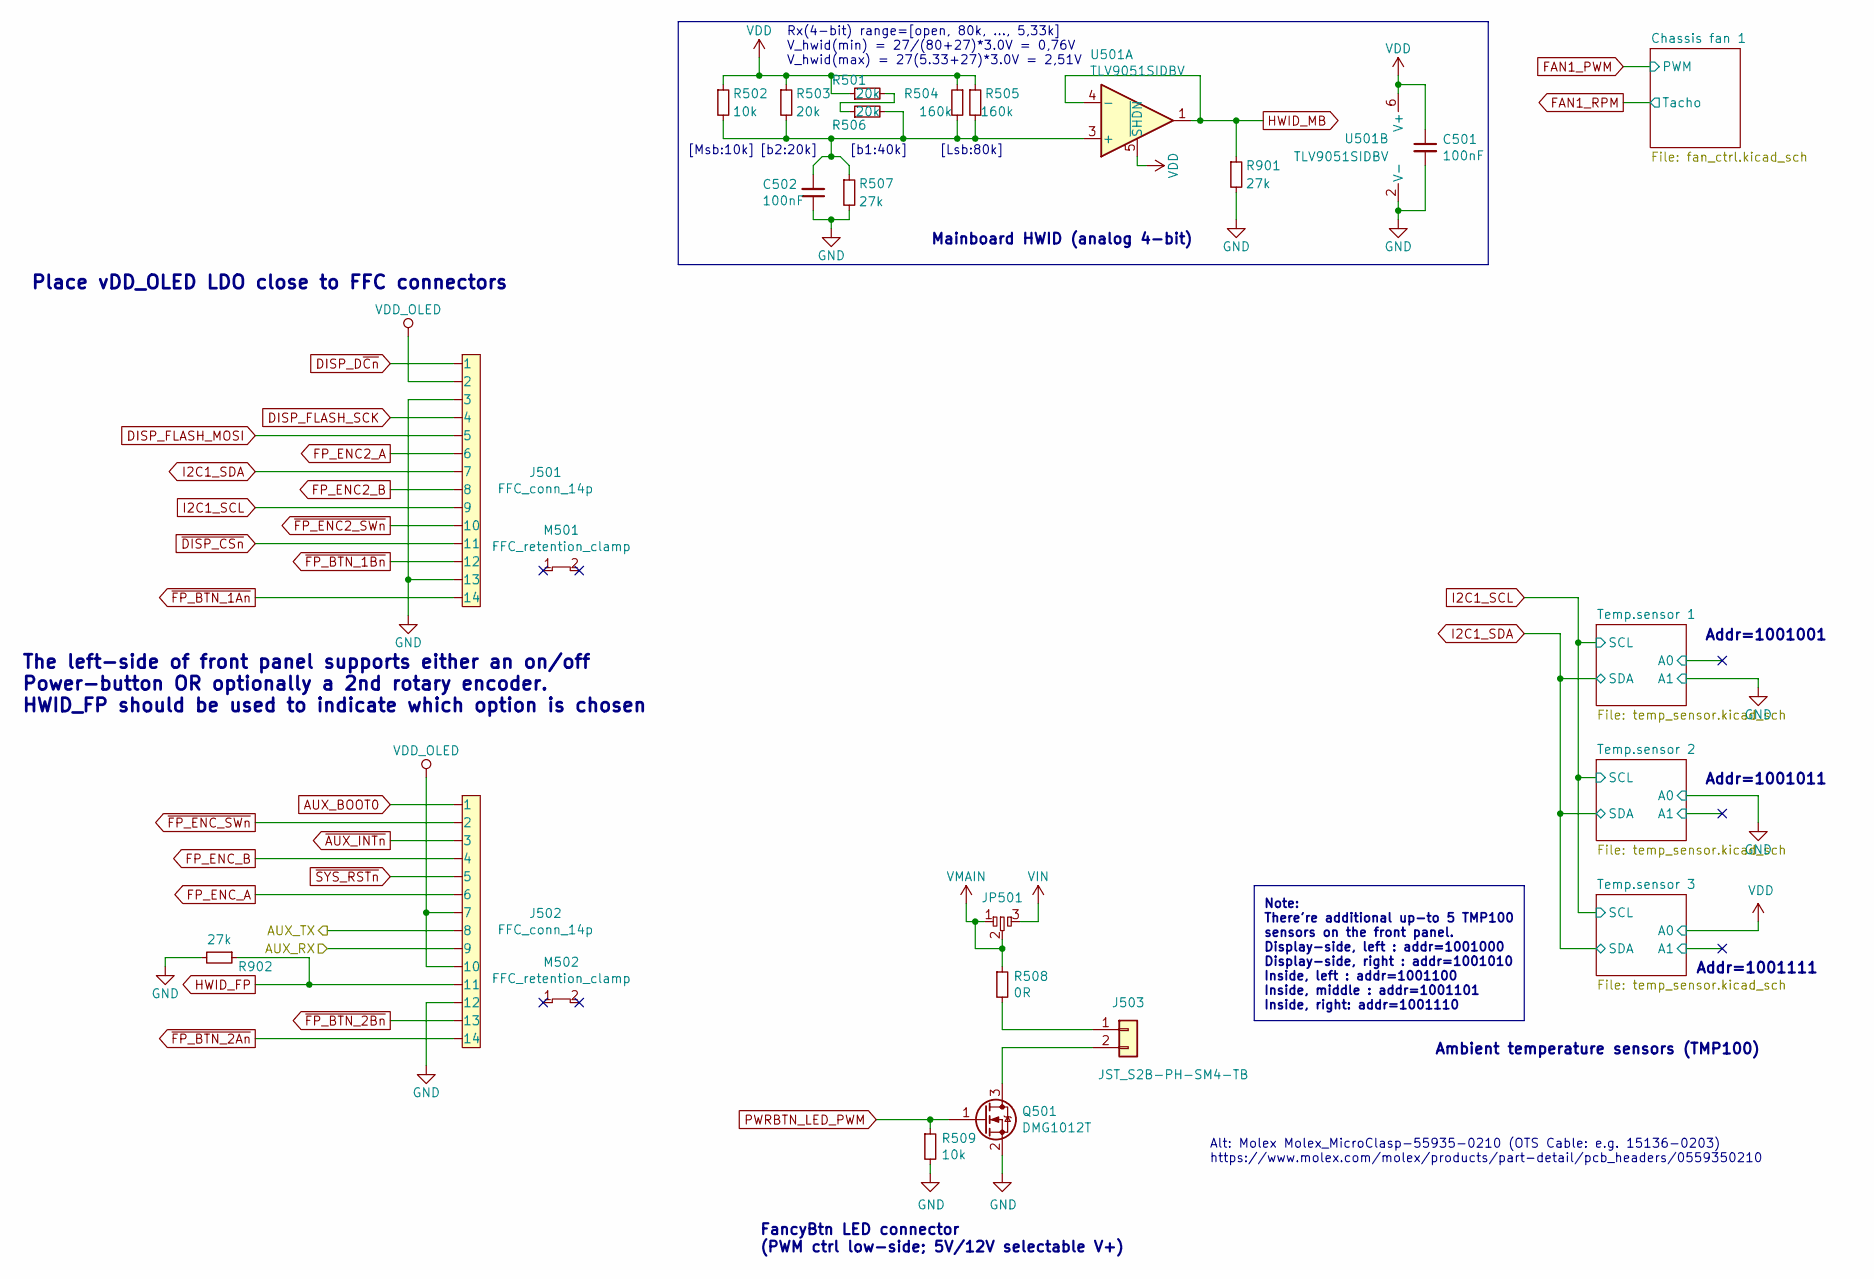
[picture p206: schematic front_panel_conn.kicad_sch, Front-side and internal connectors]

Parts:
C501, C502: 100nF; C_0402_1005Metric; JLC_part Basic
J501, J502: FFC_conn_14p; FPC_14p_05mm-Molex_5052781433
J503: JST_S2B-PH-SM4-TB; JST_PH_S2B-PH-SM4-TB_1x02-1MP_P2.00mm_Horizontal
JP501: dogbone_3_ud; db3_ud_0402
M501, M502: FFC_retention_clamp; FFC_retention_clamp_14pin_7_5mm
Q501: DMG1012T; SOT-523_handsoldering; JLC_part Extended
R501, R503, R506: 20k; R_0402_1005Metric; JLC_part Basic
R502, R509: 10k; R_0402_1005Metric; JLC_part Basic
R504, R505: 160k; R_0603_1608Metric; JLC_part Basic
R507, R901, R902: 27k; R_0402_1005Metric; JLC_part Basic
R508: 0R; R_0402_1005Metric; JLC_part Basic
U501: TLV9051SIDBV; TSOT-23-6

Connections:
/Front panel connections/AUX_RX: J502.9; also elsewhere on the board
/Front panel connections/AUX_TX: J502.8; also elsewhere on the board
AGND: C501.2, C502.1, J501.3, J501.13, J502.12, Q501.2 (S), R507.2, R509.2, R901.2, R902.2, U501.2 (V-); also elsewhere on the board
AUX_BOOT0: J502.1; also elsewhere on the board
DISP_D~Cn: J501.1; also elsewhere on the board
DISP_FLASH_MOSI: J501.5; also elsewhere on the board
DISP_FLASH_SCK: J501.4; also elsewhere on the board
FP_ENC2_A: J501.6; also elsewhere on the board
FP_ENC2_B: J501.8; also elsewhere on the board
FP_ENC_A: J502.6; also elsewhere on the board
FP_ENC_B: J502.4; also elsewhere on the board
HWID_FP: J502.11, R902.1; also elsewhere on the board
HWID_MB: R901.1, U501.1, U501.4 (-); also elsewhere on the board
I2C1_SCL: J501.9; also elsewhere on the board
I2C1_SDA: J501.7; also elsewhere on the board
unnamed: C502.2, R502.2, R503.2, R504.2, R505.2, R506.2, R507.1, U501.3 (+)
unnamed: J503.1, R508.2
unnamed: J503.2, Q501.3 (D)
unnamed: R501.2, R506.1
PWRBTN_LED_PWM: Q501.1 (G), R509.1; also elsewhere on the board
VCC: C501.1, R501.1, R502.1, R503.1, R504.1, R505.1, U501.5 (~SHDN), U501.6 (V+); also elsewhere on the board
VDD_OLED: J501.2, J502.7, J502.10; also elsewhere on the board
VIN: JP501.3; also elsewhere on the board
VMAIN: JP501.1, JP501.2, R508.1; also elsewhere on the board
~AUX_INTn: J502.3; also elsewhere on the board
~DISP_CSn: J501.11; also elsewhere on the board
~FP_BTN_1An: J501.14; also elsewhere on the board
~FP_BTN_1Bn: J501.12; also elsewhere on the board
~FP_BTN_2An: J502.14; also elsewhere on the board
~FP_BTN_2Bn: J502.13; also elsewhere on the board
~FP_ENC2_SWn: J501.10; also elsewhere on the board
~FP_ENC_SWn: J502.2; also elsewhere on the board
~SYS_RSTn: J502.5; also elsewhere on the board

Notes on the sheet:
Addr=1001011
Alt: Molex Molex_MicroClasp-55935-0210 (OTS Cable: e.g. 15136-0203) https://www.molex.com/molex/products/part-detail/pcb_headers/0559350210
Rx(4-bit) range=[open, 80k, ..., 5,33k] V_hwid(min) = 27/(80+27)*3.0V = 0,76V V_hwid(max) = 27(5.33+27)*3.0V = 2,51V
[b2:20k]
[Lsb:80k]
Addr=1001001
Note: There're additional up-to 5 TMP100 sensors on the front panel. Display-side, left : addr=1001000 Display-side, right : addr=1001010 Inside, left : addr=1001100 Inside, middle : addr=1001101 Inside, right: addr=1001110
The left-side of front panel supports either an on/off Power-button OR optionally a 2nd rotary encoder. HWID_FP should be used to indicate which option is chosen
Ambient temperature sensors (TMP100)
Place vDD_OLED LDO close to FFC connectors
Addr=1001111
FancyBtn LED connector (PWM ctrl low-side; 5V/12V selectable V+)
Mainboard HWID (analog 4-bit)
[Msb:10k]
[b1:40k]

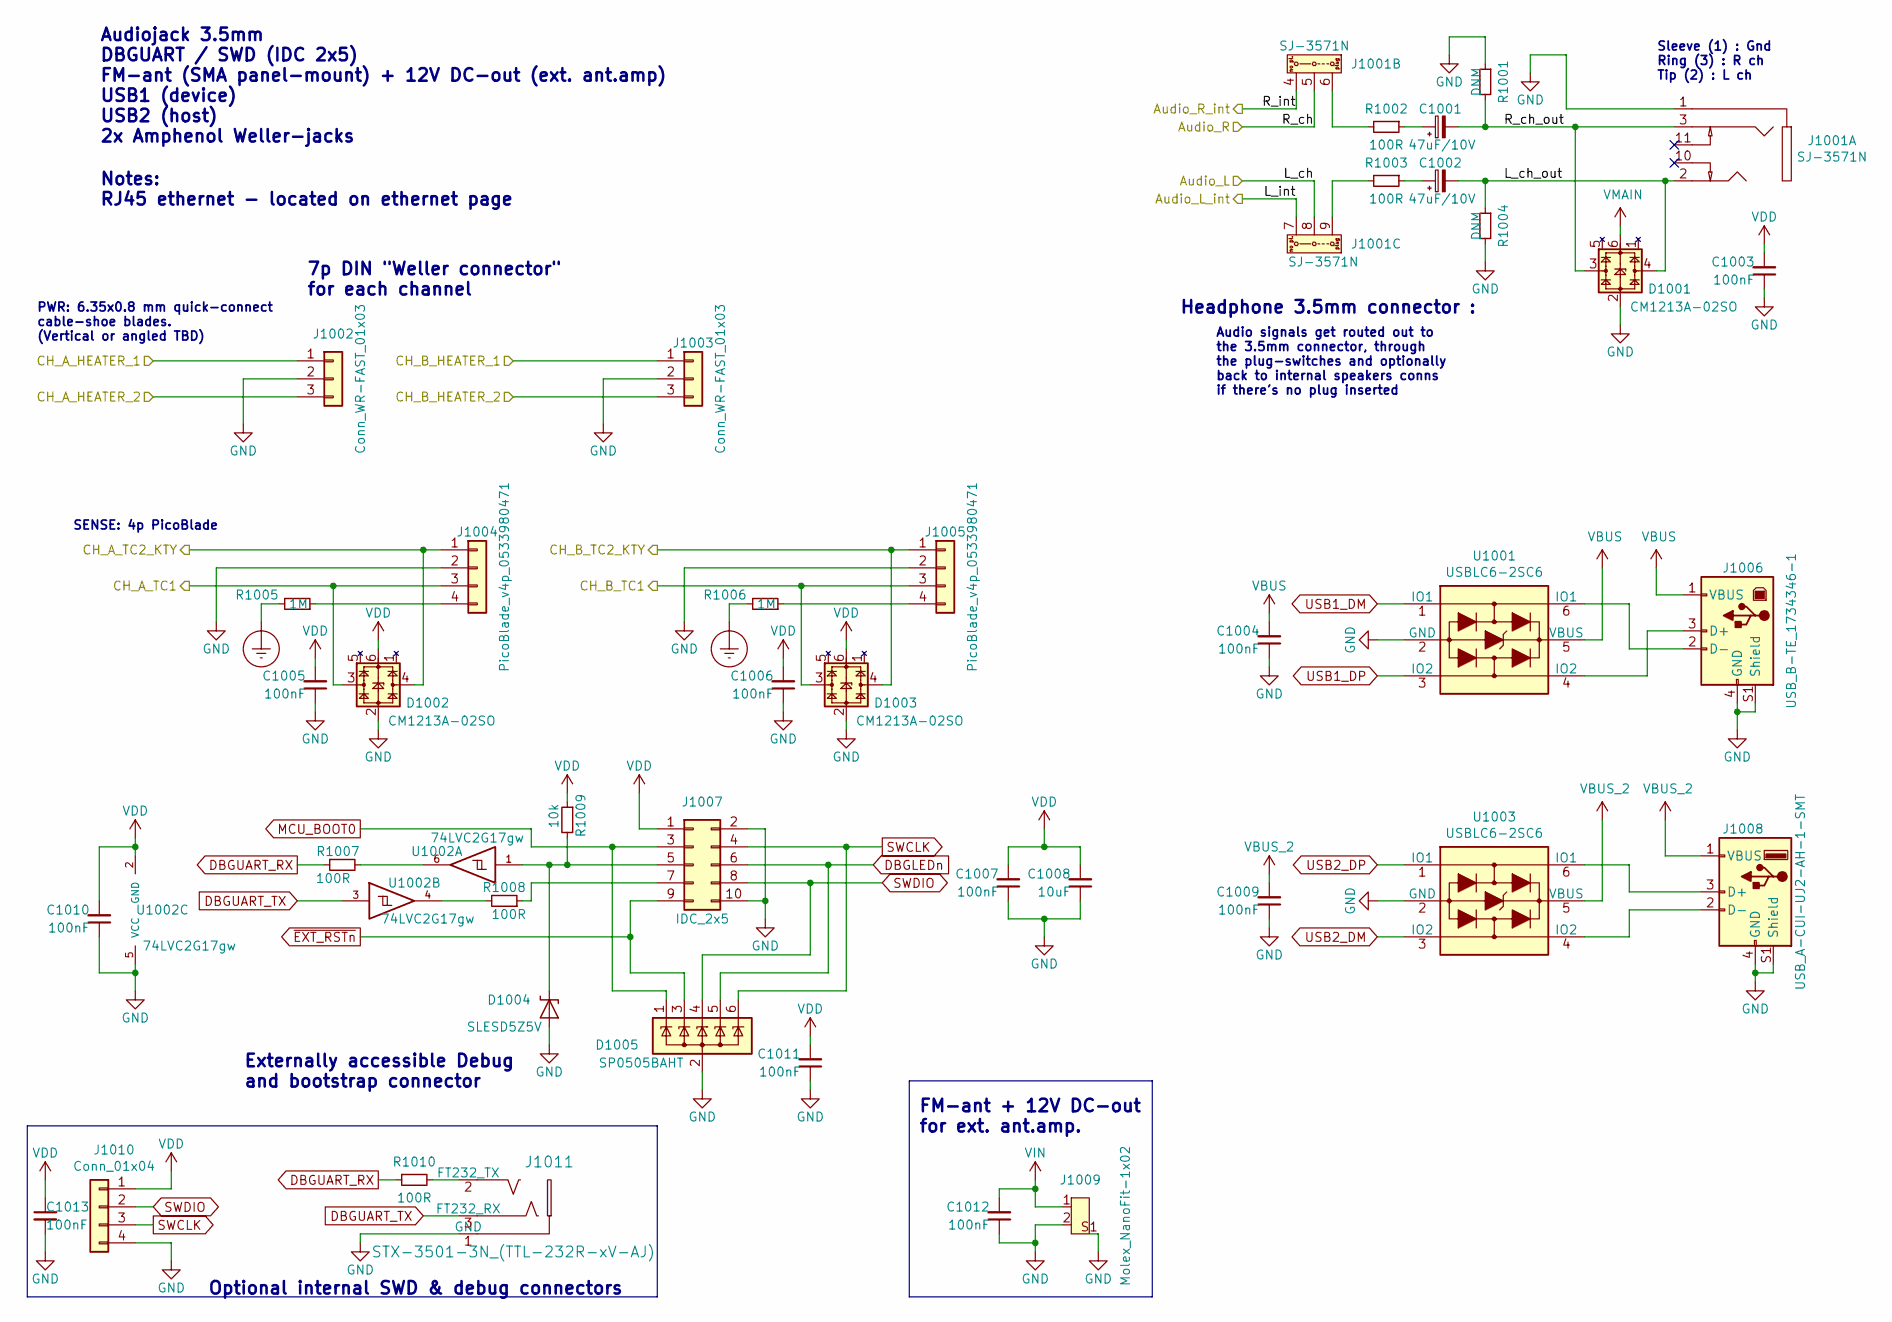
[picture p207: schematic rear_panel_conn.kicad_sch, Backside connectors]

Parts:
C1001, C1002: 47uF/10V; CP_Elec_6.3x5.8
C1003, C1004, C1005, C1006, C1007, C1009, C1010, C1011, C1012, C1013: 100nF; C_0402_1005Metric; JLC_part Basic
C1008: 10uF; C_0402_1005Metric; JLC_part Basic
D1001, D1002, D1003: CM1213A-02SO; SC-74-6
D1004: SLESD5Z5V; D_SOD-523
D1005: SP0505BAHT; TSOT-23-6
J1001: SJ-3571N
J1002, J1003: Conn_WR-FAST_01x03; WR-FAST_508_3_V
J1004, J1005: PicoBlade_v4p_0533980471; Molex_PicoBlade_53398-0471_1x04-1MP_P1.25mm_Vertical
J1006: USB_B-TE_1734346-1; TE_1734346
J1007: IDC_2x5; IDC-Header_2x05_P2.54mm_Horizontal
J1008: USB_A-CUI-UJ2-AH-1-SMT; CUI-UJ2_AH_1_SMT
J1009: Molex_NanoFit-1x02; Molex_NanoFit_105430-1102_1x02_P2.50mm_Horizontal
J1010: Conn_01x04; PinHeader_1x04_P2.54mm_Vertical
J1011: STX-3501-3N_(TTL-232R-xV-AJ); STX3501_smd
R1001, R1004: DNM; R_0402_1005Metric
R1002, R1003, R1007, R1008, R1010: 100R; R_0402_1005Metric; JLC_part Basic
R1005, R1006: 1M; R_0402_1005Metric; JLC_part Basic
R1009: 10k; R_0402_1005Metric; JLC_part Basic
U1001, U1003: USBLC6-2SC6; TSOT-23-6; JLC_part Extended
U1002: 74LVC2G17gw; SOT-363_SC-70-6_Handsoldering; JLC_part Extended

Connections:
/Rear panel connections/CH_A_TC1: D1002.3 (CH1), J1004.3; also elsewhere on the board
/Rear panel connections/CH_B_TC1: D1003.3 (CH1), J1005.3; also elsewhere on the board
/Rear panel connections/L_ch: J1001.8 (b); also elsewhere on the board
/Rear panel connections/L_ch_out: C1002.2, D1001.4 (CH2), J1001.2 (tip), R1004.1
/Rear panel connections/L_int: J1001.7 (nc_b); also elsewhere on the board
/Rear panel connections/R_ch: J1001.5 (a); also elsewhere on the board
/Rear panel connections/R_ch_out: C1001.2, D1001.3 (CH1), J1001.3 (ring), R1001.2
/Rear panel connections/R_int: J1001.4 (nc_a); also elsewhere on the board
/Weller contol/CH_A_KTY_SNS: D1002.4 (CH2), J1004.1; also elsewhere on the board
/Weller contol/CH_B_KTY_SNS: D1003.4 (CH2), J1005.1; also elsewhere on the board
/Weller contol/Channel A/HEATER_1: J1002.1; also elsewhere on the board
/Weller contol/Channel A/HEATER_2: J1002.3; also elsewhere on the board
/Weller contol/Channel B/HEATER_1: J1003.1; also elsewhere on the board
/Weller contol/Channel B/HEATER_2: J1003.3; also elsewhere on the board
AGND: C1003.1, C1004.1, C1005.1, C1006.1, C1007.1, C1008.1, C1009.1, C1010.1, C1011.1, C1012.1, C1013.2, D1001.2 (VN), D1002.2 (VN), D1003.2 (VN), D1004.2 (A), D1005.2 (A), J1001.1 (sleeve), J1002.2, J1003.2, J1004.2, J1005.2, J1006.4 (GND), J1006.S1 (Shield), J1006.S2 (Shield), J1007.2, J1007.10, J1008.4 (GND), J1008.S1 (Shield), J1008.S2 (Shield), J1009.2, J1009.S1, J1009.S2, J1010.4, J1011.1 (GND), R1001.1, R1004.2, U1001.2 (GND), U1002.5 (VCC), U1003.2 (GND); also elsewhere on the board
DBGLEDn: D1005.5 (K), J1007.6; also elsewhere on the board
DBGUART_RX: R1007.1, R1010.1; also elsewhere on the board
DBGUART_TX: J1011.3 (FT232_RX), U1002.3; also elsewhere on the board
MCU_BOOT0: D1005.1 (K), J1007.3; also elsewhere on the board
unnamed: C1001.1, R1002.1
unnamed: C1002.1, R1003.1
unnamed: D1004.1 (C), J1007.5, R1009.2, U1002.1
unnamed: J1001.6 (no_a), R1002.2
unnamed: J1001.9 (no_b), R1003.2
unnamed: J1004.4, R1005.1
unnamed: J1005.4, R1006.1
unnamed: J1006.2 (D-), U1001.6 (IO1)
unnamed: J1006.3 (D+), U1001.4 (IO2)
unnamed: J1007.7, R1008.1
unnamed: J1008.2 (D-), U1003.4 (IO2)
unnamed: J1008.3 (D+), U1003.6 (IO1)
unnamed: J1011.2 (FT232_TX), R1010.2
unnamed: R1007.2, U1002.6
unnamed: R1008.2, U1002.4
PE: R1005.2, R1006.2; also elsewhere on the board
SWCLK: D1005.6 (K), J1007.4, J1010.3; also elsewhere on the board
SWDIO: D1005.4 (K), J1007.8, J1010.2; also elsewhere on the board
USB1_DM: U1001.1 (IO1); also elsewhere on the board
USB1_DP: U1001.3 (IO2); also elsewhere on the board
USB2_DM: U1003.3 (IO2); also elsewhere on the board
USB2_DP: U1003.1 (IO1); also elsewhere on the board
VBUS: C1004.2, J1006.1 (VBUS), U1001.5 (VBUS); also elsewhere on the board
VBUS_2: C1009.2, J1008.1 (VBUS), U1003.5 (VBUS); also elsewhere on the board
VCC: C1003.2, C1005.2, C1006.2, C1007.2, C1008.2, C1010.2, C1011.2, C1013.1, D1002.6 (VP), D1003.6 (VP), J1007.1, J1010.1, R1009.1, U1002.2 (GND); also elsewhere on the board
VIN: C1012.2, J1009.1; also elsewhere on the board
VMAIN: D1001.6 (VP); also elsewhere on the board
~EXT_RSTn: D1005.3 (K), J1007.9; also elsewhere on the board

Notes on the sheet:
PWR: 6.35x0.8 mm quick-connect cable-shoe blades. (Vertical or angled TBD)
FM-ant + 12V DC-out for ext. ant.amp.
Sleeve (1) : Gnd Ring (3) : R ch Tip (2) : L ch
SENSE: 4p PicoBlade
Optional internal SWD & debug connectors
Headphone 3.5mm connector :
Audio signals get routed out to the 3.5mm connector, through the plug-switches and optionally back to internal speakers conns if there's no plug inserted
7p DIN "Weller connector" for each channel
Notes: RJ45 ethernet - located on ethernet page
Audiojack 3.5mm DBGUART / SWD (IDC 2x5) FM-ant (SMA panel-mount) + 12V DC-out (ext. ant.amp) USB1 (device) USB2 (host) 2x Amphenol Weller-jacks
Externally accessible Debug and bootstrap connector
