mjohansson/SolderingStation/hw/solderstn_mb/solderstn_mb.kicad_pcb

## KiCad design hw/solderstn_mb/solderstn_mb.kicad_pcb (continued)

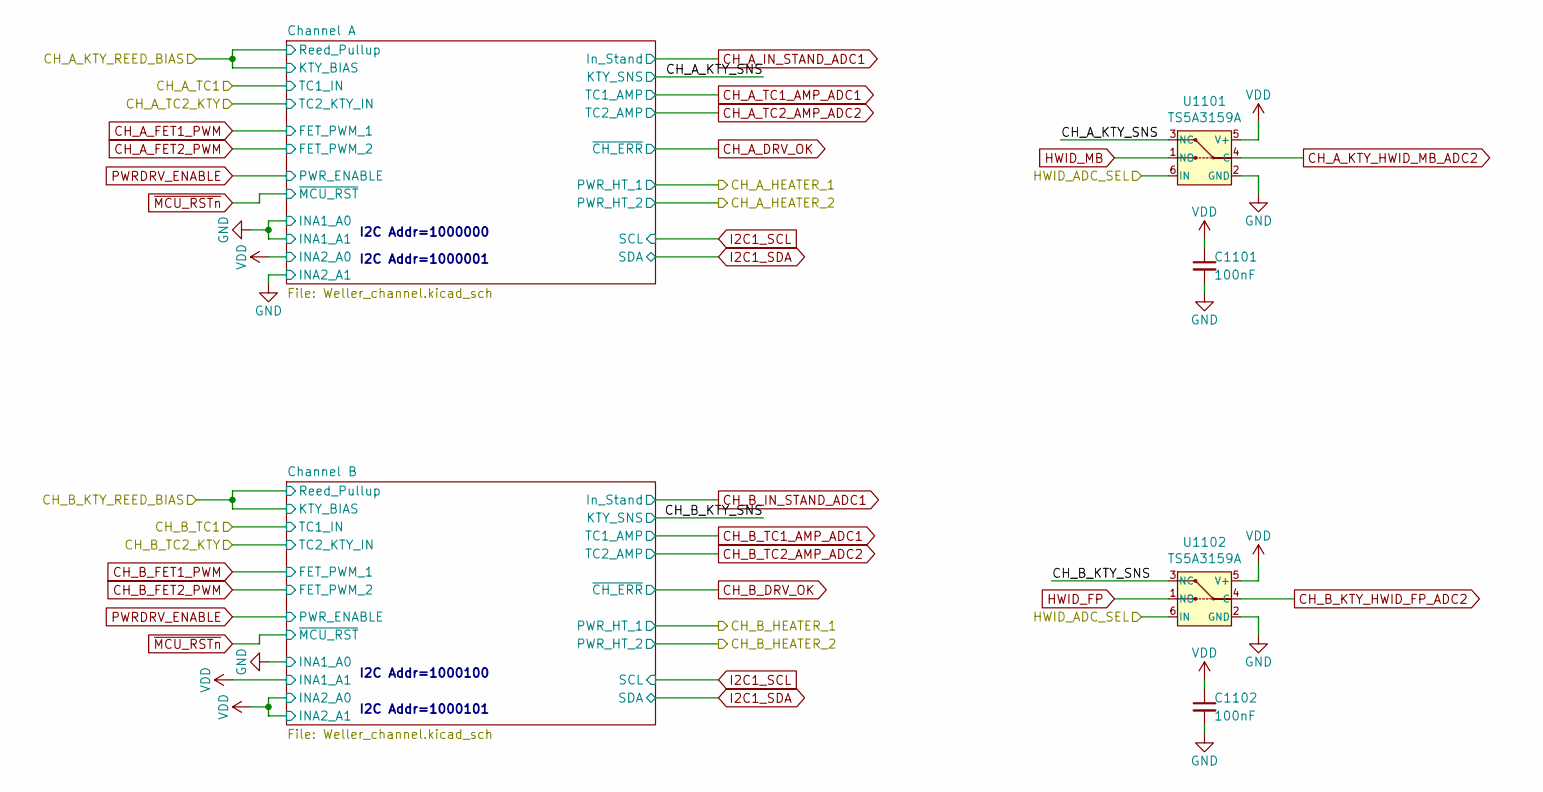
[picture p208: schematic Weller_ctrl.kicad_sch, Dual Weller WMRP or WMRT capable channels]

Parts:
C1101, C1102: 100nF; C_0402_1005Metric; JLC_part Basic
U1101, U1102: TS5A3159A; TSOT-23-6; JLC_part Extended

Connections:
/STM32F429 MCU/HWID_ADC_SELECT: U1101.6 (IN), U1102.6 (IN); also elsewhere on the board
/Weller contol/CH_A_KTY_SNS: U1101.3 (NC); also elsewhere on the board
/Weller contol/CH_B_KTY_SNS: U1102.3 (NC); also elsewhere on the board
AGND: C1101.2, C1102.2, U1101.2 (GND), U1102.2 (GND); also elsewhere on the board
CH_A_KTY_HWID_MB_ADC2: U1101.4 (C); also elsewhere on the board
CH_B_KTY_HWID_FP_ADC2: U1102.4 (C); also elsewhere on the board
HWID_FP: U1102.1 (NO); also elsewhere on the board
HWID_MB: U1101.1 (NO); also elsewhere on the board
VCC: C1101.1, C1102.1, U1101.5 (V+), U1102.5 (V+); also elsewhere on the board

Notes on the sheet:
I2C Addr=1000100
I2C Addr=1000001
I2C Addr=1000101
I2C Addr=1000000

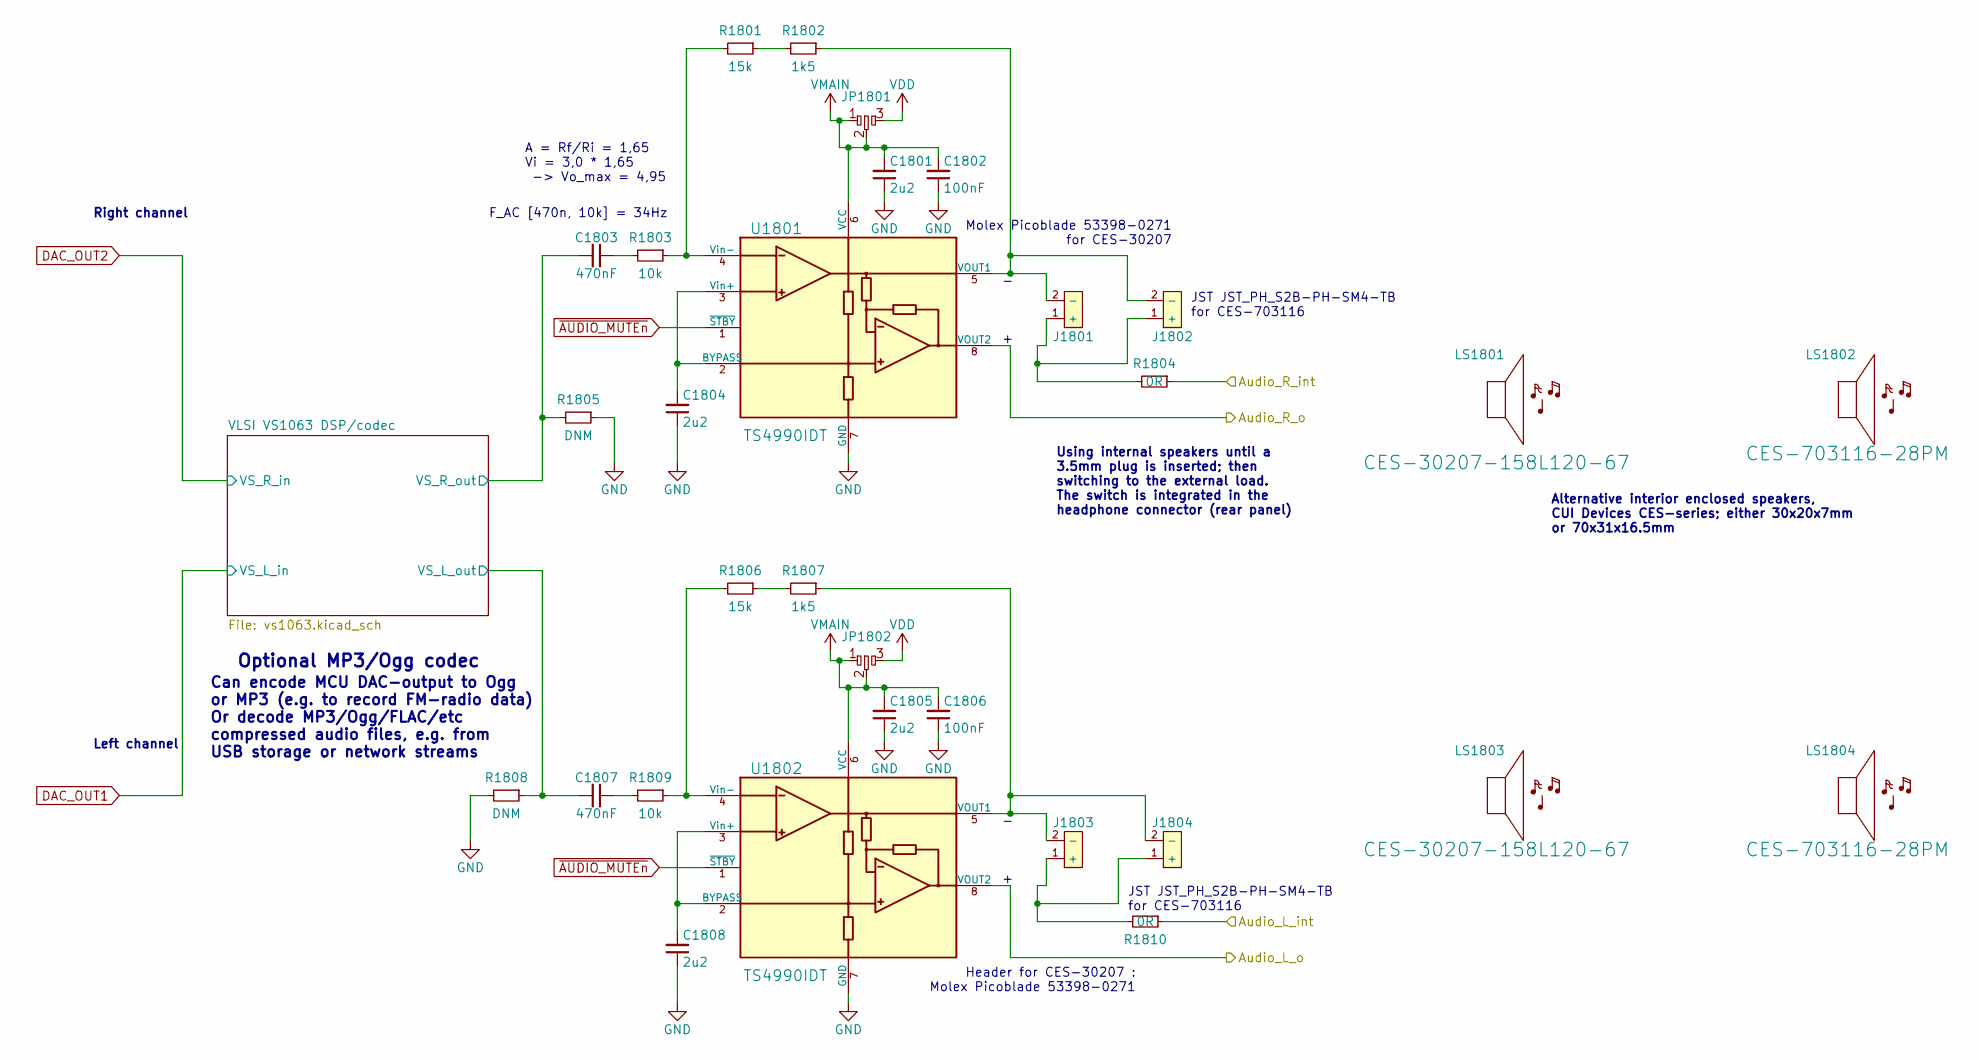
[picture p209: schematic audio.kicad_sch, Audio & MP3/OGG/FLAC :)]

Parts:
C1801, C1804, C1805, C1808: 2u2; C_0603_1608Metric; JLC_part Basic
C1802, C1806: 100nF; C_0402_1005Metric; JLC_part Basic
C1803, C1807: 470nF; C_0402_1005Metric; JLC_part Basic
J1801, J1803: CES-30207-158L120-67_Molex-PicoBlade_conn; Molex_PicoBlade_53398-0271_1x02-1MP_P1.25mm_Vertical
J1802, J1804: CES-703116-28PM_JST-conn; JST_PH_S2B-PH-SM4-TB_1x02-1MP_P2.00mm_Horizontal
JP1801, JP1802: dogbone_3_ud; db3_ud_0402
LS1801, LS1803: CES-30207-158L120-67; CUI_CES-30207
LS1802, LS1804: CES-703116-28PM; CUI_CES-703116-28PM
R1801, R1806: 15k; R_0402_1005Metric; JLC_part Basic
R1802, R1807: 1k5; R_0402_1005Metric; JLC_part Basic
R1803, R1809: 10k; R_0402_1005Metric; JLC_part Basic
R1804, R1810: 0R; R_1206_3216Metric; JLC_part Basic
R1805, R1808: DNM; R_0402_1005Metric
U1801, U1802: TS4990IDT; SOIC-8_3.9x4.9mm_P1.27mm

Connections:
/Audio & int. speakers/VLSI VS1063 DSP/codec/VS_L_out: C1807.2, R1808.1; also elsewhere on the board
/Audio & int. speakers/VLSI VS1063 DSP/codec/VS_R_out: C1803.2, R1805.2; also elsewhere on the board
/Rear panel connections/L_ch: U1802.8 (VOUT2); also elsewhere on the board
/Rear panel connections/L_int: R1810.1; also elsewhere on the board
/Rear panel connections/R_ch: U1801.8 (VOUT2); also elsewhere on the board
/Rear panel connections/R_int: R1804.1; also elsewhere on the board
AGND: C1801.1, C1802.1, C1804.1, C1805.1, C1806.1, C1808.1, R1805.1, R1808.2, U1801.7 (GND), U1802.7 (GND); also elsewhere on the board
unnamed: C1803.1, R1803.2
unnamed: C1804.2, U1801.2 (BYPASS), U1801.3 (Vin+)
unnamed: C1807.1, R1809.2
unnamed: C1808.2, U1802.2 (BYPASS), U1802.3 (Vin+)
unnamed: J1801.1 (+), J1802.1 (+), R1804.2
unnamed: J1801.2 (-), J1802.2 (-), R1802.1, U1801.5 (VOUT1)
unnamed: J1803.1 (+), J1804.1 (+), R1810.2
unnamed: J1803.2 (-), J1804.2 (-), R1807.1, U1802.5 (VOUT1)
unnamed: R1801.1, R1802.2
unnamed: R1801.2, R1803.1, U1801.4 (Vin-)
unnamed: R1806.1, R1807.2
unnamed: R1806.2, R1809.1, U1802.4 (Vin-)
VCC: JP1801.3, JP1802.3; also elsewhere on the board
VMAIN: C1801.2, C1802.2, C1805.2, C1806.2, JP1801.1, JP1801.2, JP1802.1, JP1802.2, U1801.6 (VCC), U1802.6 (VCC); also elsewhere on the board
~AUDIO_MUTEn: U1801.1 (~STBY), U1802.1 (~STBY); also elsewhere on the board

Notes on the sheet:
JST JST_PH_S2B-PH-SM4-TB for CES-703116
- +
F_AC [470n, 10k] = 34Hz
Using internal speakers until a 3.5mm plug is inserted; then switching to the external load. The switch is integrated in the headphone connector (rear panel)
A = Rf/Ri = 1,65 Vi = 3,0 * 1,65 -> Vo_max = 4,95
Right channel
Optional MP3/Ogg codec
Header for CES-30207 : Molex Picoblade 53398-0271
Left channel
Alternative interior enclosed speakers, CUI Devices CES-series; either 30x20x7mm or 70x31x16.5mm
Can encode MCU DAC-output to Ogg or MP3 (e.g. to record FM-radio data) Or decode MP3/Ogg/FLAC/etc compressed audio files, e.g. from USB storage or network streams
Molex Picoblade 53398-0271 for CES-30207

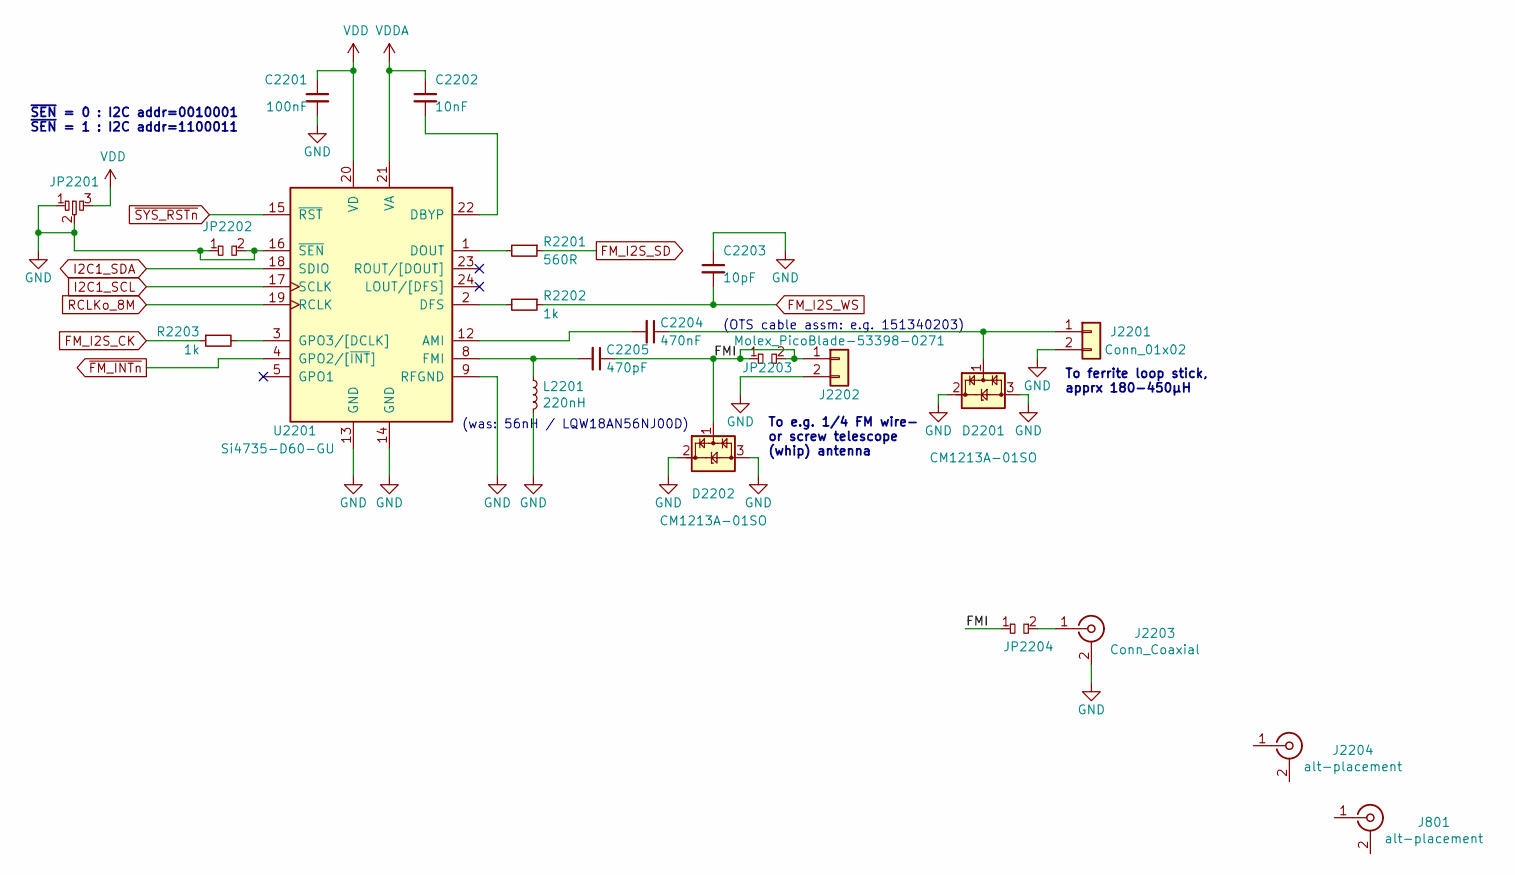
[picture p210: schematic fm_radio.kicad_sch, FM radio receiver]

Parts:
C2201: 100nF; C_0402_1005Metric; JLC_part Basic
C2202: 10nF; C_0402_1005Metric; JLC_part Basic
C2203: 10pF; C_0402_1005Metric; JLC_part Basic
C2204: 470nF; C_0402_1005Metric; JLC_part Basic
C2205: 470pF; C_0402_1005Metric; JLC_part Basic
D2201, D2202: CM1213A-01SO; SOT-23
J801, J2204: alt-placement; SMA_Molex_73251-2200_Horizontal
J2201: Conn_01x02; PinHeader_1x02_P2.54mm_Vertical
J2202: Molex_PicoBlade-53398-0271; Molex_PicoBlade_53398-0271_1x02-1MP_P1.25mm_Vertical
J2203: Conn_Coaxial; SMA_Molex_73251-2200_Horizontal
JP2201: dogbone_3_ud; db3_ud_0402
JP2202, JP2203, JP2204: dogbone_2_ud; db2_ud_0402
L2201: 220nH; L_0603_1608Metric; JLC_part Extended
R2201: 560R; R_0603_1608Metric; JLC_part Basic
R2202, R2203: 1k; R_0402_1005Metric; JLC_part Basic
U2201: Si4735-D60-GU; SSOP-24_3.9x8.7mm_P0.635mm

Connections:
/FM-radio rx/FMI: C2205.1, D2202.1 (CH1), J2202.1, JP2203.1, JP2203.2, JP2204.1
AGND: C2201.2, C2203.1, D2201.2 (VP), D2201.3 (VN), D2202.2 (VP), D2202.3 (VN), J2201.2, J2202.2, J2203.2 (Ext), JP2201.1, JP2201.2, JP2202.1, JP2202.2, L2201.2, U2201.9 (RFGND), U2201.13 (GND), U2201.14 (GND), U2201.16 (~SEN); also elsewhere on the board
AVDD: C2202.1, U2201.21 (VA); also elsewhere on the board
FM_I2S_CK: R2203.1; also elsewhere on the board
FM_I2S_SD: R2201.1; also elsewhere on the board
FM_I2S_WS: C2203.2, R2202.1; also elsewhere on the board
I2C1_SCL: U2201.17 (SCLK); also elsewhere on the board
I2C1_SDA: U2201.18 (SDIO); also elsewhere on the board
unnamed: C2202.2, U2201.22 (DBYP)
unnamed: C2204.1, D2201.1 (CH1), J2201.1
unnamed: C2204.2, U2201.12 (AMI)
unnamed: C2205.2, L2201.1, U2201.8 (FMI)
unnamed: J2203.1 (In), JP2204.2
unnamed: R2201.2, U2201.1 (DOUT)
unnamed: R2202.2, U2201.2 (DFS)
unnamed: R2203.2, U2201.3 (GPO3/[DCLK])
RCLKo_8M: U2201.19 (RCLK); also elsewhere on the board
VCC: C2201.1, JP2201.3, U2201.20 (VD); also elsewhere on the board
~FM_INTn: U2201.4 (GPO2/[~INT]); also elsewhere on the board
~SYS_RSTn: U2201.15 (~RST); also elsewhere on the board

Notes on the sheet:
To ferrite loop stick, apprx 180-450µH
(was: 56nH / LQW18AN56NJ00D)
~{SEN} = 0 : I2C addr=0010001 ~{SEN} = 1 : I2C addr=1100011
(OTS cable assm: e.g. 151340203)
To e.g. 1/4 FM wire- or screw telescope (whip) antenna

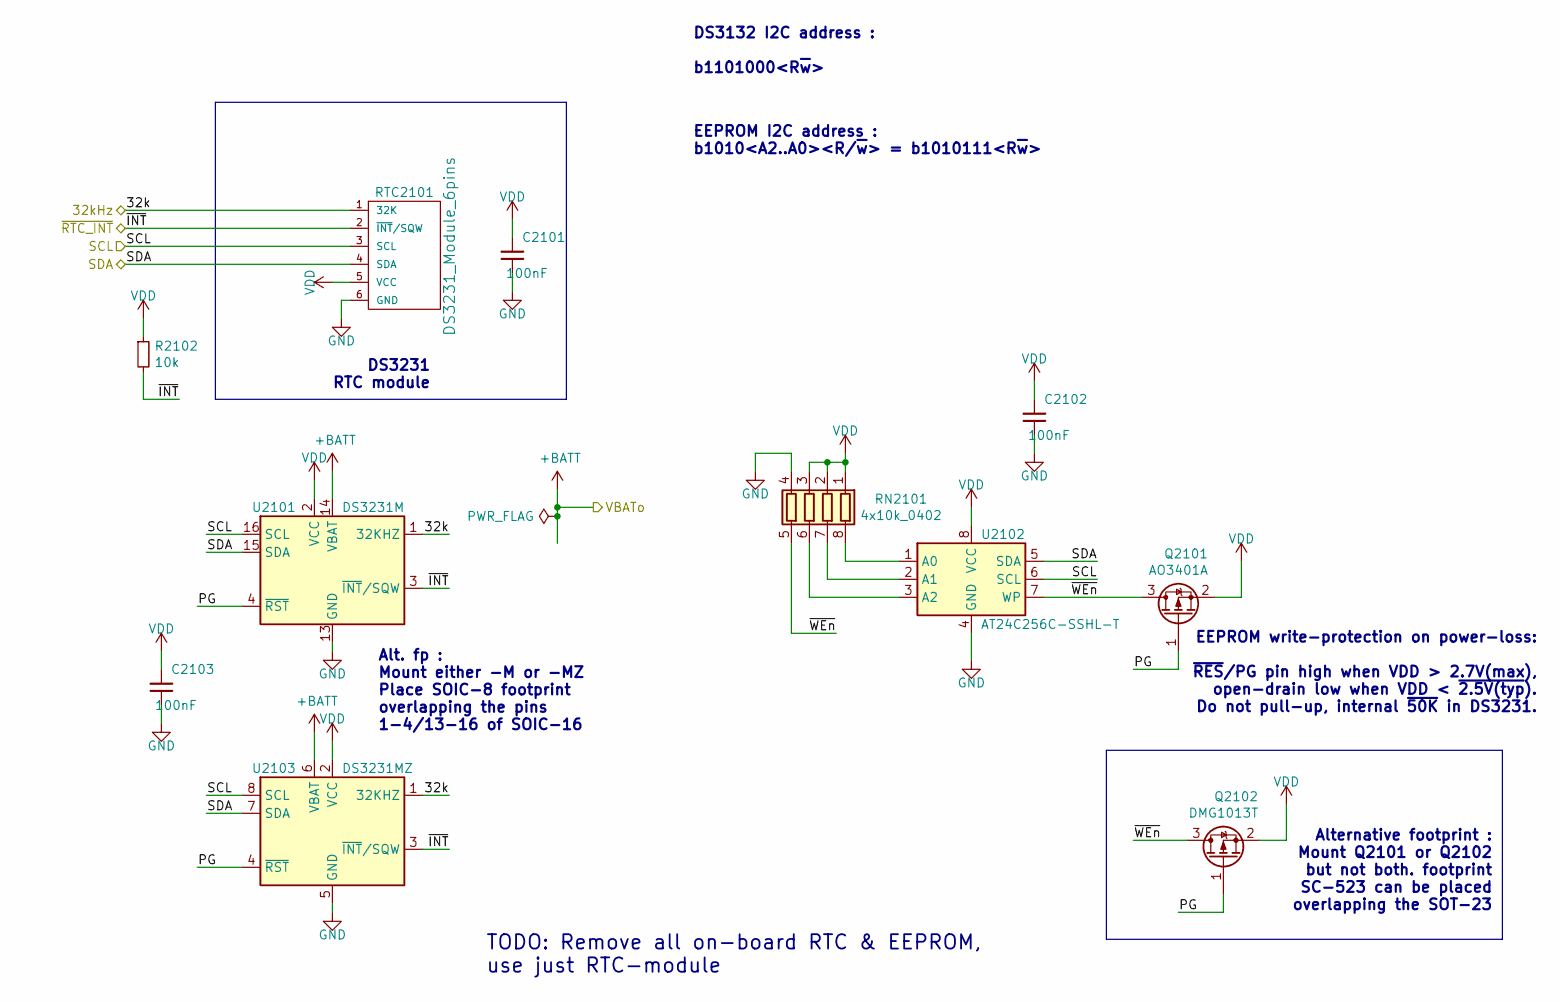
[picture p211: schematic RTC.kicad_sch, External RTC]

Parts:
C2101, C2102, C2103: 100nF; C_0402_1005Metric; JLC_part Basic
Q2101: AO3401A; SOT-23; JLC_part Basic
Q2102: DMG1013T; SOT-523_handsoldering; JLC_part Extended
R2102: 10k; R_0402_1005Metric; JLC_part Basic
RN2101: 4x10k_0402; R_Array_Convex_4x0402; JLC_part Basic
RTC2101: DS3231_Module_6pins; DS3231_module_6pin_horizontal_mnt
U2101: DS3231M; SOIC-16W_7.5x10.3mm_P1.27mm; JLC_part Basic
U2102: AT24C256C-SSHL-T; SO-8_3.9x4.9mm_P1.27mm; JLC_part Basic
U2103: DS3231MZ; SOIC-8_3.9x4.9mm_P1.27mm; JLC_part Extended

Connections:
+BATT: U2101.14 (VBAT), U2103.6 (VBAT)
/STM32F429 MCU/32kHz: RTC2101.1 (32K), U2101.1 (32KHZ), U2103.1 (32KHZ); also elsewhere on the board
/STM32F429 MCU/External RTC/PG: Q2101.1 (G), Q2102.1 (G), U2101.4 (~RST), U2103.4 (~RST)
/STM32F429 MCU/External RTC/~WEn: Q2101.3 (D), Q2102.3 (D), RN2101.5 (R4.2), U2102.7 (WP)
/STM32F429 MCU/~RTC_INTn: R2102.2, RTC2101.2 (~INT/SQW), U2101.3 (~INT/SQW), U2103.3 (~INT/SQW); also elsewhere on the board
AGND: C2101.1, C2102.1, C2103.1, RN2101.4 (R4.1), RTC2101.6 (GND), U2101.5 (GND), U2101.6 (GND), U2101.7 (GND), U2101.8 (GND), U2101.9 (GND), U2101.10 (GND), U2101.11 (GND), U2101.12 (GND), U2101.13 (GND), U2102.4 (GND), U2103.5 (GND); also elsewhere on the board
I2C1_SCL: RTC2101.3 (SCL), U2101.16 (SCL), U2102.6 (SCL), U2103.8 (SCL); also elsewhere on the board
I2C1_SDA: RTC2101.4 (SDA), U2101.15 (SDA), U2102.5 (SDA), U2103.7 (SDA); also elsewhere on the board
unnamed: RN2101.6 (R3.2), U2102.3 (A2)
unnamed: RN2101.7 (R2.2), U2102.2 (A1)
unnamed: RN2101.8 (R1.2), U2102.1 (A0)
VCC: C2101.2, C2102.2, C2103.2, Q2101.2 (S), Q2102.2 (S), R2102.1, RN2101.1 (R1.1), RN2101.2 (R2.1), RN2101.3 (R3.1), RTC2101.5 (VCC), U2101.2 (VCC), U2102.8 (VCC), U2103.2 (VCC); also elsewhere on the board

Notes on the sheet:
EEPROM write-protection on power-loss: ~{RES}/PG pin high when VDD > 2.7V(max), open-drain low when VDD < ~{2.5V(typ}). Do not pull-up, internal ~{50K} in DS3231.
DS3231 RTC module
Alt. fp : Mount either -M or -MZ Place SOIC-8 footprint overlapping the pins 1-4/13-16 of SOIC-16
TODO: Remove all on-board RTC & EEPROM, use just RTC-module
DS3132 I2C address : b1101000<R~{w}>
Alternative footprint : Mount Q2101 or Q2102 but not both. footprint SC-523 can be placed overlapping the SOT-23
EEPROM I2C address : b1010<A2..A0><R/~{w}> = b1010111<R~{w}>

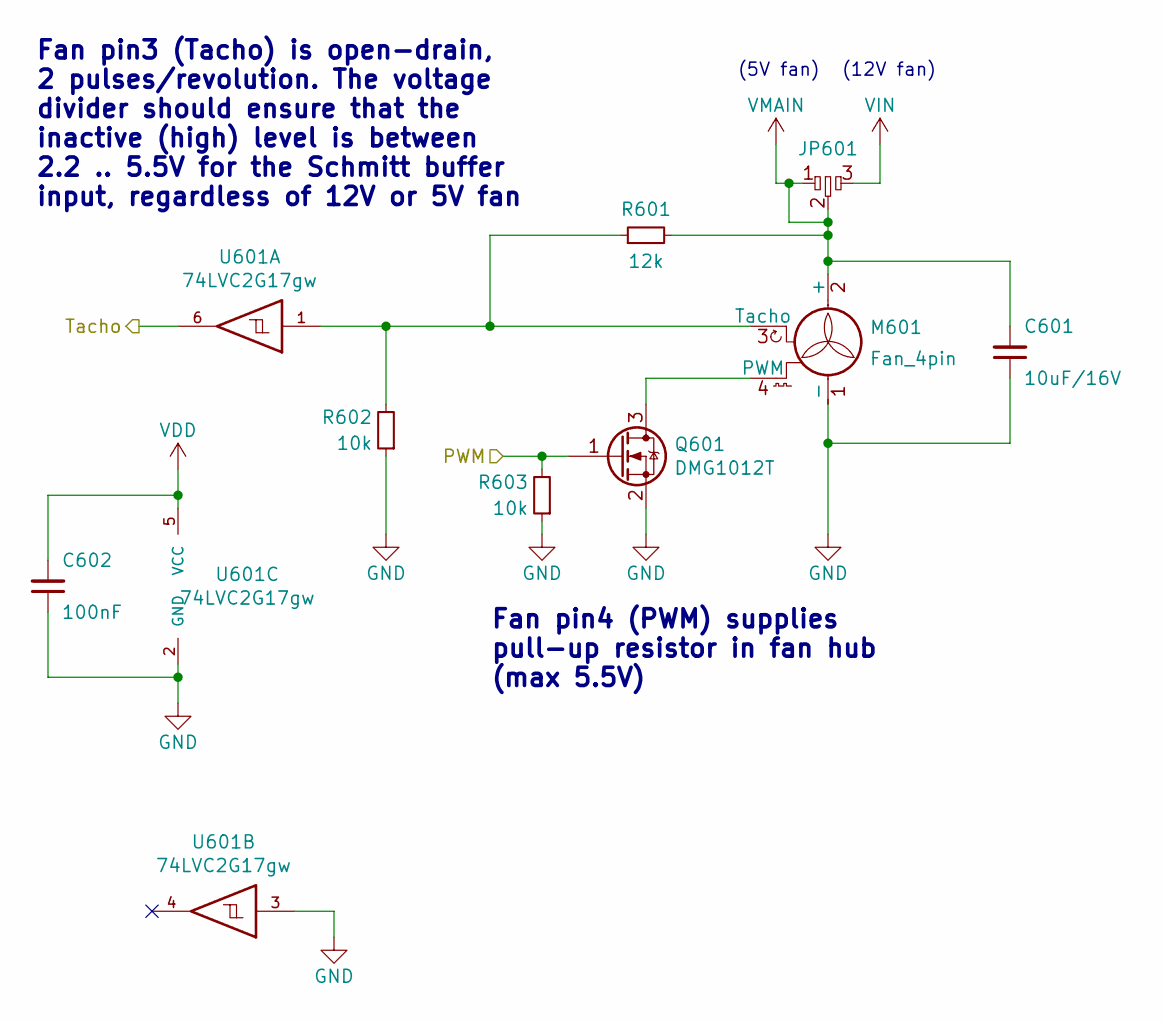
[picture p212: schematic fan_ctrl.kicad_sch, Fan controller]

Parts:
C601: 10uF/16V; C_0805_2012Metric; JLC_part Basic
C602: 100nF; C_0402_1005Metric; JLC_part Basic
JP601: dogbone_3_ud; db3_ud_0402
M601: Fan_4pin; FanPinHeader_1x04_P2.54mm_Vertical; Mfg_pn Molex 47053-1000
Q601: DMG1012T; SOT-523_handsoldering; JLC_part Extended
R601: 12k; R_0402_1005Metric; JLC_part Basic
R602, R603: 10k; R_0402_1005Metric; JLC_part Basic
U601: 74LVC2G17gw; SOT-363_SC-70-6_Handsoldering; JLC_part Extended

Connections:
AGND: C601.1, C602.1, M601.1 (-), Q601.2 (S), R602.1, R603.1, U601.2 (GND), U601.3; also elsewhere on the board
FAN1_PWM: Q601.1 (G), R603.2; also elsewhere on the board
FAN1_RPM: U601.6; also elsewhere on the board
unnamed: M601.3 (Tacho), R601.1, R602.2, U601.1
unnamed: M601.4 (PWM), Q601.3 (D)
VCC: C602.2, U601.5 (VCC); also elsewhere on the board
VIN: JP601.3; also elsewhere on the board
VMAIN: C601.2, JP601.1, JP601.2, M601.2 (+), R601.2; also elsewhere on the board

Notes on the sheet:
Fan pin3 (Tacho) is open-drain, 2 pulses/revolution. The voltage divider should ensure that the inactive (high) level is between 2.2 .. 5.5V for the Schmitt buffer input, regardless of 12V or 5V fan
Fan pin4 (PWM) supplies pull-up resistor in fan hub (max 5.5V)
(12V fan)
(5V fan)

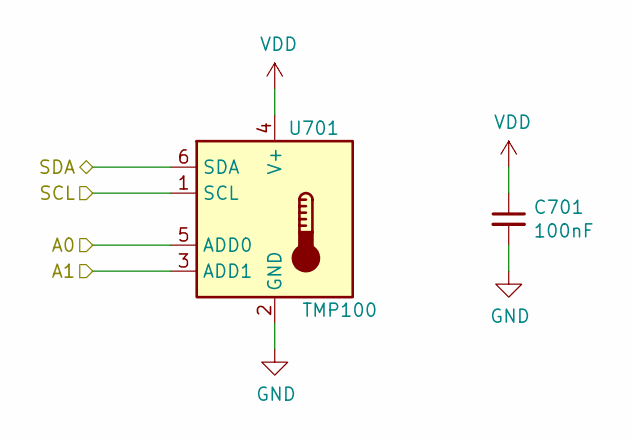
[picture p213: schematic temp_sensor.kicad_sch]

Parts:
C701: 100nF; C_0402_1005Metric; JLC_part Basic
U701: TMP100; TSOT-23-6; JLC_part Extended

Connections:
/Front panel connections/Temp.sensor 1/A0: U701.5 (ADD0)
AGND: C701.2, U701.2 (GND); also elsewhere on the board
GND: U701.3 (ADD1); also elsewhere on the board
I2C1_SCL: U701.1 (SCL); also elsewhere on the board
I2C1_SDA: U701.6 (SDA); also elsewhere on the board
VCC: C701.1, U701.4 (V+); also elsewhere on the board

Parts of its further copies:
C801, C901: 100nF; C_0402_1005Metric; JLC_part Basic
U801, U901: TMP100; TSOT-23-6; JLC_part Extended

Connections of its further copies:
/Front panel connections/Temp.sensor 2/A1: U801.3 (ADD1)
/Front panel connections/Temp.sensor 3/A1: U901.3 (ADD1)
AGND: C801.2, C901.2, U801.2 (GND), U901.2 (GND); also elsewhere on the board
GND: U801.5 (ADD0); also elsewhere on the board
I2C1_SCL: U801.1 (SCL), U901.1 (SCL); also elsewhere on the board
I2C1_SDA: U801.6 (SDA), U901.6 (SDA); also elsewhere on the board
VCC: C801.1, C901.1, U801.4 (V+), U901.4 (V+), U901.5 (ADD0); also elsewhere on the board

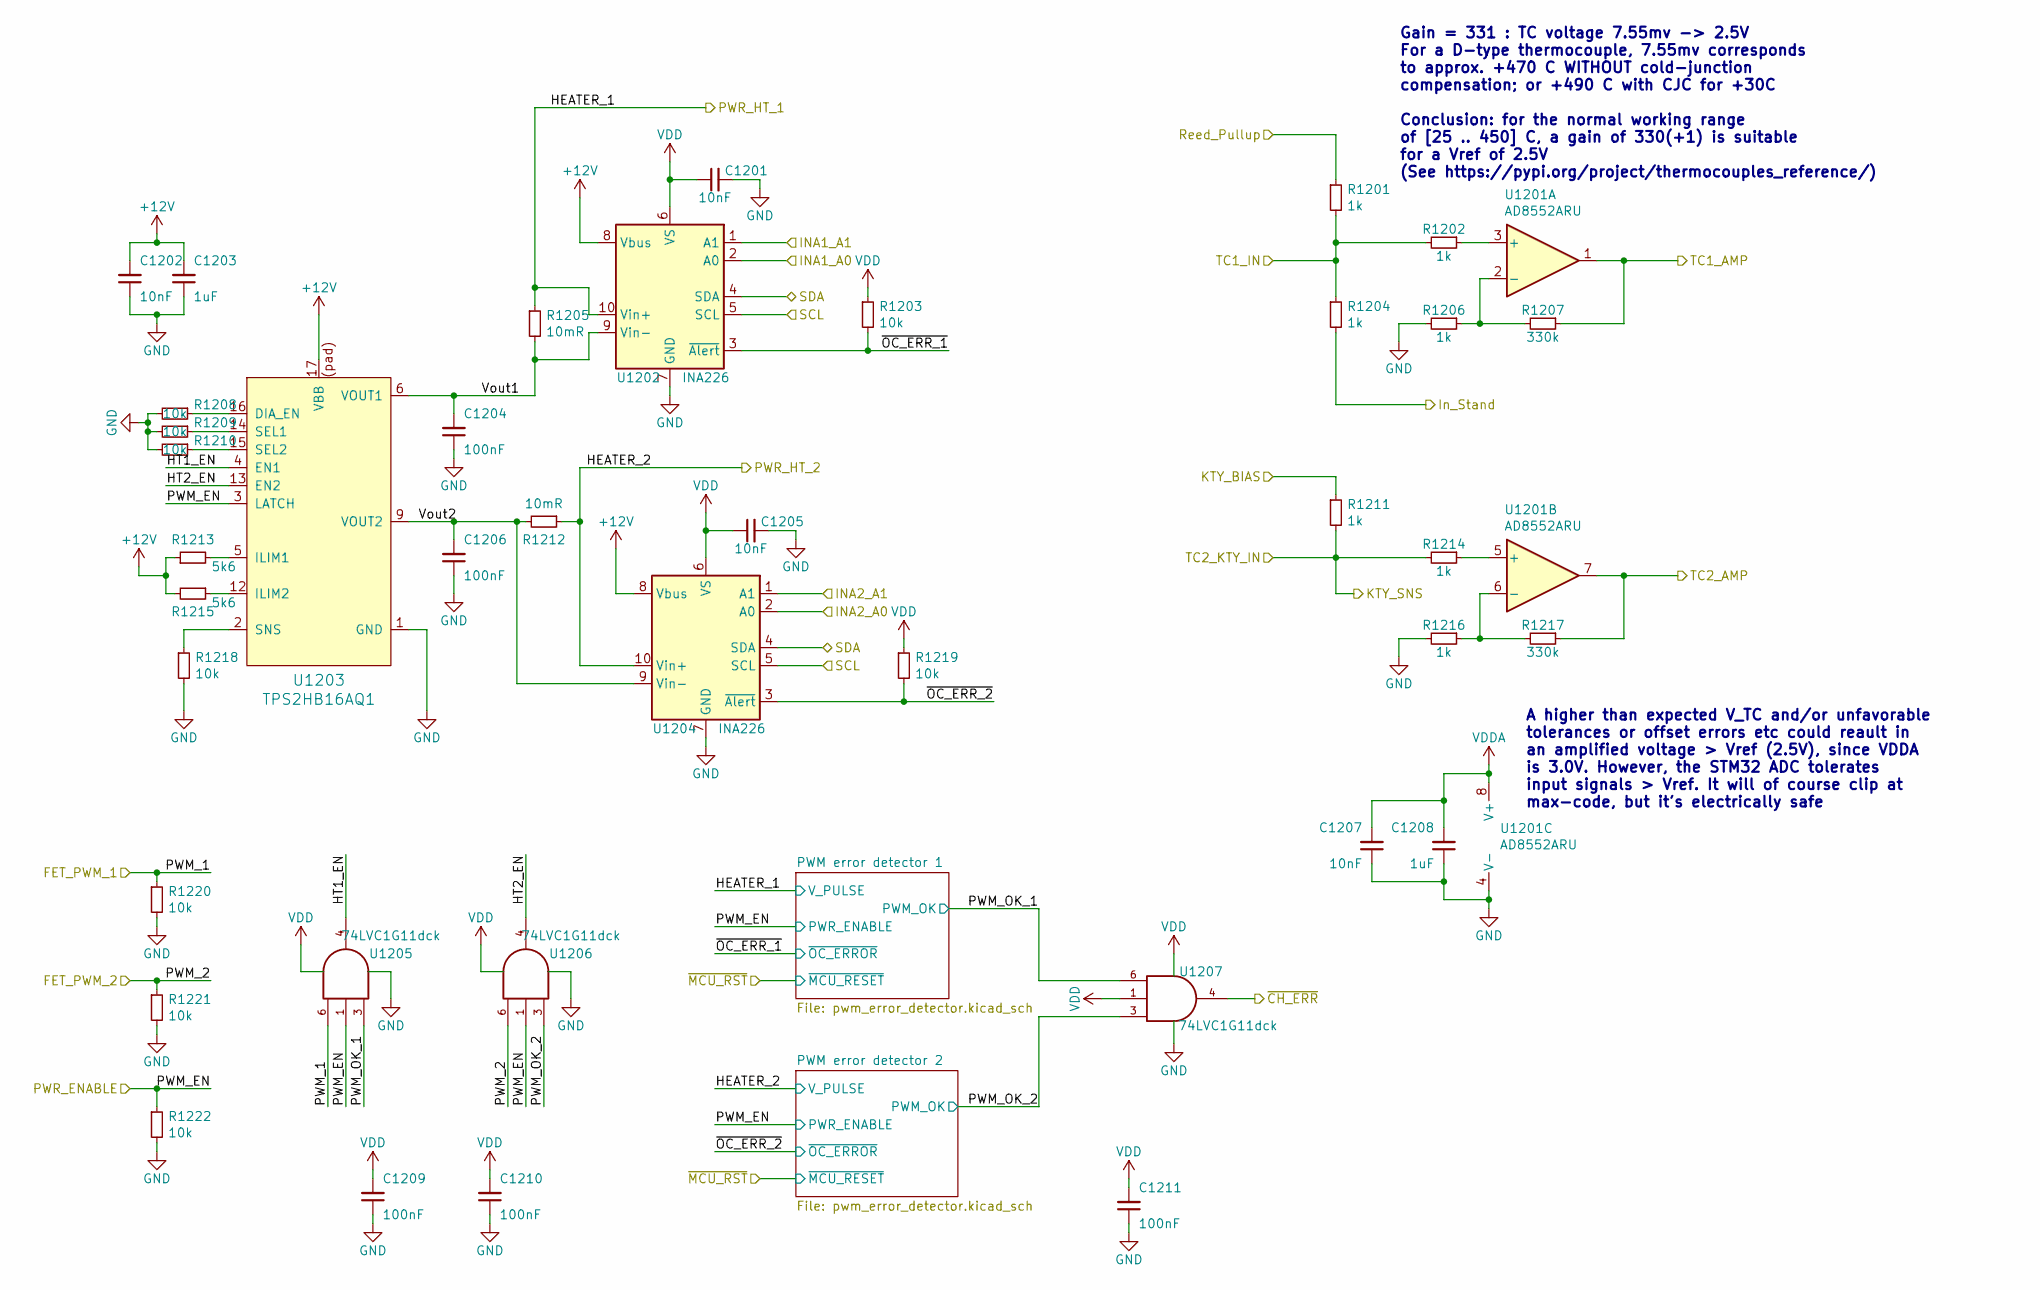
[picture p214: schematic Weller_channel.kicad_sch, Weller channel (2 elements) pwr-driver and TC/CJ sense amp]

Parts:
C1201, C1202, C1205, C1207: 10nF; C_0402_1005Metric; JLC_part Basic
C1203, C1208: 1uF; C_0402_1005Metric; JLC_part Basic
C1204, C1206, C1209, C1210, C1211: 100nF; C_0402_1005Metric; JLC_part Basic
R1201, R1202, R1204, R1206, R1211, R1214, R1216: 1k; R_0402_1005Metric; JLC_part Basic
R1203, R1208, R1209, R1210, R1218, R1219, R1220, R1221, R1222: 10k; R_0402_1005Metric; JLC_part Basic
R1205, R1212: 10mR; R_1206_3216Metric; JLC_part Extended
R1207, R1217: 330k; R_0402_1005Metric; JLC_part Basic
R1213, R1215: 5k6; R_0402_1005Metric; JLC_part Basic
U1201: AD8552ARU; TSSOP-8_4.4x3mm_P0.65mm; JLC_part Extended
U1202, U1204: INA226; VSSOP-10_3x3mm_P0.5mm; JLC_part Extended
U1203: TPS2HB16AQ1; HTSSOP-16-1EP_4.4x5mm_P0.65mm_EP3.4x5mm_Mask3x3mm_ThermalVi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
U1205, U1206, U1207: 74LVC1G11dck; SOT-363_SC-70-6_Handsoldering

Connections:
+12V: C1202.2, C1203.2, R1213.1, R1215.2, U1202.8 (Vbus), U1203.17 (VBB), U1204.8 (Vbus); also elsewhere on the board
/Rear panel connections/CH_A_TC1: R1201.2, R1202.2, R1204.1; also elsewhere on the board
/STM32F429 PWR/KTY_REED_BIAS_CH_A: R1201.1, R1211.1; also elsewhere on the board
/Weller contol/CH_A_KTY_SNS: R1211.2, R1214.2; also elsewhere on the board
/Weller contol/Channel A/HEATER_1: R1205.1, U1202.10 (Vin+); also elsewhere on the board
/Weller contol/Channel A/HEATER_2: R1212.1, U1204.10 (Vin+); also elsewhere on the board
/Weller contol/Channel A/HT1_EN: U1203.4 (EN1), U1205.4
/Weller contol/Channel A/HT2_EN: U1203.13 (EN2), U1206.4
/Weller contol/Channel A/PWM_OK_1: U1205.3, U1207.6; also elsewhere on the board
/Weller contol/Channel A/PWM_OK_2: U1206.3, U1207.3; also elsewhere on the board
/Weller contol/Channel A/Vout1: C1204.2, R1205.2, U1202.9 (Vin-), U1203.6 (VOUT1), U1203.7 (VOUT1), U1203.8 (VOUT1)
/Weller contol/Channel A/Vout2: C1206.2, R1212.2, U1203.9 (VOUT2), U1203.10 (VOUT2), U1203.11 (VOUT2), U1204.9 (Vin-)
/Weller contol/Channel A/~OC_ERR_1: R1203.2, U1202.3 (~Alert); also elsewhere on the board
/Weller contol/Channel A/~OC_ERR_2: R1219.2, U1204.3 (~Alert); also elsewhere on the board
AGND: C1201.2, C1202.1, C1203.1, C1204.1, C1205.2, C1206.1, C1207.1, C1208.1, C1209.1, C1210.1, C1211.1, R1206.2, R1208.2, R1209.2, R1210.2, R1216.2, R1218.2, R1220.2, R1221.2, R1222.2, U1201.4 (V-), U1202.7 (GND), U1203.1 (GND), U1204.7 (GND), U1205.2 (GND), U1206.2 (GND), U1207.2 (GND); also elsewhere on the board
AVDD: C1207.2, C1208.2, U1201.8 (V+); also elsewhere on the board
CH_A_DRV_OK: U1207.4; also elsewhere on the board
CH_A_FET1_PWM: R1220.1, U1205.6; also elsewhere on the board
CH_A_FET2_PWM: R1221.1, U1206.6; also elsewhere on the board
CH_A_IN_STAND_ADC1: R1204.2; also elsewhere on the board
CH_A_TC1_AMP_ADC1: R1207.1, U1201.1; also elsewhere on the board
CH_A_TC2_AMP_ADC2: R1217.1, U1201.7; also elsewhere on the board
GND: U1202.1 (A1), U1202.2 (A0), U1204.1 (A1); also elsewhere on the board
I2C1_SCL: U1202.5 (SCL), U1204.5 (SCL); also elsewhere on the board
I2C1_SDA: U1202.4 (SDA), U1204.4 (SDA); also elsewhere on the board
unnamed: R1202.1, U1201.3 (+)
unnamed: R1206.1, R1207.2, U1201.2 (-)
unnamed: R1208.1, U1203.16 (DIA_EN)
unnamed: R1209.1, U1203.14 (SEL1)
unnamed: R1210.1, U1203.15 (SEL2)
unnamed: R1213.2, U1203.5 (ILIM1)
unnamed: R1214.1, U1201.5 (+)
unnamed: R1215.1, U1203.12 (ILIM2)
unnamed: R1216.1, R1217.2, U1201.6 (-)
unnamed: R1218.1, U1203.2 (SNS)
PWRDRV_ENABLE: R1222.1, U1203.3 (LATCH), U1205.1, U1206.1; also elsewhere on the board
VCC: C1201.1, C1205.1, C1209.2, C1210.2, C1211.2, R1203.1, R1219.1, U1202.6 (VS), U1204.6 (VS), U1205.5 (VCC), U1206.5 (VCC), U1207.1, U1207.5 (VCC); also elsewhere on the board
VDD: U1204.2 (A0); also elsewhere on the board

Parts of its further copies:
C1501, C1502, C1505, C1507: 10nF; C_0402_1005Metric; JLC_part Basic
C1503, C1508: 1uF; C_0402_1005Metric; JLC_part Basic
C1504, C1506, C1509, C1510, C1511: 100nF; C_0402_1005Metric; JLC_part Basic
R1501, R1502, R1504, R1506, R1511, R1514, R1516: 1k; R_0402_1005Metric; JLC_part Basic
R1503, R1508, R1509, R1510, R1518, R1519, R1520, R1521, R1522: 10k; R_0402_1005Metric; JLC_part Basic
R1505, R1512: 10mR; R_1206_3216Metric; JLC_part Extended
R1507, R1517: 330k; R_0402_1005Metric; JLC_part Basic
R1513, R1515: 5k6; R_0402_1005Metric; JLC_part Basic
U1501: AD8552ARU; TSSOP-8_4.4x3mm_P0.65mm; JLC_part Extended
U1502, U1504: INA226; VSSOP-10_3x3mm_P0.5mm; JLC_part Extended
U1503: TPS2HB16AQ1; HTSSOP-16-1EP_4.4x5mm_P0.65mm_EP3.4x5mm_Mask3x3mm_ThermalVi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
U1505, U1506, U1507: 74LVC1G11dck; SOT-363_SC-70-6_Handsoldering

Connections of its further copies:
+12V: C1502.2, C1503.2, R1513.1, R1515.2, U1502.8 (Vbus), U1503.17 (VBB), U1504.8 (Vbus); also elsewhere on the board
/Rear panel connections/CH_B_TC1: R1501.2, R1502.2, R1504.1; also elsewhere on the board
/STM32F429 PWR/KTY_REED_BIAS_CH_B: R1501.1, R1511.1; also elsewhere on the board
/Weller contol/CH_B_KTY_SNS: R1511.2, R1514.2; also elsewhere on the board
/Weller contol/Channel B/HEATER_1: R1505.1, U1502.10 (Vin+); also elsewhere on the board
/Weller contol/Channel B/HEATER_2: R1512.1, U1504.10 (Vin+); also elsewhere on the board
/Weller contol/Channel B/HT1_EN: U1503.4 (EN1), U1505.4
/Weller contol/Channel B/HT2_EN: U1503.13 (EN2), U1506.4
/Weller contol/Channel B/PWM_OK_1: U1505.3, U1507.6; also elsewhere on the board
/Weller contol/Channel B/PWM_OK_2: U1506.3, U1507.3; also elsewhere on the board
/Weller contol/Channel B/Vout1: C1504.2, R1505.2, U1502.9 (Vin-), U1503.6 (VOUT1), U1503.7 (VOUT1), U1503.8 (VOUT1)
/Weller contol/Channel B/Vout2: C1506.2, R1512.2, U1503.9 (VOUT2), U1503.10 (VOUT2), U1503.11 (VOUT2), U1504.9 (Vin-)
/Weller contol/Channel B/~OC_ERR_1: R1503.2, U1502.3 (~Alert); also elsewhere on the board
/Weller contol/Channel B/~OC_ERR_2: R1519.2, U1504.3 (~Alert); also elsewhere on the board
AGND: C1501.2, C1502.1, C1503.1, C1504.1, C1505.2, C1506.1, C1507.1, C1508.1, C1509.1, C1510.1, C1511.1, R1506.2, R1508.2, R1509.2, R1510.2, R1516.2, R1518.2, R1520.2, R1521.2, R1522.2, U1501.4 (V-), U1502.7 (GND), U1503.1 (GND), U1504.7 (GND), U1505.2 (GND), U1506.2 (GND), U1507.2 (GND); also elsewhere on the board
AVDD: C1507.2, C1508.2, U1501.8 (V+); also elsewhere on the board
CH_B_DRV_OK: U1507.4; also elsewhere on the board
CH_B_FET1_PWM: R1520.1, U1505.6; also elsewhere on the board
CH_B_FET2_PWM: R1521.1, U1506.6; also elsewhere on the board
CH_B_IN_STAND_ADC1: R1504.2; also elsewhere on the board
CH_B_TC1_AMP_ADC1: R1507.1, U1501.1; also elsewhere on the board
CH_B_TC2_AMP_ADC2: R1517.1, U1501.7; also elsewhere on the board
GND: U1502.2 (A0); also elsewhere on the board
I2C1_SCL: U1502.5 (SCL), U1504.5 (SCL); also elsewhere on the board
I2C1_SDA: U1502.4 (SDA), U1504.4 (SDA); also elsewhere on the board
unnamed: R1502.1, U1501.3 (+)
unnamed: R1506.1, R1507.2, U1501.2 (-)
unnamed: R1508.1, U1503.16 (DIA_EN)
unnamed: R1509.1, U1503.14 (SEL1)
unnamed: R1510.1, U1503.15 (SEL2)
unnamed: R1513.2, U1503.5 (ILIM1)
unnamed: R1514.1, U1501.5 (+)
unnamed: R1515.1, U1503.12 (ILIM2)
unnamed: R1516.1, R1517.2, U1501.6 (-)
unnamed: R1518.1, U1503.2 (SNS)
PWRDRV_ENABLE: R1522.1, U1503.3 (LATCH), U1505.1, U1506.1; also elsewhere on the board
VCC: C1501.1, C1505.1, C1509.2, C1510.2, C1511.2, R1503.1, R1519.1, U1502.6 (VS), U1504.6 (VS), U1505.5 (VCC), U1506.5 (VCC), U1507.1, U1507.5 (VCC); also elsewhere on the board
VDD: U1502.1 (A1), U1504.1 (A1), U1504.2 (A0); also elsewhere on the board

Notes on the sheet:
Gain = 331 : TC voltage 7.55mv -> 2.5V For a D-type thermocouple, 7.55mv corresponds to approx. +470 C WITHOUT cold-junction compensation; or +490 C with CJC for +30C Conclusion: for the normal working range of [25 .. 450] C, a gain of 330(+1) is suitable for a Vref of 2.5V (See https://pypi.org/pr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
A higher than expected V_TC and/or unfavorable tolerances or offset errors etc could reault in an amplified voltage > Vref (2.5V), since VDDA is 3.0V. However, the STM32 ADC tolerates input signals > Vref. It will of course clip at max-code, but it's electrically safe
