mjohansson/SolderingStation/hw/solderstn_mb/solderstn_mb.kicad_pcb

## KiCad design hw/solderstn_mb/solderstn_mb.kicad_pcb (continued)

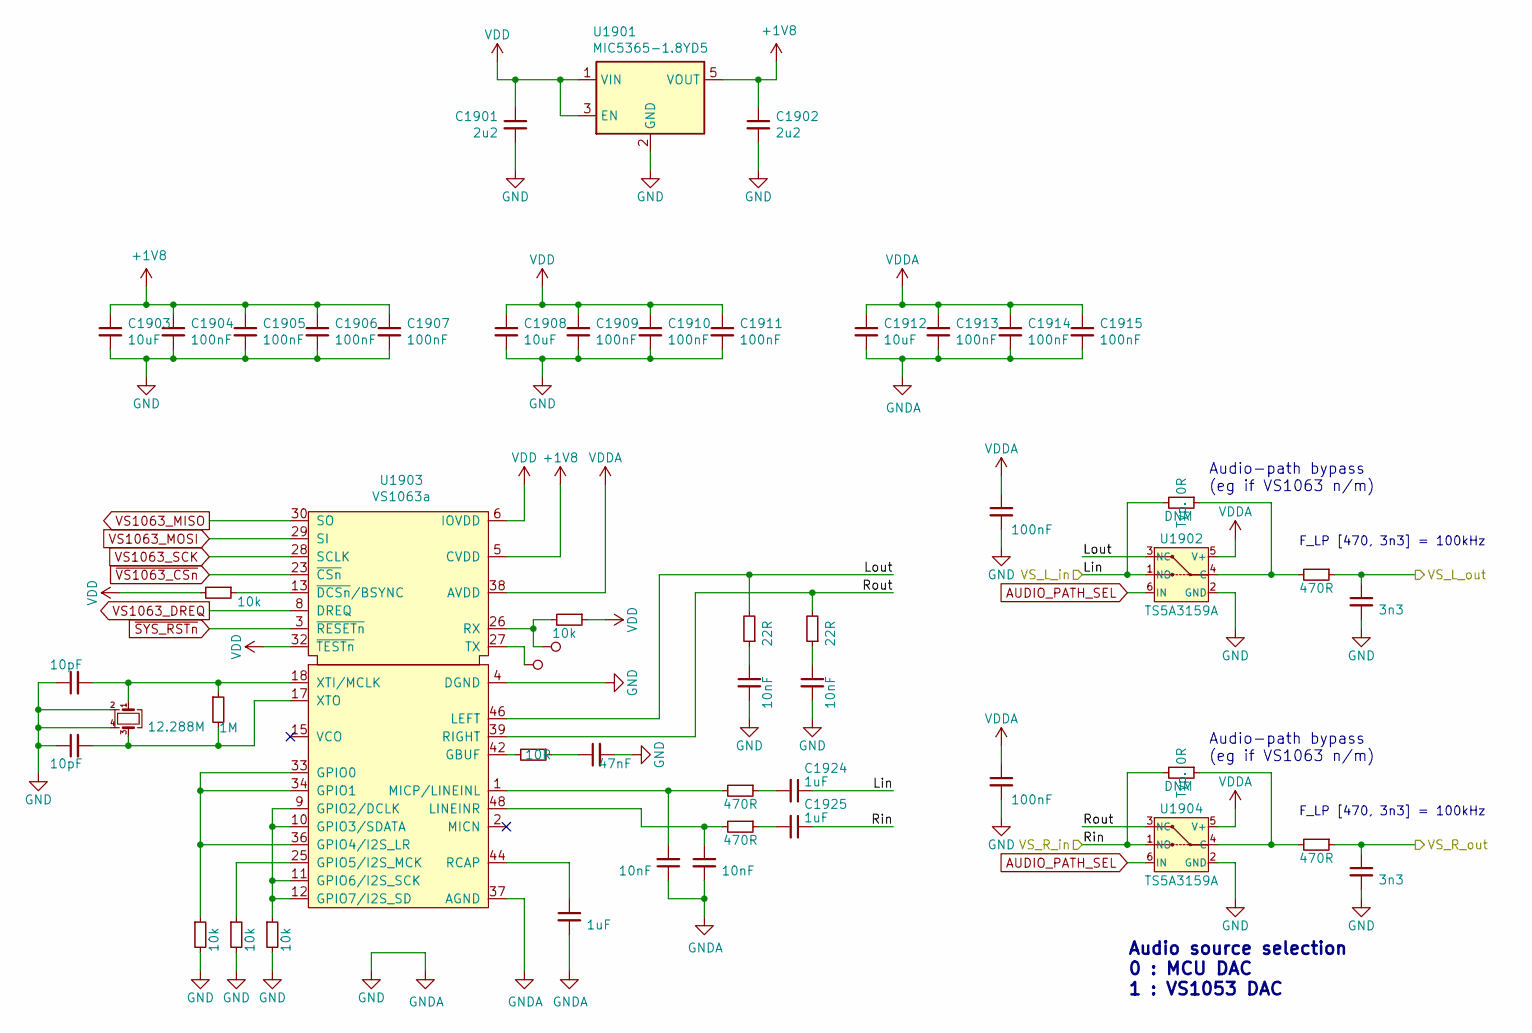
[picture p215: schematic vs1063.kicad_sch, VLSI VS1063 MP3/OGG/FLAC codec]

Parts:
C1901, C1902: 2u2; C_0603_1608Metric; JLC_part Basic
C1903, C1908, C1912: 10uF; C_0402_1005Metric; JLC_part Basic
C1904, C1905, C1906, C1907, C1909, C1910, C1911, C1913, C1914, C1915, C1916, C1923: 100nF; C_0402_1005Metric; JLC_part Basic
C1917, C1928: 3n3; C_0402_1005Metric; JLC_part Basic
C1918, C1921: 10pF; C_0402_1005Metric; JLC_part Basic
C1919, C1920, C1926, C1927: 10nF; C_0402_1005Metric; JLC_part Basic
C1922: 47nF; C_0603_1608Metric; JLC_part Basic
C1924, C1925: 1uF; C_1206_3216Metric; JLC_part Basic
C1929: 1uF; C_0402_1005Metric; JLC_part Basic
R1901, R1909: DNM; R_0402_1005Metric
R1902, R1910, R1911, R1912: 470R; R_0402_1005Metric; JLC_part Basic
R1903, R1904, R1913, R1914, R1915: 10k; R_0402_1005Metric; JLC_part Basic
R1905, R1906: 22R; R_0402_1005Metric; JLC_part Basic
R1907: 1M; R_0402_1005Metric; JLC_part Basic
R1908: 10R; R_0402_1005Metric; JLC_part Basic
TP1901, TP1902: TP; TP_SMD_1.2c
U1901: MIC5365-1.8YD5; SOT-23-5
U1902, U1904: TS5A3159A; SOT-23-6; JLC_part Extended
U1903: VS1063a; LQFP-48_7x7mm_P0.5mm
Y1901: 12.288M; Crystal_SMD_SeikoEpson_TSX3225-4Pin_3.2x2.5mm; JLC_part Extended

Connections:
+1V8: C1902.1, C1903.1, C1904.1, C1905.1, C1906.1, C1907.1, U1901.5 (VOUT), U1903.5 (CVDD), U1903.7 (CVDD), U1903.24 (CVDD), U1903.31 (CVDD)
/Audio & int. speakers/VLSI VS1063 DSP/codec/Lout: R1905.2, U1902.3 (NC), U1903.46 (LEFT)
/Audio & int. speakers/VLSI VS1063 DSP/codec/Rout: R1906.2, U1903.39 (RIGHT), U1904.3 (NC)
/Audio & int. speakers/VLSI VS1063 DSP/codec/VS_L_out: C1917.1, R1902.1; also elsewhere on the board
/Audio & int. speakers/VLSI VS1063 DSP/codec/VS_R_out: C1928.1, R1912.1; also elsewhere on the board
AGND: C1901.2, C1902.2, C1903.2, C1904.2, C1905.2, C1906.2, C1907.2, C1908.2, C1909.2, C1910.2, C1911.2, C1912.2, C1913.2, C1914.2, C1915.2, C1916.2, C1917.2, C1918.1, C1919.2, C1920.2, C1921.1, C1922.2, C1923.2, C1926.1, C1927.2, C1928.2, C1929.2, R1913.2, R1914.2, R1915.2, U1901.2 (GND), U1902.2 (GND), U1903.4 (DGND), U1903.16 (DGND), U1903.20 (DGND), U1903.21 (DGND), U1903.22 (DGND), U1903.35 (DGND), U1903.37 (AGND), U1903.40 (AGND), U1903.41 (AGND), U1903.47 (AGND), U1904.2 (GND), Y1901.2, Y1901.4; also elsewhere on the board
AUDIO_PATH_SEL: U1902.6 (IN), U1904.6 (IN); also elsewhere on the board
AVDD: C1912.1, C1913.1, C1914.1, C1915.1, C1916.1, C1923.1, U1902.5 (V+), U1903.38 (AVDD), U1903.43 (AVDD), U1903.45 (AVDD), U1904.5 (V+); also elsewhere on the board
DAC_OUT1: C1924.1, R1901.2, U1902.1 (NO); also elsewhere on the board
DAC_OUT2: C1925.1, R1909.2, U1904.1 (NO); also elsewhere on the board
IOVDD: C1901.1, C1908.1, C1909.1, C1910.1, C1911.1, R1903.2, R1904.1, U1901.1 (VIN), U1901.3 (EN), U1903.6 (IOVDD), U1903.14 (IOVDD), U1903.19 (IOVDD), U1903.32 (~TESTn)
unnamed: C1918.2, R1907.1, U1903.18 (XTI/MCLK), Y1901.1
unnamed: C1919.1, R1905.1
unnamed: C1920.1, R1906.1
unnamed: C1921.2, R1907.2, U1903.17 (XTO), Y1901.3
unnamed: C1922.1, R1908.1
unnamed: C1924.2, R1910.1
unnamed: C1925.2, R1911.1
unnamed: C1926.2, R1910.2, U1903.1 (MICP/LINEINL)
unnamed: C1927.1, R1911.2, U1903.48 (LINEINR)
unnamed: C1929.1, U1903.44 (RCAP)
unnamed: R1901.1, R1902.2, U1902.4 (C)
unnamed: R1903.1, U1903.13 (~DCSn/BSYNC)
unnamed: R1904.2, TP1901.1, U1903.26 (RX)
unnamed: R1908.2, U1903.42 (GBUF)
unnamed: R1909.1, R1912.2, U1904.4 (C)
unnamed: R1913.1, U1903.9 (GPIO2/DCLK), U1903.10 (GPIO3/SDATA), U1903.11 (GPIO6/I2S_SCK), U1903.12 (GPIO7/I2S_SD)
unnamed: R1914.1, U1903.33 (GPIO0), U1903.34 (GPIO1), U1903.36 (GPIO4/I2S_LR)
unnamed: R1915.1, U1903.25 (GPIO5/I2S_MCK)
unnamed: TP1902.1, U1903.27 (TX)
VS1063_DREQ: U1903.8 (DREQ); also elsewhere on the board
VS1063_MISO: U1903.30 (SO); also elsewhere on the board
VS1063_MOSI: U1903.29 (SI); also elsewhere on the board
VS1063_SCK: U1903.28 (SCLK); also elsewhere on the board
~SYS_RSTn: U1903.3 (~RESETn); also elsewhere on the board
~VS1063_CSn: U1903.23 (~CSn); also elsewhere on the board

Notes on the sheet:
F_LP [470, 3n3] = 100kHz
Audio-path bypass (eg if VS1063 n/m)
Audio source selection 0 : MCU DAC 1 : VS1053 DAC

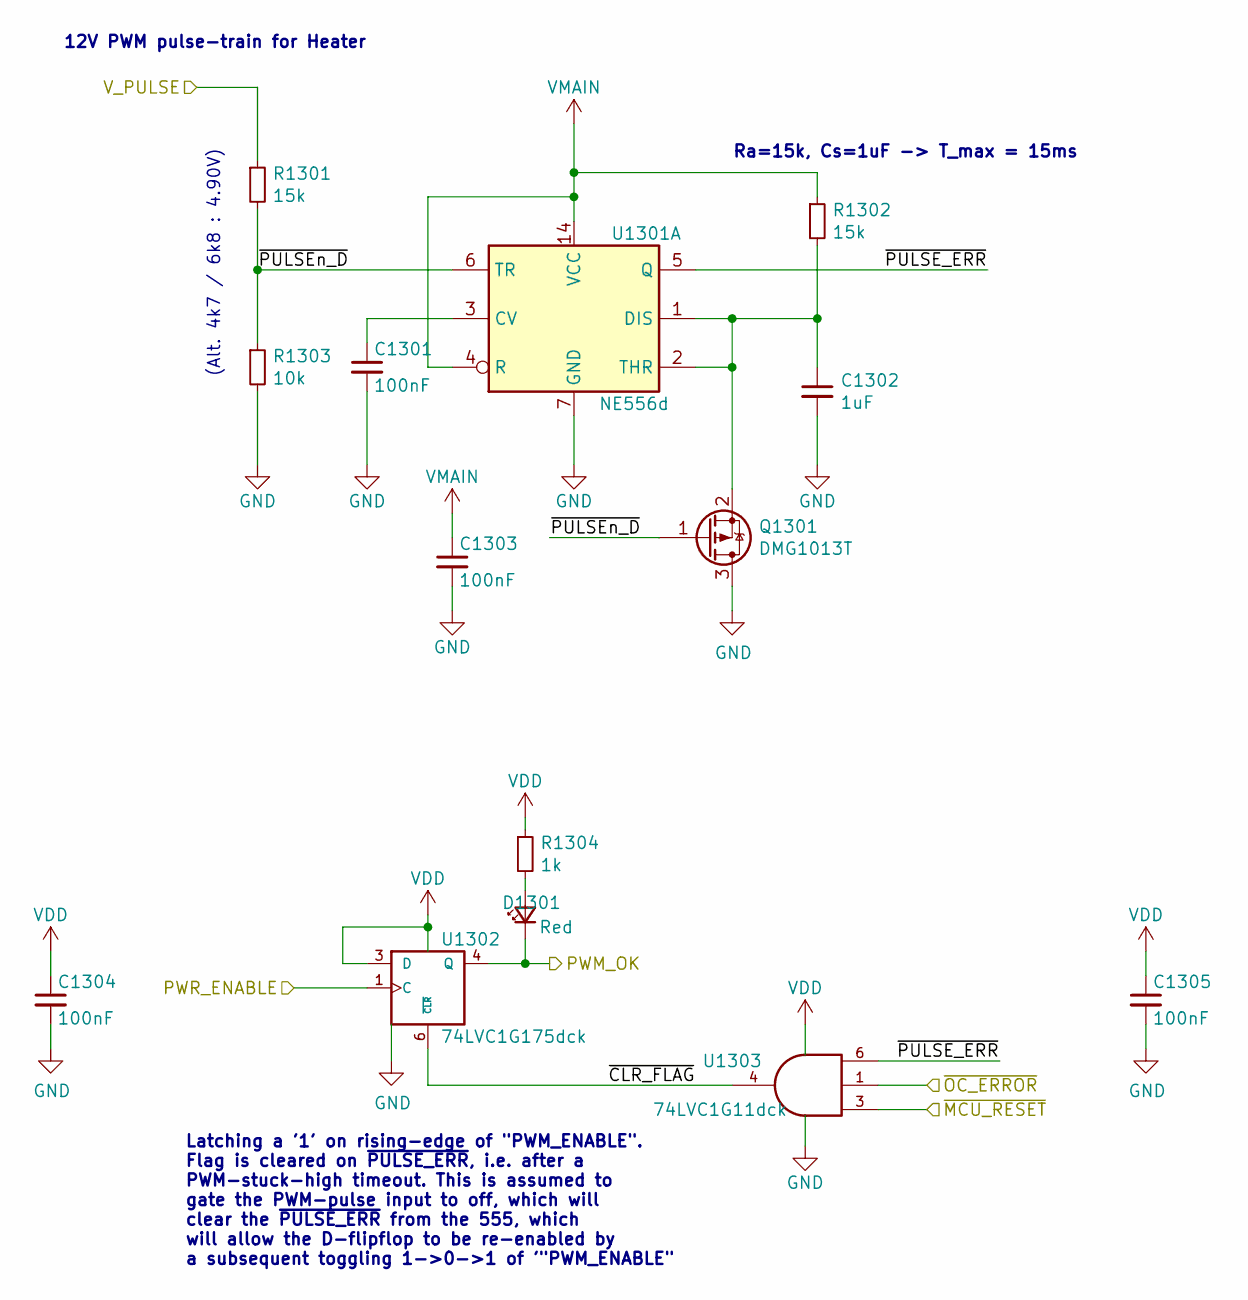
[picture p216: schematic pwm_error_detector.kicad_sch, HW PWM stuck-high detection with latched flag]

Parts:
C1301, C1303, C1304, C1305: 100nF; C_0402_1005Metric; JLC_part Basic
C1302: 1uF; C_0402_1005Metric; JLC_part Basic
D1301: Red; LED_0603_1608Metric; JLC_part Basic
Q1301: DMG1013T; SOT-523_handsoldering; JLC_part Extended
R1301, R1302: 15k; R_0402_1005Metric; JLC_part Basic
R1303: 10k; R_0402_1005Metric; JLC_part Basic
R1304: 1k; R_0402_1005Metric; JLC_part Basic
U1301: NE556d; SOIC-14_3.9x8.7mm_P1.27mm; JLC_part Extended
U1302: 74LVC1G175dck; SOT-363_SC-70-6_Handsoldering; JLC_part Extended
U1303: 74LVC1G11dck; SOT-363_SC-70-6_Handsoldering

Connections:
/Weller contol/Channel A/HEATER_1: R1301.1; also elsewhere on the board
/Weller contol/Channel A/PWM error detector 1/~CLR_FLAG: U1302.6 (~CLR), U1303.4
/Weller contol/Channel A/PWM error detector 1/~PULSE_ERR: U1301.5 (Q), U1303.6
/Weller contol/Channel A/PWM error detector 1/~PULSEn_D: Q1301.1 (G), R1301.2, R1303.1, U1301.6 (TR)
/Weller contol/Channel A/PWM error detector 2/~PULSE_ERR: U1301.9 (Q); also elsewhere on the board
/Weller contol/Channel A/PWM error detector 2/~PULSEn_D: U1301.8 (TR); also elsewhere on the board
/Weller contol/Channel A/PWM_OK_1: D1301.1 (K), U1302.4 (Q); also elsewhere on the board
/Weller contol/Channel A/~OC_ERR_1: U1303.1; also elsewhere on the board
AGND: C1301.2, C1302.2, C1303.2, C1304.2, C1305.2, Q1301.3 (D), R1303.2, U1301.7 (GND), U1302.2 (GND), U1303.2 (GND); also elsewhere on the board
unnamed: C1301.1, U1301.3 (CV)
unnamed: C1302.1, Q1301.2 (S), R1302.2, U1301.1 (DIS), U1301.2 (THR)
unnamed 144: U1301.11 (CV); also elsewhere on the board
unnamed 145: U1301.12 (THR), U1301.13 (DIS); also elsewhere on the board
unnamed: D1301.2 (A), R1304.2
PWRDRV_ENABLE: U1302.1 (C); also elsewhere on the board
VCC: C1304.1, C1305.1, R1304.1, U1302.3 (D), U1302.5 (VCC), U1303.5 (VCC); also elsewhere on the board
VMAIN: C1303.1, R1302.1, U1301.4 (R), U1301.10 (R), U1301.14 (VCC); also elsewhere on the board
~MCU_RSTn: U1303.3; also elsewhere on the board

Parts of its further copies:
C1401, C1403, C1404, C1405, C1601, C1603, C1604, C1605, C1701, C1703, C1704, C1705: 100nF; C_0402_1005Metric; JLC_part Basic
C1402, C1602, C1702: 1uF; C_0402_1005Metric; JLC_part Basic
D1401, D1601, D1701: Red; LED_0603_1608Metric; JLC_part Basic
Q1401, Q1601, Q1701: DMG1013T; SOT-523_handsoldering; JLC_part Extended
R1401, R1402, R1601, R1602, R1701, R1702: 15k; R_0402_1005Metric; JLC_part Basic
R1403, R1603, R1703: 10k; R_0402_1005Metric; JLC_part Basic
R1404, R1604, R1704: 1k; R_0402_1005Metric; JLC_part Basic
U1401, U1602, U1701: 74LVC1G175dck; SOT-363_SC-70-6_Handsoldering; JLC_part Extended
U1402, U1603, U1702: 74LVC1G11dck; SOT-363_SC-70-6_Handsoldering
U1601: NE556d; SOIC-14_3.9x8.7mm_P1.27mm; JLC_part Extended

Connections of its further copies:
/Weller contol/Channel A/HEATER_2: R1401.1; also elsewhere on the board
/Weller contol/Channel A/PWM error detector 2/~CLR_FLAG: U1401.6 (~CLR), U1402.4
/Weller contol/Channel A/PWM error detector 2/~PULSE_ERR: U1402.6; also elsewhere on the board
/Weller contol/Channel A/PWM error detector 2/~PULSEn_D: Q1401.1 (G), R1401.2, R1403.1; also elsewhere on the board
/Weller contol/Channel A/PWM_OK_2: D1401.1 (K), U1401.4 (Q); also elsewhere on the board
/Weller contol/Channel A/~OC_ERR_2: U1402.1; also elsewhere on the board
/Weller contol/Channel B/HEATER_1: R1601.1; also elsewhere on the board
/Weller contol/Channel B/HEATER_2: R1701.1; also elsewhere on the board
/Weller contol/Channel B/PWM error detector 1/~CLR_FLAG: U1602.6 (~CLR), U1603.4
/Weller contol/Channel B/PWM error detector 1/~PULSE_ERR: U1601.5 (Q), U1603.6
/Weller contol/Channel B/PWM error detector 1/~PULSEn_D: Q1601.1 (G), R1601.2, R1603.1, U1601.6 (TR)
/Weller contol/Channel B/PWM error detector 2/~CLR_FLAG: U1701.6 (~CLR), U1702.4
/Weller contol/Channel B/PWM error detector 2/~PULSE_ERR: U1601.9 (Q), U1702.6
/Weller contol/Channel B/PWM error detector 2/~PULSEn_D: Q1701.1 (G), R1701.2, R1703.1, U1601.8 (TR)
/Weller contol/Channel B/PWM_OK_1: D1601.1 (K), U1602.4 (Q); also elsewhere on the board
/Weller contol/Channel B/PWM_OK_2: D1701.1 (K), U1701.4 (Q); also elsewhere on the board
/Weller contol/Channel B/~OC_ERR_1: U1603.1; also elsewhere on the board
/Weller contol/Channel B/~OC_ERR_2: U1702.1; also elsewhere on the board
AGND: C1401.2, C1402.2, C1403.2, C1404.2, C1405.2, C1601.2, C1602.2, C1603.2, C1604.2, C1605.2, C1701.2, C1702.2, C1703.2, C1704.2, C1705.2, Q1401.3 (D), Q1601.3 (D), Q1701.3 (D), R1403.2, R1603.2, R1703.2, U1401.2 (GND), U1402.2 (GND), U1601.7 (GND), U1602.2 (GND), U1603.2 (GND), U1701.2 (GND), U1702.2 (GND); also elsewhere on the board
unnamed 144: C1401.1; also elsewhere on the board
unnamed 145: C1402.1, Q1401.2 (S), R1402.2; also elsewhere on the board
unnamed: C1601.1, U1601.3 (CV)
unnamed: C1602.1, Q1601.2 (S), R1602.2, U1601.1 (DIS), U1601.2 (THR)
unnamed: C1701.1, U1601.11 (CV)
unnamed: C1702.1, Q1701.2 (S), R1702.2, U1601.12 (THR), U1601.13 (DIS)
unnamed: D1401.2 (A), R1404.2
unnamed: D1601.2 (A), R1604.2
unnamed: D1701.2 (A), R1704.2
PWRDRV_ENABLE: U1401.1 (C), U1602.1 (C), U1701.1 (C); also elsewhere on the board
VCC: C1404.1, C1405.1, C1604.1, C1605.1, C1704.1, C1705.1, R1404.1, R1604.1, R1704.1, U1401.3 (D), U1401.5 (VCC), U1402.5 (VCC), U1602.3 (D), U1602.5 (VCC), U1603.5 (VCC), U1701.3 (D), U1701.5 (VCC), U1702.5 (VCC); also elsewhere on the board
VMAIN: C1403.1, C1603.1, C1703.1, R1402.1, R1602.1, R1702.1, U1601.4 (R), U1601.10 (R), U1601.14 (VCC); also elsewhere on the board
~MCU_RSTn: U1402.3, U1603.3, U1702.3; also elsewhere on the board

Notes on the sheet:
Ra=15k, Cs=1uF -> T_max = 15ms
(Alt. 4k7 / 6k8 : 4.90V)
Latching a '1' on rising-edge of "PWM_ENABLE". Flag is cleared on ~{PULSE_ERR}, i.e. after a PWM-stuck-high timeout. This is assumed to gate the PWM-pulse input to off, which will clear the ~{PULSE_ERR} from the 555, which will allow the D-flipflop to be re-enabled by a subsequent toggling 1->0->1 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
12V PWM pulse-train for Heater

Board: 4 copper layers, 487 parts (133 on the bottom side), 299 nets, no tracks yet.
