mjohansson/SolderingStation/hw/ss_frontpanel_inner_plate/ss_frontpanel_inner_plate.kicad_pcb

## KiCad design hw/ss_frontpanel_inner_plate/ss_frontpanel_inner_plate.kicad_pcb (2024-02-26)

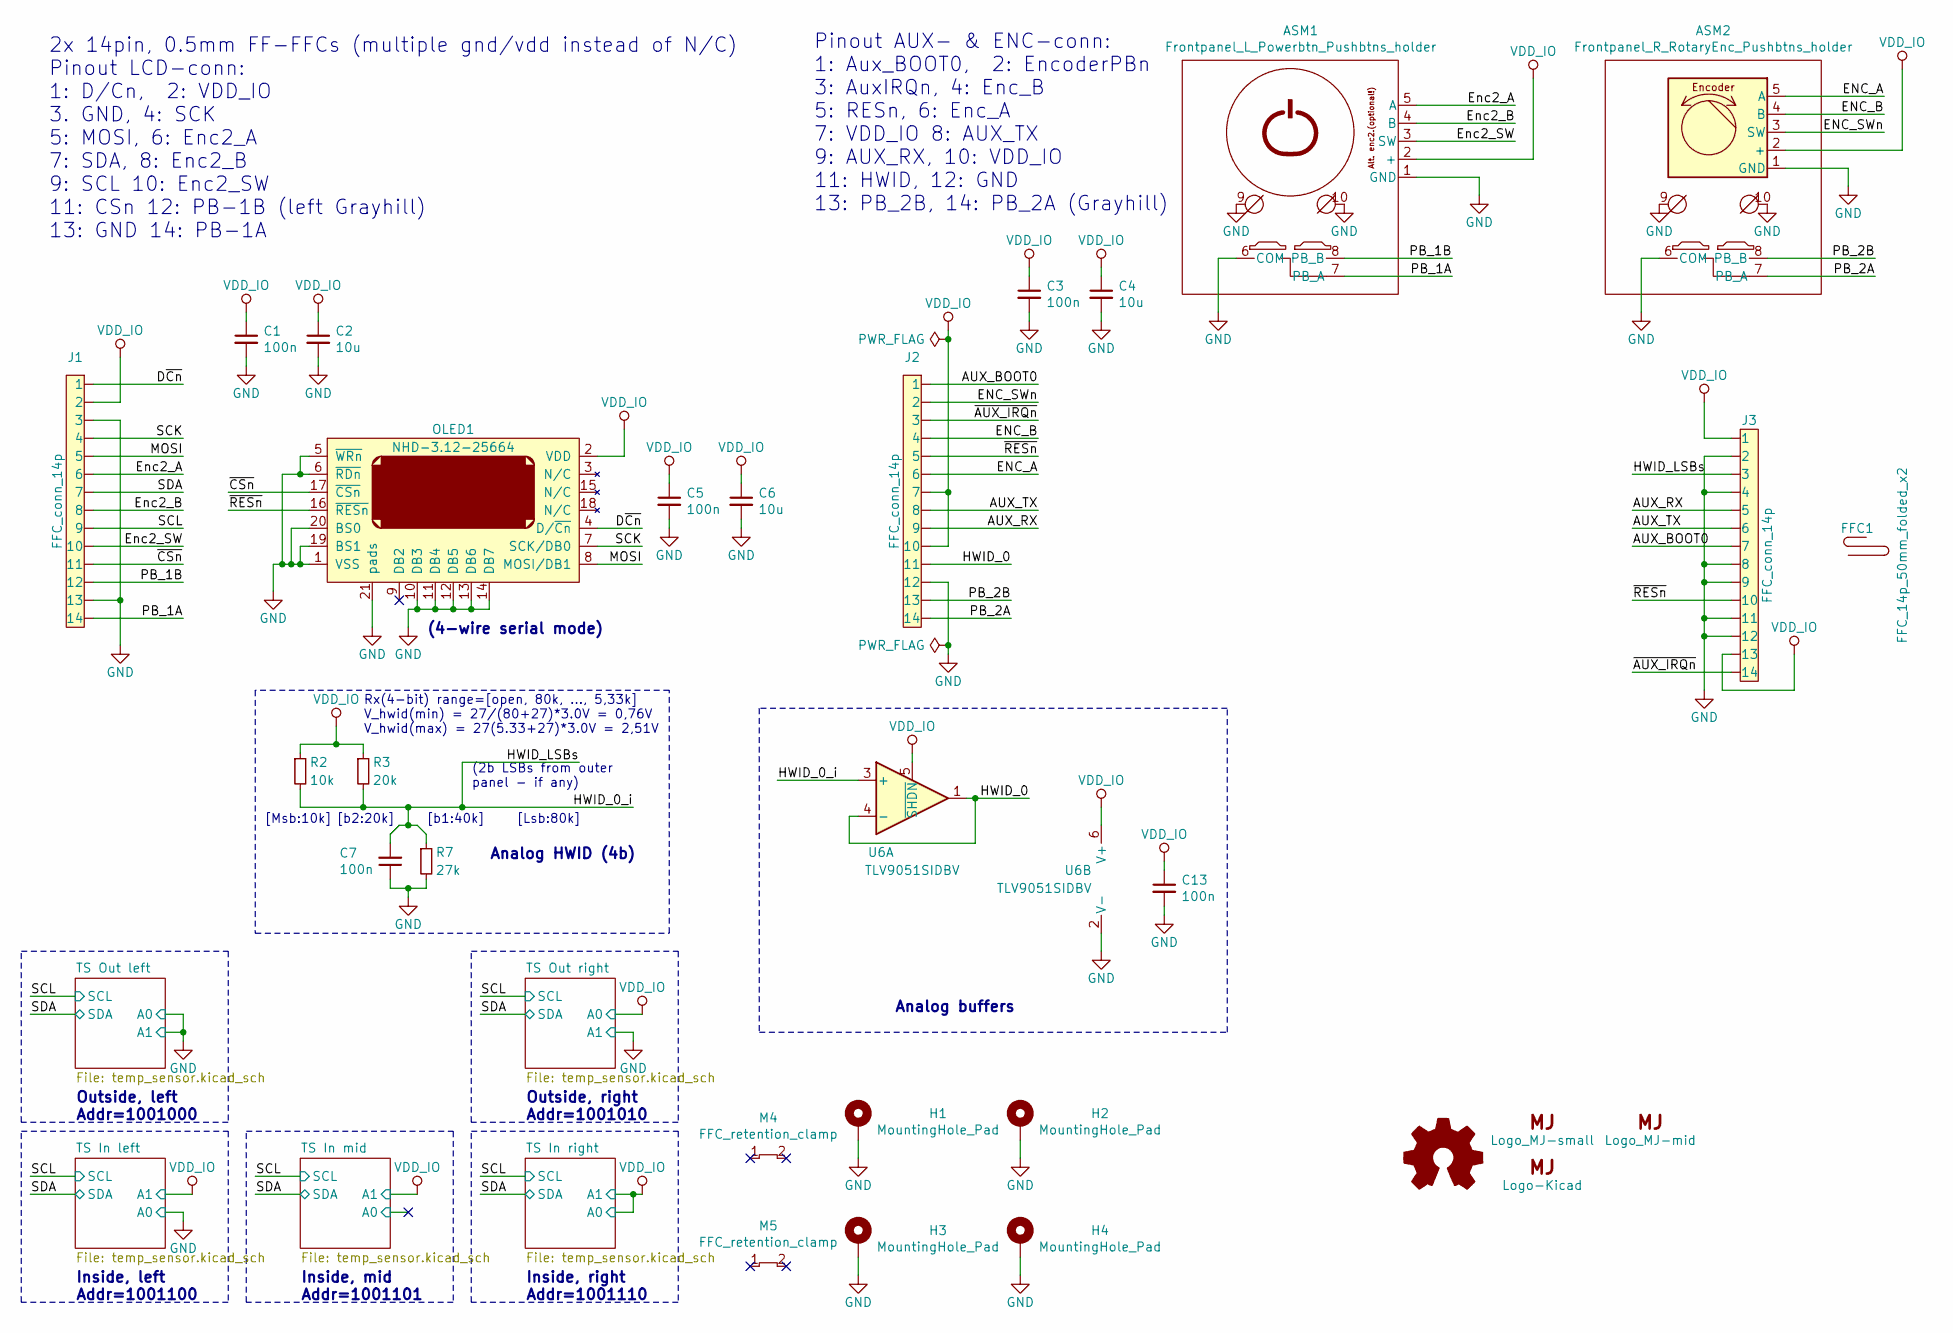
[picture p217: schematic ss_frontpanel_inner_plate.kicad_sch, Inner front-panel carrier board]

Parts:
ASM1: Frontpanel_L_Powerbtn_Pushbtns_holder
ASM2: Frontpanel_R_RotaryEnc_Pushbtns_holder; Frontpanel_R_RotaryEnc_Pushbtns_holder-one_M3_removed
C1, C3, C5, C7, C13: 100n; C_0603_1608Metric
C2, C4, C6: 10u; C_0603_1608Metric
FFC1: FFC_14p_50mm_folded_x2; FFC_mech_14p_50mm_folded_x2
H1, H2, H3, H4: MountingHole_Pad; MountingHole_3-6mm_pth
J1, J2: FFC_conn_14p; FPC_14p_05mm-Universal
J3: FFC_conn_14p; FPC_14p_05mm-WE_687114182122
Logo3: Logo_MJ-small; MJ_Mini
Logo4: Logo_MJ-mid; MJ_10.3x12.7
Logo5: Logo-Kicad; KiCad-Logo2_5mm_SilkScreen
Logo_OSHW1: Logo_Open_Hardware_Small; OSHW-Logo_5.7x6mm_SilkScreen
M4, M5: FFC_retention_clamp; FFC_retention_clamp_14pin_7_5mm
OLED1: NHD-3.12-25664; NHD3_12-Flush_without_bridge_cutouts
R2: 10k; R_0603_1608Metric
R3: 20k; R_0603_1608Metric
R7: 27k; R_0603_1608Metric
U6: TLV9051SIDBV; SOT-23-6_Handsoldering

Connections:
/AUX_BOOT0: J2.1, J3.7
/AUX_RX: J2.9, J3.5
/AUX_TX: J2.8, J3.6
/D~Cn: J1.1, OLED1.4 (D/~Cn)
/ENC_A: ASM2.5 (A), J2.6
/ENC_B: ASM2.4 (B), J2.4
/ENC_SWn: ASM2.3 (SW), J2.2
/Enc2_A: ASM1.5 (A), J1.6
/Enc2_B: ASM1.4 (B), J1.8
/Enc2_SW: ASM1.3 (SW), J1.10
/HWID_0: J2.11, U6.1, U6.4 (-)
/HWID_0_i: C7.2, J3.3, R2.2, R3.2, R7.1, U6.3 (+)
/MOSI: J1.5, OLED1.8 (MOSI/DB1)
/PB_1A: ASM1.7 (PB_A), J1.14
/PB_1B: ASM1.8 (PB_B), J1.12
/PB_2A: ASM2.7 (PB_A), J2.14
/PB_2B: ASM2.8 (PB_B), J2.13
/SCK: J1.4, OLED1.7 (SCK/DB0)
/SCL: J1.9; also elsewhere on the board
/SDA: J1.7; also elsewhere on the board
/~AUX_IRQn: J2.3, J3.14
/~CSn: J1.11, OLED1.17 (~CSn)
/~RESn: J2.5, J3.10, OLED1.16 (~RESn)
GND: ASM1.1 (GND), ASM1.6 (COM), ASM1.9, ASM1.10, ASM2.1 (GND), ASM2.6 (COM), ASM2.9, ASM2.10, C1.2, C2.2, C3.2, C4.2, C5.2, C6.2, C7.1, C13.2, H1.1, H2.1, H3.1, H4.1, J1.3, J1.13, J2.12, J3.2, J3.4, J3.8, J3.9, J3.11, J3.12, OLED1.1 (VSS), OLED1.5 (~WRn), OLED1.6 (~RDn), OLED1.10 (DB3), OLED1.11 (DB4), OLED1.12 (DB5), OLED1.13 (DB6), OLED1.14 (DB7), OLED1.19 (BS1), OLED1.20 (BS0), OLED1.21 (pads), R7.2, U6.2 (V-); also elsewhere on the board
VDD_IO: ASM1.2 (+), ASM2.2 (+), C1.1, C2.1, C3.1, C4.1, C5.1, C6.1, C13.1, J1.2, J2.7, J2.10, J3.1, J3.13, OLED1.2 (VDD), R2.1, R3.1, U6.5 (~SHDN), U6.6 (V+); also elsewhere on the board

Notes on the sheet:
2x 14pin, 0.5mm FF-FFCs (multiple gnd/vdd instead of N/C) Pinout LCD-conn: 1: D/Cn, 2: VDD_IO 3. GND, 4: SCK 5: MOSI, 6: Enc2_A 7: SDA, 8: Enc2_B 9: SCL 10: Enc2_SW 11: CSn 12: PB-1B (left Grayhill) 13: GND 14: PB-1A
Rx(4-bit) range=[open, 80k, ..., 5,33k] V_hwid(min) = 27/(80+27)*3.0V = 0,76V V_hwid(max) = 27(5.33+27)*3.0V = 2,51V
Inside, right Addr=1001110
Outside, left Addr=1001000
[b1:40k]
[Msb:10k]
Inside, left Addr=1001100
Analog buffers
Inside, mid Addr=1001101
Pinout AUX- & ENC-conn: 1: Aux_BOOT0, 2: EncoderPBn 3: AuxIRQn, 4: Enc_B 5: RESn, 6: Enc_A 7: VDD_IO 8: AUX_TX 9: AUX_RX, 10: VDD_IO 11: HWID, 12: GND 13: PB_2B, 14: PB_2A (Grayhill)
[Lsb:80k]
(2b LSBs from outer panel - if any)
Outside, right Addr=1001010
[b2:20k]
Analog HWID (4b)
(4-wire serial mode)

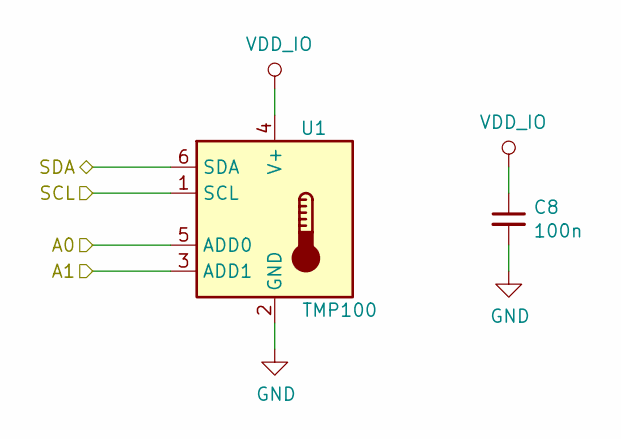
[picture p218: schematic temp_sensor.kicad_sch, Inner front-panel carrier board]

Parts:
C8: 100n; C_0603_1608Metric
U1: TMP100; SOT-23-6

Connections:
/SCL: U1.1 (SCL); also elsewhere on the board
/SDA: U1.6 (SDA); also elsewhere on the board
GND: C8.2, U1.2 (GND), U1.3 (ADD1), U1.5 (ADD0); also elsewhere on the board
VDD_IO: C8.1, U1.4 (V+); also elsewhere on the board

Parts of its further copies:
C9, C10, C11, C12: 100n; C_0603_1608Metric
U2, U3, U4, U5: TMP100; SOT-23-6

Connections of its further copies:
/SCL: U2.1 (SCL), U3.1 (SCL), U4.1 (SCL), U5.1 (SCL); also elsewhere on the board
/SDA: U2.6 (SDA), U3.6 (SDA), U4.6 (SDA), U5.6 (SDA); also elsewhere on the board
/TS In mid/A0: U4.5 (ADD0)
GND: C9.2, C10.2, C11.2, C12.2, U2.2 (GND), U2.3 (ADD1), U3.2 (GND), U4.2 (GND), U5.2 (GND), U5.5 (ADD0); also elsewhere on the board
VDD_IO: C9.1, C10.1, C11.1, C12.1, U2.4 (V+), U2.5 (ADD0), U3.3 (ADD1), U3.4 (V+), U3.5 (ADD0), U4.3 (ADD1), U4.4 (V+), U5.3 (ADD1), U5.4 (V+); also elsewhere on the board

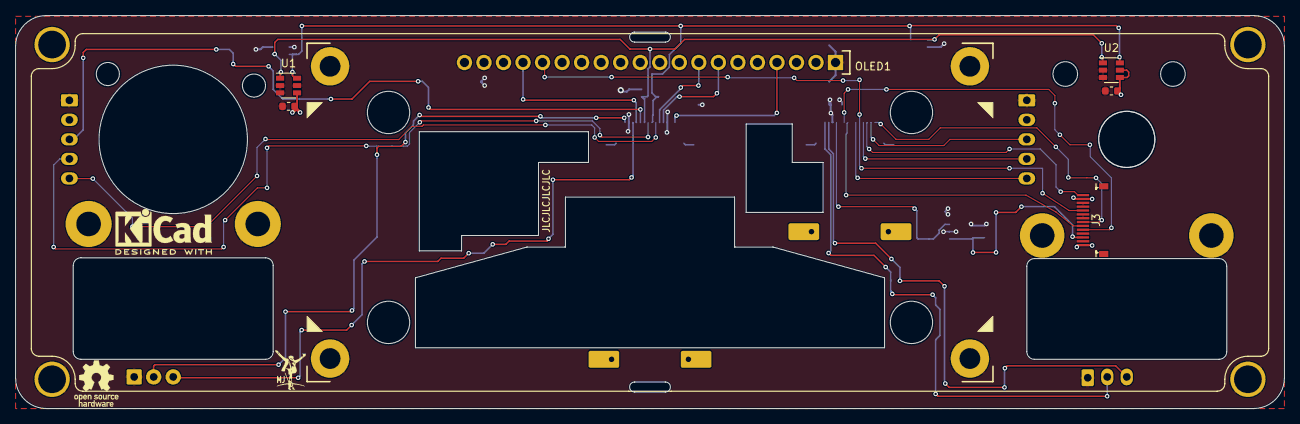
[picture p219: board ss_frontpanel_inner_plate.kicad_pcb from above]

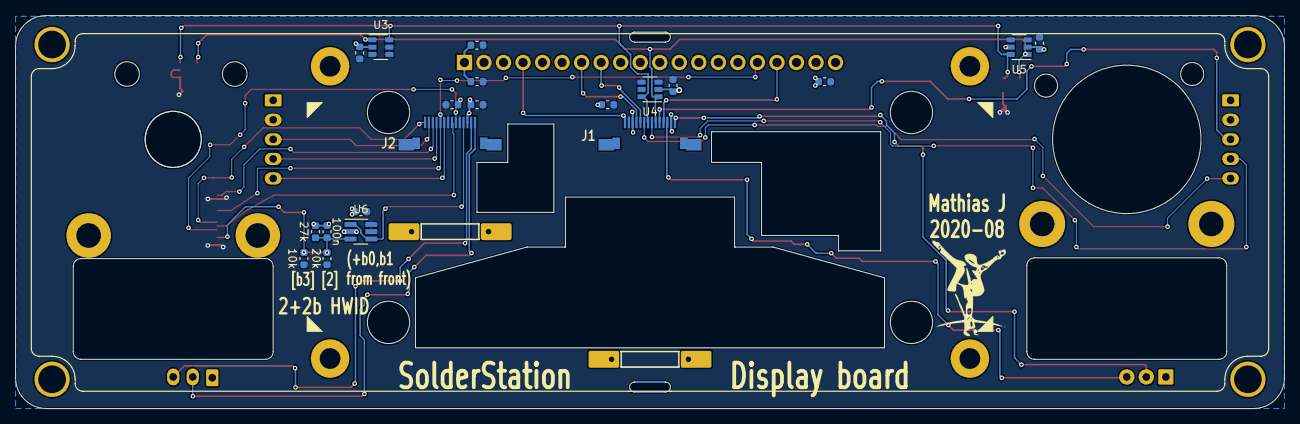
[picture p220: board ss_frontpanel_inner_plate.kicad_pcb from below]

Board: 2 copper layers, 165.0 x 51.1 mm, 39 parts (25 on the bottom side), 25 nets.
