mjohansson/SolderingStation/hw/ss_debug_adapter/ss_debug_adapter.kicad_pcb

## KiCad design hw/ss_debug_adapter/ss_debug_adapter.kicad_pcb (2022-01-15)

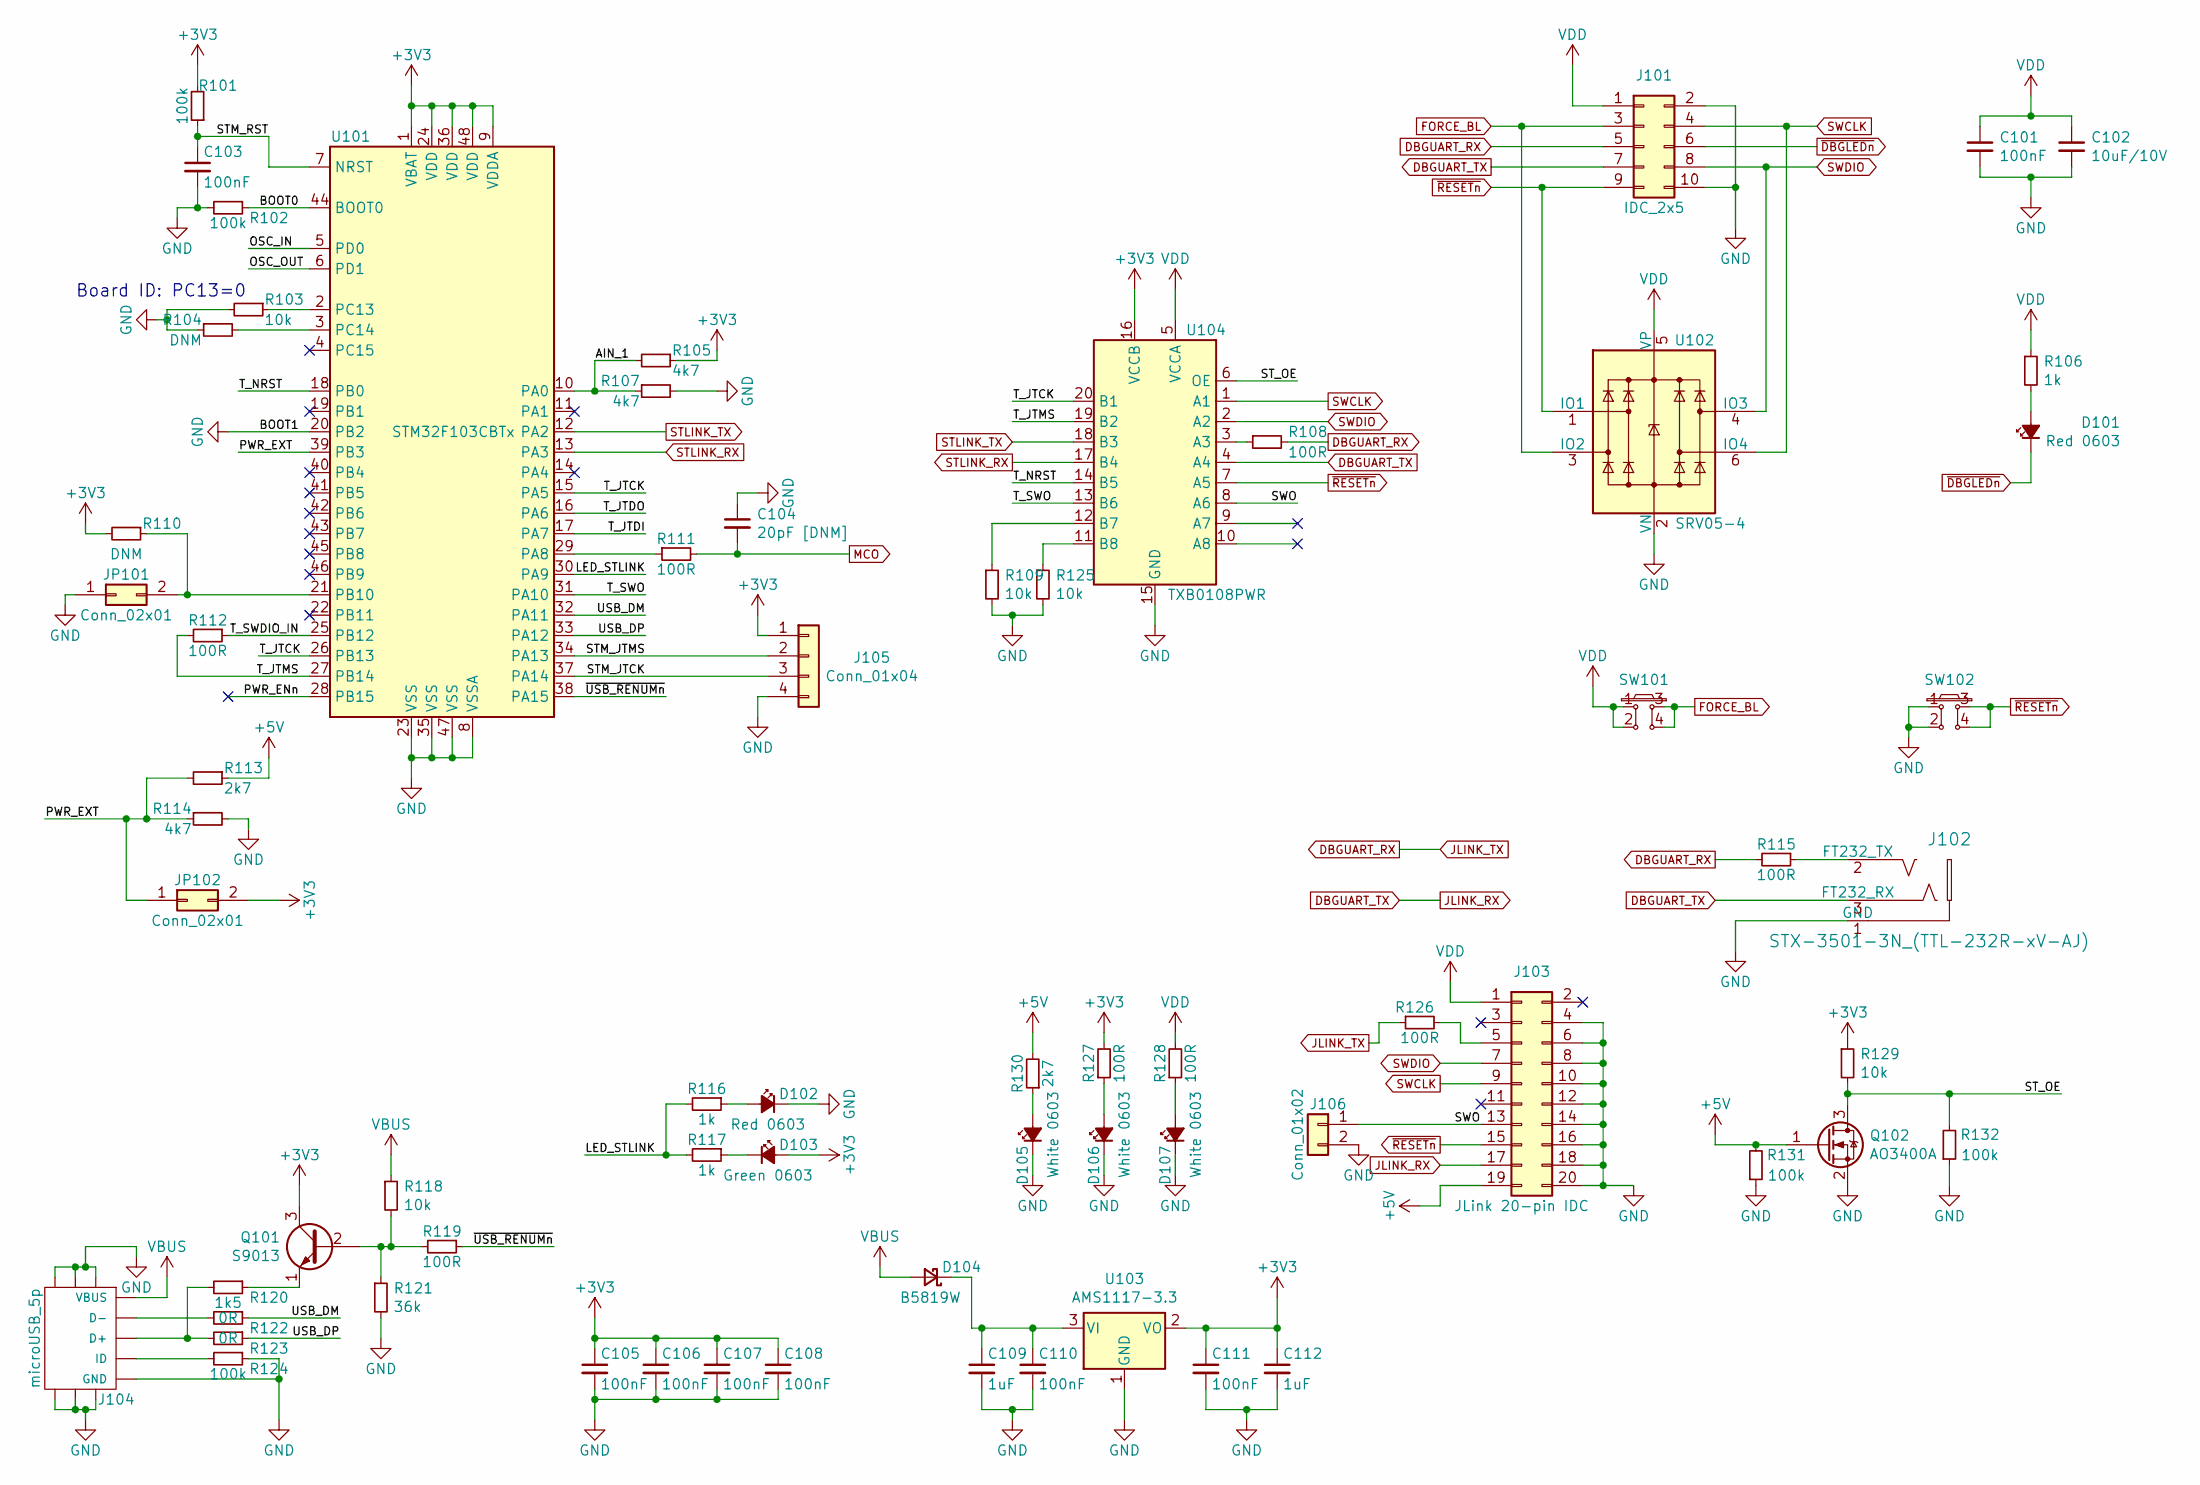
[picture p221: schematic ss_debug_adapter.kicad_sch, SS debug adapter (STLink v2.1 comp.)]

Parts:
C101, C103, C105, C106, C107, C108, C110, C111: 100nF; C_0402_1005Metric; LCSC C1525
C102: 10uF/10V; C_0603_1608Metric; LCSC C19702
C104: 20pF [DNM]; C_0402_1005Metric
C109, C112: 1uF; C_0402_1005Metric; LCSC C52923
D101, D102: Red 0603; LED_0603_1608Metric; LCSC C2286
D103: Green 0603; LED_0603_1608Metric; LCSC C72043
D104: B5819W; D_SOD-123; LCSC C6186
D105, D106, D107: White 0603; LED_0603_1608Metric; LCSC C2290
J101: IDC_2x5; IDC-Header_2x05_P2.54mm_Vertical
J102: STX-3501-3N_(TTL-232R-xV-AJ); STX3501_smd
J103: JLink 20-pin IDC; IDC-Header_2x10_P2.54mm_Vertical
J104: microUSB_5p; microUSB_5p-LCSC-Jing_Extension
J105: Conn_01x04; PinHeader_1x04_P2.54mm_Horizontal
J106: Conn_01x02; PinHeader_1x02_P2.54mm_Vertical
JP101, JP102: Conn_02x01; PinHeader_1x02_P2.54mm_Vertical
Q101: S9013; SOT-23; LCSC C6749
Q102: AO3400A; SOT-23
R101, R102, R124, R131, R132: 100k; R_0402_1005Metric; LCSC C25741
R103, R109, R118, R125, R129: 10k; R_0402_1005Metric; LCSC C25744
R104, R110: DNM; R_0402_1005Metric
R105, R107, R114: 4k7; R_0402_1005Metric; LCSC C25900
R106, R116, R117: 1k; R_0402_1005Metric; LCSC C11702
R108, R111, R112, R115, R119, R126, R127, R128: 100R; R_0402_1005Metric; LCSC C25076
R113, R130: 2k7; R_0603_1608Metric; LCSC C13167
R120: 1k5; R_0402_1005Metric; LCSC C25867
R121: 36k; R_0603_1608Metric; LCSC C23147
R122, R123: 0R; R_0402_1005Metric; LCSC C17168
SW101, SW102: Pushbutton_SMD_TS-1102W-4316; SMD_PUSHBTN_6x6mm; LCSC C255812
U101: STM32F103CBTx; LQFP-48_7x7mm_P0.5mm; LCSC C8304
U102: SRV05-4; SOT-23-6; LCSC C85364
U103: AMS1117-3.3; SOT-223-3_TabPin2; LCSC C6186
U104: TXB0108PWR; TSSOP-20_4.4x6.5mm_P0.65mm; JLC Extended

Connections:
+3V3: C105.1, C106.1, C107.1, C108.1, C111.1, C112.1, D103.2 (A), J105.1, JP102.2, Q101.3 (C), R101.2, R105.1, R110.2, R127.2, R129.1, U101.1 (VBAT), U101.9 (VDDA), U101.24 (VDD), U101.36 (VDD), U101.48 (VDD), U103.2 (VO), U104.16 (VCCB)
+5V: J103.19, Q102.1 (G), R113.1, R130.2, R131.2
/AIN_1: R105.2, R107.1, U101.10 (PA0)
/BOOT0: R102.1, U101.44 (BOOT0)
/LED_STLINK: R116.2, R117.2, U101.30 (PA9)
/OSC_IN: U101.5 (PD0)
/OSC_OUT: U101.6 (PD1)
/PWR_ENn: U101.28 (PB15)
/PWR_EXT: JP102.1, R113.2, R114.1, U101.39 (PB3)
/STM_JTCK: J105.3, U101.37 (PA14)
/STM_JTMS: J105.2, U101.34 (PA13)
/STM_RST: C103.1, R101.1, U101.7 (NRST)
/ST_OE: Q102.3 (D), R129.2, R132.2, U104.6 (OE)
/SWO: J103.13, J106.1, U104.8 (A6)
/T_JTCK: U101.15 (PA5), U101.26 (PB13), U104.20 (B1)
/T_JTDI: U101.17 (PA7)
/T_JTDO: U101.16 (PA6)
/T_JTMS: R112.2, U101.27 (PB14), U104.19 (B2)
/T_NRST: U101.18 (PB0), U104.14 (B5)
/T_SWDIO_IN: R112.1, U101.25 (PB12)
/T_SWO: U101.31 (PA10), U104.13 (B6)
/USB_DM: R122.1, U101.32 (PA11)
/USB_DP: R123.1, U101.33 (PA12)
/~USB_RENUMn: R119.1, U101.38 (PA15)
DBGUART_RX: J101.5, R108.2, R115.2, R126.1
DBGUART_TX: J101.7, J102.3 (FT232_RX), J103.17, U104.4 (A4)
FORCE_BL: J101.3, SW101.3, SW101.4, U102.3 (IO2)
GND: C101.2, C102.2, C103.2, C104.1, C105.2, C106.2, C107.2, C108.2, C109.2, C110.2, C111.2, C112.2, D102.1 (K), D105.1 (K), D106.1 (K), D107.1 (K), J101.2, J101.10, J102.1 (GND), J103.4, J103.6, J103.8, J103.10, J103.12, J103.14, J103.16, J103.18, J103.20, J104.5 (GND), J104.6, J104.7, J104.8, J104.9, J104.10, J104.11, J105.4, J106.2, JP101.1, Q102.2 (S), R102.2, R103.2, R104.1, R107.2, R109.2, R114.2, R121.2, R124.1, R125.2, R131.1, R132.1, SW102.1, SW102.2, U101.8 (VSSA), U101.20 (PB2), U101.23 (VSS), U101.35 (VSS), U101.47 (VSS), U102.2 (VN), U103.1 (GND), U104.15 (GND)
MCO: C104.2, R111.2
unnamed: C109.1, C110.1, D104.1 (K), U103.3 (VI)
unnamed: D101.2 (A), R106.2
unnamed: D102.2 (A), R116.1
unnamed: D103.1 (K), R117.1
unnamed: D105.2 (A), R130.1
unnamed: D106.2 (A), R127.1
unnamed: D107.2 (A), R128.1
unnamed: J102.2 (FT232_TX), R115.1
unnamed: J103.5, R126.2
unnamed: J104.2 (D-), R122.2
unnamed: J104.3 (D+), R120.2, R123.2
unnamed: J104.4 (ID), R124.2
unnamed: JP101.2, R110.1, U101.21 (PB10)
unnamed: Q101.1 (E), R120.1
unnamed: Q101.2 (B), R118.2, R119.2, R121.1
unnamed: R103.1, U101.2 (PC13)
unnamed: R104.2, U101.3 (PC14)
unnamed: R108.1, U104.3 (A3)
unnamed: R109.1, U104.12 (B7)
unnamed: R111.1, U101.29 (PA8)
unnamed: R125.1, U104.11 (B8)
STLINK_RX: U101.13 (PA3), U104.17 (B4)
STLINK_TX: U101.12 (PA2), U104.18 (B3)
SWCLK: J101.4, J103.9, U102.6 (IO4), U104.1 (A1)
SWDIO: J101.8, J103.7, U102.4 (IO3), U104.2 (A2)
VBUS: D104.2 (A), J104.1 (VBUS), R118.1
VDD: C101.1, C102.1, J101.1, J103.1, R106.1, R128.2, SW101.1, SW101.2, U102.5 (VP), U104.5 (VCCA)
~DBGLEDn: D101.1 (K), J101.6
~RESETn: J101.9, J103.15, SW102.3, SW102.4, U102.1 (IO1), U104.7 (A5)

Notes on the sheet:
Board ID: PC13=0

Board: 2 copper layers, 67 parts (1 on the bottom side), 53 nets, no tracks yet.
