mjohansson/SolderingStation/hw/frontpanel_dev_adapter/frontpanel_dev_adapter.kicad_pcb

## KiCad design hw/frontpanel_dev_adapter/frontpanel_dev_adapter.kicad_pcb (2020-12-31)

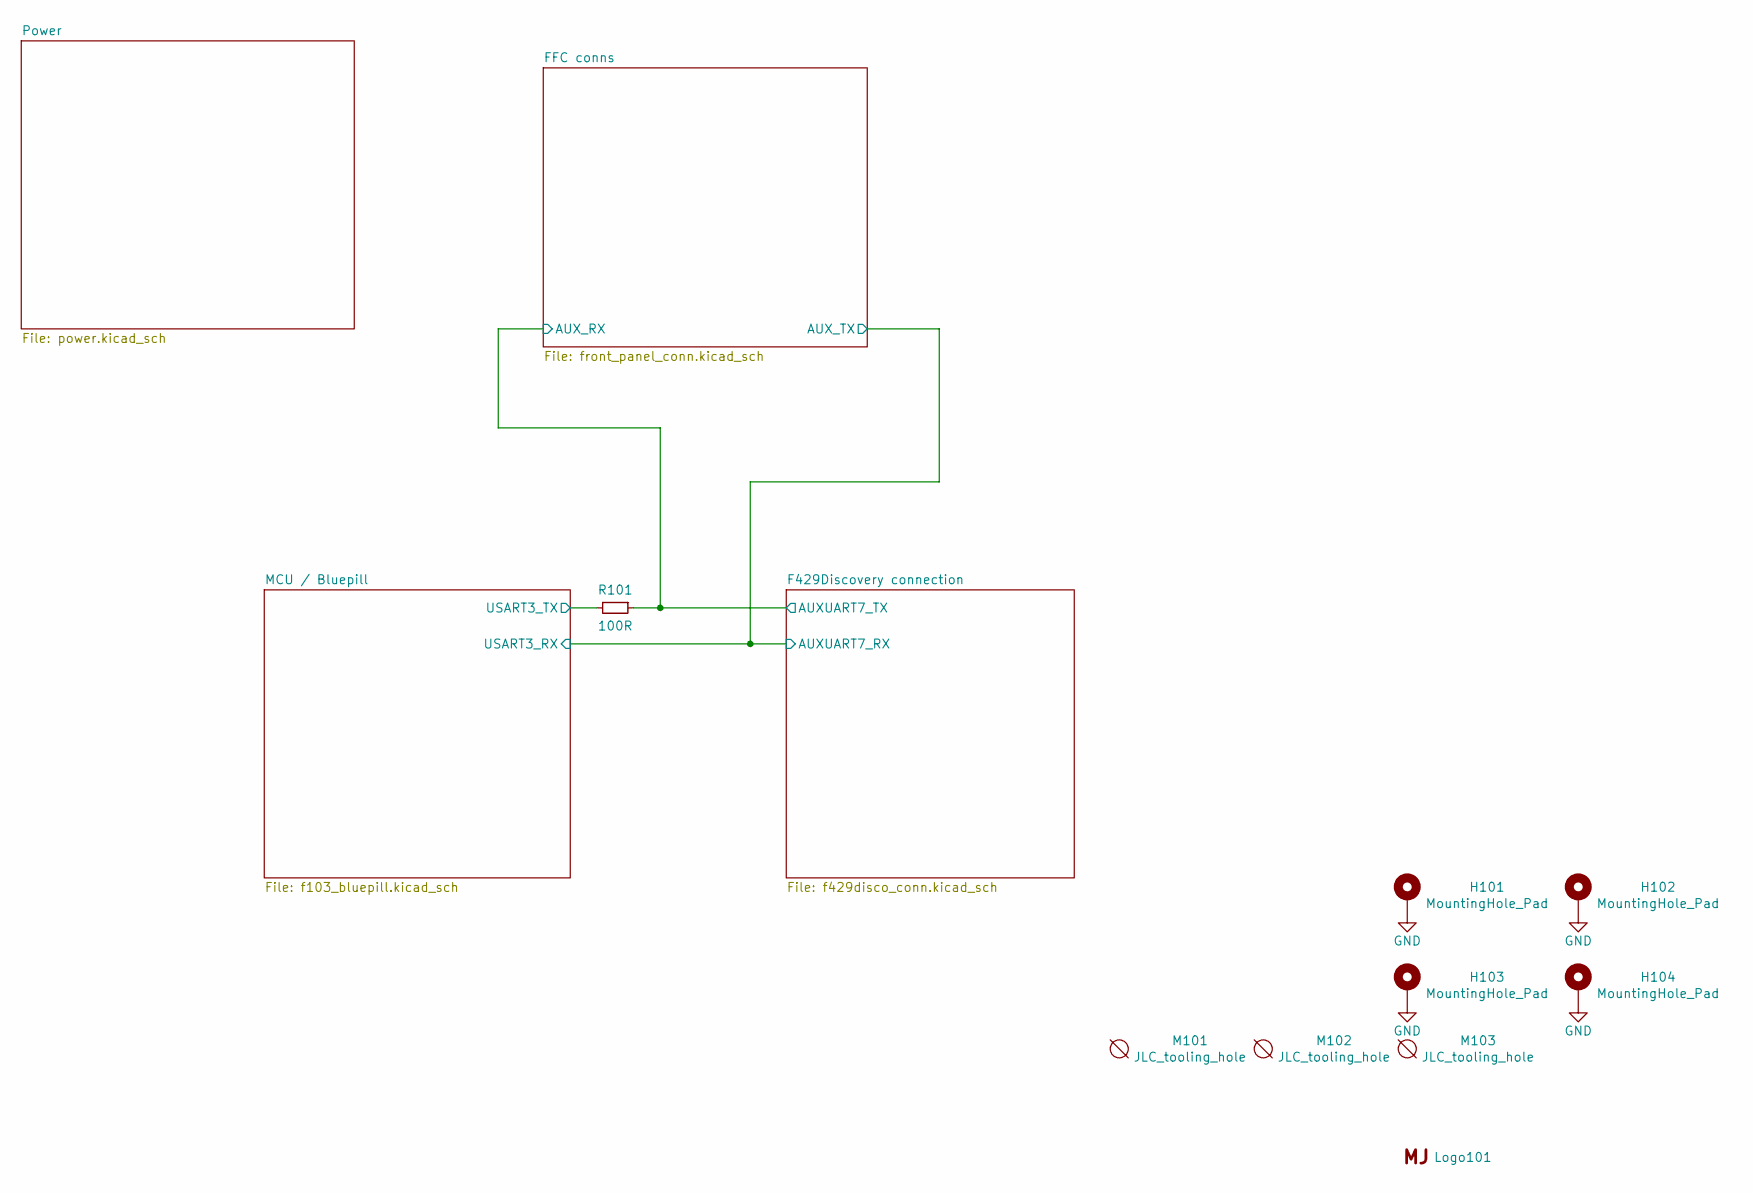
[picture p222: schematic frontpanel_dev_adapter.kicad_sch, FFC Adapter board]

Parts:
H101, H102, H103, H104: MountingHole_Pad; MountingHole_3.2mm_M3_ISO7380_Pad
Logo101: Logo_MJ; MJ_10.3x12.7
M101, M102, M103: JLC_tooling_hole; JLC_tooling-hole
R101: 100R; R_0402_1005Metric; LCSC C25076

Connections:
/F429Discovery connection/AUXUART7_TX: R101.1; also elsewhere on the board
/MCU / Bluepill/USART3_TX: R101.2; also elsewhere on the board

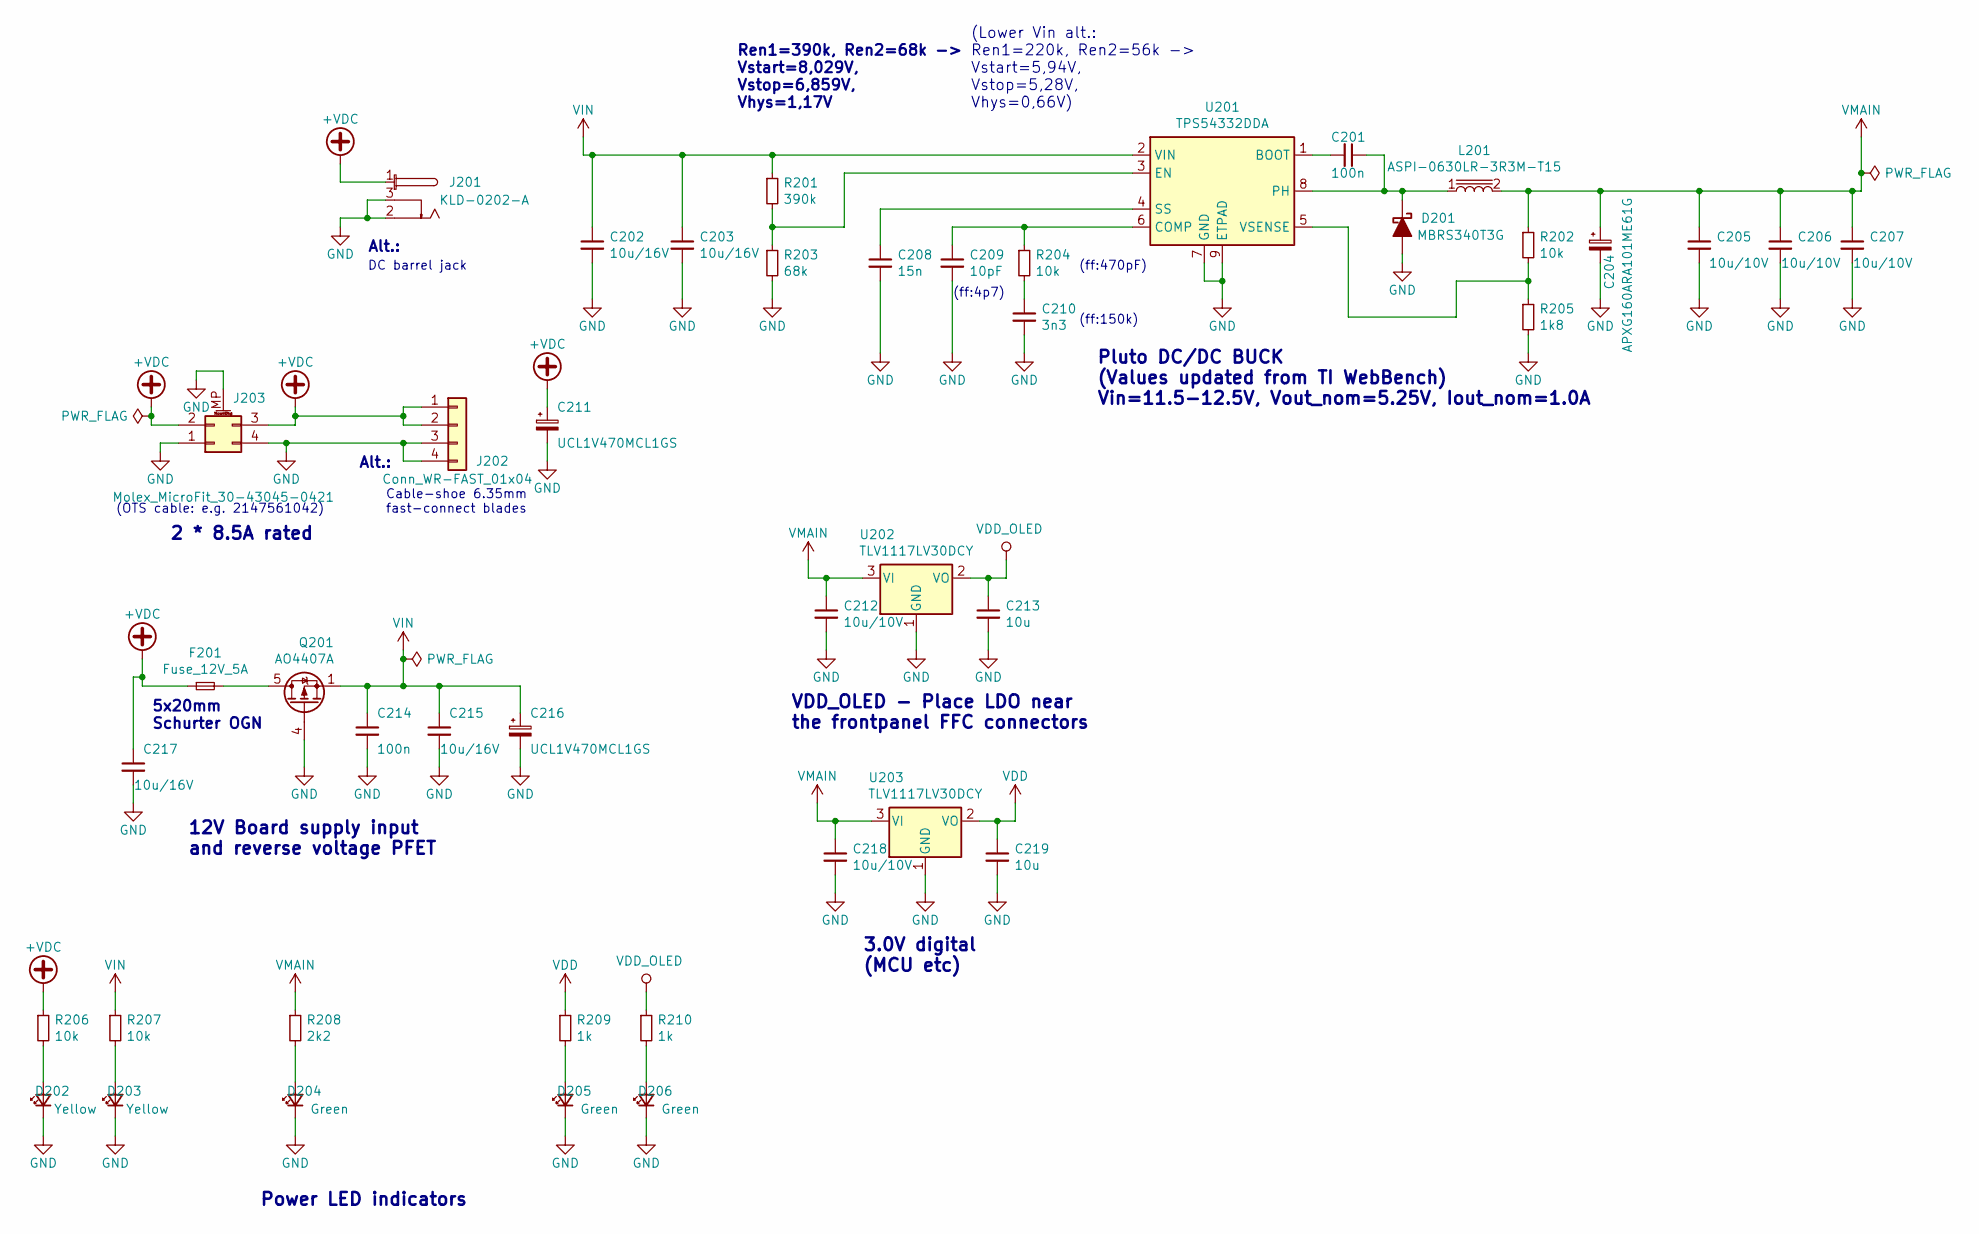
[picture p223: schematic power.kicad_sch, DC/DC Buck, LDOs & power-LEDs]

Parts:
C201, C214: 100n; C_0603_1608Metric; LCSC C14663
C202, C203, C215, C217: 10u/16V; C_0805_2012Metric; LCSC C15850
C204: APXG160ARA101ME61G; CP_Elec_5x5.8
C205, C206, C207, C212, C218: 10u/10V; C_0603_1608Metric; LCSC C19702
C208: 15n; C_0603_1608Metric; LCSC C1596
C209: 10pF; C_0402_1005Metric; LCSC C32949
C210: 3n3; C_0402_1005Metric; LCSC C26404
C211, C216: UCL1V470MCL1GS; CP_Elec_6.3x5.8
C213, C219: 10u; C_0603_1608Metric; LCSC C19702
D201: MBRS340T3G; MBRS3xx_SMC_CASE_403AC; LCSC C40326
D202, D203: Yellow; LED_0603_1608Metric; LCSC C72038
D204, D205, D206: Green; LED_0603_1608Metric; LCSC C72043
F201: Fuse_12V_5A; Fuseholder_5x20mm_Schurter_OGN-0031.8201
J201: KLD-0202-A
J202: Conn_WR-FAST_01x04; WR-FAST_508_4_V
J203: Molex_MicroFit_30-43045-0421; Molex_Micro-Fit_3.0_43045-0421_2x02-1MP_P3.00mm_Horizontal
L201: ASPI-0630LR-3R3M-T15; ASPI-0603LR
Q201: AO4407A; SOIC-8_3.9x4.9mm_P1.27mm; LCSC C16072
R201: 390k; R_0603_1608Metric; LCSC C23150
R202, R204, R206, R207: 10k; R_0402_1005Metric; LCSC C25744
R203: 68k; R_0402_1005Metric; LCSC C36871
R205: 1k8; R_0603_1608Metric; LCSC C4177
R208: 2k2; R_0402_1005Metric; LCSC C25879
R209, R210: 1k; R_0402_1005Metric; LCSC C11702
U201: TPS54332DDA; TI_SO-PowerPAD-8_ThermalVias; LCSC C41312
U202, U203: TLV1117LV30DCY; SOT-223-3_TabPin2; LCSC C15578

Connections:
+VDC: C211.1, C217.1, F201.1, J201.1, J202.1, J202.2, J203.2, J203.3, R206.1
unnamed: C201.2, U201.1 (BOOT)
unnamed: C209.1, R204.1, U201.6 (COMP)
unnamed: C210.1, R204.2
unnamed: D202.2 (A), R206.2
unnamed: D203.2 (A), R207.2
unnamed: D204.2 (A), R208.2
unnamed: D205.2 (A), R209.2
unnamed: D206.2 (A), R210.2
unnamed: F201.2, Q201.5 (D), Q201.6 (D), Q201.7 (D), Q201.8 (D)
unnamed: R202.2, R205.1, U201.5 (VSENSE)
VDD: C219.1, R209.1, U203.2 (VO); also elsewhere on the board
VDD_OLED: C213.1, R210.1, U202.2 (VO); also elsewhere on the board
VIN: C202.1, C203.1, C214.1, C215.1, C216.1, Q201.1 (S), Q201.2 (S), Q201.3 (S), R201.1, R207.1, U201.2 (VIN); also elsewhere on the board
VMAIN: C204.1, C205.1, C206.1, C207.1, C212.1, C218.1, L201.2, R202.1, R208.1, U202.3 (VI), U203.3 (VI); also elsewhere on the board

Notes on the sheet:
Ren1=390k, Ren2=68k -> Vstart=8,029V, Vstop=6,859V, Vhys=1,17V
(Lower Vin alt.: Ren1=220k, Ren2=56k -> Vstart=5,94V, Vstop=5,28V, Vhys=0,66V)
Alt.:
(ff:470pF)
Cable-shoe 6.35mm fast-connect blades
(ff:150k)
2 * 8.5A rated
Power LED indicators
(OTS cable: e.g. 2147561042)
5x20mm Schurter OGN
Pluto DC/DC BUCK (Values updated from TI WebBench) Vin=11.5-12.5V, Vout_nom=5.25V, Iout_nom=1.0A
VDD_OLED - Place LDO near the frontpanel FFC connectors
(ff:4p7)
DC barrel jack
12V Board supply input and reverse voltage PFET
3.0V digital (MCU etc)

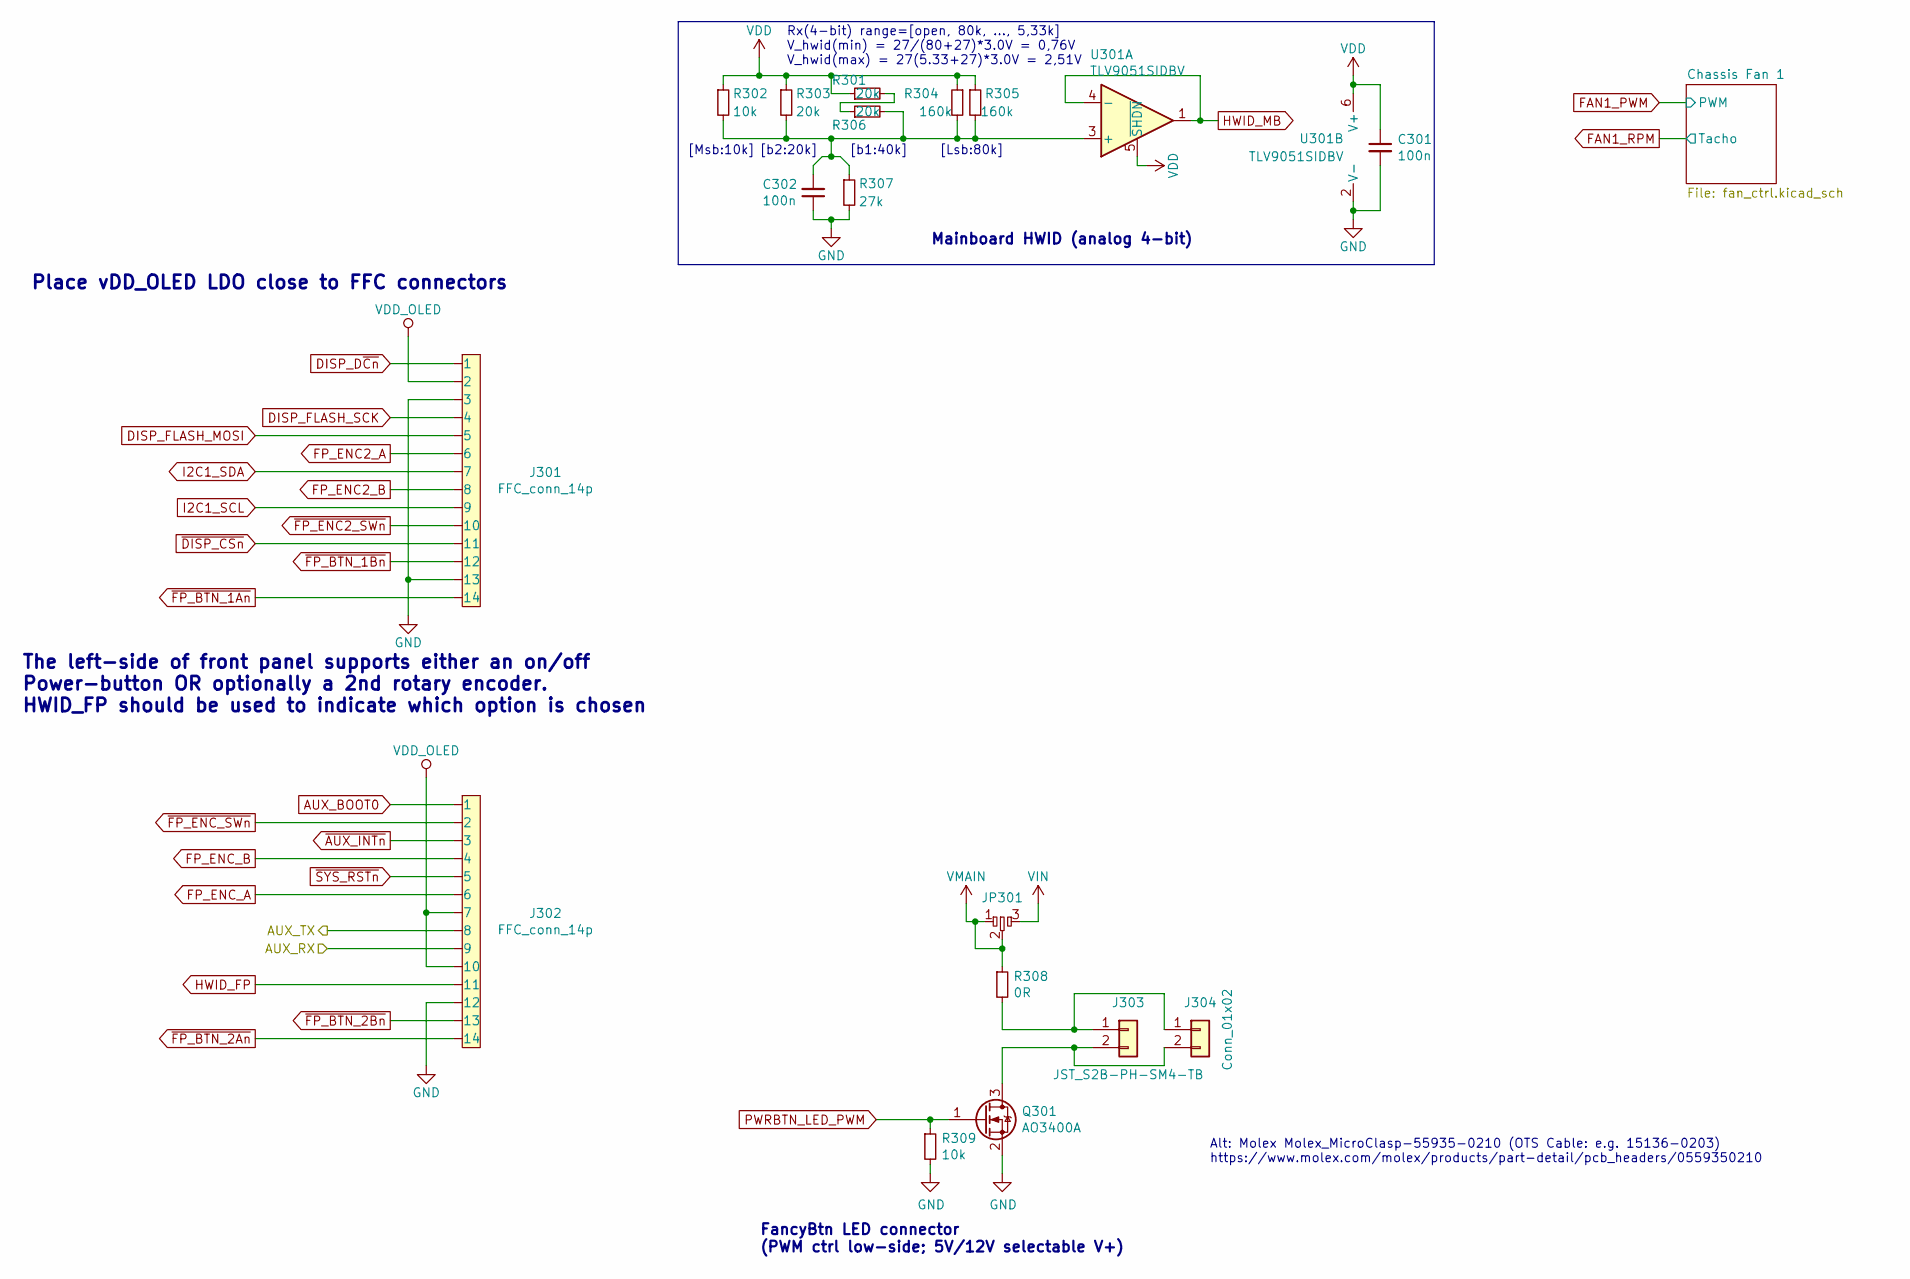
[picture p224: schematic front_panel_conn.kicad_sch, Front-side and internal connectors]

Parts:
C301, C302: 100n; C_0402_1005Metric; LCSC C1525
J301, J302: FFC_conn_14p; FPC_14p_05mm-Molex_5052781433
J303: JST_S2B-PH-SM4-TB; JST_PH_S2B-PH-SM4-TB_1x02-1MP_P2.00mm_Horizontal
J304: Conn_01x02; PinHeader_1x02_P2.54mm_Vertical
JP301: dogbone_3_ud; db3_ud_0603
Q301: AO3400A; SOT-23; LCSC C20917
R301, R303, R306: 20k; R_0402_1005Metric; LCSC C25765
R302, R309: 10k; R_0402_1005Metric; LCSC C25744
R304, R305: 160k; R_0603_1608Metric; LCSC C22813
R307: 27k; R_0402_1005Metric; LCSC C25771
R308: 0R; R_0402_1005Metric; LCSC C17168
U301: TLV9051SIDBV; TSOT-23-6

Connections:
/F429Discovery connection/AUXUART7_RX: J302.8; also elsewhere on the board
/F429Discovery connection/AUXUART7_TX: J302.9; also elsewhere on the board
AUX_BOOT0: J302.1; also elsewhere on the board
DISP_D~Cn~: J301.1; also elsewhere on the board
DISP_FLASH_MOSI: J301.5; also elsewhere on the board
DISP_FLASH_SCK: J301.4; also elsewhere on the board
FP_ENC2_A: J301.6; also elsewhere on the board
FP_ENC2_B: J301.8; also elsewhere on the board
FP_ENC_A: J302.6; also elsewhere on the board
FP_ENC_B: J302.4; also elsewhere on the board
HWID_FP: J302.11; also elsewhere on the board
HWID_MB: U301.1, U301.4 (-); also elsewhere on the board
I2C1_SCL: J301.9; also elsewhere on the board
I2C1_SDA: J301.7; also elsewhere on the board
unnamed: C302.2, R302.2, R303.2, R304.2, R305.2, R306.2, R307.1, U301.3 (+)
unnamed: J303.1, J304.1, R308.2
unnamed: J303.2, J304.2, Q301.3 (D)
unnamed: R301.2, R306.1
PWRBTN_LED_PWM: Q301.1 (G), R309.1; also elsewhere on the board
VDD: C301.1, R301.1, R302.1, R303.1, R304.1, R305.1, U301.5 (~SHDN), U301.6 (V+); also elsewhere on the board
VDD_OLED: J301.2, J302.7, J302.10; also elsewhere on the board
VIN: JP301.3; also elsewhere on the board
VMAIN: JP301.1, JP301.2, R308.1; also elsewhere on the board
~AUX_INTn~: J302.3; also elsewhere on the board
~DISP_CSn~: J301.11; also elsewhere on the board
~FP_BTN_1An~: J301.14; also elsewhere on the board
~FP_BTN_1Bn~: J301.12; also elsewhere on the board
~FP_BTN_2An~: J302.14; also elsewhere on the board
~FP_BTN_2Bn~: J302.13; also elsewhere on the board
~FP_ENC2_SWn~: J301.10; also elsewhere on the board
~FP_ENC_SWn~: J302.2; also elsewhere on the board
~SYS_RSTn~: J302.5; also elsewhere on the board

Notes on the sheet:
The left-side of front panel supports either an on/off Power-button OR optionally a 2nd rotary encoder. HWID_FP should be used to indicate which option is chosen
[Msb:10k]
[b1:40k]
Mainboard HWID (analog 4-bit)
[b2:20k]
Alt: Molex Molex_MicroClasp-55935-0210 (OTS Cable: e.g. 15136-0203) https://www.molex.com/molex/products/part-detail/pcb_headers/0559350210
FancyBtn LED connector (PWM ctrl low-side; 5V/12V selectable V+)
Rx(4-bit) range=[open, 80k, ..., 5,33k] V_hwid(min) = 27/(80+27)*3.0V = 0,76V V_hwid(max) = 27(5.33+27)*3.0V = 2,51V
[Lsb:80k]
Place vDD_OLED LDO close to FFC connectors

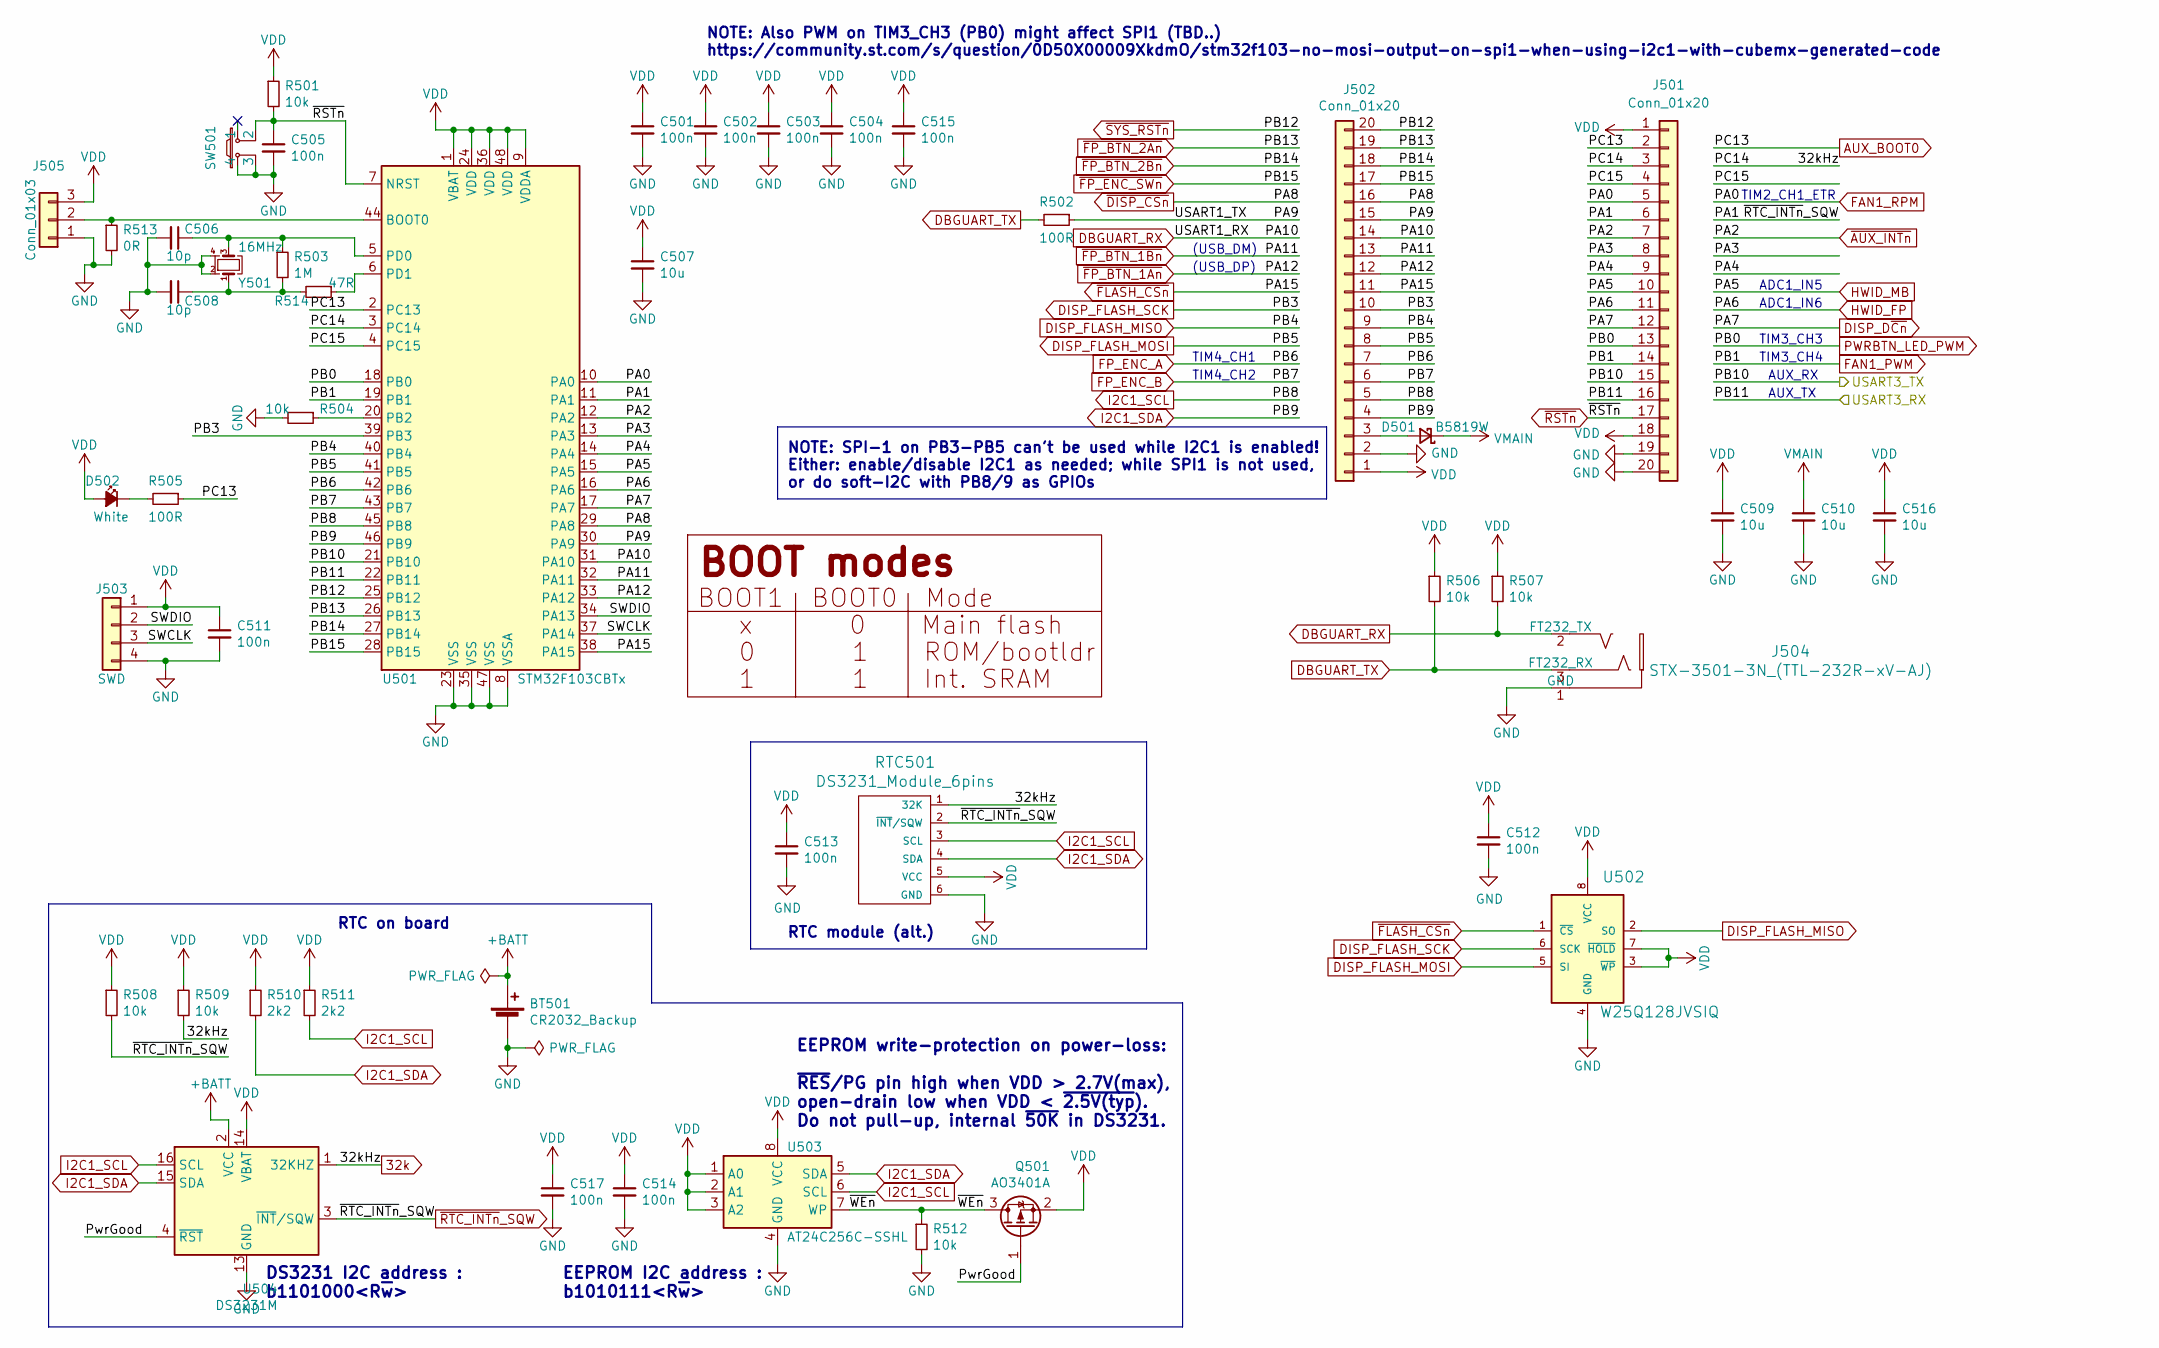
[picture p225: schematic f103_bluepill.kicad_sch, On-board alt. modules for BluePill MCU and RTC]

Parts:
BT501: CR2032_Backup; CR2032_coincell_holder
C501, C502, C503, C504, C505, C511, C512, C513, C514, C515, C517: 100n; C_0402_1005Metric; LCSC C1525
C506, C508: 10p; C_0402_1005Metric; LCSC C32949
C507, C509, C510, C516: 10u; C_0603_1608Metric; LCSC C19702
D501: B5819W; D_SOD-123; LCSC C8598
D502: White; LED_0603_1608Metric; LCSC C2290
J501, J502: Conn_01x20; PinSocket_1x20_P2.54mm_Vertical
J503: SWD; PinHeader_1x04_P2.54mm_Horizontal
J504: STX-3501-3N_(TTL-232R-xV-AJ); STX3501_smd
J505: Conn_01x03; PinHeader_1x03_P2.54mm_Vertical
Q501: AO3401A; SOT-23; LCSC C15127
R501, R504, R506, R508, R509, R512: 10k; R_0402_1005Metric; LCSC C25744
R502, R505: 100R; R_0402_1005Metric; LCSC C25076
R503: 1M; R_0402_1005Metric; LCSC C26083
R507: 10k; R_0402_1005Metric
R510, R511: 2k2; R_0402_1005Metric; LCSC C25879
R513: 0R; R_0402_1005Metric; LCSC C17168
R514: 47R; R_0402_1005Metric; LCSC C25118
RTC501: DS3231_Module_6pins; DS3231_module_6pin_horizontal_mnt
SW501: SKHUxxE010; SKHU
U501: STM32F103CBTx; LQFP-48_7x7mm_P0.5mm; LCSC C8304
U502: W25Q128JVSIQ; SOIC-8_5.23x5.23mm_P1.27mm; LCSC C97521
U503: AT24C256C-SSHL; SO-8_3.9x4.9mm_P1.27mm; LCSC C6482
U504: DS3231M; SOIC-16W_7.5x10.3mm_P1.27mm; LCSC C37663
Y501: 16MHz; Crystal_SMD_3225-4Pin_3.2x2.5mm; LCSC C13738

Connections:
32k: J501.3, R509.2, RTC501.1 (32K), U501.3 (PC14), U504.1 (32KHZ); also elsewhere on the board
+BATT: BT501.1 (+), U504.2 (VCC)
/F429Discovery connection/AUXUART7_RX: J501.16, U501.22 (PB11); also elsewhere on the board
/MCU / Bluepill/PA3: J501.8, U501.13 (PA3)
/MCU / Bluepill/PA4: J501.9, U501.14 (PA4)
/MCU / Bluepill/PA9: J502.15, R502.1, U501.30 (PA9)
/MCU / Bluepill/PC15: J501.4, U501.4 (PC15)
/MCU / Bluepill/PwrGood: Q501.1 (G), U504.4 (~RST)
/MCU / Bluepill/SWCLK: J503.3, U501.37 (PA14)
/MCU / Bluepill/SWDIO: J503.2, U501.34 (PA13)
/MCU / Bluepill/USART3_TX: J501.15, U501.21 (PB10); also elsewhere on the board
/MCU / Bluepill/~WEn~: Q501.3 (D), R512.1, U503.7 (WP)
AUX_BOOT0: J501.2, R505.1, U501.2 (PC13); also elsewhere on the board
DBGUART_RX: J502.14, J504.2 (FT232_TX), R507.2, U501.31 (PA10); also elsewhere on the board
DBGUART_TX: J504.3 (FT232_RX), R502.2, R506.2; also elsewhere on the board
DISP_D~Cn~: J501.12, U501.17 (PA7); also elsewhere on the board
DISP_FLASH_MISO: J502.9, U501.40 (PB4), U502.2 (SO); also elsewhere on the board
DISP_FLASH_MOSI: J502.8, U501.41 (PB5), U502.5 (SI); also elsewhere on the board
DISP_FLASH_SCK: J502.10, U501.39 (PB3), U502.6 (SCK); also elsewhere on the board
FAN1_PWM: J501.14, U501.19 (PB1); also elsewhere on the board
FAN1_RPM: J501.5, U501.10 (PA0); also elsewhere on the board
FP_ENC_A: J502.7, U501.42 (PB6); also elsewhere on the board
FP_ENC_B: J502.6, U501.43 (PB7); also elsewhere on the board
HWID_FP: J501.11, U501.16 (PA6); also elsewhere on the board
HWID_MB: J501.10, U501.15 (PA5); also elsewhere on the board
I2C1_SCL: J502.5, R511.2, RTC501.3 (SCL), U501.45 (PB8), U503.6 (SCL), U504.16 (SCL); also elsewhere on the board
I2C1_SDA: J502.4, R510.2, RTC501.4 (SDA), U501.46 (PB9), U503.5 (SDA), U504.15 (SDA); also elsewhere on the board
unnamed: C506.1, R503.1, U501.5 (PD0), Y501.3
unnamed: C508.1, R503.2, R514.2, Y501.1
unnamed: D501.2 (A), J502.3
unnamed: D502.1 (K), R505.2
unnamed: J505.2, R513.1, U501.44 (BOOT0)
unnamed: R504.1, U501.20 (PB2)
unnamed: R514.1, U501.6 (PD1)
PWRBTN_LED_PWM: J501.13, U501.18 (PB0); also elsewhere on the board
VDD: C501.1, C502.1, C503.1, C504.1, C507.1, C509.1, C511.1, C512.1, C513.1, C514.1, C515.1, C516.1, C517.1, D502.2 (A), J501.1, J501.18, J502.1, J503.1, J505.3, Q501.2 (S), R501.1, R506.1, R507.1, R508.1, R509.1, R510.1, R511.1, RTC501.5 (VCC), U501.1 (VBAT), U501.9 (VDDA), U501.24 (VDD), U501.36 (VDD), U501.48 (VDD), U502.3 (~WP), U502.7 (~HOLD), U502.8 (VCC), U503.1 (A0), U503.2 (A1), U503.3 (A2), U503.8 (VCC), U504.14 (VBAT); also elsewhere on the board
VMAIN: C510.1, D501.1 (K); also elsewhere on the board
~AUX_INTn~: J501.7, U501.12 (PA2); also elsewhere on the board
~DISP_CSn~: J502.16, U501.29 (PA8); also elsewhere on the board
~FLASH_CSn~: J502.11, U501.38 (PA15), U502.1 (~CS); also elsewhere on the board
~FP_BTN_1An~: J502.12, U501.33 (PA12); also elsewhere on the board
~FP_BTN_1Bn~: J502.13, U501.32 (PA11); also elsewhere on the board
~FP_BTN_2An~: J502.19, U501.26 (PB13); also elsewhere on the board
~FP_BTN_2Bn~: J502.18, U501.27 (PB14); also elsewhere on the board
~FP_ENC_SWn~: J502.17, U501.28 (PB15); also elsewhere on the board
~RSTn~: C505.1, J501.17, R501.2, SW501.2, U501.7 (NRST); also elsewhere on the board
~RTC_INTn~_SQW: J501.6, R508.2, RTC501.2 (~INT/SQW), U501.11 (PA1), U504.3 (~INT/SQW); also elsewhere on the board
~SYS_RSTn~: J502.20, U501.25 (PB12); also elsewhere on the board

Notes on the sheet:
(USB_DM)
DS3231 I2C address : b1101000<R~{w}>
TIM4_CH2
NOTE: Also PWM on TIM3_CH3 (PB0) might affect SPI1 (TBD..) https://community.st.com/s/question/0D50X00009XkdmO/stm32f103-no-mosi-output-on-spi1-when-using-i2c1-with-cubemx-generated-code
TIM3_CH4
AUX_TX
AUX_RX
TIM3_CH3
EEPROM write-protection on power-loss: ~{RES}/PG pin high when VDD > 2.7V(max), open-drain low when VDD < ~{2.5V(typ}). Do not pull-up, internal ~{50K} in DS3231.
ADC1_IN5
NOTE: SPI-1 on PB3-PB5 can't be used while I2C1 is enabled! Either: enable/disable I2C1 as needed; while SPI1 is not used, or do soft-I2C with PB8/9 as GPIOs
TIM2_CH1_ETR
(USB_DP)
EEPROM I2C address : b1010111<R~{w}>
ADC1_IN6
RTC on board
TIM4_CH1
RTC module (alt.)

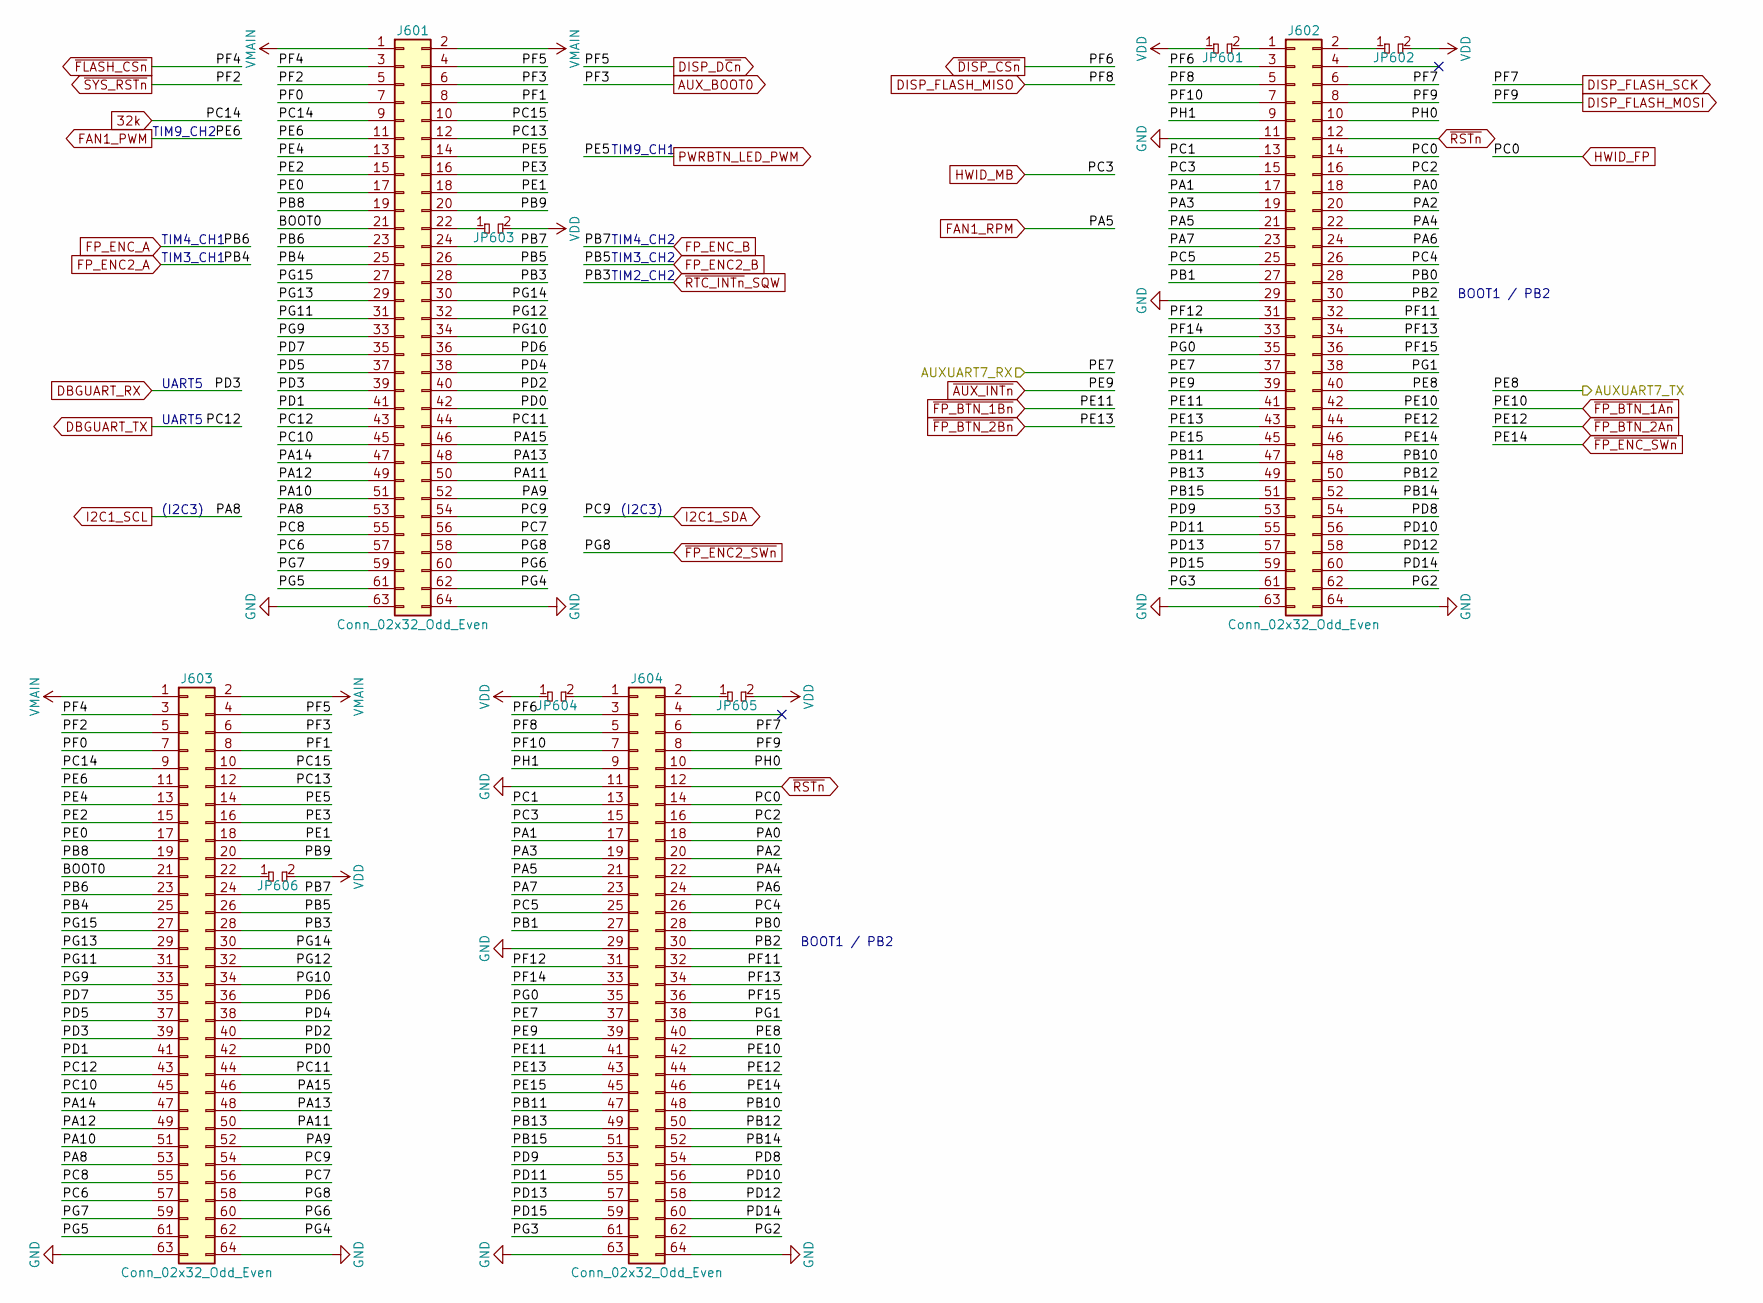
[picture p226: schematic f429disco_conn.kicad_sch, Connections to F429DISCO1 dev board]

Parts:
J601, J602: Conn_02x32_Odd_Even; PinSocket_2x32_P2.54mm_Vertical
J603, J604: Conn_02x32_Odd_Even; PinHeader_2x32_P2.54mm_Vertical
JP601, JP602, JP603, JP604, JP605, JP606: dogbone_2_ud; db2_ud_0402

Connections:
32k: J601.9, J603.9; also elsewhere on the board
/F429Discovery connection/AUXUART7_RX: J602.37, J604.37; also elsewhere on the board
/F429Discovery connection/AUXUART7_TX: J602.40, J604.40; also elsewhere on the board
/F429Discovery connection/BOOT0: J601.21, J603.21
/F429Discovery connection/PA0: J602.18, J604.18
/F429Discovery connection/PA1: J602.17, J604.17
/F429Discovery connection/PA2: J602.20, J604.20
/F429Discovery connection/PA3: J602.19, J604.19
/F429Discovery connection/PA4: J602.22, J604.22
/F429Discovery connection/PA6: J602.24, J604.24
/F429Discovery connection/PA7: J602.23, J604.23
/F429Discovery connection/PA9: J601.52, J603.52
/F429Discovery connection/PA10: J601.51, J603.51
/F429Discovery connection/PA11: J601.50, J603.50
/F429Discovery connection/PA12: J601.49, J603.49
/F429Discovery connection/PA13: J601.48, J603.48
/F429Discovery connection/PA14: J601.47, J603.47
/F429Discovery connection/PA15: J601.46, J603.46
/F429Discovery connection/PB0: J602.28, J604.28
/F429Discovery connection/PB1: J602.27, J604.27
/F429Discovery connection/PB2: J602.30, J604.30
/F429Discovery connection/PB8: J601.19, J603.19
/F429Discovery connection/PB9: J601.20, J603.20
/F429Discovery connection/PB10: J602.48, J604.48
/F429Discovery connection/PB11: J602.47, J604.47
/F429Discovery connection/PB12: J602.50, J604.50
/F429Discovery connection/PB13: J602.49, J604.49
/F429Discovery connection/PB14: J602.52, J604.52
/F429Discovery connection/PB15: J602.51, J604.51
/F429Discovery connection/PC1: J602.13, J604.13
/F429Discovery connection/PC2: J602.16, J604.16
/F429Discovery connection/PC4: J602.26, J604.26
/F429Discovery connection/PC5: J602.25, J604.25
/F429Discovery connection/PC6: J601.57, J603.57
/F429Discovery connection/PC7: J601.56, J603.56
/F429Discovery connection/PC8: J601.55, J603.55
/F429Discovery connection/PC10: J601.45, J603.45
/F429Discovery connection/PC11: J601.44, J603.44
/F429Discovery connection/PC13: J601.12, J603.12
/F429Discovery connection/PC15: J601.10, J603.10
/F429Discovery connection/PD0: J601.42, J603.42
/F429Discovery connection/PD1: J601.41, J603.41
/F429Discovery connection/PD2: J601.40, J603.40
/F429Discovery connection/PD4: J601.38, J603.38
/F429Discovery connection/PD5: J601.37, J603.37
/F429Discovery connection/PD6: J601.36, J603.36
/F429Discovery connection/PD7: J601.35, J603.35
/F429Discovery connection/PD8: J602.54, J604.54
/F429Discovery connection/PD9: J602.53, J604.53
/F429Discovery connection/PD10: J602.56, J604.56
/F429Discovery connection/PD11: J602.55, J604.55
/F429Discovery connection/PD12: J602.58, J604.58
/F429Discovery connection/PD13: J602.57, J604.57
/F429Discovery connection/PD14: J602.60, J604.60
/F429Discovery connection/PD15: J602.59, J604.59
/F429Discovery connection/PE0: J601.17, J603.17
/F429Discovery connection/PE1: J601.18, J603.18
/F429Discovery connection/PE2: J601.15, J603.15
/F429Discovery connection/PE3: J601.16, J603.16
/F429Discovery connection/PE4: J601.13, J603.13
/F429Discovery connection/PE15: J602.45, J604.45
/F429Discovery connection/PF0: J601.7, J603.7
/F429Discovery connection/PF1: J601.8, J603.8
/F429Discovery connection/PF10: J602.7, J604.7
/F429Discovery connection/PF11: J602.32, J604.32
/F429Discovery connection/PF12: J602.31, J604.31
/F429Discovery connection/PF13: J602.34, J604.34
/F429Discovery connection/PF14: J602.33, J604.33
/F429Discovery connection/PF15: J602.36, J604.36
/F429Discovery connection/PG0: J602.35, J604.35
/F429Discovery connection/PG1: J602.38, J604.38
/F429Discovery connection/PG2: J602.62, J604.62
/F429Discovery connection/PG3: J602.61, J604.61
/F429Discovery connection/PG4: J601.62, J603.62
/F429Discovery connection/PG5: J601.61, J603.61
/F429Discovery connection/PG6: J601.60, J603.60
/F429Discovery connection/PG7: J601.59, J603.59
/F429Discovery connection/PG9: J601.33, J603.33
/F429Discovery connection/PG10: J601.34, J603.34
/F429Discovery connection/PG11: J601.31, J603.31
/F429Discovery connection/PG12: J601.32, J603.32
/F429Discovery connection/PG13: J601.29, J603.29
/F429Discovery connection/PG14: J601.30, J603.30
/F429Discovery connection/PG15: J601.27, J603.27
/F429Discovery connection/PH0: J602.10, J604.10
/F429Discovery connection/PH1: J602.9, J604.9
AUX_BOOT0: J601.6, J603.6; also elsewhere on the board
DBGUART_RX: J601.39, J603.39; also elsewhere on the board
DBGUART_TX: J601.43, J603.43; also elsewhere on the board
DISP_D~Cn~: J601.4, J603.4; also elsewhere on the board
DISP_FLASH_MISO: J602.5, J604.5; also elsewhere on the board
DISP_FLASH_MOSI: J602.8, J604.8; also elsewhere on the board
DISP_FLASH_SCK: J602.6, J604.6; also elsewhere on the board
FAN1_PWM: J601.11, J603.11; also elsewhere on the board
FAN1_RPM: J602.21, J604.21; also elsewhere on the board
FP_ENC2_A: J601.25, J603.25; also elsewhere on the board
FP_ENC2_B: J601.26, J603.26; also elsewhere on the board
FP_ENC_A: J601.23, J603.23; also elsewhere on the board
FP_ENC_B: J601.24, J603.24; also elsewhere on the board
HWID_FP: J602.14, J604.14; also elsewhere on the board
HWID_MB: J602.15, J604.15; also elsewhere on the board
I2C1_SCL: J601.53, J603.53; also elsewhere on the board
I2C1_SDA: J601.54, J603.54; also elsewhere on the board
unnamed: J601.22, JP603.1
unnamed: J602.1, JP601.2
unnamed: J602.2, JP602.1
unnamed: J603.22, JP606.1
unnamed: J604.1, JP604.2
unnamed: J604.2, JP605.1
PWRBTN_LED_PWM: J601.14, J603.14; also elsewhere on the board
VDD: JP601.1, JP602.2, JP603.2, JP604.1, JP605.2, JP606.2; also elsewhere on the board
VMAIN: J601.1, J601.2, J603.1, J603.2; also elsewhere on the board
~AUX_INTn~: J602.39, J604.39; also elsewhere on the board
~DISP_CSn~: J602.3, J604.3; also elsewhere on the board
~FLASH_CSn~: J601.3, J603.3; also elsewhere on the board
~FP_BTN_1An~: J602.42, J604.42; also elsewhere on the board
~FP_BTN_1Bn~: J602.41, J604.41; also elsewhere on the board
~FP_BTN_2An~: J602.44, J604.44; also elsewhere on the board
~FP_BTN_2Bn~: J602.43, J604.43; also elsewhere on the board
~FP_ENC2_SWn~: J601.58, J603.58; also elsewhere on the board
~FP_ENC_SWn~: J602.46, J604.46; also elsewhere on the board
~RSTn~: J602.12, J604.12; also elsewhere on the board
~RTC_INTn~_SQW: J601.28, J603.28; also elsewhere on the board
~SYS_RSTn~: J601.5, J603.5; also elsewhere on the board

Notes on the sheet:
TIM4_CH2
TIM4_CH1
TIM3_CH1
TIM3_CH2
UART5
TIM9_CH1
BOOT1 / PB2
(I2C3)
TIM2_CH2
TIM9_CH2
