mjohansson/SolderingStation/hw/frontpanel_dev_adapter/frontpanel_dev_adapter.kicad_pcb

## KiCad design hw/frontpanel_dev_adapter/frontpanel_dev_adapter.kicad_pcb (continued)

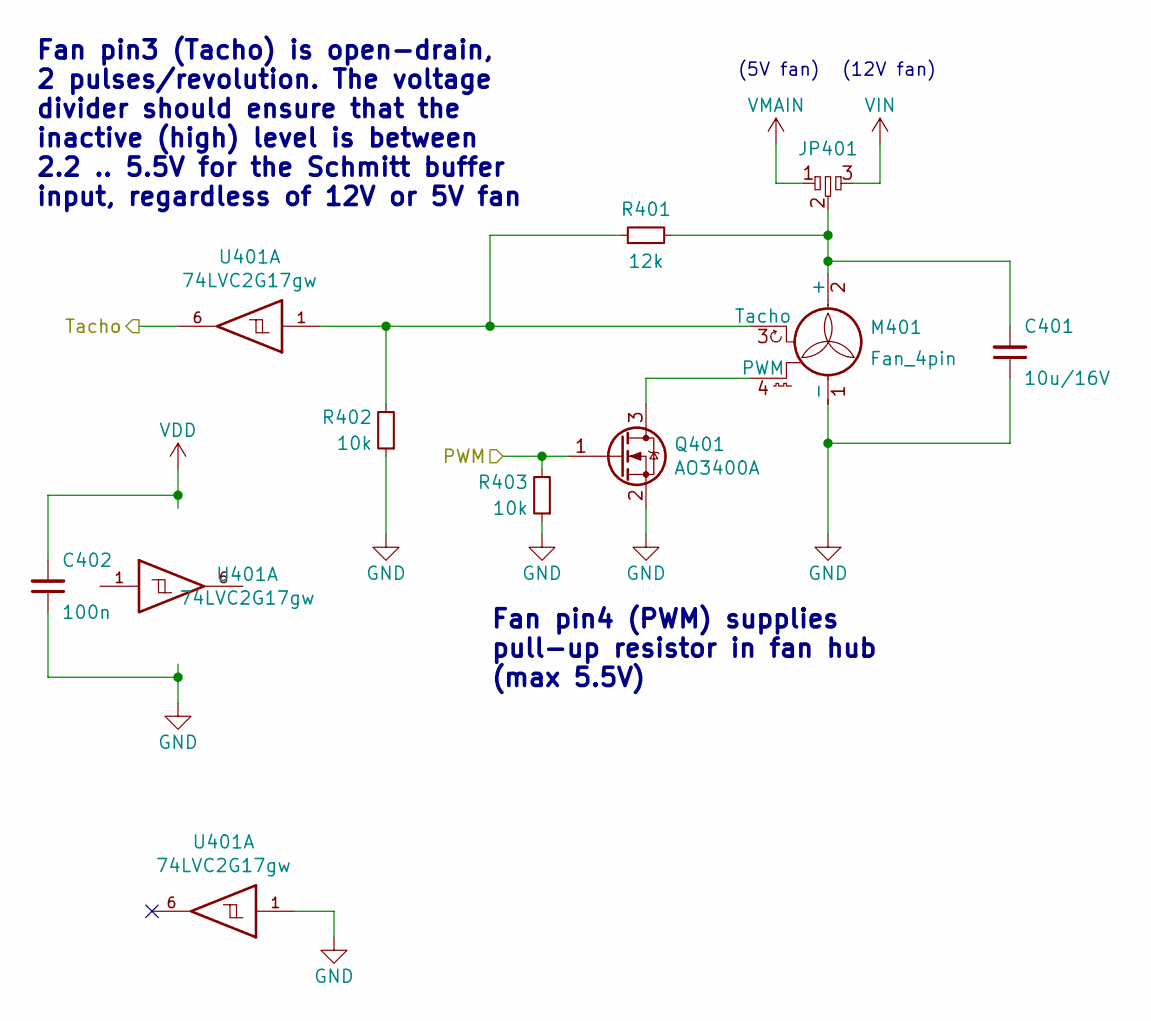
[picture p227: schematic fan_ctrl.kicad_sch, Fan controller]

Parts:
C401: 10u/16V; C_0805_2012Metric; LCSC C15850
C402: 100n; C_0402_1005Metric; LCSC C1525
JP401: dogbone_3_ud; db3_ud_0603
M401: Fan_4pin; FanPinHeader_1x04_P2.54mm_Vertical
Q401: AO3400A; SOT-23; LCSC C20917
R401: 12k; R_0402_1005Metric; LCSC C25752
R402, R403: 10k; R_0402_1005Metric; LCSC C25744
U401: 74LVC2G17gw; SOT-363_SC-70-6; LCSC (DNM) C80500

Connections:
FAN1_PWM: Q401.1 (G), R403.2; also elsewhere on the board
FAN1_RPM: U401.6; also elsewhere on the board
unnamed: C401.2, JP401.2, M401.2 (+), R401.2
unnamed: M401.4 (PWM), Q401.3 (D)
VDD: C402.2, U401.5 (VCC); also elsewhere on the board
VIN: JP401.3; also elsewhere on the board
VMAIN: JP401.1; also elsewhere on the board

Notes on the sheet:
Fan pin4 (PWM) supplies pull-up resistor in fan hub (max 5.5V)
(5V fan)
(12V fan)
Fan pin3 (Tacho) is open-drain, 2 pulses/revolution. The voltage divider should ensure that the inactive (high) level is between 2.2 .. 5.5V for the Schmitt buffer input, regardless of 12V or 5V fan

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
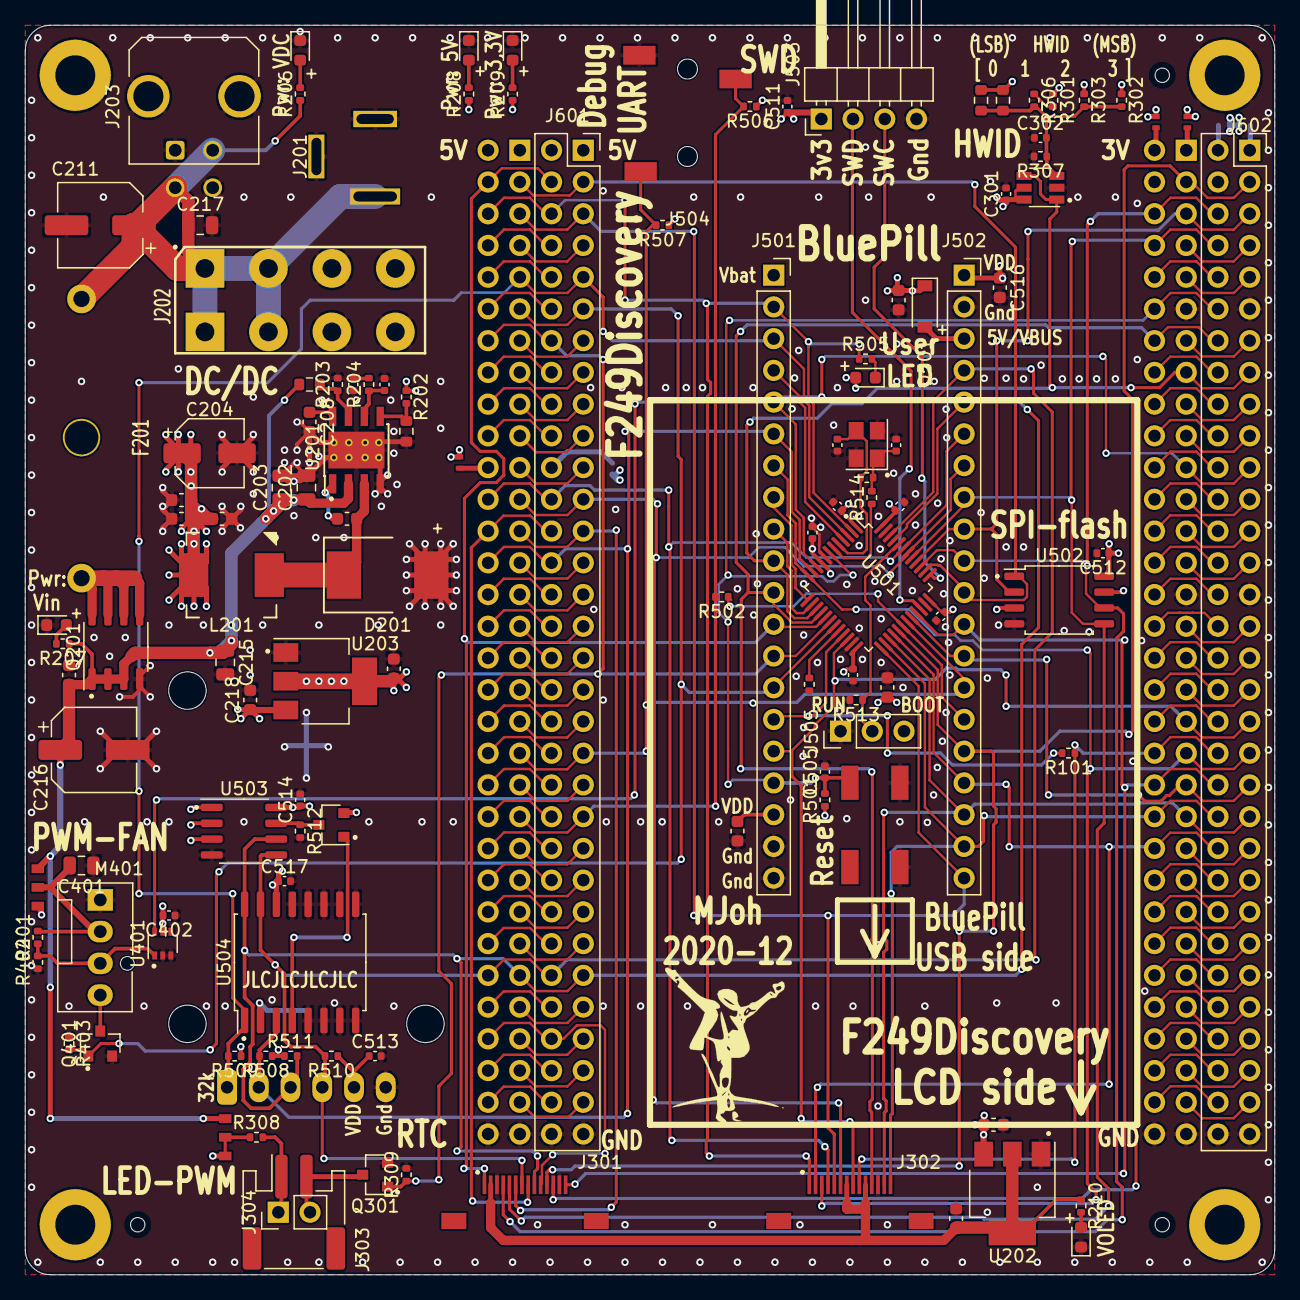
[picture p228: board frontpanel_dev_adapter.kicad_pcb from above]

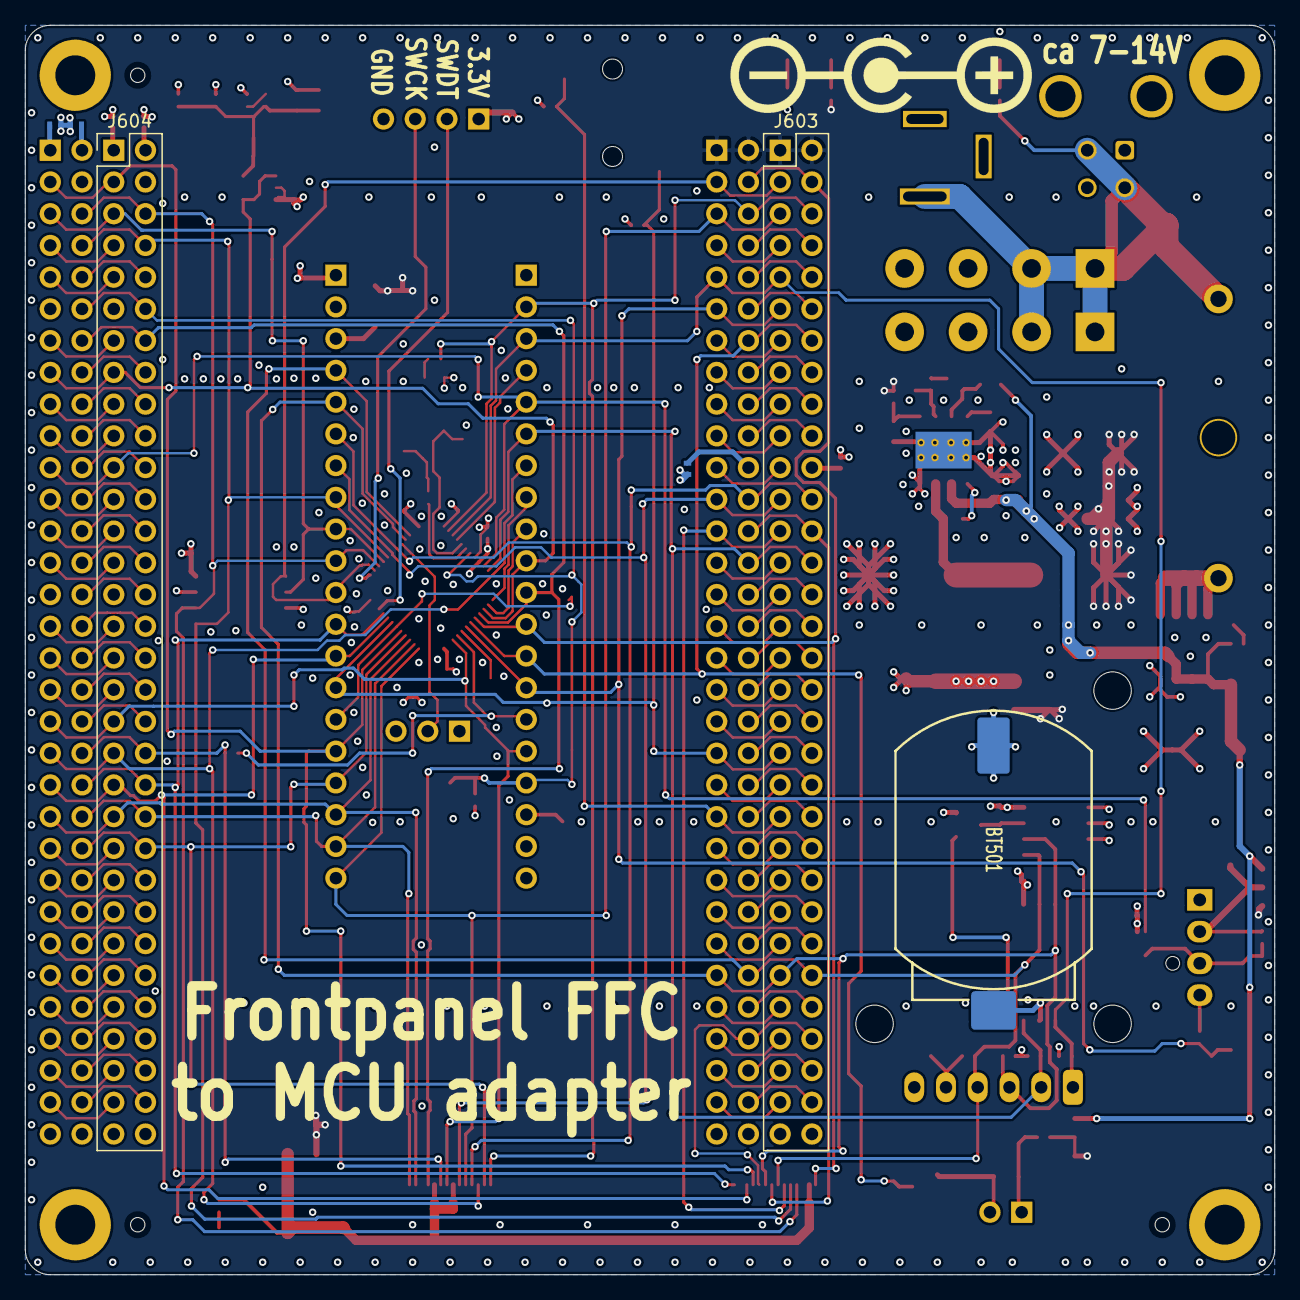
[picture p229: board frontpanel_dev_adapter.kicad_pcb from below]

Board: 4 copper layers, 100.0 x 100.0 mm, 137 parts (6 on the bottom side), 165 nets.
