mjohansson/SolderingStation/hw/ds3231_RTC_module/ds3231_RTC_module.kicad_pcb

## KiCad design hw/ds3231_RTC_module/ds3231_RTC_module.kicad_pcb (2020-11-24)

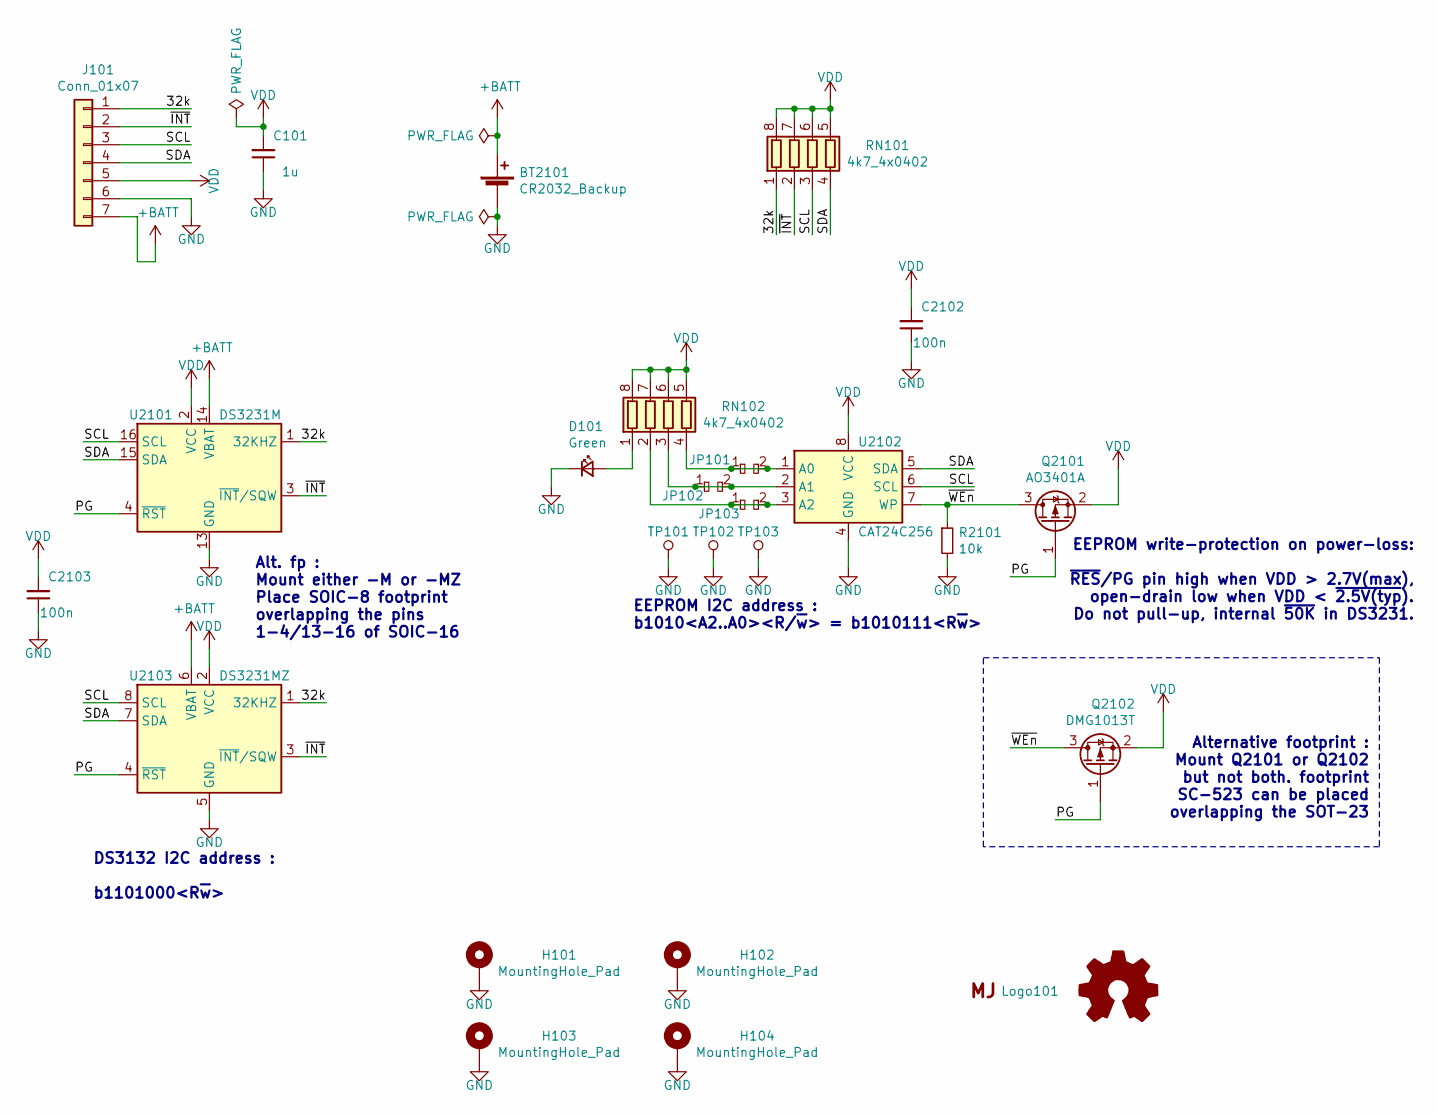
[picture p230: schematic ds3231_RTC_module.sch, RTC Module]

Parts:
BT2101: CR2032_Backup; CR2032_coincell_holder
C101: 1u; C_0603_1608Metric
C2102, C2103: 100n; C_0402_1005Metric
D101: Green; LED_0402_1005Metric
H101, H102, H103, H104: MountingHole_Pad; MountingHole_3.2mm_M3_DIN965_Pad
J101: Conn_01x07; PinHeader_1x07_P2.54mm_Vertical
JP101, JP102, JP103: dogbone_2_ud; db2_ud_0402
LOGO101: Logo_Open_Hardware_Small; OSHW-Logo2_7.3x6mm_SilkScreen
Logo101: Logo_MJ; MJ_Mini
Q2101: AO3401A; SOT-23
Q2102: DMG1013T; SOT-523
R2101: 10k; R_0402_1005Metric
RN101, RN102: 4k7_4x0402; R_Array_Convex_4x0402
TP101, TP102, TP103: TP; TP_SMD_1.2c
U2101: DS3231M; SOIC-16W_7.5x10.3mm_P1.27mm
U2102: CAT24C256; SO-8_3.9x4.9mm_P1.27mm
U2103: DS3231MZ; SOIC-8_3.9x4.9mm_P1.27mm

Connections:
+BATT: BT2101.1 (+), J101.7, U2101.14 (VBAT), U2103.6 (VBAT)
/32k: J101.1, RN101.1 (R1.1), U2101.1 (32KHZ), U2103.1 (32KHZ)
/PG: Q2101.1 (G), Q2102.1 (G), U2101.4 (~RST), U2103.4 (~RST)
/SCL: J101.3, RN101.3 (R3.1), U2101.16 (SCL), U2102.6 (SCL), U2103.8 (SCL)
/SDA: J101.4, RN101.4 (R4.1), U2101.15 (SDA), U2102.5 (SDA), U2103.7 (SDA)
/~INT~: J101.2, RN101.2 (R2.1), U2101.3 (~INT~/SQW), U2103.3 (~INT~/SQW)
/~WEn~: Q2101.3 (D), Q2102.3 (D), R2101.1, U2102.7 (WP)
GND: BT2101.2 (-), C101.1, C2102.1, C2103.1, D101.1 (K), H101.1, H102.1, H103.1, H104.1, J101.6, R2101.2, TP101.1, TP102.1, TP103.1, U2101.5 (GND), U2101.6 (GND), U2101.7 (GND), U2101.8 (GND), U2101.9 (GND), U2101.10 (GND), U2101.11 (GND), U2101.12 (GND), U2101.13 (GND), U2102.4 (GND), U2103.5 (GND)
unnamed: D101.2 (A), RN102.1 (R1.1)
unnamed: JP101.1, JP101.2, RN102.4 (R4.1), U2102.1 (A0)
unnamed: JP102.1, JP102.2, RN102.3 (R3.1), U2102.2 (A1)
unnamed: JP103.1, JP103.2, RN102.2 (R2.1), U2102.3 (A2)
VDD: C101.2, C2102.2, C2103.2, J101.5, Q2101.2 (S), Q2102.2 (S), RN101.5 (R4.2), RN101.6 (R3.2), RN101.7 (R2.2), RN101.8 (R1.2), RN102.5 (R4.2), RN102.6 (R3.2), RN102.7 (R2.2), RN102.8 (R1.2), U2101.2 (VCC), U2102.8 (VCC), U2103.2 (VCC)

Notes on the sheet:
Alt. fp : Mount either -M or -MZ Place SOIC-8 footprint overlapping the pins 1-4/13-16 of SOIC-16
EEPROM write-protection on power-loss: ~RES~/PG pin high when VDD > 2.7V(max), open-drain low when VDD < ~2.5V(typ). Do not pull-up, internal ~50K in DS3231.
EEPROM I2C address : b1010<A2..A0><R/~w~> = b1010111<R~w~>
DS3132 I2C address : b1101000<R~w~>
Alternative footprint : Mount Q2101 or Q2102 but not both. footprint SC-523 can be placed overlapping the SOT-23

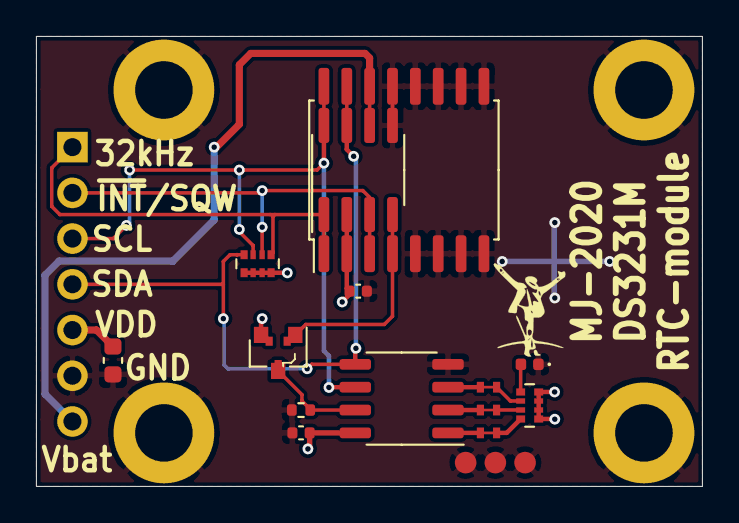
[picture p231: board ds3231_RTC_module.kicad_pcb from above]

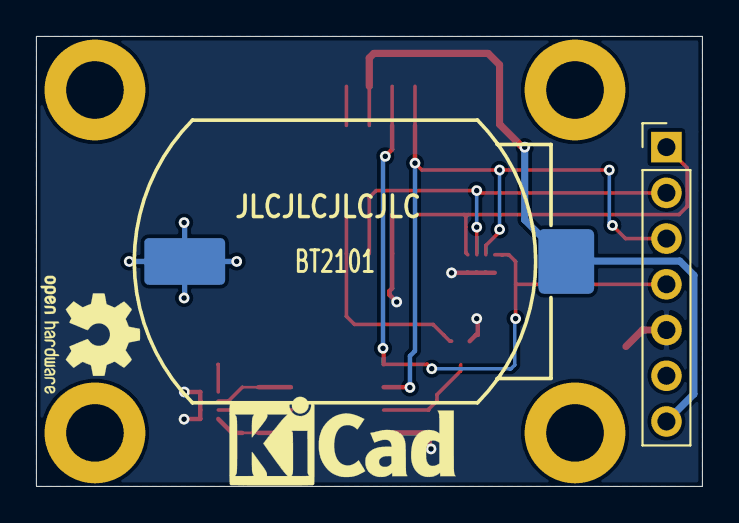
[picture p232: board ds3231_RTC_module.kicad_pcb from below]

Board: 2 copper layers, 37.0 x 25.0 mm, 26 parts (3 on the bottom side), 13 nets.
