mjohansson/SolderingStation/hw/solderstn_mb/solderstn_mb_alt2.kicad_pcb

## KiCad design hw/solderstn_mb/solderstn_mb_alt2.kicad_pcb (2020-10-24)

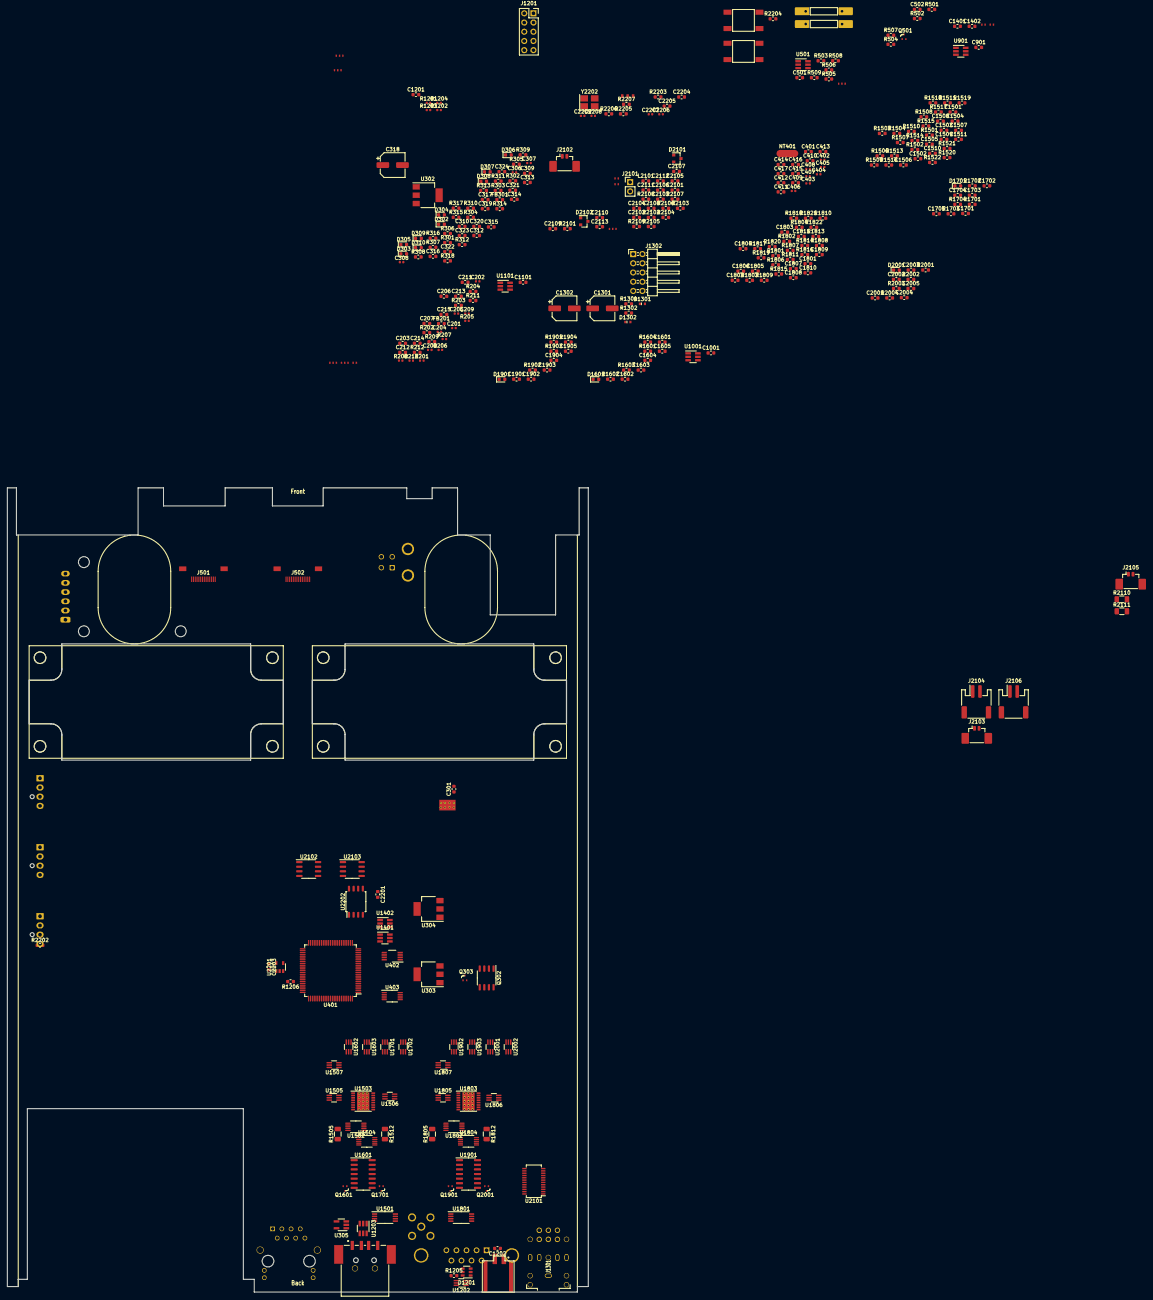
[picture p233: board solderstn_mb_alt2.kicad_pcb from above]

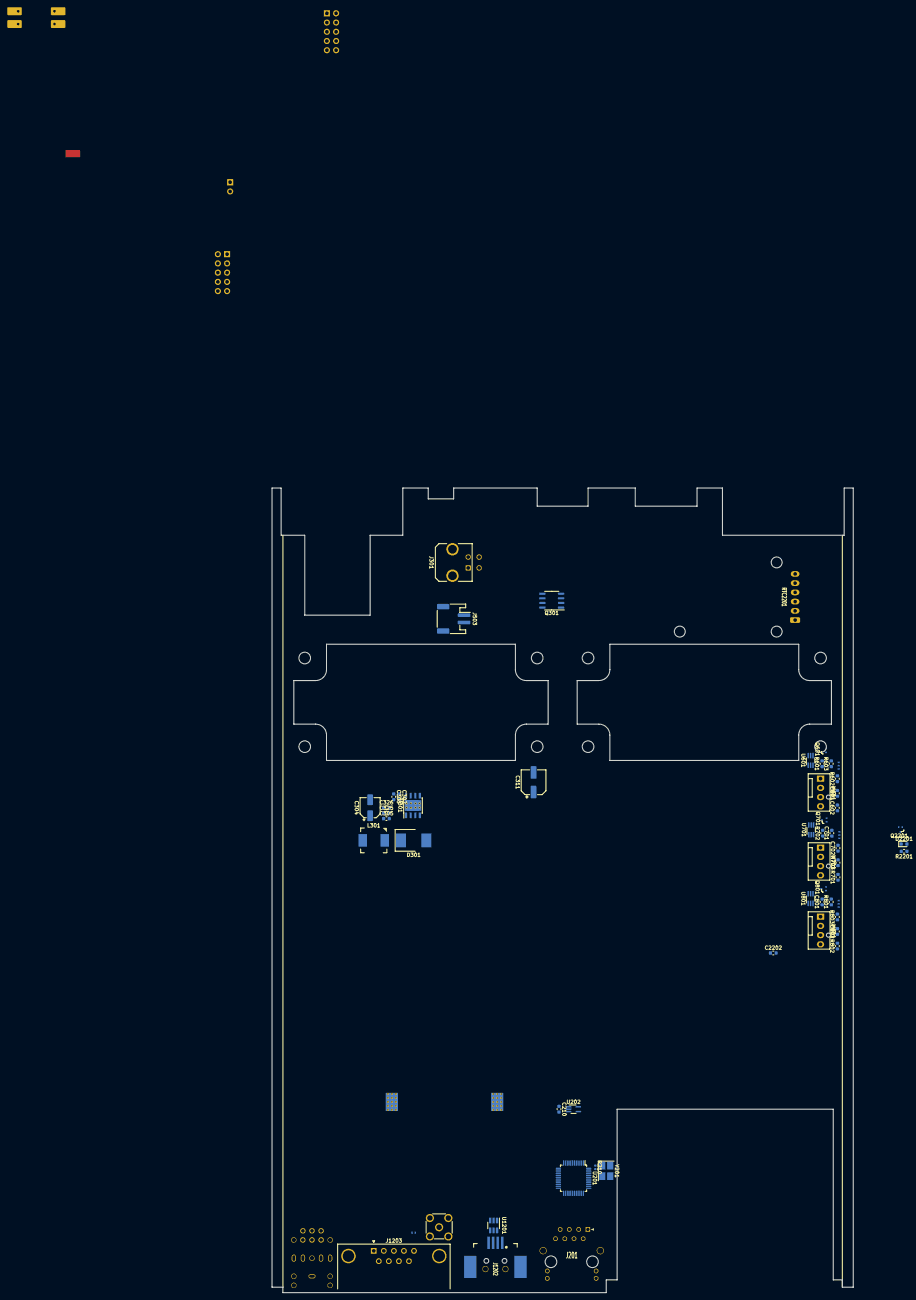
[picture p234: board solderstn_mb_alt2.kicad_pcb from below]

Board: 4 copper layers, 160.0 x 221.5 mm, 411 parts (56 on the bottom side), 267 nets, no tracks yet.

Parts:
C201, C202, C204, C205: DNP; C_0402_1005Metric
C203, C206, C207, C210, C211, C213, C215, C301, C309, C317, C321, C411, C416, C417, C501, C502, C602, C702, C802, C901, C1001, C1101, C1201, C1202, C1401, C1402, C1509, C1510, C1511, C1601, C1603, C1604, C1605, C1701, C1703, C1704, C1705, C1809, C1810, C1811, C1901, C1903, C1904, C1905, C2001, C2003, C2004, C2005, C2101, C2107, C2111, C2201, C2202, C2203, C2204, C2205: 100n; C_0603_1608Metric
C208, C209: 27p; C_0402_1005Metric
C212, C214, C302, C303, C305, C312, C313, C319, C320, C322, C323, C324, C325, C326, C401: 10u; C_0603_1608Metric
C304: APXG160ARA101ME61G; CP_Elec_5x5.8
C306: 15n; C_0402_1005Metric
C307: 10pF; C_0402_1005Metric
C308: 3n9; C_0402_1005Metric
C310, C314, C315, C601, C701, C801: 10u/16V; C_0603_1608Metric
C311, C318: UCL1V470MCL1GS; CP_Elec_6.3x5.8
C316, C412, C413, C415, C1508, C1808: 1u; C_0603_1608Metric
C402, C403, C404, C405, C406, C407, C408: 100n; C_0402_1005Metric
C409, C410, C2106, C2109, C2110, C2113: 2u2; C_0603_1608Metric
C414: 22u; C_0603_1608Metric
C1301, C1302: 47u/10V; CP_Elec_6.3x5.8
C1501, C1505, C1507, C1801, C1805, C1807: 10n; C_0603_1608Metric
C1502, C1802: 4n7; C_0603_1608Metric
C1503, C1504, C1506, C1803, C1804, C1806: 220n; C_0603_1608Metric
C1602, C1702, C1902, C2002: 1u/10V; C_0603_1608Metric
C2102: 22n; C_0603_1608Metric
C2103: 4p7; C_0603_1608Metric
C2104, C2108, C2112: 470n; C_0603_1608Metric
C2105: 1n; C_0603_1608Metric
C2206, C2207, C2208, C2209: 10p; C_0402_1005Metric
D301: MBRS340T3G; MBRS3xx_SMC_CASE_403AC
D302: Yellow; LED_0603_1608Metric
D303, D304, D305, D306, D307, D308, D309: Green; LED_0603_1608Metric
D310, D1601, D1701, D1901, D2001: Red; LED_0603_1608Metric
D1201: SP0505BAHT; SOT-23-6
D1301, D1302: SLESD5Z5V; D_SOD-523
D2101, D2102: CM1213A-01SO; SOT-23
D2201: LED_gr; LED_0603_1608Metric
FB201, FB301: 60R@100M; L_0603_1608Metric
J201: 74980104400; 74980104400_WE-RJ45_LAN_trx
J301: Molex_MicroFit_30-43045-0421; Molex_Micro-Fit_3.0_43045-0421_2x02-1MP_P3.00mm_Horizontal
J501, J502: FFC_conn_14p; FPC_14p_05mm-Molex_5052781433
J503: JST_S2B-PH-SM4-TB; JST_PH_S2B-PH-SM4-TB_1x02-1MP_P2.00mm_Horizontal
J1201: Conn_02x05_Odd_Even; PinSocket_2x05_P2.54mm_Vertical
J1202: USB_B-TE_1734346-1; TE_1734346
J1203: DB9_Male_MountingHoles; DSub9-Kycon_K22X-EP9P-N
J1204: USB_A-CUI-UJ2-AH-1-SMT; CUI-UJ2_AH_1_SMT
J1205: Molex_NanoFit-1x02; Molex_NanoFit_105430-1102_1x02_P2.50mm_Horizontal
J1301: SJ-3571N
J1302: Conn_02x05_Odd_Even; PinHeader_2x05_P2.54mm_Horizontal
J2101: Conn_01x02; PinHeader_1x02_P2.54mm_Vertical
J2102: Molex_PicoBlade-53398-0271; Molex_PicoBlade_53398-0271_1x02-1MP_P1.25mm_Vertical
J2103, J2105: CES-30207-158L120-67_Molex-PicoBlade_conn; Molex_PicoBlade_53398-0271_1x02-1MP_P1.25mm_Vertical
J2104, J2106: CES-703116-28PM_JST-conn; JST_PH_S2B-PH-SM4-TB_1x02-1MP_P2.00mm_Horizontal
J2107: Conn_Coaxial; SMA_Molex_73251-2200_Horizontal
JP201, JP1401, JP1402, JP2102, JP2103, JP2106: dogbone_2_ud; db2_ud_0402
JP202, JP203, JP501, JP601, JP701, JP801, JP2101, JP2104, JP2105: dogbone_3_ud; db3_ud_0402
JP2201: dogbone_3_ud; db3_ud_0603
L301: ASPI-0630LR-3R3M-T15; ASPI-0603LR
L2101: 56nH(LQW18AN56NJ00D); L_0603_1608Metric
LS2101, LS2103: CES-30207-158L120-67; CUI_CES-30207
LS2102, LS2104: CES-703116-28PM; CUI_CES-703116-28PM
M501, M502: FFC_retention_clamp; FFC_retention_clamp_14pin_7_5mm
M601, M701, M801: Fan_4pin; FanPinHeader_1x04_P2.54mm_Vertical
NT401: Net-Tie_2; NetTie-2_SMD_Pad2.0mm
Q301, Q302: Si4497DY; SOIC-8_3.9x4.9mm_P1.27mm
Q303, Q501, Q601, Q701, Q801, Q2201: DMG1012T; SOT-523
Q1601, Q1701, Q1901, Q2001: DMG1013T; SOT-523
R201, R205, R206, R207, R208: 5k1; R_0402_1005Metric
R202, R203: 330; R_0603_1608Metric
R204, R211, R212, R302, R304, R307, R308, R309, R502, R509, R602, R603, R702, R703, R802, R803, R1503, R1508, R1509, R1510, R1518, R1519, R1520, R1521, R1522, R1603, R1703, R1803, R1808, R1809, R1810, R1818, R1819, R1820, R1821, R1822, R1903, R2003, R2106, R2109, R2203, R2206: 10k; R_0603_1608Metric
R209, R508, R2207: 0R; R_0603_1608Metric
R210: 0R; R_0402_1005Metric
R213: 6.19k; R_0402_1005Metric
R301: 390k; R_0603_1608Metric
R303: 68k; R_0603_1608Metric
R305: 1k8; R_0603_1608Metric
R306, R312, R313, R314, R1501, R1502, R1504, R1506, R1511, R1514, R1516, R1604, R1704, R1801, R1802, R1804, R1806, R1811, R1814, R1816, R1904, R2004, R2102, R2103, R2201, R2202: 1k; R_0603_1608Metric
R310, R311, R2204, R2205: 4k7; R_0603_1608Metric
R315, R316, R317: 100R; R_0603_1608Metric
R318: 470R; R_0603_1608Metric
R501, R503, R506: 20k; R_0603_1608Metric
R504, R505: 160k; R_0603_1608Metric
R507: 27k; R_0603_1608Metric
R601, R701, R801: 12k; R_0603_1608Metric
R1201, R1202, R1203, R1204: 1k; R_0402_1005Metric
R1205, R1206, R1301, R1302: 100; R_0603_1608Metric
R1505, R1512, R1805, R1812: 10mR; R_1206_3216Metric
R1507, R1517, R1807, R1817: 330k; R_0603_1608Metric
R1513, R1515, R1813, R1815: 5k6; R_0603_1608Metric
R1601, R1602, R1701, R1702, R1901, R1902, R2001, R2002, R2104, R2107: 15k; R_0603_1608Metric
R2101: 560; R_0603_1608Metric
R2105, R2108: 2k2; R_0603_1608Metric
R2110, R2111: 0R; R_1206_3216Metric
RTC2201: DS3231_Module_6pins; DS3231_module_6pin_horizontal_mnt
SW2201, SW2202: Pushbutton_SMD_TS-1102W-4316; SMD_PUSHBTN_6x6mm
U201: IP101GA; LQFP-48_7x7mm_P0.5mm
U202: 74LVC1G126SE; SOT-353_SC-70-5_Handsoldering
U301: TPS54332DDA; TI_SO-PowerPAD-8_ThermalVias
U302, U303, U304: TLV1117LV30DCY; SOT-223-3_TabPin2
U305: AP22811AW5; SOT-23-5_HandSoldering
U401: STM32F429VITx; LQFP-100_14x14mm_P0.5mm
U402: REF6125IDGK; VSSOP-8_3.0x3.0mm_P0.65mm
U403: TLV9052SIDGS; VSSOP-10_3x3mm_P0.5mm
U501: TLV9051SIDBV; SOT-23-6_Handsoldering
U601, U701, U801, U1202: 74LVC2G17gw; SOT-363_SC-70-6_Handsoldering
U901, U1001, U1101: TMP100; SOT-23-6_Handsoldering
U1201, U1203: USBLC6-2SC6; SOT-23-6_Handsoldering
U1401, U1402: TMUX1219; SOT-23-6_Handsoldering
U1501, U1801: AD8552ARU; TSSOP-8_4.4x3mm_P0.65mm
U1502, U1504, U1802, U1804: INA226; VSSOP-10_3x3mm_P0.5mm
U1503, U1803: TPS2HB16AQ1; HTSSOP-16-1EP_4.4x5mm_P0.65mm_EP3.4x5mm_Mask3x3mm_ThermalVi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
U1505, U1506, U1507, U1603, U1702, U1805, U1806, U1807, U1903, U2002: 74LVC1G11dck; SOT-363_SC-70-6_Handsoldering
U1601, U1901: NE556d; SOIC-14_3.9x8.7mm_P1.27mm
U1602, U1701, U1902, U2001: 74LVC1G175dck; SOT-363_SC-70-6_Handsoldering
U2101: Si4735-D60-GU; SSOP-24_3.9x8.7mm_P0.635mm
U2102, U2103: TS4990IDT; SOIC-8_3.9x4.9mm_P1.27mm
U2201: MCP1316T-26LE-OT; SOT-23-5
U2202: W25Q64FV; SOIC-8_5.275x5.275mm_P1.27mm
Y201: TSX-3225 25.0000MF10P-C; Crystal_SMD_SeikoEpson_TSX3225-4Pin_3.2x2.5mm_HandSoldering
Y2202: TSX-3225 16.0000MF18X-AC3; Crystal_SMD_SeikoEpson_TSX3225-4Pin_3.2x2.5mm_HandSoldering

Connections:
+12V: C315.1, C1502.2, C1503.2, C1802.2, C1803.2, Q302.5, Q302.6, Q302.7, Q302.8, R311.1, R1513.1, R1515.2, R1813.1, R1815.2, U1502.8, U1503.17, U1504.8, U1802.8, U1803.17, U1804.8
+VDC: J301.2, J301.3, Q301.5, Q301.6, Q301.7, Q301.8
/Audio & FM-radio/Audio_L_int: J1201.2, R2111.1
/Audio & FM-radio/Audio_R_int: J1201.6, R2110.1
/Audio & FM-radio/FMI: C2105.1, D2102.1, J2102.1, JP2106.1
/Ethernet/50M_CLKO: U201.16, U202.2
/Ethernet/LED0_LINK: J201.11, R208.2, U201.9
/Ethernet/LED1_DUPLEX: R207.2, U201.10
/Ethernet/LED2_10M_LINK_ACT: J201.10, JP201.1, JP201.2, R206.2, U201.12
/Ethernet/LED3_100M_LINK_ACT: R202.2, R205.2, U201.13
/Ethernet/RMII: R211.1, U201.1
/Ethernet/RXN: C205.1, J201.6, U201.30
/Ethernet/RXP: C204.1, J201.3, U201.31
/Ethernet/TXN: C202.1, J201.2, U201.33
/Ethernet/TXP: C201.1, J201.1, U201.34
/Rear panel connections/Audio_L: J1201.1, U2103.8
/Rear panel connections/Audio_R: J1201.5, U2102.8
/Rear panel connections/CH_A_HEATER_1: R1505.1, R1601.1, U1502.10
/Rear panel connections/CH_A_HEATER_2: R1512.1, R1701.1, U1504.10
/Rear panel connections/CH_A_TC1: R1501.2, R1502.2, R1504.1
/Rear panel connections/CH_B_HEATER_1: R1805.1, R1901.1, U1802.10
/Rear panel connections/CH_B_HEATER_2: R1812.1, R2001.1, U1804.10
/Rear panel connections/CH_B_TC1: R1801.2, R1802.2, R1804.1
/Rear panel connections/Headphone connector asm/Audio_L_ch: J1301.8, J1302.1, R1202.2
/Rear panel connections/Headphone connector asm/Audio_R_ch: J1301.5, J1302.5, R1201.2
/Rear panel connections/Headphone connector asm/Audio_int_L: J1301.7, J1302.2, R1203.2
/Rear panel connections/Headphone connector asm/Audio_int_R: J1301.4, J1302.6, R1204.2
/Rear panel connections/Headphone connector asm/L_ch_out: D1301.1, J1301.2, R1302.1
/Rear panel connections/Headphone connector asm/R_ch_out: D1302.1, J1301.3, R1301.1
/STM32F429 MCU/32kHz: JP2201.1, R2202.1, RTC2201.1
/STM32F429 MCU/AUX_HOST_RX: J502.8, U401.97
/STM32F429 MCU/AUX_HOST_TX: J502.9, U401.98
/STM32F429 MCU/CH_A_KTY_REED_BIAS_EN: U401.61, U403.5
/STM32F429 MCU/CH_B_KTY_REED_BIAS_EN: U401.62, U403.6
/STM32F429 MCU/DLED_WDT: Q2201.1, U401.7, U2201.4
/STM32F429 MCU/Flash_MISO: U401.44, U2202.2
/STM32F429 MCU/~Flash_CSn~: U401.41, U2202.1
/STM32F429 MCU/~RTC_INTn~: RTC2201.2, U401.47
/STM32F429 PWR/Vref_2v5: C414.1, C415.1, C416.1, U401.21, U402.5, U402.6, U403.3, U403.7
/Weller contol/CH_A_KTY_REED_BIAS: R1501.1, R1511.1, U403.1, U403.2
/Weller contol/CH_B_KTY_REED_BIAS: R1801.1, R1811.1, U403.8, U403.9
/Weller contol/Channel A/HT1_EN: U1503.4, U1505.4
/Weller contol/Channel A/HT2_EN: U1503.13, U1506.4
/Weller contol/Channel A/PWM error detector 1/~CLR_FLAG~: U1602.6, U1603.4
/Weller contol/Channel A/PWM error detector 1/~PULSE_ERR~: U1601.5, U1603.6
/Weller contol/Channel A/PWM error detector 1/~PULSEn_D~: Q1601.1, R1601.2, R1603.1, U1601.6
/Weller contol/Channel A/PWM error detector 2/~CLR_FLAG~: U1701.6, U1702.4
/Weller contol/Channel A/PWM error detector 2/~PULSE_ERR~: U1601.9, U1702.6
/Weller contol/Channel A/PWM error detector 2/~PULSEn_D~: Q1701.1, R1701.2, R1703.1, U1601.8
/Weller contol/Channel A/PWM_OK_1: D1601.1, U1505.3, U1507.6, U1602.4
/Weller contol/Channel A/PWM_OK_2: D1701.1, U1506.3, U1507.3, U1701.4
/Weller contol/Channel A/Vout1: C1504.2, R1505.2, U1502.9, U1503.6, U1503.7, U1503.8
/Weller contol/Channel A/Vout2: C1506.2, R1512.2, U1503.9, U1503.10, U1503.11, U1504.9
/Weller contol/Channel A/~OC_ERR_1~: R1503.2, U1502.3, U1603.1
/Weller contol/Channel A/~OC_ERR_2~: R1519.2, U1504.3, U1702.1
/Weller contol/Channel B/HT1_EN: U1803.4, U1805.4
/Weller contol/Channel B/HT2_EN: U1803.13, U1806.4
/Weller contol/Channel B/PWM error detector 1/~CLR_FLAG~: U1902.6, U1903.4
/Weller contol/Channel B/PWM error detector 1/~PULSE_ERR~: U1901.5, U1903.6
/Weller contol/Channel B/PWM error detector 1/~PULSEn_D~: Q1901.1, R1901.2, R1903.1, U1901.6
/Weller contol/Channel B/PWM error detector 2/~CLR_FLAG~: U2001.6, U2002.4
/Weller contol/Channel B/PWM error detector 2/~PULSE_ERR~: U1901.9, U2002.6
/Weller contol/Channel B/PWM error detector 2/~PULSEn_D~: Q2001.1, R2001.2, R2003.1, U1901.8
/Weller contol/Channel B/PWM_OK_1: D1901.1, U1805.3, U1807.6, U1902.4
/Weller contol/Channel B/PWM_OK_2: D2001.1, U1806.3, U1807.3, U2001.4
/Weller contol/Channel B/Vout1: C1804.2, R1805.2, U1802.9, U1803.6, U1803.7, U1803.8
/Weller contol/Channel B/Vout2: C1806.2, R1812.2, U1803.9, U1803.10, U1803.11, U1804.9
/Weller contol/Channel B/~OC_ERR_1~: R1803.2, U1802.3, U1903.1
/Weller contol/Channel B/~OC_ERR_2~: R1819.2, U1804.3, U2002.1
/Weller contol/HWID_ADC_SEL: U401.2, U1401.1, U1402.1
AUX_BOOT0: J502.1, U401.1
CH_A_DRV_OK: U401.87, U1507.4
CH_A_FET1_PWM: R1520.1, U401.63, U1505.6
CH_A_FET2_PWM: R1521.1, U401.64, U1506.6
CH_A_IN_STAND_ADC1: R1504.2, U401.15
CH_A_KTY_HWID_MB_ADC2: JP1401.1, JP1401.2, R1511.2, R1514.2, U401.23, U1401.4, U1401.5
CH_A_TC1_AMP_ADC1: R1507.1, U401.17, U1501.1
CH_A_TC2_AMP_ADC2: R1517.1, U401.18, U1501.7
CH_B_DRV_OK: U401.88, U1807.4
CH_B_FET1_PWM: R1820.1, U401.65, U1805.6
CH_B_FET2_PWM: R1821.1, U401.66, U1806.6
CH_B_IN_STAND_ADC1: R1804.2, U401.31
CH_B_KTY_HWID_FP_ADC2: JP1402.1, JP1402.2, R1811.2, R1814.2, U401.26, U1402.4, U1402.5
CH_B_TC1_AMP_ADC1: R1807.1, U401.35, U1801.1
CH_B_TC2_AMP_ADC2: R1817.1, U401.36, U1801.7
DAC_OUT1: C2112.2, U401.29
DAC_OUT2: C2108.2, U401.30
DBGUART_RX: R1206.1, U401.69
DBGUART_TX: U401.68, U1202.1
DISP_D~Cn~: J501.1, U401.38
DISP_FLASH_MOSI: J501.5, U401.45, U2202.5
DISP_FLASH_SCK: J501.4, U401.43, U2202.6
ETH_MDC: U201.25, U401.16
ETH_MDIO: R201.1, U201.26, U401.25
FAN1_PWM: Q601.1, R603.2, U401.90
FAN1_RPM: U401.4, U601.6
FAN2_PWM: Q701.1, R703.2, U401.91
FAN2_RPM: U401.5, U701.6
FAN3_PWM: Q801.1, R803.2, U401.89
FAN3_RPM: U401.96, U801.6
FM_I2S_CK: R2103.1, U401.78
FM_I2S_SD: R2101.1, U401.80
FM_I2S_WS: C2103.2, R2102.1, U401.77
FP_ENC2_A: J501.6, U401.59
FP_ENC2_B: J501.8, U401.60
FP_ENC_A: J502.6, U401.40
FP_ENC_B: J502.4, U401.42
GND: C201.2, C202.2, C203.2, C204.2, C205.2, C206.2, C207.2, C208.1, C209.1, C210.2, C211.2, C212.2, C213.2, C214.2, C215.2, C302.2, C303.2, C304.2, C305.2, C306.2, C307.2, C308.2, C309.2, C310.2, C311.2, C312.2, C313.2, C314.2, C315.2, C316.2, C317.2, C318.2, C319.2, C320.2, C321.2, C322.2, C323.2, C324.2, C325.2, C326.2, C401.2, C402.2, C403.2, C404.2, C405.2, C406.2, C407.2, C408.2, C409.2, C410.2, C501.2, C502.1, C601.1, C602.1, C701.1, C702.1, C801.1, C802.1, C901.2, C1001.2, C1101.2, C1201.1, C1202.1, C1401.2, C1402.2, C1501.2, C1502.1, C1503.1, C1504.1, C1505.2, C1506.1, C1507.1, C1508.1, C1509.1, C1510.1, C1511.1, C1601.2, C1602.2, C1603.2, C1604.2, C1605.2, C1701.2, C1702.2, C1703.2, C1704.2, C1705.2, C1801.2, C1802.1, C1803.1, C1804.1, C1805.2, C1806.1, C1807.1, C1808.1, C1809.1, C1810.1, C1811.1, C1901.2, C1902.2, C1903.2, C1904.2, C1905.2, C2001.2, C2002.2, C2003.2, C2004.2, C2005.2, C2101.2, C2103.1, C2106.1, C2107.1, C2109.1, C2110.1, C2111.1, C2113.1, C2201.1, C2202.1, C2203.2, C2204.1, C2205.1, C2206.2, C2207.2, C2208.1, C2209.1, D301.2, D302.1, D303.1, D304.1, D305.1, D306.1, D307.1, D308.1, D309.1, D1201.2, D1301.2, D1302.2, D2101.2, D2101.3, D2102.2, D2102.3, J301.1, J301.4, J301.MP, J501.3, J501.13, J502.12, J1201.3, J1201.4, J1201.7, J1201.8, J1202.4, J1202.S1, J1202.S2, J1203.0, J1203.5, J1203.6, J1204.4, J1204.S1, J1204.S2, J1205.1, J1205.S1, J1205.S2, J1301.1, J1302.3, J1302.4, J1302.7, J1302.8, J2101.2, J2102.2, J2107.2, JP202.1, JP202.2, JP203.1, JP203.2, JP2101.1, JP2101.2, JP2102.1, JP2102.2, JP2103.1, JP2103.2, L2101.2, M601.1, M701.1, M801.1, NT401.1, Q301.4, Q303.2, Q501.2, Q601.2, Q701.2, Q801.2, Q1601.3, Q1701.3, Q1901.3, Q2001.3, Q2201.2, R203.1, R205.1, R206.1, R207.1, R208.1, R209.2, R212.2, R213.1, R303.2, R305.2, R307.2, R309.2, R507.2, R509.2, R602.1, R603.1, R702.1, R703.1, R802.1, R803.1, R1201.1, R1202.1, R1203.1, R1204.1, R1506.2, R1508.2, R1509.2, R1510.2, R1516.2, R1518.2, R1520.2, R1521.2, R1522.2, R1603.2, R1703.2, R1806.2, R1808.2, R1809.2, R1810.2, R1816.2, R1818.2, R1820.2, R1821.2, R1822.2, R1903.2, R2003.2, R2203.2, R2206.1, RTC2201.6, SW2201.1, SW2201.2, U201.11, U201.17, U201.27, U201.29, U201.35, U201.45, U202.3, U301.4, U301.9, U302.1, U303.1, U304.1, U305.2, U401.10, U401.27, U401.74, U401.99, U501.2, U601.2, U601.3, U701.2, U701.3, U801.2, U801.3, U901.2, U901.3, U1001.2, U1001.5, U1101.2, U1201.2, U1202.2, U1203.2, U1401.3, U1402.3, U1501.4, U1502.1, U1502.2, U1502.7, U1503.1, U1504.1, U1504.7, U1505.2, U1506.2, U1507.2, U1601.7, U1602.2, U1603.2, U1701.2, U1702.2, U1801.4, U1802.2, U1802.7, U1803.1, U1804.7, U1805.2, U1806.2, U1807.2, U1901.7, U1902.2, U1903.2, U2001.2, U2002.2, U2101.9, U2101.13, U2101.14, U2101.16, U2102.7, U2103.7, U2201.2, U2202.4, Y201.2, Y201.4, Y2202.2, Y2202.4
GNDA: C411.2, C412.2, C413.1, C414.2, C415.2, C416.2, C417.2, NT401.2, U401.20, U402.7, U402.8
GNDPWR: J201.8, J201.13, J201.14, R209.1
HWID_FP: J502.11, U1402.6
HWID_MB: U501.1, U501.4, U1401.6
I2C1_SCL: J501.9, R2204.1, RTC2201.3, U401.92, U901.1, U1001.1, U1101.1, U1502.5, U1504.5, U1802.5, U1804.5, U2101.17
I2C1_SDA: J501.7, R2205.1, RTC2201.4, U401.93, U901.6, U1001.6, U1101.6, U1502.4, U1504.4, U1802.4, U1804.4, U2101.18
MCU_BOOT0: C2204.2, D1201.5, J1203.4, R2206.2, SW2202.1, SW2202.2, U401.94
unnamed: C206.1, J201.4
unnamed: C207.1, J201.5
unnamed: C208.2, R210.1, Y201.1
unnamed: C209.2, U201.46, Y201.3
unnamed: C212.1, C213.1, FB201.1, U201.36
unnamed: C214.1, C215.1, U201.8
unnamed: C301.1, D301.1, L301.1, U301.3
unnamed: C301.2, U301.1
unnamed: C306.1, U301.8
unnamed: C307.1, R304.1, U301.6
unnamed: C308.1, R304.2
unnamed: C320.1, C321.1, FB301.2, U303.2
unnamed: C409.1, U401.73
unnamed: C410.1, U401.49
unnamed: C413.2, U402.4
unnamed: C502.2, R502.2, R503.2, R504.2, R505.2, R506.2, R507.1, U501.3
unnamed: C1301.1, J1301.6
unnamed: C1301.2, R1301.2
unnamed: C1302.1, J1301.9
unnamed: C1302.2, R1302.2
unnamed: C1601.1, U1601.3
unnamed: C1602.1, Q1601.2, R1602.2, U1601.1, U1601.2
unnamed: C1701.1, U1601.11
unnamed: C1702.1, Q1701.2, R1702.2, U1601.12, U1601.13
unnamed: C1901.1, U1901.3
unnamed: C1902.1, Q1901.2, R1902.2, U1901.1, U1901.2
unnamed: C2001.1, U1901.11
unnamed: C2002.1, Q2001.2, R2002.2, U1901.12, U1901.13
unnamed: C2102.2, U2101.22
unnamed: C2104.1, D2101.1, J2101.1
unnamed: C2104.2, U2101.12
unnamed: C2105.2, L2101.1, U2101.8
unnamed: C2108.1, R2106.2
unnamed: C2109.2, U2102.2, U2102.3
unnamed: C2112.1, R2109.2
unnamed: C2113.2, U2103.2, U2103.3
unnamed: C2206.1, U401.12, Y2202.1
unnamed: C2207.1, R2207.1, Y2202.3
unnamed: C2208.2, JP2201.2, U401.8
unnamed: C2209.2, JP2201.3, U401.9
unnamed: D302.2, R310.2
unnamed: D303.2, R311.2
unnamed: D304.2, R312.2
unnamed: D305.2, R313.2
unnamed: D306.2, R314.2
unnamed: D307.2, R315.2
unnamed: D308.2, R316.2
unnamed: D309.2, R317.2
unnamed: D310.2, R318.2
unnamed: D1201.1, J1203.2, U1202.3
unnamed: D1201.6, J1203.3, R1205.2
unnamed: D1601.2, R1604.2
unnamed: D1701.2, R1704.2
unnamed: D1901.2, R1904.2
unnamed: D2001.2, R2004.2
unnamed: D2201.1, Q2201.3
unnamed: D2201.2, R2201.1
unnamed: J201.9, R202.1
unnamed: J201.12, R203.2
unnamed: J503.1, R508.2
unnamed: J503.2, Q501.3
unnamed: J1202.2, U1201.6
unnamed: J1202.3, U1201.4
unnamed: J1204.2, U1203.4
unnamed: J1204.3, U1203.6
unnamed: J2103.1, J2104.1, R2110.2
unnamed: J2103.2, J2104.2, R2105.1, U2102.5
unnamed: J2105.1, J2106.1, R2111.2
unnamed: J2105.2, J2106.2, R2108.1, U2103.5
unnamed: J2107.1, JP2106.2
unnamed: M601.3, R601.1, R602.2, U601.1
unnamed: M601.4, Q601.3
unnamed: M701.3, R701.1, R702.2, U701.1
unnamed: M701.4, Q701.3
unnamed: M801.3, R801.1, R802.2, U801.1
unnamed: M801.4, Q801.3
unnamed: Q302.4, Q303.3, R306.2
unnamed: R210.2, U201.47
unnamed: R212.1, U201.23
unnamed: R213.2, U201.28
unnamed: R301.2, R303.1, U301.7
unnamed: R302.2, R305.1, U301.5
unnamed: R501.2, R506.1
unnamed: R1205.1, U1202.6
unnamed: R1206.2, U1202.4
unnamed: R1502.1, U1501.3
unnamed: R1506.1, R1507.2, U1501.2
unnamed: R1508.1, U1503.16
unnamed: R1509.1, U1503.14
unnamed: R1510.1, U1503.15
unnamed: R1513.2, U1503.5
unnamed: R1514.1, U1501.5
unnamed: R1515.1, U1503.12
unnamed: R1516.1, R1517.2, U1501.6
unnamed: R1518.1, U1503.2
unnamed: R1802.1, U1801.3
unnamed: R1806.1, R1807.2, U1801.2
unnamed: R1808.1, U1803.16
unnamed: R1809.1, U1803.14
unnamed: R1810.1, U1803.15
unnamed: R1813.2, U1803.5
unnamed: R1814.1, U1801.5
unnamed: R1815.1, U1803.12
unnamed: R1816.1, R1817.2, U1801.6
unnamed: R1818.1, U1803.2
unnamed: R2101.2, U2101.1
unnamed: R2102.2, U2101.2
unnamed: R2103.2, U2101.3
unnamed: R2104.1, R2105.2
unnamed: R2104.2, R2106.1, U2102.4
unnamed: R2107.1, R2108.2
unnamed: R2107.2, R2109.1, U2103.4
unnamed: R2207.2, U401.13
PWRBTN_LED_PWM: Q501.1, R509.1, U401.95
PWRDRV_ENABLE: Q303.1, R307.1, R1522.1, R1822.1, U401.58, U1503.3, U1505.1, U1506.1, U1602.1, U1701.1, U1803.3, U1805.1, U1806.1, U1902.1, U2001.1
RCLKo_8M: U401.67, U2101.19
RMII_CRS_DV: U201.22, U401.32
RMII_REF_CLK: U201.7, U202.4, U401.24
RMII_RX_D0: U201.21, U401.33
RMII_RX_D1: U201.20, U401.34
RMII_TX_D0: U201.6, U401.51
RMII_TX_D1: U201.5, U401.52
RMII_TX_EN: U201.2, U401.48
SWCLK: D1201.4, J1203.8, U401.76
SWDIO: D1201.3, J1203.7, U401.72
USB1_DM: U401.70, U1201.1
USB1_DP: U401.71, U1201.3
USB2_DM: U401.53, U1203.3
USB2_DP: U401.54, U1203.1
VBUS: J1202.1, R313.1, U1201.5
VBUS2_ENABLE: R309.1, U305.4, U401.57
VBUS_2: C317.1, C318.1, J1204.1, R314.1, U305.1, U1203.5
VCC: C210.1, C211.1, C324.1, C401.1, C402.1, C403.1, C404.1, C405.1, C406.1, C407.1, C408.1, C501.1, C602.2, C702.2, C802.2, C901.1, C1001.1, C1101.1, C1201.2, C1401.1, C1402.1, C1501.1, C1505.1, C1509.2, C1510.2, C1511.2, C1604.1, C1605.1, C1704.1, C1705.1, C1801.1, C1805.1, C1809.2, C1810.2, C1811.2, C1904.1, C1905.1, C2004.1, C2005.1, C2101.1, C2201.2, C2202.2, C2203.1, FB201.2, J1203.9, JP202.3, JP203.3, JP2101.3, JP2104.3, JP2105.3, R201.2, R204.1, R211.2, R308.2, R315.1, R318.1, R501.1, R502.1, R503.1, R504.1, R505.1, R1503.1, R1519.1, R1604.1, R1704.1, R1803.1, R1819.1, R1904.1, R2004.1, R2201.2, R2202.2, R2204.2, R2205.2, RTC2201.5, SW2202.3, SW2202.4, U201.14, U202.1, U202.5, U304.2, U401.6, U401.11, U401.19, U401.28, U401.50, U401.75, U401.100, U501.5, U501.6, U601.5, U701.5, U801.5, U901.4, U1001.4, U1101.4, U1101.5, U1202.5, U1401.2, U1402.2, U1502.6, U1504.2, U1504.6, U1505.5, U1506.5, U1507.1, U1507.5, U1602.3, U1602.5, U1603.5, U1701.3, U1701.5, U1702.5, U1802.1, U1802.6, U1804.1, U1804.2, U1804.6, U1805.5, U1806.5, U1807.1, U1807.5, U1902.3, U1902.5, U1903.5, U2001.3, U2001.5, U2002.5, U2101.20, U2201.5, U2202.3, U2202.7, U2202.8
VDDA: C322.1, C411.1, C412.1, C417.1, C1507.2, C1508.2, C1807.2, C1808.2, C2102.1, FB301.1, R317.1, U401.22, U402.1, U402.2, U402.3, U1501.8, U1801.8, U2101.21
VDD_OLED: C313.1, J501.2, J502.7, J502.10, R316.1, U302.2
VIN: C302.1, C303.1, C309.1, C310.1, C311.1, C314.1, C1202.2, J1205.2, JP501.3, JP601.3, JP701.3, JP801.3, Q301.1, Q301.2, Q301.3, Q302.1, Q302.2, Q302.3, R301.1, R306.1, R310.1, U301.2
VMAIN: C304.1, C305.1, C312.1, C316.1, C319.1, C323.1, C325.1, C326.1, C601.2, C701.2, C801.2, C1603.1, C1703.1, C1903.1, C2003.1, C2106.2, C2107.2, C2110.2, C2111.2, JP501.1, JP501.2, JP601.1, JP601.2, JP701.1, JP701.2, JP801.1, JP801.2, JP2104.1, JP2104.2, JP2105.1, JP2105.2, L301.2, M601.2, M701.2, M801.2, R302.1, R312.1, R508.1, R601.2, R701.2, R801.2, R1602.1, R1702.1, R1902.1, R2002.1, U302.3, U303.3, U304.3, U305.5, U1601.4, U1601.10, U1601.14, U1901.4, U1901.10, U1901.14, U2102.6, U2103.6
~AUDIO_MUTEn~: U401.3, U2102.1, U2103.1
~AUX_INTn~: J502.3, U401.55
~DISP_CSn~: J501.11, U401.39
~EXT_RSTn~: J1203.1, SW2201.3, SW2201.4, U2201.3
~FM_INTn~: U401.79, U2101.4
~FP_BTN_1An~: J501.14, U401.81
~FP_BTN_1Bn~: J501.12, U401.82
~FP_BTN_2An~: J502.14, U401.83
~FP_BTN_2Bn~: J502.13, U401.84
~FP_ENC2_SWn~: J501.10, U401.86
~FP_ENC_SWn~: J502.2, U401.85
~MCU_RSTn~: C2205.2, U401.14, U1603.3, U1702.3, U1903.3, U2002.3, U2201.1
~PHY_IRQn~: R204.2, U201.48, U401.46
~SYS_RSTn~: C203.1, J502.5, R2203.1, U201.42, U401.37, U2101.15
~VBUS2_FLGn~: D310.1, R308.1, U305.3, U401.56
