mjohansson/SolderingStation/sch_pcb/mcu.sch

## KiCad design sch_pcb/mcu.sch (2020-05-04)

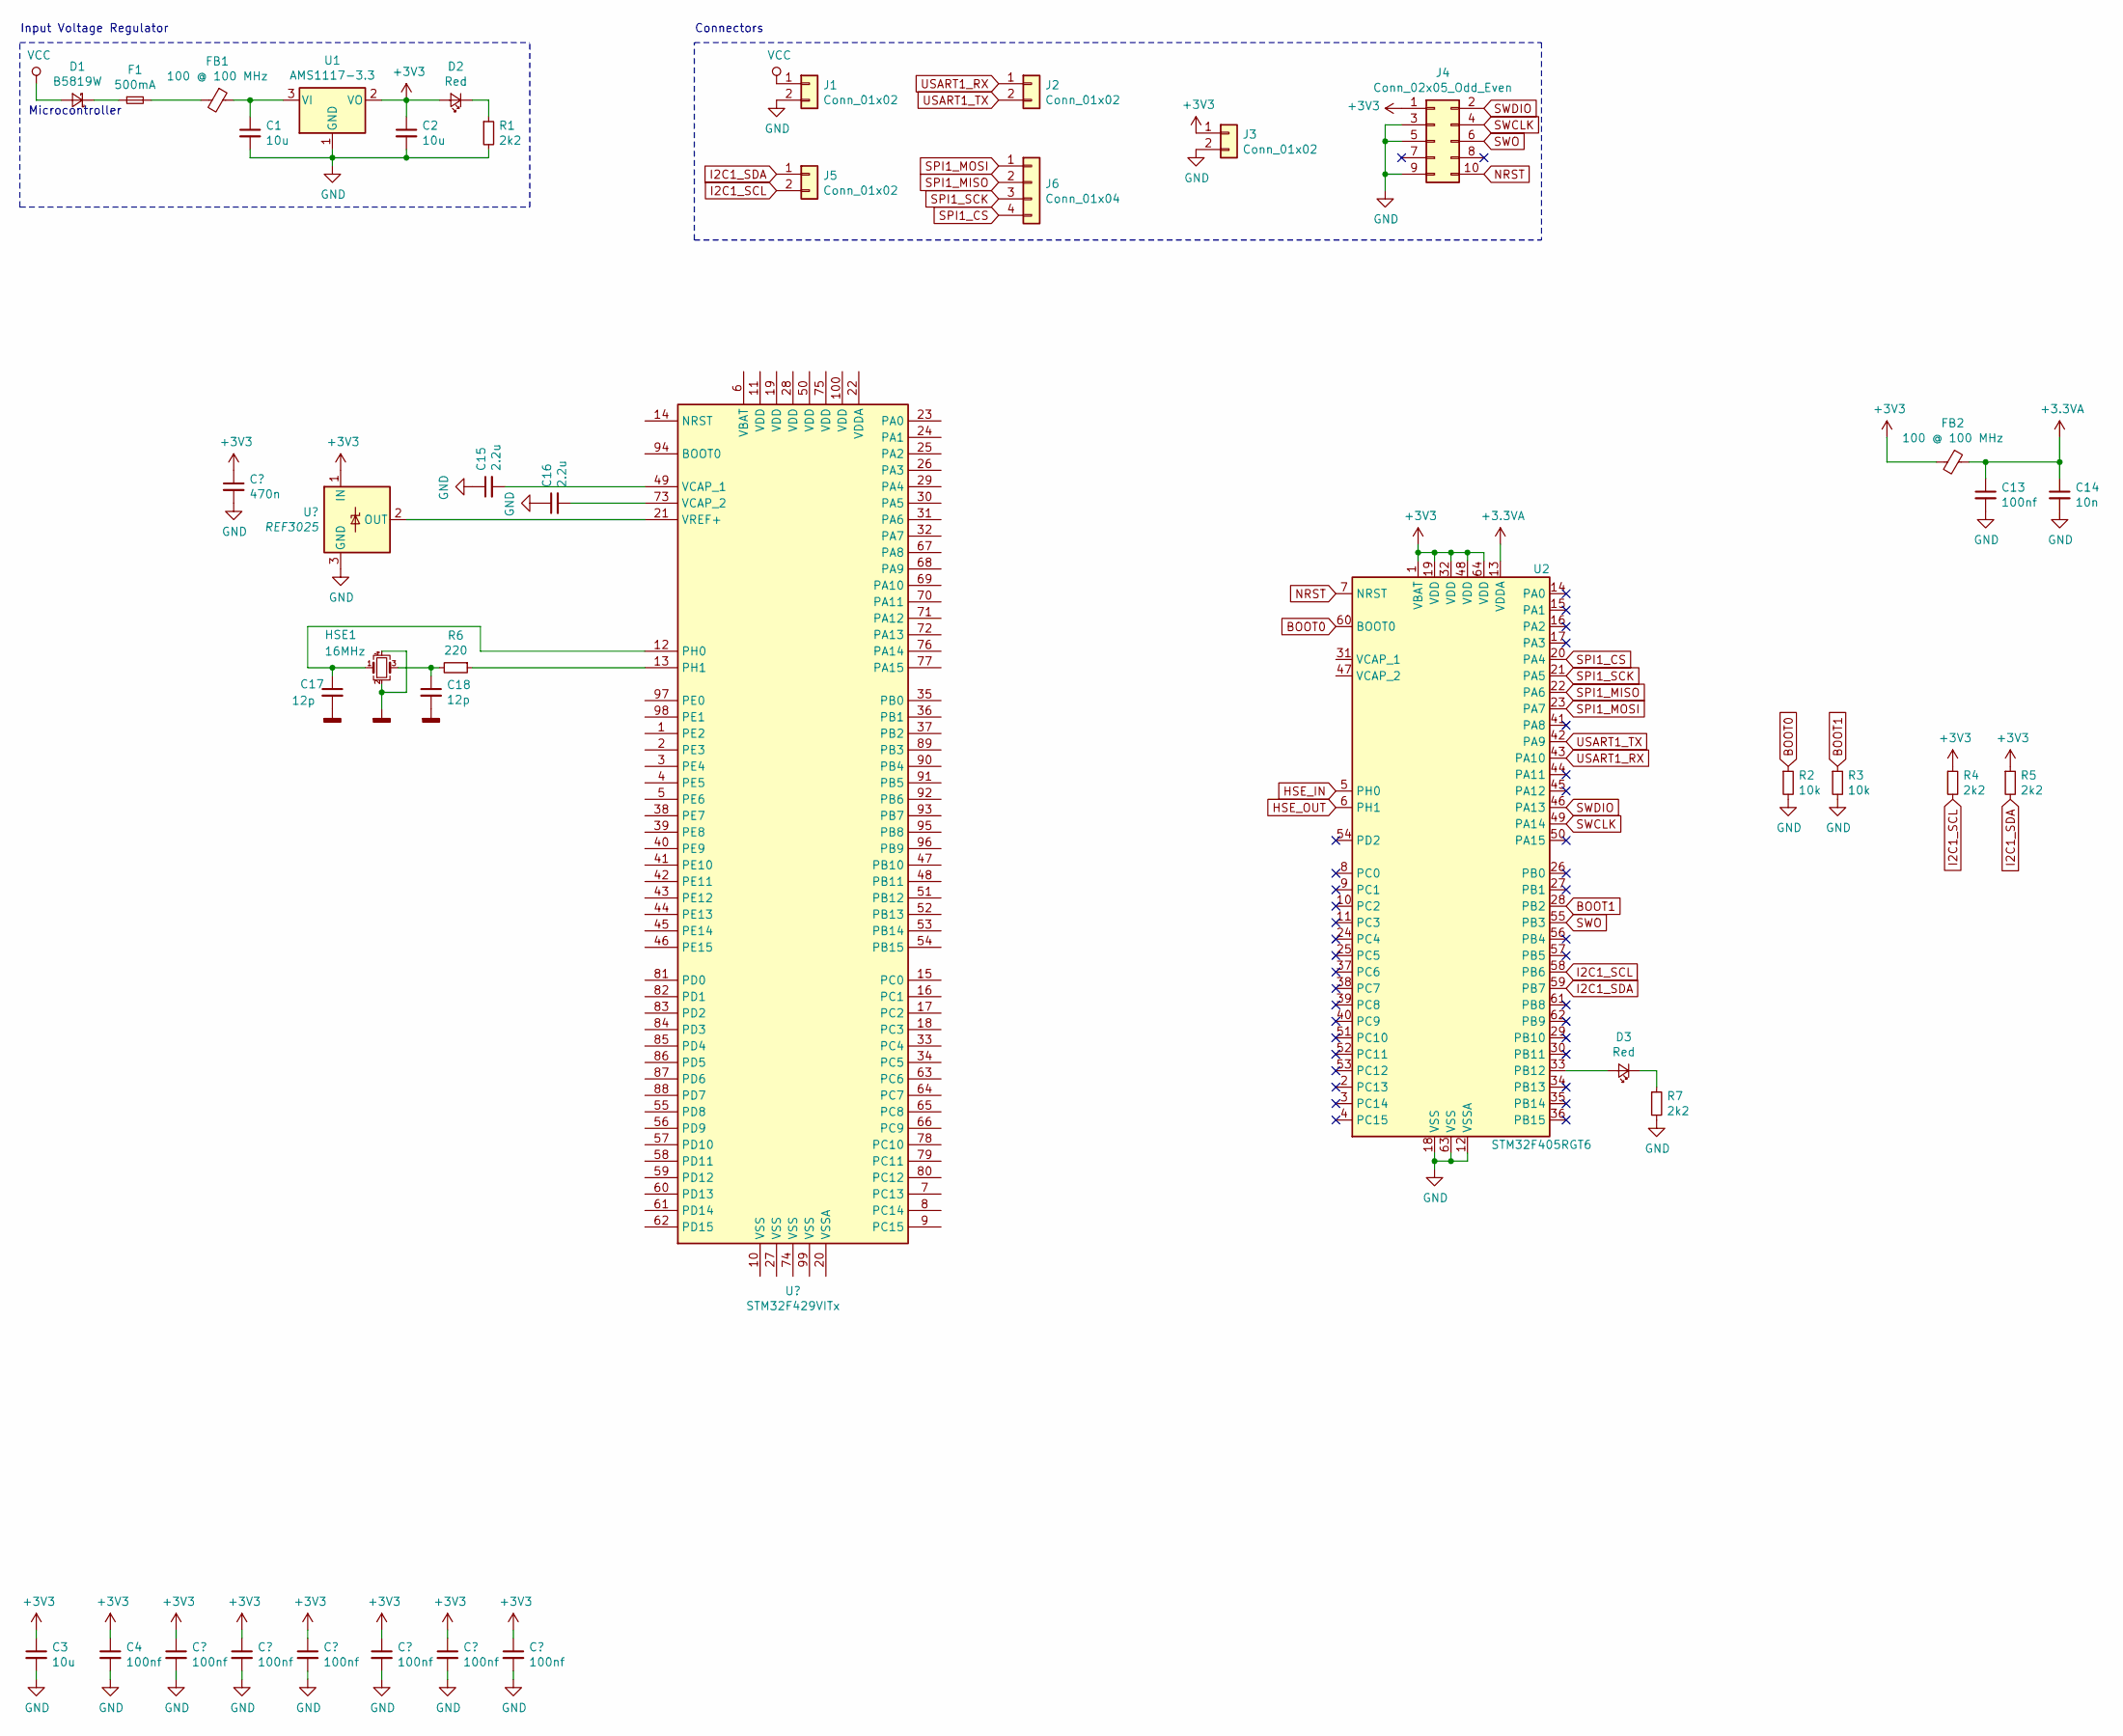
[picture p235: schematic mcu.sch]

Parts:
C1, C2: 10u; C_0805_2012Metric
C3: 10u; C_0603_1608Metric
C4, C13: 100nf; C_0402_1005Metric
C14: 10n; C_0402_1005Metric
C15, C16: 2.2u; C_0603_1608Metric
C17, C18: 12p; C_0402_1005Metric
D1: B5819W; D_SOD-123
D2, D3: Red; LED_0603_1608Metric
F1: 500mA; Fuse_0603_1608Metric
FB1, FB2: 100 @ 100 MHz; L_0805_2012Metric
HSE1: 16MHz; Crystal_SMD_3225-4Pin_3.2x2.5mm
J1, J2, J3, J5: Conn_01x02; PinHeader_1x02_P2.54mm_Vertical
J4: Conn_02x05_Odd_Even; PinHeader_2x05_P1.27mm_Vertical_SMD
J6: Conn_01x04; PinHeader_1x04_P2.54mm_Vertical
R1, R7: 2k2; R_0603_1608Metric
R2, R3: 10k; R_0402_1005Metric
R4, R5: 2k2; R_0402_1005Metric
R6: 220; R_0402_1005Metric
U1: AMS1117-3.3; SOT-223-3_TabPin2
U2: STM32F405RGT6; LQFP-64_10x10mm_P0.5mm

Connections:
+3.3VA: C13.1, C14.1, FB2.1, U2.13 (VDDA)
+3V3: C2.1, C3.1, C4.1, D2.2 (A), FB2.2, J3.1, J4.1, R4.1, R5.1, U1.2 (VO), U2.1 (VBAT), U2.19 (VDD), U2.32 (VDD), U2.48 (VDD), U2.64 (VDD)
BOOT0: R2.1, U2.60 (BOOT0)
BOOT1: R3.1, U2.28 (PB2)
GND: C1.2, C2.2, C3.2, C4.2, C13.2, C14.2, C15.1, C16.1, J1.2, J3.2, J4.3, J4.5, J4.9, R1.2, R2.2, R3.2, R7.2, U1.1 (GND), U2.12 (VSSA), U2.18 (VSS), U2.63 (VSS)
GNDD: C17.2, C18.2, HSE1.2, HSE1.4
HSE_IN: U2.5 (PH0)
HSE_OUT: U2.6 (PH1)
I2C1_SCL: J5.2, R4.2, U2.58 (PB6)
I2C1_SDA: J5.1, R5.2, U2.59 (PB7)
NRST: J4.10, U2.7 (NRST)
unnamed: C1.1, FB1.1, U1.3 (VI)
unnamed: C17.1, HSE1.1
unnamed: C18.1, HSE1.3, R6.2
unnamed: D1.1 (K), F1.1
unnamed: D2.1 (K), R1.1
unnamed: D3.1 (K), R7.1
unnamed: D3.2 (A), U2.33 (PB12)
unnamed: F1.2, FB1.2
SPI1_CS: J6.4, U2.20 (PA4)
SPI1_MISO: J6.2, U2.22 (PA6)
SPI1_MOSI: J6.1, U2.23 (PA7)
SPI1_SCK: J6.3, U2.21 (PA5)
SWCLK: J4.4, U2.49 (PA14)
SWDIO: J4.2, U2.46 (PA13)
SWO: J4.6, U2.55 (PB3)
USART1_RX: J2.1, U2.43 (PA10)
USART1_TX: J2.2, U2.42 (PA9)
VCC: D1.2 (A), J1.1

Notes on the sheet:
Input Voltage Regulator
Microcontroller
Connectors
