mjohansson/SolderingStation/fw/f103cb_fpdev/f103cb_fpdev.ioc

Mcu.UserName=STM32F103CBTx
PA0-WKUP.GPIO_Label=FAN1_RPM_TIM2_ETR
PA0-WKUP.Signal=S_TIM2_CH1_ETR
PA1.GPIO_Label=RTC_INTn_SQW
PA1.Signal=S_TIM2_CH2
PA10.Signal=USART1_RX
PA11.GPIO_Label=FP_BTN_1Bn
PA11.Signal=GPIO_Input
PA12.GPIO_Label=FP_BTN_1An
PA12.Signal=GPIO_Input
PA13.Signal=SYS_JTMS-SWDIO
PA14.Signal=SYS_JTCK-SWCLK
PA15.GPIO_Label=FLASH_CSn
PA15.Signal=GPIO_Output
PA2.GPIO_Label=AUX_INTn
PA2.Signal=GPIO_Input
PA5.GPIO_Label=ADC1_IN5_HWID_MB
PA5.Signal=ADCx_IN5
PA6.GPIO_Label=ADC1_IN6_HWID_FP
PA6.Signal=ADCx_IN6
PA7.GPIO_Label=DISP_DCn
PA7.Signal=GPIO_Output
PA8.GPIO_Label=DISP_CSn
PA8.Signal=GPIO_Output
PA9.Signal=USART1_TX
PB0.GPIO_Label=PWRBTN_LED_PWM_TIM3_CH3
PB0.Signal=S_TIM3_CH3
PB1.GPIO_Label=FAN1_PWM_TIM3_CH4
PB1.Signal=S_TIM3_CH4
PB10.GPIO_Label=AUX_RX_USART3_TX
PB10.Signal=USART3_TX
PB11.GPIO_Label=AUX_TX_USART3_RX
PB11.Signal=USART3_RX
PB12.GPIO_Label=SYS_RSTn
PB12.Signal=GPIO_Output
PB13.GPIO_Label=FP_BTN_2An
PB13.Signal=GPIO_Input
PB14.GPIO_Label=FP_BTN_2Bn
PB14.Signal=GPIO_Input
PB15.GPIO_Label=FP_ENC_SWn
PB15.Signal=GPIO_Input
PB3.Signal=SPI1_SCK
PB4.Signal=SPI1_MISO
PB5.Signal=SPI1_MOSI
PB6.GPIO_Label=FP_ENC_A_TIM4_CH1
PB6.Signal=S_TIM4_CH1
PB7.GPIO_Label=FP_ENC_B_TIM4_CH2
PB7.Signal=S_TIM4_CH2
PB8.GPIO_Label=SW_I2C_SCL
PB8.Signal=GPIO_Output
PB9.GPIO_Label=SW_I2C_SDA
PB9.Signal=GPIO_Output
PC13-TAMPER-RTC.GPIO_Label=BRD_LED_AUX_BOOT0
PC13-TAMPER-RTC.Signal=GPIO_Output
PC14-OSC32_IN.Signal=RCC_OSC32_IN
PD0-OSC_IN.Signal=RCC_OSC_IN
PD1-OSC_OUT.Signal=RCC_OSC_OUT
