mjohansson/SolderingStation/fw/f103cb_fpdev/Inc/main.h

#define AT24C_EEPROM_I2C_ADDR   0xAE  // (0xAF for I2C Read operations)
#define AT24C_EEPROM_TYPE       256   // TBD: maybe enum ? Auto-detect/query ?
#define DS3231_RTC_I2C_ADDR     0xD0  // (0xD1 for I2C Read operations)
#define USBD_AUDIO_FREQ 8000
#define USBD_CUSTOMHID_OUTREPORT_BUF_SIZE 2
#define USBD_CUSTOM_HID_REPORT_DESC_SIZE 1
#define USBD_DFU_XFER_SIZE 1
#define USBD_DFU_MAX_ITF_NUM 1
#define USBD_DFU_APP_DEFAULT_ADD 0x0800c000
#define MSC_MEDIA_PACKET 1
#define BRD_LED_AUX_BOOT0_Pin GPIO_PIN_13
#define BRD_LED_AUX_BOOT0_GPIO_Port GPIOC
#define FAN1_RPM_TIM2_ETR_Pin GPIO_PIN_0
#define FAN1_RPM_TIM2_ETR_GPIO_Port GPIOA
#define RTC_INTn_SQW_Pin GPIO_PIN_1
#define RTC_INTn_SQW_GPIO_Port GPIOA
#define AUX_INTn_Pin GPIO_PIN_2
#define AUX_INTn_GPIO_Port GPIOA
#define ADC1_IN5_HWID_MB_Pin GPIO_PIN_5
#define ADC1_IN5_HWID_MB_GPIO_Port GPIOA
#define ADC1_IN6_HWID_FP_Pin GPIO_PIN_6
#define ADC1_IN6_HWID_FP_GPIO_Port GPIOA
#define DISP_DCn_Pin GPIO_PIN_7
#define DISP_DCn_GPIO_Port GPIOA
#define PWRBTN_LED_PWM_TIM3_CH3_Pin GPIO_PIN_0
#define PWRBTN_LED_PWM_TIM3_CH3_GPIO_Port GPIOB
#define FAN1_PWM_TIM3_CH4_Pin GPIO_PIN_1
#define FAN1_PWM_TIM3_CH4_GPIO_Port GPIOB
#define AUX_RX_USART3_TX_Pin GPIO_PIN_10
#define AUX_RX_USART3_TX_GPIO_Port GPIOB
#define AUX_TX_USART3_RX_Pin GPIO_PIN_11
#define AUX_TX_USART3_RX_GPIO_Port GPIOB
#define SYS_RSTn_Pin GPIO_PIN_12
#define SYS_RSTn_GPIO_Port GPIOB
#define FP_BTN_2An_Pin GPIO_PIN_13
#define FP_BTN_2An_GPIO_Port GPIOB
#define FP_BTN_2Bn_Pin GPIO_PIN_14
#define FP_BTN_2Bn_GPIO_Port GPIOB
#define FP_ENC_SWn_Pin GPIO_PIN_15
#define FP_ENC_SWn_GPIO_Port GPIOB
#define DISP_CSn_Pin GPIO_PIN_8
#define DISP_CSn_GPIO_Port GPIOA
#define FP_BTN_1Bn_Pin GPIO_PIN_11
#define FP_BTN_1Bn_GPIO_Port GPIOA
#define FP_BTN_1An_Pin GPIO_PIN_12
#define FP_BTN_1An_GPIO_Port GPIOA
#define FLASH_CSn_Pin GPIO_PIN_15
#define FLASH_CSn_GPIO_Port GPIOA
#define FP_ENC_A_TIM4_CH1_Pin GPIO_PIN_6
#define FP_ENC_A_TIM4_CH1_GPIO_Port GPIOB
#define FP_ENC_B_TIM4_CH2_Pin GPIO_PIN_7
#define FP_ENC_B_TIM4_CH2_GPIO_Port GPIOB
#define SW_I2C_SCL_Pin GPIO_PIN_8
#define SW_I2C_SCL_GPIO_Port GPIOB
#define SW_I2C_SDA_Pin GPIO_PIN_9
#define SW_I2C_SDA_GPIO_Port GPIOB
