mjohansson/SolderingStation/fw/f103cb_fpdev/Src/adc.c

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
/* Includes ------------------------------------------------------------------*/
#include "adc.h"

ADC_HandleTypeDef hadc1;

/* ADC1 init function */
void MX_ADC1_Init(void)
{

  ADC_ChannelConfTypeDef sConfig = {0};

  /** Common config
  */
  hadc1.Instance = ADC1;
  hadc1.Init.ScanConvMode = ADC_SCAN_DISABLE;
  hadc1.Init.ContinuousConvMode = DISABLE;
  hadc1.Init.DiscontinuousConvMode = DISABLE;
  hadc1.Init.ExternalTrigConv = ADC_SOFTWARE_START;
  hadc1.Init.DataAlign = ADC_DATAALIGN_RIGHT;
  hadc1.Init.NbrOfConversion = 1;
  if (HAL_ADC_Init(&hadc1) != HAL_OK)
  {
    Error_Handler();
  }
  /** Configure Regular Channel
  */
  sConfig.Channel = ADC_CHANNEL_6;
  sConfig.Rank = ADC_REGULAR_RANK_1;
  sConfig.SamplingTime = ADC_SAMPLETIME_28CYCLES_5;
  if (HAL_ADC_ConfigChannel(&hadc1, &sConfig) != HAL_OK)
  {
    Error_Handler();
  }
}

void HAL_ADC_MspInit(ADC_HandleTypeDef* adcHandle)
{

  GPIO_InitTypeDef GPIO_InitStruct = {0};
  if(adcHandle->Instance==ADC1)
  {
    /* ADC1 clock enable */
    __HAL_RCC_ADC1_CLK_ENABLE();

    __HAL_RCC_GPIOA_CLK_ENABLE();
    /**ADC1 GPIO Configuration
    PA5     ------> ADC1_IN5
    PA6     ------> ADC1_IN6
    */
    GPIO_InitStruct.Pin = ADC1_IN5_HWID_MB_Pin|ADC1_IN6_HWID_FP_Pin;
    GPIO_InitStruct.Mode = GPIO_MODE_ANALOG;
    HAL_GPIO_Init(GPIOA, &GPIO_InitStruct);

  /* USER CODE BEGIN ADC1_MspInit 1 */

//    HAL_ADCEx_Calibration_Start(&hadc1);

  /* USER CODE END ADC1_MspInit 1 */
  }
}

void HAL_ADC_MspDeInit(ADC_HandleTypeDef* adcHandle)
{

  if(adcHandle->Instance==ADC1)
  {
    /* Peripheral clock disable */
    __HAL_RCC_ADC1_CLK_DISABLE();

    /**ADC1 GPIO Configuration
    PA5     ------> ADC1_IN5
    PA6     ------> ADC1_IN6
    */
    HAL_GPIO_DeInit(GPIOA, ADC1_IN5_HWID_MB_Pin|ADC1_IN6_HWID_FP_Pin);

  }
}

/* USER CODE BEGIN 1 */

int adc_get_hwid_mb(int oversampling)
{
    int res = 1;
    ADC_ChannelConfTypeDef sConfig = {0};

    /** Configure Regular Channel : HWID_MB = PA5 = ADC1_IN5 */
    sConfig.Channel = ADC_CHANNEL_5;
    sConfig.Rank = ADC_REGULAR_RANK_1;
    sConfig.SamplingTime = ADC_SAMPLETIME_28CYCLES_5;
    if (HAL_ADC_ConfigChannel(&hadc1, &sConfig) != HAL_OK) {
        Error_Handler();
    }

    HAL_ADC_Start(&hadc1);
    // Poll with timeout = 1mSec
    if (HAL_ADC_PollForConversion(&hadc1, 1) == HAL_OK) {
        uint32_t raw = HAL_ADC_GetValue(&hadc1);
        res = (int) raw;
    }

    return res;
}

int adc_get_hwid_fp(int oversampling)
{
    int res = -1;
    ADC_ChannelConfTypeDef sConfig = {0};

    /** Configure Regular Channel : HWID_FP = PA6 = ADC1_IN6 */
    sConfig.Channel = ADC_CHANNEL_6;
    sConfig.Rank = ADC_REGULAR_RANK_1;
    sConfig.SamplingTime = ADC_SAMPLETIME_28CYCLES_5;
    if (HAL_ADC_ConfigChannel(&hadc1, &sConfig) != HAL_OK) {
        Error_Handler();
    }

    HAL_ADC_Start(&hadc1);
    // Poll with timeout = 1mSec
    if (HAL_ADC_PollForConversion(&hadc1, 1) == HAL_OK) {
        uint32_t raw = HAL_ADC_GetValue(&hadc1);
        res = (int) raw;
    }

    return res;
}

/* USER CODE END 1 */
