mjohansson/SolderingStation/(commit log)

2020-04-30 Initial commit. Mostly docs & appnotes and generic project tree structure
    [1455T1601.stp, 3d_MicroUSB-FCI-10104111.STEP, 74980104400_Download_STP_WE-LAN-74980104400_rev1.stp, Basket_Mar08_0954PM.xls, Buck_Calc.xlsx, MB1075 B01 BOM.xls, Mouser_Basket_Mar11_0352PM-uppdelning.xls, Mouser_Basket_Mar11_0352PM.xls]
2020-04-30 my first commit
    [SolderingStation_PCBA.xlsx]
2020-05-05 Added STM32 appnote (oscillator design guide)
2020-05-05 Added alternative RJ45 jack (Amphenol). Also wiznet example-schematic for IP101GA (w7500)
2020-05-05 Added generic 6x6mm tactile pushbutton. This variant found (cheap) on LCSC
    [pushbutton_smd_6x6x4.3mm.step]
2020-05-05 MJ solderstn_mb schematic : mcu_1 & ethernet
    [connectors.sch, ethernet.sch, mcu_1.sch, mcu_2.sch, solderstn_mb.kicad_pcb, solderstn_mb.sch]
2020-05-09 Bunch of docs renamed; some new (e.g. crystals); new 3d-models e.g. RS_Pro power-button; minor updates to eth, stm32 schematics
    [Buck_Calc.xlsx, Mouser_Basket_Mar11_0352PM-uppdelning.xls, RS_PRO-PowerBleu.step, ethernet.sch, mcu_1.sch]
2020-05-10 Added schematics for Power (feat. Pluto 5V buck) & front- and rear connections. Modified page header (affecting all sch's). (Added datasheet for AP22811 USB-loadswitch & product table of Biltema cabl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
    [ethernet.sch, front_panel_conn.sch, mcu_1.sch, mcu_2.sch, power.sch, rear_panel_conn.sch, solderstn_mb.sch]
2020-08-18 Summer vacation 2020 updates: * Front panel design rev 1 complete (incl Experimental outer board with optional linear touch sensors) * MB schematics AlmostDone(tm) - 'old' pinout supporting only one 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
    [528921433.stp, 687114182122_Download_STP_687114182122_rev1.stp, 687614100002_Download_STP_6876xxxxx002_rev1.stp, 687614152002_Download_STP_6876xxxxx002_rev1.stp, 687714100002_Download_STP_6877xxxxx002_rev1.stp, CUI_DEVICES_SJ-3571N.step, FFC_14p-Molex_5052781433-colorized.stp, Frontpanel_touch_sense.sch]
2020-08-18 Lots of mech-stuff (could use a good clean-up eventually)
    [1455T2201.igs, 1455T2201.stp, 1455T2201_zeroed.stp, 3d_holder_left_v3.stl, 3d_holder_right-r2.stl, 87-DC3-201.FCStd, 87-DC3-201.stp, Al-knob_20x15mm_detents_lockscrew.step]
2020-08-18 Amphenol C707 (SIM-card block connector) was not used; but a mech model was made for it so we'll save it for some rainy day...
2020-08-18 Alternative CubeMX pin-out to enable dual rotary encoders,,,
2020-08-18 Reverse-voltage protection PFET
    [power.sch]
2020-08-18 Update pinout to "alternative", shuffling stuff around to optionally support a 2nd rotary on front-panel (corresponding Front-panel side not yet updated)
    [Weller_channel.sch, Weller_ctrl.sch, front_panel_conn.sch, mcu_1.sch, mcu_2.sch, power.sch, solderstn_mb.sch]
2020-08-19 (pdf schematics from yesterday and after today's new pinout)
2020-08-19 * Remove separate REED_PULLUP_EN pin; instead bias the Reedswitches with the per-channel KTY bias (buffered Vref) * Add separate mini cut-out sub-PCB for 3.5 headphone connector at back-panel (must b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
    [Weller_channel.sch, Weller_ctrl.sch, audio_fmradio.sch, ethernet.sch, fan_ctrl.sch, front_panel_conn.sch, headphone_carrier.sch, mcu_1.sch]
2020-08-19 * pinheader/socket for headphone sub-PCB 2x3 -> 2x5 (greater mechanical stability) * printed WIP-schematics pdf for 08-19
    [headphone_carrier.sch, mcu_1.sch, rear_panel_conn.sch]
2020-08-21 * Added Molex connectors (PwrLED-conn, DC-in, FM-ant.) * Renamed Si4735 doc dir
    [Weller_ctrl.sch, audio_fmradio.sch, front_panel_conn.sch, power.sch, rear_panel_conn.sch]
2020-08-21 Some more docs (Molex connectors & schmitt-trigger buffers)
2020-08-21 Daily schematics updates (pdf) 20-08-20
2020-08-21 Created mech model of FM telescope antenna
    [FM_telescope_antenna_screwtype_pivot.FCStd]
2020-08-21 Created PCB outline 160.5x220, with 3mm keepout lines (in silk) along the sides (This is abs.max size of board; cut off and cut-out as needed...)
    [solderstn_mb.kicad_pcb]
2020-08-22 Updated display-board sch & PCB with optional left-hand rotary encoder instead of pwrbtn. Printed MB schematic updates PDF for 20-08-21
    [Weller_channel.sch, Weller_ctrl.sch, audio_fmradio.sch, front_panel_conn.sch, headphone_carrier.sch, mcu_1.sch, power.sch, pwm_error_detector.sch]
2020-08-22 Updated 'hybrid' pwrbtn/2nd-rotary footprint on display-board
    [ss_frontpanel_inner_plate.kicad_pcb]
2020-08-22 Mech: test-assembly of 2nd rotary on display-board. Tight fit, but a teeny-tiny bit of grinding the rotary will fix it :)
    [ss_frontpanel_inner_plate-2nd_rotary_test_asm.FCStd]
2020-08-22 New 3d-print 'hybrid 2nd rotary' holder. Updated old right rotary holder (right_3p-r3; pad 9.0 -> 9.5mm)
    [MJ_3d_holder_left_hybrid_2nd_rotary.FCStd, MJ_3d_holder_right_3p-r3.FCStd]
2020-08-22 Updated FP display board with changes to hybrid 2nd rotary holder. Updated & more stuff to the mech asm-testing of inner-plate/2nd rotary
    [ss_frontpanel_inner_plate-2nd_rotary_test_asm.FCStd, ss_frontpanel_inner_plate.FCStd, ss_frontpanel_inner_plate.kicad_pcb]
2020-08-23 Started on 1.6mm FR4 back-panel
    [ss_backpanel.kicad_pcb, ss_backpanel.sch]
2020-08-23 mech: small pocket under pwrbtn holder compensating for HASL bumps on the 5 new pins for 2nd enc
    [MJ_3d_holder_left_v3.FCStd, ss_frontpanel_inner_plate-2nd_rotary_test_asm.FCStd]
2020-08-23 Corrected several ERC issues. Re-annotated & assigned all footprints except 32k xtal (will prob. replace with RTC module anyway)
    [Weller_channel.sch, Weller_ctrl.sch, audio_fmradio.sch, ethernet.sch, fan_ctrl.sch, front_panel_conn.sch, headphone_carrier.sch, mcu_1.sch]
2020-08-24 Created a 3d-model of DS3231 RTC & eeprom module
    [DS3231_module_MJ.FCStd]
2020-08-24 Pinout changes to add DS3231 RTC module instead of 32kHz LSE xtal (still keep SMD pads as placeholders). Minor ERC fixes. All footprints specified
    [fan_ctrl.sch, mcu_1.sch, pwm_error_detector.sch, solderstn_mb.sch]
2020-08-24 Printed MB schematics pdf for 08-23 updates
2020-08-24 mech updates (3d-holders and assemblies)
    [MJ_3d_holder_left_hybrid_2nd_rotary-asm.FCStd, MJ_3d_holder_left_hybrid_2nd_rotary.FCStd, MJ_3d_holder_left_v3-asm.FCStd, MJ_3d_holder_right_3p-r3-asm.FCStd, MJ_3d_holder_right_3p-r3.FCStd]
2020-08-24 Updated display-board with mech updates. Default version is original left PwrBtn + right Rotary
    [ss_frontpanel_inner_plate.kicad_pcb, ss_frontpanel_inner_plate.sch]
2020-08-24 Minor updates to MB and box asmtesting
    [fan_ctrl.sch, mcu_1.sch, pwm_error_detector.sch, solderstn_mb.kicad_pcb]
2020-08-24 Updated material/color of Rotary knob Al 28mm
    [Roatary_knob_Al_28mm_knurled-Mentor_5555_6612.FCStd]
2020-08-24 Updated mech-models of display-board & outer-panel with StepUp. (Had to plot silk-layers as dxf from Kicad to allow StepUp to import them)
    [ss_frontpanel_inner_plate-B_SilkS.dxf, ss_frontpanel_inner_plate-F_SilkS.dxf, ss_frontpanel_inner_plate.kicad_pcb, ss_frontpanel_outer_plate-B_SilkS.dxf, ss_frontpanel_outer_plate.FCStd, ss_frontpanel_outer_plate.kicad_pcb]
2020-08-24 Added updated 'real' display-board and outer front-panel to main 3d test-assmbly, freash from StepUp conversion. Added 28mm rotary Al-button as alternative to the old
2020-08-25 Updated DC/DC buck values after testing TPS54332 in TI WebBench. New MB printed schematics.
    [SolderingStation_1A-WBOperatingValuesDesign1.csv, WBBOMDesign1.csv, power.sch]
2020-08-26 Backpanel: Initial placement of Schaffner AC-inlet, Schurter secondary fuse-holder and 2x Weller DIN7
    [ss_backpanel.kicad_pcb, ss_backpanel.sch]
2020-08-26 Trimmed MB pcb outline to 160.0 mm width
    [solderstn_mb.kicad_pcb]
2020-08-30 Added new PCB-project for alternate frontpanel outer plate (featuring 2nd rotary + touch-sense)
    [Frontpanel_touch_sense.sch, SS_outer_alternate_2nd_rotary.stl, panel_outline.dxf, ss_frontpanel_outer_plate_alternate-B_Cu.dxf, ss_frontpanel_outer_plate_alternate-B_SilkS.dxf, ss_frontpanel_outer_plate_alternate-F_Cu.dxf, ss_frontpanel_outer_plate_alternate.FCStd, ss_frontpanel_outer_plate_alternate.kicad_pcb]
2020-08-30 Updated STL of left 3dholder
    [3d_holder_left_v3.stl]
2020-08-31 Added back-panel cutouts for Wurth RJ45 (LAN) and TE's USB-A & USB-B connectors
    [solderstn_mb.kicad_pcb, ss_backpanel.kicad_pcb, ss_backpanel.sch]
2020-08-31 Added 2d- & 3d docs for 9-pin DSub conn (Kycon)
    [K22X-E9P-N.step]
2020-08-31 Updated back-panel with 3.5mm audio jack & Dsub-9 cut-outs
    [ss_backpanel.kicad_pcb, ss_backpanel.sch]
2020-09-03 *) Cut-out in MB for Schaffner FN283 AC-jack; re-generated MB 3d, import into assembly-testing *) Re-gen & Imported Kicad Backpanel into asm-testing. *) docs for new CUI internal speakers
    [CUI_DEVICES_CES-703116-28PM.step, CUI_DEVICES_CES-703316-28PM.step, CUI_DEVICES_CES-803118-28PM.step, audio_fmradio.sch, solderstn_mb.kicad_pcb, solderstn_mb.sch, ss_backpanel-F_SilkS.dxf]
2020-09-03 Created simple volume model of CES-503528 (however obv. too big to fit)
    [MJ_CES-503528-28PM-67.FCStd]
2020-09-05 Created rudimentary volume modell of CUI CES-30207 mini speaker
    [MJ_CES-30207-158L120-67.FCStd]
2020-09-05 Updated MB audio to feature two alternative internal speakers; CUI CES-30207 or CES-703116 and their respective conn.headers. Speakers preliminary placed on MB top side
    [audio_fmradio.sch, solderstn_mb.kicad_pcb, solderstn_mb.sch]
2020-09-05 Updated 3d asm-testing with exported MB w. speakers. Issue: 70mm speakers collide with Meanwell, -1mm in Z. Have to add washers to 5mm spacers
2020-09-05 Updated speaker-assembly to avoid collisions; no-margins might-fit, requires washers and coutersunk screws. This is fine! :)
    [solderstn_mb.kicad_pcb]
2020-10-06 New USB-A connector: CUI-devices UJ2-AH-1-SMT
2020-10-06 Updated USB-A conn to CUI UJ2-AH-1-SMT because retention pads are SMD. Also better USB-A cutout in back panel. Updated 3d test model
    [rear_panel_conn.sch, solderstn_mb.kicad_pcb, ss_backpanel.kicad_pcb, ss_backpanel.sch]
2020-10-06 New component: 4mm banana socket - Stäubli LB-I4R-A (23.0190-21)
2020-10-06 Added 4mm banana earth connector to back panel. Moved DIN-connectors slightly to fit. Updated 3d test model
    [ss_backpanel-F_SilkS.dxf, ss_backpanel.kicad_pcb, ss_backpanel.sch]
2020-10-07 New component docs : SMA-connectors
    [60311002111526_Download_STP_60311002111526_rev1.stp, 60349021210720_Download_Step_60349021210720_rev1.stp]
2020-10-07 Add 12V DC-out (Molex Nano-Fit 1x02) and SMA in back-panel, for FM antenna & ext. ant.amp. Updated Dsub9 conn to correct component & placement on MB.
    [audio_fmradio.sch, power.sch, rear_panel_conn.sch, solderstn_mb.kicad_pcb, ss_backpanel-F_SilkS.dxf, ss_backpanel.kicad_pcb, ss_backpanel.sch]
2020-10-20 Backpanel: move SMA to side, under MB PCB, also 12V-out moved outwards (and had to shift 12V/Gnd pins); Mainboard: Move SMA-RA to bottomside, wont fit on Topside. ALso prelim. scatter/placement of so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
    [ethernet.sch, power.sch, rear_panel_conn.sch, solderstn_mb.kicad_pcb, ss_backpanel.kicad_pcb]
2020-10-24 *) Add some docs (JST PH spk conn., SPI-flash, Molex NanoFit 12V backpanel conn.) *) MB cutouts for front-panel features *) Change PwrBtn LED conn. Molex MicroClasp -> JST PH2 to avoid througholes + 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
    [1054301102.stp, audio_fmradio.sch, front_panel_conn.sch, mcu_1.sch, power.sch, solderstn_mb.kicad_pcb]
2020-10-26 3d-printed template for making MW & fan drill holed in Hammond bottom plate
    [Bottomplate_holes_cutouts_template.FCStd, Bottomplate_holes_template.stl]
2020-10-26 3dmodels of Quick-connect spade terminals and lugs
    [Female QuickConnect-4_8mm-Red.STEP, Female QuickConnect-4_8mm.STEP, Female QuickConnect-4_8mm_Full_insul.STEP, Female QuickConnect-6_35mm-Full_insul.STEP, Female QuickConnect-6_35mm.STEP, Female_QuickConn-6_35mm-Full_insul-MNU18-187DFIK-Red.stp, Female_QuickConn-6_35mm-Full_insul-MNU18-187DFIK.STEP]
2020-10-26 About to shuffle stuff around on MB; save old placements as a backup board file (also mech asm-testing)
    [solderstn_mb_alt2.kicad_pcb]
2020-10-26 Backpanel: slightly move fuseholder & PE banana conn
    [ss_backpanel-F_SilkS.dxf, ss_backpanel.kicad_pcb]
2020-10-26 New alternate placement of int. speakers, RTC-mod etc.
    [solderstn_mb.kicad_pcb]
2020-10-27 mech: testing alternate placement of Meanwell PSU; centered-fwd.
    + : more space in back for PSU cabling etc
    + : space on both sides to fit 80mm internal speakers (tilted sideways, beneath MB PCB)
    + : no interference at Power-button
    - : no space for any chassis fans (maybe cram one in sideways, but why..?)
2020-10-27 backpanel: minor position adjustments
    [ss_backpanel.kicad_pcb]
2020-10-27 New PCB-proj & mech asm-testing for 'mirrored' backpanel. Move Meanwell to other side & mirror all stuff on backpanel.
    + : also solves issues with interference around frontpanel Power-button
    + : more space in rear for PSU cabling; but some criss-crossing of AC-in and DC-out wires.
    + : still allows 2x chassis fans if needed
    - : doesn't allow 80mm speakers like with centered MW PSU
    [ss_backpanel-mirrored-F_SilkS.dxf, ss_backpanel-mirrored.kicad_pcb, ss_backpanel-mirrored.sch]
2020-10-28 New mech main-track selected: "centered PSU" + "Mirrored back panel". Minor cleanups & re-alignments.
    (Yet ToDo: all MB adjustments...)
    [ss_backpanel-mirrored-F_SilkS.dxf, ss_backpanel-mirrored.kicad_pcb]
2020-10-29 Updated MB cutouts, placements to new PSU-centered & 'mirrored' rearpanel layout. Schaffner FN283 (AC-inlet) now defaults to placed at inside rearpanel position -> rear looks (a bit) less cluttered
    [rear_panel_conn.sch, solderstn_mb.kicad_pcb]
2020-10-29 Minor re-alignments of rear-panel items that collided with box sides (SMA, outer DIN, Schaffner AC-in)
    [solderstn_mb.kicad_pcb, ss_backpanel-mirrored-F_SilkS.dxf, ss_backpanel-mirrored.kicad_pcb]
2020-10-30 New component : Schurter OGN 0031.82x1 PCB fuse-holder
    [Schurter_0031_8201.step]
2020-10-30 Rearpanel: IDC 2x5 instead of Dsub9 as dbg/bootstrp conn. Remove secondary fuseholder; rearrange DIN, P.E. banana, dbg. for more space. MainBoard: Rotate MW PSU 180deg (optimize for 230V through PwrB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
    [mcu_1.sch, power.sch, rear_panel_conn.sch, solderstn_mb.kicad_pcb, ss_backpanel-mirrored-F_SilkS.dxf, ss_backpanel-mirrored.kicad_pcb, ss_backpanel-mirrored.sch]
2020-10-31 Update bottom-plate with drill-holes for new PSU placement. Interior M3 3mm holes for original orientaion; diagonal M3s for rotated orientation
2020-10-31 New 3d-print template for drilling out the new PSU mounting holes - worked perfectly
    [BottomPlate_drill-template-Centered_PSU.FCStd, BottomPlate_drill_template-Centered_PSU.stl]
2020-10-31 Added (plenty of) vent slots to bottom plate
2020-11-03 docs for new components - Wurth WR-FAST quick-connect cable-conn. blades
    [WR-FAST_2ra_638263122002_rev1.stp, WR-FAST_2v_638263222002_rev1.stp, WR-FAST_3ra_638263122003_rev1.stp, WR-FAST_3v_638263222003_rev1.stp, WR-FAST_4ra_638263122004_rev1.stp, WR-FAST_4v_638263222004_rev1.stp, WR-FAST_6ra_638263122006_rev1.stp, WR-FAST_6v_638263222006_rev1.stp]
2020-11-03 Add quick-connect cable-shoe blades for: DC-in, prot.earth, Weller DIN pwr pins. PicoBlade 4p conns for Weller DIN sense-pins. Some sch clean-ups; Mech placement adjustments.
    [Weller_channel.sch, Weller_ctrl.sch, audio_fmradio.sch, ethernet.sch, fan_ctrl.sch, front_panel_conn.sch, mcu_1.sch, mcu_2.sch]
2020-11-03 Clean-up - remove unused/old files
    [connectors.sch, headphone_carrier.sch]
2020-11-04 MB: *) add LED on DC-in pwr-rail *) fix misnamed audio signals
    [mcu_2.sch, power.sch, rear_panel_conn.sch]
2020-11-04 MB: moved FM-rx from audio to its own sch. sheet, to reduce clutter
    [Weller_channel.sch, Weller_ctrl.sch, audio.sch, audio_fmradio.sch, ethernet.sch, fan_ctrl.sch, fm_radio.sch, front_panel_conn.sch]
2020-11-05 MB: 1) remove 2x fan ctrls 2) MCU pin-out for a VS1063 3) add VS1063 DSP/codec to audio path (WIP)
    [Weller_channel.sch, Weller_ctrl.sch, audio.sch, ethernet.sch, fan_ctrl.sch, fm_radio.sch, front_panel_conn.sch, mcu_1.sch]
2020-11-09 Docs & DS for TS5A3159A mux, VS1063a, ESD diodes etc
    [vs1063-dev131-bom.csv]
2020-11-09 MB - Sch design: VS1063 in new audio path; Added: some new ESD, some fixups; Changes: some footprints, fixes
    [Weller_channel.sch, Weller_ctrl.sch, audio.sch, fan_ctrl.sch, fm_radio.sch, front_panel_conn.sch, mcu_1.sch, power.sch]
2020-11-13 MB: sch) minor fixups (some added decoupling, some missing connections); brd) some initial placements
    [mcu_2.sch, power.sch, rear_panel_conn.sch, solderstn_mb.kicad_pcb]
2020-11-15 Add doc about modding the Amphenol DIN-7 connector to be Weller compatible
2020-11-15 Yet another rear-panel layout shuffle : audio-out to other side; adjust Eth & debug-IDC; align & cleanup
    Moving the audio-conn might help confining the audio parts to the rear-right side of MB.
    [solderstn_mb.kicad_pcb, ss_backpanel-mirrored-F_SilkS.dxf, ss_backpanel-mirrored.kicad_pcb]
2020-11-15 MB: some more (tentative) placement
    [Weller_channel.sch, fm_radio.sch, mcu_1.sch, solderstn_mb.kicad_pcb]
2020-11-22 More RTC-, eeprom, battery-holder docs
    [BATT CR2032.step, CoinCellHolder_CR2032.step]
2020-11-22 New sub-sheet for RTC; added on-board alternatives to ready-made DS3231-module
    [Weller_channel.sch, Weller_ctrl.sch, audio.sch, ethernet.sch, fan_ctrl.sch, fm_radio.sch, front_panel_conn.sch, mcu_1.sch]
2020-11-22 Reannotate entire schematic; add temp.extra SMA-conn to eval alternative FMI placement
    [Weller_channel.sch, Weller_ctrl.sch, audio.sch, fan_ctrl.sch, fm_radio.sch, mcu_1.sch, power.sch, pwm_error_detector.sch]
2020-11-23 New sub-project : DS3231M RTC-module w. JLCPCB components
    [ds3231_RTC_module.kicad_pcb, ds3231_RTC_module.sch]
2020-11-24 Quick 1st layout & route of the RTC sub-module
    [ds3231_RTC_module.kicad_pcb, ds3231_RTC_module.sch]
2020-11-24 Quick & dirty 2x4 panel of the RTC module, for v-scoring (ToDo: sanity-check DRC with JLC rules)
    [ds3231_RTC_module-Panel2x5.kicad_pcb]
2020-12-01 MainBoard: change fp for all 3225 oscillators to normal (was -Handsoldering)
    [ethernet.sch, mcu_1.sch, solderstn_mb.kicad_pcb, vs1063.sch]
2020-12-01 New breakout-board: 87DC-201 'speed-buttons' bridges (if JLC complains about break-away variant in the frontpanel PCB)
    [ss_fp_87dc3_bridgeboard-Panel.kicad_pcb, ss_fp_87dc3_bridgeboard.kicad_pcb, ss_fp_87dc3_bridgeboard.sch]
2020-12-01 Bridge board: add placeholder JLC serial label in silk
    [ss_fp_87dc3_bridgeboard-Panel.kicad_pcb]
2020-12-07 Some placement (audio, RTC)
    [solderstn_mb.kicad_pcb, vs1063.sch]
2020-12-17 Add doc files for STM32F429Discovery dev board
2020-12-17 Create CubeMX projects for FFC Adapter board (one for F103, one for F429-disco)
2020-12-17 Preliminary sch & early PCB setup for an FFC adapter board design
    [f103_bluepill.sch, f429disco_conn.sch, fan_ctrl.sch, front_panel_conn.sch, frontpanel_dev_adapter.kicad_pcb, frontpanel_dev_adapter.sch, power.sch]
2020-12-21 "Frontpanel dev-adapter: change some component sizes, add Logo & 4x mounting holes"
    [f103_bluepill.sch, f429disco_conn.sch, front_panel_conn.sch, frontpanel_dev_adapter.sch]
2020-12-21 Frontpanel adapter: PCB placement done incl logo, mounting holes. Some silk notations."
    [frontpanel_dev_adapter.kicad_pcb]
2020-12-23 FP adapter/devboard: some initial routing
    [f429disco_conn.sch, frontpanel_dev_adapter.kicad_pcb]
2020-12-29 Frontpanel dev adapter: Optimize some LCSC components for JLC assembly; add some datasheets. Optimize F103 16MHz xtal routing
    [f103_bluepill.sch, fan_ctrl.sch, front_panel_conn.sch, frontpanel_dev_adapter.kicad_pcb, frontpanel_dev_adapter.sch, power.sch]
2020-12-30 FP adapter/dev board: add datasheet for DC/DC inductor and diode
2020-12-30 FP adapter/dev board: *routing DONE* ; minor pinout tweaks (optimize routing); fix some missing 3d models
    [f103_bluepill.sch, f429disco_conn.sch, fan_ctrl.sch, frontpanel_dev_adapter.kicad_pcb, power.sch]
2020-12-30 FP adapter: Add JLCPCB serial string; tooling holes; route Vin to buck on bottom instead of directly under inductor
    [frontpanel_dev_adapter.kicad_pcb, frontpanel_dev_adapter.sch]
2020-12-31 FP adapter board: Added LCSC partnumbers to all components to be PnP:ed; Finalized some silk additions; Generated Gerbers, BoM & pnp-files for JCL assembly
    [f103_bluepill.sch, fan_ctrl.sch, front_panel_conn.sch, frontpanel_dev_adapter-BoM.csv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]
2020-12-31 Backpanel: added fill zones & labels/icons in silk-screen on back
    [ss_backpanel-mirrored.kicad_pcb]
2020-12-31 Backpanel : generated Gerber output - for silk-screen labels
    [ss_backpanel-mirrored-B_Cu.gbr, ss_backpanel-mirrored-B_Mask.gbr, ss_backpanel-mirrored-B_SilkS.gbr, ss_backpanel-mirrored-Edge_Cuts.gbr, ss_backpanel-mirrored-F_Cu.gbr, ss_backpanel-mirrored-F_Mask.gbr, ss_backpanel-mirrored-F_SilkS.gbr, ss_backpanel-mirrored-NPTH.drl]
2020-12-31 Backpanel: Change labels/icons to solder-mask cutout variants instead (for e.g. ENIG on black)
    [ss_backpanel-mirrored.kicad_pcb]
2020-12-31 Backpanel : Generated alernative gerbers for soldermask labels/icons
    [ss_backpanel-mirrored-B_Cu.gbr, ss_backpanel-mirrored-B_Mask.gbr, ss_backpanel-mirrored-B_SilkS.gbr, ss_backpanel-mirrored-Edge_Cuts.gbr, ss_backpanel-mirrored-F_Cu.gbr, ss_backpanel-mirrored-F_Mask.gbr, ss_backpanel-mirrored-F_SilkS.gbr, ss_backpanel-mirrored-NPTH.drl]
2020-12-31 Backpanel (solder-mask labels) : Remove Cu-fill on inside. Keep all-board fill on outside for now (KISS)
    [ss_backpanel-mirrored-B_Cu.gbr, ss_backpanel-mirrored-B_Mask.gbr, ss_backpanel-mirrored-B_SilkS.gbr, ss_backpanel-mirrored-Edge_Cuts.gbr, ss_backpanel-mirrored-F_Cu.gbr, ss_backpanel-mirrored-F_Mask.gbr, ss_backpanel-mirrored-F_SilkS.gbr, ss_backpanel-mirrored-NPTH.drl]
2020-12-31 Backpanel (solder-mask labels) : Also remove label 'Weller-compatible' to reduce clutter
    [ss_backpanel-mirrored-B_Cu.gbr, ss_backpanel-mirrored-B_Mask.gbr, ss_backpanel-mirrored-B_SilkS.gbr, ss_backpanel-mirrored-Edge_Cuts.gbr, ss_backpanel-mirrored-F_Cu.gbr, ss_backpanel-mirrored-F_Mask.gbr, ss_backpanel-mirrored-F_SilkS.gbr, ss_backpanel-mirrored-NPTH.drl]
2020-12-31 Frontpanel-outer : minor tweaks to align some traces with MCU pads; generated Gerbers
    [ss_frontpanel_outer_plate-B_Cu.gbr, ss_frontpanel_outer_plate-B_Mask.gbr, ss_frontpanel_outer_plate-B_Paste.gbr, ss_frontpanel_outer_plate-B_SilkS.gbr, ss_frontpanel_outer_plate-Edge_Cuts.gbr, ss_frontpanel_outer_plate-F_Cu.gbr, ss_frontpanel_outer_plate-F_Mask.gbr, ss_frontpanel_outer_plate-F_Paste.gbr]
2020-12-31 Frontpanel-inner : generated gerbers
    [ss_frontpanel_inner_plate-B_Cu.gbr, ss_frontpanel_inner_plate-B_Mask.gbr, ss_frontpanel_inner_plate-B_Paste.gbr, ss_frontpanel_inner_plate-B_SilkS.gbr, ss_frontpanel_inner_plate-Edge_Cuts.gbr, ss_frontpanel_inner_plate-F_Cu.gbr, ss_frontpanel_inner_plate-F_Mask.gbr, ss_frontpanel_inner_plate-F_Paste.gbr]
2021-01-02 MB: RTC EEPROM pullups. Migrate F429v pinout to latest Cube version. (DC/DC buck original placement)
    [solderstn_mb.kicad_pcb]
2021-01-03 Update frontpanel-inner-plate: Remove breakaway subboards; slight improve routing and plane fills. R2A files generated but not ordered
    [ss_frontpanel_inner_plate-B_Cu.gbr, ss_frontpanel_inner_plate-B_Mask.gbr, ss_frontpanel_inner_plate-B_SilkS.gbr, ss_frontpanel_inner_plate-Edge_Cuts.gbr, ss_frontpanel_inner_plate-F_Cu.gbr, ss_frontpanel_inner_plate-F_Mask.gbr, ss_frontpanel_inner_plate-F_SilkS.gbr, ss_frontpanel_inner_plate-NPTH.drl]
2021-01-03 Adjust separate bridge-board panel for potential production (R1A *not* ordered though)
    [ss_fp_87dc3_bridgeboard.kicad_pcb, ss_fp_87dc3_bridgeboard.sch]
2021-01-09 mb: add missing RTC.sch
    [RTC.sch]
2021-01-09 MB : some uncommitted changes, dont remember what
    [power.sch, rear_panel_conn.sch, solderstn_mb.kicad_pcb]
2021-01-09 New sub-board : JLink/STlink -> SolderStation debug adapter (WIP)
    [ss_debug_adapter.kicad_pcb, ss_debug_adapter.sch]
2021-01-10 rename step-file
    [BATT_CR2032.step]
2021-01-13 MB: major update of footprints, LCSC part numbers and Basic/Extended library indicator, for _most_ of the BoM. (Also removed JP1101/JP1102, bypass jmprs)
    [RTC.sch, Weller_channel.sch, Weller_ctrl.sch, audio.sch, ethernet.sch, fan_ctrl.sch, fm_radio.sch, front_panel_conn.sch]
2021-01-13 doc: add some datasheets
    [3d_STX-3501-3N_rA3.STEP]
2021-01-13 MB: update xtal osc load caps from 27pF -> 10pF
    [ethernet.sch, solderstn_mb.kicad_pcb, vs1063.sch]
2022-01-12 frontpanel test-fw: remove F103-c8 prj, add F103-cb dito
    Targeting our custom "frontpanel devboard" PCBA, it features the f103CB
2022-01-12 Some more doc files
    [629104190121_Download_STP_629104190121_rev1.stp]
2022-01-12 * Some uncomitted frontpanel devboard (R1A) files * Some files frontpanel devboard files updated (not sure what changed, except fan-header from customlib_mj)
    [fan_ctrl.sch]
2022-01-12 solderstn_mb : Misc uncommitted changes I dont remember...
    [fan_ctrl.sch, front_panel_conn.sch, mcu_1.sch, power.sch, temp_sensor.sch]
2022-01-15 Kicad 6.0 : Most of SS2k & subprojects updated to kicad6 The projects should from now on be opened through the .kicad_pro files instead of .pro, etc. NOTE: Kicad 6 is now used. Kicad5 is NOT able to 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
    [Frontpanel_touch_sense.kicad_sch, Weller_channel.kicad_sch, Weller_ctrl.kicad_sch, audio.kicad_sch, ethernet.kicad_sch, fan_ctrl.kicad_sch, fm_radio.kicad_sch, front_panel_conn.kicad_sch]
2022-01-18 docs : stm32f103 + 12V secondary fuses
2022-01-19 mb: adjust some backpnl connectors - USB_A:-1.1mm, Eth:+1.0mm, Audiojack:+0.1mm
    [solderstn_mb.kicad_pcb, ss_backpanel-mirrored.kicad_pcb]
2022-01-20 solderstation_mb: some file cleanup
    * dxf's, step's and FreeCad prj-files moved to new subdir ./3d_exports/
    * add missing file
    * remove some v5 cruft
    [RTC.kicad_sch, solderstn_mb-B_Silkscreen.dxf]
2022-01-20 ss_backpanel-mirrored : files cleanup, added ./3d_exports/
    [3dprint_backpanel_PCB.stl, ss_backpanel-mirrored-F_SilkS.dxf, ss_backpanel-mirrored.kicad_pcb, ss_backpanel-mirrored.sch]
2022-01-21 Created Aluminium PCBs for ss_backpanel-mirrored_Al and ss_frontpanel_outer_plate_Al
    * USB-A cutout tightened since the connector has been retraced on the MB so flanges are pulled inside
    * Eth cutout tightened
    * Locking notch on DIN-connectors tightended slightly
    * -0.1mm on pwr-button cutut diameter (front panel)
    * (5pcs of each, white with blank silk, ordered from JLCPCB on 2022-01-20)
    [panel_outline.dxf, ss_backpanel-mirrored_Al-3d.FCStd, ss_backpanel-mirrored_Al-B_Silkscreen.dxf, ss_backpanel-mirrored_Al-Edge_Cuts.dxf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]
2022-01-21 Mechanical mockup of the rear 95mm of mainboard (unrouted)
    A 2L, 95x160mm mockup connector- and footprint test board was cut down from full size MB.
    (In hindsight, should probably just have ordered the full board outline!)
    * 5pcs ordered from JLCPCB for mechnical sanity-testing
    [RTC.kicad_sch, Weller_channel.kicad_sch, Weller_ctrl.kicad_sch, audio.kicad_sch, ethernet.kicad_sch, fan_ctrl.kicad_sch, fm_radio.kicad_sch, front_panel_conn.kicad_sch]
2022-01-21 Frontpanel_dev_adapter : kicad 5 -> kicad 6
    [f103_bluepill.kicad_sch, f103_bluepill.sch, f429disco_conn.kicad_sch, f429disco_conn.sch, fan_ctrl.kicad_sch, fan_ctrl.sch, front_panel_conn.kicad_sch, front_panel_conn.sch]
2022-01-21 doc/stm32f429 : docs & appnoted added (incl F429Discovery devboard files)
2022-01-21 appnote "Switching regulators for poets"
2022-02-02 Placeholder 3d-models for rear-panel (w. conns), PSU, Bottom-plate, front-panel (w. conns), outer fp
    With these placeholder mech. objects, the build-in 3d view of MB pcb features most of the mechanical
    objects that constrain components placements. So 3d-view can be used to quickly check and iterate
    placements to avoid 3d collisions, without having to first export MB STEP into FreeCAD and muck around
    only to have to repeat again for each iteration
    [3d_assm_bottomplate_w_feet.FCStd, 4mmBanana_panel_with_QC.FCStd, 4mmBanana_panel_with_QC.step, AC_Schaffner_inlet_with_QC_sockets.FCStd, Bridgeboard-SingleBrd.FCStd, Bridgeboard-SingleBrd_compound.FCStd, Frontpanel_LeftBtnholder_Assembly.FCStd, Frontpanel_RightBtnholder_Assembly.FCStd]
2022-02-26 F103 FP_DEV: bitbanged SW-I2C, TMP100 drv, DWT util fns
2022-02-26 F103 FP_DEV: updated CubeMX project; updated version of STM32F1xx_HAL_Driver; added testing of TMP100 & SW-I2C
2022-02-26 docs: I2C std.
2022-04-07 solderstn_mb::power - changed generic 2x2 connector to customlib_mj:Molex_MicroFit 2x2
    (and a whole bunch of other automatic changes, crap)
    [Weller_channel.kicad_sch, ethernet.kicad_sch, fan_ctrl.kicad_sch, front_panel_conn.kicad_sch, mcu_1.kicad_sch, mcu_2.kicad_sch, power.kicad_sch, pwm_error_detector.kicad_sch]
2024-02-26 hw: long-standing uncommitted stuff; mostly auto-updates (v7) fw: remove L052 tree (CMSIS & std-HAL shouldn't be committed and it was the wrong device name anyway)
    [Frontpanel_touch_sense.kicad_sch, RTC.kicad_sch, Weller_channel.kicad_sch, Weller_ctrl.kicad_sch, audio.kicad_sch, ethernet.kicad_sch, f103_bluepill.kicad_sch, fan_ctrl.kicad_sch]
2024-02-26 Adding some more untracked misc. stuff
    [ss_fp_87dc3_bridgeboard-B_Cu.gbr, ss_fp_87dc3_bridgeboard-B_Mask.gbr, ss_fp_87dc3_bridgeboard-B_SilkS.gbr, ss_fp_87dc3_bridgeboard-Edge_Cuts.gbr, ss_fp_87dc3_bridgeboard-F_Cu.gbr, ss_fp_87dc3_bridgeboard-F_Mask.gbr, ss_fp_87dc3_bridgeboard-F_SilkS.gbr, ss_fp_87dc3_bridgeboard-NPTH.drl]
2024-02-26 (renamed doc/STM32L052... to doc/STM32L053...)
2024-02-26 Various boards & schematics (auto-)updated to Kicad-v8
    [Frontpanel_touch_sense.kicad_sch, RTC.kicad_sch, Weller_channel.kicad_sch, Weller_ctrl.kicad_sch, audio.kicad_sch, ethernet.kicad_sch, f103_bluepill.kicad_sch, f429disco_conn.kicad_sch]
