mjohansson/SolderingStation/(notices)

Notices in the files:
fw/f103cb_fpdev/Src/adc.c:
Copyright (c) 2022 STMicroelectronics.
All rights reserved.
This software is licensed under terms that can be found in the LICENSE file
fw/f103cb_fpdev/Inc/main.h:
© Copyright (c) 2021 STMicroelectronics.
